marmote/marmote/hardware/BeaverBoard_RevA/Misc/Pictures/IMAG0495.jpg

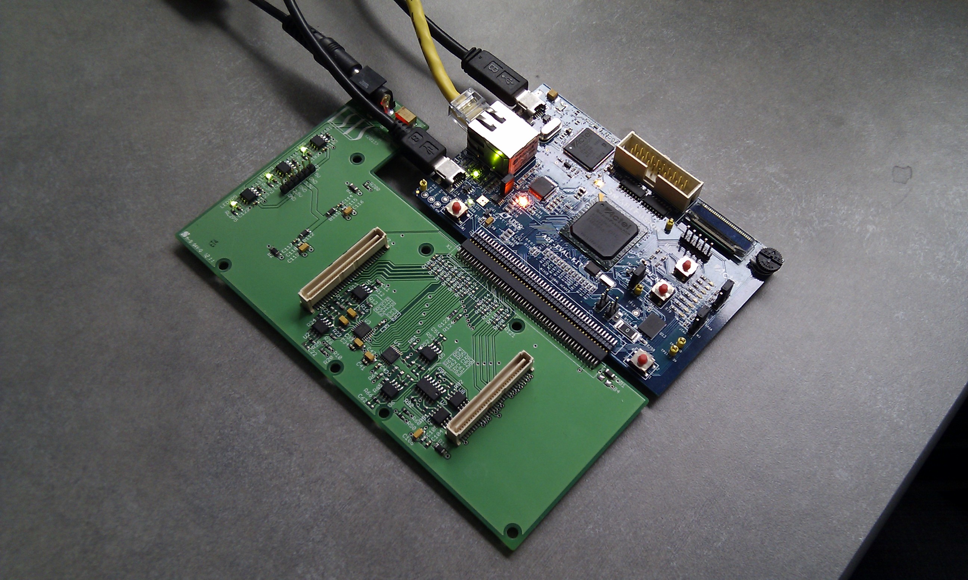
hardware/BeaverBoard_RevA/Misc/Pictures/IMAG0495.jpg
