marmote/marmote/hardware/BeaverBoard_RevA/Misc/Pictures/enhanced/IMAG0497.2.jpg

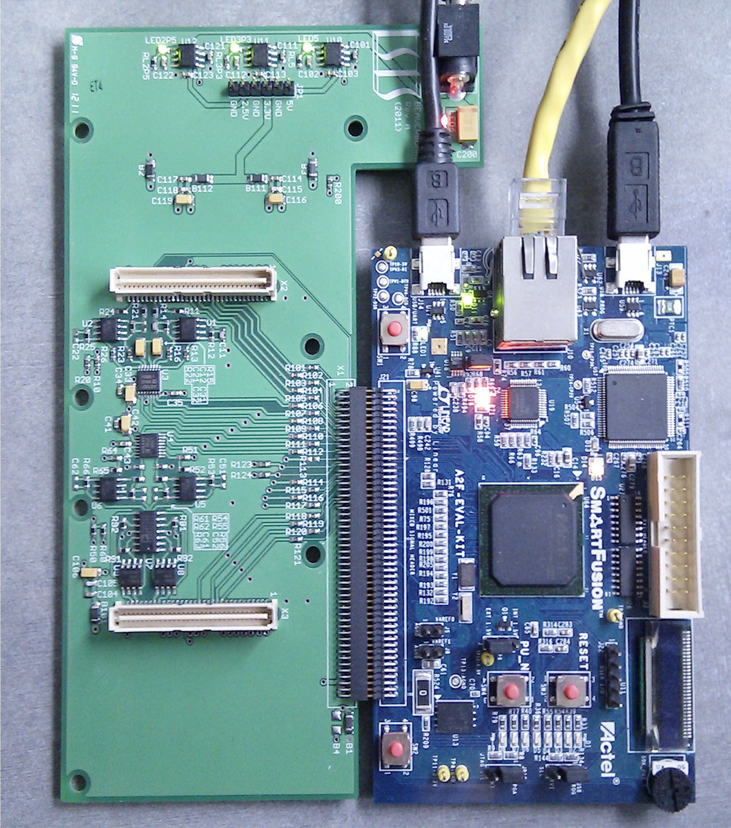
hardware/BeaverBoard_RevA/Misc/Pictures/enhanced/IMAG0497.2.jpg
