marmote/marmote/hardware/BreakoutBoard_RevB/CAM/README.txt

BreakoutBoard (Smoky) Revision B

PCB DECRIPTION: 90mm x 56mm 
                4 LAYER PCB (.062 inches thickness) FR4
                Smallest line width and spacing 4/4 mil
                Smallest standard drill hole 8 mil
                Components/Silkscreen on both sides
                Double side BLACK soldermask
                
PCB STACKUP:

	Stack Layer		Gerber Polarity	Comment	
	-----------		---------------	-------
	1 (Top)			Positive		Component side (signal)
	2 (GND)			Positive		Power (GND)
	3 (Inner)		Positive		Inner signal layer (signal)
	16 (Bottom)		Positive		Solder side (GND)

FILES:

BreakoutBoard_RevB.GTO - Top Silk Screen (component side)
BreakoutBoard_RevB.GTP - Top Solder paste (cream stencil, component side)
BreakoutBoard_RevB.GTS - Top Solder stop mask (component side)
BreakoutBoard_RevB.GTL - Top Copper (component side), Positive Polarity
BreakoutBoard_RevB.GP1 - Inner Ground plane, Positive Polarity
BreakoutBoard_RevB.GP2 - Inner Signal Layer, Positive Polarity
BreakoutBoard_RevB.GBL - Bottom Copper (solder side), Positive Polarity
BreakoutBoard_RevB.GBS - Bottom Solder stop mask (solder side)
BreakoutBoard_RevB.GBP - Bottom Solder paste (cream stencil, solder side)
BreakoutBoard_RevB.GBO - Bottom Silk Screen (solder side)
BreakoutBoard_RevB.GML - Board outline
BreakoutBoard_RevB.gpi - Gerber Report 

BreakoutBoard_RevB.DRD - NC Drill : 1.4, Abs, inches, leading zero supress, quad
BreakoutBoard_RevB.dri - NC Drill Report

BreakoutBoard_RevB.gwk - GraphiCode GC-Prevue Project File (Gerbers and drill)

BreakoutBoard_RevB.xy  - Centroid data for SMD components

BreakoutBoard_RevB_BOM.xls	- Bill of materials

BreakoutBoard_RevB_Asy.pdf	- Board assembly drawing

QUESTIONS?

  Please contact Peter Volgyesi <peter.volgyesi@vanderbilt.edu>
  at 615.294.6520 with any problems or questions
