marmote/marmote/hardware/M6-RF315/CAM/readme.txt

M6-RF315 Revision A

PCB DECRIPTION: 90 mm x 56 mm (see Board outline)
                2 LAYER PCB (.062 inches thickness) FR4
                1 oz copper wight
                DOUBLE SIDE SOLDER MASK

With any question please contact Sandor Szilvasi <sandor.szilvasi@vanderbilt.edu>
at +1 (615) 609 3342.

M6-RF315.cmp - Top Copper (component side) Positive Polarity
M6-RF315.sol - Bottom Copper (solder side) Positive Polarity
M6-RF315.stc - Top Solder stop mask (component side)
M6-RF315.sts - Bottom Solder stop mask (solder side)
M6-RF315.plc - Top Silkscreen (component side)
M6-RF315.pls - Bottom Silkscreen (solder side)
M6-RF315.oln - Board outline
M6-RF315.drd - NC Drill : 1.4, Abs, inches, leading zero supress, quad
