marmote/marmote/hardware/BeaverBoard_RevA/CAM/README.txt

BeaverBoard Rev. A

PCB DECRIPTION: 4 LAYER PCB (.062 inches thickness) FR4
                1 oz / 1 oz inner copper
                Components/Silkscreen only on top side
                Double side soldermask

PCB STACKUP:

	Stack Layer		Gerber Polarity	Comment	
	-----------		---------------	-------
	1 (Top)			Positive		Component side (signal)
	2 (Inner 1)		Positive		Power (GND)
	3 (Inner 2)		Positive		Power (VCC)
	4 (Bottom)		Positive		Solder side (signal)

FILES:

BeaverBoard_RevA.GTO - Top Silk Screen (component side)
BeaverBoard_RevA.GTP - Top Solder paste (cream stencil, component side)
BeaverBoard_RevA.GTS - Top Solder stop mask (component side)
BeaverBoard_RevA.GTL - Top Copper (component side), Positive Polarity
BeaverBoard_RevA.GP1 - Inner Layer 1, Positive Polarity
BeaverBoard_RevA.GP2 - Inner Layer 2, Positive Polarity
BeaverBoard_RevA.GBL - Bottom Copper (solder side), Positive Polarity
BeaverBoard_RevA.GBS - Bottom Solder stop mask (solder side)
BeaverBoard_RevA.GBP - Bottom Solder paste (cream stencil, solder side)
BeaverBoard_RevA.GBO - Bottom Silk Screen (solder side)
BeaverBoard_RevA.GML - Board outline
BeaverBoard_RevA.gpi - Gerber Report 

BeaverBoard_RevA.DRD - NC Drill : 1.4, Abs, inches, leading zero supress, quad
BeaverBoard_RevA.dri - NC Drill Report

BeaverBoard_RevA.gwk - GraphiCode GC-Prevue Project File (Gerbers and drill)

BeaverBoard_RevA.xy  - Centroid data for SMD components
   
BeaverBoard_RevA_BOM.xls	- Bill of materials

BeaverBoard_RevA_Asy.pdf	- Board assembly drawing

QUESTIONS?
  Please contact Peter Volgyesi <peter.volgyesi@vanderbilt.edu>
  at 615.294.6520 with any problems or questions
