marmote/marmote/firmware/MainBoard/StreamingReceiver_RF/designer/impl1/StreamingReceiver_RF_iobank_report.txt

********************************************************************
                            I/O Bank Report
********************************************************************
  
Product: Designer
Release: v10.1 SP3
Version: 10.1.3.1
Date: Tue Mar 05 08:22:31 2013
Design Name: StreamingReceiver_RF  Family: SmartFusion  Die: A2F500M3G  Package: 256 FBGA

I/O Function:

    Type                          | w/o register  | w/ register  | w/ DDR register
    ------------------------------|---------------|--------------|----------------
    Input I/O                     | 4             | 0            | 0
    Output I/O                    | 14            | 0            | 0
    Bidirectional I/O             | 8             | 0            | 20
    Differential Input I/O Pairs  | 0             | 0            | 0
    Differential Output I/O Pairs | 0             | 0            | 0

I/O Technology:

                                    |   Voltages    |             I/Os
    --------------------------------|-------|-------|-------|--------|--------------
    I/O Standard(s)                 | Vcci  | Vref  | Input | Output | Bidirectional
    --------------------------------|-------|-------|-------|--------|--------------
    LVTTL                           | 3.30v | N/A   | 4     | 14     | 0
    LVCMOS33                        | 3.30v | N/A   | 0     | 0      | 28

I/O Bank Resource Usage:

          |   Voltages    | Single I/Os  | Diff I/O Pairs |        Vref I/Os
          |-------|-------|------|-------|-------|--------|------|-------|----------
          | Vcci  | Vref  | Used | Total | Used  | Total  | Used | Total | Vref Pins
    ------|-------|-------|------|-------|-------|--------|------|-------|----------
    Bank0 | 3.30v | N/A   | 31   | 34    | 0     | 17     | N/A  | N/A   | N/A
    Bank1 | 3.30v | N/A   | 7    | 12    | 0     | 6      | N/A  | N/A   | N/A
    Bank2 | MSS   | N/A   | N/A  | N/A   | N/A   | N/A    | N/A  | N/A   | N/A
    Bank3 | ANALOG| N/A   | N/A  | N/A   | N/A   | N/A    | N/A  | N/A   | N/A
    Bank4 | MSS   | N/A   | N/A  | N/A   | N/A   | N/A    | N/A  | N/A   | N/A
    Bank5 | 3.30v | N/A   | 8    | 20    | 0     | 10     | N/A  | N/A   | N/A

I/O Voltage Usage:

       Voltages    |     I/Os
    -------|-------|------|-------
     Vcci  | Vref  | Used | Total
    -------|-------|------|-------
     3.30v | N/A   | 46   | 66
