marmote/marmote/firmware/MainBoard/StreamingReceiver_RF/designer/impl1/StreamingReceiver_RF_maxdelay_timingviolations_report.txt

Timing Violation Report Max Delay Analysis

SmartTime Version v10.1 SP3
Actel Corporation - Actel Designer Software Release v10.1 SP3 (Version 10.1.3.1)
Copyright (c) 1989-2013
Date: Tue Mar 05 08:22:35 2013

Design: StreamingReceiver_RF
Family: SmartFusion
Die: A2F500M3G
Package: 256 FBGA
Temperature: COM
Voltage: COM
Speed Grade: STD
Design State: Post-Layout
Data source: Silicon verified
Min Operating Condition: BEST
Max Operating Condition: WORST
Using Enhanced Min Delay Analysis
Scenario for Timing Analysis: Primary

No Path
