marmote/marmote/firmware/MainBoard/StreamingReceiver/designer/impl1/StreamingReceiver_iobank_report.txt

********************************************************************
                            I/O Bank Report
********************************************************************
  
Product: Designer
Release: v10.0 SP2
Version: 10.0.20.2
Date: Tue Jul 03 07:18:06 2012
Design Name: StreamingReceiver  Family: SmartFusion  Die: A2F500M3G  Package: 256 FBGA

I/O Function:

    Type                          | w/o register  | w/ register  | w/ DDR register
    ------------------------------|---------------|--------------|----------------
    Input I/O                     | 2             | 0            | 0
    Output I/O                    | 7             | 0            | 0
    Bidirectional I/O             | 8             | 0            | 10
    Differential Input I/O Pairs  | 0             | 0            | 0
    Differential Output I/O Pairs | 0             | 0            | 0

I/O Technology:

                                    |   Voltages    |             I/Os
    --------------------------------|-------|-------|-------|--------|--------------
    I/O Standard(s)                 | Vcci  | Vref  | Input | Output | Bidirectional
    --------------------------------|-------|-------|-------|--------|--------------
    LVTTL                           | 3.30v | N/A   | 2     | 7      | 0
    LVCMOS33                        | 3.30v | N/A   | 0     | 0      | 18

I/O Bank Resource Usage:

          |   Voltages    | Single I/Os  | Diff I/O Pairs |        Vref I/Os
          |-------|-------|------|-------|-------|--------|------|-------|----------
          | Vcci  | Vref  | Used | Total | Used  | Total  | Used | Total | Vref Pins
    ------|-------|-------|------|-------|-------|--------|------|-------|----------
    Bank0 | 3.30v | N/A   | 18   | 34    | 0     | 17     | N/A  | N/A   | N/A
    Bank1 | 3.30v | N/A   | 6    | 12    | 0     | 6      | N/A  | N/A   | N/A
    Bank2 | MSS   | N/A   | N/A  | N/A   | N/A   | N/A    | N/A  | N/A   | N/A
    Bank3 | ANALOG| N/A   | N/A  | N/A   | N/A   | N/A    | N/A  | N/A   | N/A
    Bank4 | MSS   | N/A   | N/A  | N/A   | N/A   | N/A    | N/A  | N/A   | N/A
    Bank5 | 3.30v | N/A   | 3    | 20    | 0     | 10     | N/A  | N/A   | N/A

I/O Voltage Usage:

       Voltages    |     I/Os
    -------|-------|------|-------
     Vcci  | Vref  | Used | Total
    -------|-------|------|-------
     3.30v | N/A   | 27   | 66
