marmote/marmote/hardware/PowerBoard_RevC/Misc/BlockDiagram.pptx

South Bridge

GPIO

SPI

I²C

Power Rails

FTSH

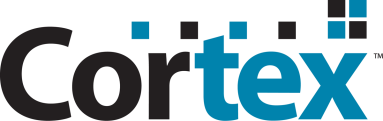
[picture p3: figure]

PMIC

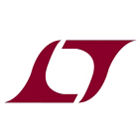
[picture p4: figure]

SWD

SPI

Analog

Current Senses

USB

GPIO

BUCK, LDOs

5V

3.6V

5V

Power Path

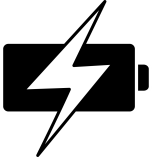
[picture p5: figure]

## Slide 2

Digital (STM)
3.3V
Digital
1.5V
Analog
3.3V
1.5V
2.8V-5.5V
3.3V
