marmote/marmote/hardware/MainBoard_RevB/Misc/BlockDiagram.pptx

North Bridge

SMA

Analog

GPIO

SPI

I²C

UART

AFE

RJ45

Clock

Analog

GPIO

Micro-B

USB

JTAG

RGMII

FTSH

GPIO

SPI

I²C

South Bridge

## Slide 2

North Bridge

AFE

ETH PHY

VSUP - 3.6V ~ 5V

D3V3 - Digital 3.3V

D1V5 - Digital 1.5V

A1V5 - Analog 1.5V

A3V3 – Analog 3.3V

South Bridge

## Slide 3

SmartFusion

MSS CCC

FPGA
fabric

CCC

EXT CLK IN

20 MHz
from SMA

GLC

EXT CLK OUT

20 MHz
to SMA

REF CLK OUT

MAIN CLK IN

20 MHz
from TCXO

PLL

GLB

20 MHz (differential)
to mezzanine

GLA0

AFE 1 CLK

AFE 2 CLK

max. 20 MHz
to AFEs (DDR)

32 kHz
OSC

100 MHz RC OSC

MSS

LP XTAL

32 kHz
from XTAL

USB CLK

60 MHz
from USB chip

RMII CLK

50 MHz
from ETH OSC

## Slide 4

SmartFusion

MSS CCC

FPGA
fabric

CCC

EXT CLK IN

20 MHz
from SMA

GLC

EXT CLK OUT

20 MHz
to SMA

REF CLK OUT

MAIN CLK IN

20 MHz
from TCXO

PLL

GLB

20 MHz (differential)
to mezzanine

GLA0

AFE 1 CLK

AFE 2 CLK

max. 20 MHz
to AFEs (DDR)

GLC

32 kHz
OSC

MSS

LP XTAL

32 kHz
from XTAL

USB CLK

60 MHz
from USB chip

RMII CLK

50 MHz
from ETH OSC

## Slide 5

SmartFusion

MSS CCC

FPGA
fabric

EXT CLK IN

20 MHz
from SMA

GLC

EXT CLK OUT

20 MHz
to SMA

REF CLK OUT

MAIN CLK IN

20 MHz
from TCXO

PLL

GLB

20 MHz (differential)
to mezzanine

GLA0

AFE 1 CLK

AFE 2 CLK

max. 20 MHz
to AFEs (DDR)

32 kHz
OSC

GLC

MSS

LP XTAL

32 kHz
from XTAL

CCC

USB CLK

60 MHz
from USB chip

RMII CLK

50 MHz
from ETH OSC

## Slide 6

XTAL

USB XTAL

12 MHz

USB
chip

ETH PHY

USB CLK

60 MHz

SMA

SMA

EXT CLK IN

EXT CLK OUT

20 MHz

20 MHz

AFE 1

TCXO

MAIN CLK IN

20 MHz

AFE 1 CLK

AFE 2 CLK

max. 20 MHz

AFE 2

XTAL

LP XTAL

32 kHz

REF CLK OUT

20 MHz
(differential)

Mezzanine

OSC

RMII CLK

50 MHz

## Slide 7

North Bridge

ADC, DAC

ETH PHY

VSUP

D3V3

D1V5

A1V5

A3V3

South Bridge

## Slide 8

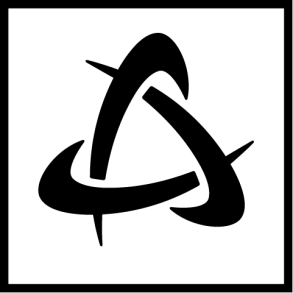
[picture p6: figure]
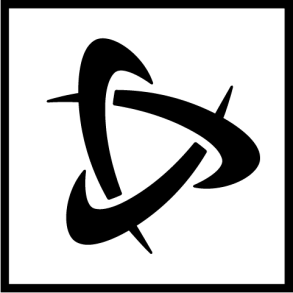
[picture p7: figure]
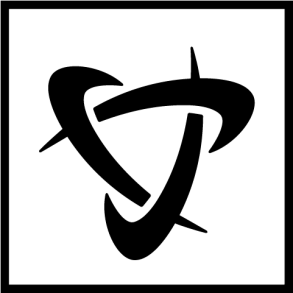
[picture p8: figure]
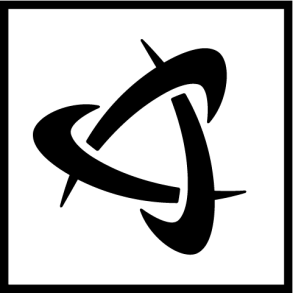
[picture p9: figure]

## Slide 9

## Slide 10

North Bridge

Jack/BNC

Analog

GPIO

SPI

I²C

LED

SRAM

Analog

GPIO

SMA

Clock I/O

JTAG

EMI

FTSH

JTAG

GPIO

SPI

I²C

South Bridge

## Slide 11

SmartFusion

EXT CLK IN

MSS CCC

GLC

FPGA
fabric

EXT CLK OUT

PLL

REF CLK OUT

MAIN CLK IN

GLB

GLA0

AFE1 CLK

AFE2 CLK

CLKC

LP XTAL

32 kHz
OSC

MSS

CCC

USB CLK

RMII CLK

ETH PHY

## Slide 12

SmartFusion

MSS CCC

EXT CLK IN

GLC

Fabric

CCC

REF CLK OUT

PLL

EXT CLK OUT

MAIN CLK IN

GLB

CCC

CCC

USB CLK

CLKC

GLA0

AFE1 CLK

AFE2 CLK

LP XTAL

32 kHz
OSC

ETH PHY

MSS

CCC

CCC

RMII CLK

## Slide 13

SmartFusion

MSS CCC

FPGA Fabric

CCC

CCC

REF CLK OUT

EXT CLK IN

GLC

DUT

PLL

EXT CLK OUT

MAIN CLK IN

GLB

CCC

USB CLK

AFE1 CLK

CLKC

GLA0

AFE2 CLK

LP XTAL

32 kHz
OSC

ETH PHY

MSS

CCC

CCC

RMII CLK

## Slide 14

LP XTAL

32 kHz
OSC

FPGA Fabric

CCC

CCC

DUT

REF CLK OUT

MSS CCC

EXT CLK OUT

MAIN CLK IN

PLL

GLB

CCC

USB CLK

EXT CLK IN

GLC

AFE1 CLK

AFE2 CLK

RMII CLK

ETH PHY

GLA0

MSS

CCC

CCC

## Slide 15

LP XTAL

32 kHz
OSC

FPGA Fabric

CCC

CCC

DUT

REF CLK OUT

MSS CCC

EXT CLK OUT

MAIN CLK IN

PLL

GLB

CCC

USB CLK

EXT CLK IN

GLC

AFE1 CLK

AFE2 CLK

RMII CLK

ETH PHY

GLA0

MSS

CCC

CCC

## Slide 16

MSS

MSS CCC

ETH PHY

CCC

CCC

REF CLK OUT

MAIN CLK IN

EXT CLK OUT

EXT CLK IN

LP XTAL

CCC

USB CLK

ETH CLK

AFE1 CLK

AFE2 CLK

CCC

CCC

## Slide 17

CCC

CCC

MAIN CLK IN

REF CLK OUT

EXT CLK IN

EXT CLK OUT

LP XTAL

CCC

USB CLK

ETH CLK

CCC

CCC
