marmote/marmote/doc/System.pdf

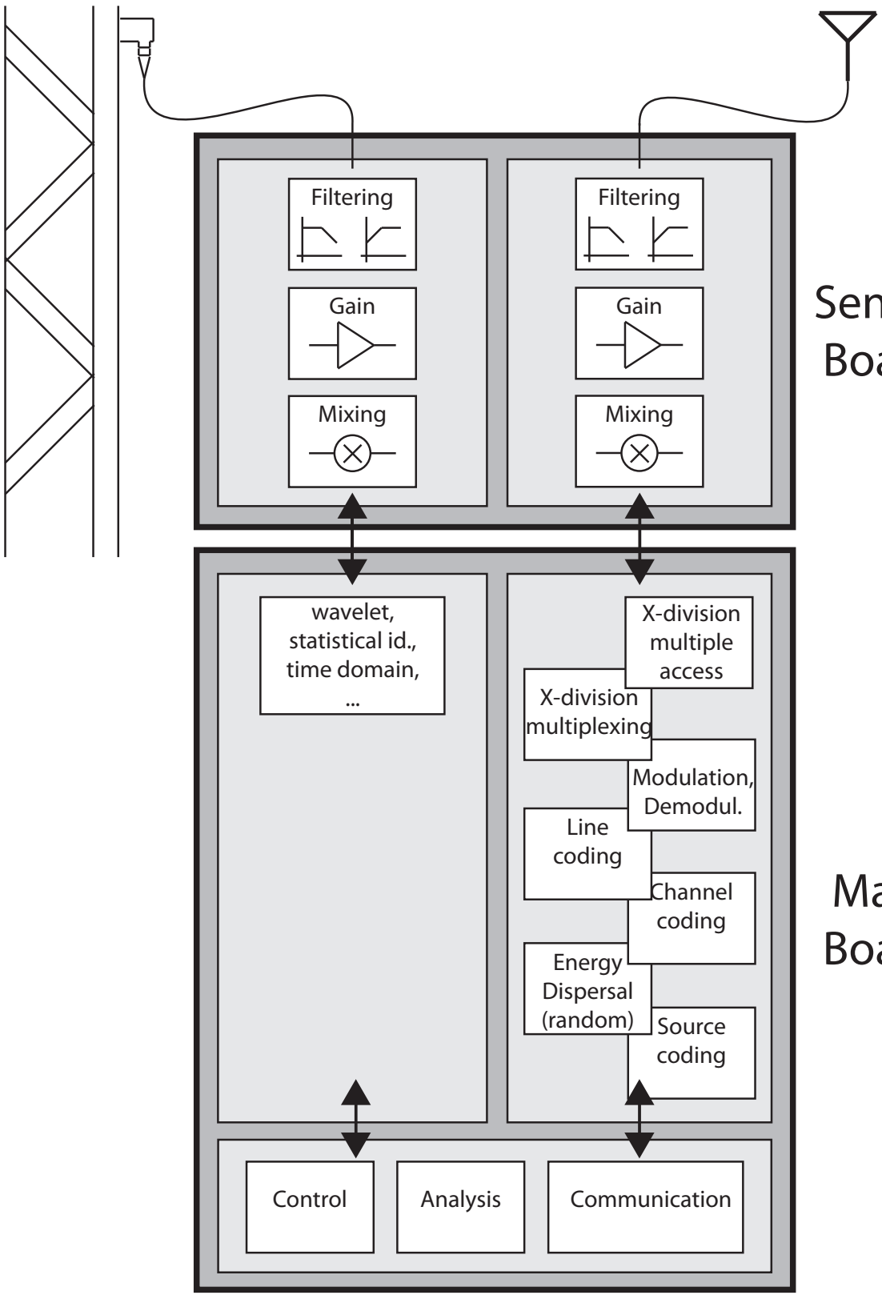
[picture p10: figure]
Filtering; Gain; Mixing; wavelet, statistical id., time domain, ...; Source coding; Energy Dispersal (random); Channel coding; Line coding; Modulation, Demodul.; X-division multiplexing; X-division multiple access; Control; Analysis; Communication

# Sensor Board

# Main Board

# Power Board

# SHM wireless sensor system
