marmote/marmote/hardware/MainBoard_RevB/Document/Connector Bus Signals.xlsx

Sheet: Sheet1
South Bridge (Supply) |  |  |  | North Bridge (Sensor)
84-pin Bus Signals |  |  |  | 84-pin Bus Signals
Name | Pin |  | Name | Name | Pin |  | Name
DGND | 1 | 2 | DGND | DGND | 1 | 2 | DGND
VSUP | 3 | 4 | VSUP | VSUP | 3 | 4 | VSUP
D3V3 | 5 | 6 | D3V3 | D3V3 | 5 | 6 | D3V3
D1V5 | 7 | 8 | D1V5 | D1V5 | 7 | 8 | D1V5 | Legend:
DGND | 9 | 10 | DGND | DGND | 9 | 10 | DGND
SGPIO0 | 11 | 12 |  | NGPIO0 | 11 | 12 | CLK- | Fonts
SGPIO1 | 13 | 14 |  | NGPIO1 | 13 | 14 | CLK+ |  | bold | bus signal (passes through all layers)
DGND | 15 | 16 | DGND | DGND | 15 | 16 | DGND |  | white | GPIO capability
SGPIO2 | 17 | 18 | SPI0 SS | NGPIO3 | 17 | 18 | SPI1 NSS |  | italic | MSS GPIO only (inaccessible from fabric)
SGPIO3 | 19 | 20 | SPI0 SCK | NGPIO4 | 19 | 20 | SPI1 SCK
SGPIO4 | 21 | 22 | SPI0 MISO | UART1 TXD | 21 | 22 | SPI1 MISO | Backgrounds | blue | digital signal
SGPIO5 | 23 | 24 | SPI0 MOSI | UART1 RXD | 23 | 24 | SPI1 MOSI |  | green | analog signal
ALERT | 25 | 26 | I2C1 SCL | ALERT | 25 | 26 | I2C1 SCL
WAKEUP | 27 | 28 | I2C1 SDA | WAKEUP | 27 | 28 | I2C1 SDA
AGND | 29 | 30 | AGND | AGND | 29 | 30 | AGND
 | 31 | 32 |  | SF DAC1 | 31 | 32 | DAC1-
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
