marmote/marmote/hardware/PowerBoard_RevC/Document/STM32F10x Pin Assignment.xlsx

Pin # | Pin name | Type | Main function | Alternate functions |  | Net name | Connected to | Description | Comments
 |  |  |  | Default | Remap
1 | VBAT | S | VBAT | - | - | D3V3_STM | XC6210 - MAX9938 | Supply for RTC and backup registers
2 | PC13-TAMPER-RTC | I/O | PC13 | TAMPER-RTC | - | PC13 | LTC4085 | Suspend (SUSP)
3 | PC14-OSC32_IN | I/O | PC14 | OSC32_IN | - | PC14 | SmartFusion Connector | OSC32 | GPIO x2 | OSC32 | OSC32 design in footprint only (not populated)
4 | PC15-OSC32_OUT | I/O | PC15 | OSC32_OUT | - | PC15
5 | PD0-OSC_IN | I/O | OSC_IN | - | - | OSC_IN | External 16 MHz crystal | Main clock source | USB clock requirements restrict SYSCLK to be 48 MHz or 72 MHz
6 | PD1-OSC_OUT | I/O | OSC_OUT | - | - | OSC_OUT
7 | NRST | I/O | NRST | - | - | NRST | Jumper | Reset signal | Selected a jumper instead of 'one via which can fit a raster pin'
8 | VSSA | S | VSSA | - | - | AGND | GND | -
9 | VDDA | S | VDDA | - | - | D3V3_STM | XC6210 - MAX9938 | -
10 | PA0-WKUP | I/O | PA0 | WKUP/USART2_CTS/ADC_IN0/TIM2_CH1_ETR(8) | - | VSUP_SENSE | MAX9938 | VSUP rail current sense
11 | PA1 | I/O | PA1 | USART2_RTS/ADC_IN1/TIM2_CH2(8) | - | D3V3_SENSE | MAX9938 | D3V3 rail current sense
12 | PA2 | I/O | PA2 | USART2_TX/ADC_IN2/TIM2_CH3(8) | - | D1V5_SENSE | MAX9938 | D1V5 rail current sense
13 | PA3 | I/O | PA3 | USART2_RX/ADC_IN3/TIM2_CH4(8) | - | A1V5_SENSE | MAX9938 | A1V5 rail current sense
14 | PA4 | I/O | PA4 | SPI1_NSS(8)/ADC_IN4/USART2_CK | - | SPI1_NSS | SmartFusion connector | SPI1 signals
15 | PA5 | I/O | PA5 | SPI1_SCK(8)/ADC_IN5 | - | SPI1_SCK
16 | PA6 | I/O | PA6 | SPI1_MISO(8)/ADC_IN6/TIM3_CH1(8) | - | SPI1_MISO
17 | PA7 | I/O | PA7 | SPI1_MOSI(8)/ADC_IN7/TIM3_CH2(8) | - | SPI1_MOSI
18 | PB0 | I/O | PB0 | ADC_IN8/TIM3_CH3(8) | - | D3V3_STM_SENSE | MAX9938 | D3V3_STM rail current sense
19 | PB1 | I/O | PB1 | ADC_IN9/TIM3_CH4(8) | - | D3V3_SENSE | MAX9938 | D3V3 rail current sense
20 | PB2 | I/O | PB2/BOOT1 | - | - | PB2 | LED2 | LED2 (ORANGE) & BOOT1 | Orange UD = 2.0V IFWD = 4mA | Weak pull-up for BOOT1 = '1' on startup
21 | PB10 | I/O | PB10 | I2C2_SCL/ USART3_TX(8) | TIM2_CH3 | I2C2_SCL | VBAT current sense | I2C2 signals
22 | PB11 | I/O | PB11 | I2C2_SDA/ USART3_RX(8) | TIM2_CH4 | I2C2_SDA
23 | VSS_1 | S | VSS_1 | - | - | DGND | GND | -
24 | VDD_1 | S | VDD_1 | - | - | D3V3_STM | XC6210 - MAX9938 | -
25 | PB12 | I/O | PB12 | SPI2_NSS/I2C2_SMBA/USART3_CK(8) | - | SPI2_NSS | SD card | SPI2 signals
26 | PB13 | I/O | PB13 | SPI2_SCK(8)/USART3_CTS | - | SPI2_SCK
27 | PB14 | I/O | PB14 | SPI2_MISO/USART3_RTS | - | SPI2_MISO
28 | PB15 | I/O | PB15 | SPI2_MOSI | - | SPI2_MOSI
29 | PA8 | I/O | PA8 | USART1_CK/MCO | - | PA8 | Master switch | Power switch for ALL rails
30 | PA9 | I/O | PA9 | USART1_TX(8) | - | PA9 | SmartFusion connector | GPIO signals | USART1 signals
31 | PA10 | I/O | PA10 | USART1_RX(8) | - | PA10
32 | PA11 | I/O | PA11 | USART1_CTS/USBDM | - | USBDM | USB connector | USB data signals
33 | PA12 | I/O | PA12 | USART1_RTS/USBDP | - | USBDP
34 | PA13 | I/O | JTMS/SWDIO | - | PA13 | SWDIO | Programmer header | SWD | JTAG
35 | VSS_2 | S | VSS_2 | - | - | DGND | DGND | -
36 | VDD_2 | S | VDD_2 | - | - | D3V3_STM | XC6210 - MAX9938 | -
37 | PA14 | I/O | JTCK/SWCLK | - | PA14 | SWCLK | Programmer header | SWD | JTAG
38 | PA15 | I/O | JTDI | - | TIM2_CH1_ETR/PA15/SPI1_NSS | PA15 | LED1 | Programmer header | LED1 (GREEN) | JTAG | Green UD = 2.1V IFWD = 10mA | Optional JTAG functionality
39 | PB3 | I/O | JTDO | - | TIM2_CH2/PB3/TRACESWO/SPI1_SCK | TRACESWO | Programmer header | SWD | JTAG
40 | PB4 | I/O | JNTRST | - | TIM3_CH1/PB4/SPI1_MISO | PB4 | LTC2942-1 | Battery Gauge #AL/CC
41 | PB5 | I/O | PB5 | I2C1_SMBA | TIM3_CH2/SPI1_MOSI | PB5 | SmartFusion connector | Programmer header | GPIO+ | JTAG | Optional JTAG functionality
42 | PB6 | I/O | PB6 | I2C1_SCL(8)/TIM4_CH1 | USART1_TX | I2C1_SCL | SmartFusion connector | I2C1 signals | USART1 signals | GPIO signals
43 | PB7 | I/O | PB7 | I2C1_SDA(8)/TIM4_CH2 | USART1_RX | I2C1_SDA
44 | BOOT0 | I | BOOT0 | - | - | BOOT0 | 3-pin JUMPER | Boot mode selector pin
45 | PB8 | I/O | PB8 | TIM4_CH3 | I2C1_SCL | PB8 | LTC4085 | High power select (HPWR)
46 | PB9 | I/O | PB9 | TIM4_CH4 | I2C1_SDA | PB9 | LTC4361 | #PWRGD
47 | VSS_3 | S | VSS_3 | - | - | DGND | DGND | -
48 | VDD_3 | S | VDD_3 | - | - | D3V3_STM | XC6210 - MAX9938 | -
 |  |  |  |  |  |  |  | HPWR
 |  |  |  |  |  |  |  | SUSP
 |  |  |  |  |  |  |  | #PWRGD
 |  |  |  |  |  |  |  | #AL/CC+
 |  |  |  |  |  |  |  | MASTER SWITCH
 |  |  |  |  |  |  |  | LED1
 |  |  |  |  |  |  |  | LED2
