marmote/marmote/hardware/PowerBoard_RevC/Document/Connector Bus Signals.xlsx

Bus 1 Signals
Name | Pin |  | Name
DGND | 1 | 2 | DGND
VSUP | 3 | 4 | VSUP
D3V3 | 5 | 6 | D3V3
D1V5 | 7 | 8 | D1V5
 | 9 | 10
DGND | 11 | 12 | DGND
 | 13 | 14 | I2C1_SCL | I2C1
 | 15 | 16 | I2C1_SDA
 | 17 | 18 | DGND
 | 19 | 20 | SPI1_NSS | SPI1
 | 21 | 22 | SPI1_SCK
 | 23 | 24 | SPI1_MISO
 | 25 | 26 | SPI1_MOSI
 | 27 | 28 | DGND
 | 29 | 30 | PC14 | GPIO
 | 31 | 32 | PC15
 | 33 | 34 | PA9
 | 35 | 36 | PA10
 | 37 | 38 | PB4
 | 39 | 40 | DGND
 | 41 | 42
 | 43 | 44
 | 45 | 46
 | 47 | 48
 | 49 | 50
 | 51 | 52
 | 53 | 54
AGND | 55 | 56 | AGND
 | 57 | 58
A1V5 | 59 | 60 | A1V5
A3V3 | 61 | 62 | A3V3
AGND | 63 | 64 | AGND
