marmote/marmote/hardware/BeaverBoard_RevA/Misc/LEDs.xls

Green
 | Forward Voltage drop [V] | 2.1
 | Current [A] | 0.01
 | Pwr supply [V] | 5 | 3.3 | 2.5
 | Resistor [Ohm] | 290 | 120 | 40
Red
 | Forward Voltage drop [V] | 2
 | Current [A] | 0.01
 | Pwr supply [V] | 6
 | Resistor [Ohm] | 400
