marmote/marmote/hardware/BeaverBoard_RevA/Misc/Connectors.xls

Sheet: LFRX
SPLY |  |  | GND | GND |  |  | SPLY |  | GND | SPLY
 |  |  |  | 5V:1 | J16 |  | pin |  | AGND:1 | SPLY
pin | J15 | J25 | io_rx_15 | 5V:1 | J16 |  | pin |  | AVDD:1 | SPLY
pin | J15 | J25 | io_rx_14 | DVDD:1 | J16 | U1 | SPLY |  | DVDD:1 | SPLY
pin | J15 | J25 | io_rx_13 | DVDD:1 | J16 | U1 | SPLY |  | VINP_B | ANALOG
pin | J15 | J25 | io_rx_12 | CLKOUT1 |  |  |  |  | VINN_B | ANALOG
pin | J15 | J25 | io_rx_11 | CLKOUT2 |  |  |  |  | VINN_A | ANALOG
pin | J15 | J25 | io_rx_10 | SCL | J16 | U1 | IC |  | VINP_A | ANALOG
pin | J15 | J25 | io_rx_09 | SDA | J16 | U1 | IC | 1 | SCL | DIGITAL
pin | J15 | J25 | io_rx_08 | I2C_A1 | J16 | U1 | IC | 2 | SDA | DIGITAL
pin | J15 | J24 | io_rx_07 | I2C_A0 | J16 | U1 | IC | 3 | I2C_A1 | DIGITAL
pin | J15 | J24 | io_rx_06 | RS232_TXD | J16 |  | pin | 4 | I2C_A0 | DIGITAL
pin | J15 | J24 | io_rx_05 | RS232_RXD | J16 |  | pin
pin | J15 | J24 | io_rx_04 | RESET | J16 |  | pin
pin | J15 | J24 | io_rx_03 | SCLK | J16 |  | pin
pin | J15 | J24 | io_rx_02 | SDO | J16 |  | pin
pin | J15 | J24 | io_rx_01 | SDI | J16 |  | pin
pin | J15 | J24 | io_rx_00 | SEN_RX | J16 |  | pin
SPLY |  |  | GND | GND |  |  | SPLY
SPLY |  |  | AGND:1 | AGND:1 |  |  | SPLY
SPLY |  |  | AVDD:1 | AVDD:1 |  |  | SPLY
SPLY |  |  | AVDD:1 | AVDD:1 |  |  | SPLY
SPLY |  |  | AGND:1 | AGND:1 |  |  | SPLY
COMP | R4 | C22 | VINP_B | AUX_DAC_D | J17 |  | pin
COMP | R5 | C23 | VINN_B | AUX_DAC_A | J17 |  | pin
SPLY |  |  | AGND:1 | AUX_DAC_B | J17 |  | pin
 |  |  | VREF | AUX_DAC_C | J17 |  | pin
SPLY |  |  | AGND:1 | AUX_ADC_REF | J17 |  | pin
COMP | R11 | C26 | VINN_A | AUX_ADC_A1 | J17 |  | pin
COMP | R10 | C25 | VINP_A | AUX_ADC_B1 | J17 |  | pin
SPLY |  |  | AGND:1 | AGND:1 |  |  | SPLY

Sheet: DBSRX
SPLY |  |  | DGND:1 | DGND:1 |  |  | SPLY |  | DGND:1 | SPLY
 |  |  |  | 6V:1 | C187 | L600 | COMP |  | AGND:1 | SPLY
pin |  | J25 | io_rx_15 | 6V:1 | C187 | L600 | COMP |  | AVDD:1 | SPLY
pin |  | J25 | io_rx_14 | DVDD:1 | J16 | U1 | SPLY |  | DVDD:1 | SPLY
pin |  | J25 | io_rx_13 | DVDD:1 | J16 | U1 | SPLY |  | 6V:1 | SPLY
pin |  | J25 | io_rx_12 | clock_p | R194 |  | (COMP) |  | VINP_B | ANALOG
pin |  | J25 | io_rx_11 |  |  |  |  |  | VINN_B | ANALOG
pin |  | J25 | io_rx_10 | SCL | U3 | U1 | IC |  | VINN_A | ANALOG
pin |  | J25 | io_rx_09 | SDA | U3 | U1 | IC |  | VINP_A | ANALOG
pin |  | J25 | io_rx_08 | I2C_A1 | Q1 | U1 | IC | 1 | io_rx_00 | DIGITAL
pin |  | J24 | io_rx_07 | I2C_A0 |  |  |  | 2 | SCL | DIGITAL
pin |  | J24 | io_rx_06 | RS232_TXD |  |  |  | 3 | SDA | DIGITAL
pin |  | J24 | io_rx_05 | RS232_RXD |  |  |  | 4 | I2C_A1 | DIGITAL
pin |  | J24 | io_rx_04 | RESET |  |  |  | 5 | AUX_DAC_A | ANALOG
(COMP) | R22 | J24 | io_rx_03 | SCLK
pin |  | J24 | io_rx_02 | SDO
pin |  | J24 | io_rx_01 | SDI
COMP |  | R193 | io_rx_00 | SEN_RX
SPLY |  |  | DGND:1 | DGND:1 |  |  | SPLY
SPLY |  |  | AGND:1 | AGND:1 |  |  | SPLY
SPLY |  |  | AVDD:1 | AVDD:1 |  |  | SPLY
SPLY |  |  | AVDD:1 | AVDD:1 |  |  | SPLY
SPLY |  |  | AGND:1 | AGND:1 |  |  | SPLY
COMP | R15 | C25 | VINP_B | AUX_DAC_D
COMP | R16 | C26 | VINN_B | AUX_DAC_A | R21 |  | COMP
SPLY |  |  | AGND:1 | AUX_DAC_B
 |  |  | VREF | AUX_DAC_C
SPLY |  |  | AGND:1 | AUX_ADC_REF
COMP | R10 | C64 | VINN_A | AUX_ADC_A1
COMP | R71 | C65 | VINP_A | AUX_ADC_B1
SPLY |  |  | AGND:1 | AGND:1 |  |  | SPLY

Sheet: RFX400_RX
SPLY |  |  | DGND_RX:1 | DGND_RX:1 |  |  | SPLY |  | DGND_RX:1 | SPLY
SPLY |  |  | DGND_RX:1 | 6V_RX:1 | L6 | C2, C35, C4 | SPLY |  | AGND:1 | SPLY
pin |  | J24 | io_rx_15 | 6V_RX:1 | L202 | C200, C203, C207 | SPLY |  | DVDD:1 | SPLY
pin |  | J24 | io_rx_14 | DVDD:1 |  |  | SPLY |  | 6V_RX:1 | SPLY
pin |  | J24 | io_rx_13 | DVDD:1 |  |  | SPLY |  | VINP_B | ANALOG
pin |  | J24 | io_rx_12 | clock_p | R36 |  | COMP |  | VINN_B | ANALOG
pin |  | J24 | io_rx_11 |  |  |  |  |  | VINN_A | ANALOG
pin |  | J24 | io_rx_10 | SCL_RX |  | U1 | IC |  | VINP_A | ANALOG
pin |  | J24 | io_rx_09 | SDA_RX |  | U1 | IC | 1 | io_rx_07 | DIGITAL
(COMP) | R97 | J24 | io_rx_08 | I2C_A1_RX |  | U1 | IC | 2 | io_rx_06 | DIGITAL
IC | R83 | U6 | io_rx_07 | I2C_A0_RX |  | U1 | IC | 3 | io_rx_05 | DIGITAL
IC | R249 | U204 | io_rx_06 |  |  |  |  | 4 | io_rx_02 | DIGITAL
IC |  | U2 | io_rx_05 |  |  |  |  | 5 | clock_p | DIGITAL
(COMP) | R45 |  | io_rx_04 |  |  |  |  | 6 | SCL_RX | DIGITAL
(COMP) | R43 |  | io_rx_03 | SCLK_RX | R40 | U3 | IC | 7 | SDA_RX | DIGITAL
COMP | J3 | U3 | io_rx_02 |  |  |  |  | 8 | I2C_A1_RX | DIGITAL
(COMP) | R44 |  | io_rx_01 | SDI_RX | R46 | U3 | IC | 9 | I2C_A0_RX | DIGITAL
(COMP) | R34 |  | io_rx_00 | SEN_RX | R42 | U3 | IC | 10 | SCLK_RX | DIGITAL
SPLY |  |  | DGND_RX:1 | DGND_RX:1 |  |  | SPLY | 11 | SDI_RX | DIGITAL
 |  |  |  |  |  |  |  | 12 | SEN_RX | DIGITAL
SPLY |  |  | AGND:1 | AGND:1 |  |  | SPLY | 13 | AUX_DAC_A_RX | ANALOG
SPLY |  |  | AGND:1 | AGND:1 |  |  | SPLY
COMP | R49 |  | VINP_B
COMP | R50 |  | VINN_B | AUX_DAC_A_RX | R95 |  | COMP
SPLY |  |  | AGND:1
SPLY |  |  | AGND:1
COMP | R48 |  | VINN_A
COMP | R47 |  | VINP_A
SPLY |  |  | AGND:1 | AGND:1 |  |  | SPLY

Sheet: RFX2400_RX
SPLY |  |  | DGND_RX:1 | DGND_RX:1 |  |  | SPLY |  | DGND_RX:1 | SPLY
SPLY |  |  | DGND_RX:1 | 6V_RX:1 | L6 | C2, C35, C4 | SPLY |  | AGND:1 | SPLY
pin |  | J24 | io_rx_15 | 6V_RX:1 | L202 | C200, C203, C207 | SPLY |  | DVDD:1 | SPLY
pin |  | J24 | io_rx_14 | DVDD:1 |  |  | SPLY |  | 6V_RX:1 | SPLY
pin |  | J24 | io_rx_13 | DVDD:1 |  |  | SPLY |  | VINP_B | ANALOG
pin |  | J24 | io_rx_12 | clock_p | R36 |  | COMP |  | VINN_B | ANALOG
pin |  | J24 | io_rx_11 |  |  |  |  |  | VINN_A | ANALOG
pin |  | J24 | io_rx_10 | SCL_RX |  | U1 | IC |  | VINP_A | ANALOG
pin |  | J24 | io_rx_09 | SDA_RX |  | U1 | IC | 1 | io_rx_07 | DIGITAL
(COMP) | R97 | J24 | io_rx_08 | I2C_A1_RX |  | U1 | IC | 2 | io_rx_06 | DIGITAL
IC | R262 | U204 | io_rx_07 | I2C_A0_RX |  | U1 | IC | 3 | io_rx_05 | DIGITAL
IC | R249 | U204 | io_rx_06 |  |  |  |  | 4 | io_rx_02 | DIGITAL
IC |  | U2 | io_rx_05 |  |  |  |  | 5 | clock_p | DIGITAL
(COMP) | R45 |  | io_rx_04 |  |  |  |  | 6 | SCL_RX | DIGITAL
(COMP) | R43 |  | io_rx_03 | SCLK_RX | R40 | U3 | IC | 7 | SDA_RX | DIGITAL
COMP |  | U3 | io_rx_02 |  |  |  |  | 8 | I2C_A1_RX | DIGITAL
(COMP) | R44 |  | io_rx_01 | SDI_RX | R46 | U3 | IC | 9 | I2C_A0_RX | DIGITAL
(COMP) | R34 |  | io_rx_00 | SEN_RX | R42 | U3 | IC | 10 | SCLK_RX | DIGITAL
SPLY |  |  | DGND_RX:1 | DGND_RX:1 |  |  | SPLY | 11 | SDI_RX | DIGITAL
 |  |  |  |  |  |  |  | 12 | SEN_RX | DIGITAL
SPLY |  |  | AGND:1 | AGND:1 |  |  | SPLY | 13 | AUX_DAC_A_RX | ANALOG
SPLY |  |  | AGND:1 | AGND:1 |  |  | SPLY
COMP | R49 |  | VINP_B
COMP | R50 |  | VINN_B | AUX_DAC_A_RX | R95 |  | COMP
SPLY |  |  | AGND:1
SPLY |  |  | AGND:1
COMP | R48 |  | VINN_A
COMP | R47 |  | VINP_A
SPLY |  |  | AGND:1 | AGND:1 |  |  | SPLY

Sheet: sum_RX
 |  |  |  |  |  | RFX2400_RX
 | LFRX |  | DBSRX |  |  | RFX400_RX
1 | SCL | DIGITAL | 1 | io_rx_00 | DIGITAL | 1 | io_rx_07 | DIGITAL
2 | SDA | DIGITAL | 2 | SCL | DIGITAL | 2 | io_rx_06 | DIGITAL
3 | I2C_A1 | DIGITAL | 3 | SDA | DIGITAL | 3 | io_rx_05 | DIGITAL
4 | I2C_A0 | DIGITAL | 4 | I2C_A1 | DIGITAL | 4 | io_rx_02 | DIGITAL
 |  |  |  |  |  | 5 | clock_p | DIGITAL
 |  |  |  |  |  | 6 | SCL_RX | DIGITAL
 |  |  |  |  |  | 7 | SDA_RX | DIGITAL
 |  |  |  |  |  | 8 | I2C_A1_RX | DIGITAL
 |  |  |  |  |  | 9 | I2C_A0_RX | DIGITAL
 |  |  |  |  |  | 10 | SCLK_RX | DIGITAL
 |  |  |  |  |  | 11 | SDI_RX | DIGITAL
 |  |  |  |  |  | 12 | SEN_RX | DIGITAL
1 |  |  |  |  |  |  | io_rx_07
2 |  |  |  |  |  |  | io_rx_06
3 |  |  |  |  |  |  | io_rx_05
4 |  |  |  |  |  |  | io_rx_02
5 |  |  |  | io_rx_00
6 |  |  |  |  |  |  | clock_p
7 | SCL |  |  | SCL |  |  | SCL_RX
8 | SDA |  |  | SDA |  |  | SDA_RX
9 | I2C_A1 |  |  | I2C_A1 |  |  | I2C_A1_RX
10 | I2C_A0 |  |  |  |  |  | I2C_A0_RX
11 |  |  |  |  |  |  | SCLK_RX
12 |  |  |  |  |  |  | SDI_RX
13 |  |  |  |  |  |  | SEN_RX

Sheet: LFTX
SPLY |  |  | GND | GND |  |  | SPLY |  | GND | SPLY
 |  |  |  | 5V:1 | J46 | FB1 | SPLY |  | AGND:1 | SPLY
pin | J45 | J51 | io_tx_15 | 5V:1 | J46 | FB1 | SPLY |  | AVDD:1 | SPLY
pin | J45 | J51 | io_tx_14 | DVDD:1 | J46 | U52 | SPLY |  | DVDD:1 | SPLY
pin | J45 | J51 | io_tx_13 | DVDD:1 | J46 | U52 | SPLY |  | 5V:1 | SPLY
pin | J45 | J51 | io_tx_12 |  |  |  |  |  | IOUTN_B | ANALOG
pin | J45 | J51 | io_tx_11 |  |  |  |  |  | IOUTP_B | ANALOG
pin | J45 | J51 | io_tx_10 | SCL | J46 | U52 | IC |  | IOUTP_A | ANALOG
pin | J45 | J51 | io_tx_09 | SDA | J46 | U52 | IC |  | IOUTN_A | ANALOG
pin | J45 | J51 | io_tx_08 | I2C_A1 | J46 | U52 | IC | 1 | SCL | DIGITAL
pin | J45 | J50 | io_tx_07 | I2C_A0 | J46 | U52 | IC | 2 | SDA | DIGITAL
pin | J45 | J50 | io_tx_06 | RS232_TXD | J46 |  | pin | 3 | I2C_A1 | DIGITAL
pin | J45 | J50 | io_tx_05 | RS232_RXD | J46 |  | pin | 4 | I2C_A0 | DIGITAL
pin | J45 | J50 | io_tx_04 | RESET | J46 |  | pin
pin | J45 | J50 | io_tx_03 | SCLK | J46 |  | pin
pin | J45 | J50 | io_tx_02 | SDO | J46 |  | pin
pin | J45 | J50 | io_tx_01 | SDI | J46 |  | pin
pin | J45 | J50 | io_tx_00 | SEN_TX | J46 |  | pin
SPLY |  |  | GND | GND |  |  | SPLY
SPLY |  |  | AGND:1 | AGND:1 |  |  | SPLY
SPLY |  |  | AVDD:1 | AVDD:1 |  |  | SPLY
SPLY |  |  | AVDD:1 | AVDD:1 |  |  | SPLY
SPLY |  |  | AGND:1 | AGND:1 |  |  | SPLY
COMP | R35, R6 | C15 | IOUTN_B | AUX_DAC_D | J47 |  | pin
COMP | R36, R8 | C15 | IOUTP_B | AUX_DAC_A | J47 |  | pin
SPLY |  |  | AGND:1 | AUX_DAC_B | J47 |  | pin
 |  |  | REFIO | AUX_DAC_C | J47 |  | pin
SPLY |  |  | AGND:1 | AUX_ADC_REF | J47 |  | pin
COMP | R39, R5 | C14 | IOUTP_A | AUX_ADC_A2 | J47 |  | pin
COMP | R33, R3 | C14 | IOUTN_A | AUX_ADC_B2 | J47 |  | pin
SPLY |  |  | AGND:1 | AGND:1 |  |  | SPLY

Sheet: RFX400_TX
SPLY |  |  | DGND_TX:1 | DGND_RX:1 |  |  | SPLY |  | DGND_RX:1 | SPLY
SPLY |  |  | DGND_TX:1 | 6V_TX:1 |  |  | SPLY |  | AGND:1 | SPLY
pin |  | J101 | io_tx_15 | 6V_TX:1 |  |  | SPLY |  | DVDD:1 | SPLY
pin |  | J101 | io_tx_14 | DVDD:1 |  |  | SPLY |  | 6V_RX:1 | SPLY
pin |  | J101 | io_tx_13 | DVDD:1 |  |  | SPLY |  | IOUTN_B | ANALOG
pin |  | J101 | io_tx_12 | clock_p | R115 |  | COMP |  | IOUTP_B | ANALOG
pin |  | J101 | io_tx_11 |  |  |  |  |  | IOUTP_A | ANALOG
pin |  | J101 | io_tx_10 | SCL_TX |  | U102 | IC |  | IOUTN_A | ANALOG
pin |  | J101 | io_tx_09 | SDA_TX |  | U102 | IC | 1 | io_tx_07 | DIGITAL
pin |  | J101 | io_tx_08 | I2C_A1_TX |  | U102 | IC | 2 | io_tx_06 | DIGITAL
IC | R152 | U111 | io_tx_07 | I2C_A0_TX |  | U102 | IC | 3 | io_tx_05 | DIGITAL
IC | R250 | U204 | io_tx_06 |  |  |  |  | 4 | io_tx_02 | DIGITAL
IC |  | U101 | io_tx_05 |  |  |  |  | 5 | clock_p | DIGITAL
(COMP) | R135 |  | io_tx_04 |  |  |  |  | 6 | SCL_TX | DIGITAL
(COMP) | R133 |  | io_tx_03 | SCLK_TX | R130 | U103 | IC | 7 | SDA_TX | DIGITAL
COMP | J100 | U103 | io_tx_02 |  |  |  |  | 8 | I2C_A1_TX | DIGITAL
(COMP) | R135 |  | io_tx_01 | SDI_TX | R136 | U103 | IC | 9 | I2C_A0_TX | DIGITAL
(COMP) | R116 |  | io_tx_00 | SEN_TX | R132 | U103 | IC | 10 | SCLK_TX | DIGITAL
SPLY |  |  | DGND_TX:1 | DGND_RX:1 |  |  | SPLY | 11 | SDI_TX | DIGITAL
 |  |  |  |  |  |  |  | 12 | SEN_TX | DIGITAL
SPLY |  |  | AGND:1 | AGND:1 |  |  | SPLY
SPLY |  |  | AGND:1 | AGND:1 |  |  | SPLY
COMP | R49 |  | IOUTN_B
COMP | R50 |  | IOUTP_B
SPLY |  |  | AGND:1
SPLY |  |  | AGND:1
COMP | R48 |  | IOUTP_A
COMP | R47 |  | IOUTN_A
SPLY |  |  | AGND:1 | AGND:1 |  |  | SPLY

Sheet: RFX2400_TX
SPLY |  |  | DGND_TX:1 | DGND_RX:1 |  |  | SPLY |  | DGND_RX:1 | SPLY
SPLY |  |  | DGND_TX:1 | 6V_TX:1 |  |  | SPLY |  | AGND:1 | SPLY
pin |  | J101 | io_tx_15 | 6V_TX:1 |  |  | SPLY |  | DVDD:1 | SPLY
pin |  | J101 | io_tx_14 | DVDD:1 |  |  | SPLY |  | 6V_RX:1 | SPLY
pin |  | J101 | io_tx_13 | DVDD:1 |  |  | SPLY |  | IOUTN_B | ANALOG
pin |  | J101 | io_tx_12 | clock_p | R115 |  | COMP |  | IOUTP_B | ANALOG
pin |  | J101 | io_tx_11 |  |  |  |  |  | IOUTP_A | ANALOG
pin |  | J101 | io_tx_10 | SCL_TX |  | U102 | IC |  | IOUTN_A | ANALOG
pin |  | J101 | io_tx_09 | SDA_TX |  | U102 | IC | 1 | io_tx_07 | DIGITAL
pin |  | J101 | io_tx_08 | I2C_A1_TX |  | U102 | IC | 2 | io_tx_06 | DIGITAL
IC | R261 | U204 | io_tx_07 | I2C_A0_TX |  | U102 | IC | 3 | io_tx_05 | DIGITAL
IC | R250 | U204 | io_tx_06 |  |  |  |  | 4 | io_tx_02 | DIGITAL
IC |  | U101 | io_tx_05 |  |  |  |  | 5 | clock_p | DIGITAL
(COMP) | R135 |  | io_tx_04 |  |  |  |  | 6 | SCL_TX | DIGITAL
(COMP) | R133 |  | io_tx_03 | SCLK_TX | R130 | U103 | IC | 7 | SDA_TX | DIGITAL
COMP | J100 | U103 | io_tx_02 |  |  |  |  | 8 | I2C_A1_TX | DIGITAL
(COMP) | R134 |  | io_tx_01 | SDI_TX | R136 | U103 | IC | 9 | I2C_A0_TX | DIGITAL
(COMP) | R116 |  | io_tx_00 | SEN_TX | R132 | U103 | IC | 10 | SCLK_TX | DIGITAL
SPLY |  |  | DGND_TX:1 | DGND_RX:1 |  |  | SPLY | 11 | SDI_TX | DIGITAL
 |  |  |  |  |  |  |  | 12 | SEN_TX | DIGITAL
SPLY |  |  | AGND:1 | AGND:1 |  |  | SPLY
SPLY |  |  | AGND:1 | AGND:1 |  |  | SPLY
COMP | R49 |  | IOUTN_B
COMP | R50 |  | IOUTP_B
SPLY |  |  | AGND:1
SPLY |  |  | AGND:1
COMP | R48 |  | IOUTP_A
COMP | R47 |  | IOUTN_A
SPLY |  |  | AGND:1 | AGND:1 |  |  | SPLY

Sheet: sum_TX
 |  |  | RFX2400_TX
 | LFTX |  | RFX400_TX
1 | SCL | DIGITAL | 1 | io_tx_07 | DIGITAL
2 | SDA | DIGITAL | 2 | io_tx_06 | DIGITAL
3 | I2C_A1 | DIGITAL | 3 | io_tx_05 | DIGITAL
4 | I2C_A0 | DIGITAL | 4 | io_tx_02 | DIGITAL
 |  |  | 5 | clock_p | DIGITAL
 |  |  | 6 | SCL_TX | DIGITAL
 |  |  | 7 | SDA_TX | DIGITAL
 |  |  | 8 | I2C_A1_TX | DIGITAL
 |  |  | 9 | I2C_A0_TX | DIGITAL
 |  |  | 10 | SCLK_TX | DIGITAL
 |  |  | 11 | SDI_TX | DIGITAL
 |  |  | 12 | SEN_TX | DIGITAL
1 |  |  |  | io_tx_07
2 |  |  |  | io_tx_06
3 |  |  |  | io_tx_05
4 |  |  |  | io_tx_02
5 |  |  |  | clock_p
6 |  |  |  | SCL_TX
7 | SCL |  |  | SDA_TX
8 | SDA |  |  | I2C_A1_TX
9 | I2C_A1 |  |  | I2C_A0_TX
10 | I2C_A0 |  |  | SCLK_TX
11 |  |  |  | SDI_TX
12 |  |  |  | SEN_TX

Sheet: Sum
 |  | 23
 | AD/DA | 7 | ADC: 4; DAC:3
1 | io_rx_07 | 1
2 | io_rx_06 | 1
3 | io_rx_05 | 1
4 | io_rx_02 | 1
5 | io_rx_00 | 1
6 | clock_p | 1
7 | SCL_RX | 1
8 | SDA_RX | 1
9 | I2C_A1_RX | 0
10 | I2C_A0_RX | 0
11 | SCLK_RX | 1
12 | SDI_RX | 1
13 | SEN_RX | 1
14 | io_tx_07 | 1
15 | io_tx_06 | 1
16 | io_tx_05 | 1
17 | io_tx_02 | 1
18 | clock_p | 0
19 | SCL_TX | 0
20 | SDA_TX | 0
21 | I2C_A1_TX | 0
22 | I2C_A0_TX | 0
23 | SCLK_TX | 0
24 | SDI_TX | 0
25 | SEN_TX | 1
