marmote/marmote/hardware/BeaverBoard_RevA/Simulation/AD/filter.ods

Sheet: Sheet1
F_1 | 1.50E+006
F_2 | 2.70E+006
pass_atten | -1.5
pass_ripple | 3
stop_atten | 40
R | 500
R1 | 117.88
L1 | 5.60E-005
C1 | 2.39E-009
 |  |  |  | Z1 | Z | 1/Z_C | Z_C | Z_L | 1/(Z+Z_L) | 1/Z_C+1/(Z+Z_L) | Z1*(1/Z_C+1/(Z+Z_L)) | 1/.. | abs | atv [dB] | Phase [deg] | ideal up | ideal low | error up | error low | error
f | 0 | omega | 0 | 500 | 117.877291636942 | 0 | Err:502 | 0 | 0.0084833981686648 | 0.0084833981686648 | 4.2416990843324 | 0.235754583273884 | 0.24 | -12.55 | 0 | 1.5 | -1.5 | 0 | 122.12 | 4541.64
 | 100000 |  | 628318.53 | 500 | 117.877291636942 | 0.00149972451530666j | -666.789126798745j | 35.2017452005919j | 0.00778879264224127-0.00232597042403116j | 0.00778879264224127-0.000826245908724499j | 3.89439632112064-0.413122954362245j | 0.253921759609097+0.0269363718678698j | 0.26 | -11.86 | 6.06 | 1.5 | -1.5 | 0 | 107.28
 | 200000 |  | 1256637.06 | 500 | 117.877291636942 | 0.00299944903061332j | -333.394563399373j | 70.4034904011837j | 0.00625287086648914-0.00373459491574157j | 0.00625287086648914-0.00073514588512825j | 3.12643543324457-0.367572942564125j | 0.315492173064374+0.0370922057676636j | 0.32 | -9.96 | 6.71 | 1.5 | -1.5 | 0 | 71.58
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
