marmote/marmote/hardware/BreakoutBoard_RevA/CAM/README.txt

BreakoutBoard Revision A

PCB DECRIPTION: 90mm x 56mm 
                4 LAYER PCB (.062 inches thickness) FR4
                Smallest line width and spacing 6/6 mil
                Smallest standard drill hole 12 mil
                Components/Silkscreen on both sides
                Double side soldermask
                
PCB STACKUP:

	Stack Layer		Gerber Polarity	Comment	
	-----------		---------------	-------
	1 (Top)			Positive		Component side (signal)
	2 (Inner 1)		Positive		Even (signal)
	3 (Inner 2)		Positive		Odd (signal)
	4 (Bottom)		Positive		Solder side (signal)

FILES:

BreakoutBoard.GTO - Top Silk Screen (component side)
BreakoutBoard.GTP - Top Solder paste (cream stencil, component side)
BreakoutBoard.GTS - Top Solder stop mask (component side)
BreakoutBoard.GTL - Top Copper (component side), Positive Polarity
BreakoutBoard.GP1 - Inner Layer 1, Positive Polarity
BreakoutBoard.GP2 - Inner Layer 2, Positive Polarity
BreakoutBoard.GBL - Bottom Copper (solder side), Positive Polarity
BreakoutBoard.GBS - Bottom Solder stop mask (solder side)
BreakoutBoard.GBP - Bottom Solder paste (cream stencil, solder side)
BreakoutBoard.GBO - Bottom Silk Screen (solder side)
BreakoutBoard.GML - Board outline
BreakoutBoard.gpi - Gerber Report 

BreakoutBoard.DRD - NC Drill : 1.4, Abs, inches, leading zero supress, quad
BreakoutBoard.dri - NC Drill Report

BreakoutBoard.gwk - GraphiCode GC-Prevue Project File (Gerbers and drill)

BreakoutBoard.xy  - Centroid data for SMD components

BreakoutBoard_BOM.xls	- Bill of materials

BreakoutBoard_Asy.pdf	- Board assembly drawing

QUESTIONS?

  Please contact Peter Volgyesi <peter.volgyesi@vanderbilt.edu>
  at 615.294.6520 with any problems or questions
