marmote/marmote/firmware/BeaverBoard/ADC_SPI_DMA_IPstack/IMAG0375.jpg

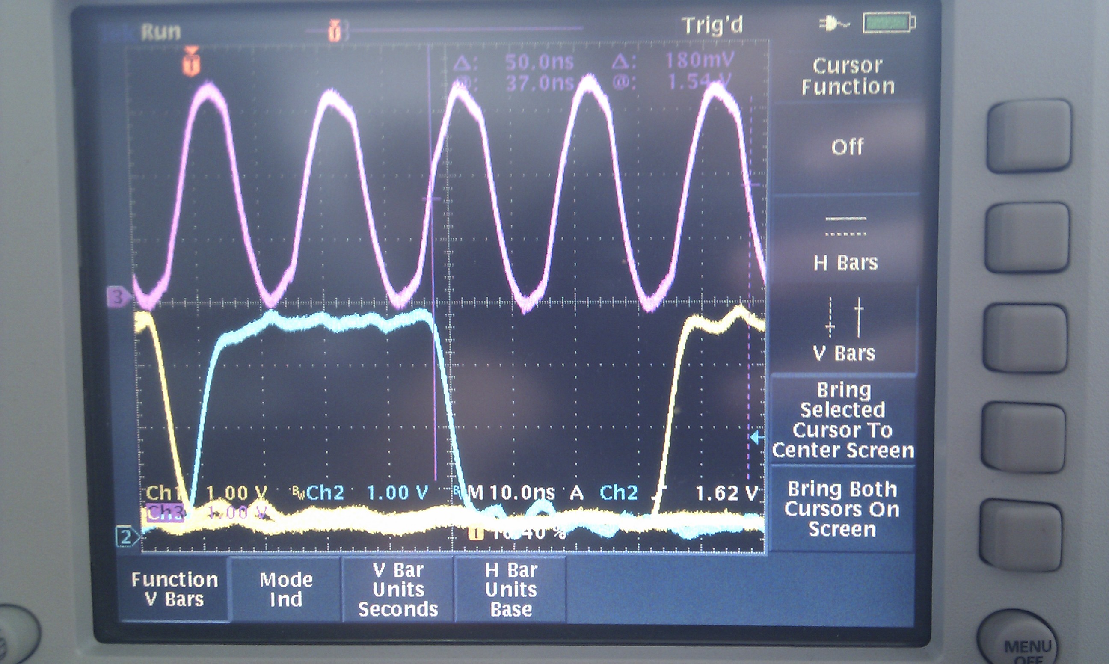
firmware/BeaverBoard/ADC_SPI_DMA_IPstack/IMAG0375.jpg
