marmote/marmote/hardware/AE sensor supply/DCnoisecoupling.png

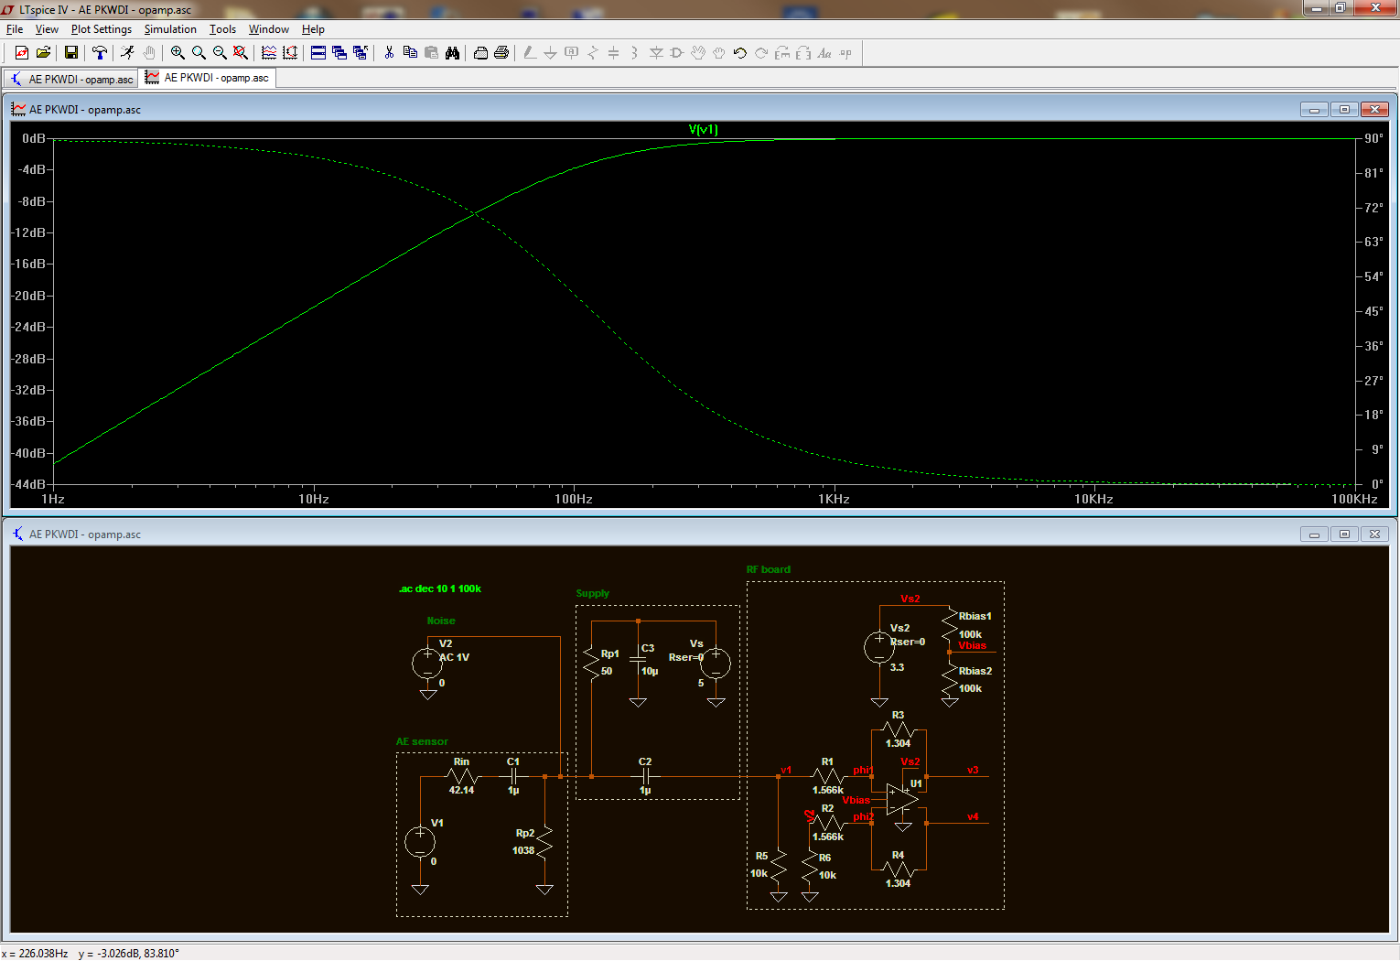
hardware/AE sensor supply/DCnoisecoupling.png
