marmote/marmote/hardware/BeaverBoard_RevA/Misc/Pictures/enhanced/IMAG0494.2.jpg

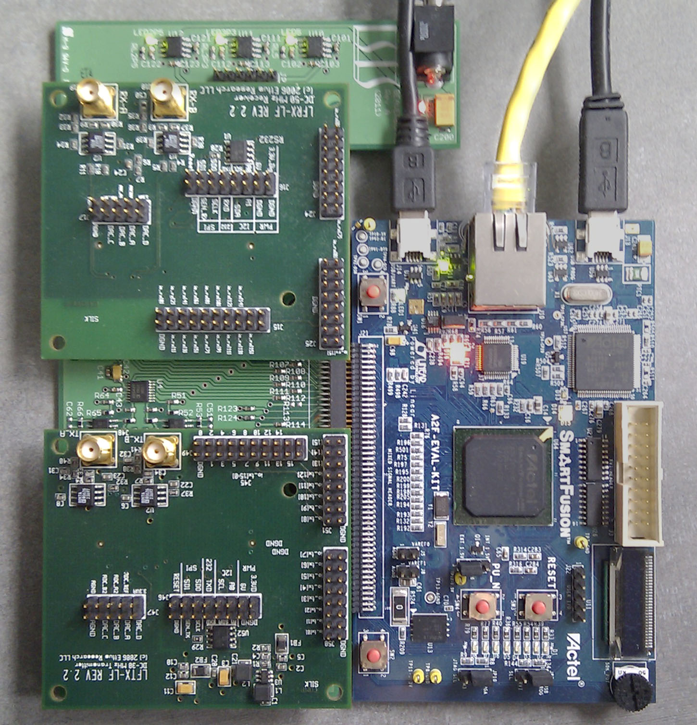
hardware/BeaverBoard_RevA/Misc/Pictures/enhanced/IMAG0494.2.jpg
