marmote/marmote/hardware/BeaverBoard_RevA/Misc/Pictures/enhanced/IMAG0495.2.jpg

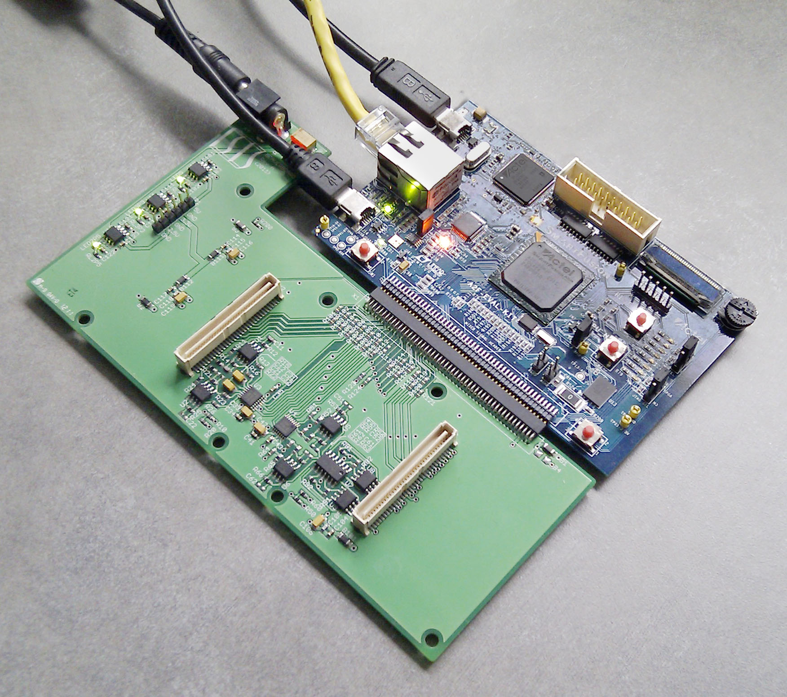
hardware/BeaverBoard_RevA/Misc/Pictures/enhanced/IMAG0495.2.jpg
