marmote/marmote/hardware/BeaverBoard_RevA/Misc/Pictures/enhanced/IMAG0498.2.jpg

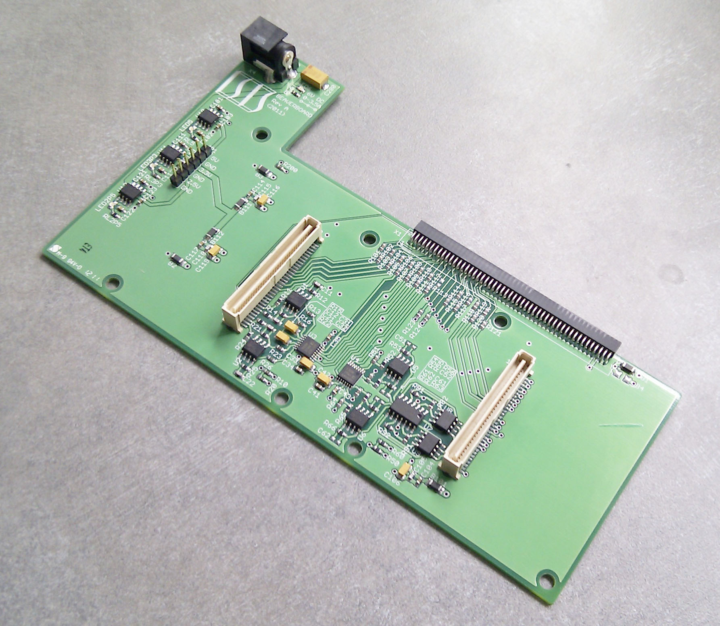
hardware/BeaverBoard_RevA/Misc/Pictures/enhanced/IMAG0498.2.jpg
