marmote/marmote/hardware/BeaverBoard_RevA/Misc/Pictures/IMAG0491.jpg

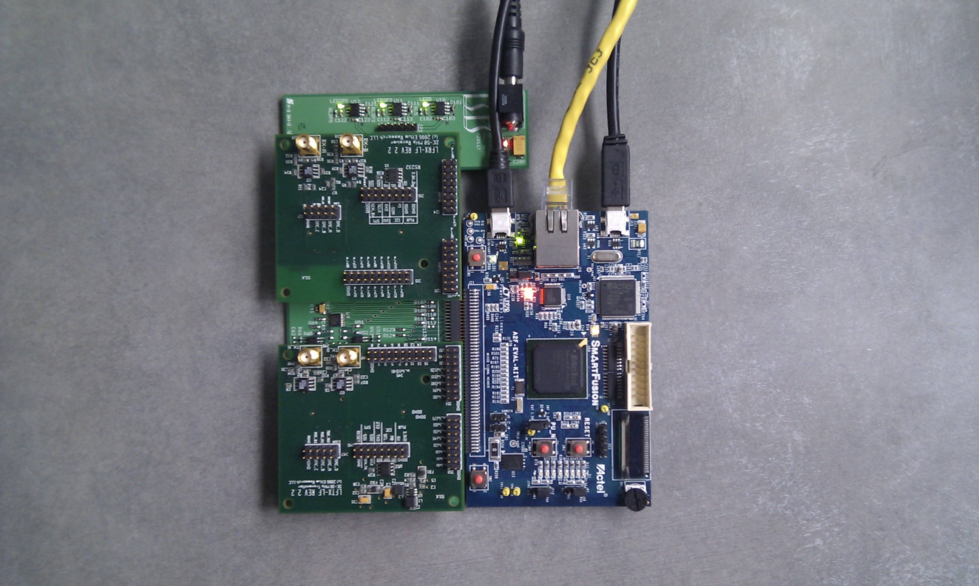
hardware/BeaverBoard_RevA/Misc/Pictures/IMAG0491.jpg
