marmote/marmote/hardware/BeaverBoard_RevA/Misc/Pictures/IMAG0493.jpg

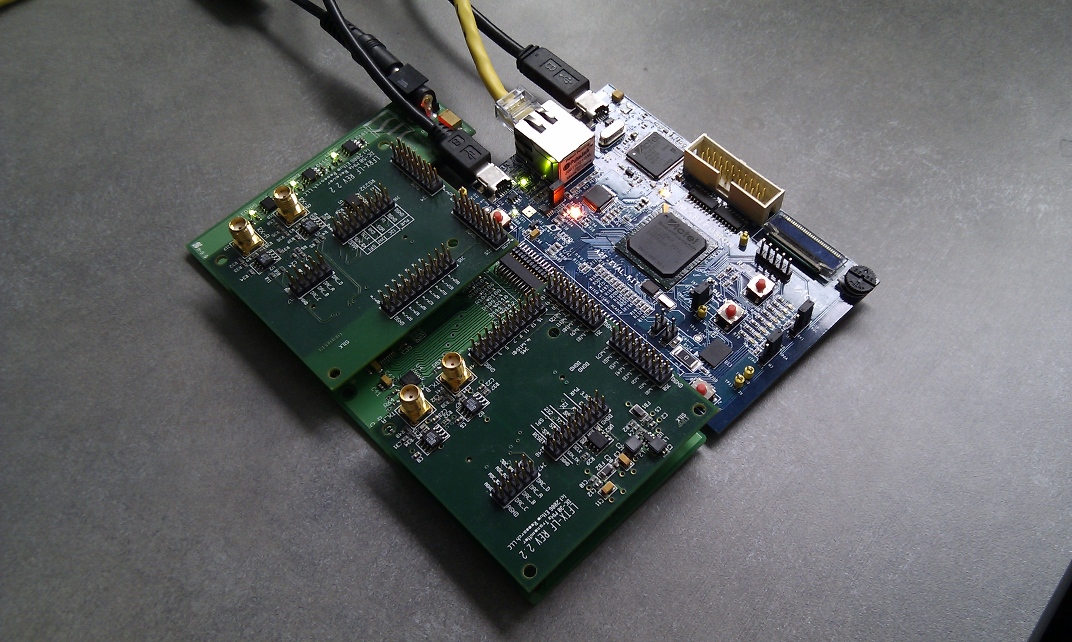
hardware/BeaverBoard_RevA/Misc/Pictures/IMAG0493.jpg
