marmote/marmote/hardware/BeaverBoard_RevA/Misc/Pictures/IMAG0494.jpg

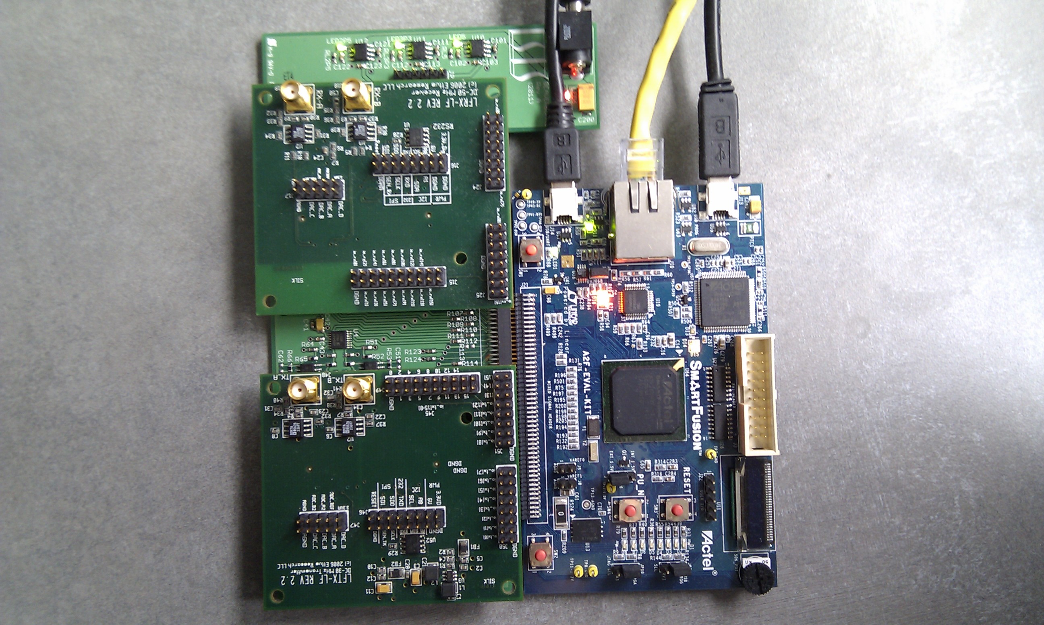
hardware/BeaverBoard_RevA/Misc/Pictures/IMAG0494.jpg
