marmote/marmote/hardware/BeaverBoard_RevA/Misc/Pictures/IMAG0497.jpg

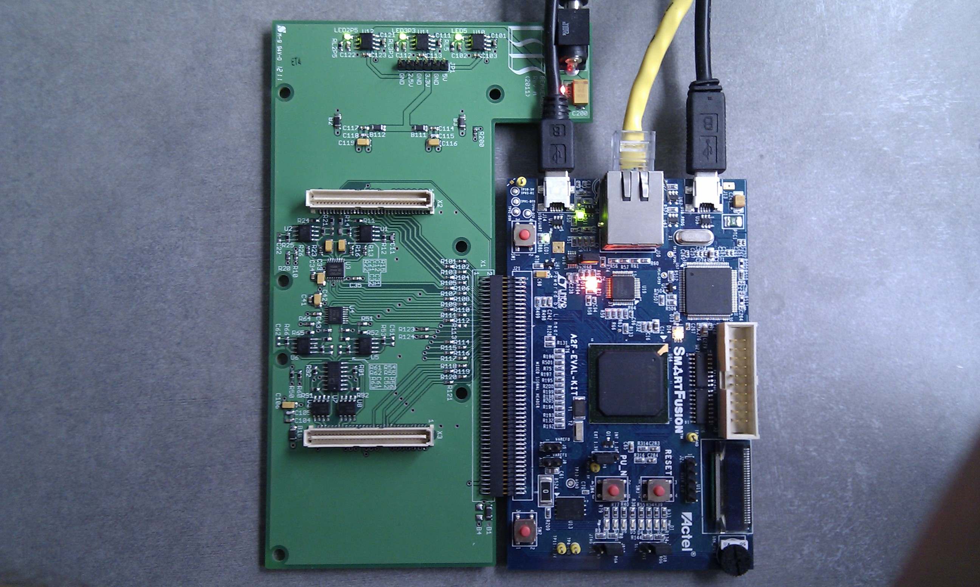
hardware/BeaverBoard_RevA/Misc/Pictures/IMAG0497.jpg
