marmote/marmote/hardware/BeaverBoard_RevA/Misc/Pictures/IMAG0498.jpg

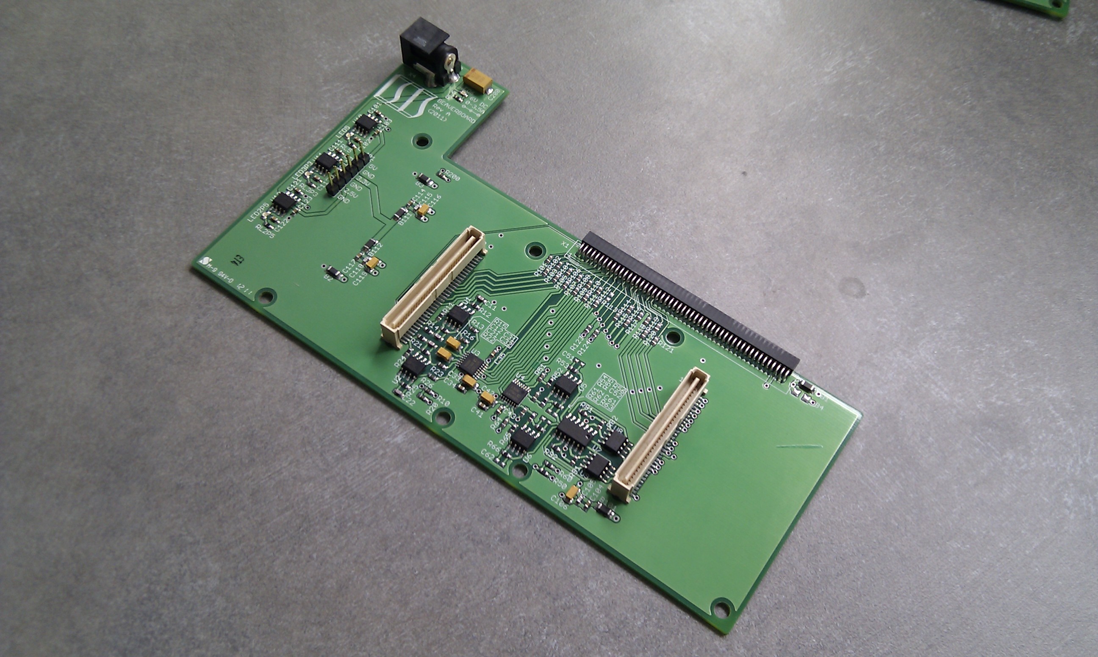
hardware/BeaverBoard_RevA/Misc/Pictures/IMAG0498.jpg
