marmote/marmote/hardware/BeaverBoard_RevA/Misc/Pictures/IMAG0500.jpg

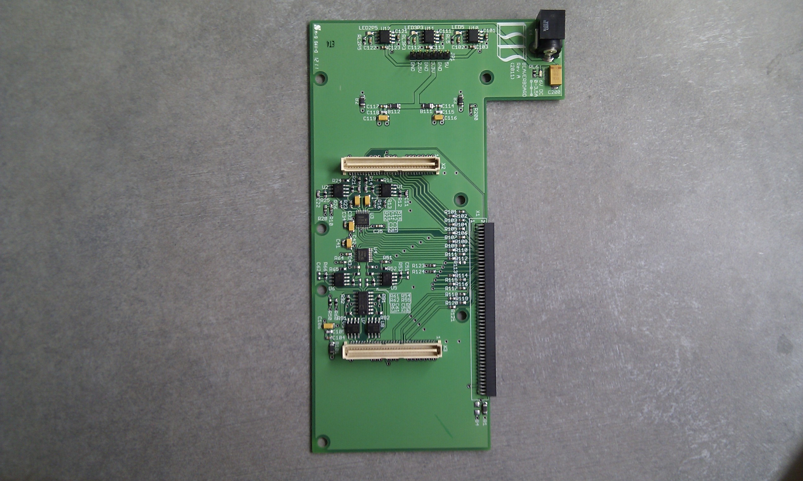
hardware/BeaverBoard_RevA/Misc/Pictures/IMAG0500.jpg
