marmote/marmote/hardware/Colpitts oscillator 40 MHz common collector/IMAG0732.jpg

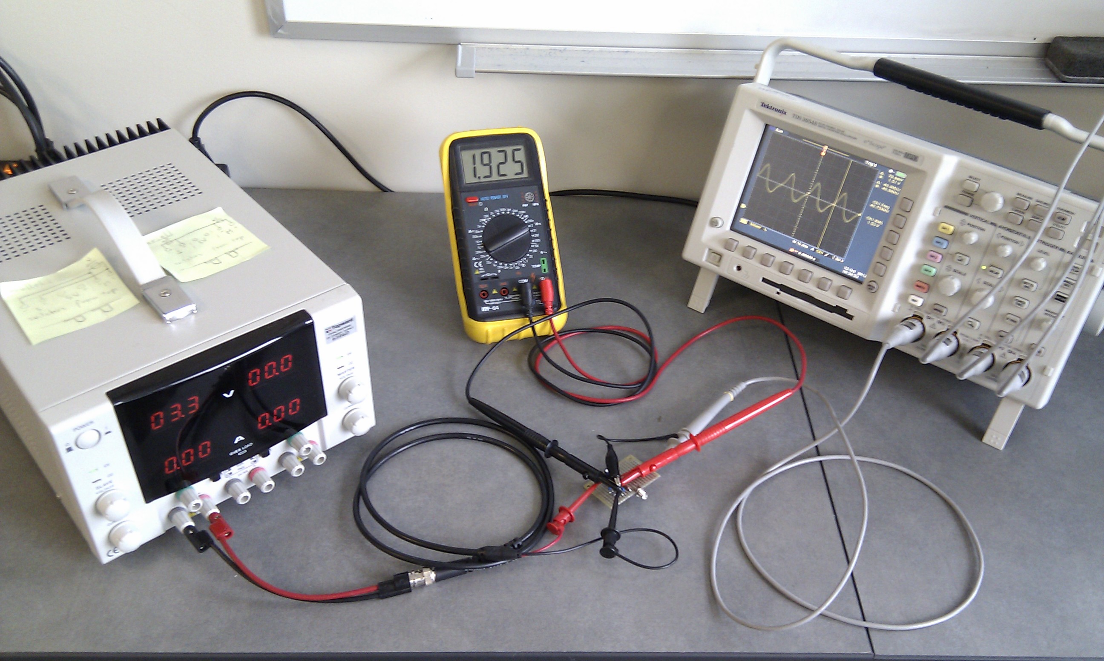
hardware/Colpitts oscillator 40 MHz common collector/IMAG0732.jpg
