marmote/marmote/hardware/Colpitts oscillator 40 MHz common collector/IMAG0739.jpg

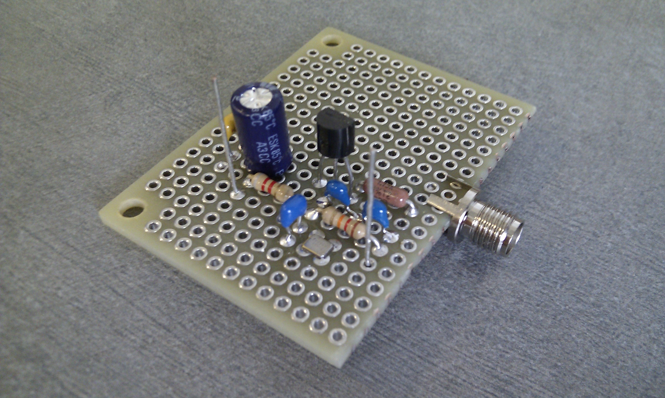
hardware/Colpitts oscillator 40 MHz common collector/IMAG0739.jpg
