marmote/marmote/hardware/Colpitts oscillator 40 MHz common collector/sch.png

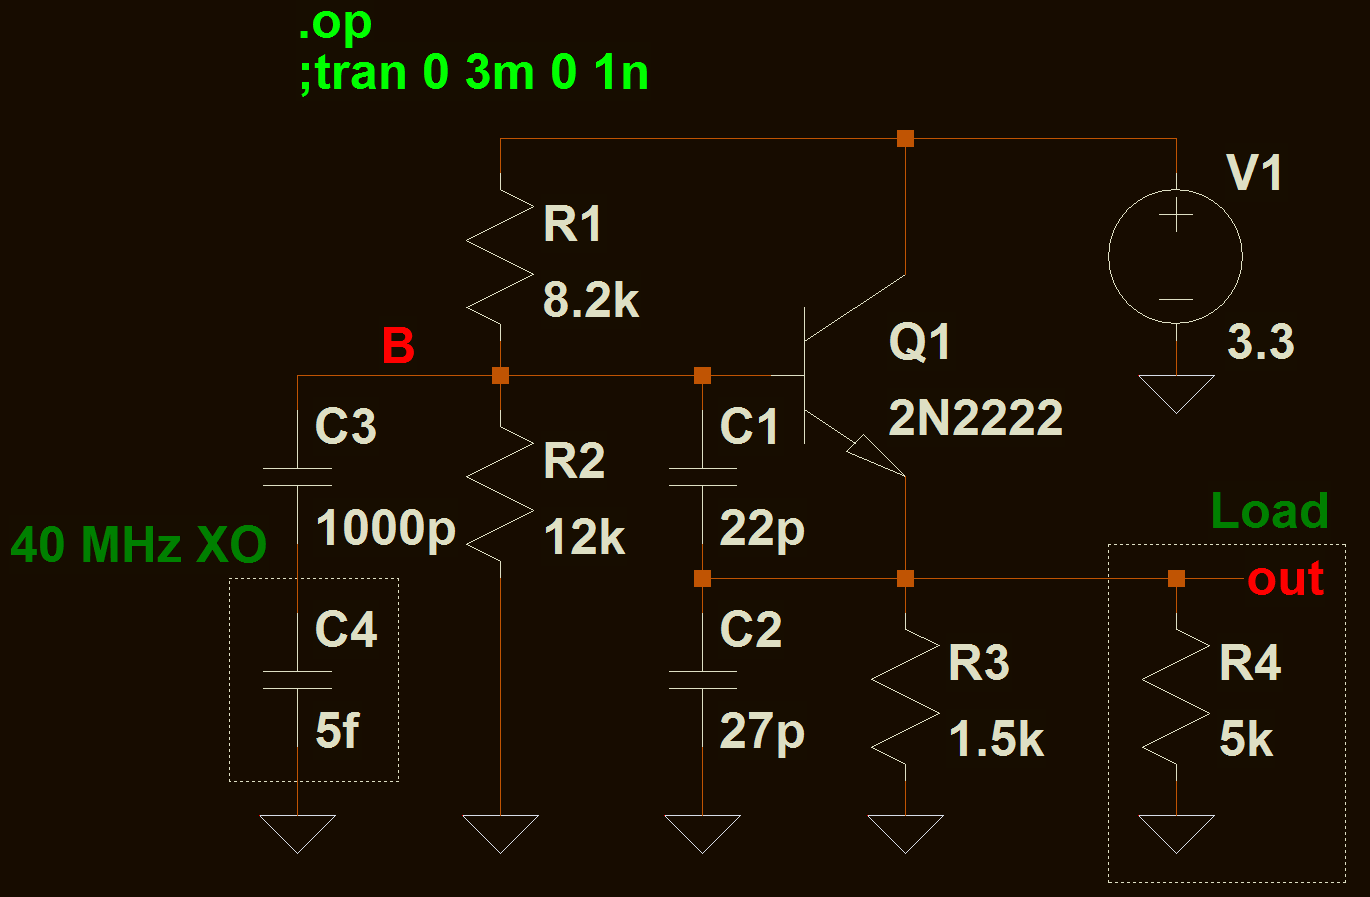
hardware/Colpitts oscillator 40 MHz common collector/sch.png
