marmote/marmote/hardware/M6-RF315/Datasheet/QFN-20 - LPC Land Pattern.PNG

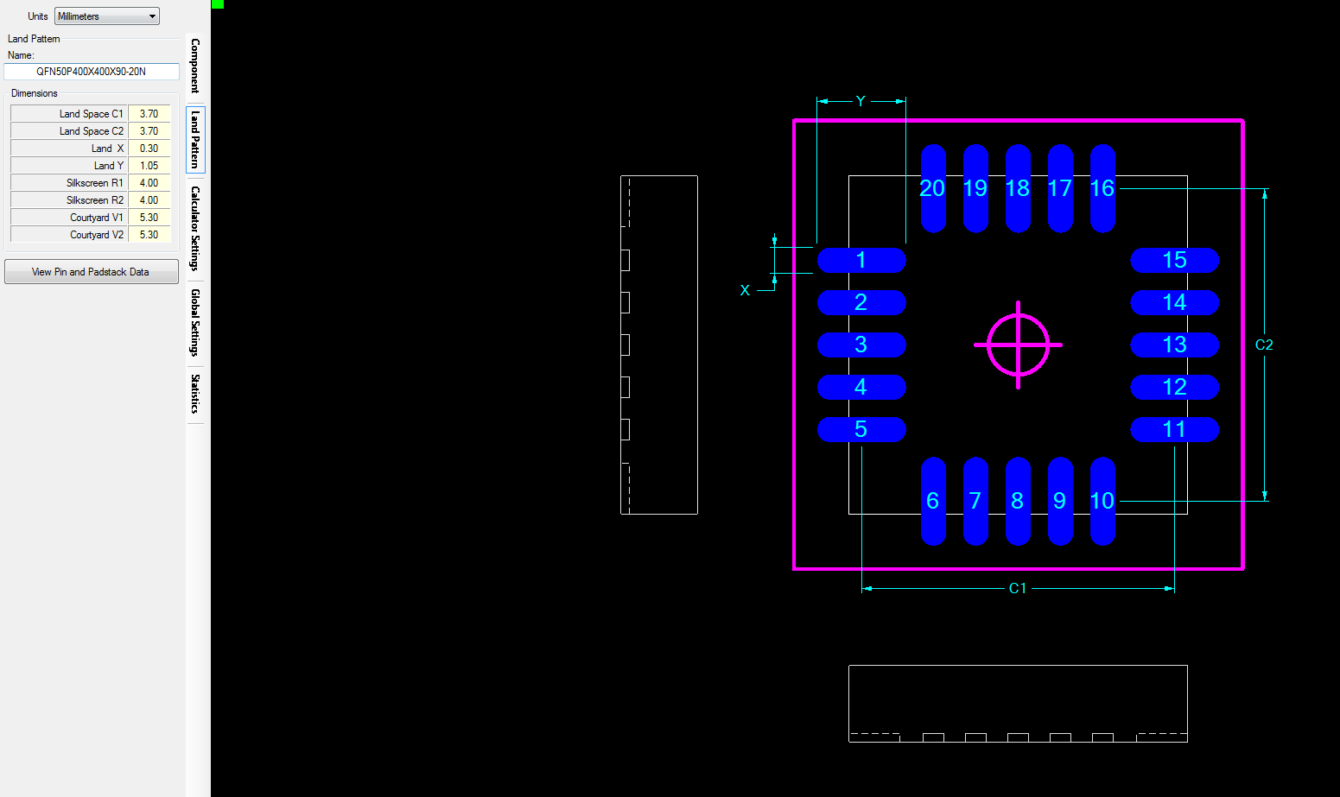
hardware/M6-RF315/Datasheet/QFN-20 - LPC Land Pattern.PNG
