marmote/marmote/hardware/MainBoard_RevB/Datasheet/Ethernet/LQFP-48-land-pattern.PNG

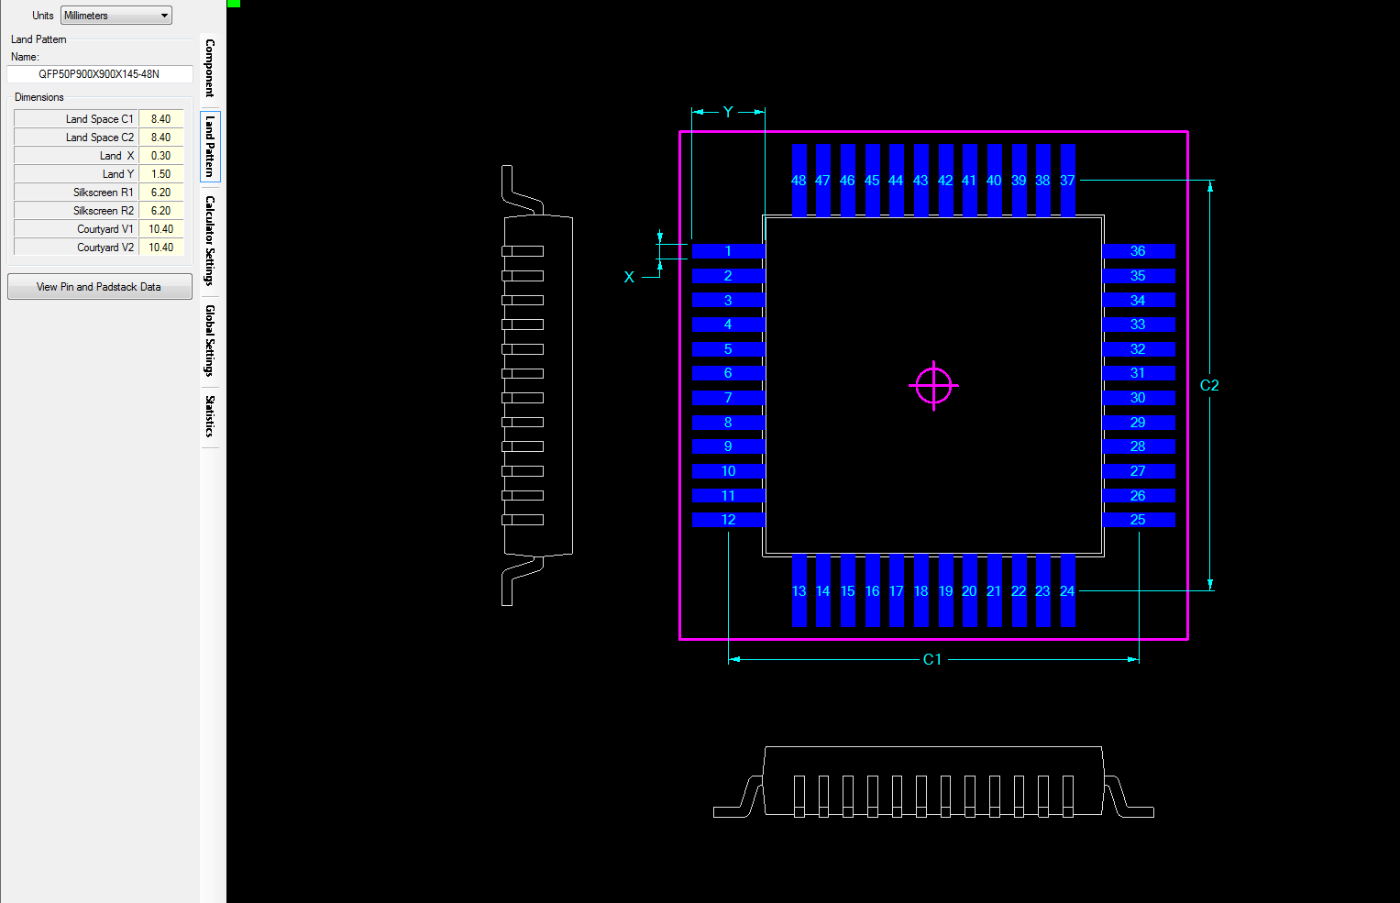
hardware/MainBoard_RevB/Datasheet/Ethernet/LQFP-48-land-pattern.PNG
