marmote/marmote/hardware/MainBoard_RevB/Misc/BlockDiagram.png

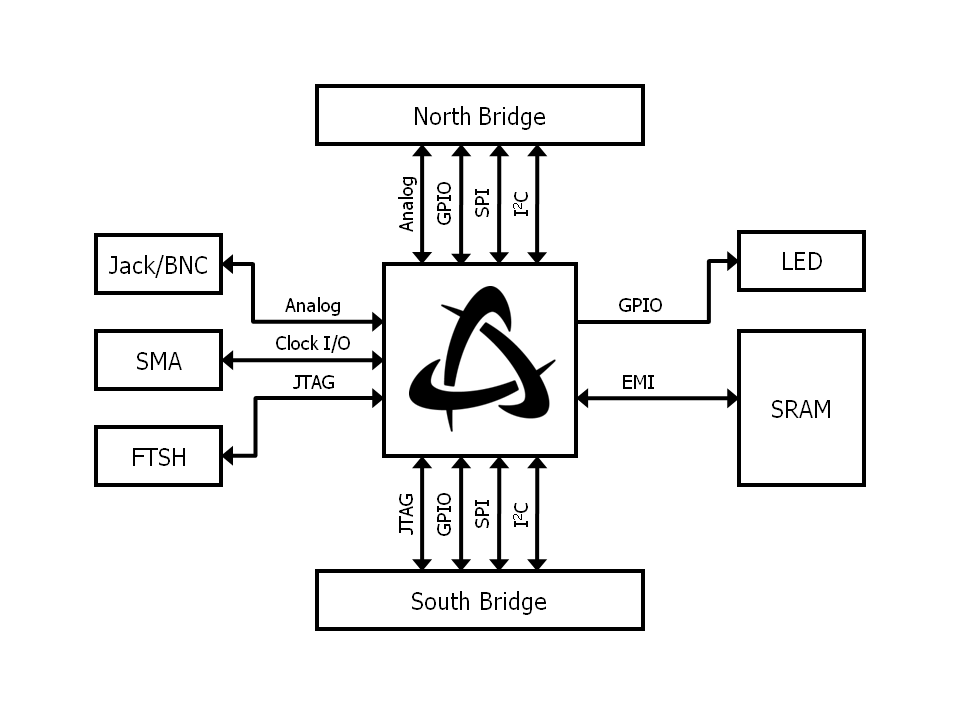
hardware/MainBoard_RevB/Misc/BlockDiagram.png
