marmote/marmote/hardware/MainBoard_RevB/Misc/MainBoardClocks.png

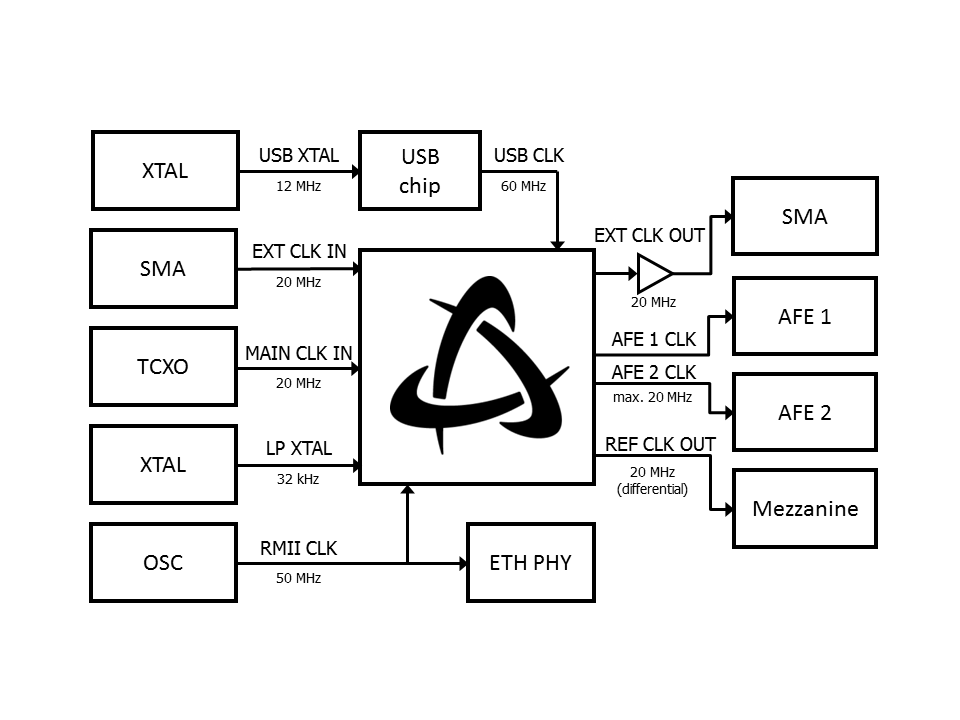
hardware/MainBoard_RevB/Misc/MainBoardClocks.png
