marmote/marmote/hardware/MainBoard_RevB/Misc/SmartFusionClocks.png

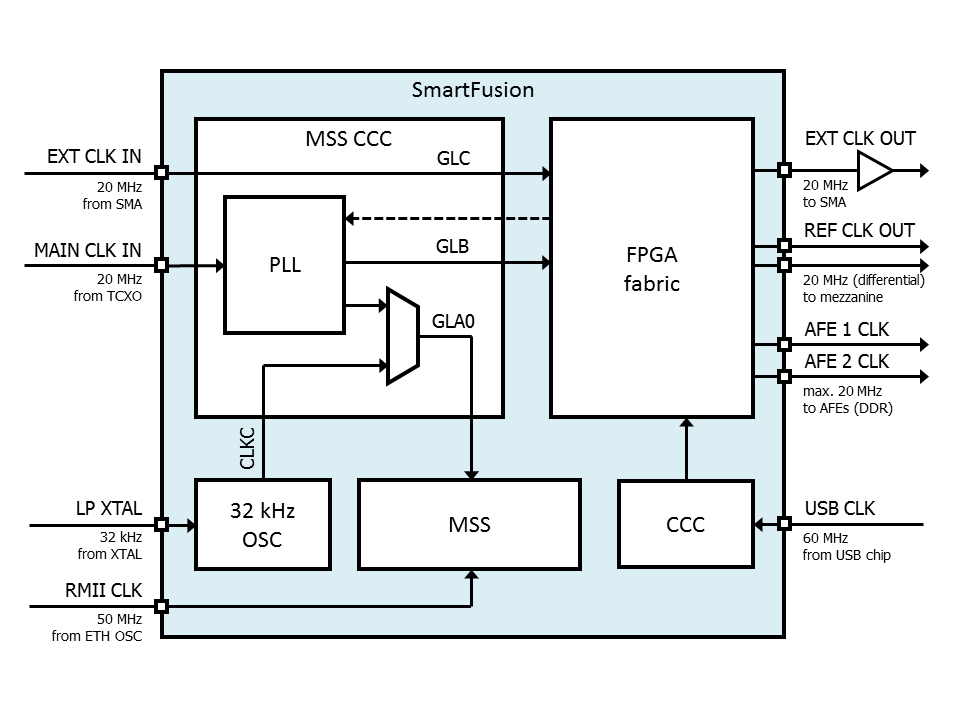
hardware/MainBoard_RevB/Misc/SmartFusionClocks.png
