marmote/marmote/hardware/PowerBoard_RevC/Datasheet/Connector/DM3AT footprint.png

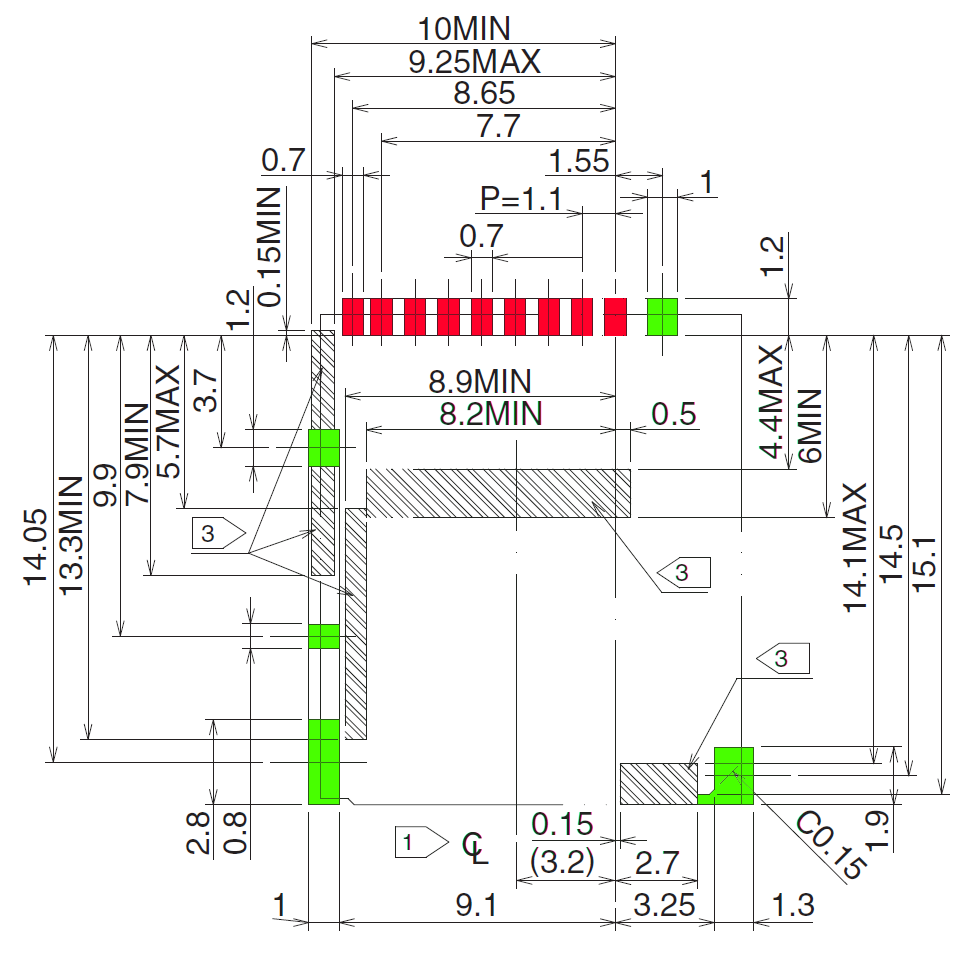
hardware/PowerBoard_RevC/Datasheet/Connector/DM3AT footprint.png
