marmote/marmote/hardware/PowerBoard_RevC/Misc/BlockDiagram.png

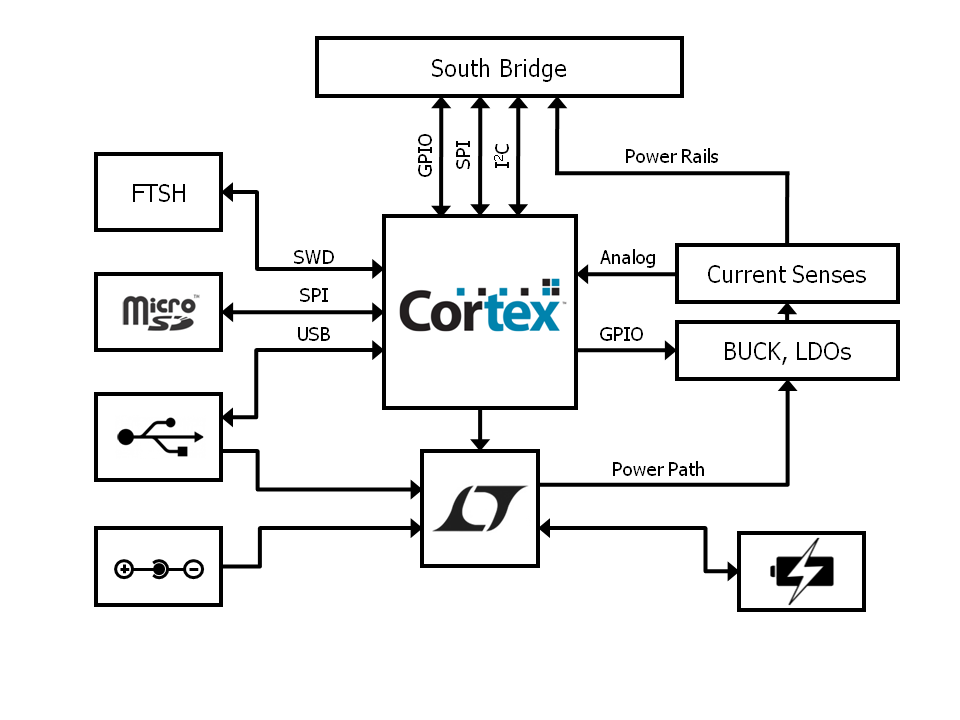
hardware/PowerBoard_RevC/Misc/BlockDiagram.png
