marmote/marmote/hardware/RFWBBoard_RevB/Misc/2012-10-19 - Marmote MAX924 20 MHz TCXO TX.png

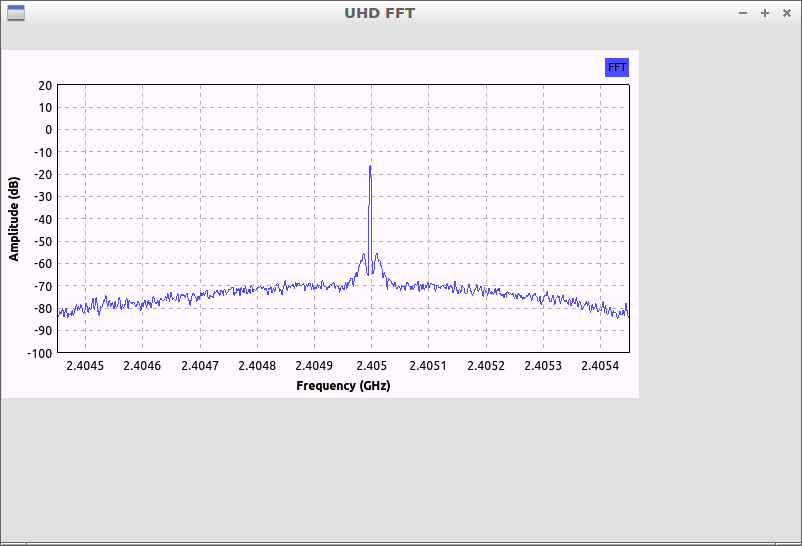
hardware/RFWBBoard_RevB/Misc/2012-10-19 - Marmote MAX924 20 MHz TCXO TX.png
