marmote/marmote/hardware/RFWBBoard_RevB/Misc/2012-10-19 - USRP TX.png

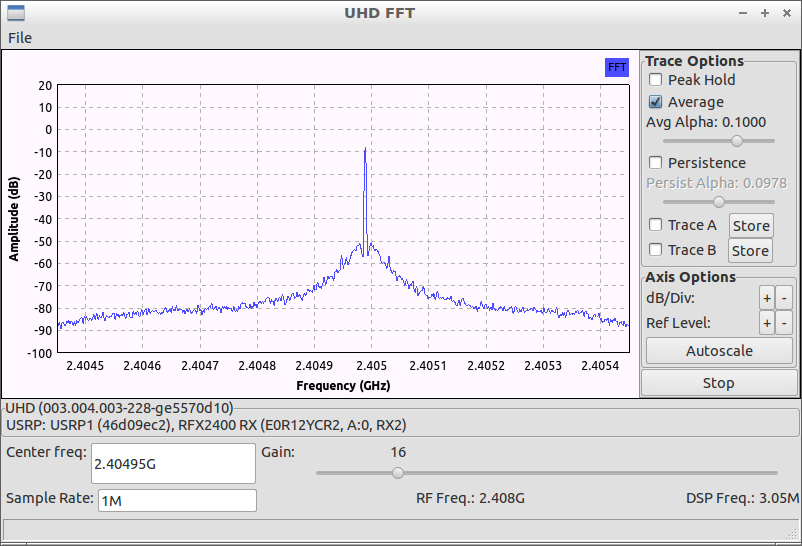
hardware/RFWBBoard_RevB/Misc/2012-10-19 - USRP TX.png
