marmote/marmote/hardware/RFWBBoard/RFWBBoard_BOM.xlsx

Bill of Materials for 'Marmote - Wide Band RF Board Rev B (Joshua)'
Item # | Reference | Value | Package | Manufacturer | Manufacturer Part # | Supplier | Supplier Part # | Details | Qty | Unit Price | Total Cost
1 | J1 |  |  | Molex Inc | 717423003 | Digikey | WM3499CT-ND | MEZZANINE 1MM BTB RECPT 84CKT | 1 |  | 0.000
2 | C41, C51, C61, C71, C101 | 10uF | 0805 (2012 Metric) | AVX Corporation | TAJR106M006RNJ | Digikey | 478-3051-1-ND | CAP TANT 10UF 6.3V 20% 0805 | 5 |  | 0.000
3 | C115, C117, C42, C45, C52, C62, C67, C72, C102, C124 | 100nF | 0402 (1005 Metric) | Murata | GRM155R61A104KA01J | Mouser Electronics | 81-GRM15R61A104KA01J | Multilayer Ceramic Capacitors (MLCC) - SMD/SMT 0402 0.1uF 10volts X5R 10% | 10 |  | 0.000
4 | R65, R66, R75, R76 | 24.9 | 0402 (1005 Metric) | Panasonic - ECG | ERJ-2RKF24R9X | Digikey | P24.9LCT-ND | RES 24.9 OHM 1/10W 1% 0402 SMD | 4 |  | 0.000
5 | R47, R48, R57, R58 | 49.9 | 0402 (1005 Metric) | Vishay/Dale | CRCW040249R9FKEDHP | Digikey | 541-49.9YCT-ND | RES 49.9 OHM .125W 1% 0402 SMD | 4 |  | 0.000
6 | R101 | 750 | 0402 (1005 Metric) | Panasonic - ECG | ERJ-2RKF7500X | Digikey | P750LCT-ND | RES 750 OHM 1/10W 1% 0402 SMD | 1 |  | 0.000
7 | R102 | 1.2k | 0402 (1005 Metric) | Panasonic - ECG | ERJ-2RKF1201X | Digikey | P1.20KLCT-ND | RES 1.20K OHM 1/10W 1% 0402 SMD | 1 |  | 0.000
8 | R1, R2 | 4.7k | 0402 (1005 Metric) | Panasonic - ECG | ERJ-2GEJ472X | Digikey | P4.7KJCT-ND | RES 4.7K OHM 1/10W 5% 0402 SMD | 2 |  | 0.000
9 | R451, R452, R671, R672 | 10k | 0402 (1005 Metric) | Panasonic - ECG | ERJ-2RKF1002X | Digikey | P10.0KLCT-ND | RES 10.0K OHM 1/10W 1% 0402 SMD | 4 |  | 0.000
10 | R61, R62, R63, R64, R71, R72, R73, R74 | 40.2k | 0402 (1005 Metric) | Panasonic - ECG | ERJ-2RKF4022X | Digikey | P40.2KLCT-ND | RES 40.2K OHM 1/10W 1% 0402 SMD | 8 |  | 0.000
11 | C118 | 68pF | 0402 (1005 Metric) | Murata | GRM1555C1H680JD01D | Mouser Electronics | 81-GRM1555C1H680JD01 | Multilayer Ceramic Capacitors (MLCC) - SMD/SMT 0402 68pF 50volt C0G +/-5% | 1 |  | 0.000
12 | C103, C106, C107, C108, C116, C120, C64, C74, C125 | 100pF | 0402 (1005 Metric) | Murata | GRM1555C1H101JA01D | Mouser Electronics | 81-GRM1555C1H101JA1D | Multilayer Ceramic Capacitors (MLCC) - SMD/SMT 0402 100pF 50volts C0G 5% | 9 |  | 0.000
13 | C119 | 2200pF | 0402 (1005 Metric) | Murata | GRM155R71H222KA01D | Mouser Electronics | 81-GRM36X222K50 | Multilayer Ceramic Capacitors (MLCC) - SMD/SMT 0402 2200pF 50volts X7R 10% | 1 |  | 0.000
14 | C109, C110, C111, C112, C113, C43, C53, C63, C73 | 0.01uF | 0402 (1005 Metric) | Murata | GRM155R71C103KA01D | Mouser Electronics | 81-GRM36X103K16 | Multilayer Ceramic Capacitors (MLCC) - SMD/SMT 0402 0.01uF 16volts X7R 10% | 9 |  | 0.000
15 | C105 | 10uF | 1206 (3015 Metric) | Murata | GRM31CR60J106KA01K | Mouser Electronics | 81-GRM31R60J106KA01K | Multilayer Ceramic Capacitors (MLCC) - SMD/SMT 1206 10uF 6.3volts X5R 10% | 1 |  | 0.000
16 | C114, C123 | 10uF | 0805 (2012 metric) | Murata | GRM21BR60J106KE19K | Mouser Electronics | 81-GRM21BR60J106KE9K | Multilayer Ceramic Capacitors (MLCC) - SMD/SMT 10uF 6.3Volts 10% | 2 |  | 0.000
17 | U1 |  | 48-WFQFN Exposed Pad | Maxim Integrated Products | MAX2830ETM+ | Digikey | MAX2830ETM+-ND | IC TXRX RF W/PA AND SW 48-TQFN | 1 |  | 0.000
18 | U2, U3 |  |  | Murata | LDB212G4010C-001 | Mouser Electronics | 81-LDB212G4010C-001 | Signal Conditioning 1206 2.40GHz 100ohm Baluns | 2 |  | 0.000
19 | U4, U5, U6, U7 |  | 8-MSOP (0.118", 3.00mm Width) | Analog Devices Inc | AD8132ARMZ | Digikey | AD8132ARMZ-ND | IC AMP DIFF LDIST LP 70MA 8MSOP | 4 |  | 0.000
20 | J2, J3, J4, J5, J6, J7, J8 |  |  | Linx Technologies Inc | CONSMA001-SMD | Digikey | CONSMA001-SMD-ND | CONNECTOR FEMALE SMD | 6 |  | 0.000
21 | X2 |  | 4-SMD, No Lead (DFN, LCC) | Fox Electronics | FOX924B-20.000 | Digikey | 631-1073-1-ND | OSCILLATOR TCXO 20.0MHZ 3.3V SMD | 1 |  | 0.000
22 | IC1 |  | TSSOP-8 | Microchip Technology | 24LC025-I/ST | Mouser Electronics | 579-24LC025-I/ST | EEPROM 256x8 | 1 |  | 0.000
23 | RWP0, RA20, RA10, RA00, R6 | 0 | 0402 (1005 Metric) | Panasonic - ECG | ERJ-2GE0R00X | Digikey | P0.0JDKR-ND | RES 0.0 OHM 1/10W 0402 SMD | 5 |  | 0.000
24 | R43, R44, R53, R54 | 1.58k | 0402 (1005 Metric) | Panasonic - ECG | ERJ-2RKF1581X | Digikey | P1.58KLDKR-ND | RES 1.58K OHM 1/10W 1% 0402 SMD | 4 |  | 0.000
25 | R45, R46, R55, R56 | 1.3k | 0402 (1005 Metric) | Panasonic - ECG | ERJ-2RKF1301X | Digikey | P1.30KLDKR-ND | RES 1.30K OHM 1/10W 1% 0402 SMD | 4 |  | 0.000
26 | R41, R42, R51, R52 | 10k | 0402 (1005 Metric) | Vishay/Dale | CRCW040210K0FKEDHP | Digikey | 541-10.0KYCT-ND | RES 10.0K OHM .125W 1% 0402 SMD | 4 |  | 0.000
27 | R7, R8, R9 | 0 | 1206 (3216 Metric) | Panasonic - ECG | ERJ-8GEY0R00V | Digikey | P0.0ECT-ND | RES 0.0 OHM 1/4W 1206 SMD | 3 |  | 0.000
28 | R10 | 30k | 0402 (1005 Metric) | Panasonic - ECG | ERJ-2GEJ303X | Digikey | P30KJCT-ND | RES 30K OHM 1/10W 5% 0402 SMD | 1 |  | 0.000
29 | C128 | 1000pF | 0402 (1005 Metric) | Murata | GRM155R71H102KA01J | Mouser Electronics | 81-GRM15R71H102KA01J | Multilayer Ceramic Capacitors (MLCC) - SMD/SMT 0402 1000pF 50volts X7R 10% | 1 |  | 0.000
30 | C126 | 18pF | 0402 (1005 Metric) | Murata | GRM1555C1H180JA01D | Mouser Electronics | 81-GRM1555C1H180JA1D | Multilayer Ceramic Capacitors MLCC - SMD/SMT 0402 18pF 50volts C0G 5% | 1 |  | 0.000
31 | C127 | 33pF | 0402 (1005 Metric) | Murata | GRM1555C1H330JA01D | Mouser Electronics | 81-GRM1555C1H330JA1D | Multilayer Ceramic Capacitors MLCC - SMD/SMT 0402 33pF 50volts C0G 5% | 1 |  | 0.000
32 | X1 |  |  | Kyocera | CX101F-040.000-H0445 | Digikey | 478-4817-1-ND | CRYSTAL 40.000MHZ 12PF SMD | 1 |  | 0.000
33 | SW1, SW2, SW3, SW4 | SWITCH-CJS-1200-1200 | J-Lead | CJS | CJS-1200TA | Digi-Key | 563-1021-1-ND | CJS-1200 SPDT Switch | 4 |  | 0.000
34 | C121 | DNP (1000pF) | 0402 (1005 Metric) | Murata | GRM155R71H102KA01J | Mouser Electronics | 81-GRM15R71H102KA01J | Multilayer Ceramic Capacitors (MLCC) - SMD/SMT 0402 1000pF 50volts X7R 10% | 1
35 | C104, RWP1, RA21, RA11, RA01, R5, R4 | DNP |  |  |  |  |  |  | 7
 |  |  |  |  |  |  |  | Total | 115 |  | 0.000
