marmote/marmote/hardware/BreakoutBoard/BreakoutBoard_BOM.xlsx

Bill of Materials for 'Marmote - Breakout Board Rev B (Smoky)'
Item # | Reference | Value | Package | Manufacturer | Manufacturer Part # | Supplier | Supplier Part # | Details | Qty | Unit Price | Total Cost
1 | J1 | CON-71741-2184-TOP | CON-71741-2184-TOP | Molex | 71741-0002 | Digi-Key | WM3498CT-ND | MEZZANINE 1MM BTB PLUG 84CKT | 1 | 6.24 | 6.24
2 | J2 | CON-71741-2184-BOT | CON-71741-2184-BOT | Molex | 71742-3003 | Digi-Key | WM3499CT-ND | MEZZANINE 1MM BTB RECPT 84CKT | 1 | 5.81 | 5.81
3 | J3, J4, J5, J6, J7, J8, J9, J10, J11, J12, J13* | CON-2X8 | CON-2X8 | Samtec | TSW-150-08-T-D-RA | Digi-Key | SAM1049-50-ND | CONN HEADR 100PS .100 DL R/A TIN | 1 | 4.62 | 4.62
4 | R31, R32, R33, R34 | 0 | R0805 | Rohm | MCR10EZHJ000 | Digi-Key | RHM0.0ACT-ND | RES 0.0 OHM 1/8W 0805 SMD | 4 | 0.041 | 0.164
5 | TP1, TP3, TP5 | TESTPOINT | TESTPOINT-BLUE | Keystone | 5122 | Digi-Key | 5122K-ND | TEST POINT PC COMPACT T/H BLUE | 3 | 0.38 | 1.14
6 | TP7, TP9 | TESTPOINT | TESTPOINT-GREEN | Keystone | 5121 | Digi-Key | 5121K-ND | TEST POINT PC COMPACT T/H GREEN | 2 | 0.38 | 0.76
7 | TP11, TP12, TP13, TP14 | TESTPOINT | TESTPOINT-YELLOW | Keystone | 5009 | Digi-Key | 5009K-ND | TEST POINT PC COMPACT .063"D YLW | 4 | 0.36 | 1.44
8 | Standoff | DNP | MOUNT-HOLE3.3 | Keystone | 7200 | Digi-Key | 7200K-ND | STANDOFF HEX M/F .375"L 4-40 BR | 4 | 0.68 | 2.72
 |  |  |  |  |  |  |  | Total | 19 |  | 16.654
*Note: The parts for J3, J4, ... J13 come from a single 2x50 header that needs to be cut by hand prior to assembling.
