marmote/marmote/hardware/MainBoard_RevB/MainBoard_RevB_BOM.xlsx

Bill of Materials for 'Marmote - Main Board Rev B (Teton)'
Item # | Reference | Value | Package | Manufacturer | Manufacturer Part # | Supplier | Supplier Part # | Details | Qty | Unit Price | Total Cost
1 | B1 | 70R/4A | BEAD-BLM18SG700TN1D0603 | Murata | BLM18SG700TN1D | Digi-Key | 490-5224-1-ND | FERRITE CHIP 70 OHM 4000MA 0603 | 1 | 0.38 | 0.38
2 | B2, B3, B4 | 600R/0.5A | BEAD-BLM18EG601SN1D0603 | Murata | BLM18EG601SN1D | Digi-Key | 490-3994-2-ND | FILTER CHIP 600 OHM 500MA 0603 | 3 | 0.38 | 1.14
3 | C1, C40, C70, C72, C74, C76, C78, C80, C82, C84, C100, C102, C104, C106, C108, C110, C112, C114 | 2.2uF | C0402 | Taiyo Yuden | LMK105BJ225MV-F | Digi-Key | 587-3153-1-ND | CAP CER 2.2UF 10V 20% X5R 0402 | 18 | 0.3 | 5.4
4 | C2, C3, C4, C5, C6, C7, C8, C9, C10, C11, C12, C13, C14, C15, C16, C17, C18, C19, C20, C21, C22, C23, C24, C25, C26, C28, C30, C31, C32, C33, C34, C35, C37, C43, C44, C69, C71, C73, C75, C77, C79, C81, C83, C85, C99, C101, C103, C105, C107, C109, C111, C113, C115, C118, C119, C120, C121, C122, C124, C125, C126, C128, C130, C134, C137, C139, C141, C143, C144, C145, C146, C147, C148 | 0.1uF | C0402 | TDK | C1005X7R1C104K | Digi-Key | 445-4952-1-ND | CAP CER 0.1UF 16V 10% X7R 0402 | 73 | 0.09 | 6.57
5 | C29, C42, C46, C133, C135 | 0.01uF | C0402 | TDK | C1005X7R1C103M | Digi-Key | 445-4943-1-ND | CAP CER 10000PF 16V 20% X7R 0402 | 5 | 0.08 | 0.4
6 | C36, C38, C131, C132 | 10pF | C0402 | TDK | C1005C0G1H100D | Digi-Key | 445-1235-1-ND | CAP CER 10PF 50V NP0 0402 | 4 | 0.08 | 0.32
7 | C39, C41 | 4pF | C0402 | TDK | CGA2B2C0G1H040C | Digi-Key | 445-5576-1-ND | CAP CER 4PF 50V NP0 0402 | 2 | 0.2 | 0.4
8 | C45, C66, C67, C68, C96, C97, C98 | 0.33uF | C0402 | TDK | C1005X5R1C334K | Digi-Key | 445-4974-1-ND | CAP CER 0.33UF 16V 10% X5R 0402 | 7 | 0.28 | 1.96
9 | C47, C48, C52, C53, C54, C55, C57, C58, C60, C62, C63, C65, C87, C88, C90, C92, C93, C95 | DNP | C0402 |  |  |  |  | CAPACITOR | 18 |  | 0
10 | C56, C59, C61, C64, C86, C89, C91, C94 | 22pF | C0402 | TDK | C1005C0G1H220J | Digi-Key | 445-1239-1-ND | CAP CER 22PF 50V 5% NP0 0402 | 8 | 0.08 | 0.64
11 | C116 | 1000pF | C0805 | TDK | C2012X7R2E102K | Digi-Key | 445-2277-1-ND | CAP CER 1000PF 250V 10% X7R 0805 | 1 | 0.17 | 0.17
12 | C27, C49, C50, C51, C123, C127, C129, C136, C138, C140, C142 | 4.7uF | C0402 | TDK | C1005X5R1A475M | Digi-Key | 445-8023-1-ND | CAP CER 4.7UF 10V 20% X5R 0402 | 11 | 0.53 | 5.83
13 | J1 | CON-ZX62R-B-5P | CON-ZX62R-B-5P | Hirose | ZX62R-B-5P | Digi-Key | H11574CT-ND | ZX62R-B-5P | 1 | 1.6 | 1.6
14 | J2 | CON-RJ45-J0011D21BNL | CON-RJ45-J0011D21BNL | Pulse Electronics Corporation | J0011D21BNL | Digi-Key | 553-1485-ND | CONN PULSEJACK 1PORT 10/100B-TX | 1 | 7.1 | 7.1
15 | J3 | CON-FTSH-105-01-L-DV-K | CON-FTSH-105-01-L-DV-K | Samtec | FTSH-105-01-L-DV-K | Digi-Key | FTSH-105-01-L-DV-K-ND | CONN HEADER 10 POS DUAL .05" SMD | 1 | 3.45 | 3.45
16 | J4 | CON-71741-2184-BOT | CON-71741-2184-BOT | Molex | 71742-3003 | Digi-Key | WM3499CT-ND | MEZZANINE 1MM BTB RECPT 84CKT | 1 | 5.81 | 5.81
17 | J5 | CON-71741-2184-TOP | CON-71741-2184-TOP | Molex | 71741-0002 | Digi-Key | WM3498CT-ND | MEZZANINE 1MM BTB PLUG 84CKT | 1 | 6.24 | 6.24
18 | L1, L2 | 33nH | L0603 | JW Miller | PM0603-33NJ-RC | Digi-Key | M8487CT-ND | INDUCTOR CHIP 33NH 5% SMD | 2 |  | 0
19 | LED1 | LED-MGC-3010 | LED-MGC-3010 | Kingbright | APECVA3010MGC | Digi-Key | 754-1364-1-ND | LED 3.0X1.0MM 568NM GRN RA SMD | 1 | 0.6 | 0.6
20 | LED2 | LED-ECK-3010 | LED-ECK-3010 | Kingbright | APECVA3010SECK | Digi-Key | 754-1367-1-ND | LED 3X1MM 601NM ORN RA CHIP SMD | 1 | 0.33 | 0.33
21 | Q1 | MMBT3904 | MMBT3904 | Fairchild Semiconductor | MMBT3904 | Digi-Key | MMBT3904FSCT-ND | TRANSISTOR GP NPN AMP SOT-23 | 1 | 0.37 | 0.37
22 | R1, R2, R57, R58, R59, R60 | 10k | R0402 | Rohm | MCR01MRTF1002 | Digi-Key | RHM10.0KCDCT-ND | RES 10.0K OHM 1/16W 1% 0402 SMD | 6 | 0.023 | 0.138
23 | R19, R20, R21, R22, R25, R26, R27, R28 | 24.9 | R0402 | Vishay Dale | CRCW040224R9FKED | Digi-Key | 541-24.9LCT-ND | RES 24.9 OHM 1/16W 1% 0402 SMD | 8 | 0.083 | 0.664
24 | R23, R24, R29, R30, R68, R69 | 100k | R0402 | Rohm | TRR01MZPF1003 | Digi-Key | RHM100KBHCT-ND | RES 100K OHM 1/16W 1% 0402 SMD | 6 | 0.123 | 0.738
25 | R3, R7, R8, R62, R63, R64, R65 | 39 | R0402 | Rohm | MCR01MZPF39R0 | Digi-Key | RHM39.0LCT-ND | RES 39.0 OHM 1/16W 1% 0402 SMD | 7 | 0.026 | 0.182
26 | R31 | 1.5k | R0402 | Rohm | TRR01MZPF1501 | Digi-Key | RHM1.50KBHCT-ND | RES 1.50K OHM 1/16W 1% 0402 SMD | 1 | 0.123 | 0.123
27 | R32, R42 | 100 | R0402 | Rohm | TRR01MZPF1000 | Digi-Key | RHM100BHCT-ND | RES 100 OHM 1/16W 1% 0402 SMD | 2 | 0.201 | 0.402
28 | R33, R34, R35, R36 | 49.9 | R0402 | Rohm | MCR01MRTF49R9 | Digi-Key | RHM49.9CDCT-ND | RES 49.9 OHM 1/16W 1% 0402 SMD | 4 | 0.023 | 0.092
29 | R37, R38, R39, R40, R43, R44, R45 | 22 | R0402 | Rohm | MCR01MRTF22R0 | Digi-Key | RHM22.0CDCT-ND | RES 22.0 OHM 1/16W 1% 0402 SMD | 7 | 0.023 | 0.161
30 | R4, R11, R12, R13, R15, R16, R17, R18, R74, R75 | 0 | R0402 | Rohm | TRR01MZPJ000 | Digi-Key | RHM0.0BICT-ND | RES 0.0 OHM 1/16W 0402 SMD | 11 | 0.181 | 1.991
30 | R14 | DNP | R0402 | Rohm | TRR01MZPJ000 | Digi-Key | RHM0.0BICT-ND | RES 0.0 OHM 1/16W 0402 SMD | 1 | 0.181 | 0.181
31 | R41, R46, R47, R48, R50, R51, R52 | 2.2k | R0402 | Rohm | MCR01MRTF2201 | Digi-Key | RHM2.20KCDCT-ND | RES 2.20K OHM 1/16W 1% 0402 SMD | 7 | 0.023 | 0.161
32 | R5, R6, R9, R10 | 1k | R0402 | Rohm | TRR01MZPF1001 | Digi-Key | RHM1.00KBHCT-ND | RES 1.00K OHM 1/16W 1% 0402 SMD | 4 | 0.123 | 0.492
33 | R53 | 4.87k | R0402 | Vishay Dale | CRCW04024K87FKED | Digi-Key | 541-4.87KLCT-ND | RES 4.87K OHM 1/16W 1% 0402 SMD | 1 | 0.083 | 0.083
34 | R54 | 12k | R0402 | Vishay Dale | CRCW040212K0FKED | Digi-Key | 541-12.0KLCT-ND | RES 12.0K OHM 1/16W 1% 0402 SMD | 1 | 0.083 | 0.083
35 | R55 | 27 | R0402 | Vishay Dale | CRCW040227R0FKED | Digi-Key | 541-27.0LCT-ND | RES 27.0 OHM 1/16W 1% 0402 SMD | 1 | 0.083 | 0.083
36 | R56 | 39k | R0402 | Vishay Dale | CRCW040239K0FKED | Digi-Key | 541-39.0KLCT-ND | RES 39.0K OHM 1/16W 1% 0402 SMD | 1 | 0.083 | 0.083
37 | R61 | 2k | R0402 | Vishay Dale | CRCW04022K00FKED | Digi-Key | 541-2.00KLCT-ND | RES 2.00K OHM 1/16W 1% 0402 SMD | 1 | 0.083 | 0.083
38 | R66, R72, R73 | 100 | R0402 | Vishay Dale | CRCW0402100RFKED | Digi-Key | 541-100LCT-ND | RES 100 OHM 1/16W 1% 0402 SMD | 3 | 0.083 | 0.249
39 | R67 | 330 | R0402 | Vishay Dale | CRCW0402330RFKED | Digi-Key | 541-330LCT-ND | RES 330 OHM 1/16W 1% 0402 SMD | 1 | 0.083 | 0.083
40 | R70, R71 | 4.7k | R0402 | Vishay Dale | CRCW04024K70FKED | Digi-Key | 541-4.70KLCT-ND | RES 4.70K OHM 1/16W 1% 0402 SMD | 2 | 0.083 | 0.166
41 | R76 | DNP | R0603 |  |  |  |  | RESISTOR | 1 |  | 0
42 | SW1, SW2 | SWITCH-ESWITCH-TL3340G | SWITCH-ESWITCH-TL3340G | E-Switch | TL3340AF160QG | Digi-Key | EG4627CT-ND | SWITCH TACTILE SPST-NO 0.05A 12V | 2 | 0.291 | 0.582
43 | SW3 | SWITCH-CJS-1200-1200 | J-Lead | CJS | CJS-1200TA | Digi-Key | 563-1021-1-ND | CJS-1200 SPDT Switch | 1 | 0.97 | 0.97
44 | TP1, TP2 | TESTPOINT-YELLOW | TESTPOINT-YELLOW | Keystone | 5009 | Digi-Key | 5009K-ND | TEST POINT PC COMPACT .063"D YLW | 2 | 0.35 | 0.7
45 | TP3, TP4 | TESTPOINT-GREEN | TESTPOINT-GREEN | Keystone | 5121 | Digi-Key | 5121K-ND | TEST POINT PC COMPACT T/H GREEN | 2 | 0.35 | 0.7
46 | U1 | A2F500M3G-1FGG256 | A2F500M3G-1FGG256 | Microsemi | A2F500M3G-1FGG256 | Digi-Key | 1100-1007-ND | IC FPGA 512K FLASH 256FPBGA | 1 | 53.91 | 53.91
47 | U2, U3 | MAX19706-T4877-4 | MAX19706-T4877-4 | Maxim | MAX19706ETM+ | Digi-Key | MAX19706ETM+-ND | IC ANLG FRNT END 48-TQFN | 2 | 20.09 | 40.18
48 | U4 | USBLC6-2SC6 | USBLC6-2SC6 | STMicroelectronics | USBLC6-2SC6 | Digi-Key | 497-5235-1-ND | USBLC6-2SC6 | 1 | 0.95 | 0.95
49 | U5 | FT232HL | FT232HL | FTDI | 768-1101-1-ND | Digi-Key | 768-1101-1-ND | IC HS USB TO UART/FIFO 48LQFP | 1 | 4.25 | 4.25
50 | U6 | DP83848C-VBH48A | DP83848C-VBH48A | National Semiconductor | DP83848C | Digi-Key | DP83848CVV-ND | IC TXRX ETHERNET PHYTER 48-LQFP | 1 | 6.66 | 6.66
51 | U7 | 93LC56BT-OT | 93LC56BT-OT | Microchip Technology | 93LC56BT-I/OT | Digi-Key | 93LC56BT-I/OTCT-ND | IC EEPROM 2KBIT 3MHZ SOT23-6 | 1 | 0.34 | 0.34
52 | U8 | DS1818-10-SOT-23 | DS1818-10-SOT-23 | Maxim | DS1818R-10+T&R | Digi-Key | DS1818R-10+CT-ND | IC ECONRST 3.3V W/PB 10% SOT23-3 | 1 | 0.81 | 0.81
53 | X1 | ECX-2236-200 | ECX-2236-200 | ECS | ECS-200-8-36CKM | Digi-Key | XC1556CT-ND | CRYSTAL 20.000 MHZ 8PF SMD | 1 | 4.31 | 4.31
54 | X2 | ECX-31B | ECX-31B | ECS | ECS-.327-7-34B-TR | Digi-Key | XC1656CT-ND | CRYSTAL 32.768 KHZ 7PF SMD | 1 | 1.58 | 1.58
55 | X3 | ASEM1-C | ASEM1-C | Abracon | ASEM1-50.000MHZ-LC-T | Digi-Key | 535-9774-1-ND | OSC MEMS 50.000 MHZ 3.3V SMD | 1 | 2.59 | 2.59
56 | X4 | ECX-42-120 | ECX-42-120 | ECS | ECS-120-9-42-CKM-TR | Digi-Key | XC1608CT-ND | CRYSTAL 12.000 MHZ 9PF SMD | 1 | 2.06 | 2.06
57 | Standoff | DNP | MOUNT-HOLE3.3 | Keystone | 7200 | Digi-Key | 7200K-ND | STANDOFF HEX M/F .375"L 4-40 BR | 4 | 0.68 | 2.72
