marmote/marmote/hardware/PowerBoard_RevC/PowerBoard_RevC_BOM.xlsx

Bill of Materials for 'Marmote - Power Supply Board Rev C (Yellowstone)'
Item # | Reference | Value | Package | Manufacturer | Manufacturer Part # | Supplier | Supplier Part # | Details | Qty | Unit Price | Total Cost
1 | B1, B2 | 20mOhm@DC, 70Ohm@100MHz | BEAD0603 | Murata | BLM18SG700TN1D | Digi-Key | 490-5224-1-ND | FERRITE CHIP 70OHM 4A 0603 | 2 | 0.353 | 0.706
2 | C4, C5 | DNP | C0603 | TDK | C1608C0G1H040B | Digi-Key | 445-5028-1-ND | CAP CER 4.0PF 50V C0G 0603 | 2 | 0.16 | 0.32
3 | C2, C3 | 10pF | C0603 | TDK | C1608C0G1H100J | Digi-Key | 445-6852-1-ND | CAP CER 10PF 50V C0G 5% 0603 | 2 | 0.12 | 0.24
4 | C22 | 10nF | C0603 | TDK | C1608X7R1E103K | Digi-Key | 445-5100-1-ND | CAP CER 10000PF 25V X7R 10% 0603 | 1 | 0.08 | 0.08
5 | C15, C16, C17, C18, C19 | 0.1uF | C0603 | TDK | C1608X7R1C104K | Digi-Key | 445-1317-1-ND | CAP CER .10UF 16V 10% X7R 0603 | 5 | 0.08 | 0.4
6 | C1 | 0.15uF | C0603 | TDK | C1608X7R1C154K | Digi-Key | 445-5123-1-ND | CAP CER .15UF 16V 10% X7R 0603 | 1 | 0.2 | 0.2
7 | C21 | 1uF | C0603 | TDK | C1608X7R1C105K | Digi-Key | 445-1604-1-ND | CAP CER 1.0UF 16V X7R 10% 0603 | 1 | 0.23 | 0.23
8 | C7, C8, C10, C11, C14, C20 | 4.7uF | C0603 | TDK | C1608X5R0J475K | Digi-Key | 445-5178-1-ND | CAP CER 4.7UF 6.3V X5R 0603 | 6 | 0.36 | 2.16
9 | C6, C9, C12, C13 | 10uF | C0603 | TDK | C1608X5R0J106M | Digi-Key | 445-4112-1-ND | CAP CER 10UF 6.3V X5R 20% 0603 | 4 | 0.46 | 1.84
10 | J1 | CON-HRS-DM3AT | CON-HRS-DM3AT | Hirose | DM3AT-SF-PEJM5 | Digi-Key | HR1964CT-ND | CONN MICRO SD R/A PUSH-PUSH SMD | 1 | 3.01 | 3.01
11 | J2 | CON-ZX62R-B-5P | CON-ZX62R-B-5P | Hirose | ZX62R-B-5P | Digi-Key | H11574CT-ND | CONN RCPT MICRO USB B SMD R/A | 1 | 1.56 | 1.56
12 | J3 | CON-FTSH-105-01-L-DV-K | CON-FTSH-105-01-L-DV-K | Samtec | FTSH-105-01-L-DV-K | Digi-Key | FTSH-105-01-L-DV-K-ND | CONN HEADER 10 POS DUAL .05" SMD | 1 | 3.36 | 3.36
13 | J4, SW1 | CON-S2B-PH-SM4-TB | CON-S2B-PH-SM4-TB | JST | S2B-PH-SM4-TB(LF)(SN) | Digi-Key | 455-1749-1-ND | CONN HEADER PH SIDE 2POS 2MM SMD | 2 | 0.5 | 1
14 | J5 | CON-PJ-102A | CON-PJ-102A | CUI | PJ-102A | Digi-Key | CP-102A-ND | CONN JACK POWER 2.1MM PCB | 1 | 0.8 | 0.8
15 | J6 | CON-71741-0002 | CON-71741-0002 | Molex | 71741-0002 | Digi-Key | WM3498CT-ND | MEZZANINE 1MM BTB PLUG 84CKT | 1 | 6.24 | 6.24
16 | J7 | SWITCH-CJS-1200-1200 | J-Lead | CJS | CJS-1200TA | Digi-Key | 563-1021-1-ND | CJS-1200 SPDT Switch | 1 | 0.97 | 0.97
17 | L1 | 1.6uH | L-VLCF4018T | TDK | VLCF4018T-1R6N1R7-2 | Digi-Key | 445-3171-1-ND | INDUCTOR POWER 1.6UH 1.7A SMD | 1 | 0.72 | 0.72
18 | LED2 | ORANGE | LED1208-RA | Kingbright | APECVA3010SECK | Digi-Key | 754-1367-1-ND | LED 3X1MM 601NM ORN RA CHIP SMD | 1 | 0.28 | 0.28
19 | LED1 | GREEN | LED1208-RA | Kingbright | APECVA3010MGC | Digi-Key | 754-1364-1-ND | LED 3.0X1.0MM 568NM GRN RA SMD | 1 | 0.63 | 0.63
20 | Q1 | SI2323CDS | SI2323CDS | Vishay | SI2323CDS-T1-GE3 | Digi-Key | SI2323CDS-T1-GE3CT-ND | MOSFET P-CH 20V SOT-23 | 1 | 0.76 | 0.76
21 | Q2 | SI2312CDS | SI2312CDS | Vishay | SI2312CDS-T1-GE3 | Digi-Key | SI2312CDS-T1-GE3CT-ND | MOSFET N-CH 20V SOT-23 | 1 | 0.45 | 0.45
22 | Q3, Q4 | SI2333CDS | SI2333CDS | Vishay | SI2333CDS-T1-GE3 | Digi-Key | SI2333CDS-T1-GE3CT-ND | MOSFET P-CH D-S 12V SOT-23 | 2 | 0.84 | 1.68
23 | R13, R42, R43, R44, R212 | DNP | R0603 |  |  |  |  |  | 5 |  | 0
24 | R1, R12, R14, R211, R24, R25, R45, R451, R452, R453 | 0 | R0603 | Rohm | MCR03ERTJ000 | Digi-Key | RHM0.0GCT-ND | RES 0.0 OHM 1/10W 0603 SMD | 10 | 0.018 | 0.18
25 | R16, R17, R18, R19, R20 | 50m | R0603 | Vishay | WSL0603R0500FEA18 | Digi-Key | WSLL-.05CT-ND | RES .05 OHM 0.2W 1% 0603 SMD | 5 | 1.32 | 6.6
26 | R26, R27 | 1 | R0603 | Rohm | MCR03EZPJ1R0 | Digi-Key | RHM1.0GCT-ND | RES 1.0 OHM 1/10W 5% 0603 SMD | 2 | 0.018 | 0.036
27 | R49, R50 | 22 | R0603 | Rohm | MCR03EZPFX22R0 | Digi-Key | RHM22.0HCT-ND | RES 22.0 OHM 1/10W 1% 0603 SMD | 2 | 0.023 | 0.046
28 | R22, R34, R35, R38, R39 | 100 | R0603 | Rohm | MCR03ERTJ101 | Digi-Key | RHM100GCT-ND | RES 100 OHM 1/10W 5% 0603 SMD | 5 | 0.018 | 0.09
29 | R23 | 330 | R0603 | Rohm | MCR03EZPFX3300 | Digi-Key | RHM330HCT-ND | RES 330 OHM 1/10W 1% 0603 SMD | 1 | 0.023 | 0.023
30 | R51 | 1.5k | R0603 | Rohm | MCR03ERTF1501 | Digi-Key | RHM1.50KCFCT-ND | RES 1.50K OHM 1/10W 1% 0603 SMD | 1 | 0.21 | 0.21
31 | R7 | 2.1k | R0603 | Rohm | MCR03EZPFX2101 | Digi-Key | RHM2.10KHCT-ND | RES 2.10K OHM 1/10W 1% 0603 SMD | 1 | 0.023 | 0.023
32 | R11, R29, R32, R33, R36, R37 | 4.7k | R0603 | Rohm | MCR03ERTJ472 | Digi-Key | RHM4.7KGCT-ND | RES 4.7K OHM 1/10W 5% 0603 SMD | 6 | 0.018 | 0.108
33 | R9 | 10k | NTCG06 | Vishay/Dale | NTHS0603N02N1002JE | Digi-Key | 541-1107-1-ND | THERMISTOR NTC 10K OHM 5% 0603 | 1 | 1 | 1
34 | R4, R8, R48 | 10k | R0603 | Rohm | MCR03ERTF1002 | Digi-Key | RHM10.0KHCT-ND | RES 10.0K OHM 1/10W 1% 0603 SMD | 3 | 0.023 | 0.069
35 | R6, R10, R28, R30, R31, R40, R41, R46, R47, R151, R152 | 100k | R0603 | Rohm | MCR03ERTF1003 | Digi-Key | RHM100KHCT-ND | RES 100K OHM 1/10W 1% 0603 SMD | 11 | 0.023 | 0.253
36 | SW2 | SWITCH-MS12ASG30 | SWITCH-MS12ASG30 | NKK | MS12ASG30 | Digi-Key | 360-2390-ND | SW SLIDE SPDT 0.4VA GOLD R/A PC | 1 | 5.45 | 5.45
37 | SW3 | SWITCH-ESWITCH-TL3340G | SWITCH-ESWITCH-TL3340G | E-Switch | TL3340AF160QG | Digi-Key | EG4627CT-ND | SWITCH TACTILE SPST-NO 0.05A 12V | 1 | 0.291 | 0.291
38 | TP3, TP4, TP5, TP6, TP9, TP10, TP12, TP14 | TESTPOINT | TESTPOINT-BLUE | Keystone | 5122 | Digi-Key | 5122K-ND | TEST POINT PC COMPACT T/H BLUE | 7 | 0.38 | 2.66
39 | TP7, TP8 | TESTPOINT | TESTPOINT-GREEN | Keystone | 5121 | Digi-Key | 5121K-ND | TEST POINT PC COMPACT T/H GREEN | 2 | 0.38 | 0.76
40 | TP13 | TESTPOINT | TESTPOINT-RED | Keystone | 5005 | Digi-Key | 5005K-ND | TEST POINT PC COMPACT .063"D RED | 1 | 0.36 | 0.36
41 | TP1, TP2, TP11 | TESTPOINT | TESTPOINT-YELLOW | Keystone | 5009 | Digi-Key | 5009K-ND | TEST POINT PC COMPACT .063"D YLW | 3 | 0.36 | 1.08
42 | U1 | LTC4361-2DC | LTC4361-2DC | Linear Technology | LTC4361IDC-2#TRMPBF | Digi-Key | LTC4361IDC-2#TRMPBFCT-ND | IC OVERVOLTAGE PROT CONT 8-DFN | 1 | 3.78 | 3.78
43 | U13 | STM32F10XCXT6 | STM32F10XCXT6 | STMicroelectronics | STM32F102CBT6 | Digi-Key | 497-8308-ND | MCU ARM 32BIT 128KB FLASH 48LQFP | 1 | 8.95 | 8.95
44 | U14 | LTC2942-1 | LTC2942-1 | Linear Technology | LTC2942CDCB-1#TRMPBF | Digi-Key | LTC2942CDCB-1#TRMPBFCT-ND | IC FUEL/GAS GAUGE LI-ION 1A 6DFN | 1 | 4.51 | 4.51
45 | U15 | USBLC6-2 | USBLC6-2 | STMicroelectronics | USBLC6-2SC6 | Digi-Key | 497-5235-1-ND | IC ESD PROTECTION LO CAP SOT23-6 | 1 | 1 | 1
46 | U2 | LTC4085 | LTC4085 | Linear Technology | LTC4085EDE#PBF | Digi-Key | LTC4085EDE#PBF-ND | IC USB POWER MANAGER 14-DFN | 1 | 3.3 | 3.3
47 | U3, U4 | XC6220B331MR-G | XC6220B331MR-G | Torex | XC6220B331MR-G | Digi-Key | 893-1133-1-ND | IC REG LDO 3.3V 1A SOT-25 | 2 | 0.88 | 1.76
48 | U5 | XC9236A15DMR-G | XC9236A15DMR-G | Torex | XC9236A15DMR-G | Digi-Key | 893-1120-1-ND | IC BUCK SYNC 1.5V .6A SOT-25 3MHZ | 1 | 1.5 | 1.5
49 | U6 | MIC94043 | MIC94043 | Micrel | MIC94043YFL TR | Digi-Key | 576-3228-1-ND | IC LOAD SW HISIDE 3A 4-MLF | 1 | 1.3 | 1.3
50 | U8, U9, U10, U11, U12 | MAX9938FEUK | MAX9938FEUK | Maxim | MAX9938FEUK+T | Digi-Key | MAX9938FEUK+TCT-ND | IC AMP CURRENT SENSE SOT23-5 | 5 | 1.68 | 8.4
51 | X1 |  | 4-SMD, No Lead (DFN, LCC) | TXC CORPORATION | 8Z-16.000MEEQ-T | Digi-Key | 887-1336-1-ND | CRYSTAL 16.000 MHZ 10PF SMD | 1 |  | 0
52 | X2 | DNP | ECX-31B | ECS | ECS-.327-7-34B-TR | Digi-Key | XC1656CT-ND | CRYSTAL 32.768 KHZ 7PF SMD | 1 | 1.26 | 1.26
53 | Standoff | DNP | MOUNT-HOLE3.3 | Keystone | 7200 | Digi-Key | 7200K-ND | STANDOFF HEX M/F .375"L 4-40 BR | 4 | 0.515 | 2.06
 |  |  |  |  |  |  |  | Total | 127 |  | 84.695
