marmote/marmote/hardware/M6-RF315/M6-RF315_BOM.xlsx

Bill of Materials for 'Marote - M6-RF315 (Rev A)'
Item # | Reference | Value | Package | Manufacturer | Manufacturer Part # | Supplier | Supplier Part # | Details | Qty per Board | Unit Price | Total Qty | Total Cost
1 | C1, C2, C3, C4, C5, C6 | 0.1uF | C0603 | TDK | C1608X7R1C104K | Digi-Key | 445-1317-1-ND | CAP CER .10UF 16V 10% X7R 0603 | 6 | 0.08 | 12 | 0.96
2 | C7, C12 | 12pF | C0603 | TDK | C1608C0G1H120J | Digi-Key | 445-1270-1-ND | CAP CER 12PF 50V 5% NP0 0603 | 2 | 0.1 | 4 | 0.4
3 | C8 | 15pF | C0603 | TDK | C1608C0G1H150J | Digi-Key | 445-1271-1-ND | CAP CER 15PF 50V 5% NP0 0603 | 1 | 0.1 | 2 | 0.2
4 | C9, C11, C13 | 6.8pF | C0603 | TDK | C1608C0G1H6R8C | Digi-Key | 445-5038-1-ND | CAP CER 6.8PF 50V NP0 0603 | 3 | 0.13 | 6 | 0.78
5 | C10, C14 | 220pF | C0603 | TDK | C1608C0G1H221J | Digi-Key | 445-1285-1-ND | CAP CER 220PF 50V 5% NP0 0603 | 2 | 0.18 | 4 | 0.72
6 | L1, L2, L4 | 33nH | L0402 | Murata | LQG15HS33NJ02D | Digi-Key | 490-2629-1-ND | INDUCTOR 33NH 200MA 0402 | 3 | 0.176 | 6 | 1.056
7 | L3 | 18nH | L0402 | Murata | LQG15HS18NJ02D | Digi-Key | 490-2626-1-ND | INDUCTOR 18NH 300MA 0402 | 1 | 0.176 | 2 | 0.352
8 | LED1 | ORANGE | LED0603 | Kingbright | APT1608SECK | Digi-Key | 754-1120-1-ND | LED 1.6X0.8MM 601NM ORN CLR SMD | 1 | 0.16 | 2 | 0.32
9 | LED2 | GREEN | LED0603 | Kingbright | APT1608MGC | Digi-Key | 754-1118-1-ND | LED 1.6X0.8MM 570NM GRN CLR SMD | 1 | 0.56 | 2 | 1.12
10 | X1 | NX3225GA | NX3225GA | NDK | NX3225GA-26MHZ-TI | Digi-Key | 644-1160-1-ND | CRYSTAL 26.000 MHZ 10PF SMD | 1 | 0.94 | 2 | 1.88
11 | TP1 | TESTPOINT | TESTPOINT-ORANGE | Keystone | 5008 | Digi-Key | 5008K-ND | TEST POINT PC COMPACT .063"D ORN | 1 | 0.36 | 2 | 0.72
12 | TP2 | TESTPOINT | TESTPOINT-GREEN | Keystone | 5121 | Digi-Key | 5121K-ND | TEST POINT PC COMPACT T/H GREEN | 1 | 0.38 | 2 | 0.76
13 | R1 | 56k | R0603 | Panasonic-ECG | ERJ-3EKF5602V | Digi-Key | P56.0KHCT-ND | RES 56.0K OHM 1/10W 1% 0603 SMD | 1 | 0.04 | 2 | 0.08
14 | R2 | 100k | R0603 | Rohm | MCR03EZPFX1003 | Digi-Key | RHM100KHCT-ND | RES 100K OHM 1/10W 1% 0603 SMD | 1 | 0.023 | 2 | 0.046
15 | R3 | 500 | R0603 | Rohm | ESR03EZPJ511 | Digi-Key | RHM510DCT-ND | RES 510 OHM 1/5W 5% 0603 SMD | 1 | 0.083 | 2 | 0.166
16 | R4 | 130 | R0603 | Rohm | ESR03EZPJ131 | Digi-Key | RHM130DCT-ND | RES 130 OHM 1/5W 5% 0603 SMD | 1 | 0.083 | 2 | 0.166
17 | U1 | CC1101RTKR | QFN-20 | Texas Instruments | CC1101RTKR | Digi-Key | 296-21981-1-ND | IC RF TXRX LP SUB-IGHZ 20-QFN | 1 | 4.95 | 2 | 9.9
18 | J1 | CON-71439-2164 | CON-71439-2164 | Molex | 71439-2164 | Digi-Key | WM17222-ND | CONN RECPT 64POS VERT 1MM SMD | 1 | 5.74 | 2 | 11.48
19 | J2 | CON-SMA-VERT | SMA | TE Connectivity | 5-1814832-1 | Digi-Key | A97594-ND | CONN SOCKET SMA STR DIE CAST PCB | 1 | 2.85 | 2 | 5.7
20 | A1 | ANT | SMA | Antenna Factor | ANT-315-CW-RH-SMA | Digi-Key | ANT-315-CW-RH-SMA-ND | ANTENNA 315MHZ 1/4WAVE SMA | 1 | 6.52 | 2 | 13.04
 | Number of boards: | 2 |  |  |  |  |  | Total | 31 |  | 62 | 49.846
