marmote/marmote/hardware/BeaverBoard_RevA/BeaverBoard_RevA_BOM.xls

Bill of Materials for BeaverBoard rev A
Mounted on the PCB
Item # | Reference | Value | Package | Manufacturer | Manufacturer Part No | Supplier | Supplier Part No | Unit Price | Details | Quantity | Total Cost
1 | JP1 |  | JP6 | Samtec | TSW-106-07-S-S | Digikey | SAM1033-06-ND |  | CONN HEADER 6POS .100" SGL GOLD | 1 | 0.000
2 | C102, C112, C122 | 0.01uF | C0603 | Murata | GRM188R71H103KA01D | Digikey | 490-1512-6-ND |  | CAP CER 10000PF 50V 10% X7R 0603 | 3 | 0.000
3 | C34, C35, C42, C43, C101, C103, C104, C111, C113, C114, C117, C121, C123 | 0.1uF | C0603 | Murata | GRM188R71C104KA01D | Digikey | 490-1532-6-ND |  | CAP CER .1UF 16V 10% X7R 0603 | 13 | 0.000
4 | R10, R20 | 1k | R0603 | Rohm | MCR03EZPFX1001 | Digikey | RHM1.00KHDKR-ND |  | RES 1.00K OHM 1/10W 1% 0603 SMD | 2 | 0.000
5 | R123, R124 | 2.2k | R0603 | Rohm | MCR03EZPJ222 | Digikey | RHM2.2KGDKR-ND |  | RES 2.2K OHM 1/10W 5% 0603 SMD | 2 | 0.000
6 | R200 | 10k | R0603 | Rohm | MCR03EZPJ103 | Digikey | RHM10KGDKR-ND |  | RES 10K OHM 1/10W 5% 0603 SMD | 1 | 0.000
7 | C31, C32, C33, C41 | 10uF | EIA3216 | Kemet | T520A106M010ATE080 | Digikey | 399-4788-6-ND |  | CAP TANT 10UF 10V 20% SMD | 4 | 0.000
8 | C106, C116, C119 | 22uF | EIA3216 | Kemet | T520A226M006ATE090 | Digikey | 399-4718-6-ND |  | CAP TANT 22UF 6.3V 20% SMD | 3 | 0.000
9 | R13, R16, R23, R26 | 33 | R0603 | Rohm | MCR03EZPFX33R0 | Digikey | RHM33.0HDKR-ND |  | RES 33.0 OHM 1/10W 1% 0603 SMD | 4 | 0.000
10 | RL2P5 | 40.2 | R0603 | Rohm | MCR03EZPFX40R2 | Digikey | RHM40.2HDKR-ND |  | RES 40.2 OHM 1/10W 1% 0603 SMD | 1 | 0.000
11 | R53, R56, R63, R66 | 45.3k | R0603 | Rohm | MCR03EZPFX4532 | Digikey | RHM45.3KHDKR-ND |  | RES 45.3K OHM 1/10W 1% 0603 SMD | 4 | 0.000
12 | R51, R54, R61, R64, R101, R102, R103, R104, R105, R106, R107, R108, R109, R110, R111, R112, R114, R115, R116, R117, R118, R119, R120, R121 | 100 | R0603 | Rohm | MCR03EZPJ101 | Digikey | RHM100GDKR-ND |  | RES 100 OHM 1/10W 5% 0603 SMD | 24 | 0.000
13 | C200 | 100uF | EIA7343 | Kemet | T495D107M016ATE100 | Digikey | 399-5262-6-ND |  | CAP TANT 100UF 16V 20% SMD | 1 | 0.000
14 | R81, R82, R91, R92 | 113 | R0603 | Rohm | MCR03EZPFX1130 | Digikey | RHM113HDKR-ND |  | RES 113 OHM 1/10W 1% 0603 SMD | 4 | 0.000
15 | RL3P3 | 120 | R0603 | Rohm | MCR03EZPFX1200 | Digikey | RHM120HDKR-ND |  | RES 120 OHM 1/10W 1% 0603 SMD | 1 | 0.000
16 | C11, C12, C21, C22 | 200pF | C0603 | AVX | 06035A201FAT2A | Digikey | 478-6030-6-ND |  | CAP CER 200PF 50V NP0 0603 | 4 | 0.000
17 | C105, C115, C118 | 220pF | C0603 | Murata | GRM1885C1H221JA01D | Digikey | 490-1435-6-ND |  | CAP CER 220PF 50V 5% C0G 0603 | 3 | 0.000
18 | RL5 | 287 | R0603 | Rohm | MCR03EZPFX2870 | Digikey | RHM287HDKR-ND |  | RES 287 OHM 1/10W 1% 0603 SMD | 1 | 0.000
19 | RL6 | 402 | R0603 | Rohm | MCR03EZPFX4020 | Digikey | RHM402HDKR-ND |  | RES 402 OHM 1/10W 1% 0603 SMD | 1 | 0.000
20 | R11, R12, R14, R15, R21, R22, R24, R25 | 499 | R0603 | Rohm | MCR03EZPFX4990 | Digikey | RHM499HDKR-ND |  | RES 499 OHM 1/10W 1% 0603 SMD | 8 | 0.000
21 | R52, R55, R62, R65 | 536 | R0603 | Rohm | MCR03EZPFX5360 | Digikey | RHM536HDKR-ND |  | RES 536 OHM 1/10W 1% 0603 SMD | 4 | 0.000
22 | X1 |  | 853-XX-100-20-001000 | Mill-Max | 853-93-100-20-001000 | Digikey | ED89100-ND |  | CONN SOCKET RT ANG 2X50 .050 | 1 | 0.000
23 | R60 | 866 | R0603 | Rohm | MCR03EZPFX8660 | Digikey | RHM866HDKR-ND |  | RES 866 OHM 1/10W 1% 0603 SMD | 1 | 0.000
24 | R50 | 1130 | R0603 | Rohm | MCR03EZPFX1131 | Digikey | RHM1.13KHDKR-ND |  | RES 1.13K OHM 1/10W 1% 0603 SMD | 1 | 0.000
25 | X2, X3 |  | 71436-XX64 | Molex | 71436-2164 | Digikey | WM17200-ND |  | CONN PLUG 64POS VERT 1MM SMD | 2 | 0.000
26 | U4 | AD5449 | 16TSSOP | Analog Devices | AD5449YRUZ | Digikey | AD5449YRUZ-ND |  | IC DAC DUAL 12BIT MULT 16-TSSOP | 1 | 0.000
27 | U3 | AD7357 | 16TSSOP | Analog Devices | AD7357YRUZ | Digikey | AD7357YRUZ-ND |  | IC ADC DUAL14BIT 4.2MSPS 16TSSOP | 1 | 0.000
28 | U1, U2, U5, U6 | AD8137 | 8SOIC | Analog Devices | AD8137YRZ | Digikey | AD8137YRZ-ND |  | IC AMP DIFF R-R LP 20MA 8SOIC | 4 | 0.000
29 | U7 | AD8630 | 14SOIC | Analog Devices | AD8630ARZ | Digikey | AD8630ARZ-ND |  | IC OPAMP CHOPPER R-R QUAD 14SOIC | 1 | 0.000
30 | U8, U9 | IRF8910PBF | 8SOIC | International Rectifier | IRF8910TRPBF | Digikey | IRF8910PBFDKR-ND |  | HEX/MOS N-CH DUAL 20V 10A 8SOIC | 2 | 0.000
31 | LED6 | LTST-C190EKT | 0603 | Lite-On | LTST-C190EKT | Digikey | 160-1182-6-ND |  | LED RED ORANGE CLEAR 0603 SMD | 1 | 0.000
32 | LED2P5, LED3P3, LED5 | LTST-C190GKT | 0603 | Lite-On | LTST-C190GKT | Digikey | 160-1183-6-ND |  | LED GREEN CLEAR 0603 SMD | 3 | 0.000
33 | B1, B2, B3, B101, B111, B112 | MI1206K601R-10 | BEAD1206 | Laird-Signal Integrity Products | MI1206K601R-10 | Digikey | 240-2405-6-ND |  | FERRITE CHIP POWER 600 OHM SMD | 6 | 0.000
34 | X4 | PJ-057AH | PJ-057AH | CUI Inc | PJ-057AH | Digikey | CP-057AH-ND |  | CON PWR JCK 2.0 X 6.3MM HIGH CUR | 1 | 0.000
35 | U10 | REG103UA-5-ND | 8SOIC | Texas Instruments | REG103UA-5 | Digikey | REG103UA-5-ND |  | IC 5.0V DMOS LDO REG 8-SOIC | 1 | 0.000
36 | U11 | REG103UA-3.3-ND | 8SOIC | Texas Instruments | REG103UA-3.3 | Digikey | REG103UA-3.3-ND |  | IC 3.3V DMOS LDO REG 8-SOIC | 1 | 0.000
37 | U12 | REG103UA-2.5-ND | 8SOIC | Texas Instruments | REG103UA-2.5 | Digikey | REG103UA-2.5-ND |  | IC 2.5V LDO REG DMOS 8-SOIC | 1 | 0.000
38 | C51, C52, C61, C62 | DNA |  |  |  |  |  |  |  | 4 | 0.000
39 | R113 | DNA |  |  |  |  |  |  |  | 1 | 0.000
40 | B4 | DNA |  |  |  |  |  |  |  | 1 | 0.000
 | Sum |  |  |  |  |  |  |  |  |  | 0.000
