marmote/marmote/hardware/MainBoard_RevB/Document/A2F500 FT256 Pinout.xlsx

Sheet: Pins A1-D16 (1-64)
Pin | A2F500 function (256-pin FPGA) | Type | Main function | Alternate function | Net name | Connected to | Description | Comment
A1 | GND | S |  |  |  |  | Digital ground to the FPGA fabric, microcontroller subsystem and GPIOs
A2 | VCCFPGAIOB0 | S |  |  | D3V3 | - | Digital supply to the FPGA fabric I/O bank 0 (north FPGA I/O bank) for the output buffers and I/O logic
A3 | EMC_AB[0]/IO06NDB0V0
A4 | EMC_AB[1]/IO06PDB0V0
A5 | GND | S |  |  |  |  | Digital ground to the FPGA fabric, microcontroller subsystem and GPIOs
A6 | EMC_AB[3]/IO09PDB0V0
A7 | EMC_AB[5]/IO10PDB0V0
A8 | VCCFPGAIOB0 | S |  |  |  |  | Digital supply to the FPGA fabric I/O bank 0 (north FPGA I/O bank) for the output buffers and I/O logic
A9 | GND | S |  |  |  |  | Digital ground to the FPGA fabric, microcontroller subsystem and GPIOs
A10 | EMC_AB[14]/IO15NDB0V0
A11 | EMC_AB[15]/IO15PDB0V0
A12 | GND | S |  |  |  |  | Digital ground to the FPGA fabric, microcontroller subsystem and GPIOs
A13 | EMC_AB[20]/IO21NDB0V0
A14 | EMC_AB[24]/IO20NDB0V0
A15 | VCCFPGAIOB0 | S |  |  |  |  | Digital supply to the FPGA fabric I/O bank 0 (north FPGA I/O bank) for the output buffers and I/O logic
A16 | GND | S |  |  |  |  | Digital ground to the FPGA fabric, microcontroller subsystem and GPIOs
B1 | EMC_DB[15]/GAA2/IO88PDB5V0
B2 | GND | S |  |  |  |  | Digital ground to the FPGA fabric, microcontroller subsystem and GPIOs
B3 | EMC_BYTEN[1]/GAC1/IO07PDB0V0
B4 | EMC_OEN0_N/IO08NDB0V0
B5 | EMC_OEN1_N/IO08PDB0V0
B6 | EMC_AB[2]/IO09NDB0V0
B7 | EMC_AB[4]/IO10NDB0V0
B8 | EMC_AB[9]/IO13PDB0V0
B9 | EMC_AB[12]/IO14NDB0V0
B10 | EMC_AB[13]/IO14PDB0V0
B11 | EMC_AB[16]/IO17NDB0V0
B12 | EMC_AB[18]/IO18NDB0V0
B13 | EMC_AB[21]/IO21PDB0V0
B14 | EMC_AB[25]/IO20PDB0V0
B15 | GND | S |  |  |  |  | Digital ground to the FPGA fabric, microcontroller subsystem and GPIOs
B16 | GNDQ | S |  |  |  |  | Quiet digital ground supply voltage to input buffers of I/O banks (see datasheet for details)
C1 | EMC_DB[14]/GAB2/IO88NDB5V0
C2 | VCCPLL0 | S |  |  |  |  | Analog 1.5 V supply to the PLL
C3 | EMC_BYTEN[0]/GAC0/IO07NDB0V0
C4 | VCCFPGAIOB0 | S |  |  |  |  | Digital supply to the FPGA fabric I/O bank 0 (north FPGA I/O bank) for the output buffers and I/O logic
C5 | EMC_CS0_N/GAB0/IO05NDB0V0
C6 | EMC_CS1_N/GAB1/IO05PDB0V0
C7 | GND | S |  |  |  |  | Digital ground to the FPGA fabric, microcontroller subsystem and GPIOs
C8 | EMC_AB[8]/IO13NDB0V0
C9 | EMC_AB[11]/IO11PDB0V0
C10 | VCCFPGAIOB0 | S |  |  |  |  | Digital supply to the FPGA fabric I/O bank 0 (north FPGA I/O bank) for the output buffers and I/O logic
C11 | EMC_AB[17]/IO17PDB0V0
C12 | EMC_AB[19]/IO18PDB0V0
C13 | GND | S |  |  |  |  | Digital ground to the FPGA fabric, microcontroller subsystem and GPIOs
C14 | GBA2/IO27PPB1V0
C15 | GCA2/IO28PDB1V0 | C | Single ended clock for USB from the FTDI chip |  | USB_CLK | FTDI FT232H USB | GC CCC (Middle CCC) CLKA single-ended hardwired I/O | Can be moved to any GCxx dedicated clock input pin
C16 | IO28NDB1V0 | C | Single ended clock to the analog front-ends |  | AFE_CLK | MAX19706 | FPGA user I/O | Can be moved to any FPGA I/O output pin
D1 | VCCFPGAIOB5 | S |  |  |  |  | Digital supply to the FPGA fabric I/O bank 5 (west FPGA I/O bank) for the output buffers and I/O logic
D2 | VCOMPLA0 | S |  |  |  |  | Analog ground for the PLL
D3 | GND | S |  |  |  |  | Digital ground to the FPGA fabric, microcontroller subsystem and GPIOs
D4 | GNDQ | S |  |  |  |  | Quiet digital ground supply voltage to input buffers of I/O banks (see datasheet for details)
D5 | EMC_CLK/GAA0/IO02NDB0V0
D6 | EMC_RW_N/GAA1/IO02PDB0V0
D7 | EMC_AB[6]/IO12NDB0V0
D8 | EMC_AB[7]/IO12PDB0V0
D9 | EMC_AB[10]/IO11NDB0V0
D10 | EMC_AB[22]/IO19NDB0V0
D11 | EMC_AB[23]/IO19PDB0V0
D12 | GNDQ | S |  |  |  |  | Quiet digital ground supply voltage to input buffers of I/O banks (see datasheet for details)
D13 | GBB2/IO27NPB1V0
D14 | GCB2/IO33PDB1V0
D15 | IO33NDB1V0
D16 | VCCFPGAIOB1 | S |  |  |  |  | Digital supply to the FPGA fabric I/O bank 1 (east FPGA I/O bank) for the output buffers and I/O logic

Sheet: Pins E1-H16 (65-128)
Pin | A2F500 function (256-pin FPGA) | Type | Main function | Alternate function | Net name | Connected to | Description | Comment
E1 | EMC_DB[13]/GAC2/IO87PDB5V0 | I/O |  |  |  |  | FPGA user I/O
E2 | EMC_DB[12]/IO87NDB5V0 | I/O |  |  |  |  | FPGA user I/O
E3 | GFA2/IO85PDB5V0 | C |  |  | MAIN_CLK_IN | FOX924 20 MHz TCXO | GF CCC (MSS_CCC) CLKA hardwired I/O
E4 | EMC_DB[10]/IO86NPB5V0 | I/O |  |  |  |  | FPGA user I/O
E5 | GNDQ | S |  |  |  |  | Quiet digital ground supply voltage to input buffers of I/O banks (see datasheet for details)
E6 | GND | S |  |  |  |  | Digital ground to the FPGA fabric, microcontroller subsystem and GPIOs
E7 | VCCFPGAIOB0 | S |  |  |  |  | Digital supply to the FPGA fabric I/O bank 0 (north FPGA I/O bank) for the output buffers and I/O logic
E8 | GND | S |  |  |  |  | Digital ground to the FPGA fabric, microcontroller subsystem and GPIOs
E9 | VCCFPGAIOB0 | S |  |  |  |  | Digital supply to the FPGA fabric I/O bank 0 (north FPGA I/O bank) for the output buffers and I/O logic
E10 | GND | S |  |  |  |  | Digital ground to the FPGA fabric, microcontroller subsystem and GPIOs
E11 | VCCFPGAIOB0 | S |  |  |  |  | Digital supply to the FPGA fabric I/O bank 0 (north FPGA I/O bank) for the output buffers and I/O logic
E12 | GCA1/IO36PDB1V0 | I/O |  |  |  |  | FPGA user I/O
E13 | VCCFPGAIOB1 | S |  |  |  |  | Digital supply to the FPGA fabric I/O bank 1 (east FPGA I/O bank) for the output buffers and I/O logic
E14 | GCB1/IO34PDB1V0 | I/O |  |  |  |  | FPGA user I/O
E15 | GDC1/IO38PDB1V0 | I/O |  |  |  |  | FPGA user I/O
E16 | GDC0/IO38NDB1V0 | I/O |  |  |  |  | FPGA user I/O
F1 | EMC_DB[9]/GEC1/IO80PDB5V0 | I/O |  |  |  |  | FPGA user I/O
F2 | GND | S |  |  |  |  | Digital ground to the FPGA fabric, microcontroller subsystem and GPIOs
F3 | GFB2/IO85NDB5V0 | C |  |  | EXT_CLK_IN | SMA connector | GF CCC (MSS_CCC) CLKB hardwired I/O
F4 | VCCFPGAIOB5 | S |  |  |  |  | Digital supply to the FPGA fabric I/O bank 5 (west FPGA I/O bank) for the output buffers and I/O logic
F5 | EMC_DB[11]/IO86PPB5V0 | I/O |  |  |  |  | FPGA user I/O
F6 | VCCFPGAIOB5 | S |  |  |  |  | Digital supply to the FPGA fabric I/O bank 5 (west FPGA I/O bank) for the output buffers and I/O logic
F7 | GND | S |  |  |  |  | Digital ground to the FPGA fabric, microcontroller subsystem and GPIOs
F8 | VCC | S |  |  |  |  | Digital supply to the FPGA fabric and MSS, nominally 1.5 V
F9 | GND | S |  |  |  |  | Digital ground to the FPGA fabric, microcontroller subsystem and GPIOs
F10 | VCC | S |  |  |  |  | Digital supply to the FPGA fabric and MSS, nominally 1.5 V
F11 | GND | S |  |  |  |  | Digital ground to the FPGA fabric, microcontroller subsystem and GPIOs
F12 | GCA0/IO36NDB1V0 | I/O |  |  |  |  | FPGA user I/O
F13 | GNDQ | S |  |  |  |  | Quiet digital ground supply voltage to input buffers of I/O banks (see datasheet for details)
F14 | GCB0/IO34NDB1V0 | I/O |  |  |  |  | FPGA user I/O
F15 | GND | S |  |  |  |  | Digital ground to the FPGA fabric, microcontroller subsystem and GPIOs
F16 | VCCENVM | S |  |  |  |  | Digital 1.5 V power supply to the embedded nonvolatile memory blocks
G1 | EMC_DB[8]/GEC0/IO80NDB5V0 | I/O |  |  |  |  | FPGA user I/O
G2 | EMC_DB[7]/GEB1/IO79PDB5V0 | I/O |  |  |  |  | FPGA user I/O
G3 | EMC_DB[6]/GEB0/IO79NDB5V0 | I/O |  |  |  |  | FPGA user I/O
G4 | GFC2/IO84PDB5V0 | I/O | 20 MHz reference clock out |  | REF_CLK_OUT | Mezzanine connector | FPGA user I/O
G5 | IO84NDB5V0 | I/O | 20 MHz reference clock out |  | EXT_CLK_OUT | SMA connector | FPGA user I/O | Can be relocated to any other I/O and merged with EXT_CLK_OUT
G6 | GND | S |  |  |  |  | Digital ground to the FPGA fabric, microcontroller subsystem and GPIOs | Can be relocated to any other I/O and merged with REF_CLK_OUT
G7 | VCC | S |  |  |  |  | Digital supply to the FPGA fabric and MSS, nominally 1.5 V
G8 | GND | S |  |  |  |  | Digital ground to the FPGA fabric, microcontroller subsystem and GPIOs
G9 | VCC | S |  |  |  |  | Digital supply to the FPGA fabric and MSS, nominally 1.5 V
G10 | GND | S |  |  |  |  | Digital ground to the FPGA fabric, microcontroller subsystem and GPIOs
G11 | VCCFPGAIOB1 | S |  |  |  |  | Digital supply to the FPGA fabric I/O bank 1 (east FPGA I/O bank) for the output buffers and I/O logic
G12 | VPP | S |  |  |  |  | Digital programming circuitry supply*
G13 | TRSTB
G14 | TMS
G15 | TCK
G16 | GNDENVM | S |  |  |  |  | Digital ground to the embedded nonvolatile memory (eNVM)
H1 | GND | S |  |  |  |  | Digital ground to the FPGA fabric, microcontroller subsystem and GPIOs
H2 | EMC_DB[5]/GEA1/IO78PPB5V0 | I/O |  |  |  |  | FPGA user I/O
H3 | VCCFPGAIOB5 | S |  |  |  |  | Digital supply to the FPGA fabric I/O bank 5 (west FPGA I/O bank) for the output buffers and I/O logic
H4 | EMC_DB[1]/GEB2/IO76PDB5V0 | I/O |  |  |  |  | FPGA user I/O
H5 | EMC_DB[0]/GEA2/IO76NDB5V0 | I/O |  |  |  |  | FPGA user I/O
H6 | VCCFPGAIOB5 | S |  |  |  |  | Digital supply to the FPGA fabric I/O bank 5 (west FPGA I/O bank) for the output buffers and I/O logic
H7 | GND | S |  |  |  |  | Digital ground to the FPGA fabric, microcontroller subsystem and GPIOs
H8 | VCC | S |  |  |  |  | Digital supply to the FPGA fabric and MSS, nominally 1.5 V
H9 | GND | S |  |  |  |  | Digital ground to the FPGA fabric, microcontroller subsystem and GPIOs
H10 | VCC | S |  |  |  |  | Digital supply to the FPGA fabric and MSS, nominally 1.5 V
H11 | GND | S |  |  |  |  | Digital ground to the FPGA fabric, microcontroller subsystem and GPIOs
H12 | VJTAG | S |  |  |  |  | Digital supply to the JTAG controller
H13 | TDO
H14 | TDI
H15 | JTAGSEL
H16 | GND | S |  |  |  |  | Digital ground to the FPGA fabric, microcontroller subsystem and GPIOs

Sheet: Pins J1-M16 (129-92)
Pin | A2F500 function (256-pin FPGA) | Type | Main function | Alternate function | Net name | Connected to | Description | Comment
J1 | EMC_DB[4]/GEA0/IO78NPB5V0
J2 | EMC_DB[3]/GEC2/IO77PDB5V0
J3 | EMC_DB[2]/IO77NDB5V0
J4 | GNDRCOSC | S |  |  |  |  | Analog ground to the integrated RC oscillator circuit
J5 | GNDQ | S |  |  |  |  | Quiet digital ground supply voltage to input buffers of I/O banks (see datasheet for details)
J6 | GND | S |  |  |  |  | Digital ground to the FPGA fabric, microcontroller subsystem and GPIOs
J7 | VCC | S |  |  |  |  | Digital supply to the FPGA fabric and MSS, nominally 1.5 V
J8 | GND | S |  |  |  |  | Digital ground to the FPGA fabric, microcontroller subsystem and GPIOs
J9 | VCC | S |  |  |  |  | Digital supply to the FPGA fabric and MSS, nominally 1.5 V
J10 | GND | S |  |  |  |  | Digital ground to the FPGA fabric, microcontroller subsystem and GPIOs
J11 | VCCMSSIOB2 | S |  |  |  |  | Digital supply to the FPGA fabric I/O bank 2 (east MSS I/O bank) for the output buffers and I/O logic
J12 | I2C_0_SCL/GPIO_23
J13 | I2C_0_SDA/GPIO_22
J14 | I2C_1_SCL/GPIO_31
J15 | VCCMSSIOB2 | S |  |  |  |  | Digital supply to the FPGA fabric I/O bank 2 (east MSS I/O bank) for the output buffers and I/O logic
J16 | I2C_1_SDA/GPIO_30
K1 | MAC_MDIO/IO58RSB4V0
K2 | MAC_MDC/IO57RSB4V0
K3 | VCCMSSIOB4 | S |  |  |  |  | Digital supply to the FPGA fabric I/O bank 4 (west MSS I/O bank) for the output buffers and I/O logic
K4 | MSS_RESET_N
K5 | VCCRCOSC | S |  |  |  |  | Analog supply to the integrated RC oscillator circuit
K6 | VCCMSSIOB4 | S |  |  |  |  | Digital supply to the FPGA fabric I/O bank 4 (west MSS I/O bank) for the output buffers and I/O logic
K7 | GND | S |  |  |  |  | Digital ground to the FPGA fabric, microcontroller subsystem and GPIOs
K8 | VCC | S |  |  |  |  | Digital supply to the FPGA fabric and MSS, nominally 1.5 V
K9 | GND | S |  |  |  |  | Digital ground to the FPGA fabric, microcontroller subsystem and GPIOs
K10 | VCC | S |  |  |  |  | Digital supply to the FPGA fabric and MSS, nominally 1.5 V
K11 | GND | S |  |  |  |  | Digital ground to the FPGA fabric, microcontroller subsystem and GPIOs
K12 | UART_0_RXD/GPIO_21
K13 | GND | S |  |  |  |  | Digital ground to the FPGA fabric, microcontroller subsystem and GPIOs
K14 | UART_1_TXD/GPIO_28
K15 | UART_1_RXD/GPIO_29
K16 | UART_0_TXD/GPIO_20
L1 | GND | S |  |  |  |  | Digital ground to the FPGA fabric, microcontroller subsystem and GPIOs
L2 | MAC_TXEN/IO61RSB4V0
L3 | MAC_CRSDV/IO60RSB4V0
L4 | MAC_RXER/IO59RSB4V0
L5 | MAC_CLK
L6 | GND | S |  |  |  |  | Digital ground to the FPGA fabric, microcontroller subsystem and GPIOs
L7 | VCC | S |  |  |  |  | Digital supply to the FPGA fabric and MSS, nominally 1.5 V
L8 | GND | S |  |  |  |  | Digital ground to the FPGA fabric, microcontroller subsystem and GPIOs
L9 | VCC | S |  |  |  |  | Digital supply to the FPGA fabric and MSS, nominally 1.5 V
L10 | GND | S |  |  |  |  | Digital ground to the FPGA fabric, microcontroller subsystem and GPIOs
L11 | VCCMSSIOB2 | S |  |  |  |  | Digital supply to the FPGA fabric I/O bank 2 (east MSS I/O bank) for the output buffers and I/O logic
L12 | SPI_1_DO/GPIO_24
L13 | SPI_1_SS/GPIO_27
L14 | SPI_1_CLK/GPIO_26
L15 | SPI_1_DI/GPIO_25
L16 | GND | S |  |  |  |  | Digital ground to the FPGA fabric, microcontroller subsystem and GPIOs
M1 | MAC_TXD[0]/IO65RSB4V0
M2 | MAC_TXD[1]/IO64RSB4V0
M3 | MAC_RXD[0]/IO63RSB4V0
M4 | GND | S |  |  |  |  | Digital ground to the FPGA fabric, microcontroller subsystem and GPIOs
M5 | ADC3
M6 | GND15ADC0 | S |  |  |  |  | Quiet analog ground to the 1.5 V circuitry of the first analog-to-digital converter (ADC)
M7 | GND33ADC1 | S |  |  |  |  | Quiet analog ground to the 3.3 V circuitry of the second ADC
M8 | GND33ADC1 | S |  |  |  |  | Quiet analog ground to the 3.3 V circuitry of the second ADC
M9 | ADC4
M10 | GNDTM1 | S |  |  |  |  | Analog temperature monitor common ground for signal conditioning block SCB 2 and SCB 3 (see datasheet for details)
M11 | TM2
M12 | CM2
M13 | SPI_0_SS/GPIO_19
M14 | VCCMSSIOB2 | S |  |  |  |  | Digital supply to the FPGA fabric I/O bank 2 (east MSS I/O bank) for the output buffers and I/O logic
M15 | SPI_0_CLK/GPIO_18
M16 | SPI_0_DI/GPIO_17

Sheet: Pins N1-T16 (193-256)
Pin | A2F500 function (256-pin FPGA) | Type | Main function | Alternate function | Net name | Connected to | Description | Comment
N1 | MAC_RXD[1]/IO62RSB4V0
N2 | VCCMSSIOB4 | S |  |  |  |  | Digital supply to the FPGA fabric I/O bank 4 (west MSS I/O bank) for the output buffers and I/O logic
N3 | VCC15A | S |  |  |  |  | Clean analog 1.5 V supply to the analog circuitry
N4 | VCC33AP | S |  |  |  |  | Analog clean 3.3 V supply to the charge pump
N5 | ABPS3
N6 | TM1
N7 | GND33ADC0 | S |  |  |  |  | Quiet analog ground to the 3.3 V circuitry of the first ADC
N8 | VCC33ADC1 | S |  |  |  |  | Analog 3.3 V supply to the second ADC
N9 | ADC5
N10 | CM3
N11 | GNDAQ | S |  |  |  |  | Quiet analog ground to the analog I/O of SmartFusion devices
N12 | VAREFOUT |  |  |  |  |  | Internal 2.56 V voltage reference output
N13 | GNDSDD1 | S |  |  |  |  | Common analog ground to the second and third sigma-delta DACs
N14 | VCC33SDD1 | S |  |  |  |  | Common analog 3.3 V supply to the second and third sigma-delta DACs
N15 | GND | S |  |  |  |  | Digital ground to the FPGA fabric, microcontroller subsystem and GPIOs
N16 | SPI_0_DO/GPIO_16
P1 | GNDSDD0 | S |  |  |  |  | Analog ground to the first sigma-delta DAC
P2 | VCC33SDD0 | S |  |  |  |  | Analog 3.3 V supply to the first sigma-delta DAC
P3 | VCC33N | S |  |  |  |  | –3.3 V output from the voltage converter (a 2.2 μF capacitor must be connected from this pin to GND)
P4 | GNDA | S |  |  |  |  | Quiet analog ground to the analog front-end
P5 | GNDAQ | S |  |  |  |  | Quiet analog ground to the analog I/O of SmartFusion devices
P6 | CM1
P7 | ADC2
P8 | VCC15ADC0 | S |  |  |  |  | Analog 1.5 V supply to the first ADC
P9 | ADC6
P10 | TM3
P11 | GNDA | S |  |  |  |  | Quiet analog ground to the analog front-end
P12 | VCCMAINXTAL | S |  |  |  |  | Analog supply to the main crystal oscillator circuit
P13 | GNDLPXTAL | S |  |  |  |  | Analog ground to the low power 32 KHz crystal oscillator circuitry
P14 | VDDBAT | S |  |  |  |  | External battery connection to the low power 32 KHz crystal oscillator (along with VCCLPXTAL), RTC, and battery switchover circuit
P15 | PTEM
P16 | PTBASE
R1 | PCAP
R2 | SDD0
R3 | ABPS0
R4 | TM0
R5 | ABPS2
R6 | ADC1
R7 | VCC33ADC0 | S |  |  |  |  | Analog 3.3 V supply to the first ADC
R8 | VCC15ADC1 | S |  |  |  |  | Analog 1.5 V supply to the second ADC
R9 | ADC7
R10 | ABPS7
R11 | ABPS4
R12 | MAINXIN |  |  |  |  |  | Main oscillator IN
R13 | MAINXOUT |  |  |  |  |  | Main oscillator OUT
R14 | LPXIN |  |  |  |  |  | Low-power oscillator IN
R15 | LPXOUT |  |  |  |  |  | Low-power oscillator OUT
R16 | VCC33A |  |  |  |  |  | Clean 3.3 V analog supply to the analog circuitry (see documentation for more details)
T1 | NCAP
T2 | ABPS1
T3 | CM0
T4 | GNDTM0 | S |  |  |  |  | Analog temperature monitor common ground for signal conditioning blocks SCB 0 and SB 1 (see datasheet for details)
T5 | ADC0
T6 | VAREF0 |  |  |  |  |  | Analog reference voltage for first ADC*
T7 | GND33ADC0 | S |  |  |  |  | Quiet analog ground to the 3.3 V circuitry of the first ADC
T8 | GND15ADC1 | S |  |  |  |  | Quiet analog ground to the 1.5 V circuitry of the second ADC
T9 | VAREF1 |  |  |  |  |  | Analog reference voltage for second ADC*
T10 | ABPS6
T11 | ABPS5
T12 | SDD1
T13 | GNDVAREF | S |  |  |  |  | Analog ground reference used by the ADC (this pad should be connected to a quiet analog ground)
T14 | GNDMAINXTAL | S |  |  |  |  | Analog ground to the main crystal oscillator circuitry
T15 | VCCLPXTAL | S |  |  |  |  | Analog supply to the low power 32 KHz crystal oscillator
T16 | PU_N

Sheet: Calculations
Unassigned pins
Category | # of pins | Initial pin assignment | Candidate pins | Description | Comment
Clock | 1 | G4 | Any with OBUF | REF_CLK_OUT | Can be relocated to any output pin and merged with EXT_CLK_OUT
 | 1 | G5 | Any with OBUF | EXT_CLK_OUT | Can be relocated to any output pin and merged with REF_CLK_OUT
 | 0 | C15 (GCA2) | GCxx | USB_CLK | Can be moved to any GCxx pin

Sheet: Legend
Pin color
Pins checked against datasheet | A1
Tested in Libero Design | A1
Connected on the schematic | A1
Initial assignment (may be relocated) | A1
Routed on the board | A1
