marmote/marmote/hardware/MainBoard_RevB/Datasheet/Ethernet/LQFP-48-component.PNG

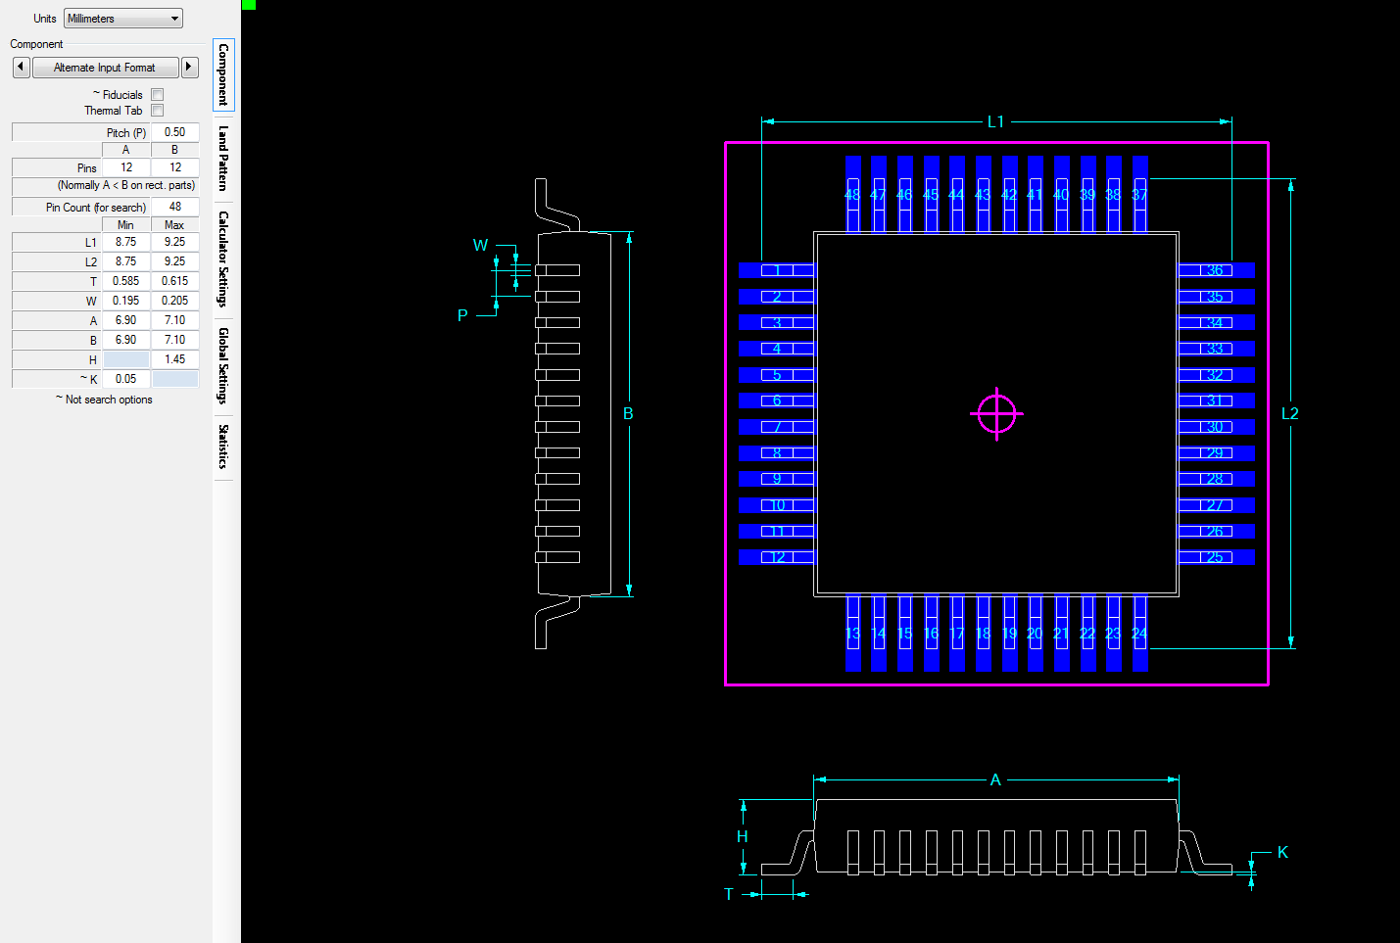
hardware/MainBoard_RevB/Datasheet/Ethernet/LQFP-48-component.PNG
