marmote/marmote/(list of files, cad)

Other CAD files:
firmware/A2F-EVAL-KIT/CORDIC/component/Actel/SmartFusionMSS/MSS/2.5.106/mti/user_verilog/MSS_BFM_LIB/@addr@dec@m0/verilog.psm
firmware/A2F-EVAL-KIT/CORDIC/component/Actel/SmartFusionMSS/MSS/2.5.106/mti/user_verilog/MSS_BFM_LIB/@addr@dec@m1/verilog.psm
firmware/A2F-EVAL-KIT/CORDIC/component/Actel/SmartFusionMSS/MSS/2.5.106/mti/user_verilog/MSS_BFM_LIB/@addr@dec@m2/verilog.psm
firmware/A2F-EVAL-KIT/CORDIC/component/Actel/SmartFusionMSS/MSS/2.5.106/mti/user_verilog/MSS_BFM_LIB/@addr@dec@m3/verilog.psm
firmware/A2F-EVAL-KIT/CORDIC/component/Actel/SmartFusionMSS/MSS/2.5.106/mti/user_verilog/MSS_BFM_LIB/@addr@dec@m4/verilog.psm
firmware/A2F-EVAL-KIT/CORDIC/component/Actel/SmartFusionMSS/MSS/2.5.106/mti/user_verilog/MSS_BFM_LIB/@ahb@client_@h@m/verilog.psm
firmware/A2F-EVAL-KIT/CORDIC/component/Actel/SmartFusionMSS/MSS/2.5.106/mti/user_verilog/MSS_BFM_LIB/@ahb@wrapper_@f@m/verilog.psm
firmware/A2F-EVAL-KIT/CORDIC/component/Actel/SmartFusionMSS/MSS/2.5.106/mti/user_verilog/MSS_BFM_LIB/@ahb@wrapper_@h@m/verilog.psm
firmware/A2F-EVAL-KIT/CORDIC/component/Actel/SmartFusionMSS/MSS/2.5.106/mti/user_verilog/MSS_BFM_LIB/@apb@client_@h@m/verilog.psm
firmware/A2F-EVAL-KIT/CORDIC/component/Actel/SmartFusionMSS/MSS/2.5.106/mti/user_verilog/MSS_BFM_LIB/@apb@wrapper_@f@m/verilog.psm
firmware/A2F-EVAL-KIT/CORDIC/component/Actel/SmartFusionMSS/MSS/2.5.106/mti/user_verilog/MSS_BFM_LIB/@b@f@m_@m@a@i@n/verilog.psm
firmware/A2F-EVAL-KIT/CORDIC/component/Actel/SmartFusionMSS/MSS/2.5.106/mti/user_verilog/MSS_BFM_LIB/@c@m@master0@stage/verilog.psm
firmware/A2F-EVAL-KIT/CORDIC/component/Actel/SmartFusionMSS/MSS/2.5.106/mti/user_verilog/MSS_BFM_LIB/@c@m@master1@stage/verilog.psm
firmware/A2F-EVAL-KIT/CORDIC/component/Actel/SmartFusionMSS/MSS/2.5.106/mti/user_verilog/MSS_BFM_LIB/@c@m@master2@stage/verilog.psm
firmware/A2F-EVAL-KIT/CORDIC/component/Actel/SmartFusionMSS/MSS/2.5.106/mti/user_verilog/MSS_BFM_LIB/@c@m@master3@stage/verilog.psm
firmware/A2F-EVAL-KIT/CORDIC/component/Actel/SmartFusionMSS/MSS/2.5.106/mti/user_verilog/MSS_BFM_LIB/@c@m@master4@stage/verilog.psm
firmware/A2F-EVAL-KIT/CORDIC/component/Actel/SmartFusionMSS/MSS/2.5.106/mti/user_verilog/MSS_BFM_LIB/@c@m@slave@stage/verilog.psm
firmware/A2F-EVAL-KIT/CORDIC/component/Actel/SmartFusionMSS/MSS/2.5.106/mti/user_verilog/MSS_BFM_LIB/@client@addr@data_@f@m/verilog.psm
firmware/A2F-EVAL-KIT/CORDIC/component/Actel/SmartFusionMSS/MSS/2.5.106/mti/user_verilog/MSS_BFM_LIB/@client@addr@data_@h@m/verilog.psm
firmware/A2F-EVAL-KIT/CORDIC/component/Actel/SmartFusionMSS/MSS/2.5.106/mti/user_verilog/MSS_BFM_LIB/@client_@f@m/verilog.psm
firmware/A2F-EVAL-KIT/CORDIC/component/Actel/SmartFusionMSS/MSS/2.5.106/mti/user_verilog/MSS_BFM_LIB/@d@s@s@a@b/verilog.psm
firmware/A2F-EVAL-KIT/CORDIC/component/Actel/SmartFusionMSS/MSS/2.5.106/mti/user_verilog/MSS_BFM_LIB/@d@s@s@a@b_@f060/verilog.psm
firmware/A2F-EVAL-KIT/CORDIC/component/Actel/SmartFusionMSS/MSS/2.5.106/mti/user_verilog/MSS_BFM_LIB/@default@slave@s@m/verilog.psm
firmware/A2F-EVAL-KIT/CORDIC/component/Actel/SmartFusionMSS/MSS/2.5.106/mti/user_verilog/MSS_BFM_LIB/@f2@a@b/verilog.psm
firmware/A2F-EVAL-KIT/CORDIC/component/Actel/SmartFusionMSS/MSS/2.5.106/mti/user_verilog/MSS_BFM_LIB/@f2@a@b_@f060/verilog.psm
firmware/A2F-EVAL-KIT/CORDIC/component/Actel/SmartFusionMSS/MSS/2.5.106/mti/user_verilog/MSS_BFM_LIB/@f2@d@s@s_@a@c@e/verilog.psm
firmware/A2F-EVAL-KIT/CORDIC/component/Actel/SmartFusionMSS/MSS/2.5.106/mti/user_verilog/MSS_BFM_LIB/@f2@d@s@s_@a@c@e_@m@i@s@c/verilog.psm
firmware/A2F-EVAL-KIT/CORDIC/component/Actel/SmartFusionMSS/MSS/2.5.106/mti/user_verilog/MSS_BFM_LIB/@f2@d@s@s_@a@c@e_@m@i@s@c_@a@p@b3/verilog.psm
firmware/A2F-EVAL-KIT/CORDIC/component/Actel/SmartFusionMSS/MSS/2.5.106/mti/user_verilog/MSS_BFM_LIB/@f2@d@s@s_@a@c@e_@m@i@s@c_@f@d@e@t/verilog.psm
firmware/A2F-EVAL-KIT/CORDIC/component/Actel/SmartFusionMSS/MSS/2.5.106/mti/user_verilog/MSS_BFM_LIB/@f2@d@s@s_@a@c@e_@m@i@s@c_@f@d@e@t12/verilog.psm
firmware/A2F-EVAL-KIT/CORDIC/component/Actel/SmartFusionMSS/MSS/2.5.106/mti/user_verilog/MSS_BFM_LIB/@f2@d@s@s_@a@c@e_@m@i@s@c_@i@n@t_@l@o@g@i@c/verilog.psm
firmware/A2F-EVAL-KIT/CORDIC/component/Actel/SmartFusionMSS/MSS/2.5.106/mti/user_verilog/MSS_BFM_LIB/@f2@d@s@s_@a@c@e_@m@i@s@c_@p@d@m@a/verilog.psm
firmware/A2F-EVAL-KIT/CORDIC/component/Actel/SmartFusionMSS/MSS/2.5.106/mti/user_verilog/MSS_BFM_LIB/@f2@d@s@s_@a@c@e_@m@i@s@c_@r@d@e@t/verilog.psm
firmware/A2F-EVAL-KIT/CORDIC/component/Actel/SmartFusionMSS/MSS/2.5.106/mti/user_verilog/MSS_BFM_LIB/@f2@d@s@s_@a@c@e_@m@i@s@c_@r@d@e@t12/verilog.psm
firmware/A2F-EVAL-KIT/CORDIC/component/Actel/SmartFusionMSS/MSS/2.5.106/mti/user_verilog/MSS_BFM_LIB/@f2@d@s@s_@a@c@e_@m@i@s@c_@r@d@e@t32/verilog.psm
firmware/A2F-EVAL-KIT/CORDIC/component/Actel/SmartFusionMSS/MSS/2.5.106/mti/user_verilog/MSS_BFM_LIB/@f2@d@s@s_@a@c@e_@m@i@s@c_@r@d@m@u@x/verilog.psm
firmware/A2F-EVAL-KIT/CORDIC/component/Actel/SmartFusionMSS/MSS/2.5.106/mti/user_verilog/MSS_BFM_LIB/@f2@d@s@s_@a@c@e_@m@i@s@c_@s@t@i@c@k@y@f@l@a@g/verilog.psm
firmware/A2F-EVAL-KIT/CORDIC/component/Actel/SmartFusionMSS/MSS/2.5.106/mti/user_verilog/MSS_BFM_LIB/@f2@d@s@s_@a@c@e_@m@i@s@c_@s@t@i@c@k@y@f@l@a@g21/verilog.psm
firmware/A2F-EVAL-KIT/CORDIC/component/Actel/SmartFusionMSS/MSS/2.5.106/mti/user_verilog/MSS_BFM_LIB/@f2@d@s@s_@a@c@e_@m@i@s@c_@s@t@i@c@k@y@f@l@a@g24/verilog.psm
firmware/A2F-EVAL-KIT/CORDIC/component/Actel/SmartFusionMSS/MSS/2.5.106/mti/user_verilog/MSS_BFM_LIB/@f2@d@s@s_@a@c@e_@m@i@s@c_@s@t@i@c@k@y@f@l@a@g32/verilog.psm
firmware/A2F-EVAL-KIT/CORDIC/component/Actel/SmartFusionMSS/MSS/2.5.106/mti/user_verilog/MSS_BFM_LIB/@f2@d@s@s_@a@c@e_@m@i@s@c_@s@t@i@c@k@y@f@l@a@g9/verilog.psm
firmware/A2F-EVAL-KIT/CORDIC/component/Actel/SmartFusionMSS/MSS/2.5.106/mti/user_verilog/MSS_BFM_LIB/@f2@d@s@s_@a@c@e_@m@i@s@c_@s@y@n@c/verilog.psm
firmware/A2F-EVAL-KIT/CORDIC/component/Actel/SmartFusionMSS/MSS/2.5.106/mti/user_verilog/MSS_BFM_LIB/@f2@d@s@s_@a@c@e_@m@i@s@c_@s@y@n@c12/verilog.psm
firmware/A2F-EVAL-KIT/CORDIC/component/Actel/SmartFusionMSS/MSS/2.5.106/mti/user_verilog/MSS_BFM_LIB/@f2@d@s@s_@a@c@e_@p@p@e/verilog.psm
firmware/A2F-EVAL-KIT/CORDIC/component/Actel/SmartFusionMSS/MSS/2.5.106/mti/user_verilog/MSS_BFM_LIB/@f2@d@s@s_@a@c@e_@p@p@e_@a@d@d@e@r/verilog.psm
firmware/A2F-EVAL-KIT/CORDIC/component/Actel/SmartFusionMSS/MSS/2.5.106/mti/user_verilog/MSS_BFM_LIB/@f2@d@s@s_@a@c@e_@p@p@e_@a@l@u/verilog.psm
firmware/A2F-EVAL-KIT/CORDIC/component/Actel/SmartFusionMSS/MSS/2.5.106/mti/user_verilog/MSS_BFM_LIB/@f2@d@s@s_@a@c@e_@p@p@e_@d@p@r@a@m/verilog.psm
firmware/A2F-EVAL-KIT/CORDIC/component/Actel/SmartFusionMSS/MSS/2.5.106/mti/user_verilog/MSS_BFM_LIB/@f2@d@s@s_@a@c@e_@p@p@e_@d@p@r@a@m_@c@t@r@l/verilog.psm
firmware/A2F-EVAL-KIT/CORDIC/component/Actel/SmartFusionMSS/MSS/2.5.106/mti/user_verilog/MSS_BFM_LIB/@f2@d@s@s_@a@c@e_@p@p@e_@f@i@f@o/verilog.psm
firmware/A2F-EVAL-KIT/CORDIC/component/Actel/SmartFusionMSS/MSS/2.5.106/mti/user_verilog/MSS_BFM_LIB/@f2@d@s@s_@a@c@e_@p@p@e_@f@i@f@o_@c@t@r@l/verilog.psm
firmware/A2F-EVAL-KIT/CORDIC/component/Actel/SmartFusionMSS/MSS/2.5.106/mti/user_verilog/MSS_BFM_LIB/@f2@d@s@s_@a@c@e_@p@p@e_@f@s@m/verilog.psm
firmware/A2F-EVAL-KIT/CORDIC/component/Actel/SmartFusionMSS/MSS/2.5.106/mti/user_verilog/MSS_BFM_LIB/@f2@d@s@s_@a@c@e_@p@p@e_@f@s@m_@s@t@f@i@l@t/verilog.psm
firmware/A2F-EVAL-KIT/CORDIC/component/Actel/SmartFusionMSS/MSS/2.5.106/mti/user_verilog/MSS_BFM_LIB/@f2@d@s@s_@a@c@e_@p@p@e_@m@u@l@t/verilog.psm
firmware/A2F-EVAL-KIT/CORDIC/component/Actel/SmartFusionMSS/MSS/2.5.106/mti/user_verilog/MSS_BFM_LIB/@f2@d@s@s_@a@c@e_@p@p@e_@r@d@m@u@x/verilog.psm
firmware/A2F-EVAL-KIT/CORDIC/component/Actel/SmartFusionMSS/MSS/2.5.106/mti/user_verilog/MSS_BFM_LIB/@f2@d@s@s_@a@c@e_@p@p@e_@s@s@e_@c@t@r@l/verilog.psm
firmware/A2F-EVAL-KIT/CORDIC/component/Actel/SmartFusionMSS/MSS/2.5.106/mti/user_verilog/MSS_BFM_LIB/@f2@d@s@s_@a@c@e_@p@p@e_@t@h@r@f@l@a@g@s/verilog.psm
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
