marmote/marmote/firmware/PowerBoard/application/UsbAudioDeviceTest/USB Memory Map.xlsx

DEC | HEX | Abolute HEX | Content | Comment | Tested | Actual function at address
0 | 0 | 40006000 | EP0 descriptors | ADDR0_TX, COUNT0_TX, ADDR0_RX, COUNT0_RX | Yes | 0: EP0 TX ADDR
8 | 8 | 40006008 |  |  |  | 8: EP0 RX ADDR | C: EP0 RX COUNT
16 | 10 | 40006010 | EP1 descriptors | ADDR1_TX, COUNT1_TX, ADDR1_RX, COUNT1_RX | Yes | 10: EP1 TX BUF 0
24 | 18 | 40006018 |  |  |  | 18: EP1 TX BUF 1
32 | 20 | 40006020 | EP0 TX buffer |  | Yes
40 | 28 | 40006028
48 | 30 | 40006030
56 | 38 | 40006038
64 | 40 | 40006040
72 | 48 | 40006048
80 | 50 | 40006050
88 | 58 | 40006058
96 | 60 | 40006060 | EP0 RX buffer |  | Yes
104 | 68 | 40006068
112 | 70 | 40006070
120 | 78 | 40006078
128 | 80 | 40006080
136 | 88 | 40006088
144 | 90 | 40006090
152 | 98 | 40006098
160 | A0 | 400060A0 | EP1 TX buffer #0 |  | Yes
168 | A8 | 400060A8
176 | B0 | 400060B0
184 | B8 | 400060B8
192 | C0 | 400060C0
200 | C8 | 400060C8
208 | D0 | 400060D0
216 | D8 | 400060D8
224 | E0 | 400060E0
232 | E8 | 400060E8
240 | F0 | 400060F0
248 | F8 | 400060F8
256 | 100 | 40006100 | EP1 TX buffer #1 |  | Yes
264 | 108 | 40006108
272 | 110 | 40006110
280 | 118 | 40006118
288 | 120 | 40006120
296 | 128 | 40006128
304 | 130 | 40006130
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
