marmote/marmote/hardware/BeaverBoard_RevA/Misc/Measurement/AD/GND.jpg

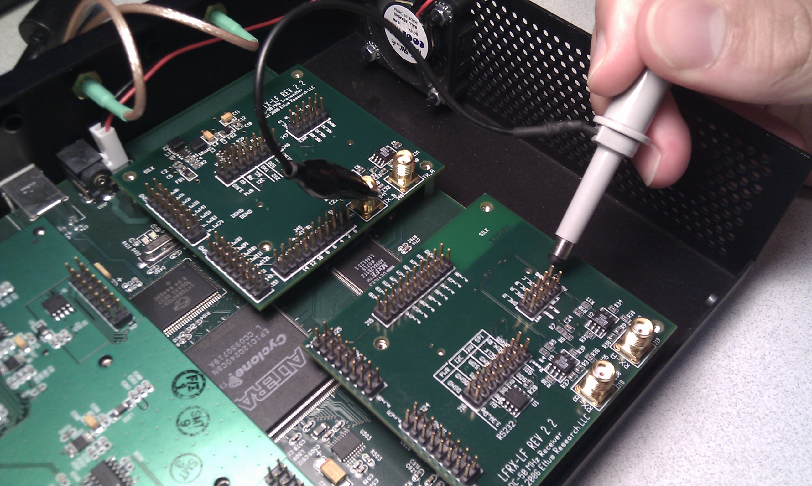
hardware/BeaverBoard_RevA/Misc/Measurement/AD/GND.jpg
