marmote/marmote/hardware/BeaverBoard_RevA/Misc/Measurement/AD/GND_scope.jpg

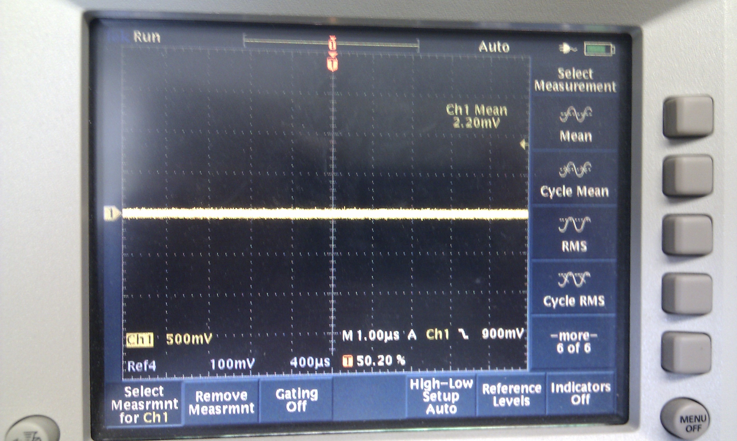
hardware/BeaverBoard_RevA/Misc/Measurement/AD/GND_scope.jpg
