marmote/marmote/hardware/BeaverBoard_RevA/Misc/Measurement/AD/LFRX__scope.jpg

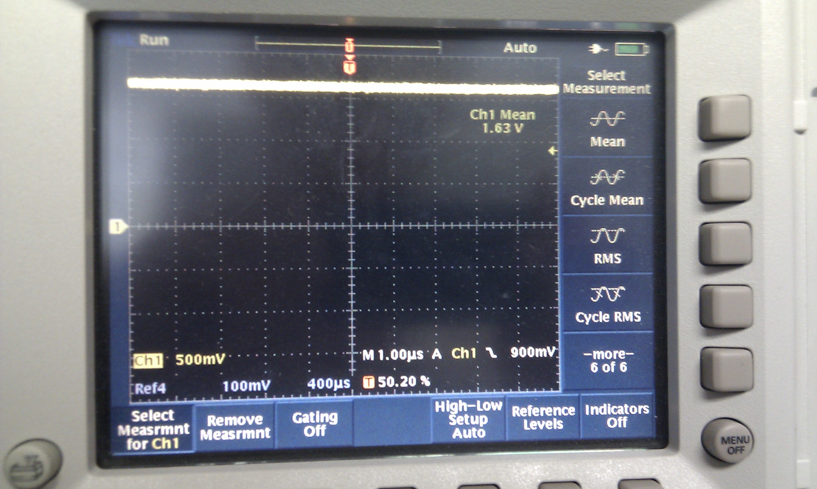
hardware/BeaverBoard_RevA/Misc/Measurement/AD/LFRX__scope.jpg
