marmote/marmote/hardware/BeaverBoard_RevA/Misc/Measurement/AD/LFRX_OUT.jpg

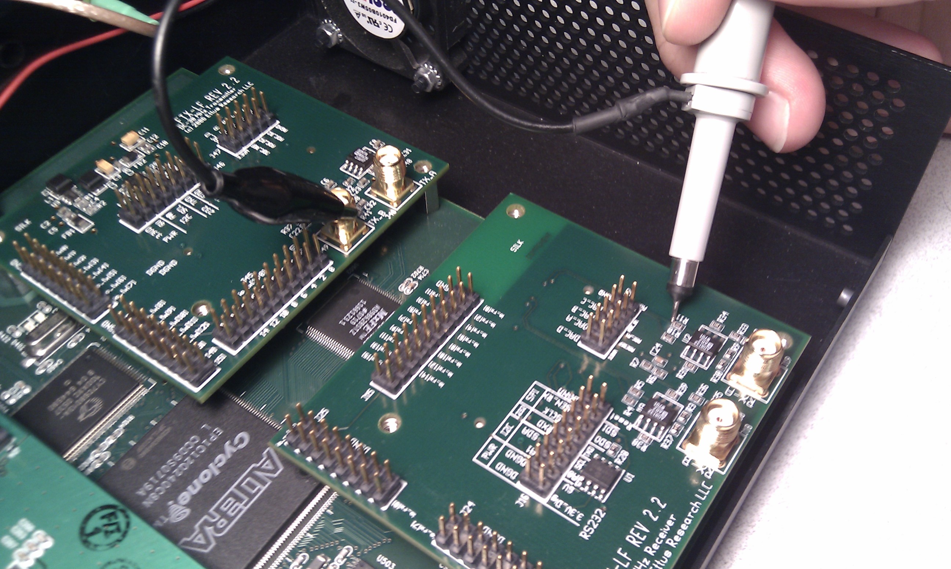
hardware/BeaverBoard_RevA/Misc/Measurement/AD/LFRX_OUT.jpg
