marmote/marmote/hardware/BeaverBoard_RevA/Misc/Measurement/AD/RFX400_OUT2.jpg

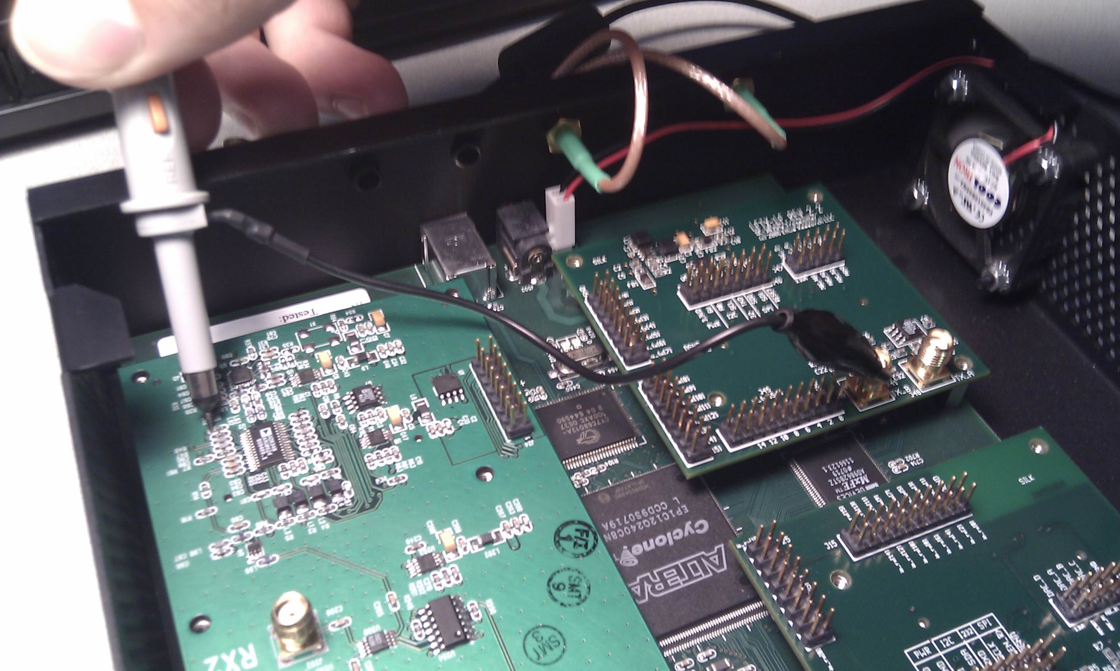
hardware/BeaverBoard_RevA/Misc/Measurement/AD/RFX400_OUT2.jpg
