marmote/marmote/hardware/BeaverBoard_RevA/Misc/Measurement/AD/RFX400_OUT_scope_turned_off.jpg

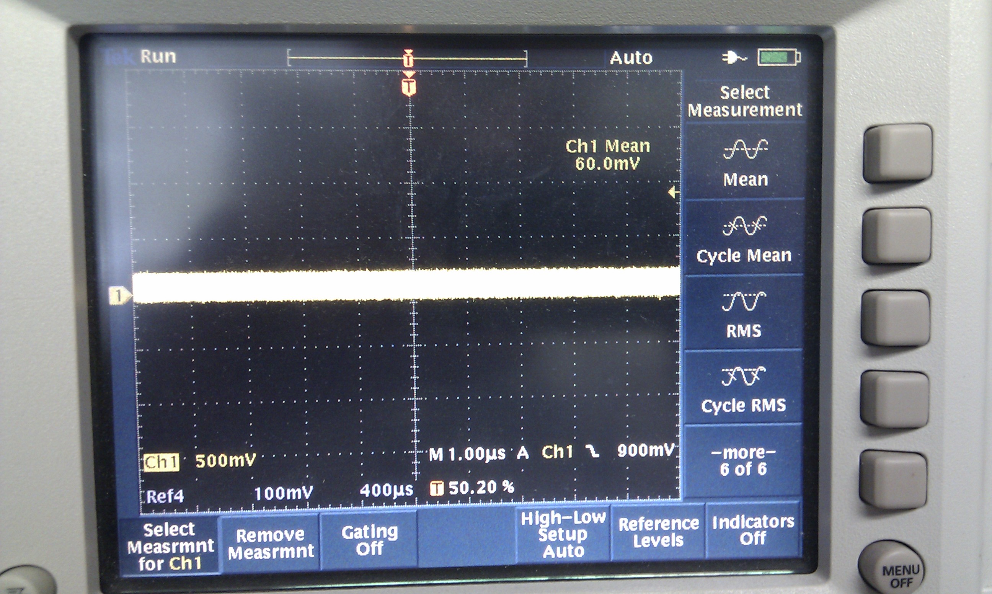
hardware/BeaverBoard_RevA/Misc/Measurement/AD/RFX400_OUT_scope_turned_off.jpg
