marmote/marmote/hardware/BeaverBoard_RevA/Misc/Measurement/USRP power/IMG_9801.JPG

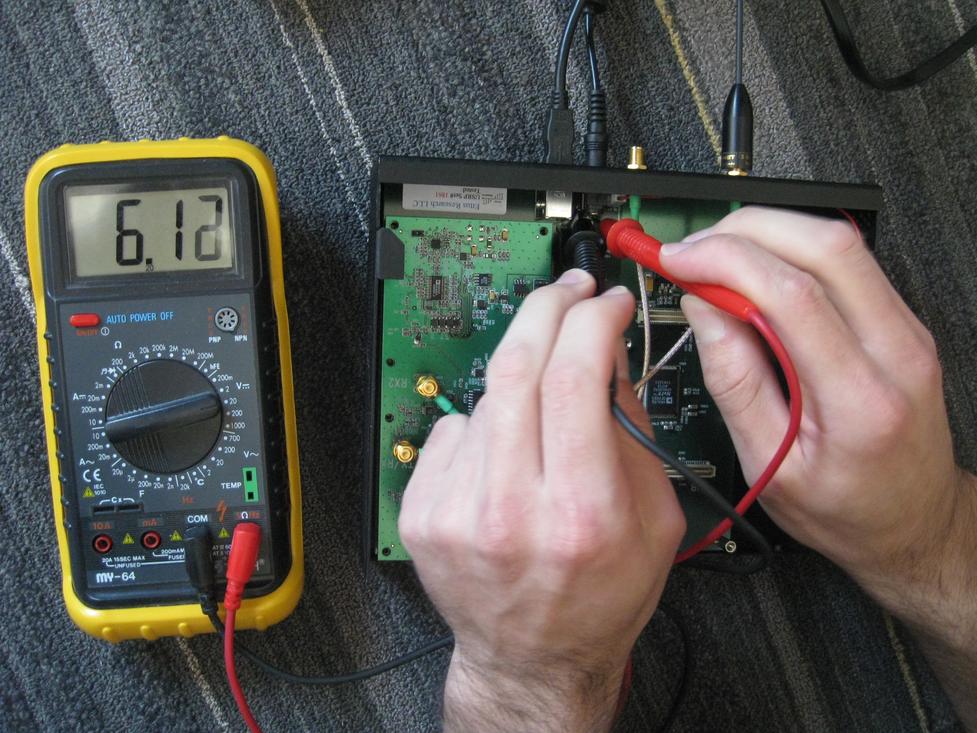
hardware/BeaverBoard_RevA/Misc/Measurement/USRP power/IMG_9801.JPG
