marmote/marmote/hardware/BeaverBoard_RevA/Misc/Measurement/USRP power/IMG_9802.JPG

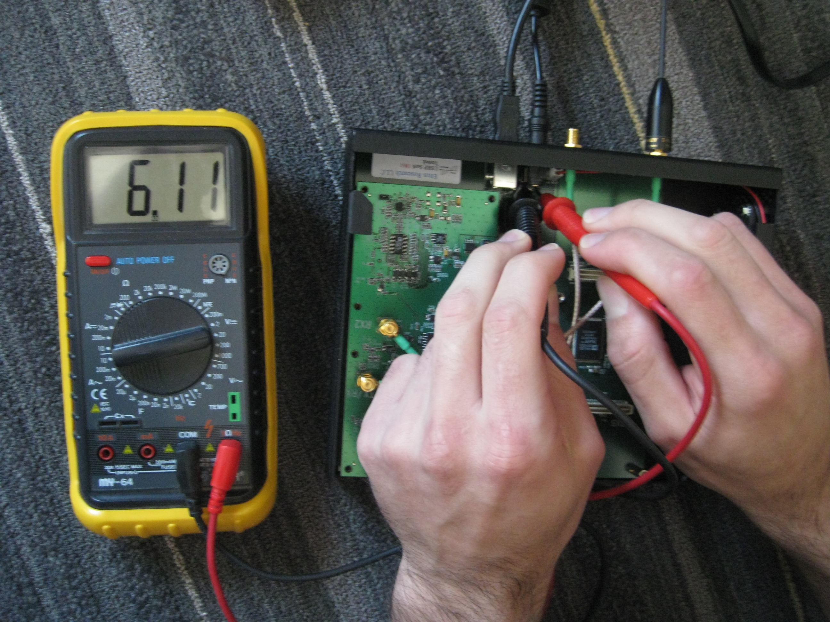
hardware/BeaverBoard_RevA/Misc/Measurement/USRP power/IMG_9802.JPG
