marmote/marmote/hardware/BeaverBoard_RevA/Misc/Measurement/USRP power/IMG_9803.JPG

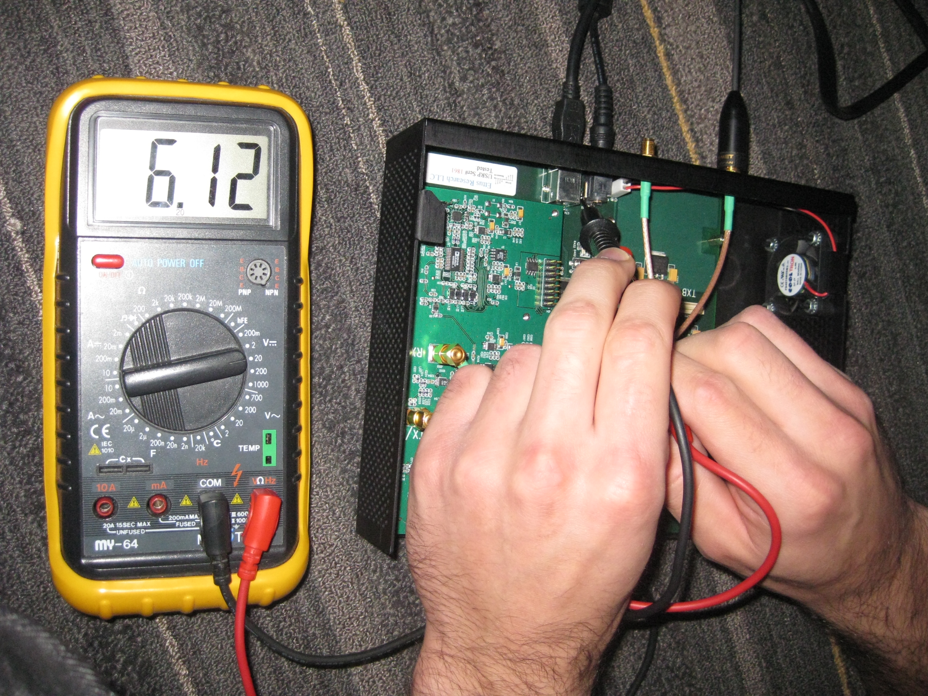
hardware/BeaverBoard_RevA/Misc/Measurement/USRP power/IMG_9803.JPG
