marmote/marmote/hardware/BeaverBoard_RevA/Misc/Measurement/Voltage Current Converter (Volgyesi bridge)/IMAG0501.2.jpg

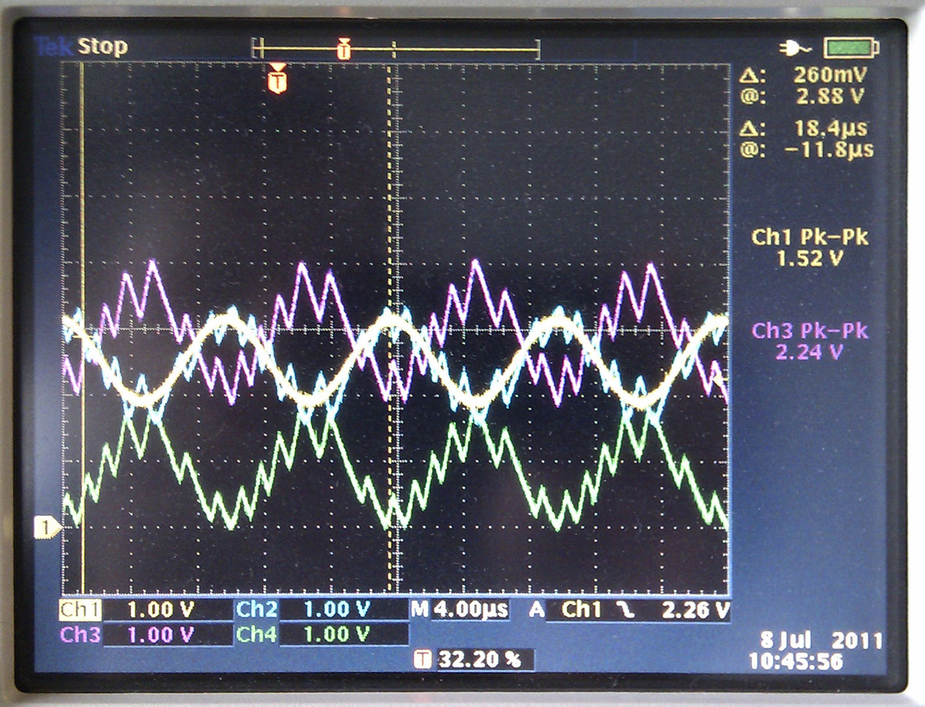
hardware/BeaverBoard_RevA/Misc/Measurement/Voltage Current Converter (Volgyesi bridge)/IMAG0501.2.jpg
