marmote/marmote/hardware/BeaverBoard_RevA/Misc/Measurement/Voltage Current Converter (Volgyesi bridge)/IMAG0502.2.jpg

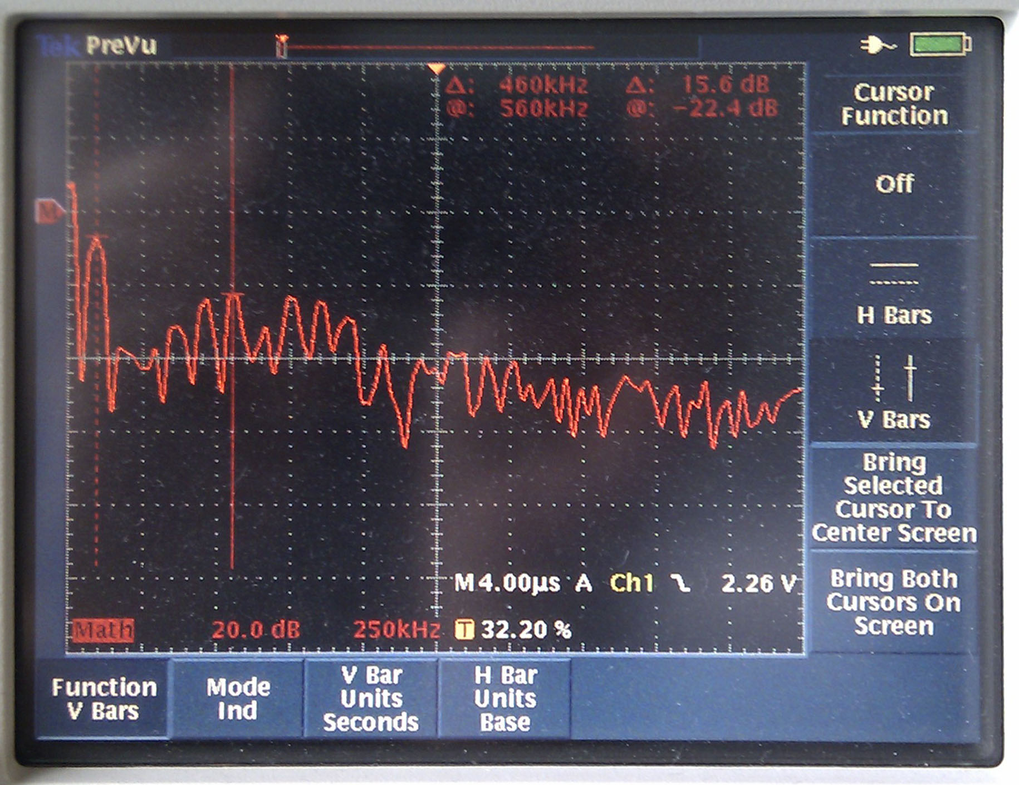
hardware/BeaverBoard_RevA/Misc/Measurement/Voltage Current Converter (Volgyesi bridge)/IMAG0502.2.jpg
