marmote/marmote/hardware/BeaverBoard_RevA/Misc/Measurement/Voltage Current Converter (Volgyesi bridge)/IMAG0502.jpg

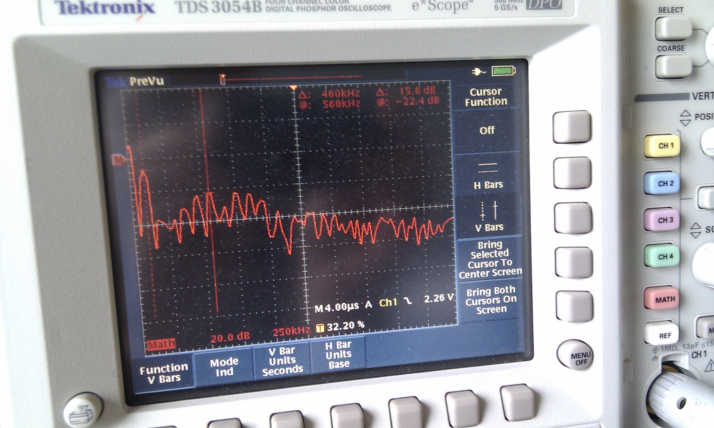
hardware/BeaverBoard_RevA/Misc/Measurement/Voltage Current Converter (Volgyesi bridge)/IMAG0502.jpg
