marmote/marmote/hardware/MainBoard_RevB/MainBoard_RevB_Sch.pdf

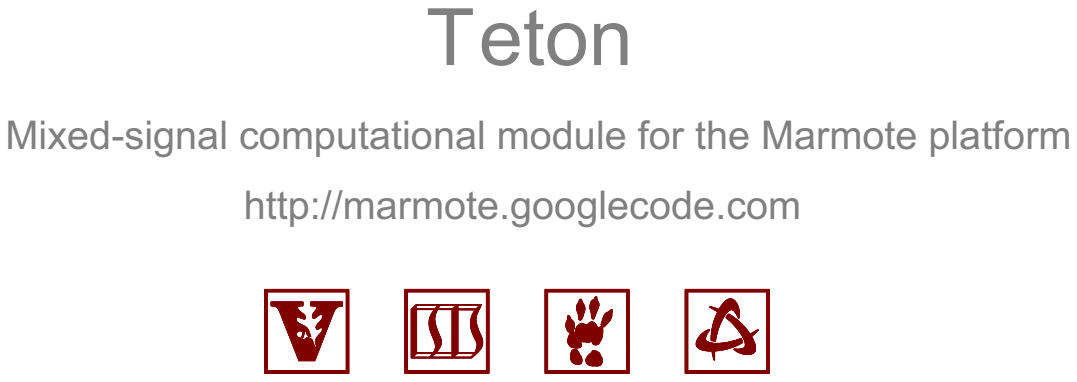
[picture p56: page 1]

Mixed-signal computational module for the Marmote platform

http://marmote.googlecode.com

Pages: 1 -2 - 3 - 4 - 5 - Cover page 6 - 7 - 8 - 9 - 10 - External AFE #2 SF supply pins Ethernet Clock, reset, JTAG USB and AFE dig. SF AFE I/O signals External AFE #1 Connectors | Designed by: Sandor Szilvasi sandor.szilvasi@vanderbilt.edu | Cover page

Verified by: Peter Volgyesi peter.volgyesi@vanderbilt.edu | Title: Teton | Rev: A

Date: 12/12/2012 8:42:37 | Sheet: 1/10

Copyright © 2012 Vanderbilt University, ISIS

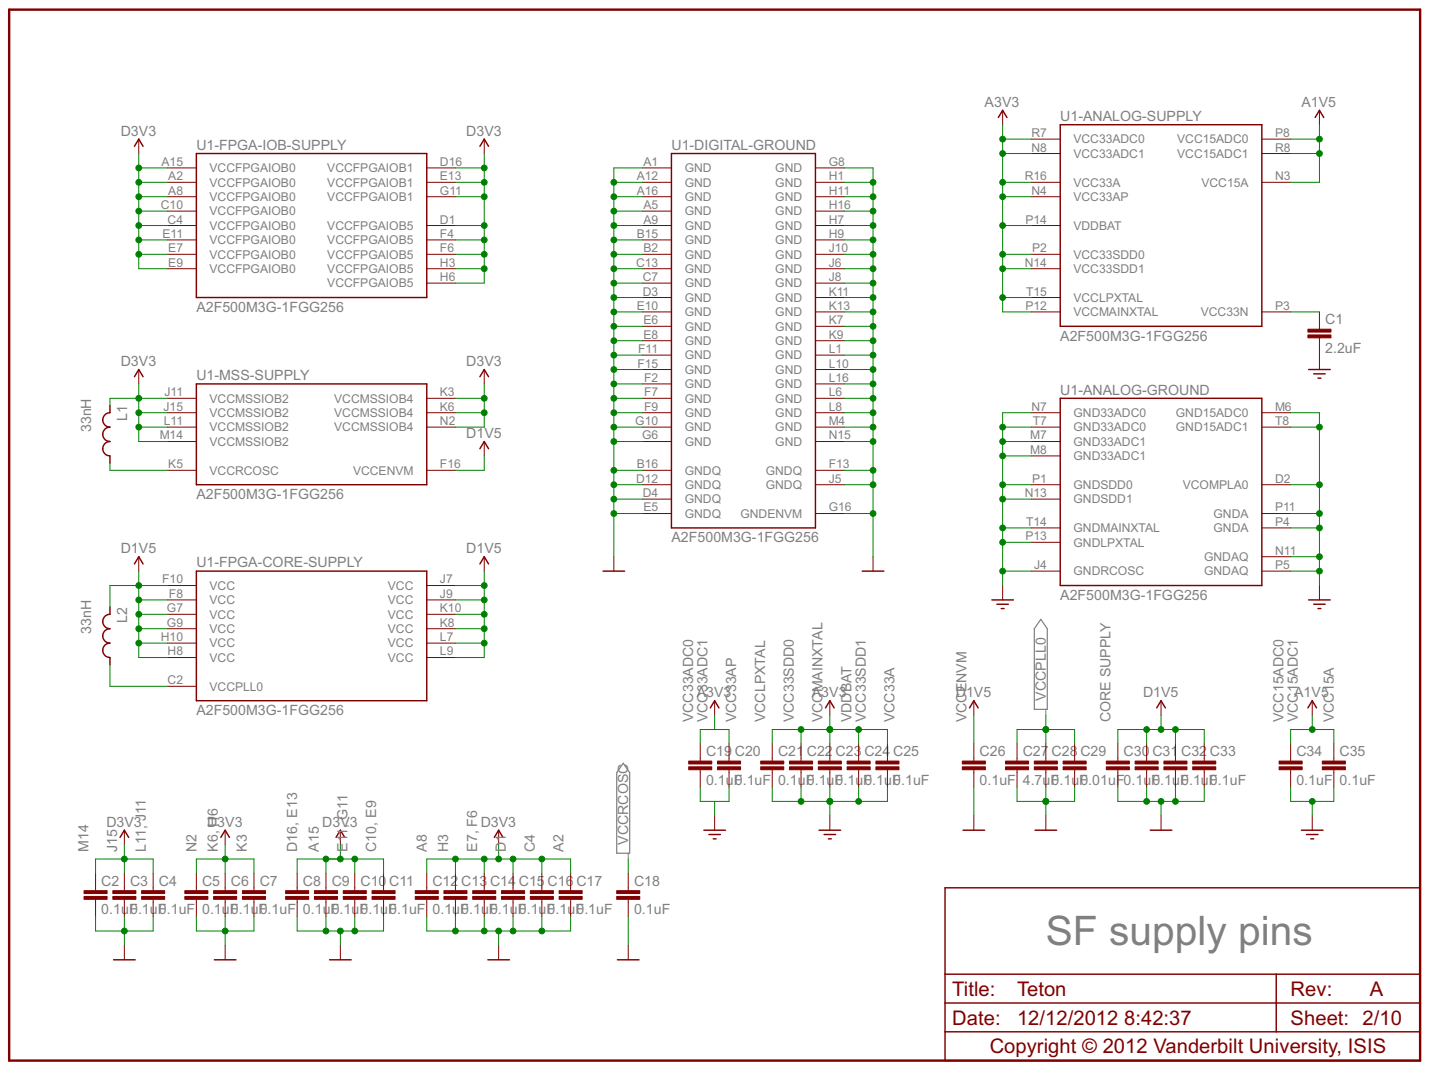
[picture p57: page 2]

Title: Teton | Rev: A
Date: 12/12/2012 8:42:37 | Sheet: 2/10

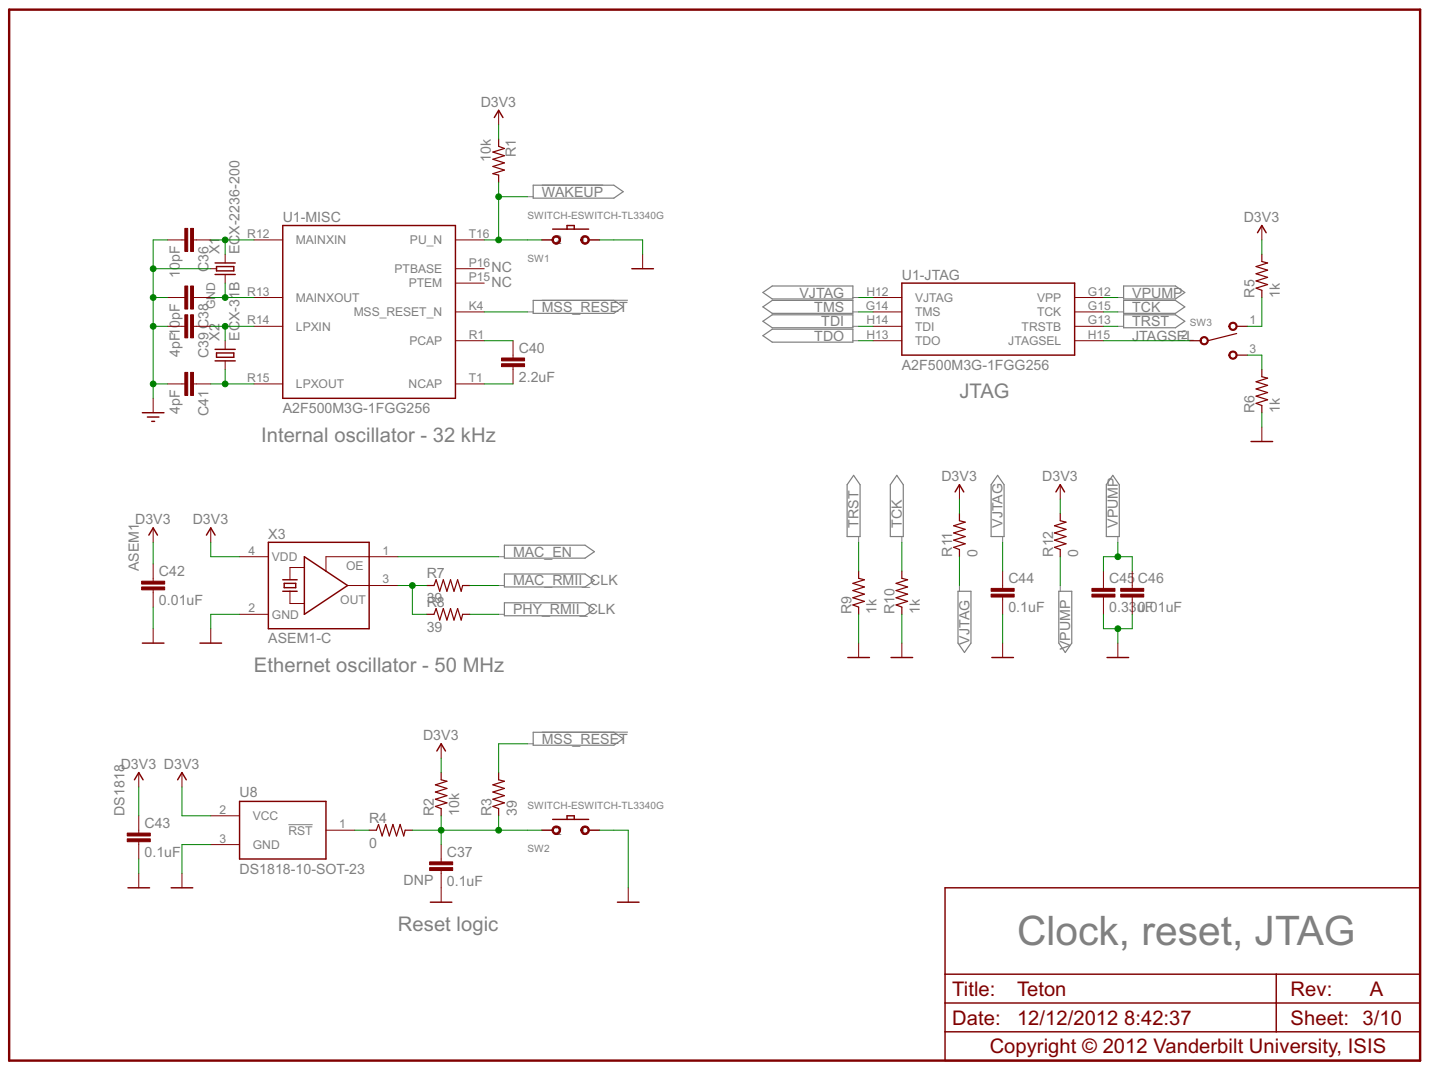
[picture p58: page 3]

Title: Teton | Rev: A
Date: 12/12/2012 8:42:37 | Sheet: 3/10

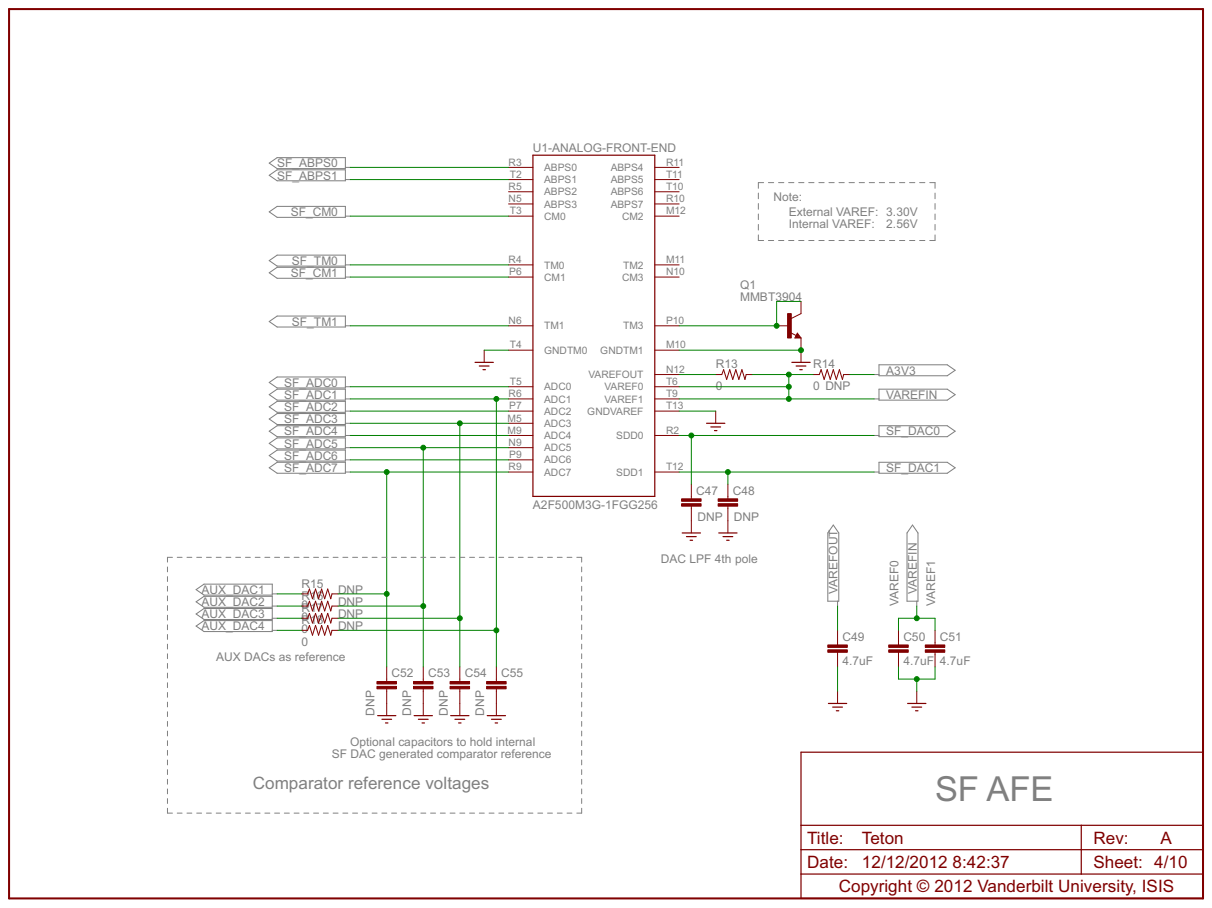
[picture p59: page 4]

AUX DACs as reference

DNP DNP

Optional capacitors to hold internal
SF DAC generated comparator reference

Title: Teton | Rev: A
Date: 12/12/2012 8:42:37 | Sheet: 4/10

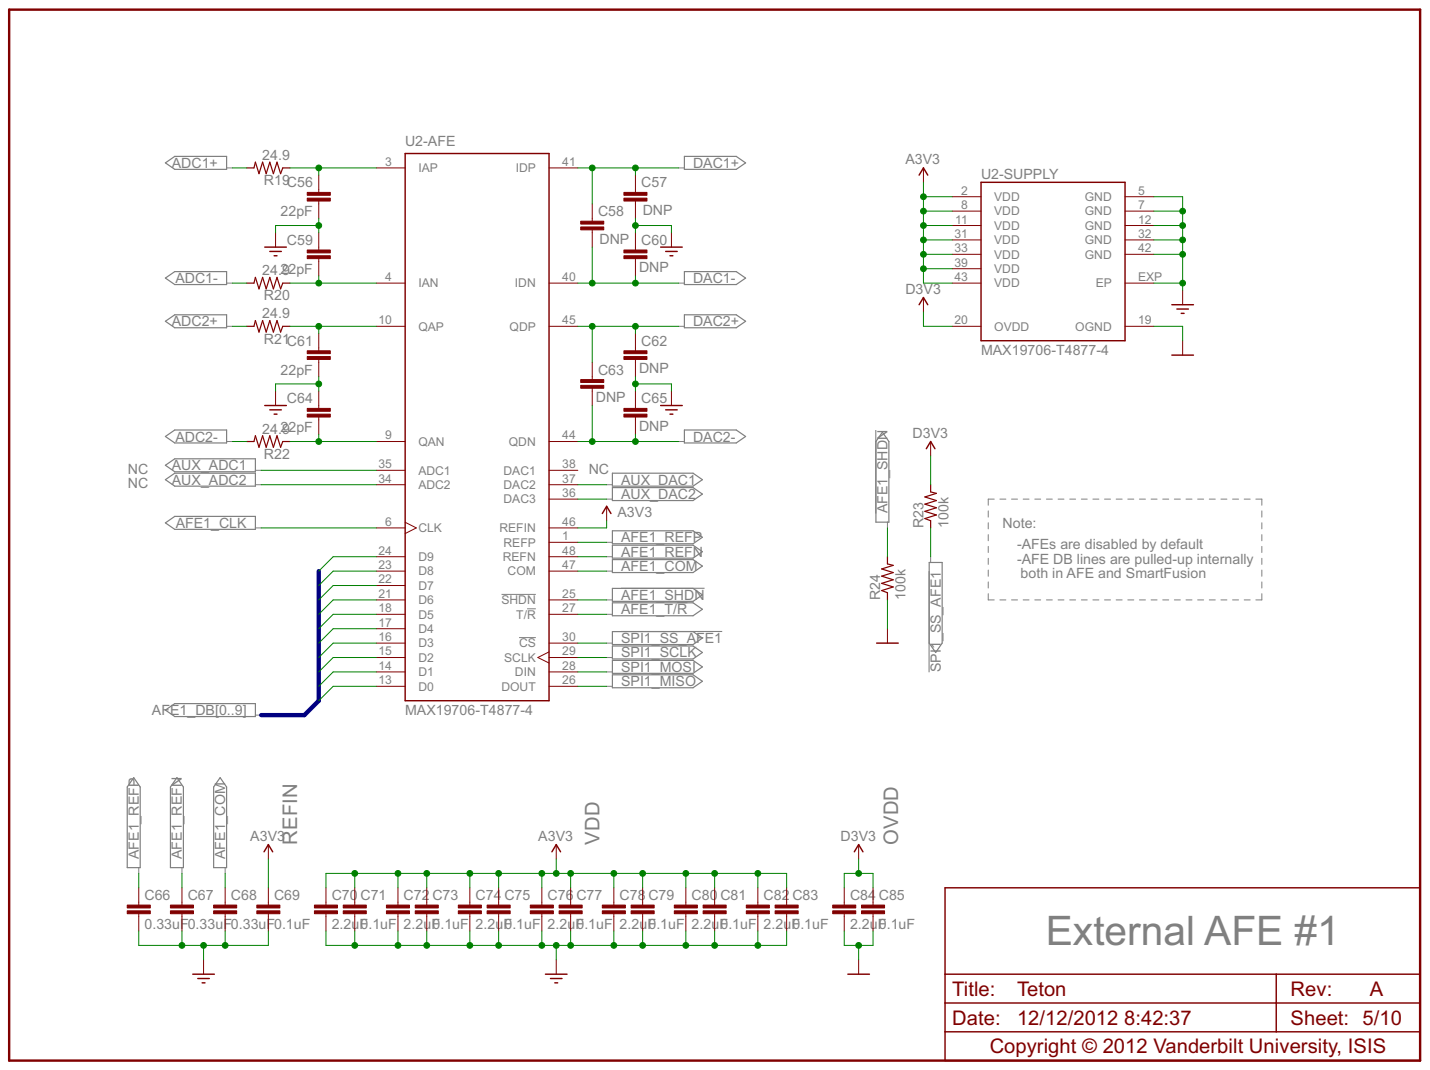
[picture p60: page 5]

Note:
-AFEs are disabled by default
-AFE DB lines are pulled-up internally
both in AFE and SmartFusion

Title: Teton | Rev: A
Date: 12/12/2012 8:42:37 | Sheet: 5/10

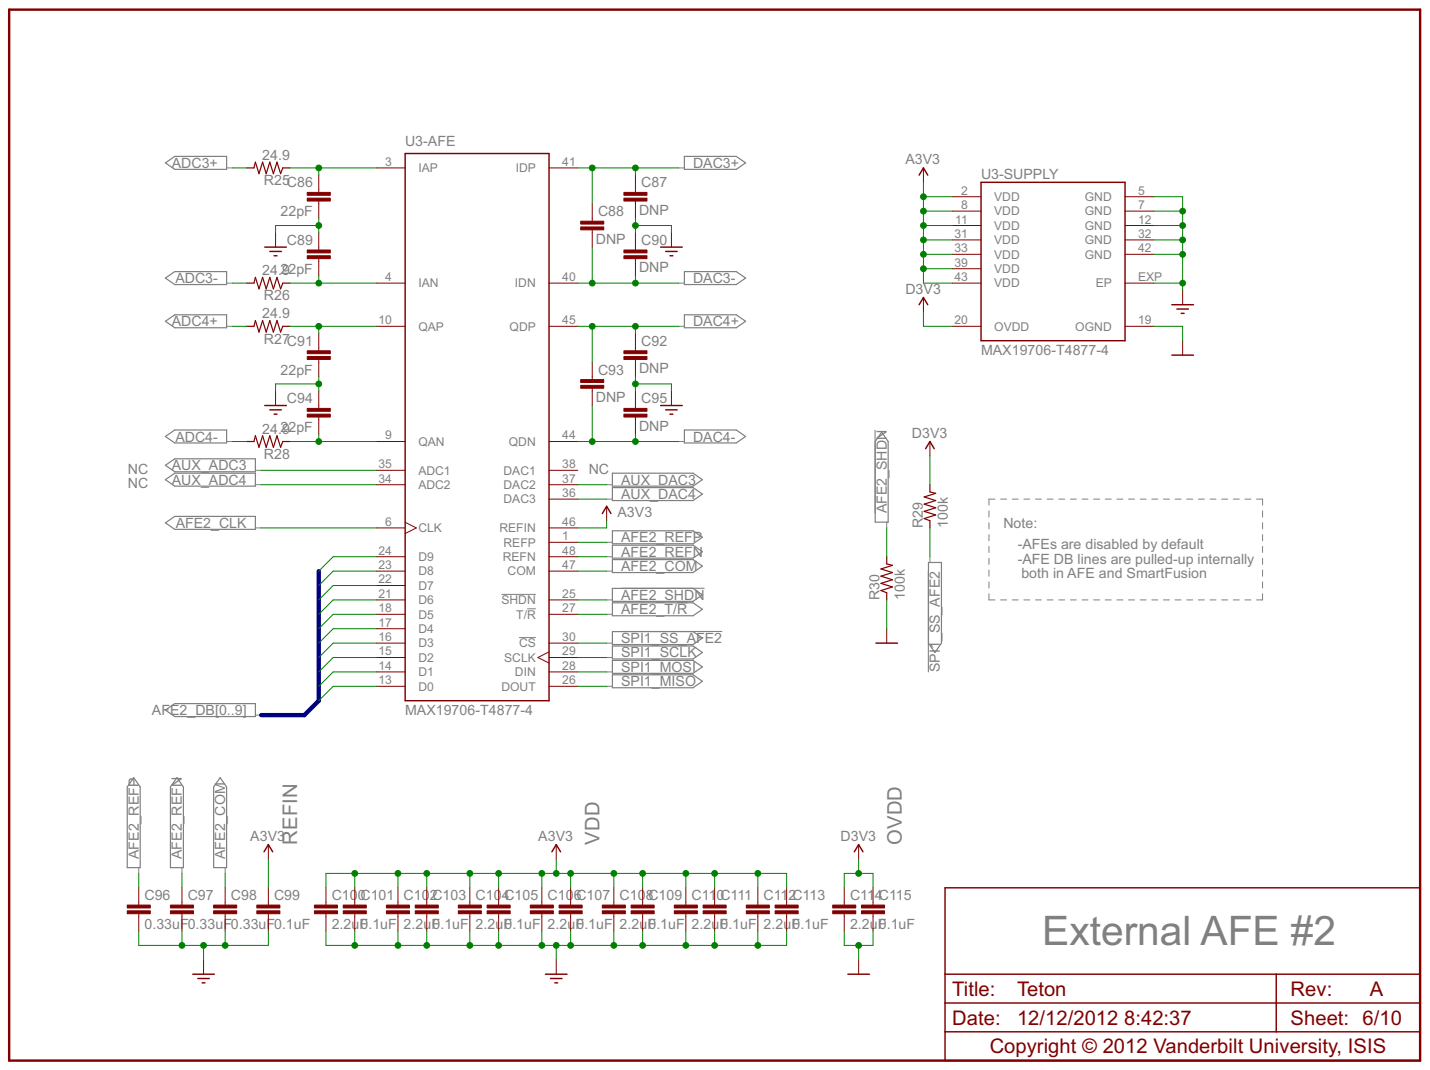
[picture p61: page 6]
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

Title: Teton | Rev: A
Date: 12/12/2012 8:42:37 | Sheet: 6/10

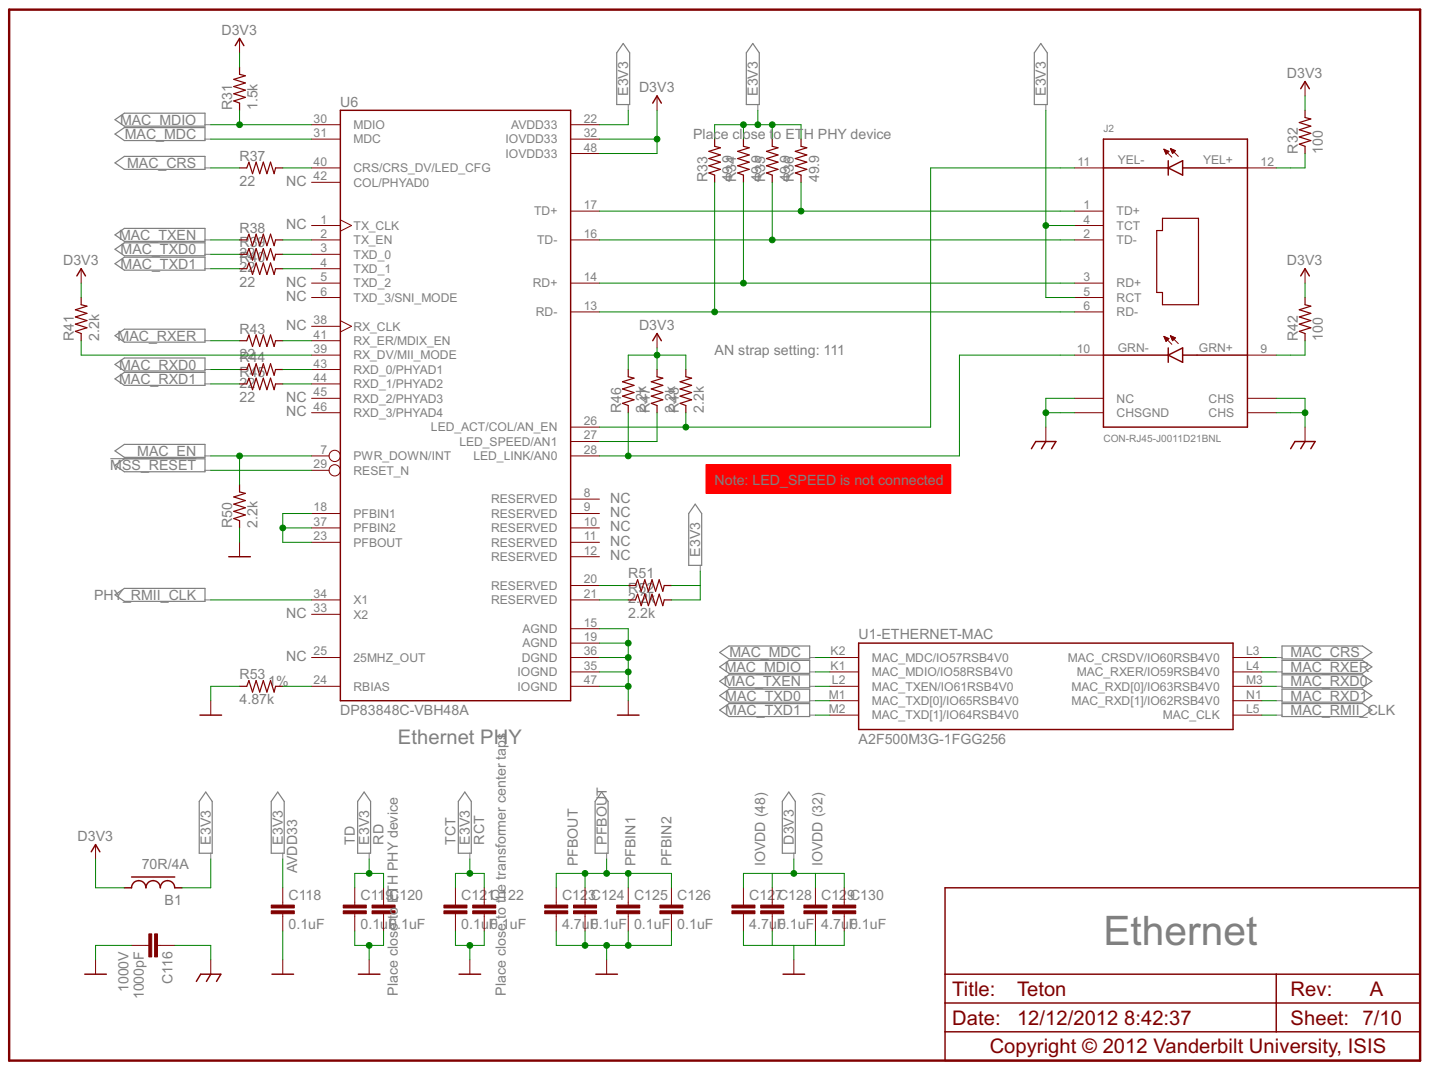
[picture p62: page 7]

J2 TD+ YEL-NC GRN-CHSGND | YEL+ GRN+ CHS

Place close to ETH PHY device

AN strap setting: 111 | 5 | RD- 6

Note: LED_SPEED is not connected

8 RESERVED NC

37 | 9 RESERVED
23 | 10 RESERVED 11 RESERVED

Place close to the transformer center taps

Title: Teton | Rev: A
Date: 12/12/2012 8:42:37 | Sheet: 7/10

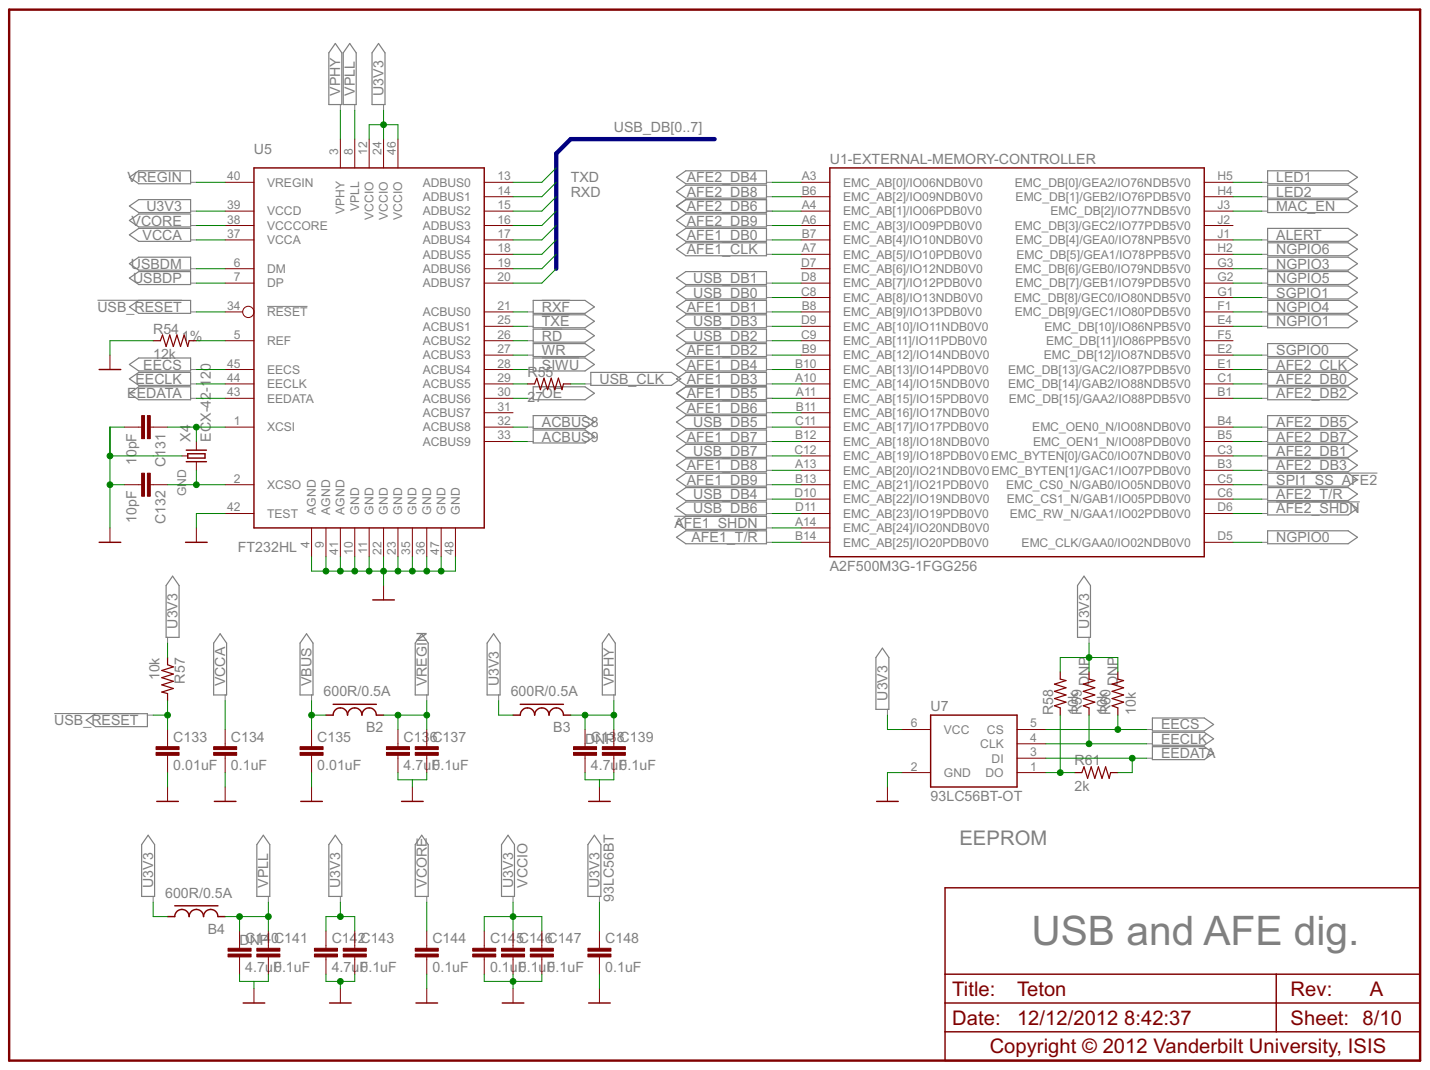
[picture p63: page 8]

USB and AFE dig.

Title: Teton | Rev: A
Date: 12/12/2012 8:42:37 | Sheet: 8/10

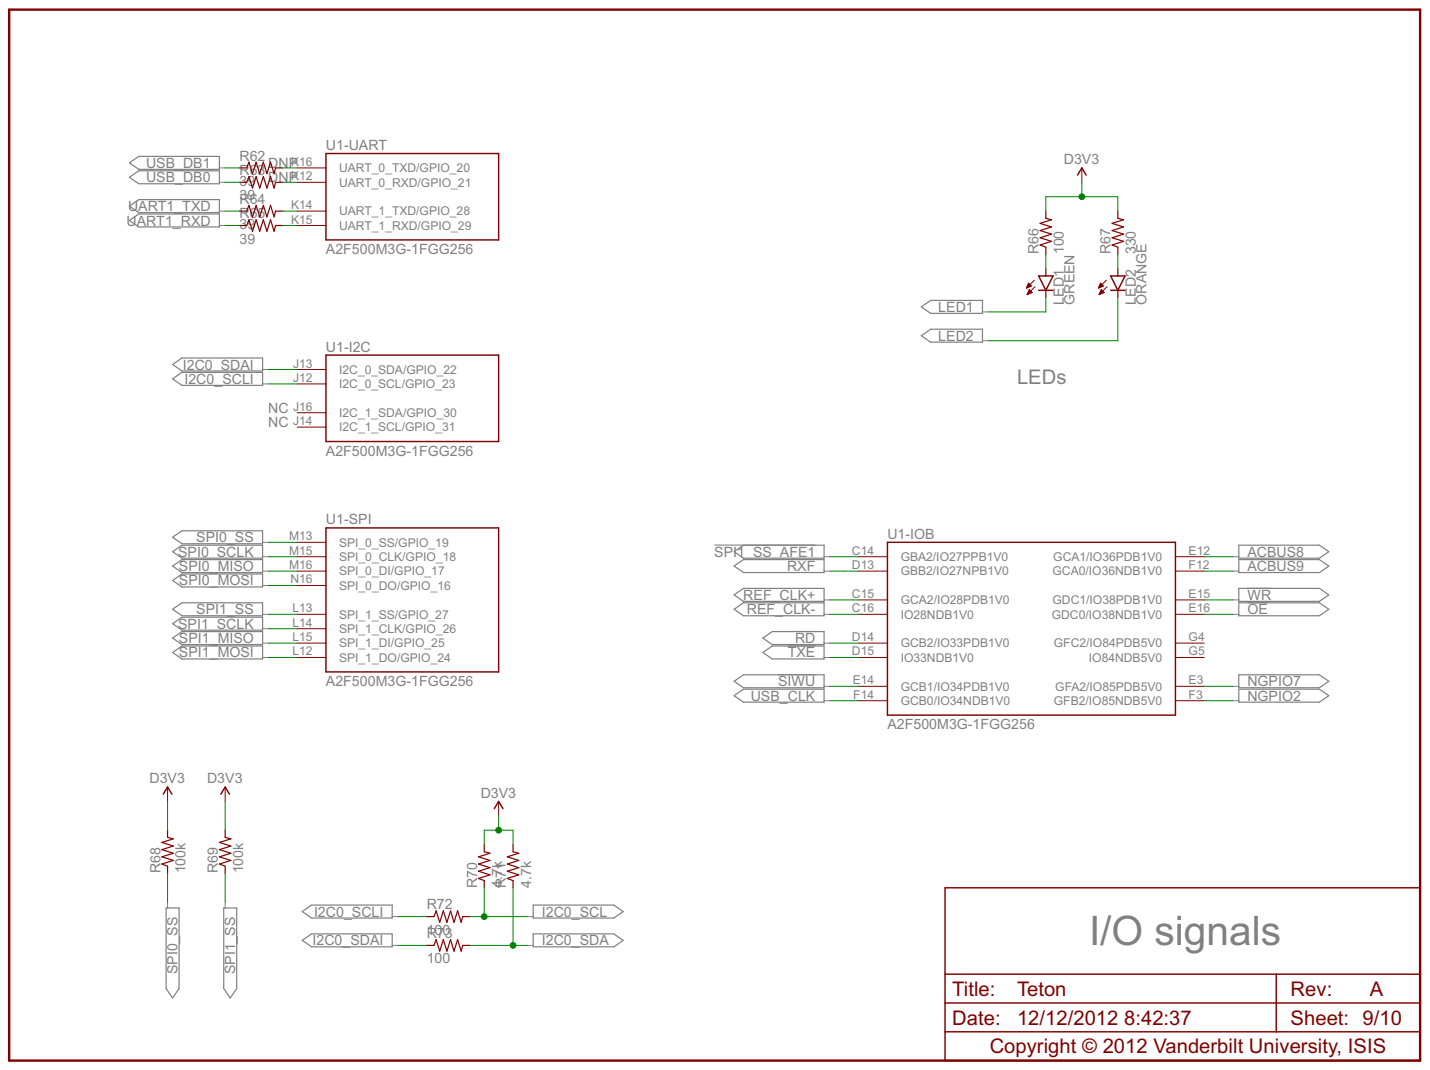
[picture p64: page 9]

Title: Teton | Rev: A
Date: 12/12/2012 8:42:37 | Sheet: 9/10

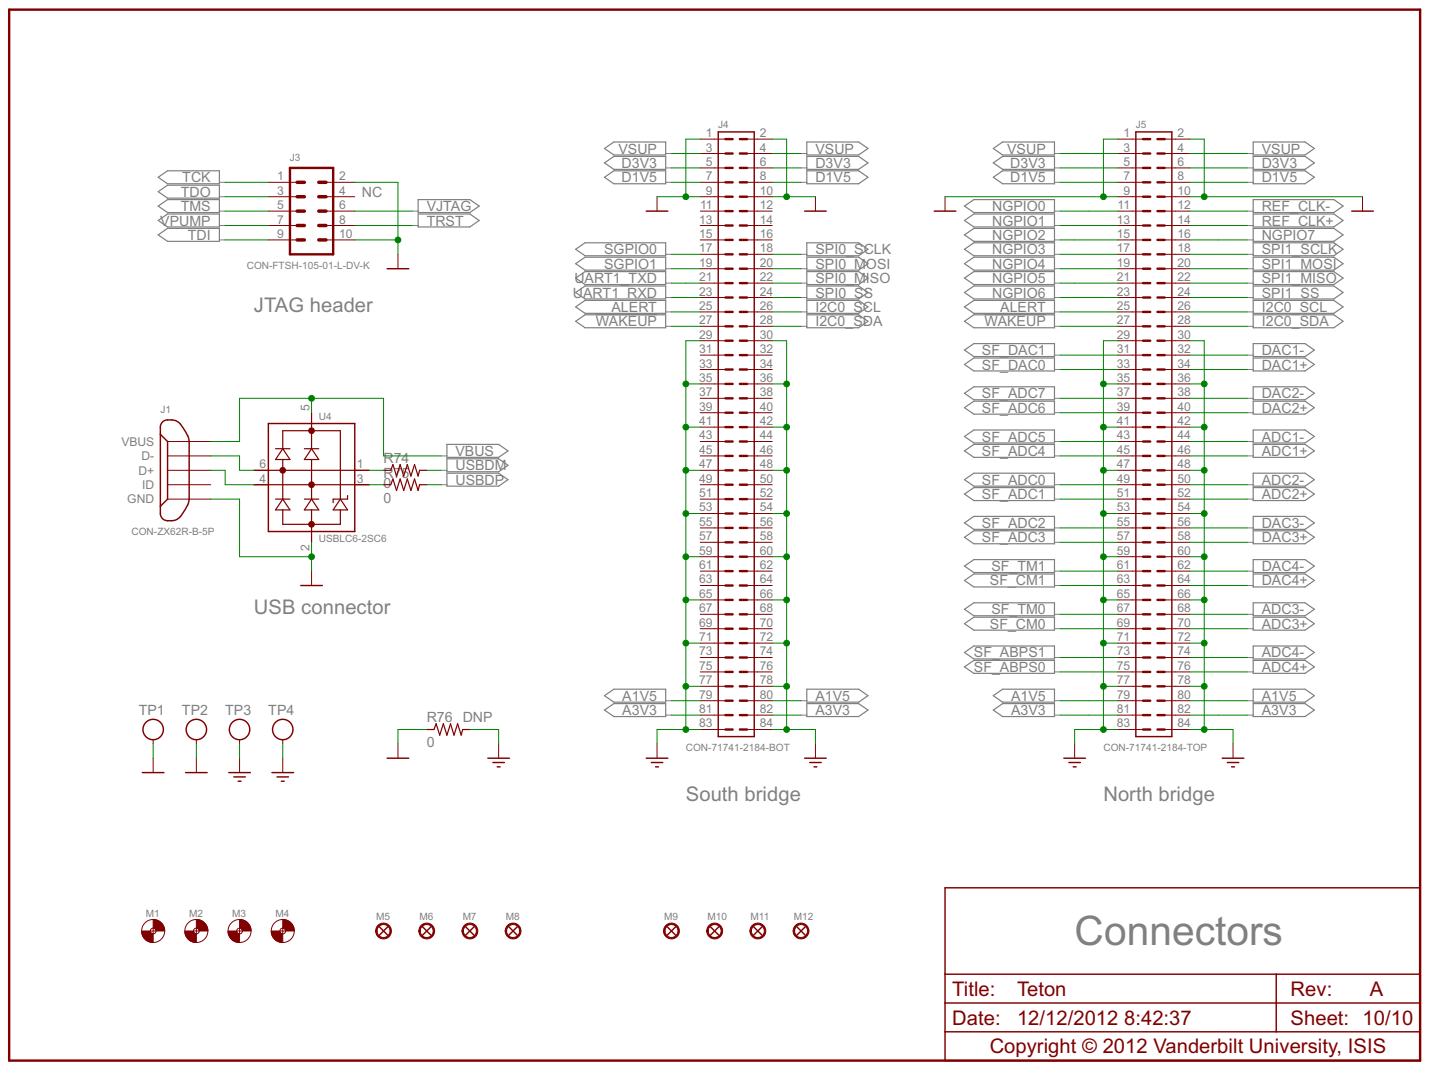
[picture p65: page 10]

Title: Teton | Rev: A
Date: 12/12/2012 8:42:37 | Sheet: 10/10
