marmote/marmote/hardware/PowerBoard_RevC/PowerBoard_RevC_Sch.pdf

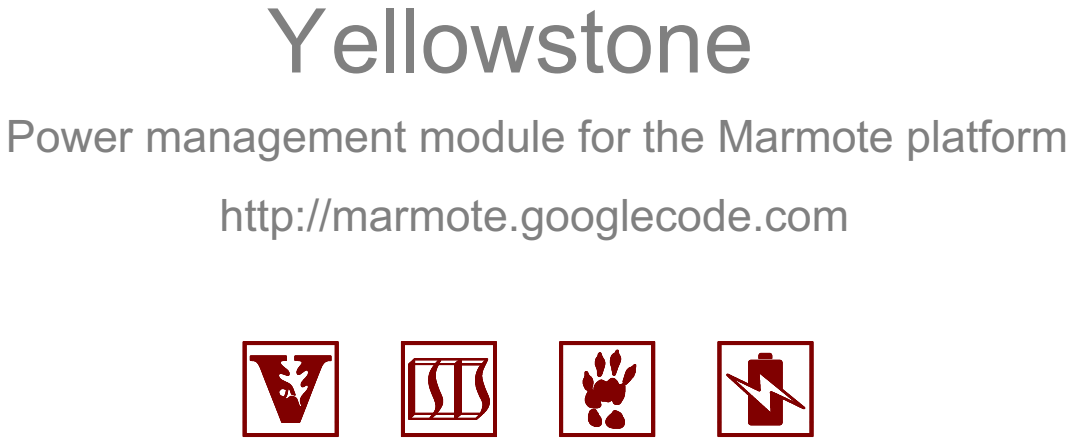
[picture p66: page 1]

Power management module for the Marmote platform

http://marmote.googlecode.com

Pages: #1 - #2 - #3 - #4 - #5 - Cover Page Power Supply Current Monitor Misc Connector | Designed by: Sandor Szilvasi sandor.szilvasi@vanderbilt.edu | Cover Page

Reviewed by: Benjamin Babjak benjamin.babjak@vanderbilt.edu | Title: Yellowstone | Rev: B
Date: 3/21/2012 11:34:13 | Sheet: 1/5

Copyright © 2012 Vanderbilt University, ISIS

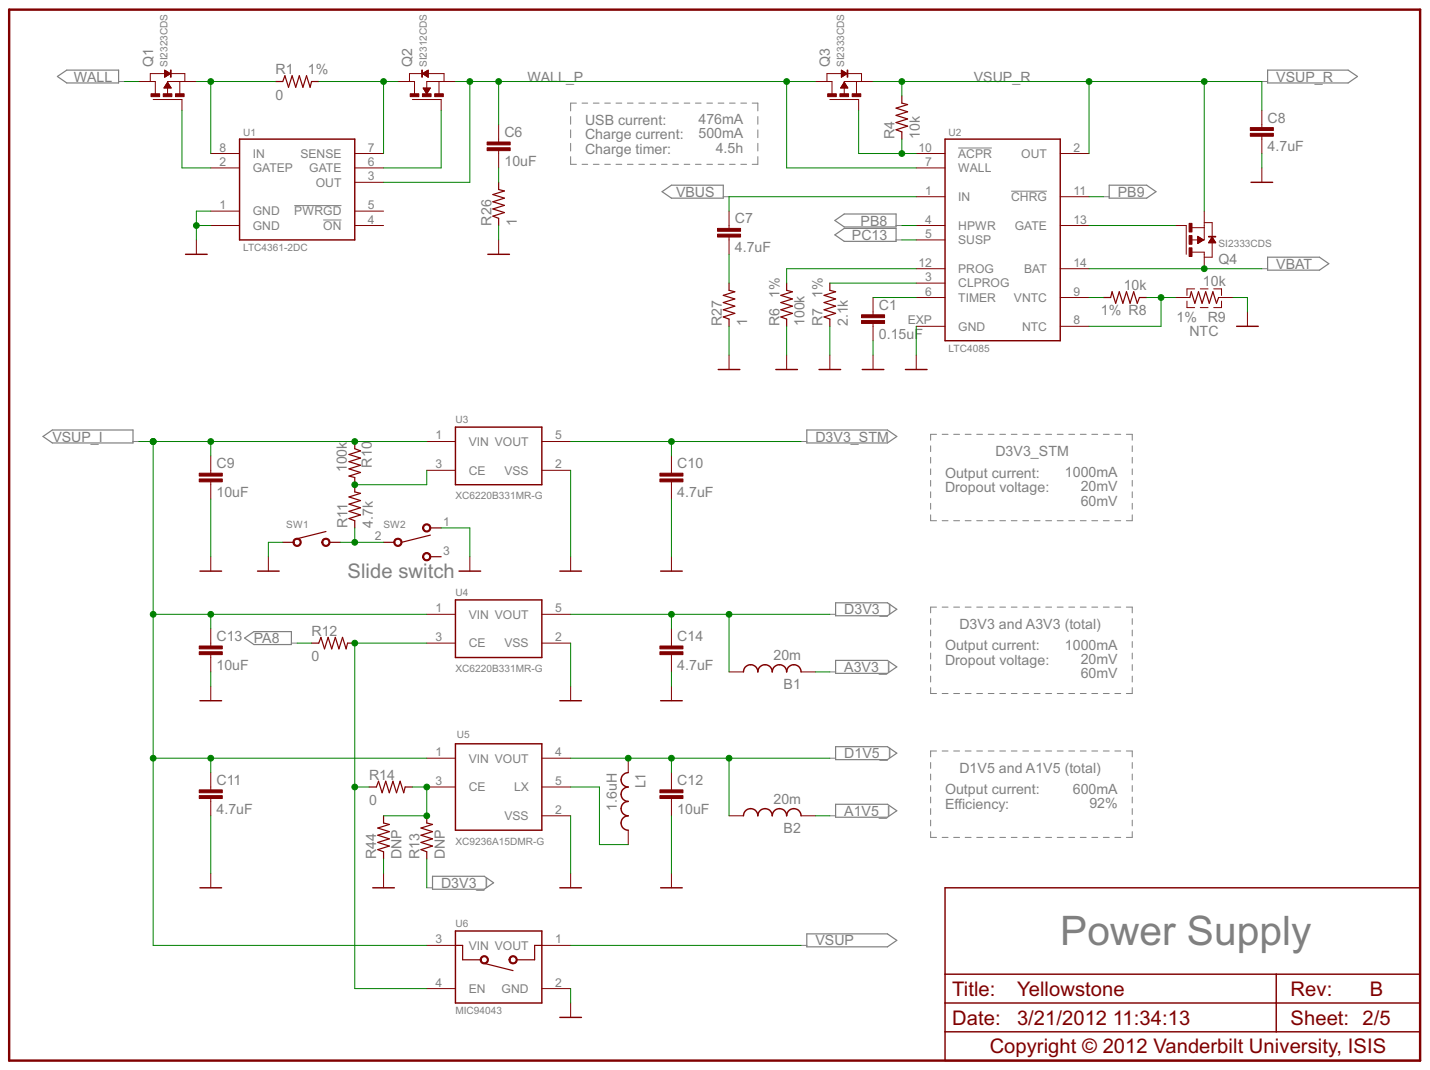
[picture p67: page 2]

USB current: Charge current: 476mA

Output current: Dropout voltage: 1000mA

D3V3 and A3V3 (total)

Title: Yellowstone | Rev: B
Date: 3/21/2012 11:34:13 | Sheet: 2/5

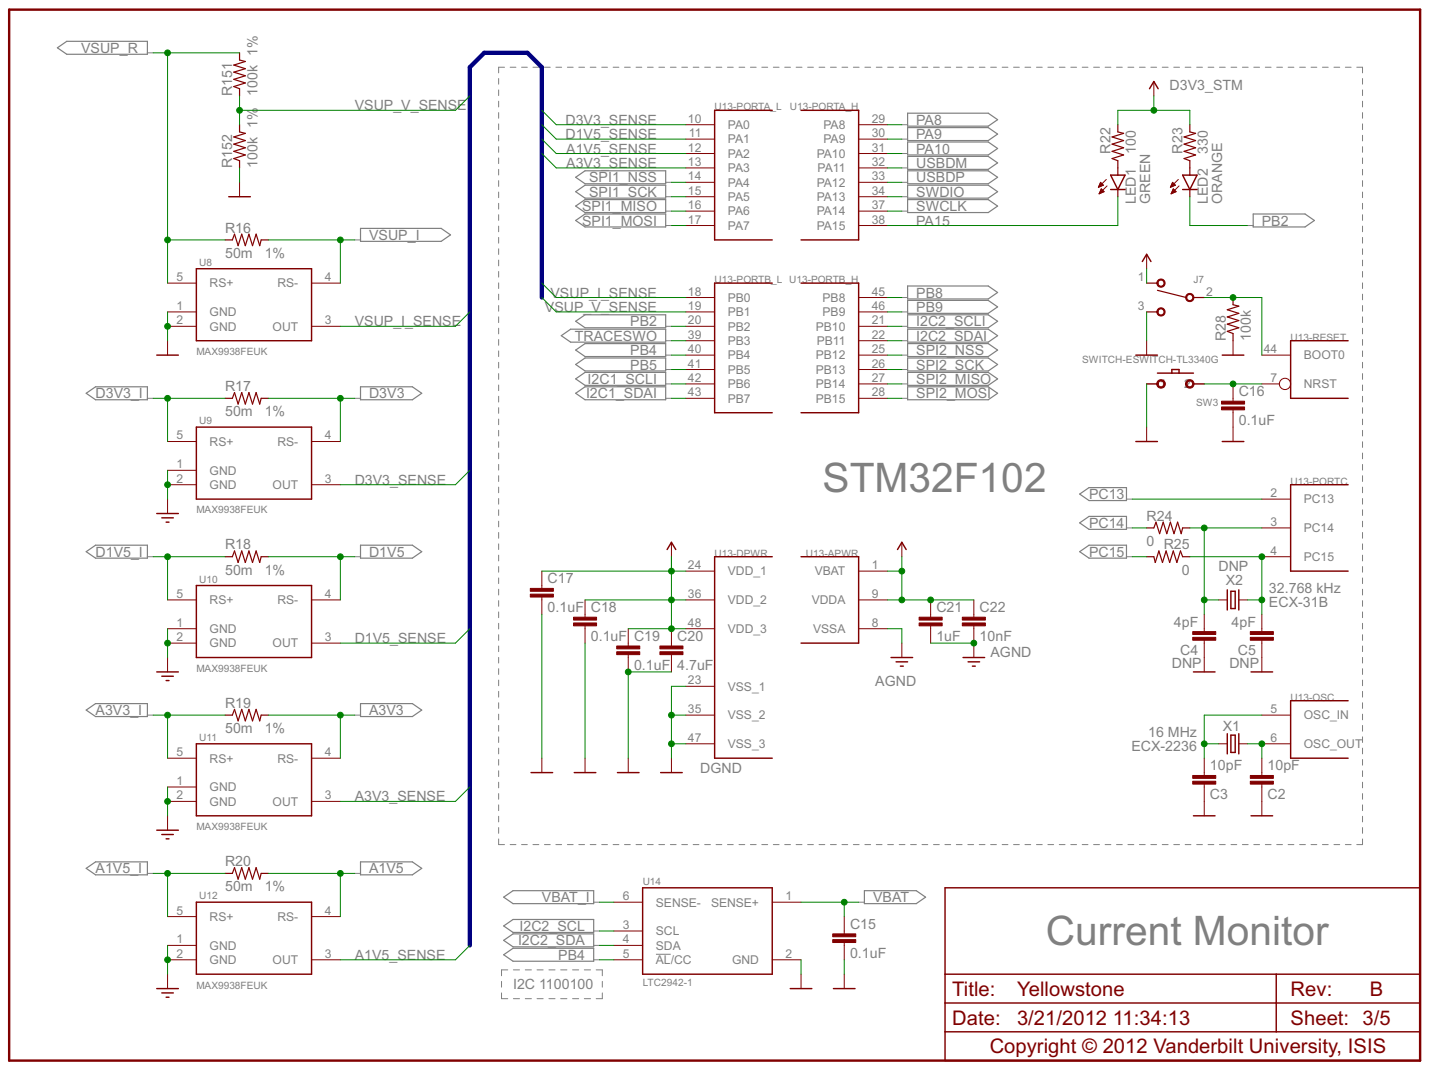
[picture p68: page 3]

Title: Yellowstone | Rev: B
Date: 3/21/2012 11:34:13 | Sheet: 3/5

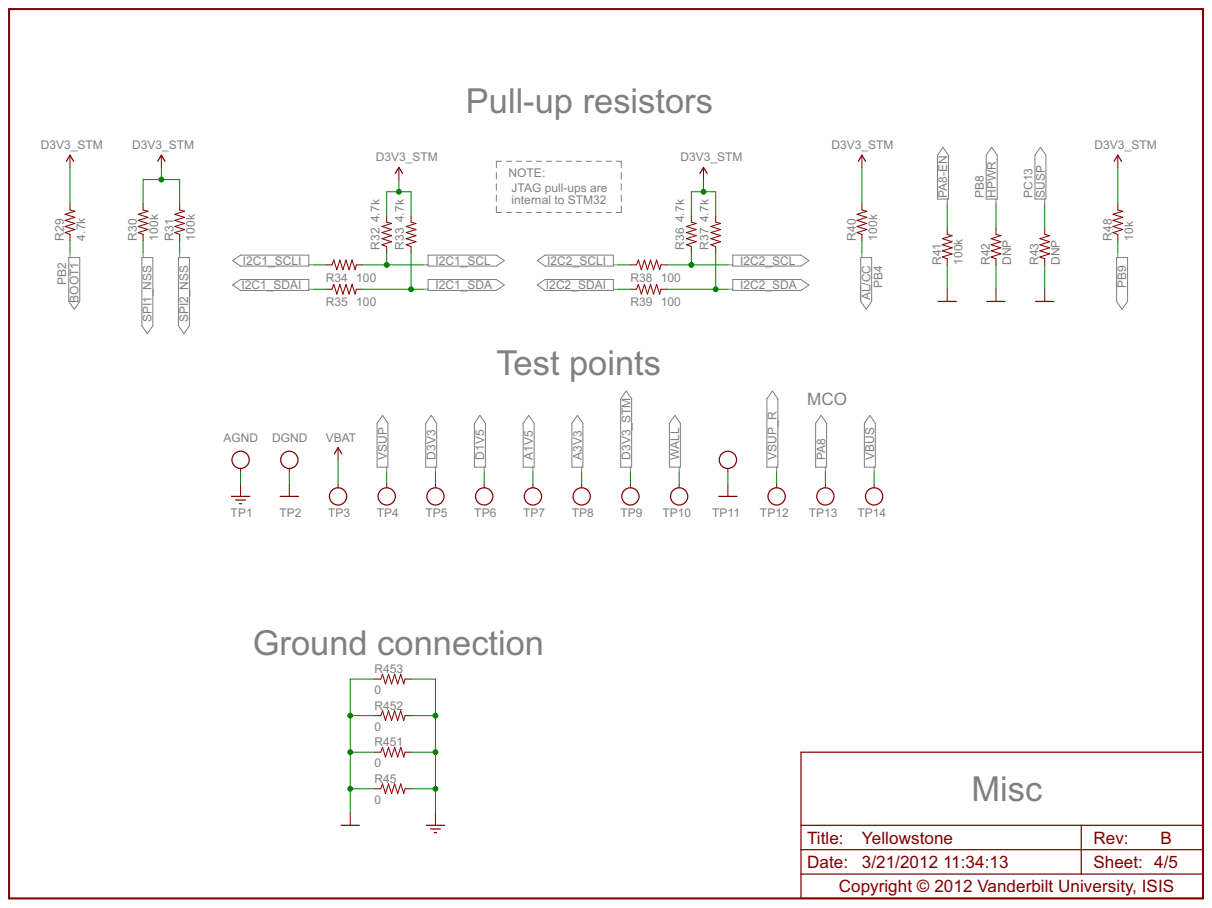
[picture p69: page 4]

NOTE:
JTAG pull-ups are
internal to STM32

Title: Yellowstone | Rev: B
Date: 3/21/2012 11:34:13 | Sheet: 4/5

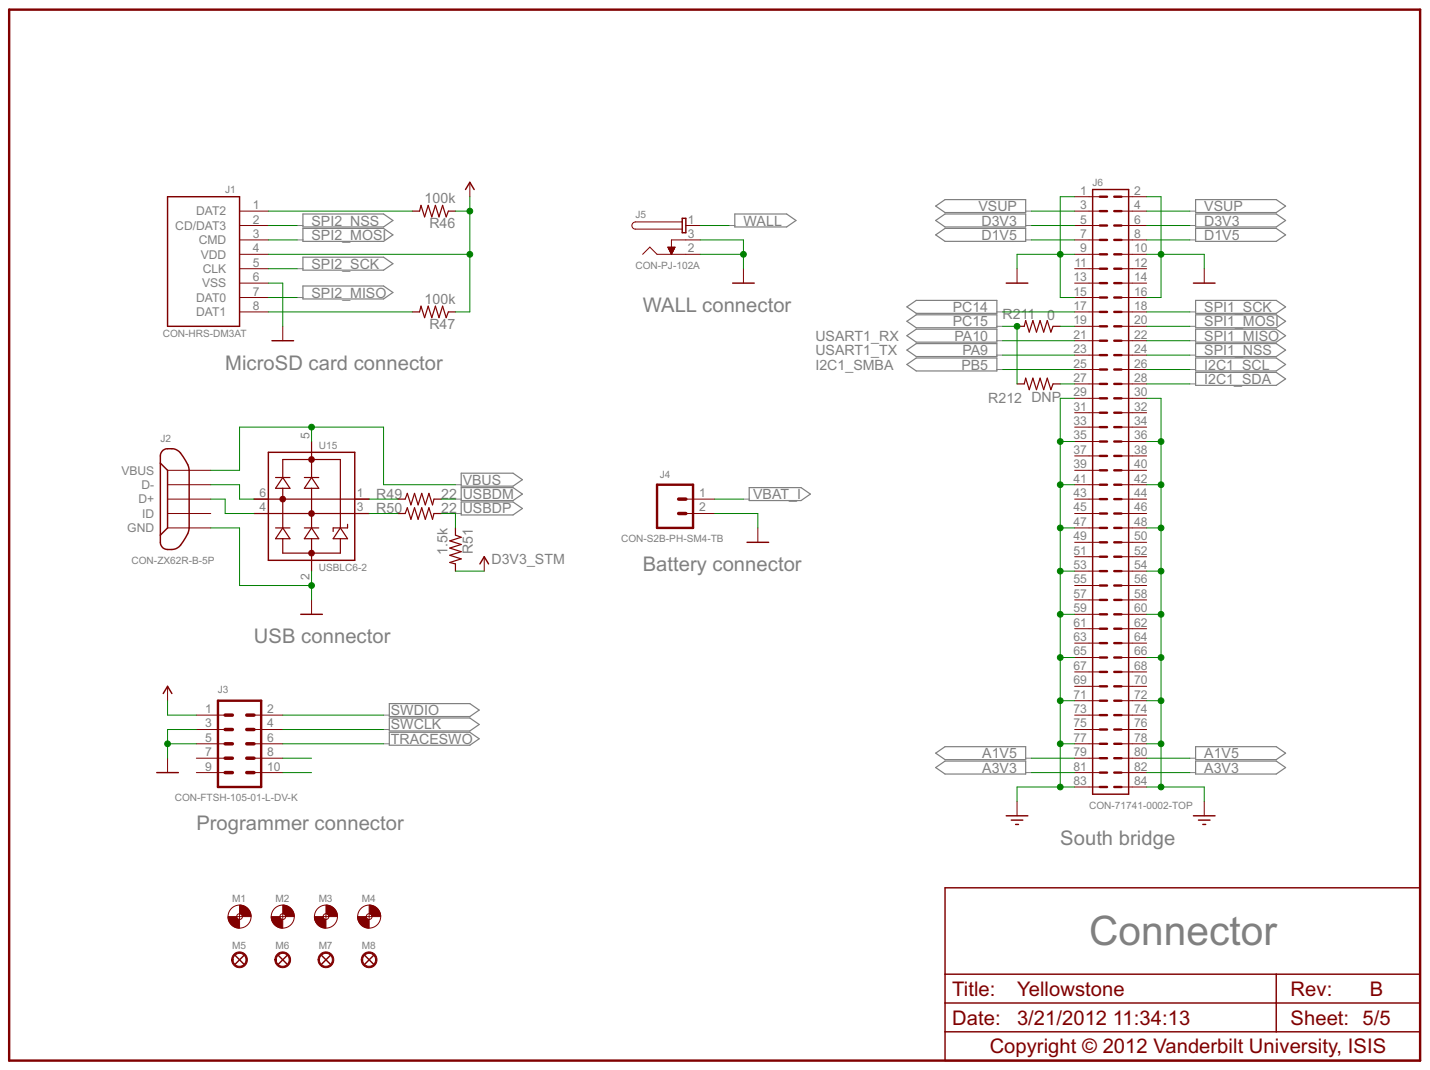
[picture p70: page 5]

Title: Yellowstone | Rev: B
Date: 3/21/2012 11:34:13 | Sheet: 5/5
