marmote/marmote/hardware/BeaverBoard_RevA/BeaverBoard_RevA_Sch.pdf

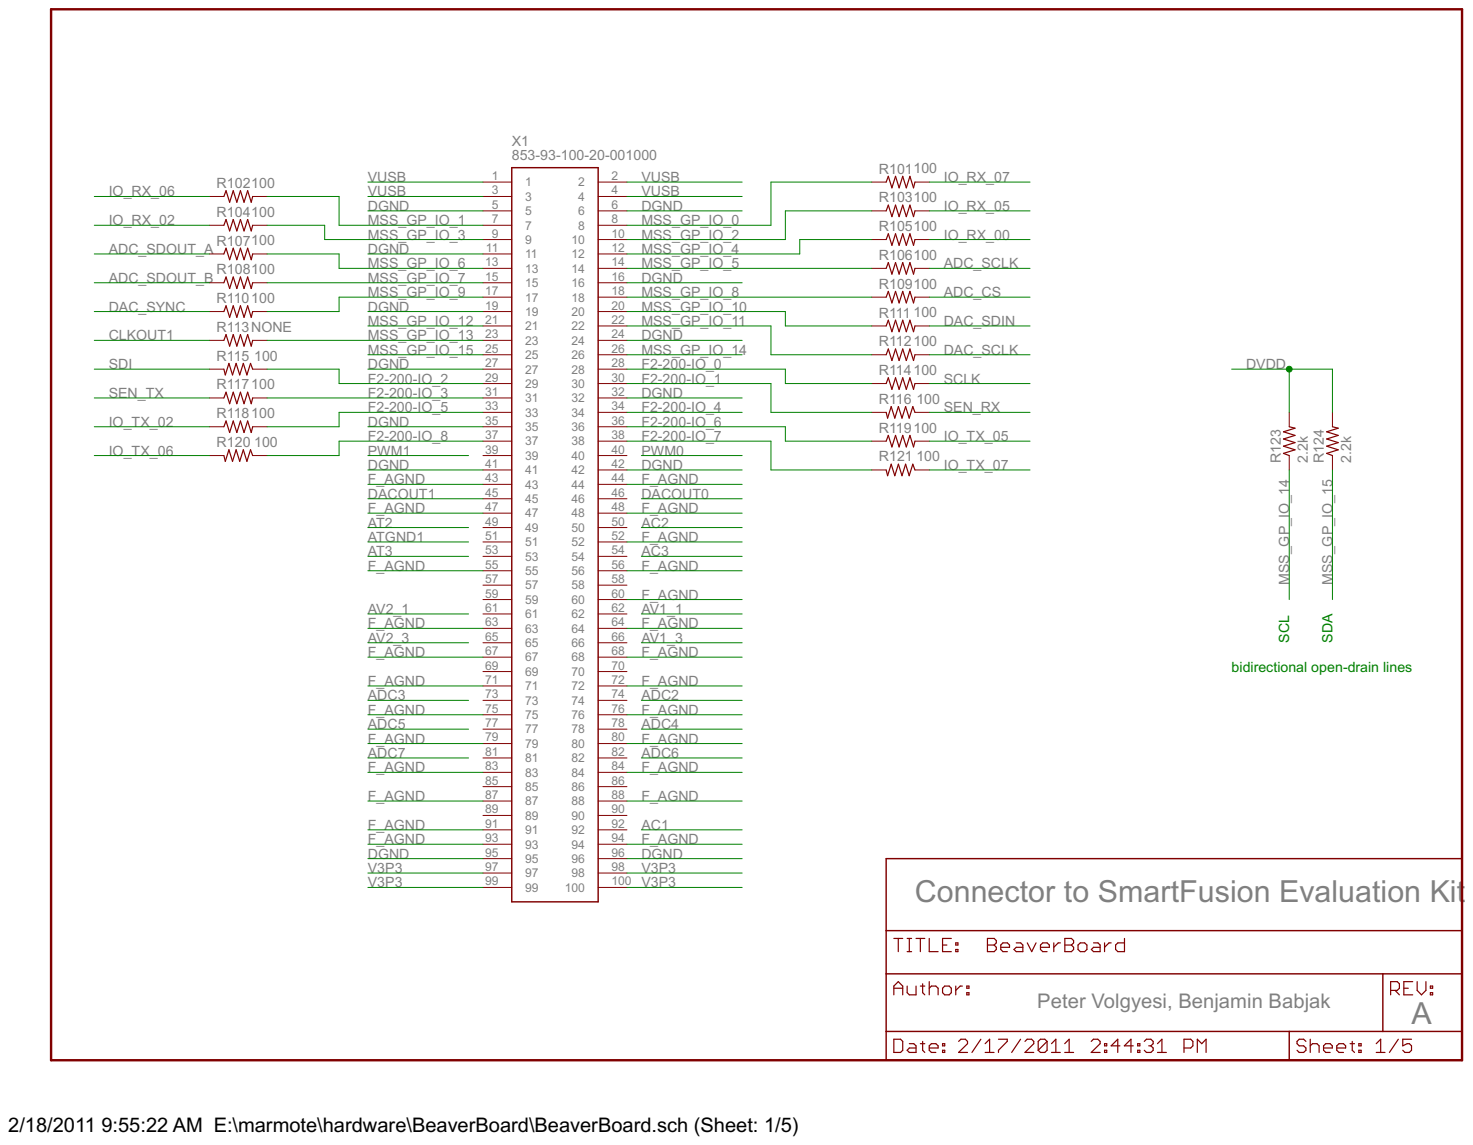
[picture p71: page 1]

bidirectional open-drain lines

Connector to SmartFusion Evaluation Kit

Peter Volgyesi, Benjamin Babjak

2/18/2011 9:55:22 AM E:\marmote\hardware\BeaverBoard\BeaverBoard.sch (Sheet: 1/5)

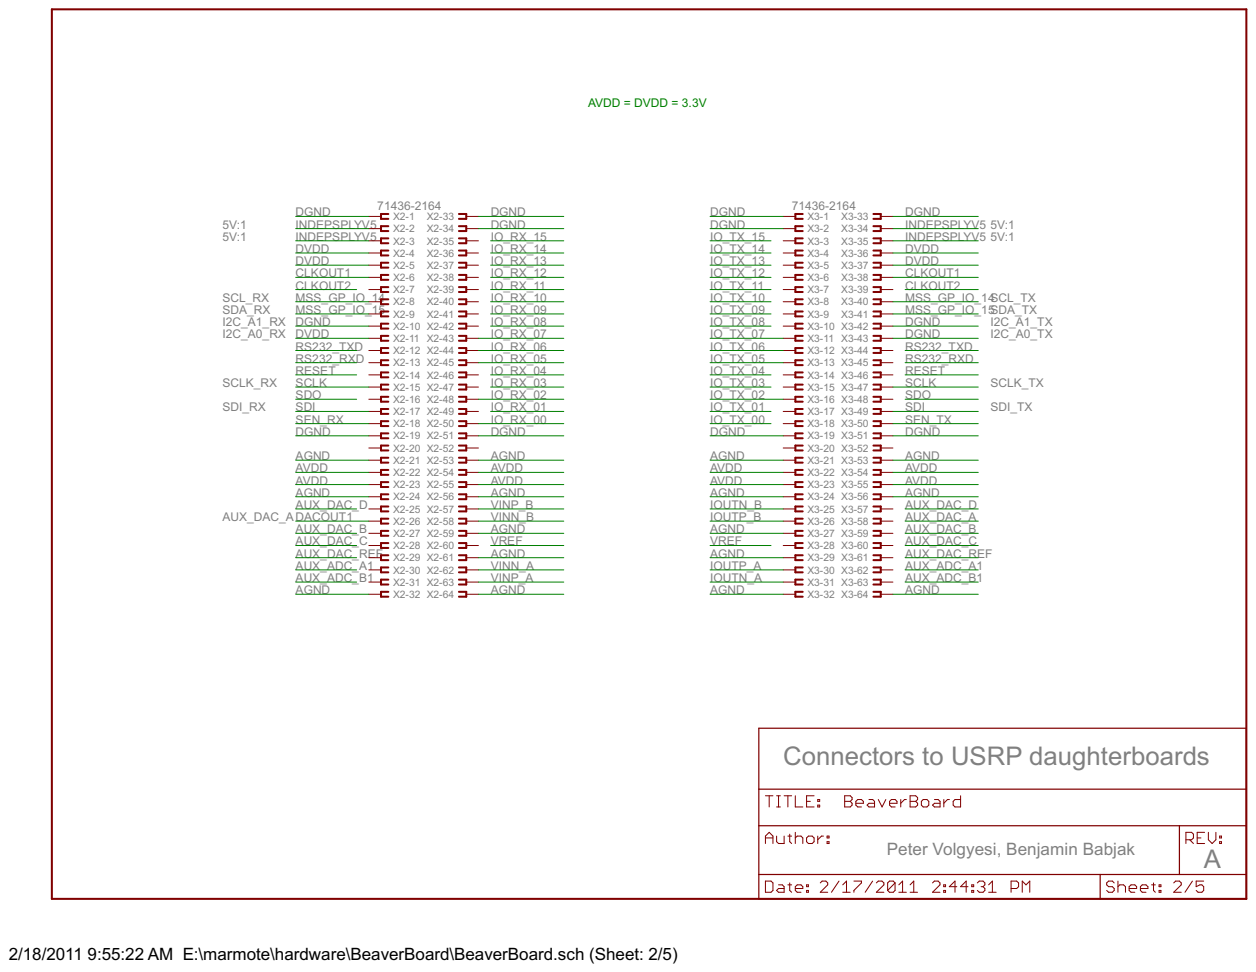
[picture p72: page 2]

Connectors to USRP daughterboards

Peter Volgyesi, Benjamin Babjak

2/18/2011 9:55:22 AM E:\marmote\hardware\BeaverBoard\BeaverBoard.sch (Sheet: 2/5)

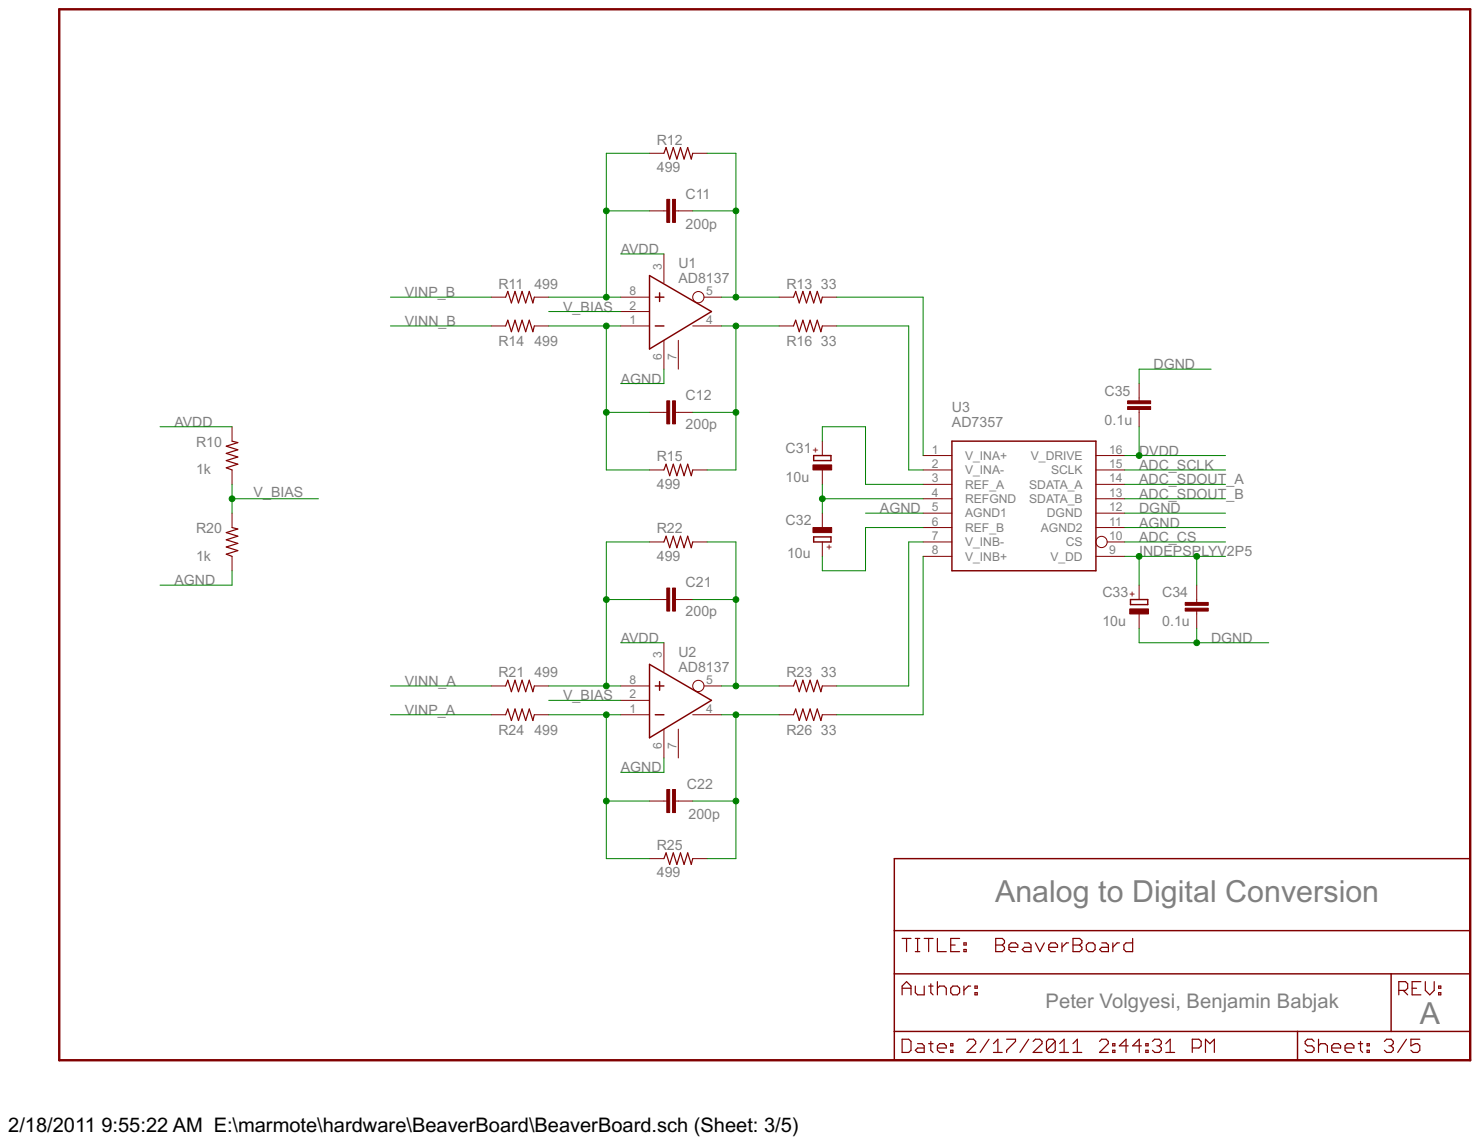
[picture p73: page 3]

Analog to Digital Conversion

Peter Volgyesi, Benjamin Babjak

2/18/2011 9:55:22 AM E:\marmote\hardware\BeaverBoard\BeaverBoard.sch (Sheet: 3/5)

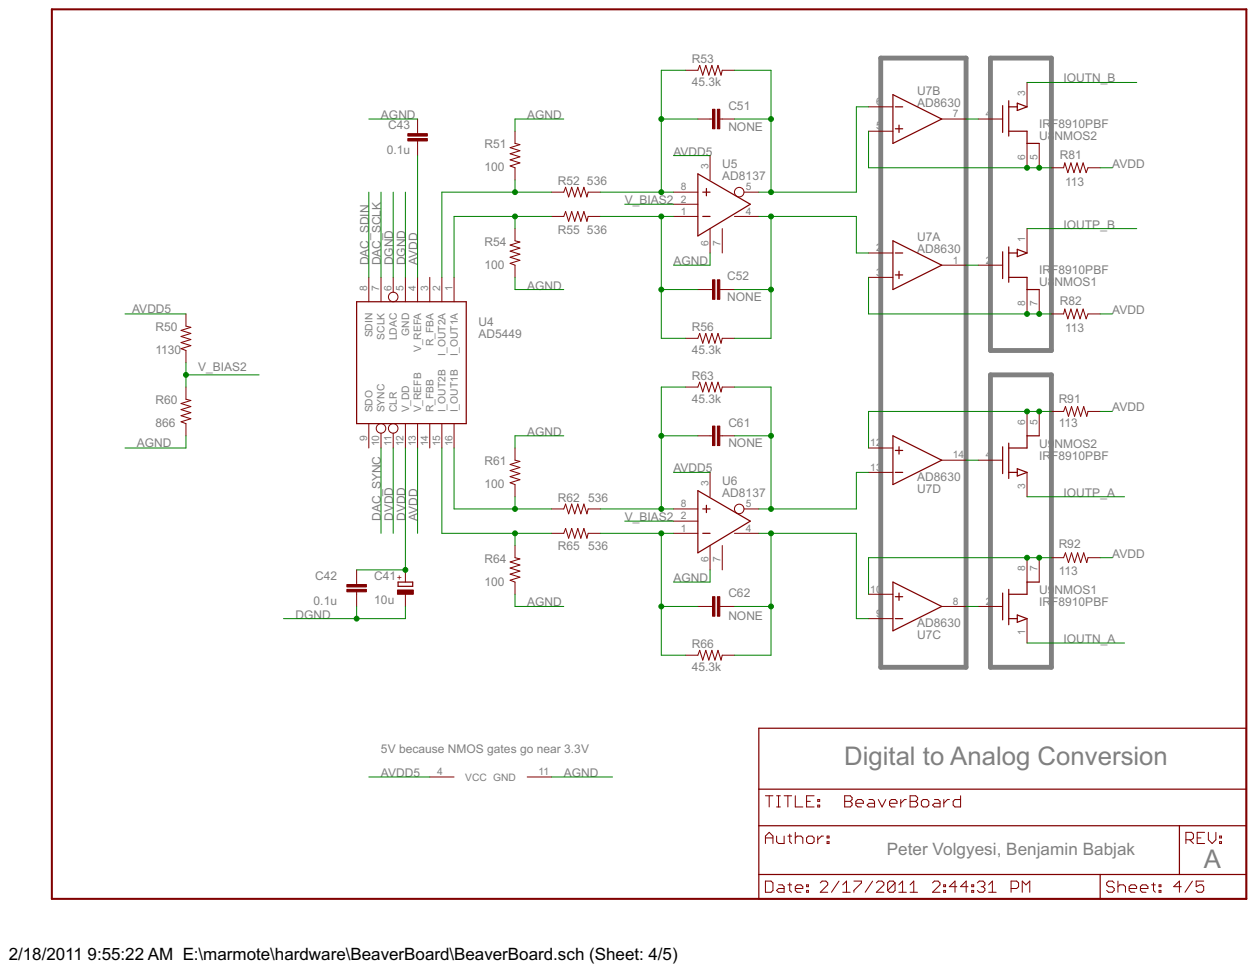
[picture p74: page 4]

5V because NMOS gates go near 3.3V

Digital to Analog Conversion

Peter Volgyesi, Benjamin Babjak

2/18/2011 9:55:22 AM E:\marmote\hardware\BeaverBoard\BeaverBoard.sch (Sheet: 4/5)

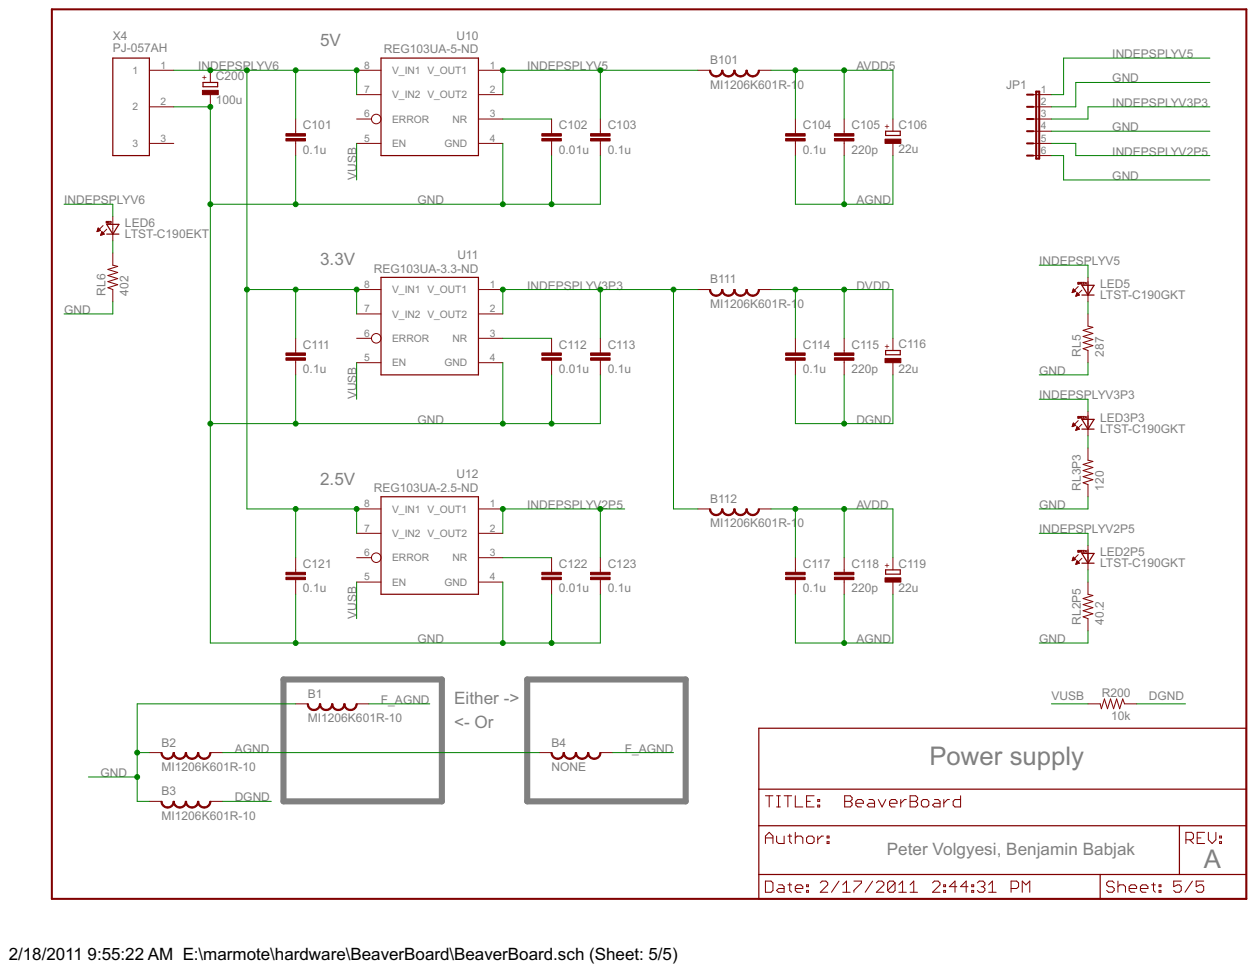
[picture p75: page 5]

Peter Volgyesi, Benjamin Babjak

2/18/2011 9:55:22 AM E:\marmote\hardware\BeaverBoard\BeaverBoard.sch (Sheet: 5/5)
