marmote/marmote/firmware/BeaverBoard/DDC_test/BlockDiagram2.one_complexchannel.pdf

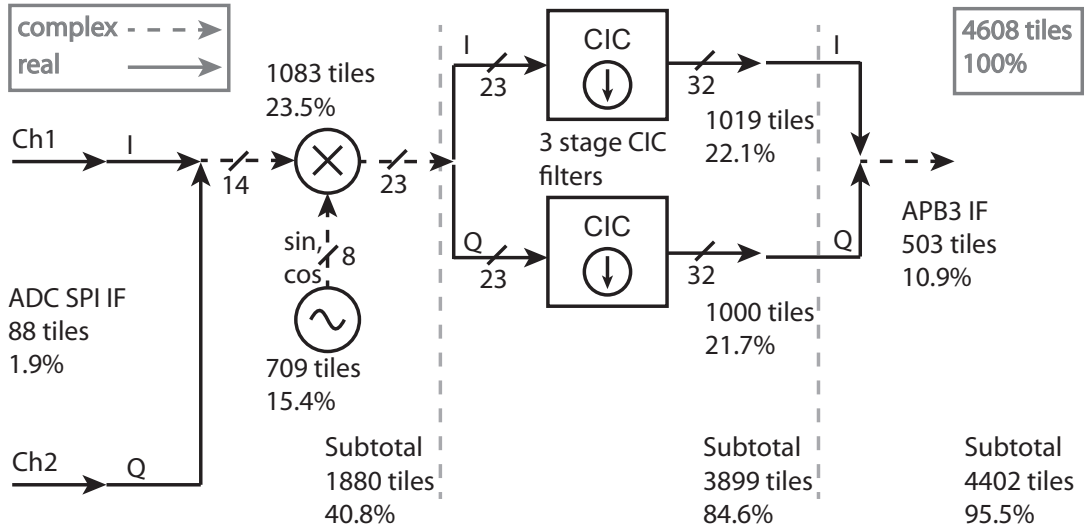
[picture p76: page 1]
CIC; sin, cos; complex real; 709 tiles; 1083 tiles 23.5%; Subtotal 4402 tiles 95.5%; Subtotal 1880 tiles 40.8%; 3 stage CIC lters; 1019 tiles 22.1%; 1000 tiles 21.7%; Subtotal 3899 tiles 84.6%; APB3 IF 503 tiles 10.9%; 4608 tiles 100%

ADC SPI IF
88 tiles
