marmote/marmote/firmware/A2F-EVAL-KIT/DecimationFilters/CIC/CIC_COMB_BlockRAM.a/CIC_COMB.pdf

## Timing diagram for Comb memory access for a CIC of 6 stages

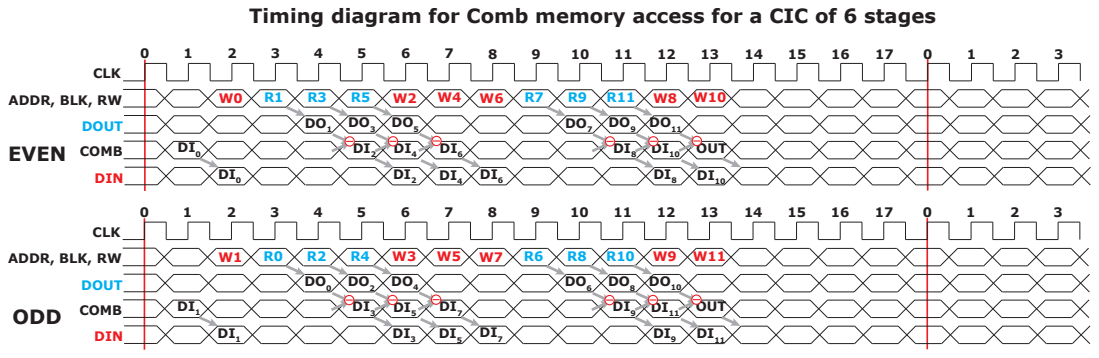
[picture p77: page 1]
