marmote/marmote/hardware/RFWBBoard/RFWBBoard_Sch.pdf

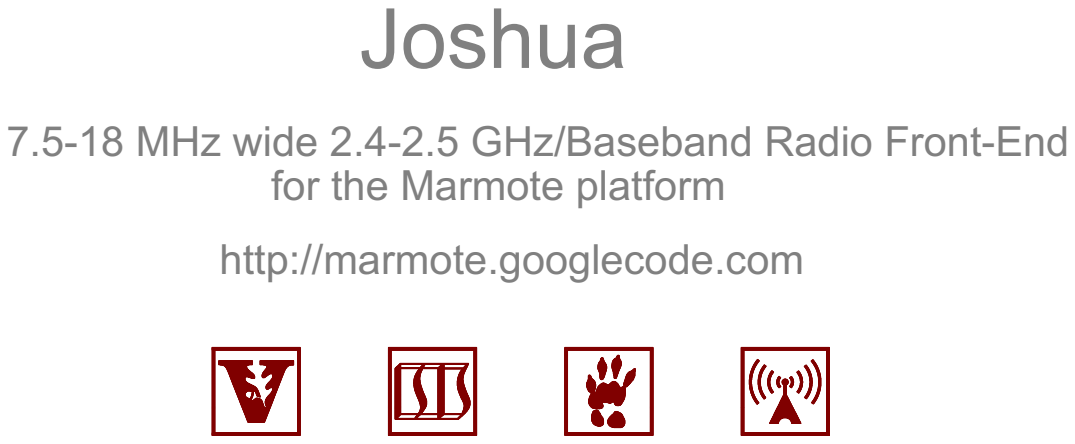
[picture p78: page 1]

7.5-18 MHz wide 2.4-2.5 GHz/Baseband Radio Front-End

for the Marmote platform
http://marmote.googlecode.com

Pages: #4 - #5 - RF signals #1 - #2 - Cover page Control/Digital signals Connector #6 - #7 - Clock #3 - Baseband signals Supply | Designed by: Benjamin Babjak benjamin.babjak@vanderbilt.edu | Cover page

Reviewed by: Peter Volgyesi peter.volgyesi@vanderbilt.edu Sandor Szilvasi sandor.szilvasi@vanderbilt.edu | Title: Joshua | Rev: B

Date: 1/11/2013 10:43:54 | Sheet: 1/7

Copyright © 2013 Vanderbilt University, ISIS

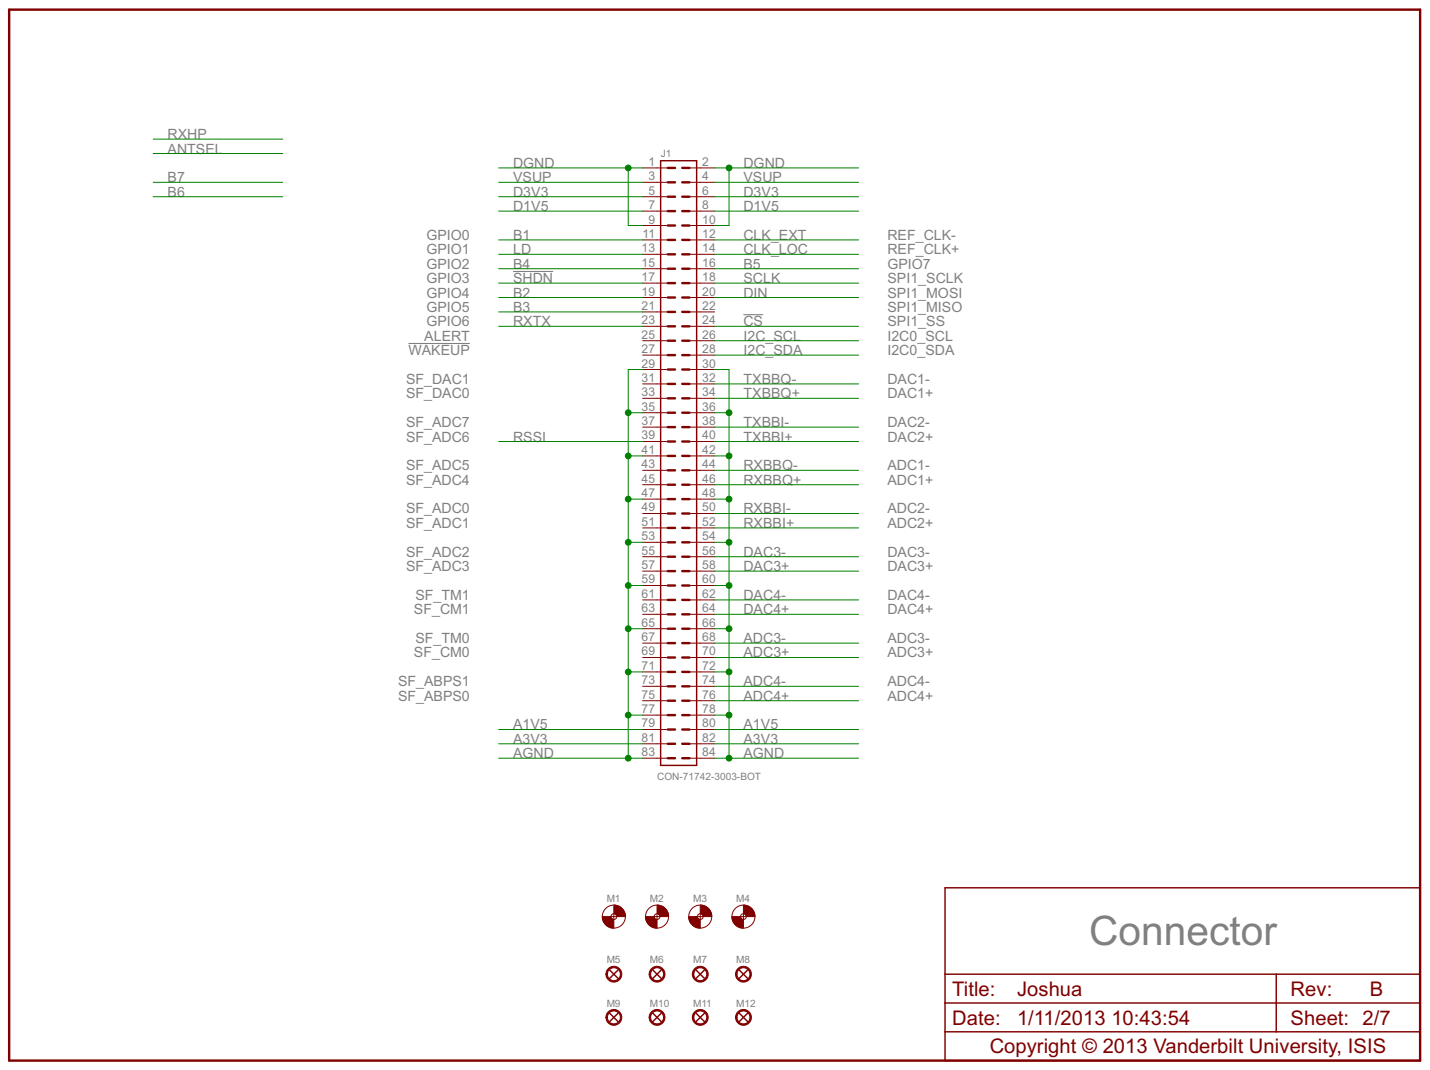
[picture p79: page 2]

TXBBQ- TXBBQ+ TXBBI- TXBBI+

RXBBQ- RXBBQ+ RXBBI- RXBBI+

Title: Joshua | Rev: B
Date: 1/11/2013 10:43:54 | Sheet: 2/7

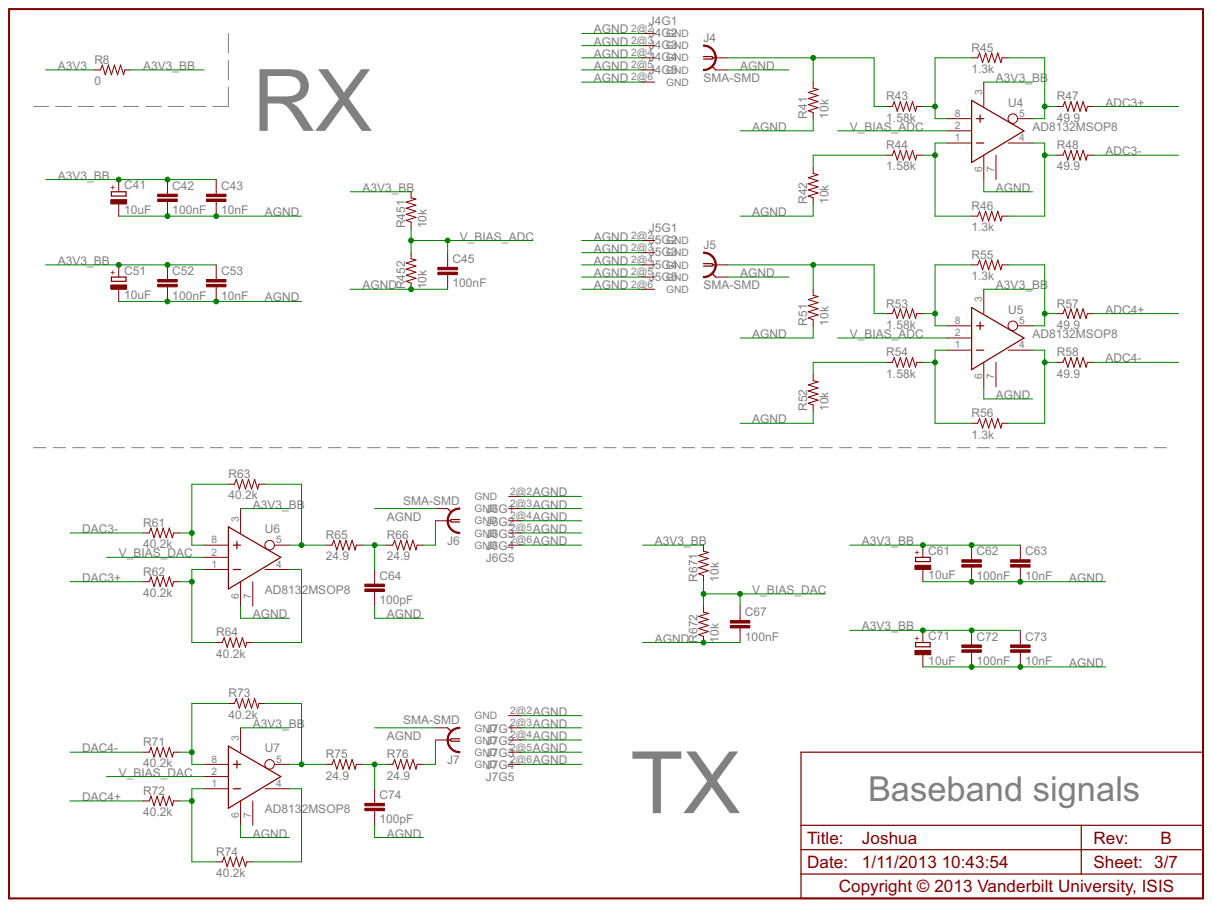
[picture p80: page 3]

Title: Joshua | Rev: B
Date: 1/11/2013 10:43:54 | Sheet: 3/7

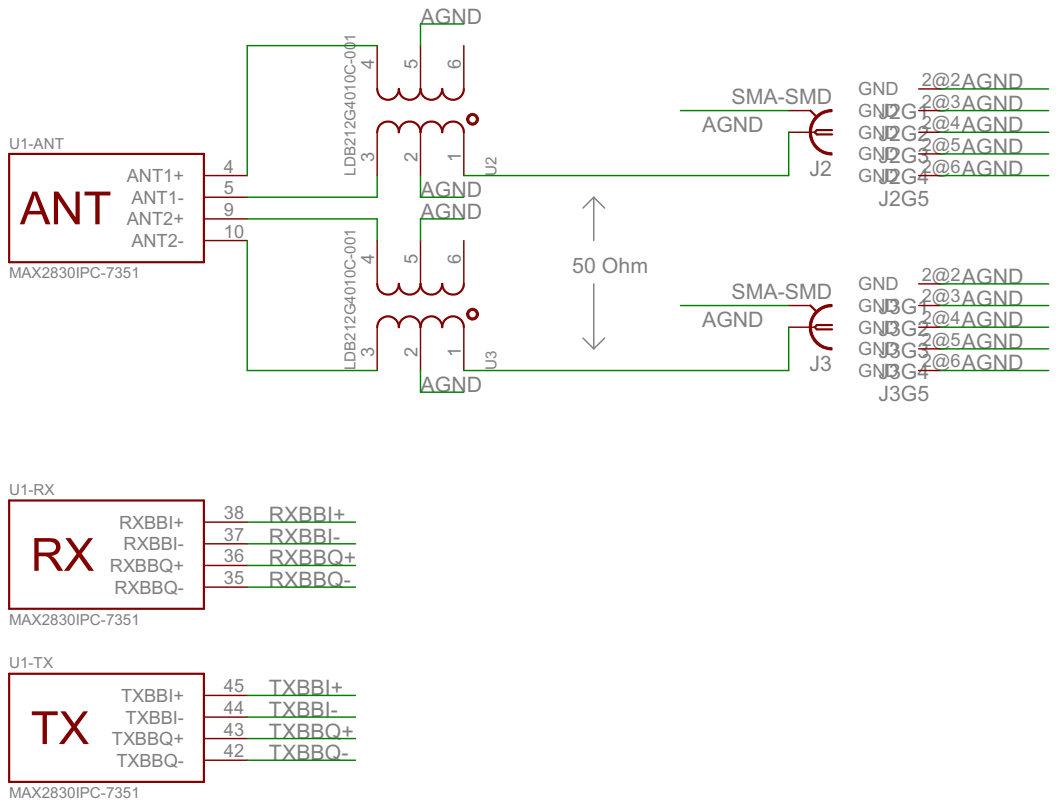
[picture p81: page 4]

RXBBI+ RXBBI- RXBBQ+ RXBBQ- TXBBI+ TXBBQ+ TXBBQ- TXBBI-

Title: Joshua | Rev: B
Date: 1/11/2013 10:43:54 | Sheet: 4/7

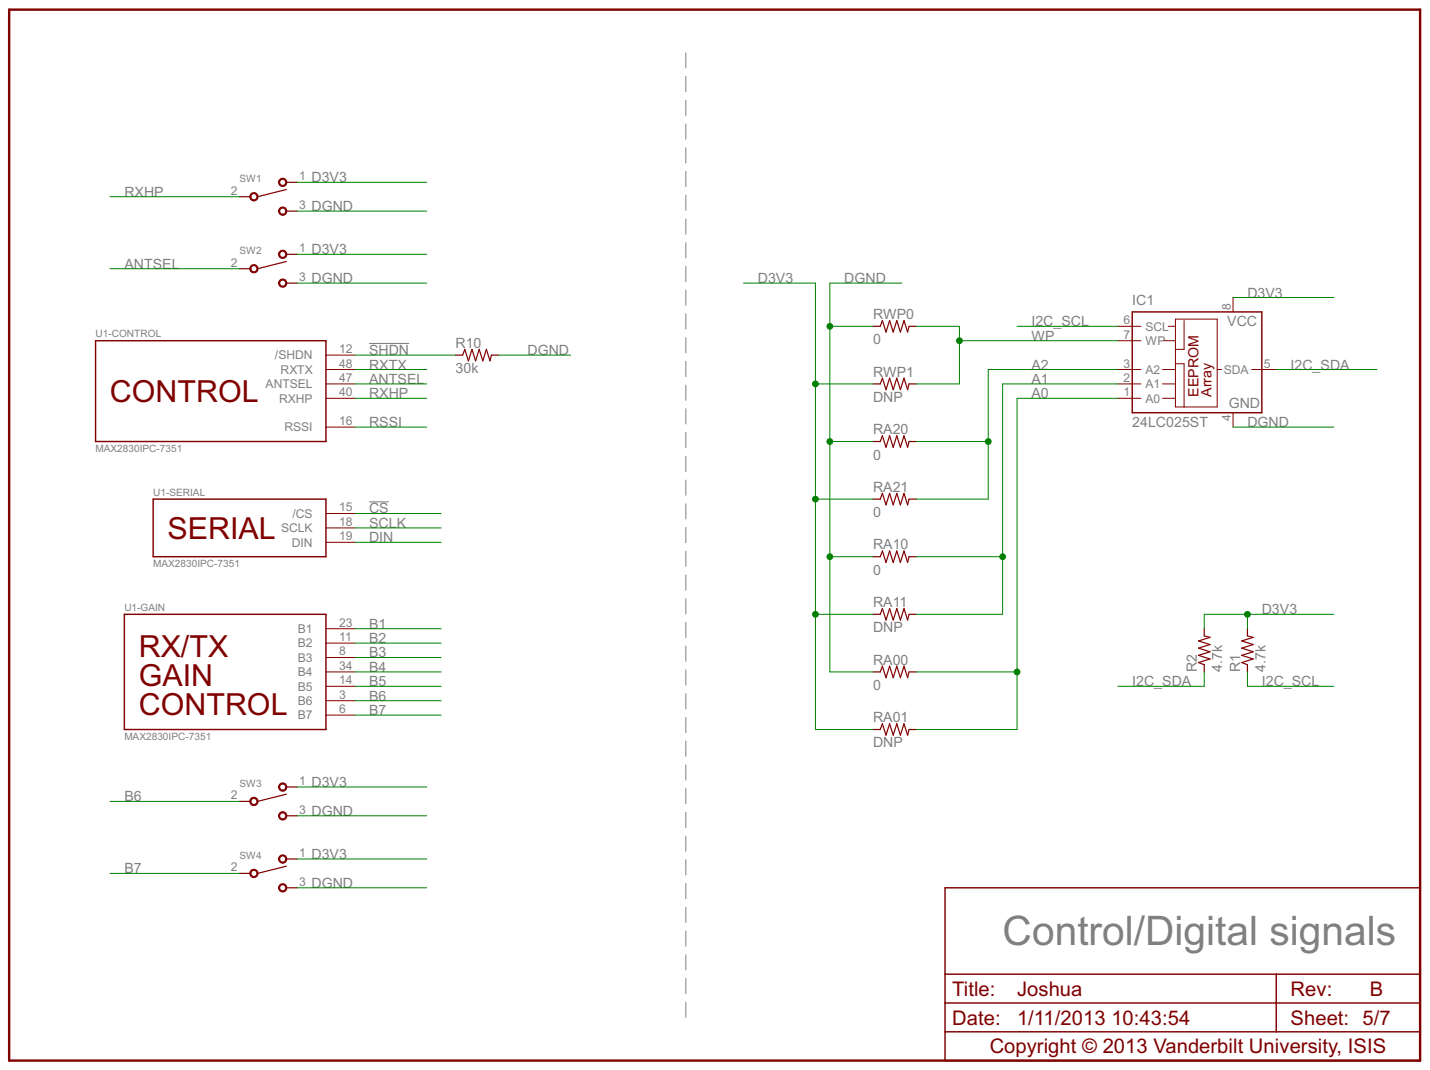
[picture p82: page 5]

Title: Joshua | Rev: B
Date: 1/11/2013 10:43:54 | Sheet: 5/7

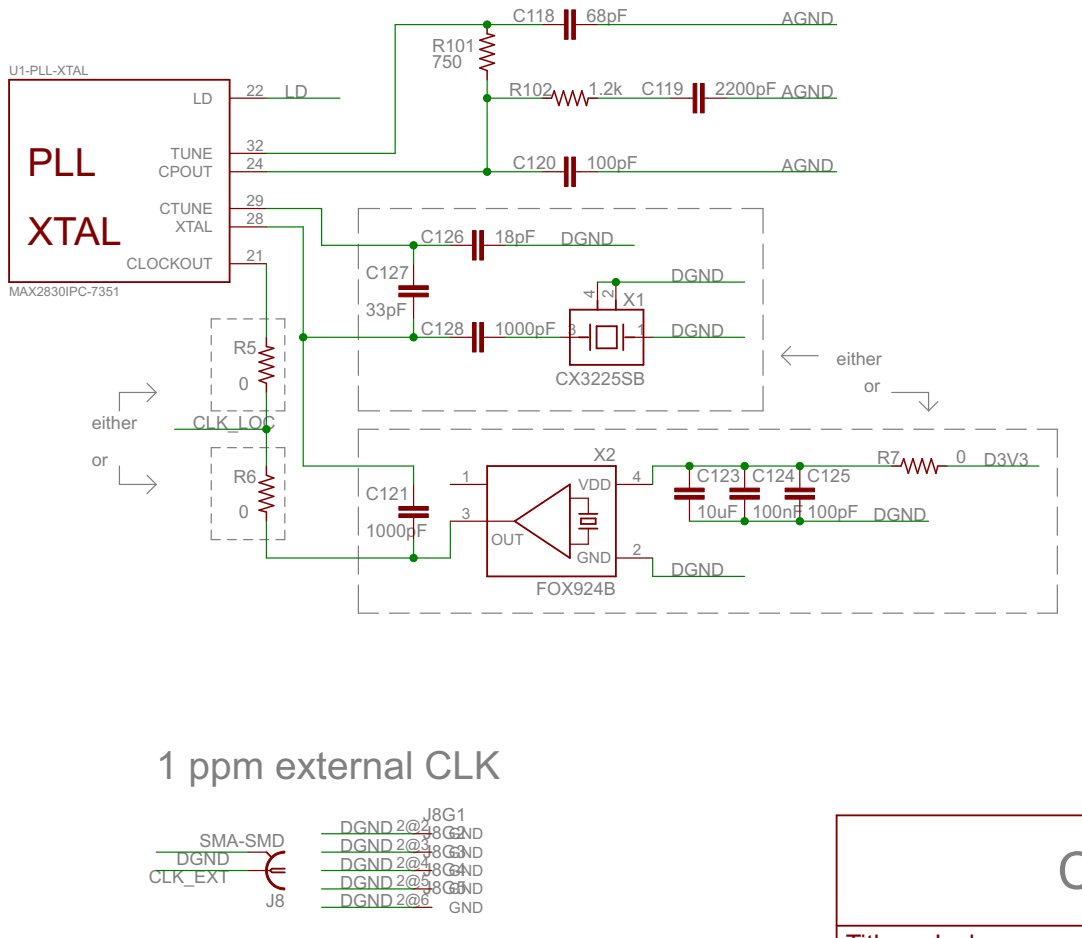
[picture p83: page 6]

Title: Joshua | Rev: B
Date: 1/11/2013 10:43:54 | Sheet: 6/7

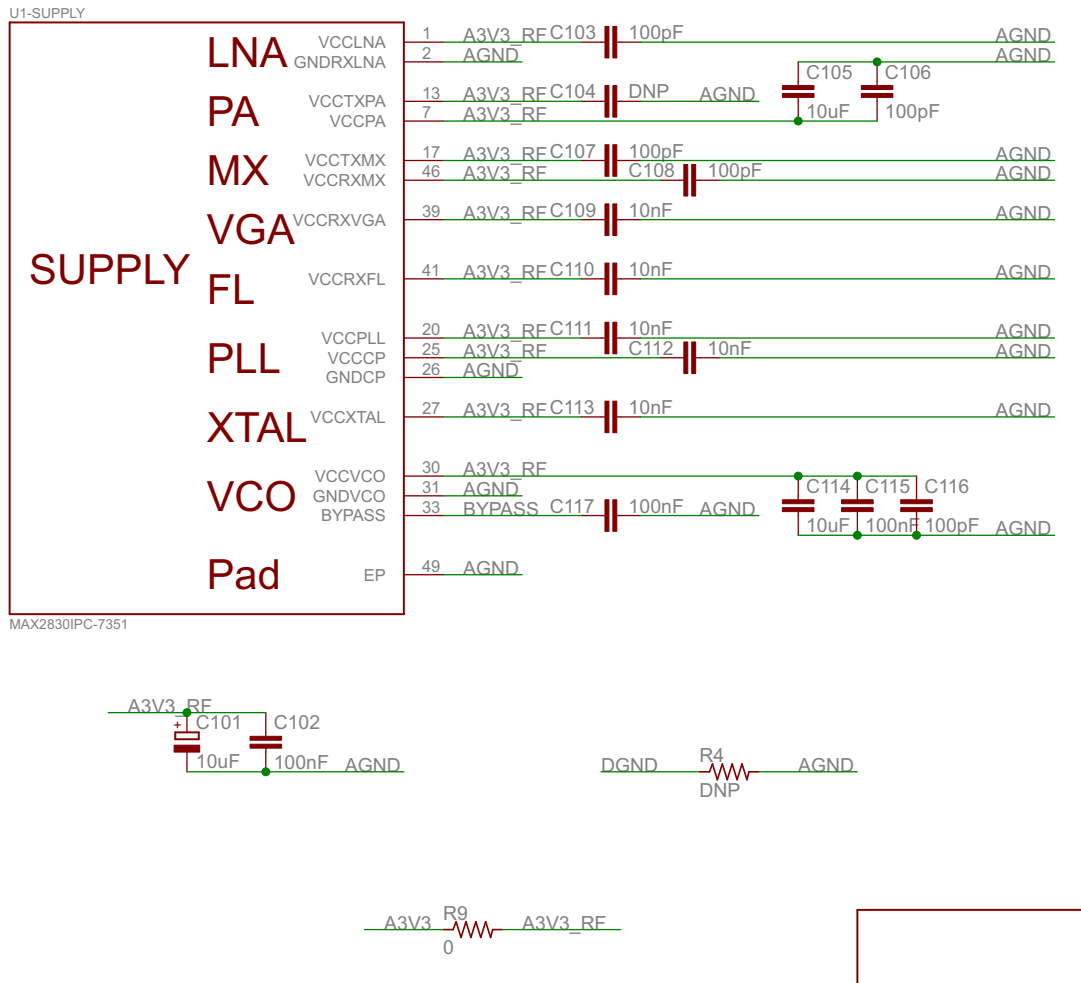
[picture p84: page 7]

Title: Joshua | Rev: B
Date: 1/11/2013 10:43:54 | Sheet: 7/7
