marmote/marmote/hardware/RFWBBoard_RevB/RFWBBoard_RevB_Asy.pdf

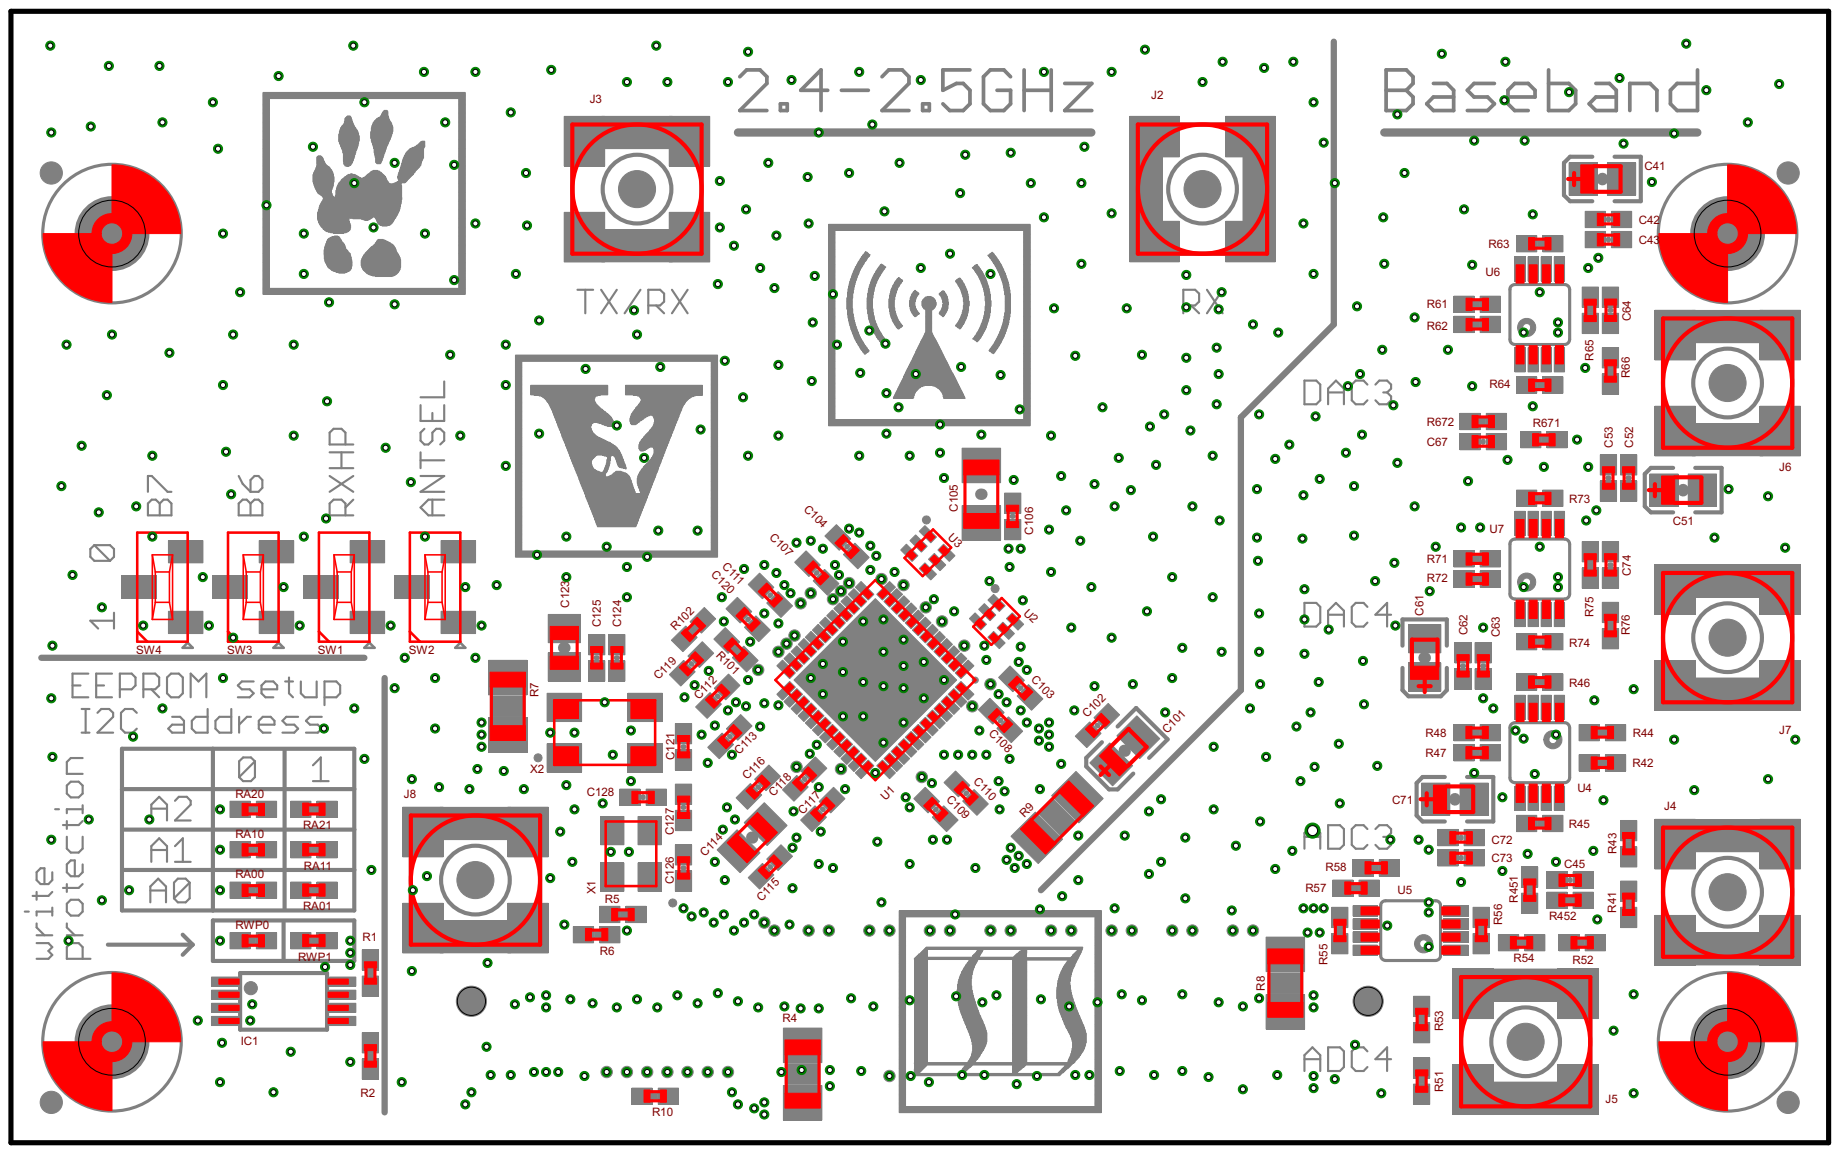
[picture p85: page 1]

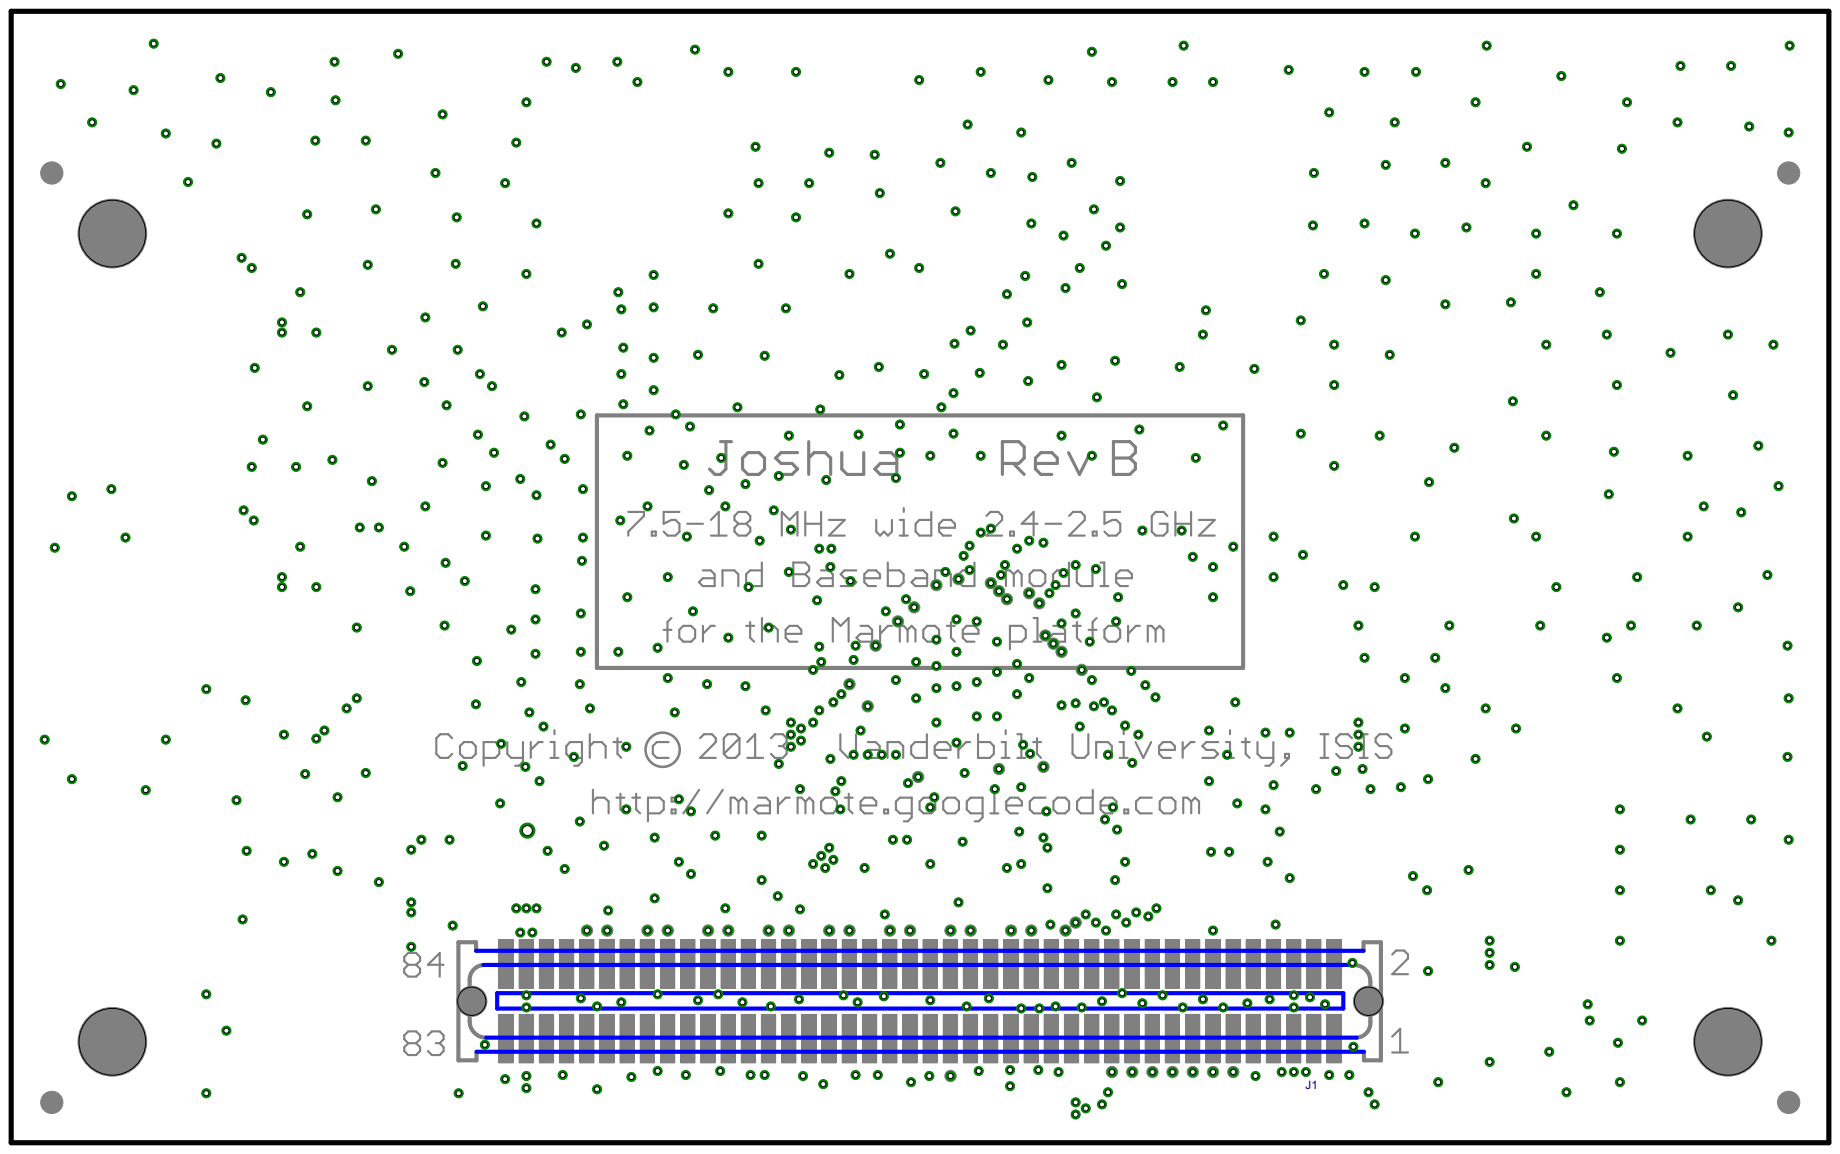
[picture p86: page 2]
