marmote/marmote/hardware/MainBoard_RevB/MainBoard_RevB_Asy.pdf

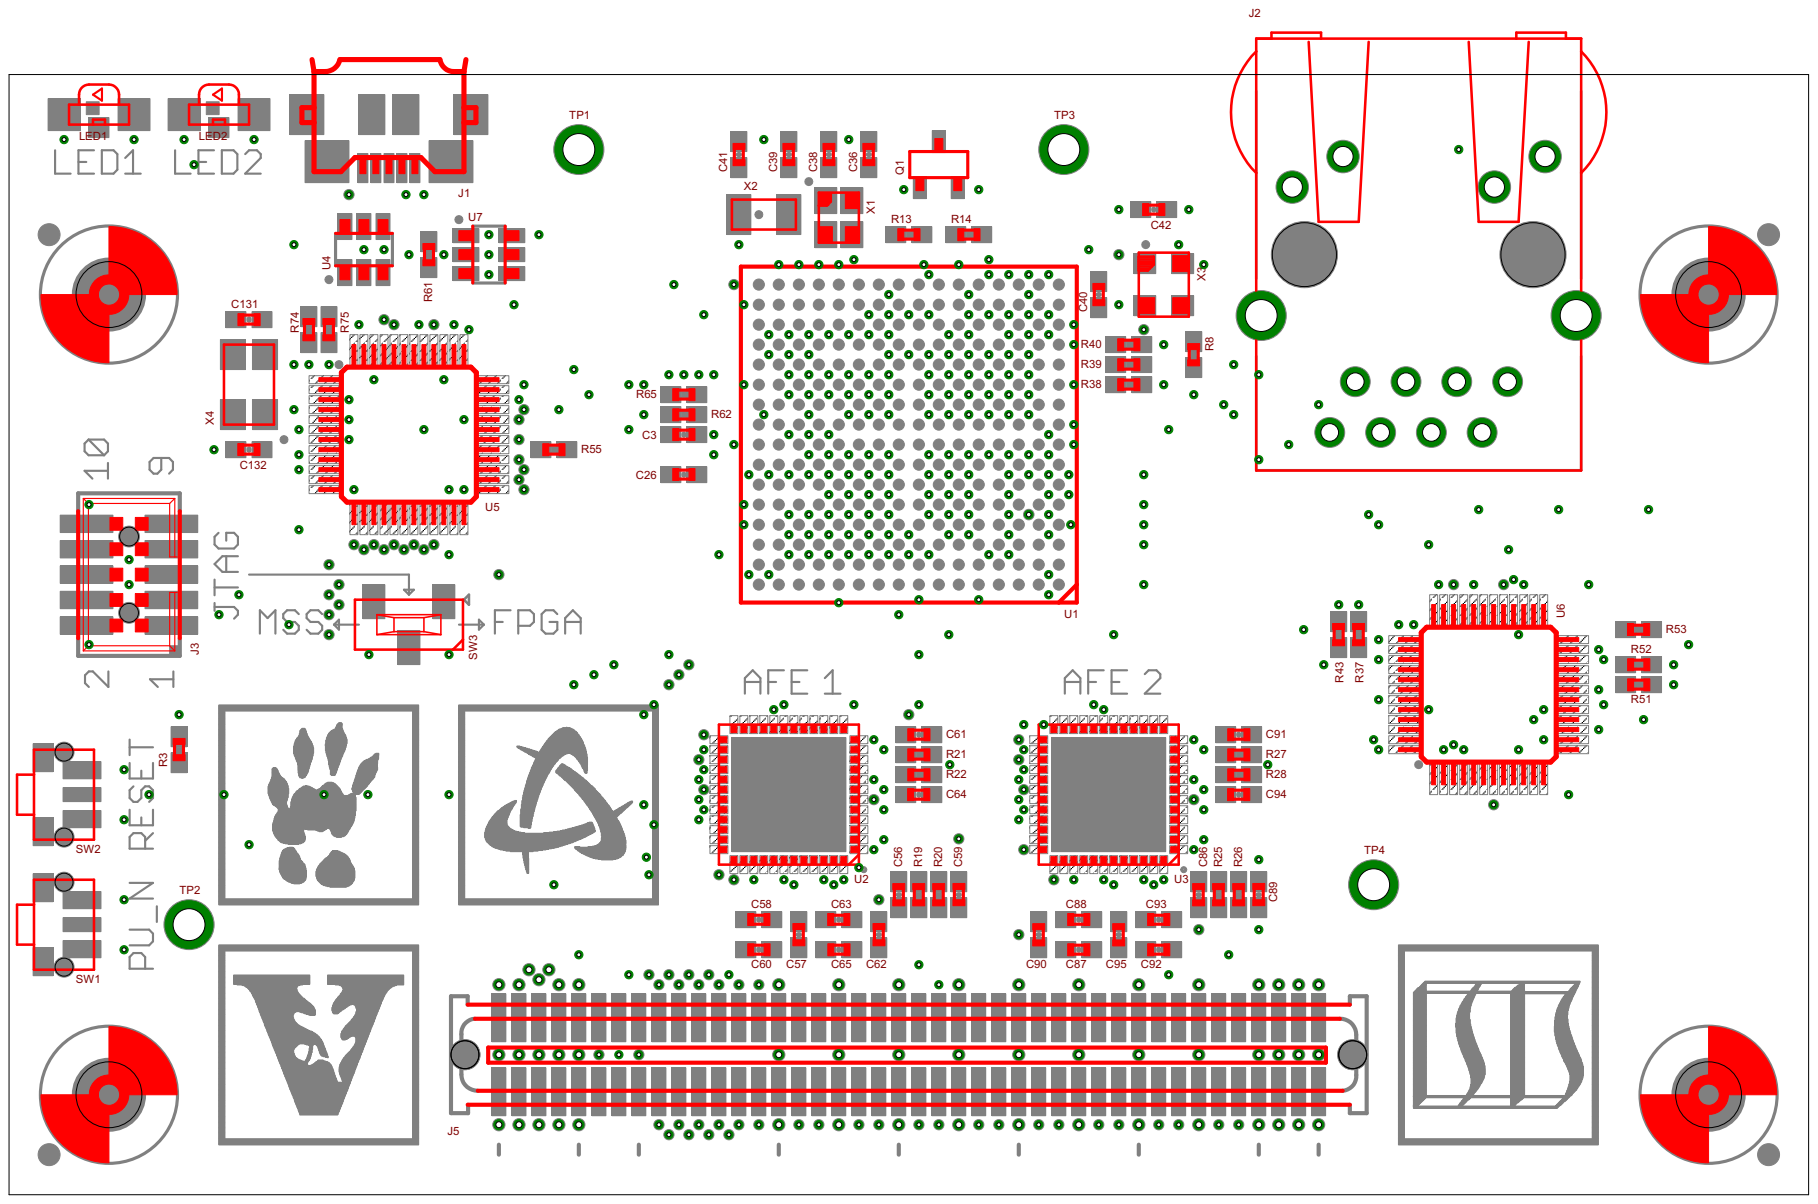
[picture p87: page 1]

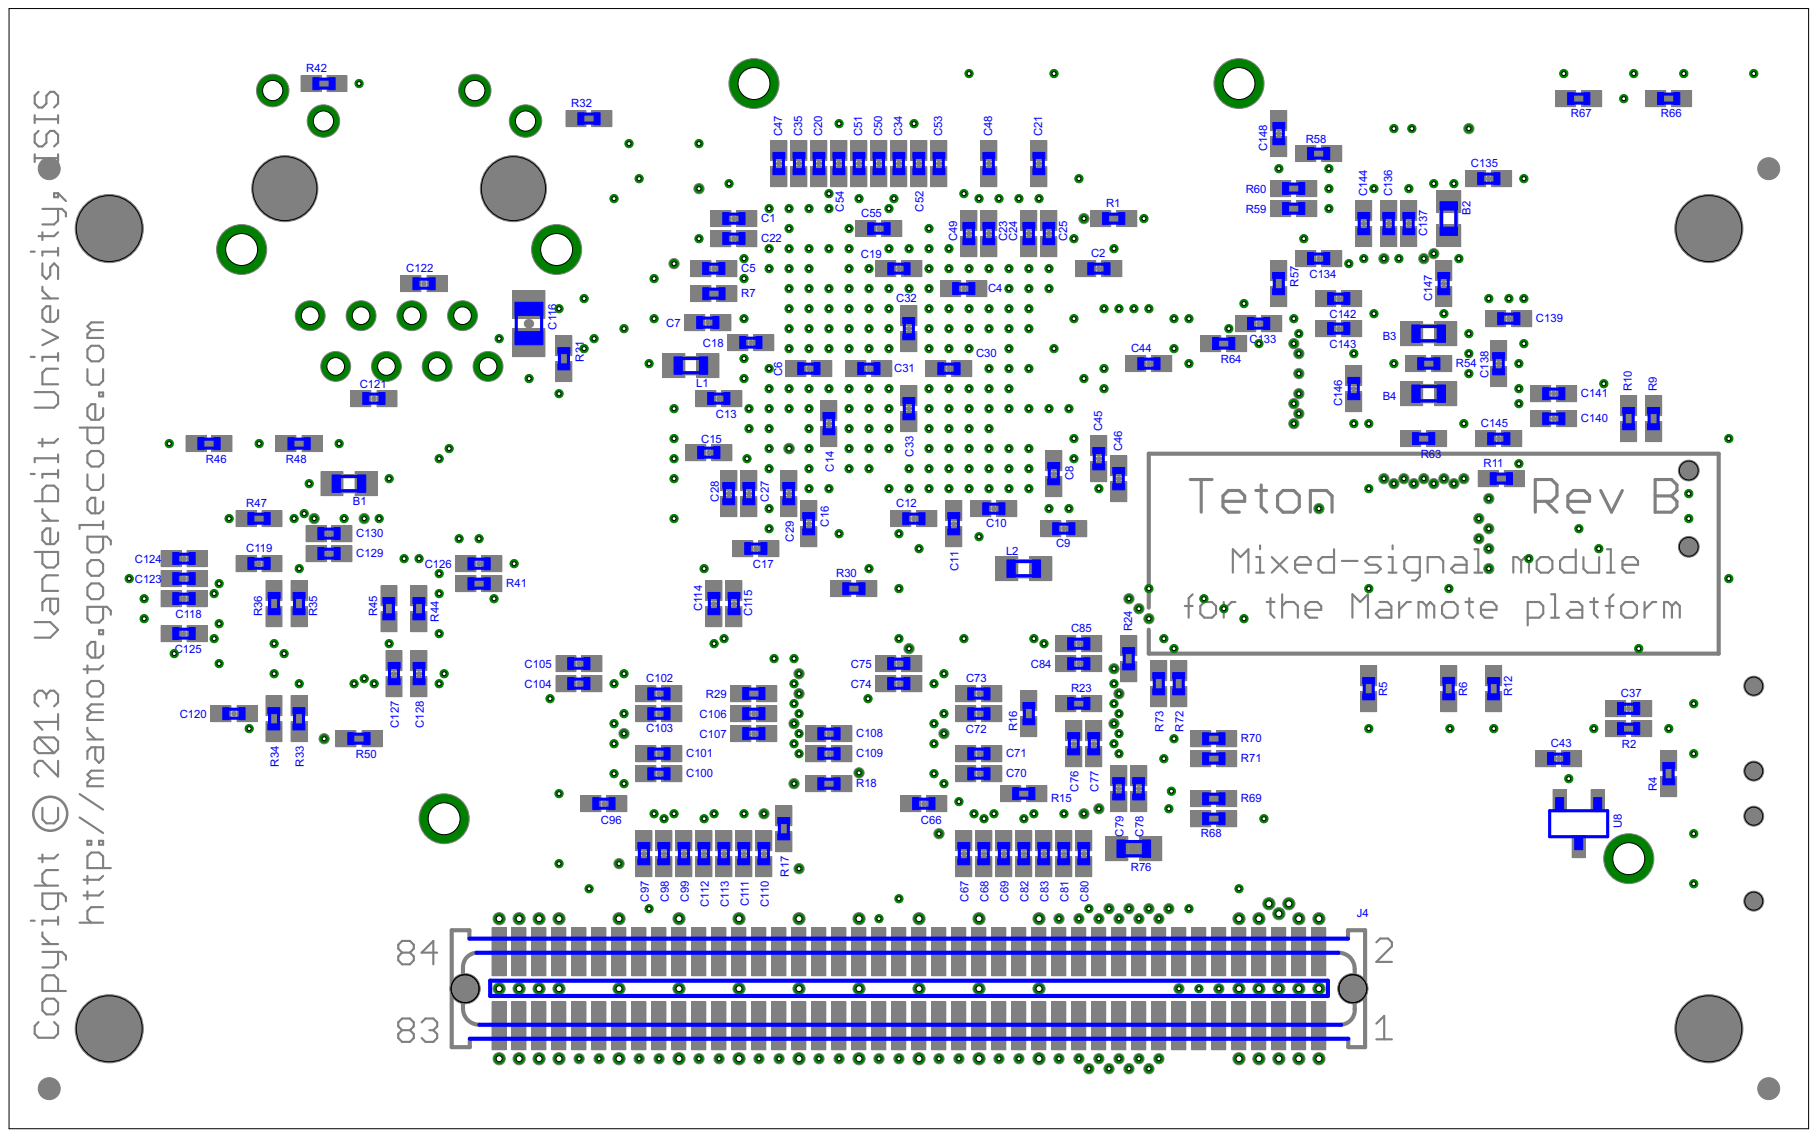
[picture p88: page 2]
