marmote/marmote/hardware/PowerBoard_RevC/PowerBoard_RevC_Asy.pdf

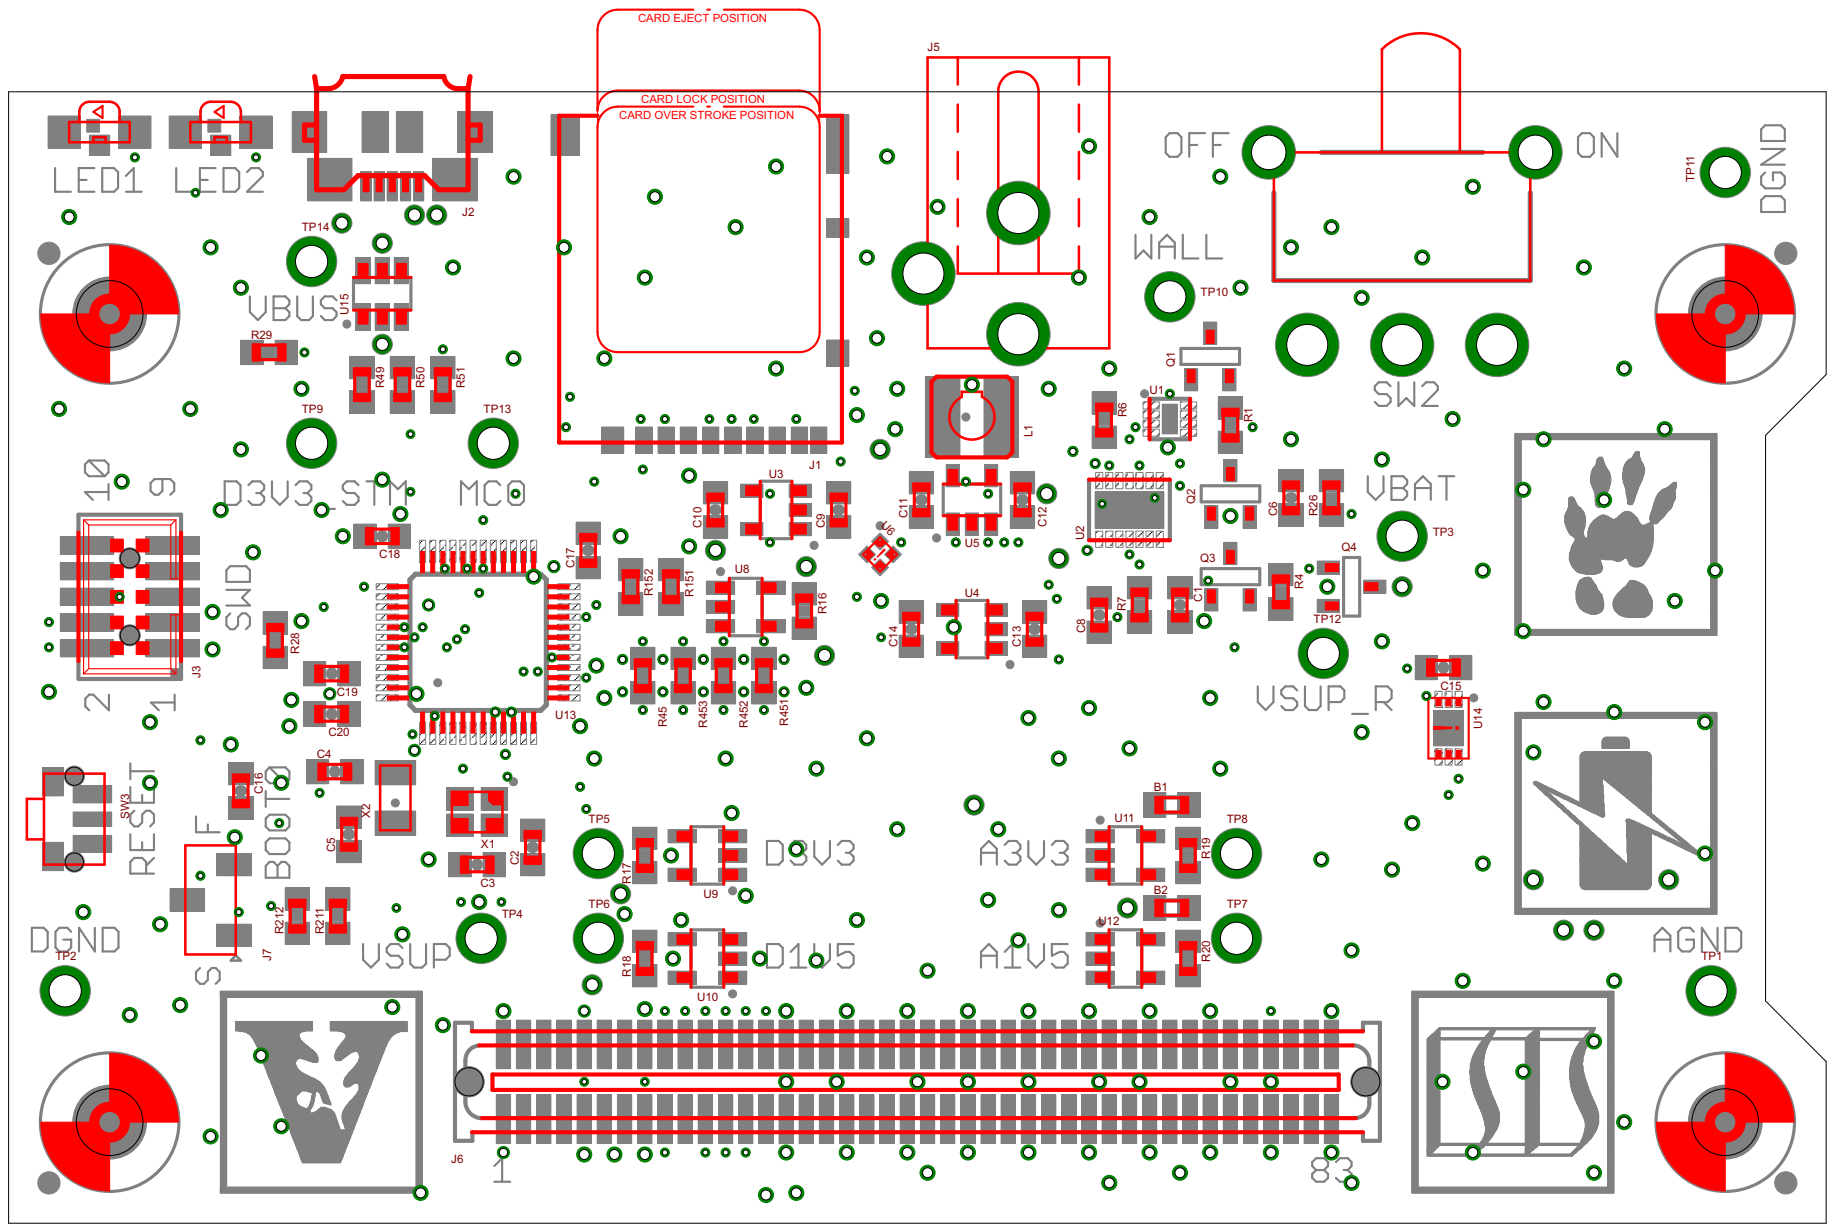
[picture p89: page 1]

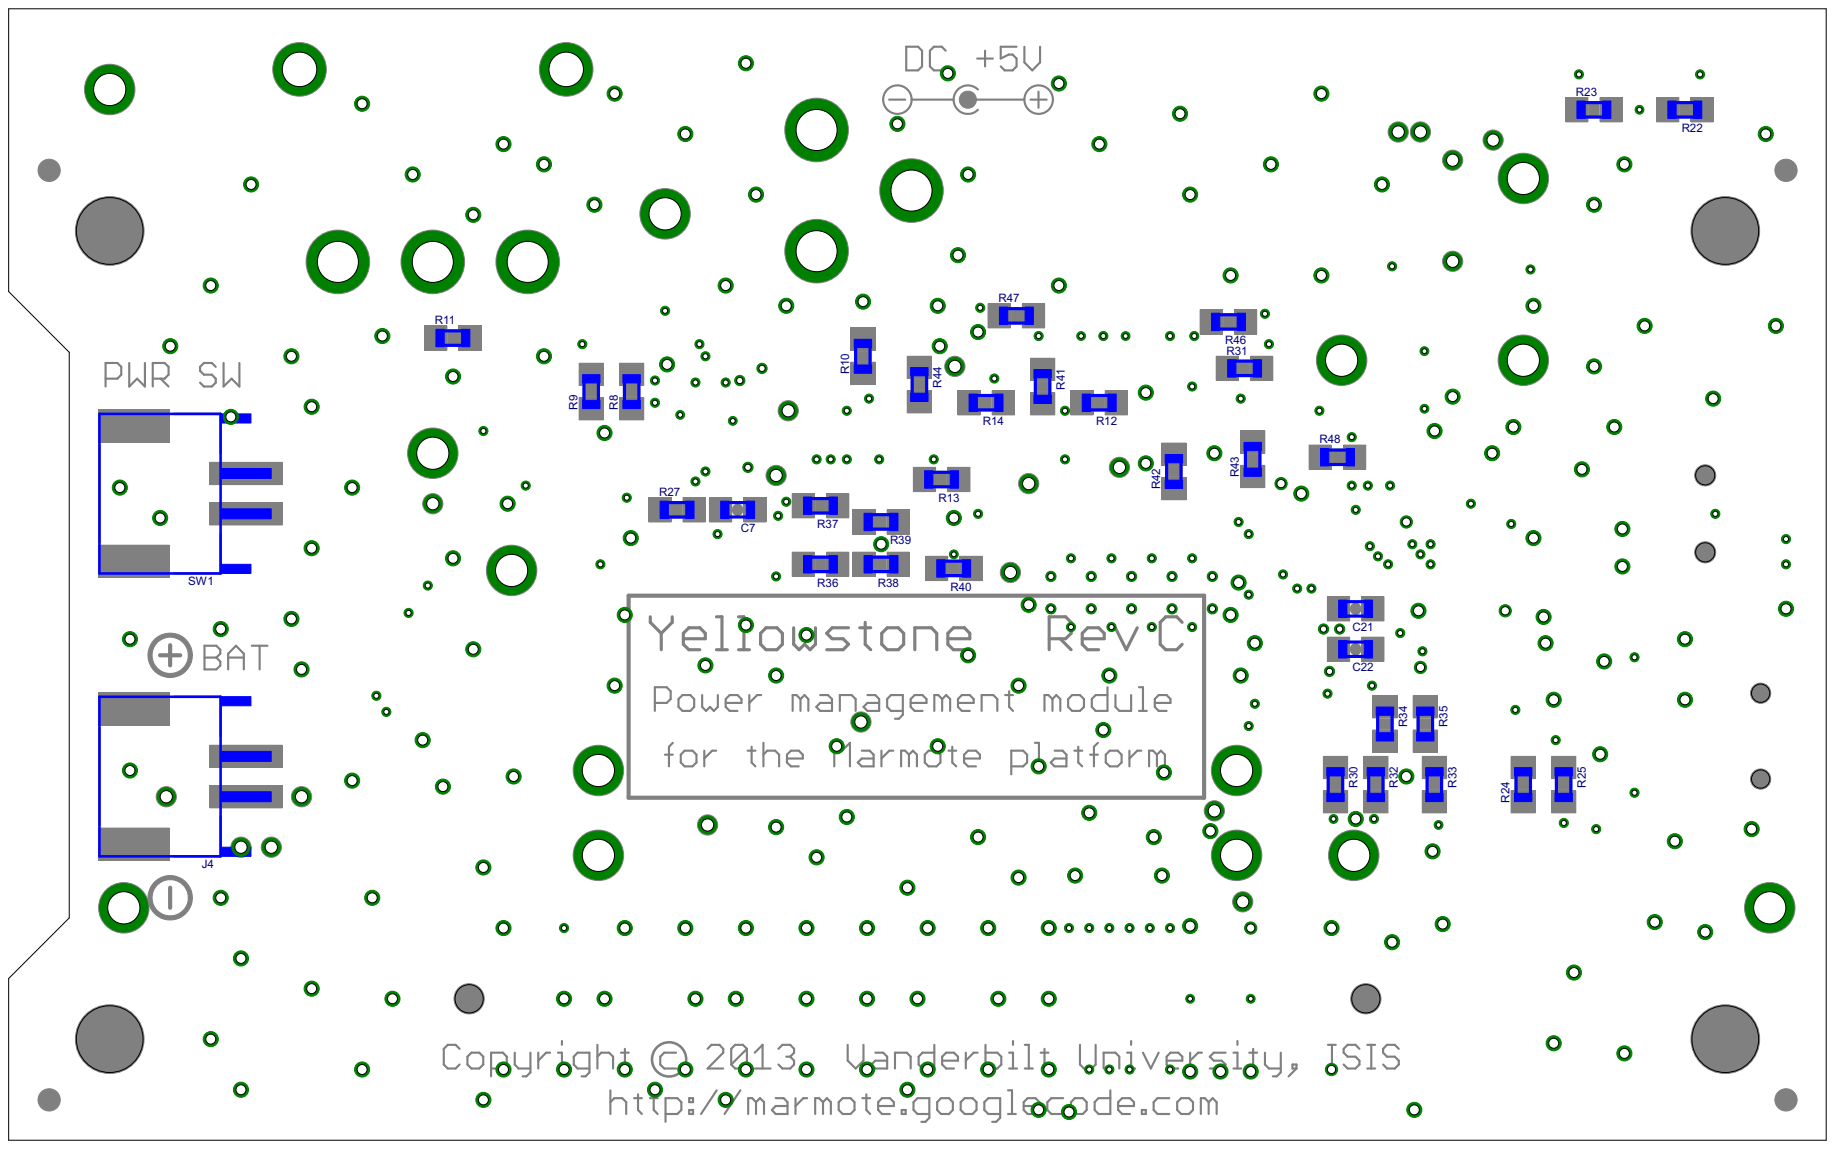
[picture p90: page 2]
