marmote/marmote/hardware/BreakoutBoard/BreakoutBoard_AsyB.pdf

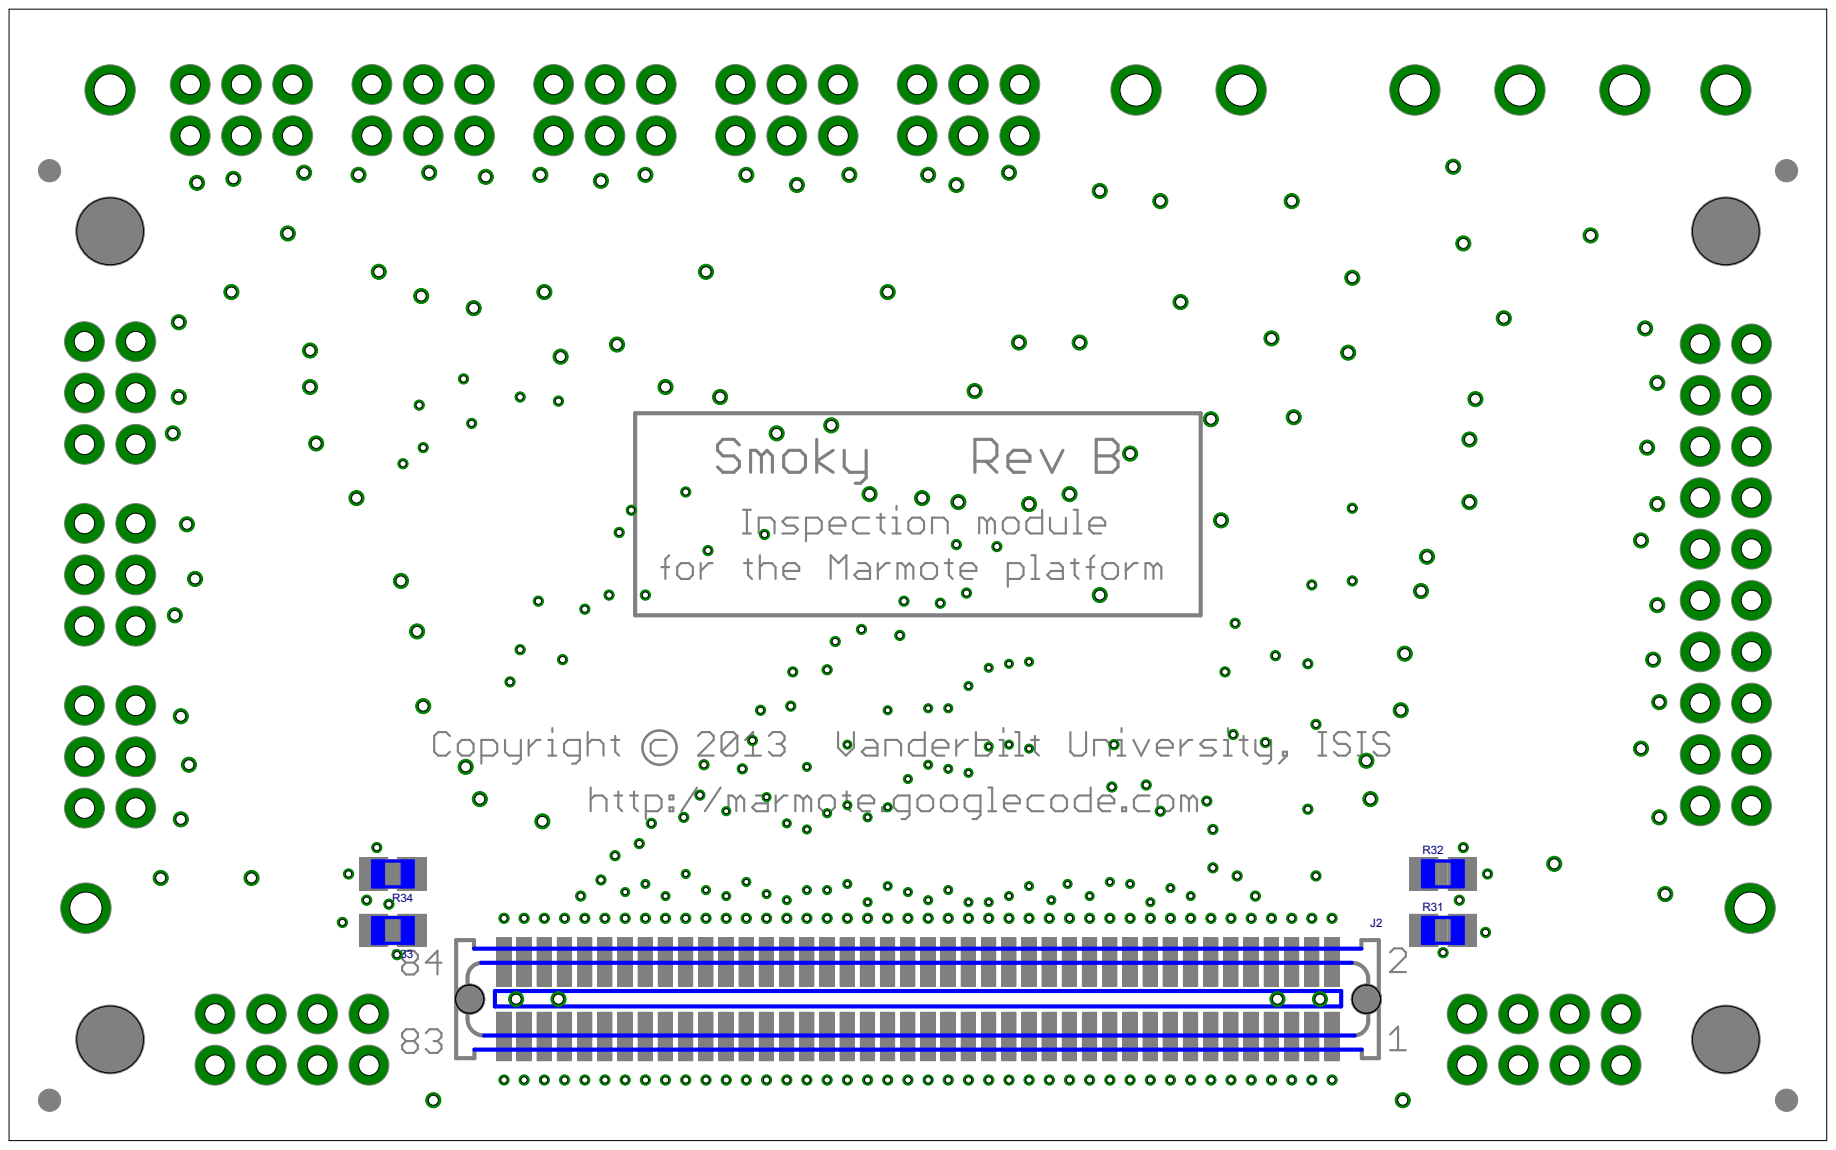
[picture p91: page 1]
