marmote/marmote/hardware/BreakoutBoard/BreakoutBoard_AsyT.pdf

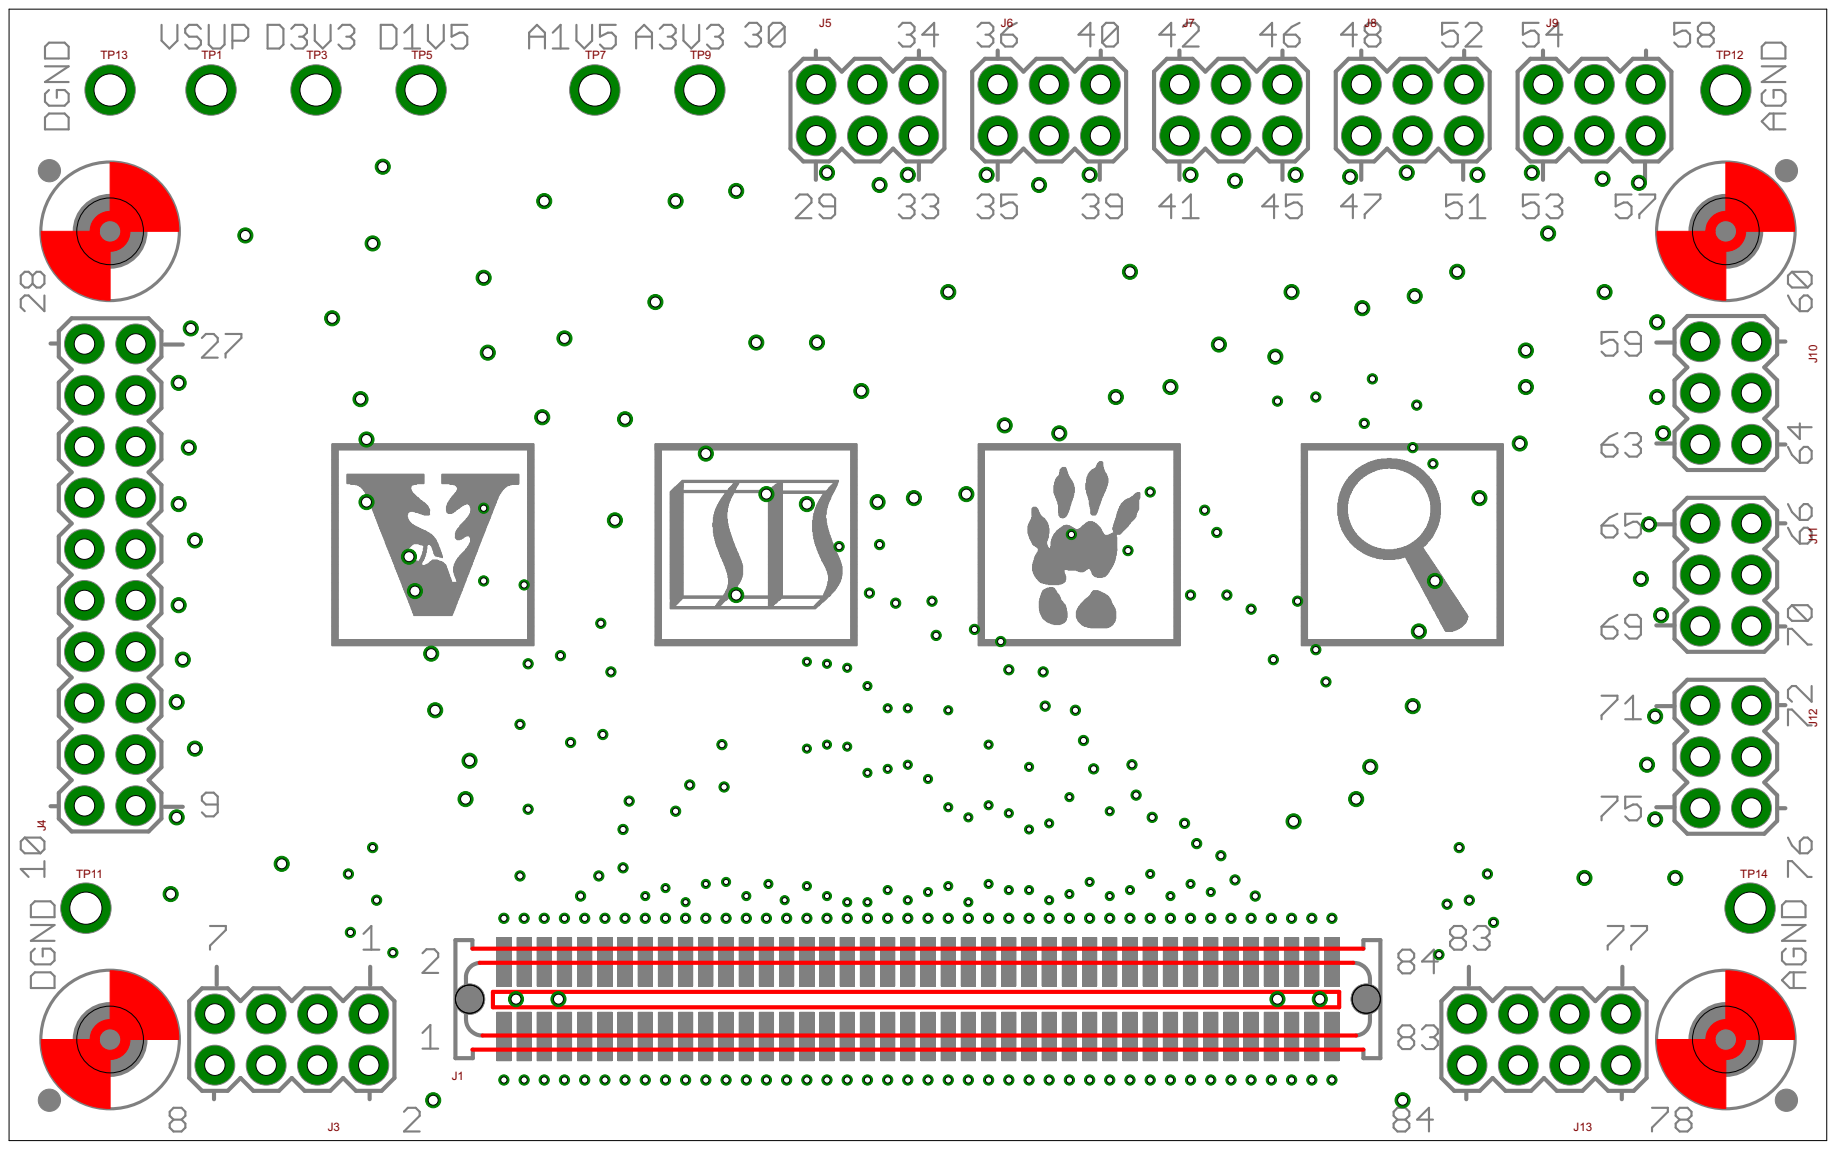
[picture p92: page 1]
