marmote/marmote/hardware/BreakoutBoard_RevB/BreakoutBoard_RevB_Sch.pdf

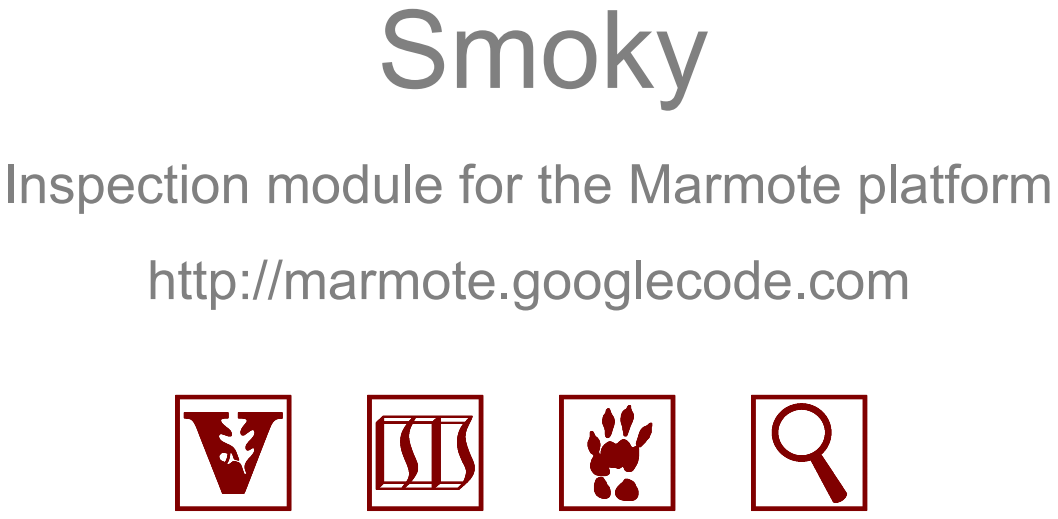
[picture p93: page 1]

Inspection module for the Marmote platform
http://marmote.googlecode.com

Pages: #1 -#2 - Cover Page General Breakout | Designed by: Sandor Szilvasi sandor.szilvasi@vanderbilt.edu | Cover Page

Reviewed by: Benjamin Babjak benjamin.babjak@vanderbilt.edu | Title: Smoky | Rev: B

Date: 3/21/2012 11:32:32 | Sheet: 1/2

Copyright © 2012 Vanderbilt University, ISIS

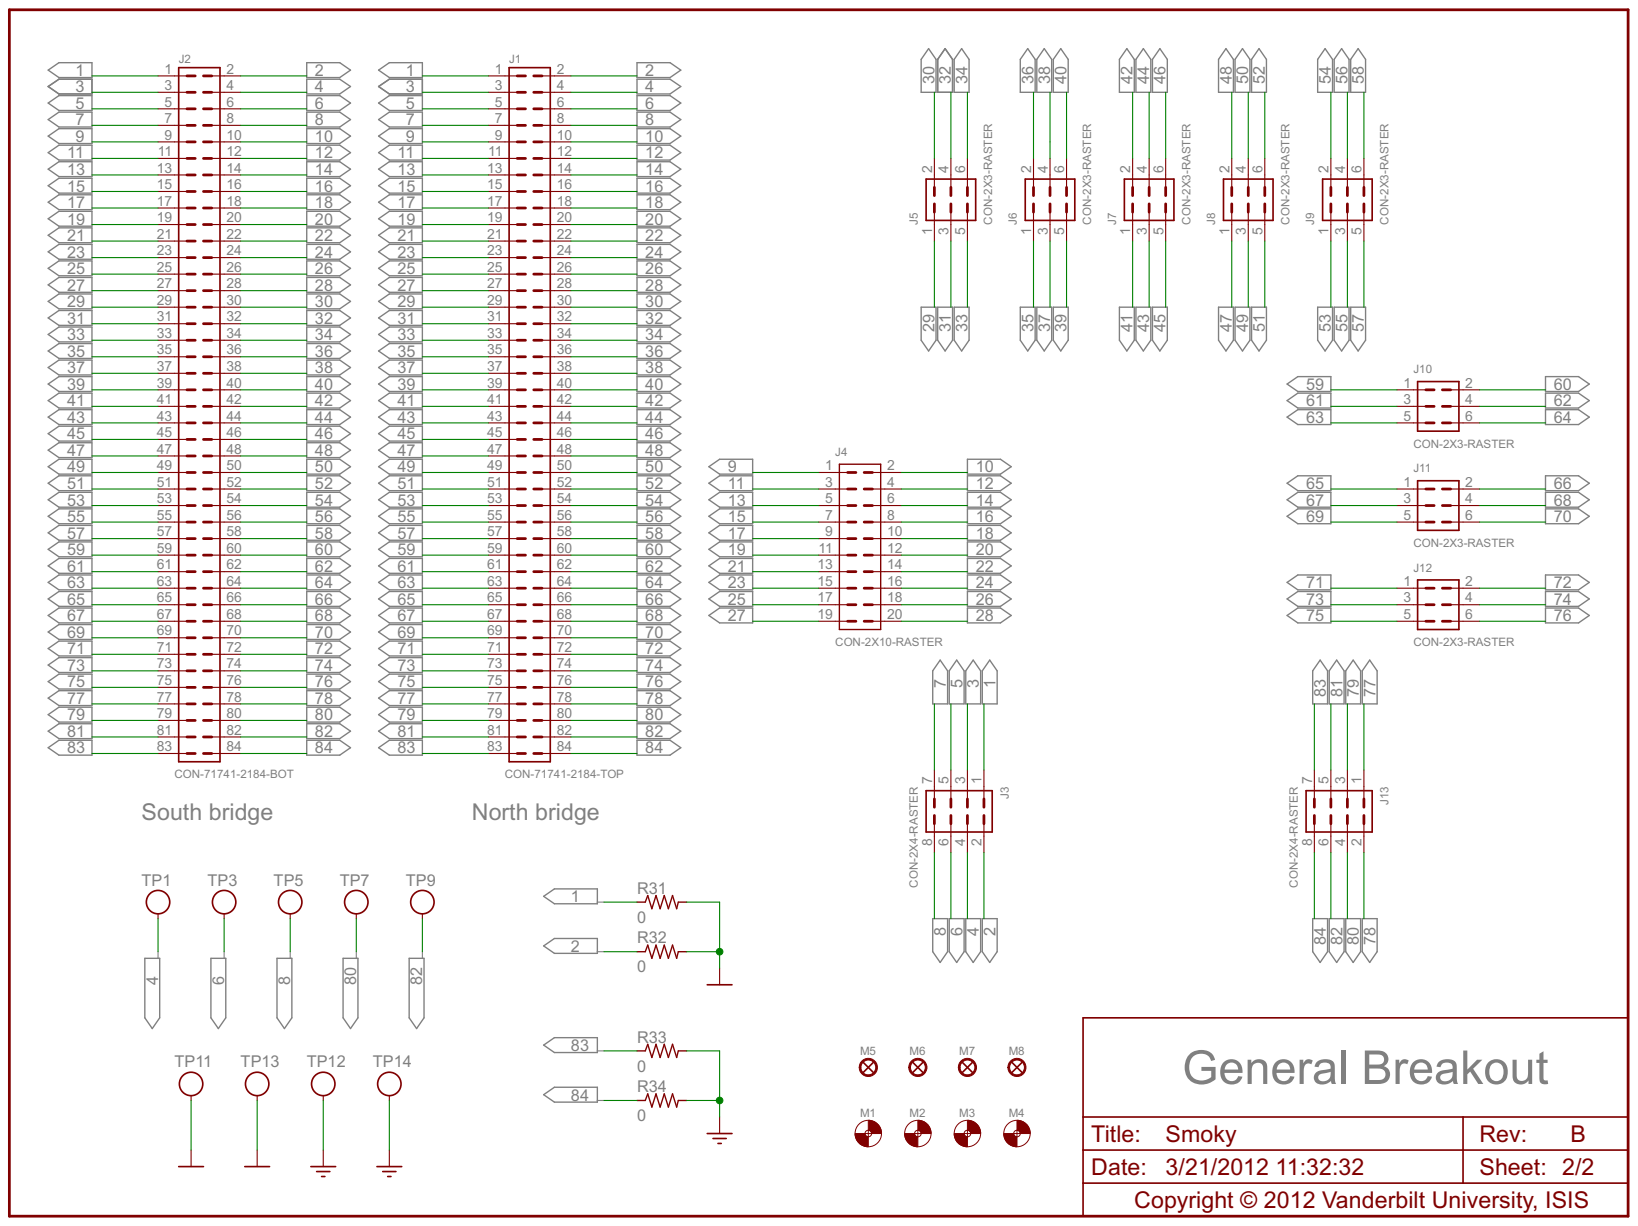
[picture p94: page 2]

11 | 12
13 | 14
15 | 16

33 | 34
35 | 36

71 | 72
73 | 74
75 | 76

81 | 82
83 | 84

Title: Smoky | Rev: B
Date: 3/21/2012 11:32:32 | Sheet: 2/2

Copyright © 2012 Vanderbilt University, ISIS
