marmote/marmote/hardware/M6-RF315/M6-RF315_Sch.pdf

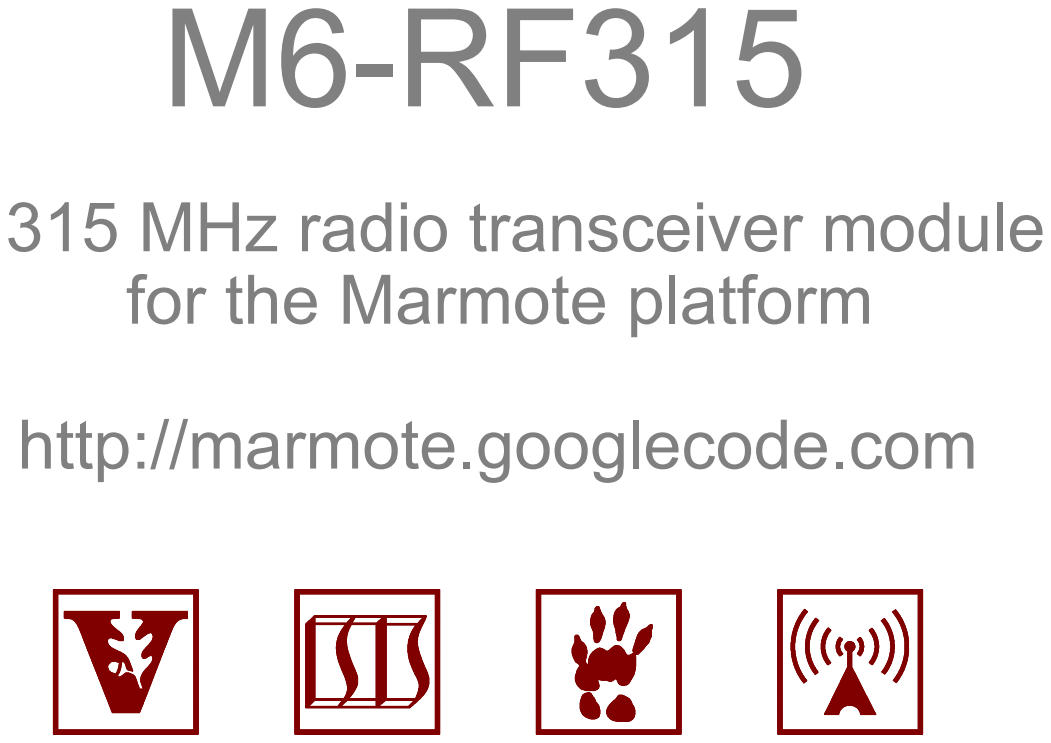
[picture p95: page 1]

315 MHz radio transceiver module
for the Marmote platform

http://marmote.googlecode.com

Pages: #1 - #2 - Cover Page Radio and Antenna | Designed by: Sandor Szilvasi sandor.szilvasi@gmail.com | Cover Page

Verified by: | Title: M6-RF315 | Rev: A

Date: 2/1/2012 9:45:54 AM | Sheet: 1/2

Copyright © 2012 Vanderbilt University, ISIS

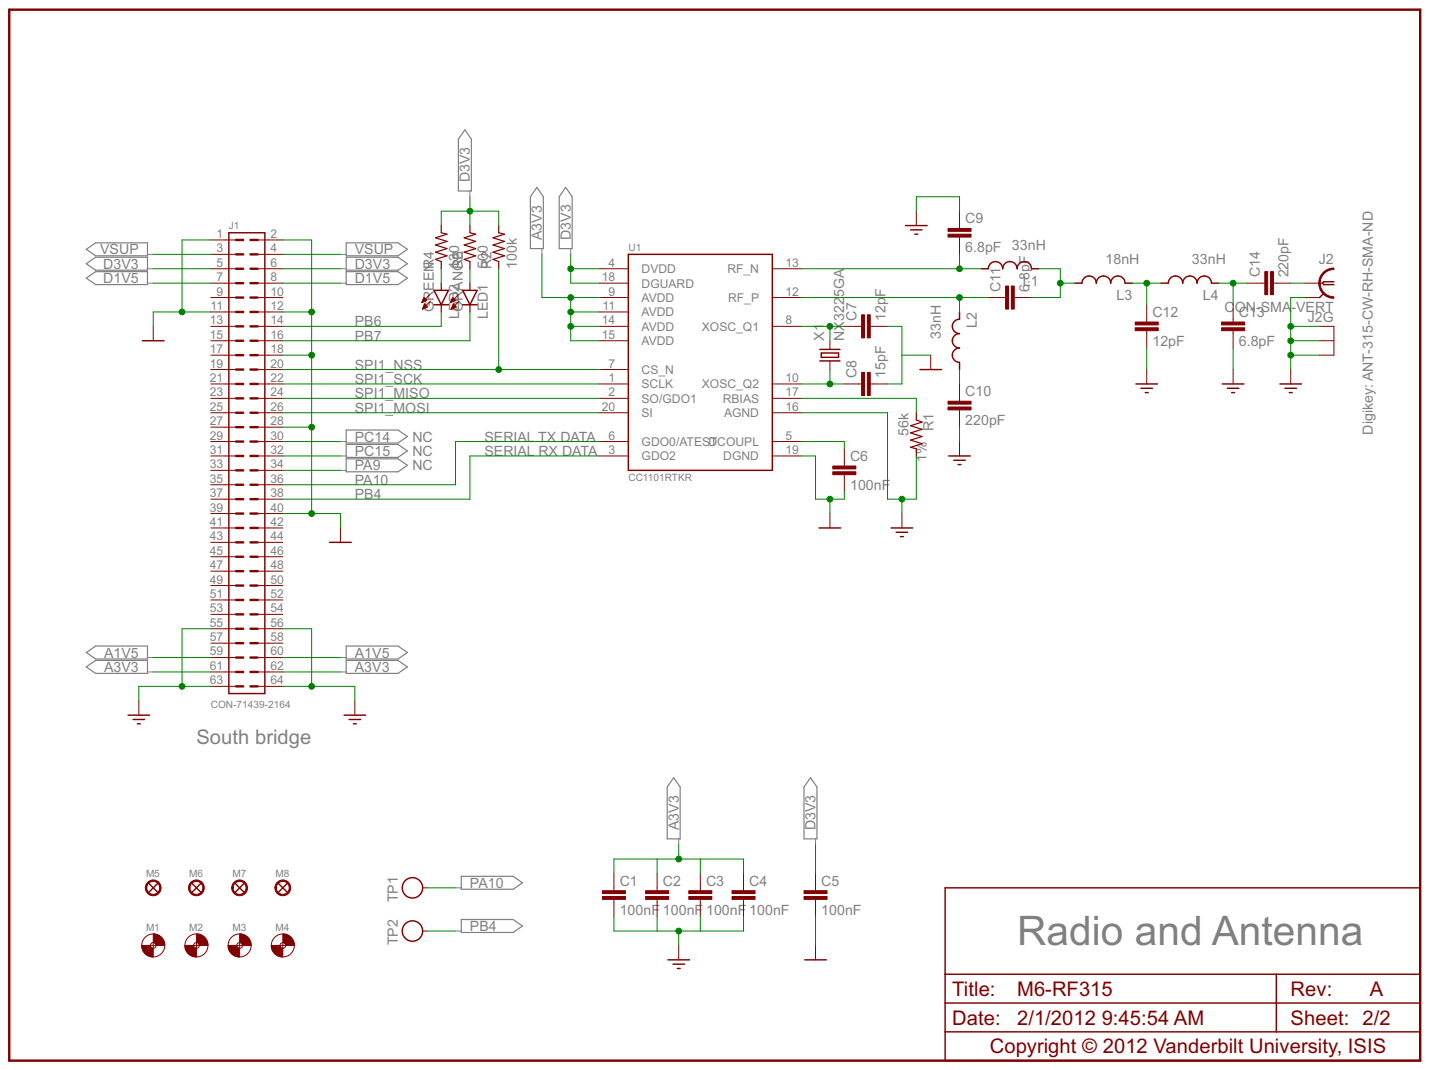
[picture p96: page 2]

Digikey: ANT-315-CW-RH-SM

Title: M6-RF315 | Rev: A
Date: 2/1/2012 9:45:54 AM | Sheet: 2/2

Copyright © 2012 Vanderbilt University, ISIS
