marmote/marmote/hardware/BeaverBoard_RevA/BeaverBoard_RevA_Asy.pdf

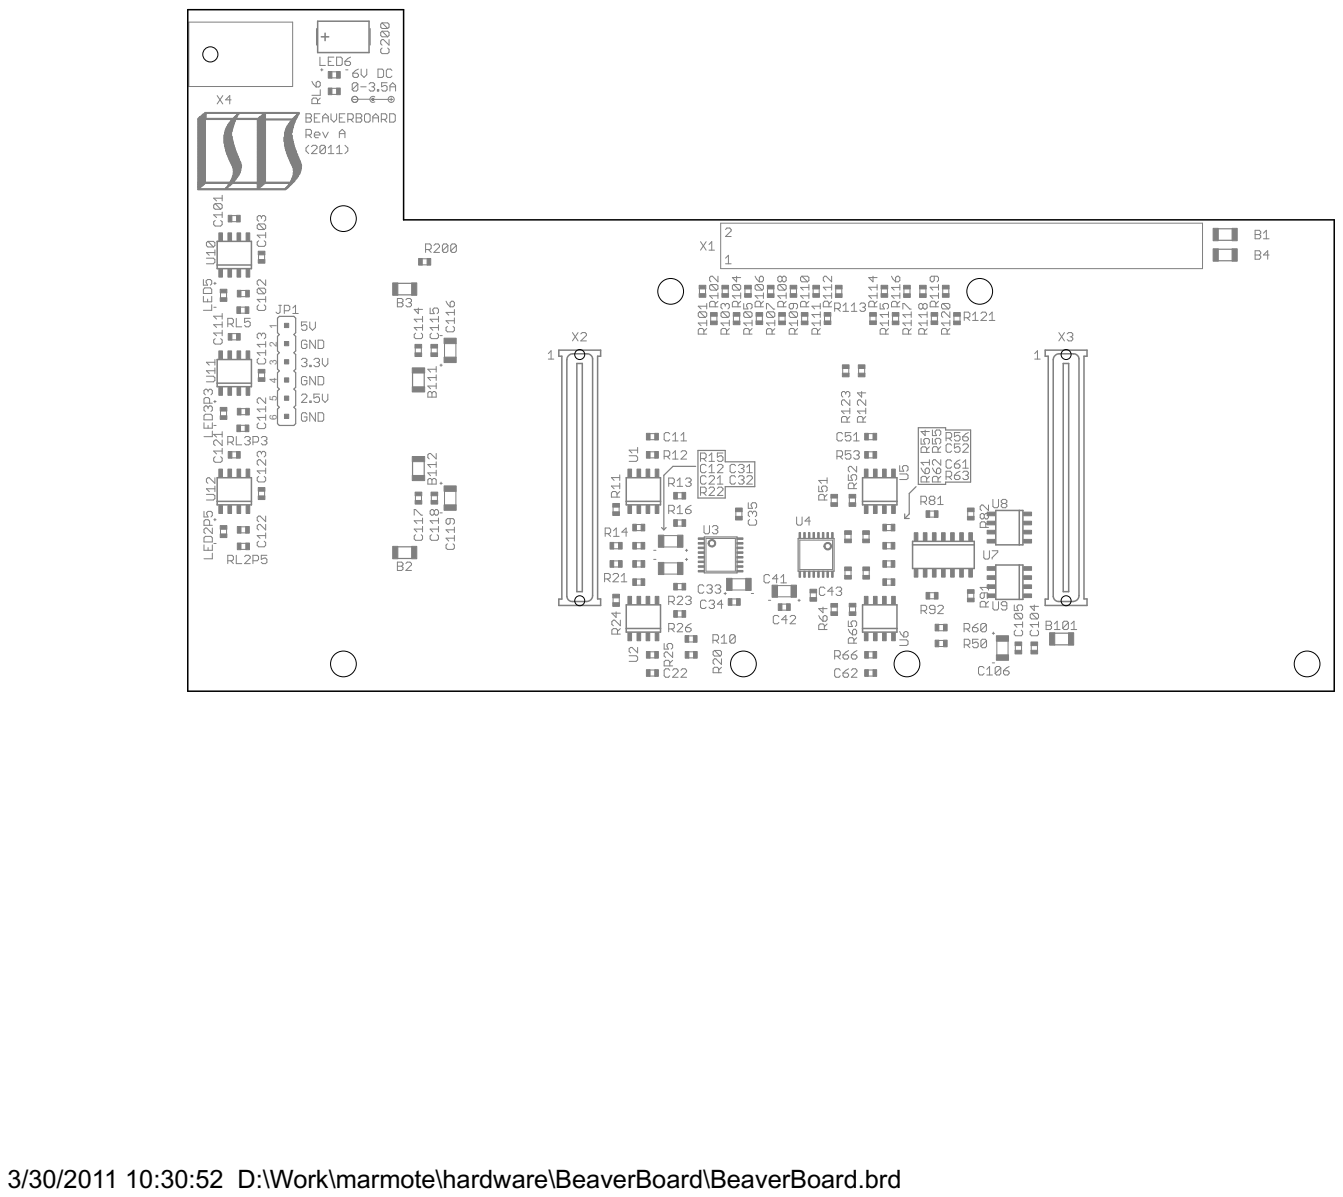
[picture p97: page 1]

3/30/2011 10:30:52 D:\Work\marmote\hardware\BeaverBoard\BeaverBoard.brd
