marmote/marmote/firmware/BeaverBoard/DDC_test/BlockDiagram1.original_concept.pdf

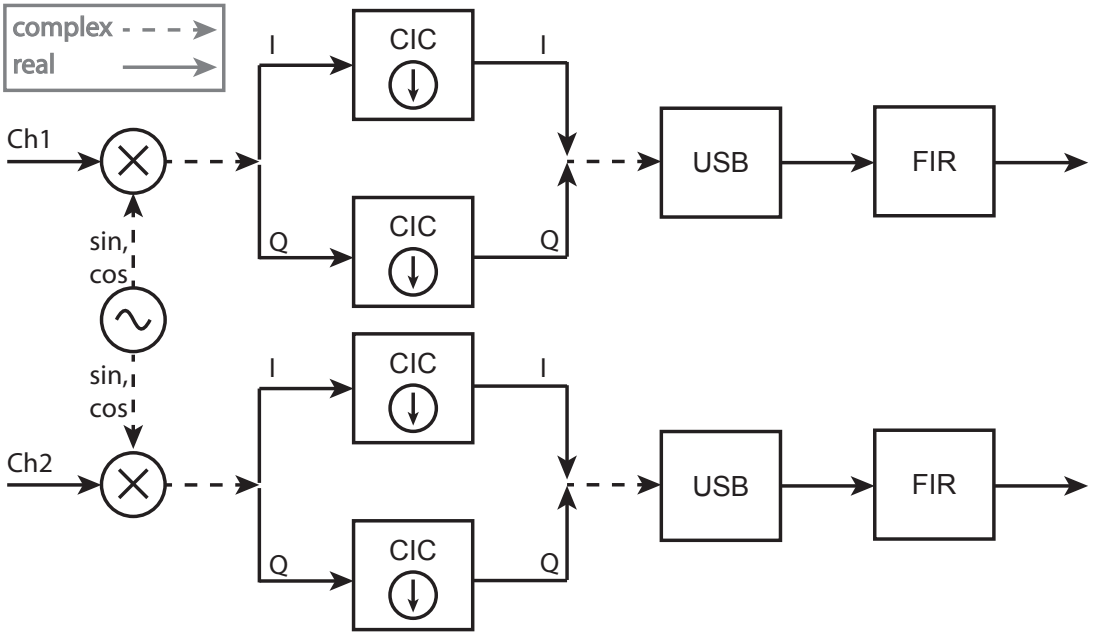
[picture p98: page 1]
USB; CIC; FIR; sin, cos; complex real
