marmote/marmote/firmware/A2F-EVAL-KIT/DecimationFilters/CIC/CIC.pdf

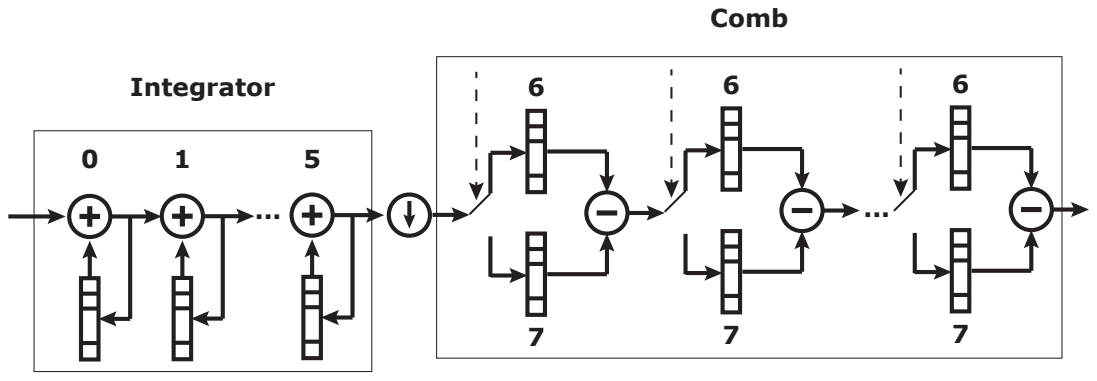
[picture p99: page 1]
Integrator; Comb
