marmote/marmote/hardware/BreakoutBoard_RevA/BreakoutBoard_RevA_Sch.pdf

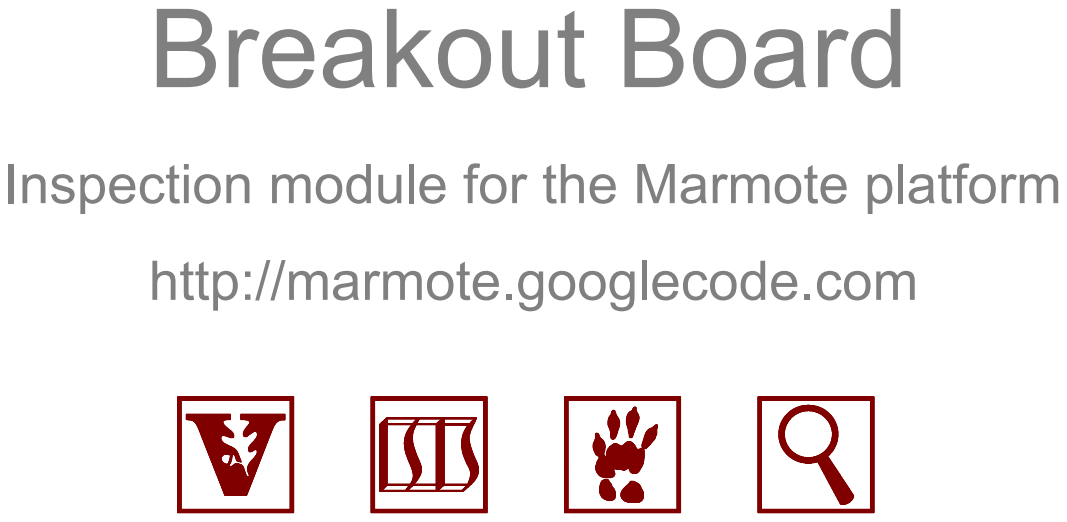
[picture p100: page 1]

Inspection module for the Marmote platform
http://marmote.googlecode.com

Pages: #1 -#2 - Cover Page General Breakout #3 - Power Board Specific | Designed by: Sandor Szilvasi sandor.szilvasi@vanderbilt.edu | Cover Page

Verified by: Peter Volgyesi peter.volgyesi@vanderbilt.edu | Title: Breakout Board | Rev: A
Date: 1/12/2012 8:29:24 AM | Sheet: 1/3

Copyright © 2011 Vanderbilt University, ISIS

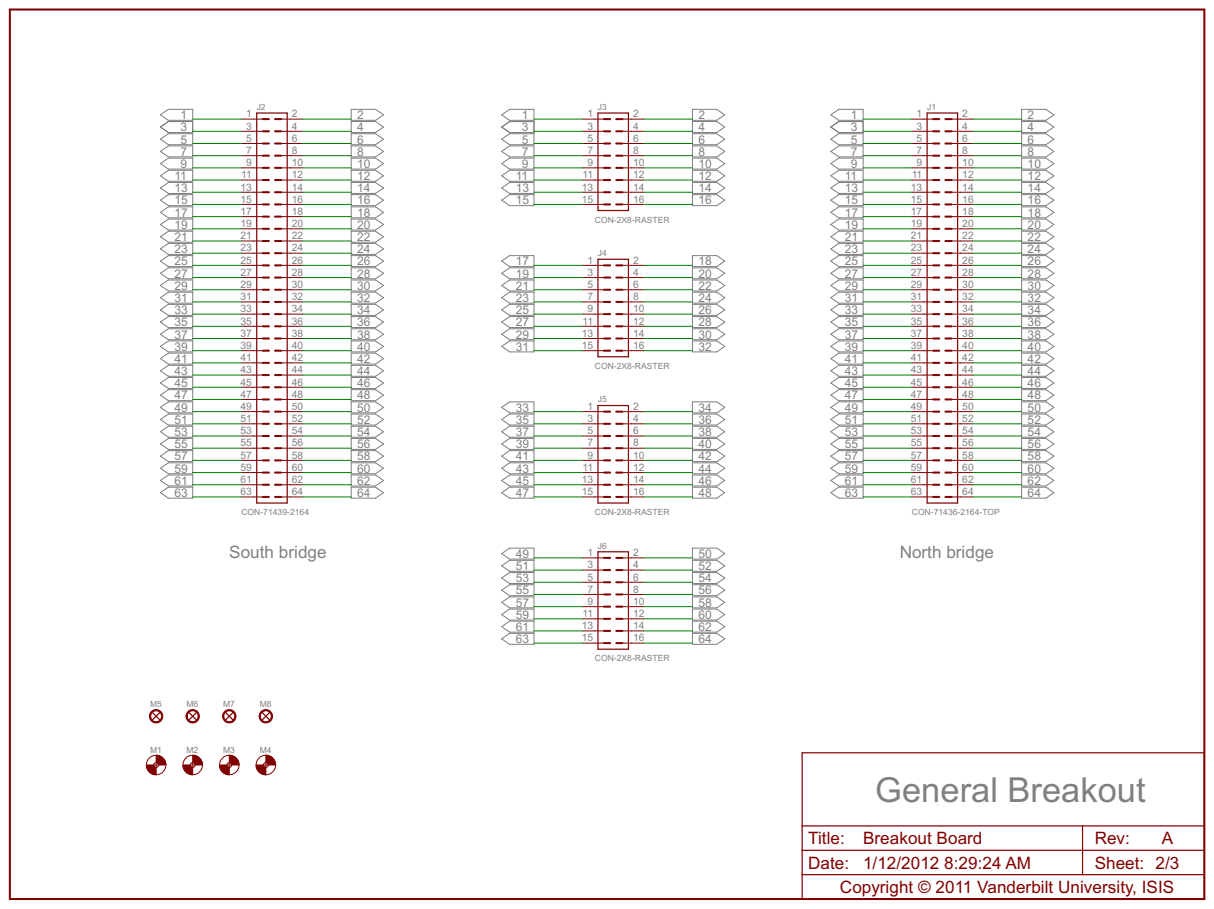
[picture p101: page 2]

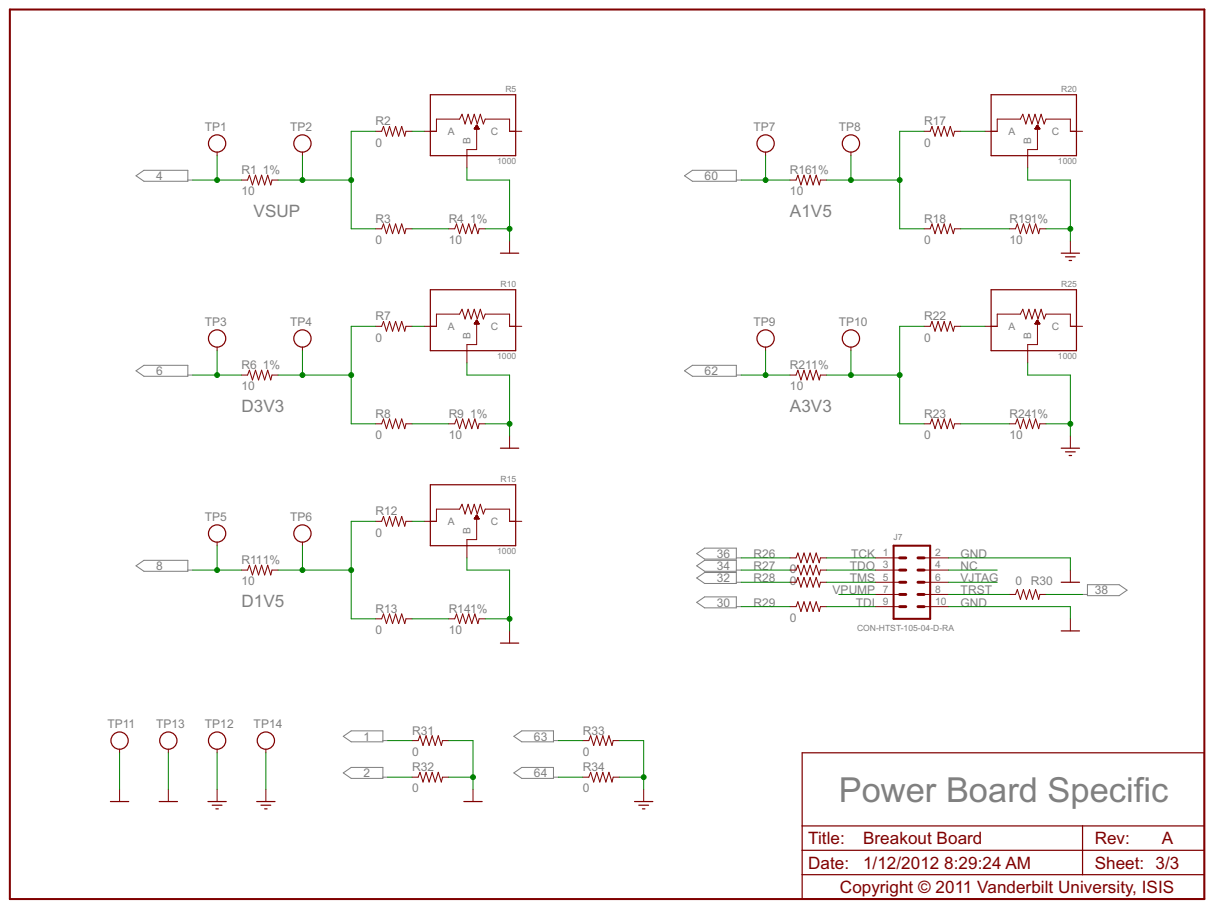
[picture p102: page 3]

Title: Breakout Board | Rev: A
Date: 1/12/2012 8:29:24 AM | Sheet: 3/3

Copyright © 2011 Vanderbilt University, ISIS
