marmote/marmote/hardware/PowerBoard_RevA/PowerBoard_RevA_Sch.pdf

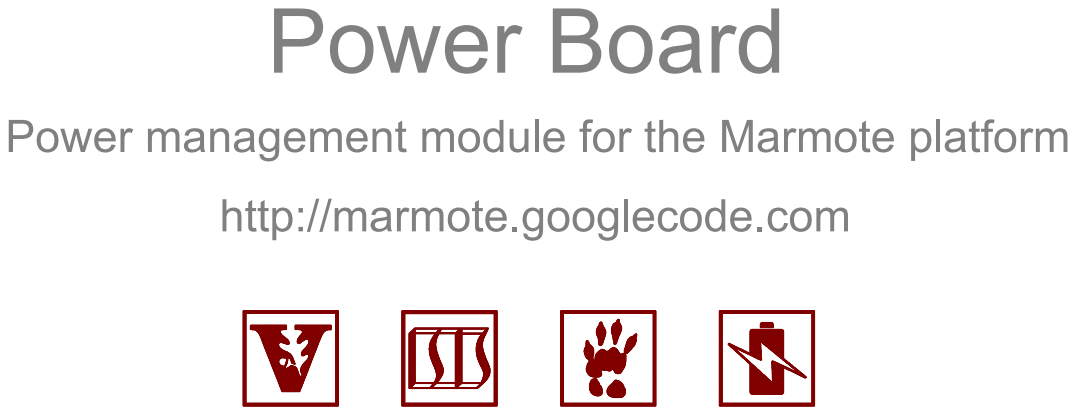
[picture p103: page 1]

Power management module for the Marmote platform

http://marmote.googlecode.com

Pages: #1 - #2 - #3 - #4 - #5 - Cover Page Power Supply Current Monitor Caps, Pulls and Misc Connector | Designed by: Sandor Szilvasi sandor.szilvasi@vanderbilt.edu | Cover Page

Verified by: Peter Volgyesi peter.volgyesi@vanderbilt.edu | Title: Power Board | Rev: A
Date: 5/19/2011 5:21:35 PM | Sheet: 1/5

Copyright © 2011 Vanderbilt University, ISIS

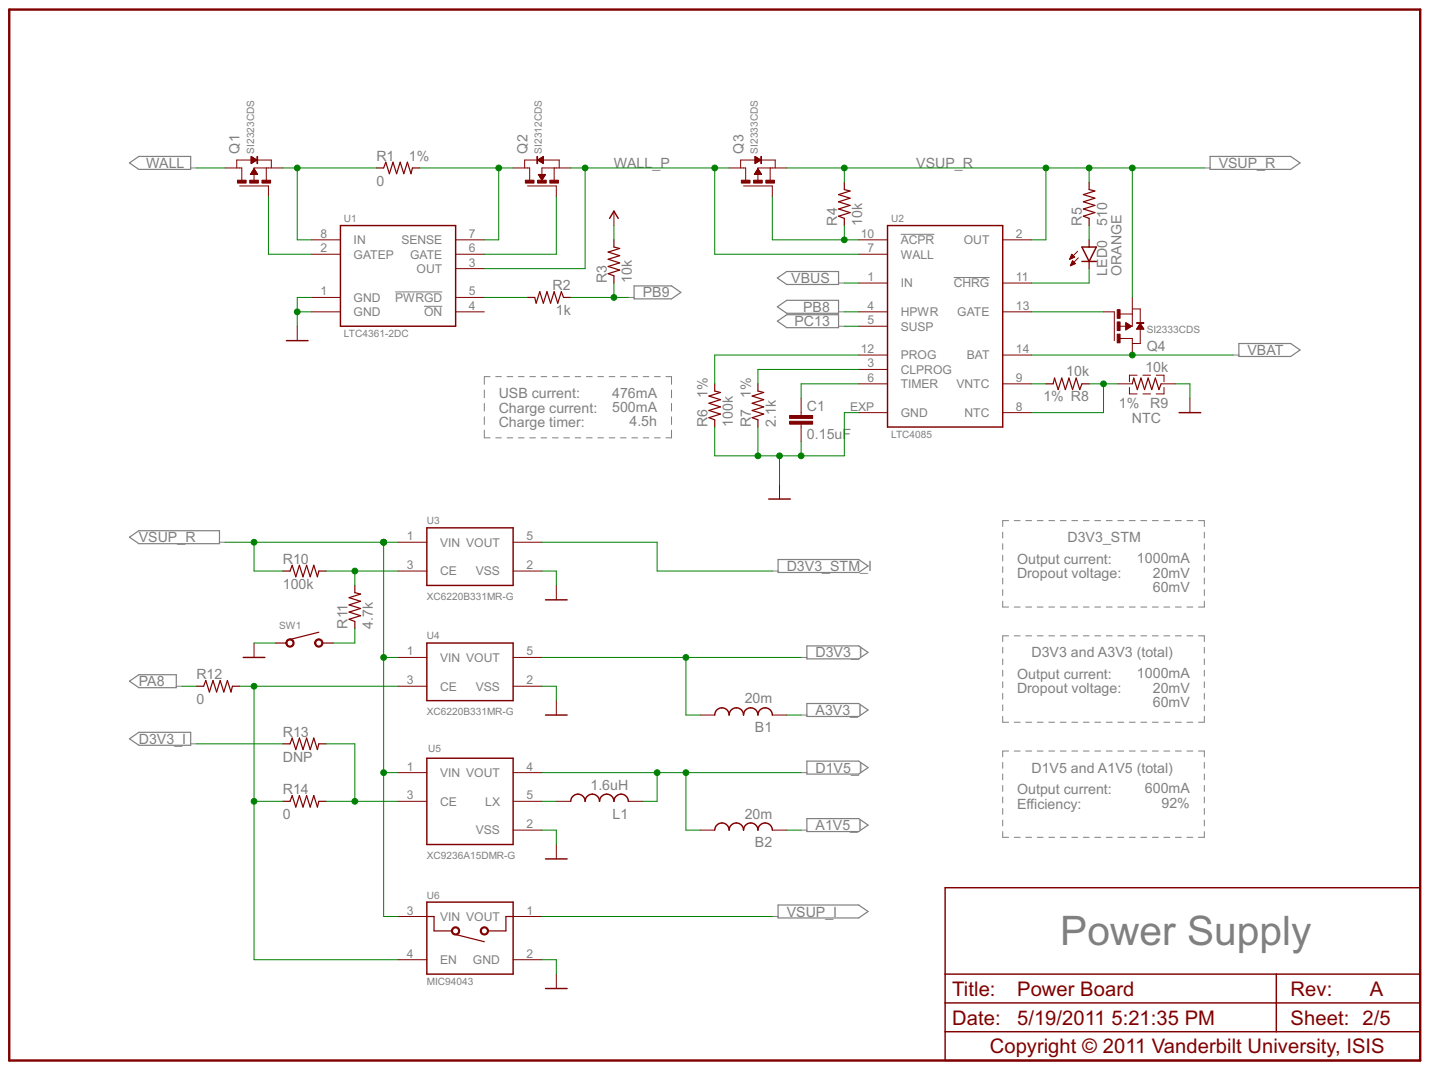
[picture p104: page 2]

EXP | 9 NTC 8

USB current: Charge current: 476mA

Output current: Dropout voltage: 1000mA

D3V3 and A3V3 (total)

Title: Power Board | Rev: A
Date: 5/19/2011 5:21:35 PM | Sheet: 2/5

Copyright © 2011 Vanderbilt University, ISIS

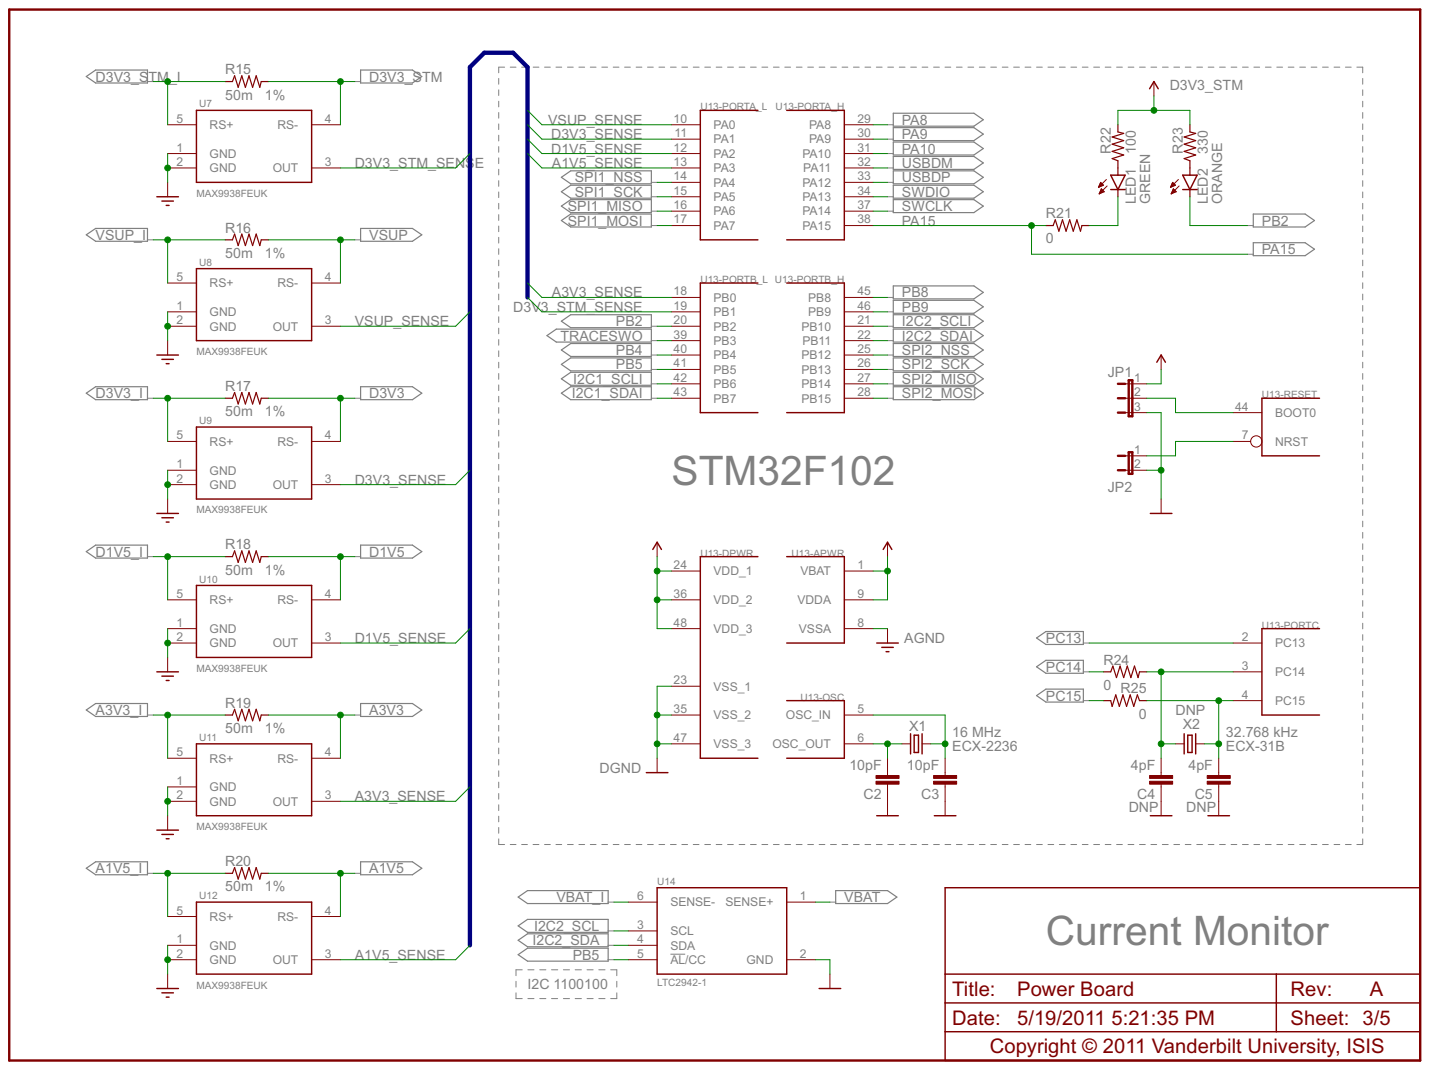
[picture p105: page 3]

Title: Power Board | Rev: A
Date: 5/19/2011 5:21:35 PM | Sheet: 3/5

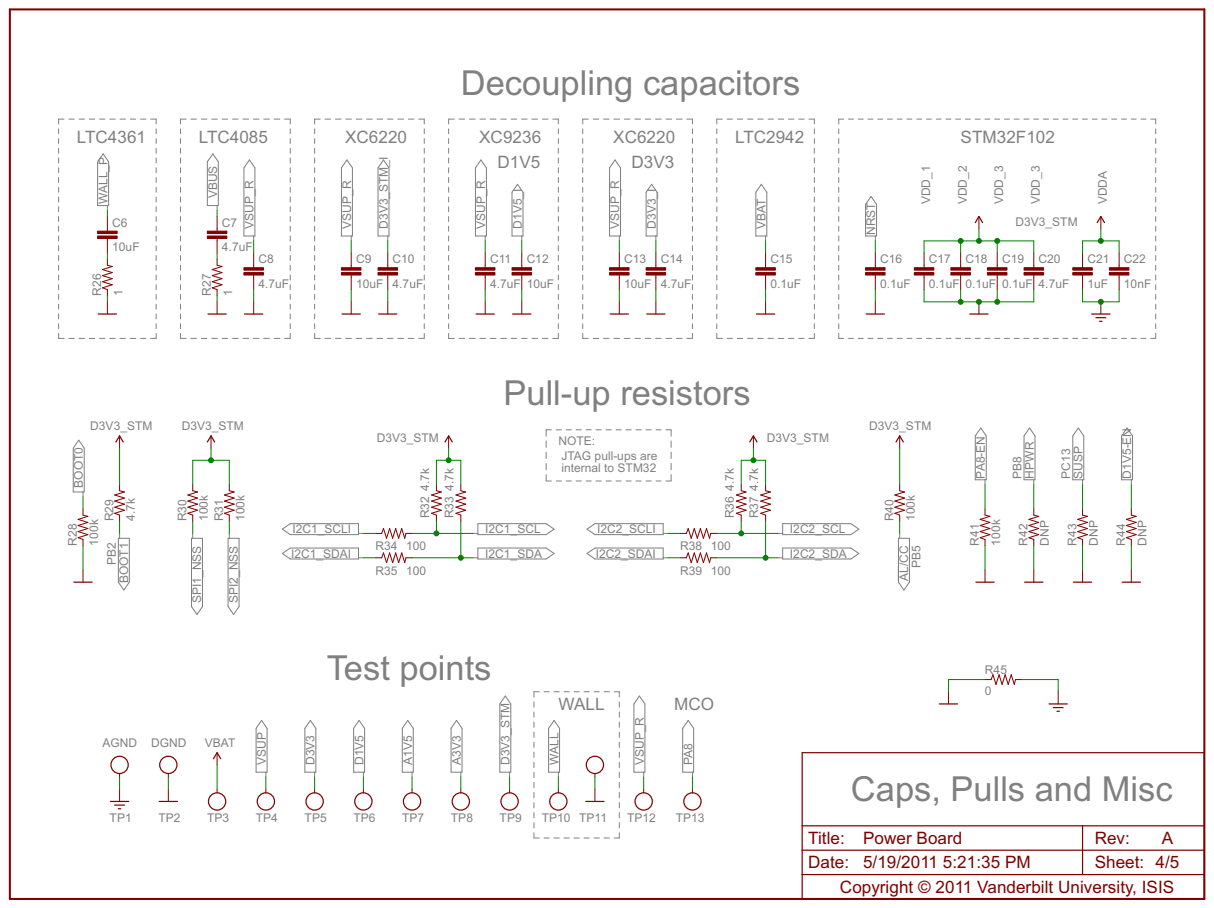
[picture p106: page 4]

NOTE:
JTAG pull-ups are
internal to STM32

Caps, Pulls and Misc

Title: Power Board | Rev: A
Date: 5/19/2011 5:21:35 PM | Sheet: 4/5

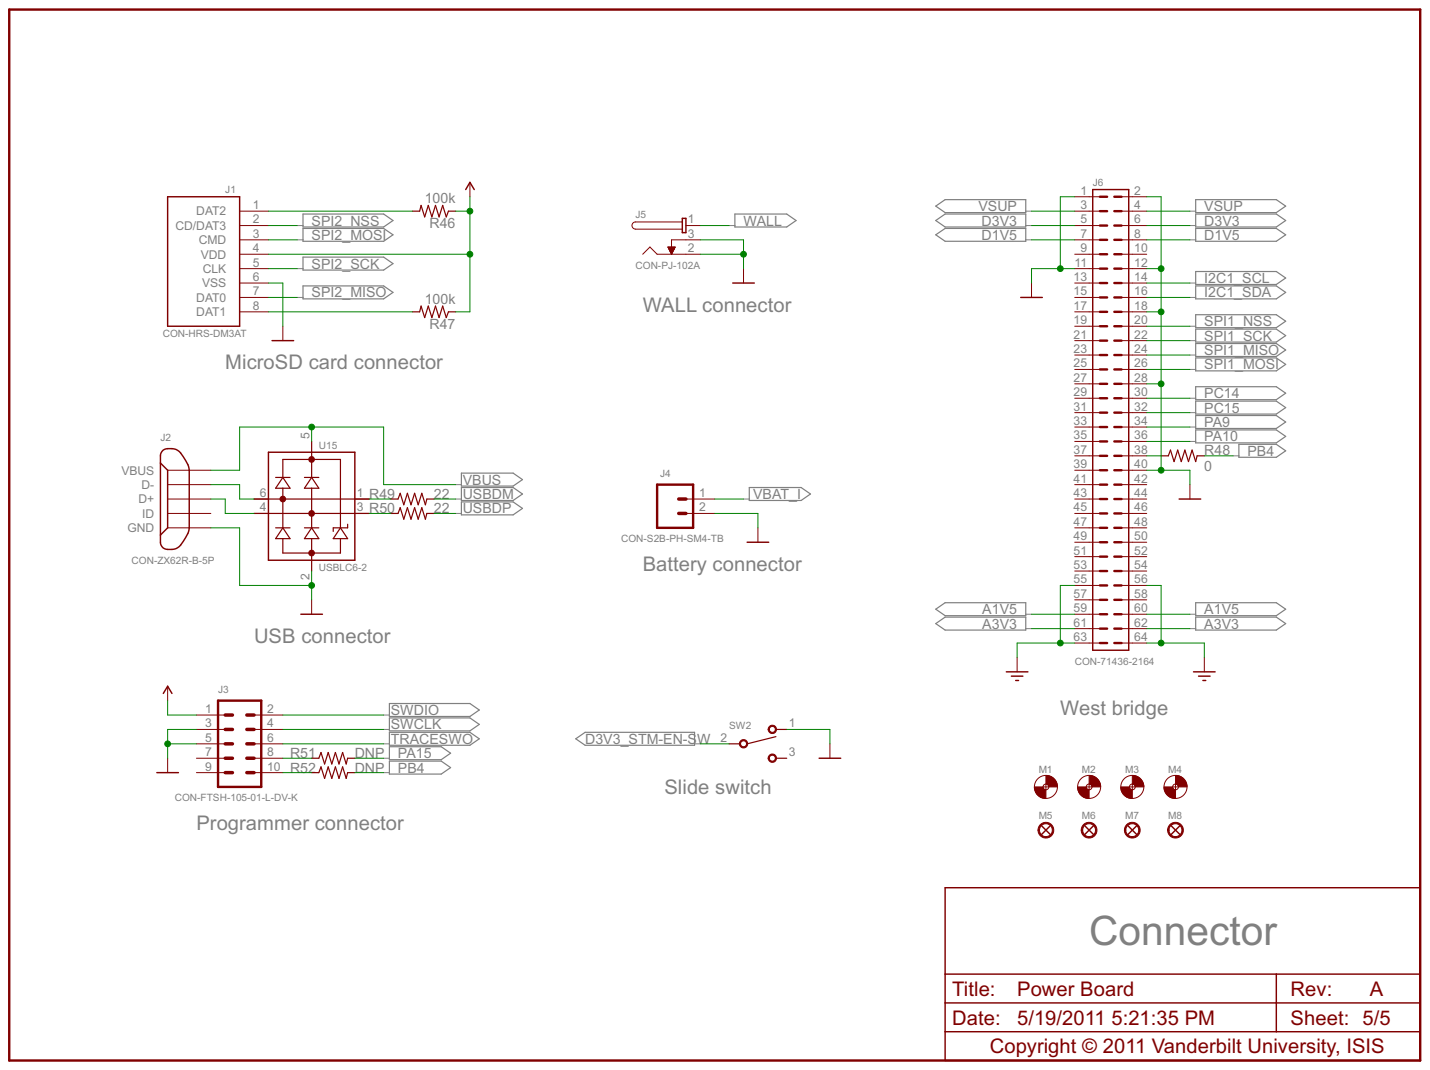
[picture p107: page 5]

Title: Power Board | Rev: A
Date: 5/19/2011 5:21:35 PM | Sheet: 5/5
