marmote/marmote/hardware/MainBoard_RevA/MainBoard_RevA_Asy.pdf

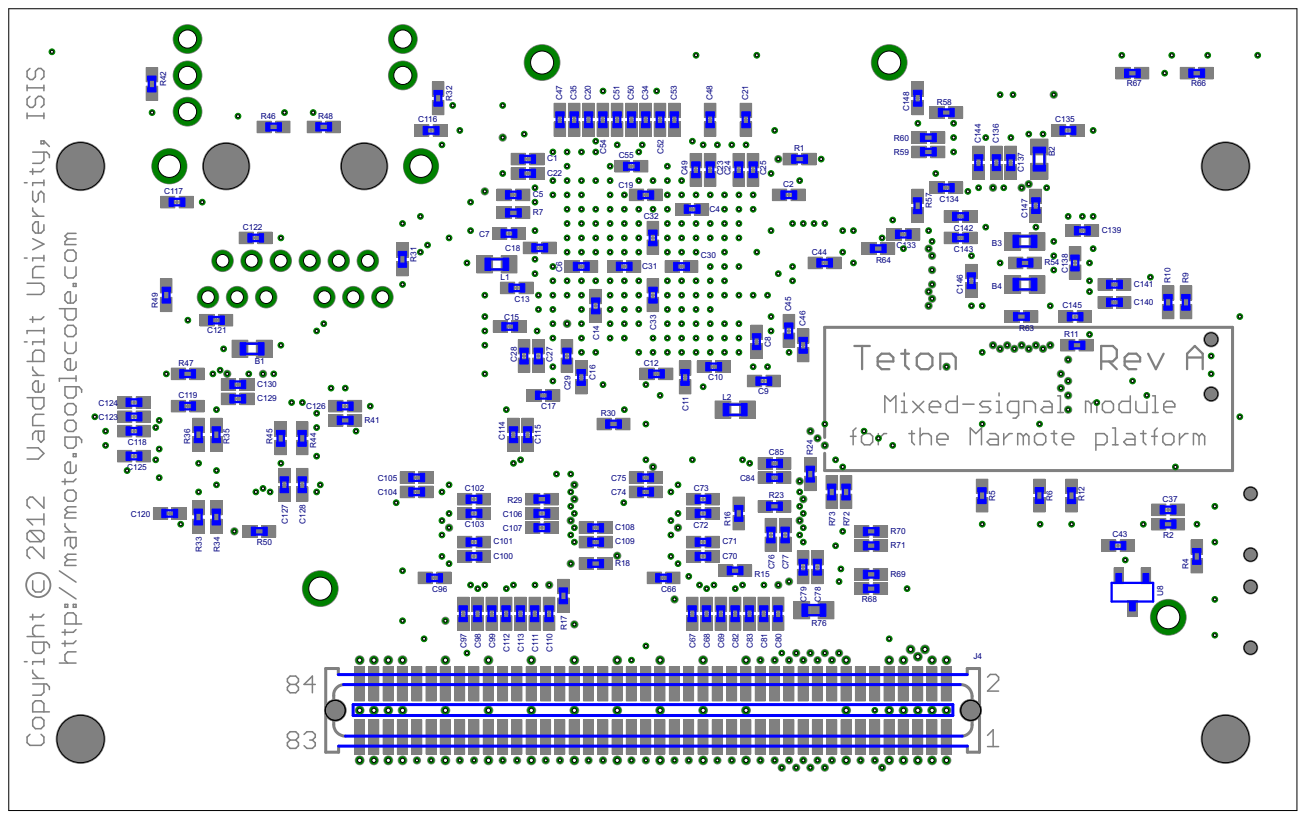
[picture p108: page 1]

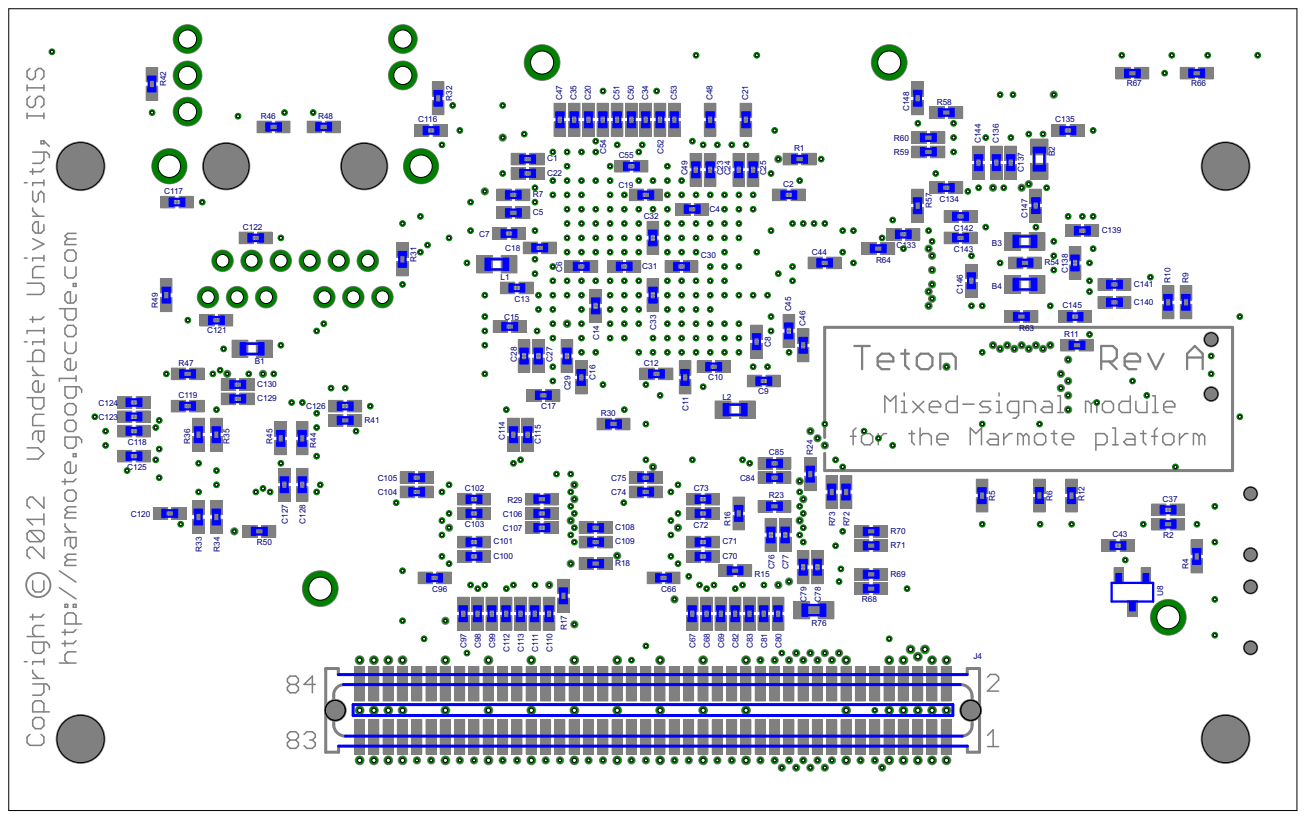
[picture p109: page 2]

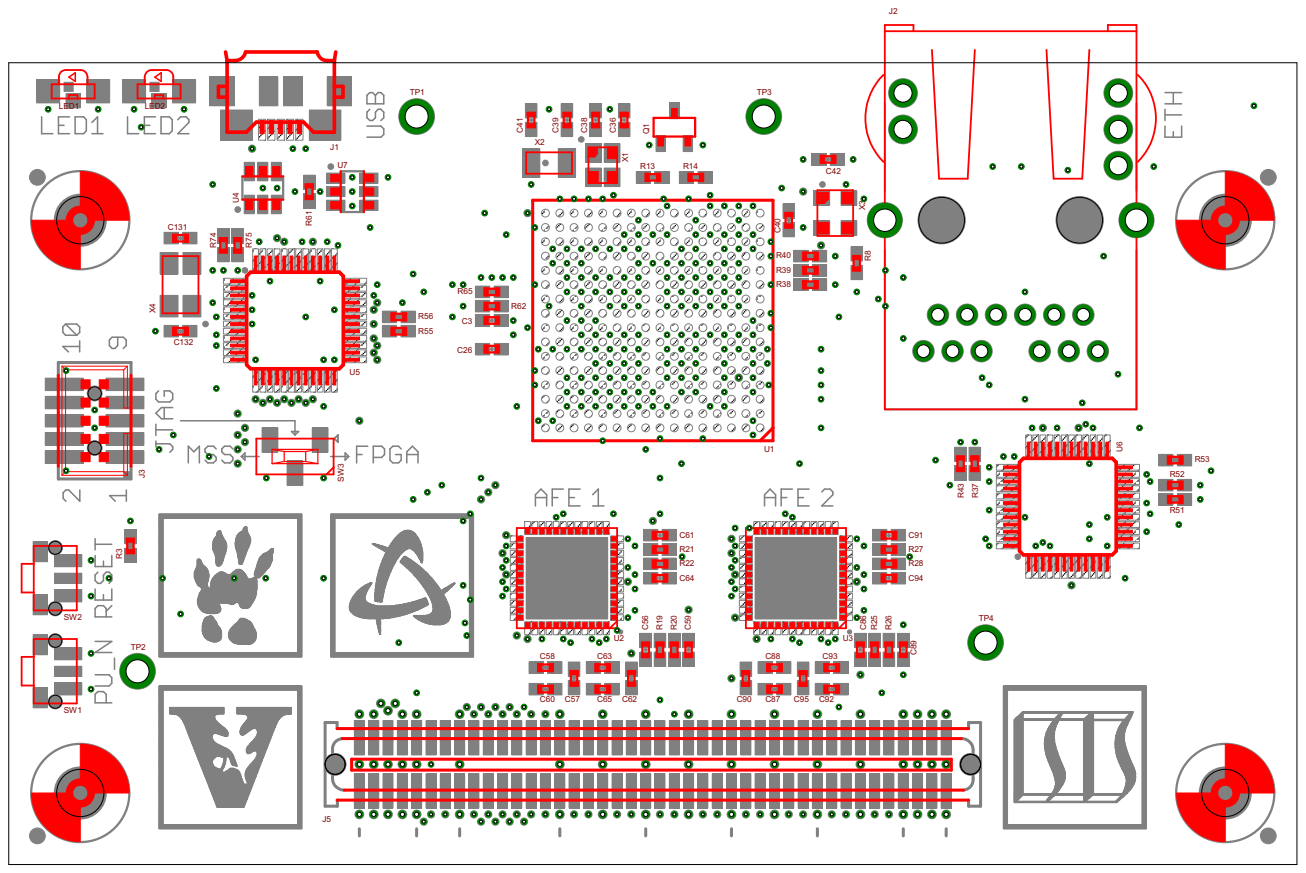
[picture p110: page 3]
