marmote/marmote/hardware/RFWBBoard_RevA/RFWBBoard_RevA_Asy.pdf

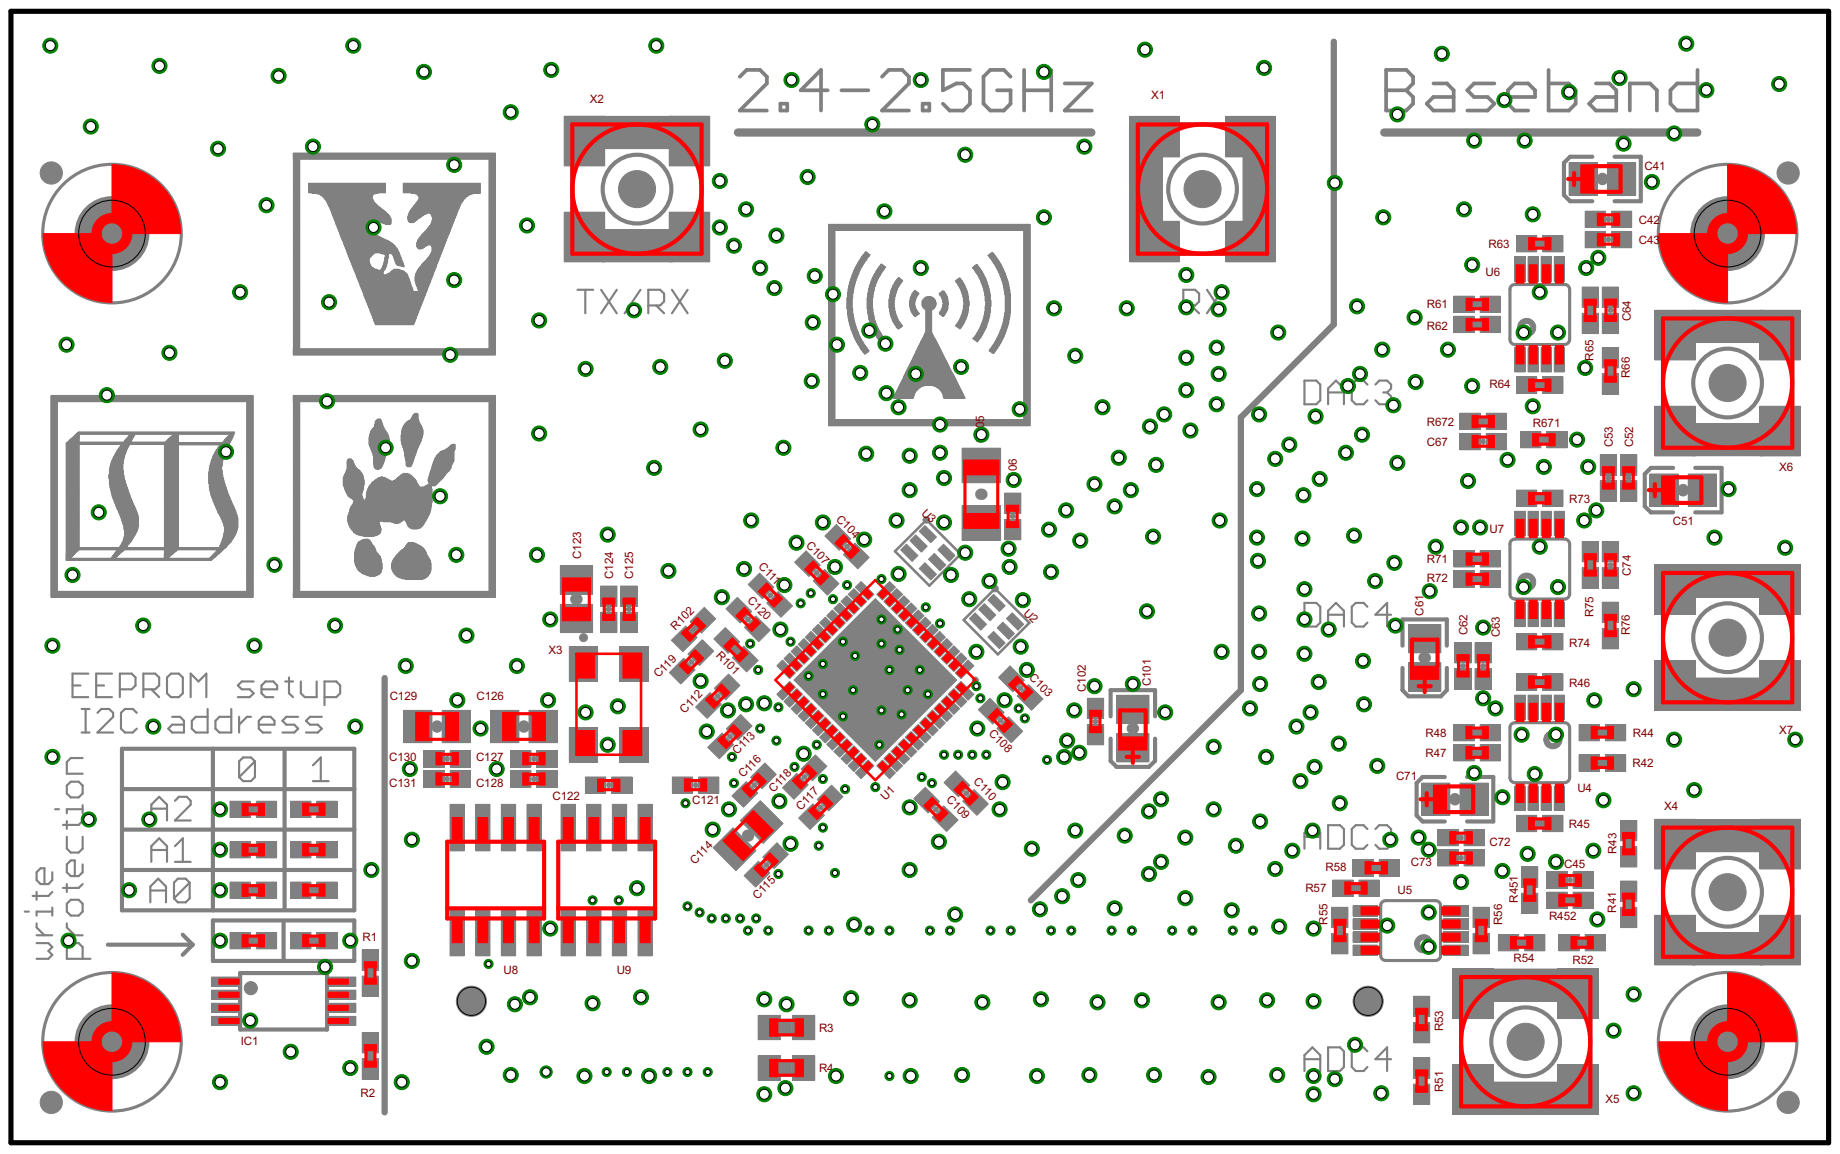
[picture p111: page 1]

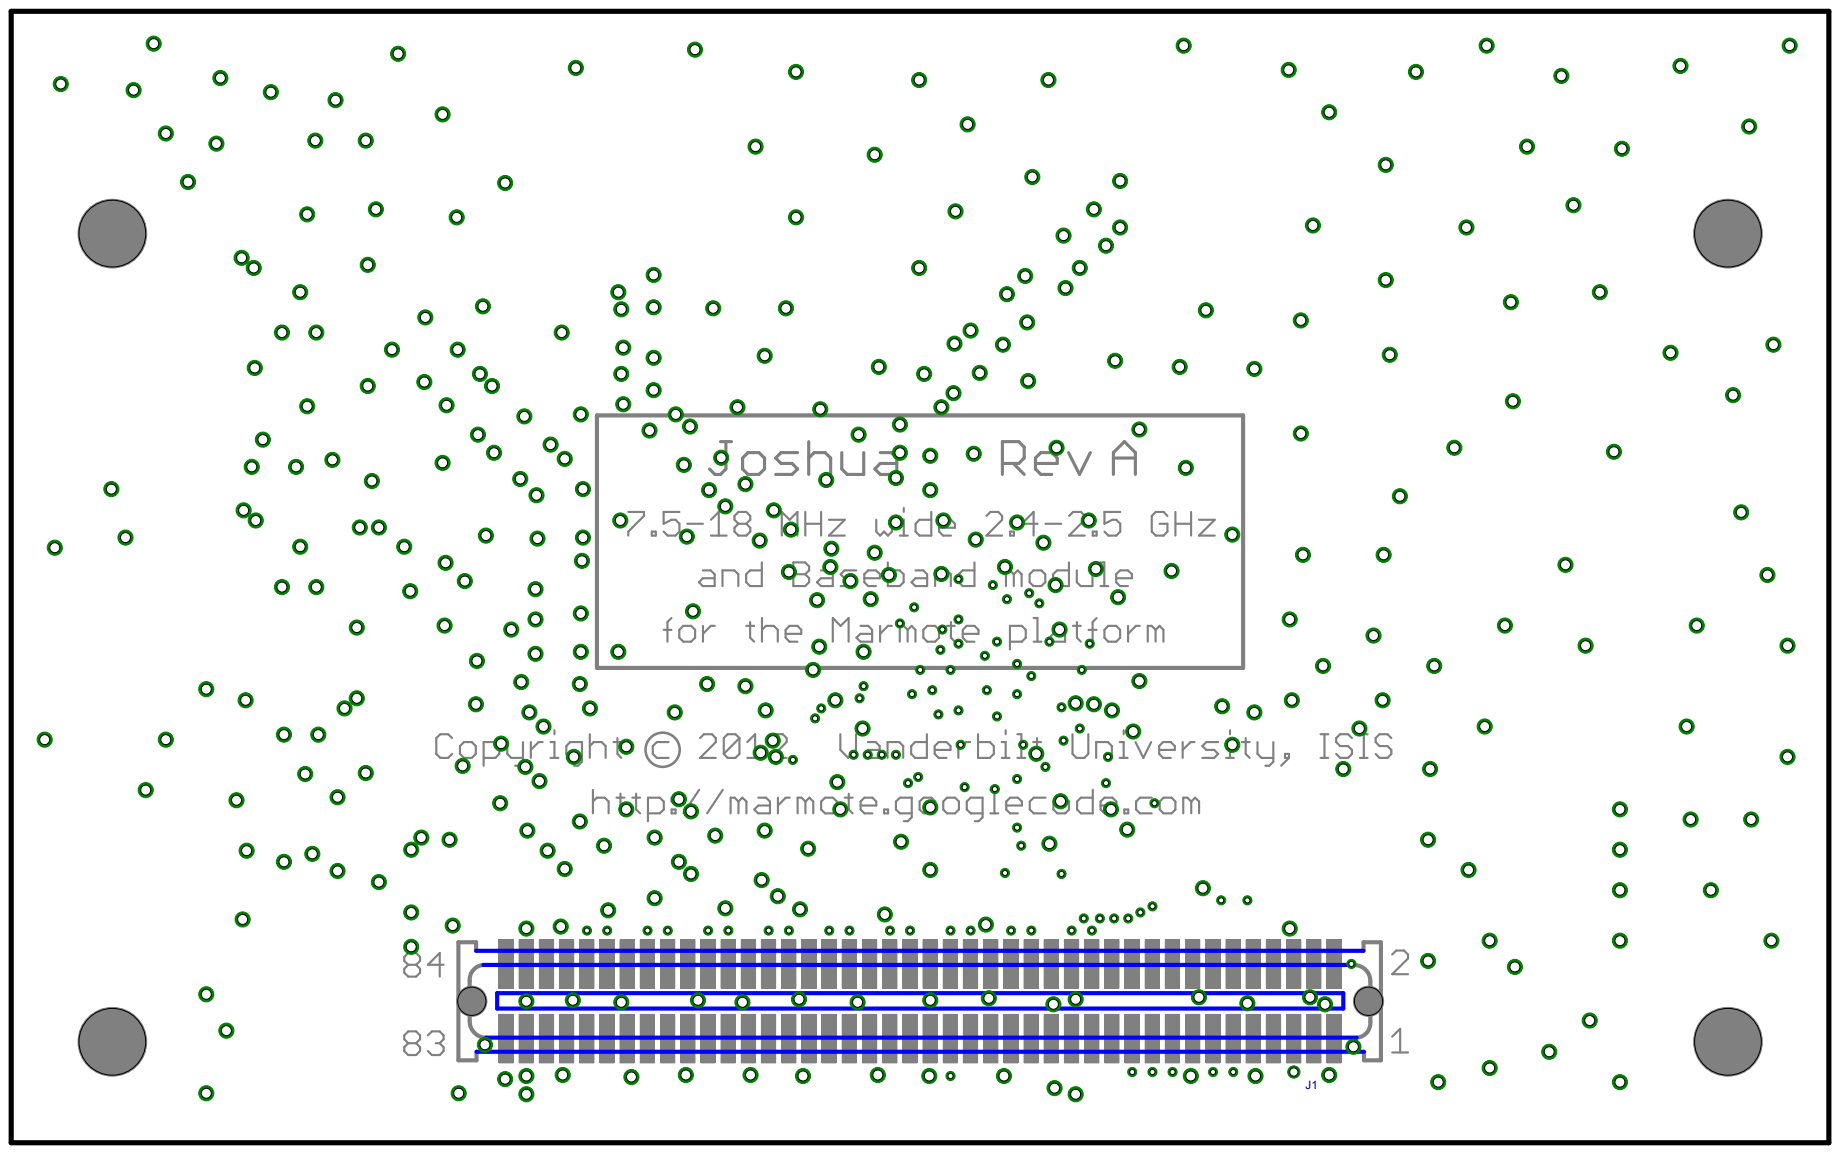
[picture p112: page 2]
