marmote/marmote/hardware/PowerBoard_RevB/PowerBoard_RevB_Asy.pdf

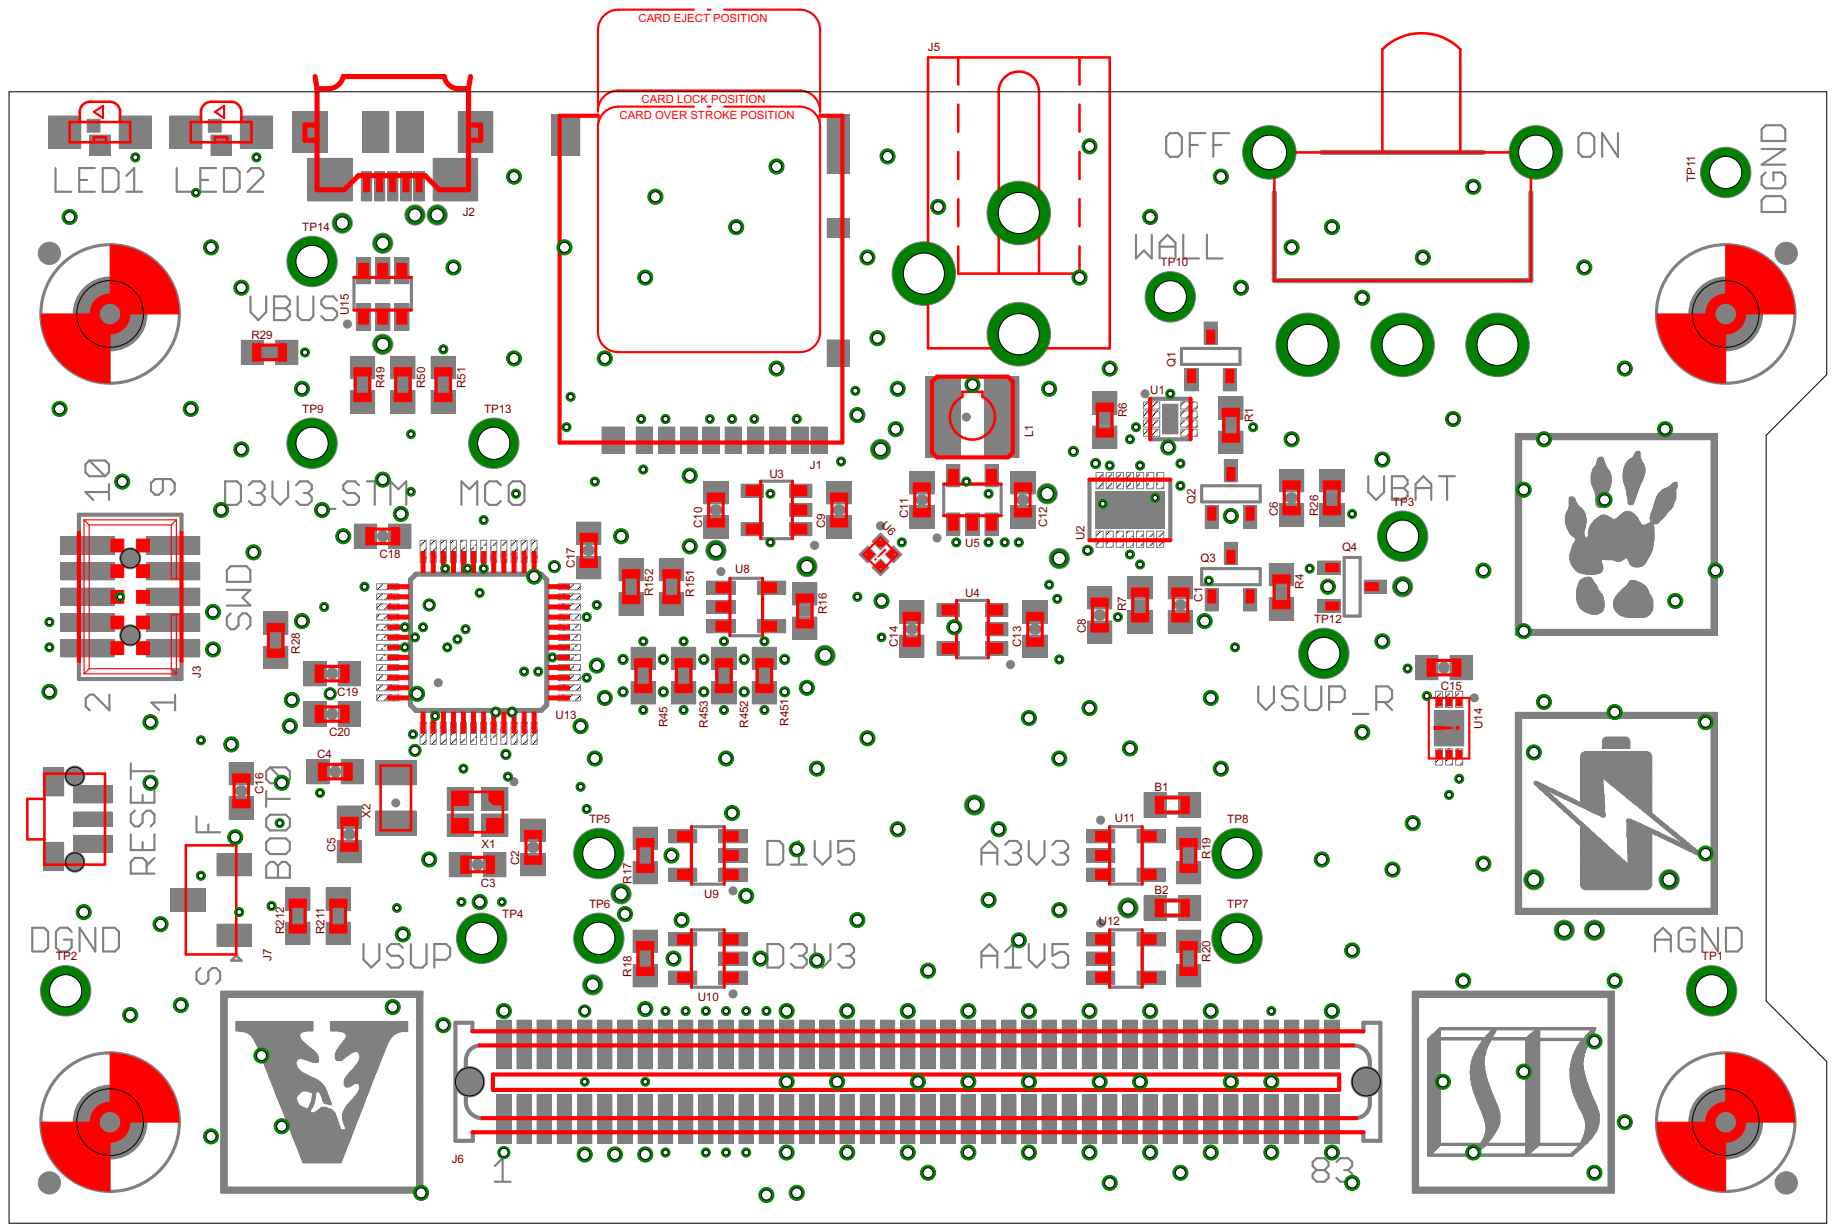
[picture p113: page 1]

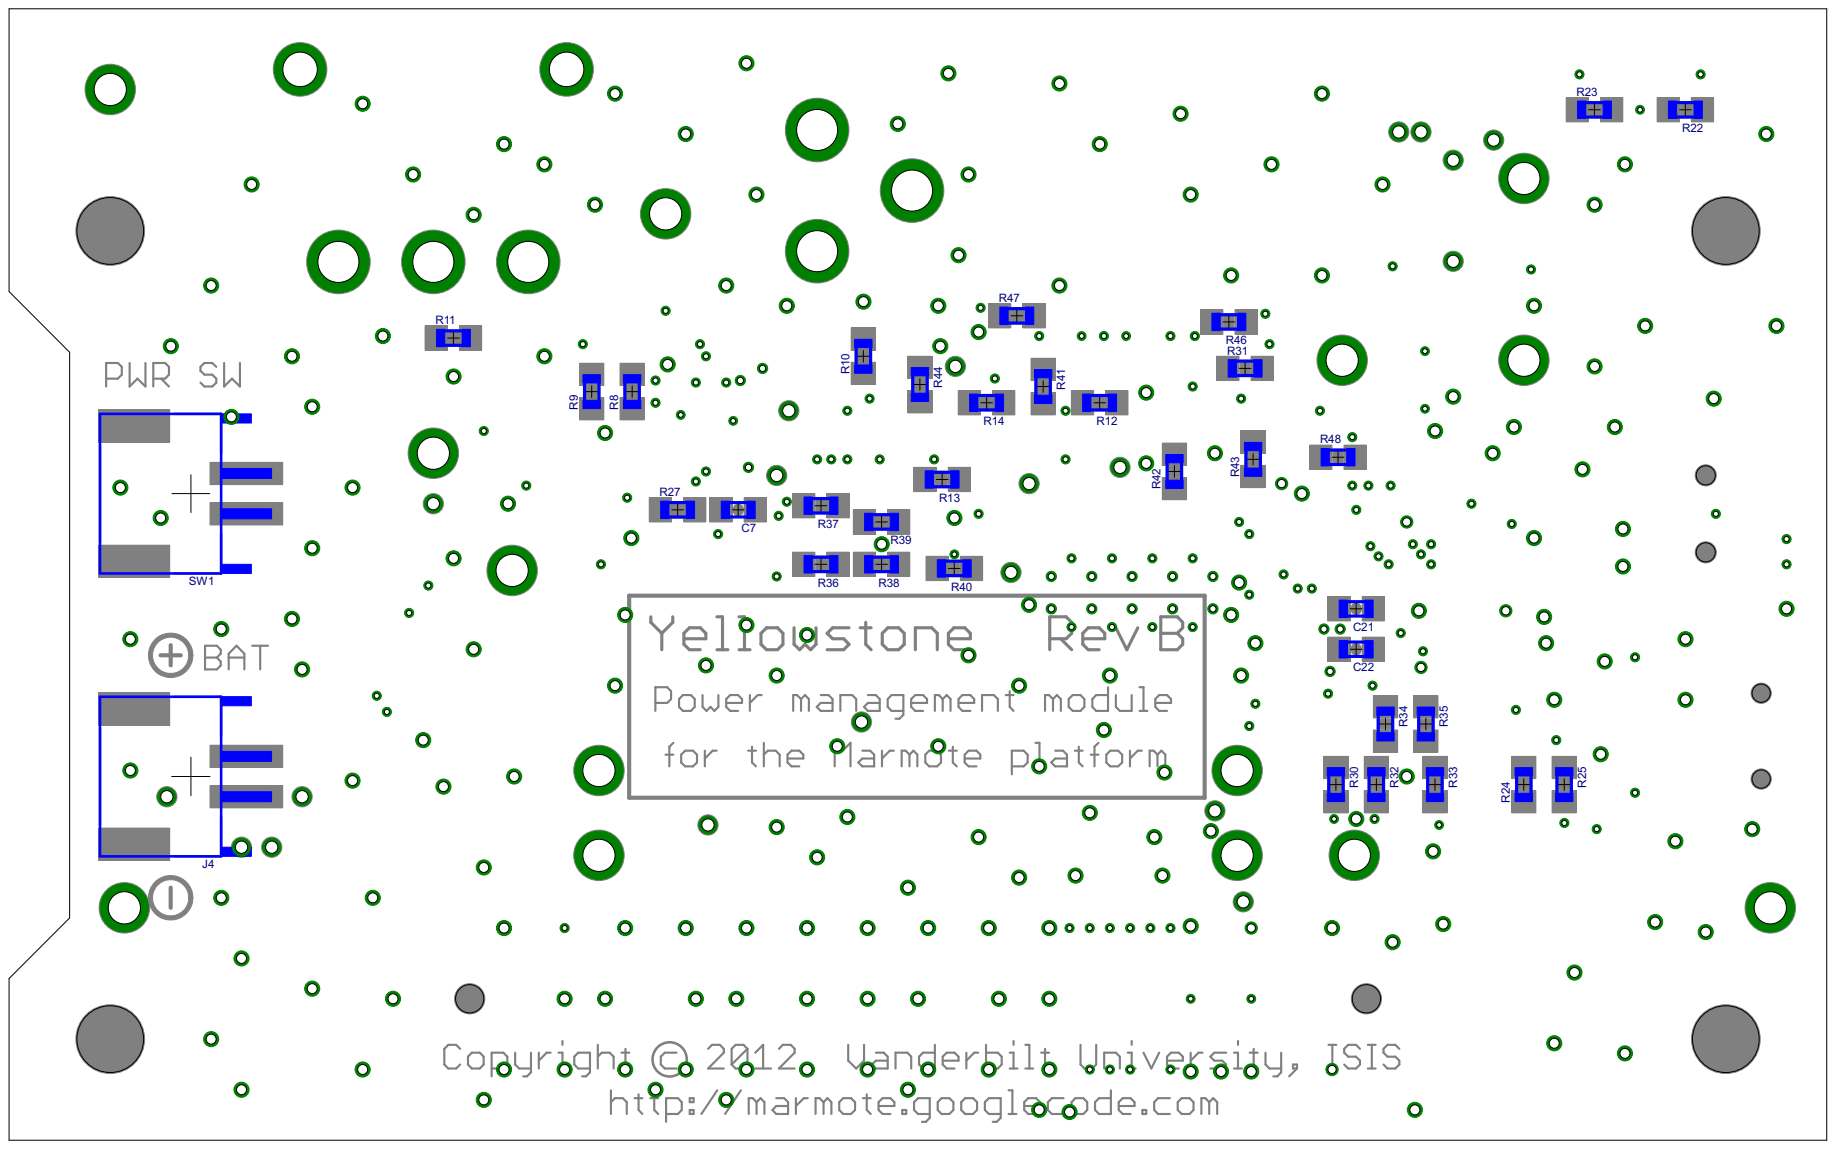
[picture p114: page 2]
