marmote/marmote/hardware/MainBoard_RevA/MainBoard_RevA_Sch.pdf

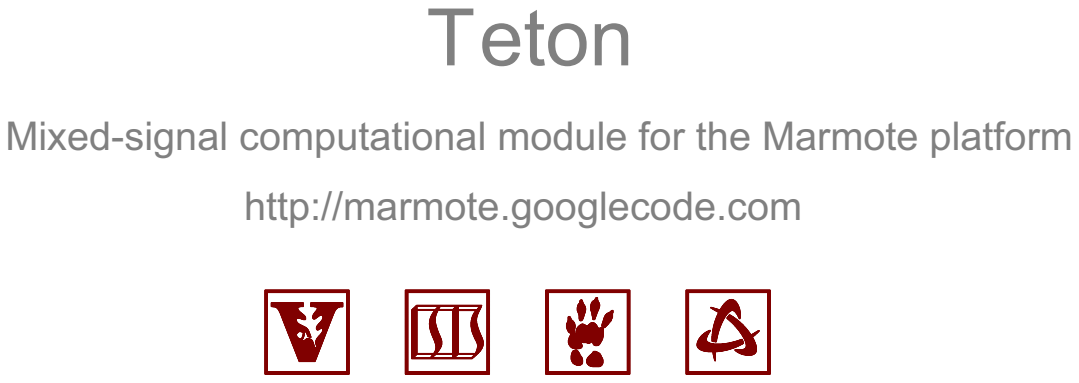
[picture p115: page 1]

Mixed-signal computational module for the Marmote platform

http://marmote.googlecode.com

Pages: 1 -2 - 3 - 4 - 5 - Cover page 6 - 7 - 8 - 9 - 10 - External AFE #2 SF supply pins Ethernet Clock, reset, JTAG USB and AFE dig. SF AFE I/O signals External AFE #1 Connectors | Designed by: Sandor Szilvasi sandor.szilvasi@vanderbilt.edu | Cover page

Verified by: Peter Volgyesi peter.volgyesi@vanderbilt.edu | Title: Teton | Rev: A

Date: 3/19/2012 10:31:08 AM | Sheet: 1/10

Copyright © 2012 Vanderbilt University, ISIS

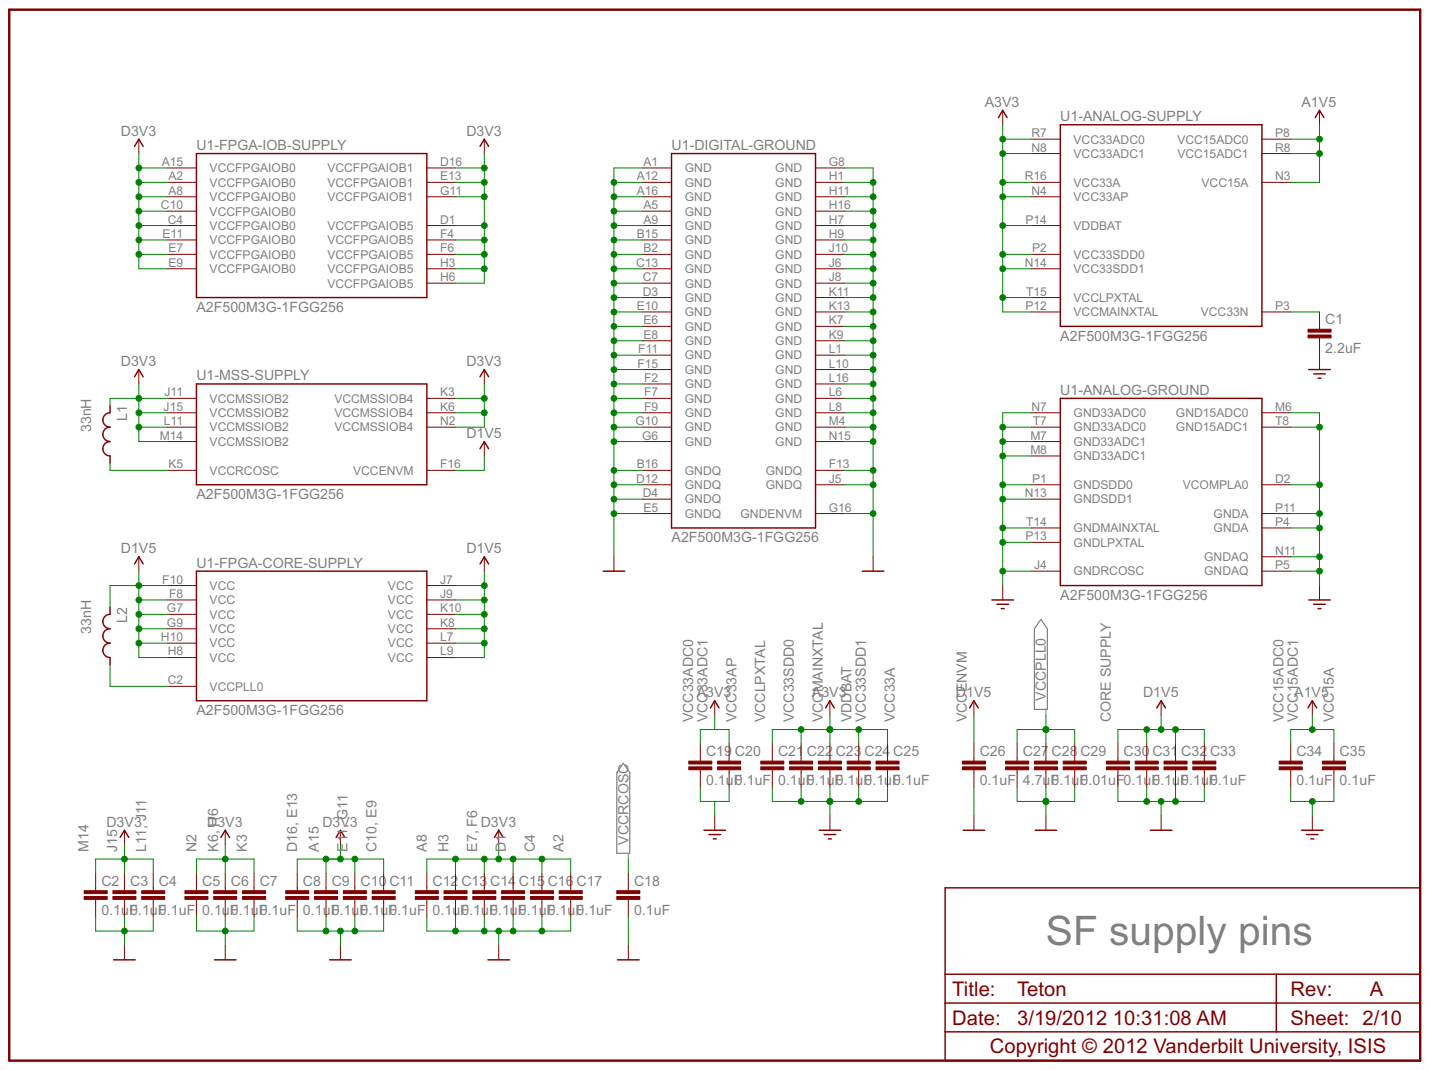
[picture p116: page 2]

Title: Teton | Rev: A
Date: 3/19/2012 10:31:08 AM | Sheet: 2/10

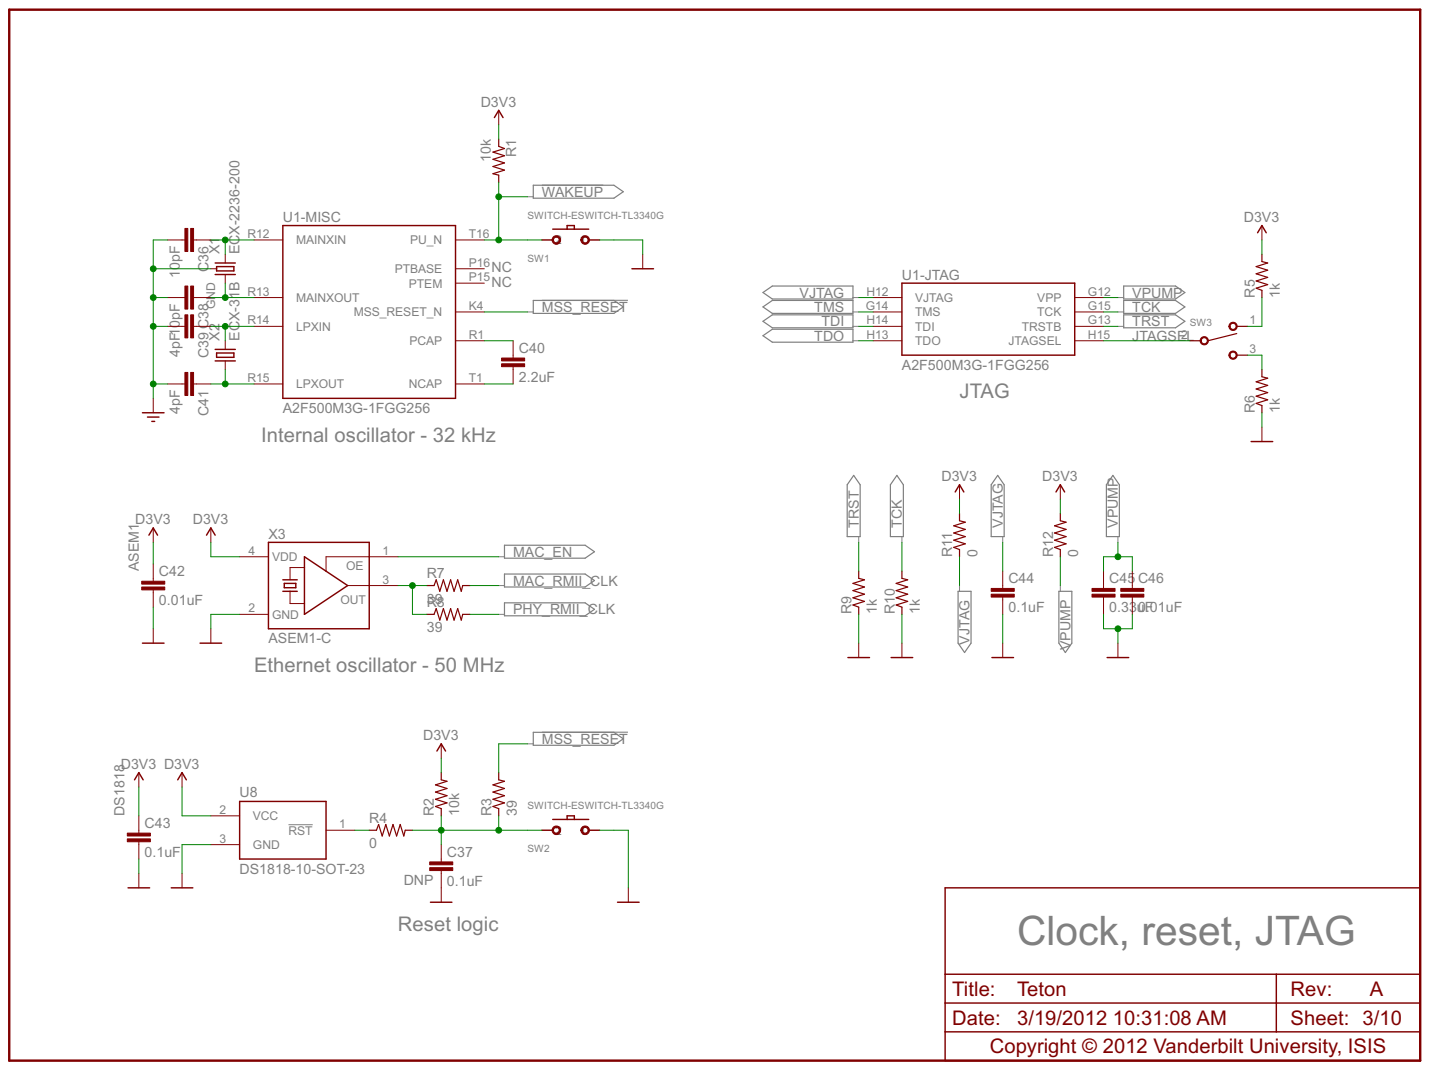
[picture p117: page 3]

Title: Teton | Rev: A
Date: 3/19/2012 10:31:08 AM | Sheet: 3/10

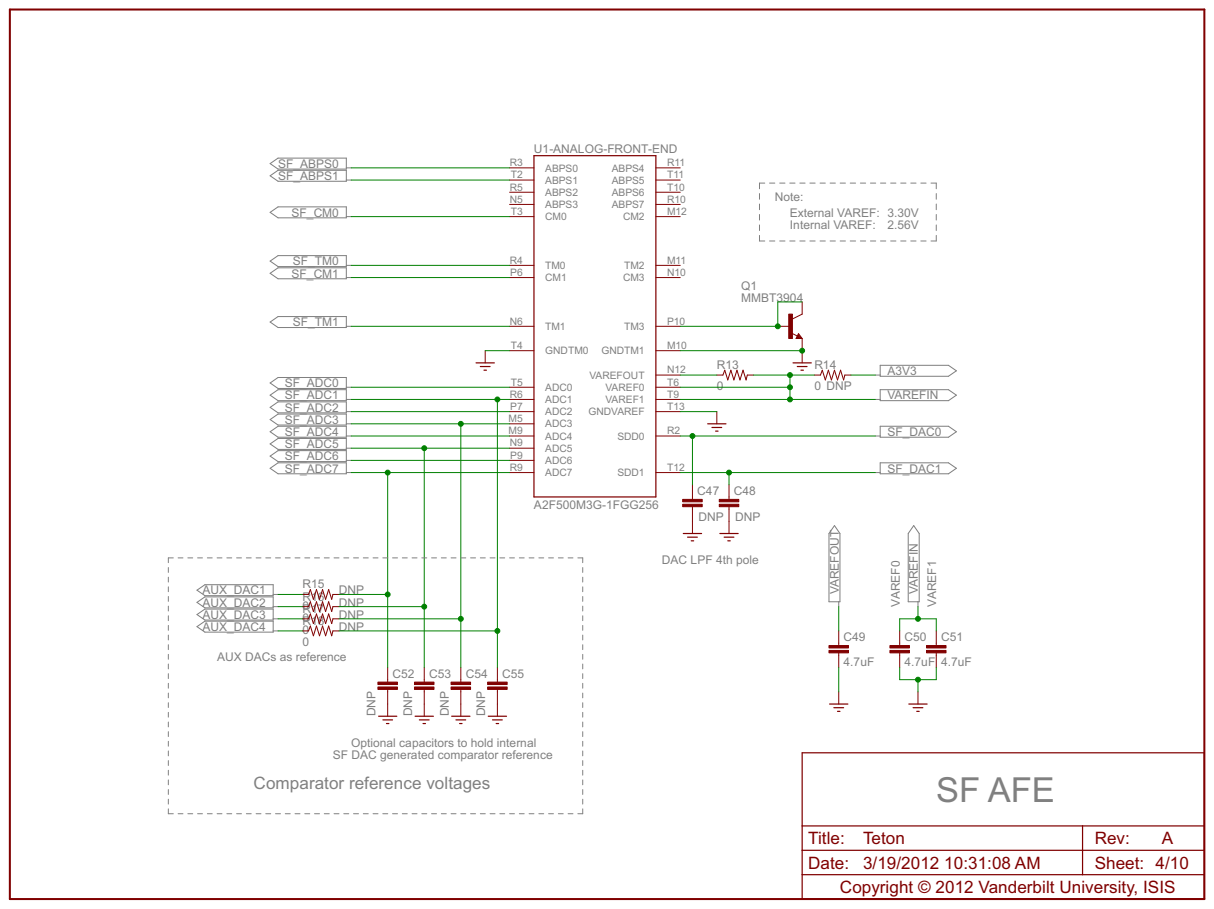
[picture p118: page 4]

AUX DACs as reference

DNP DNP

Optional capacitors to hold internal
SF DAC generated comparator reference

Title: Teton | Rev: A
Date: 3/19/2012 10:31:08 AM | Sheet: 4/10

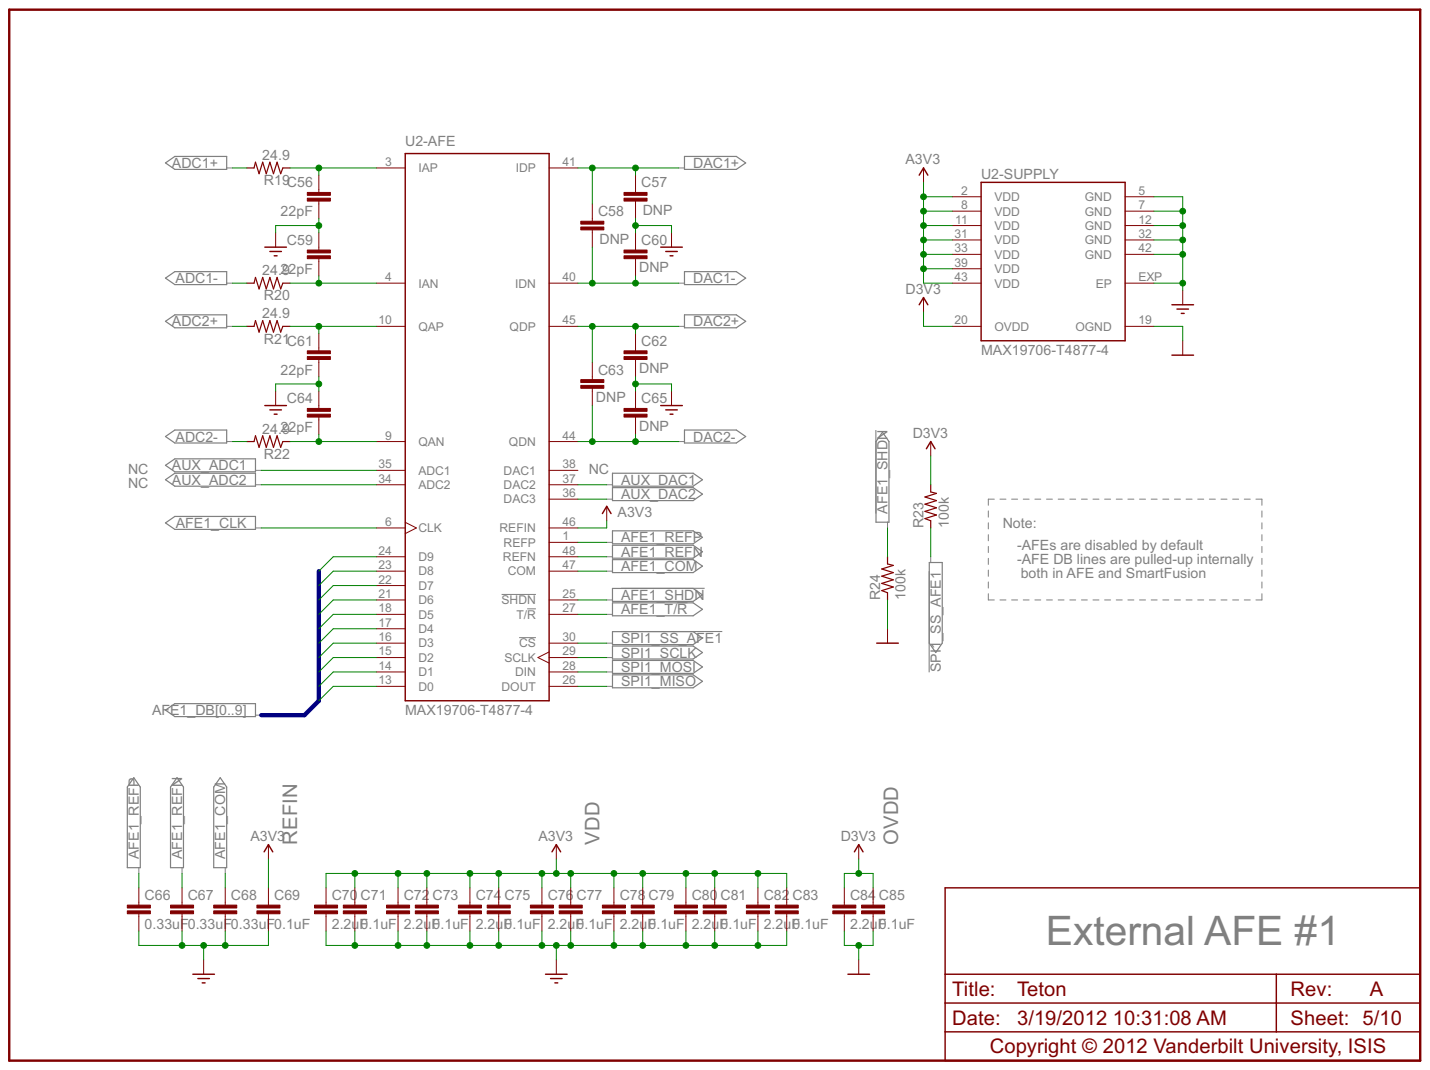
[picture p119: page 5]

Note:
-AFEs are disabled by default
-AFE DB lines are pulled-up internally
both in AFE and SmartFusion

Title: Teton | Rev: A
Date: 3/19/2012 10:31:08 AM | Sheet: 5/10

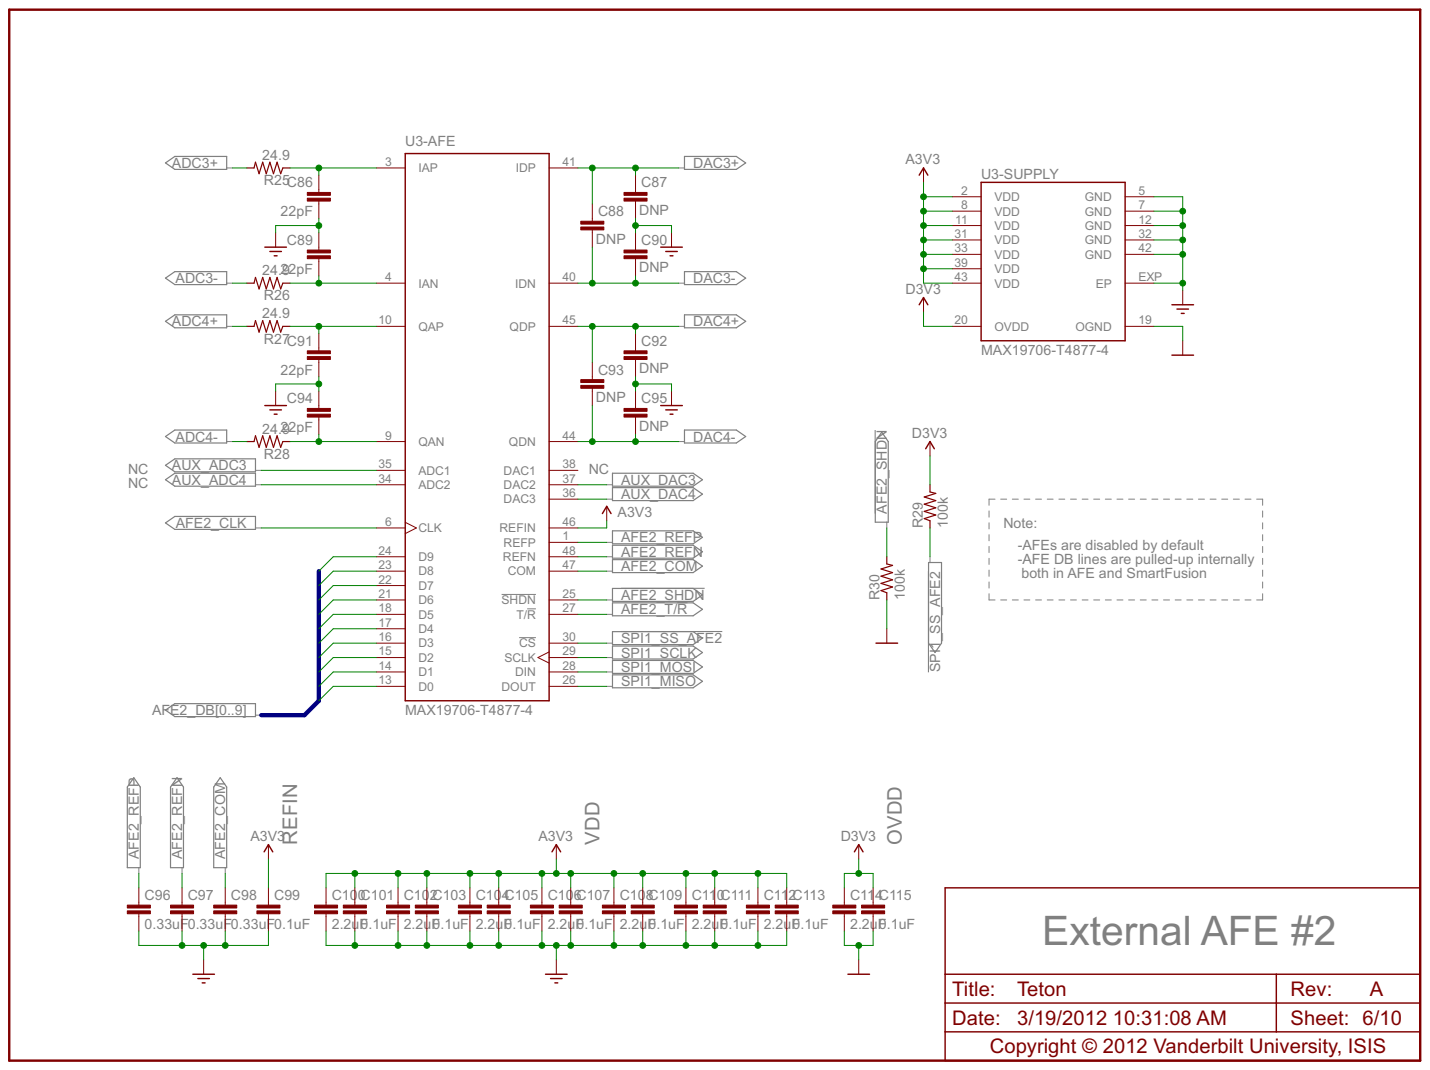
[picture p120: page 6]
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

Title: Teton | Rev: A
Date: 3/19/2012 10:31:08 AM | Sheet: 6/10

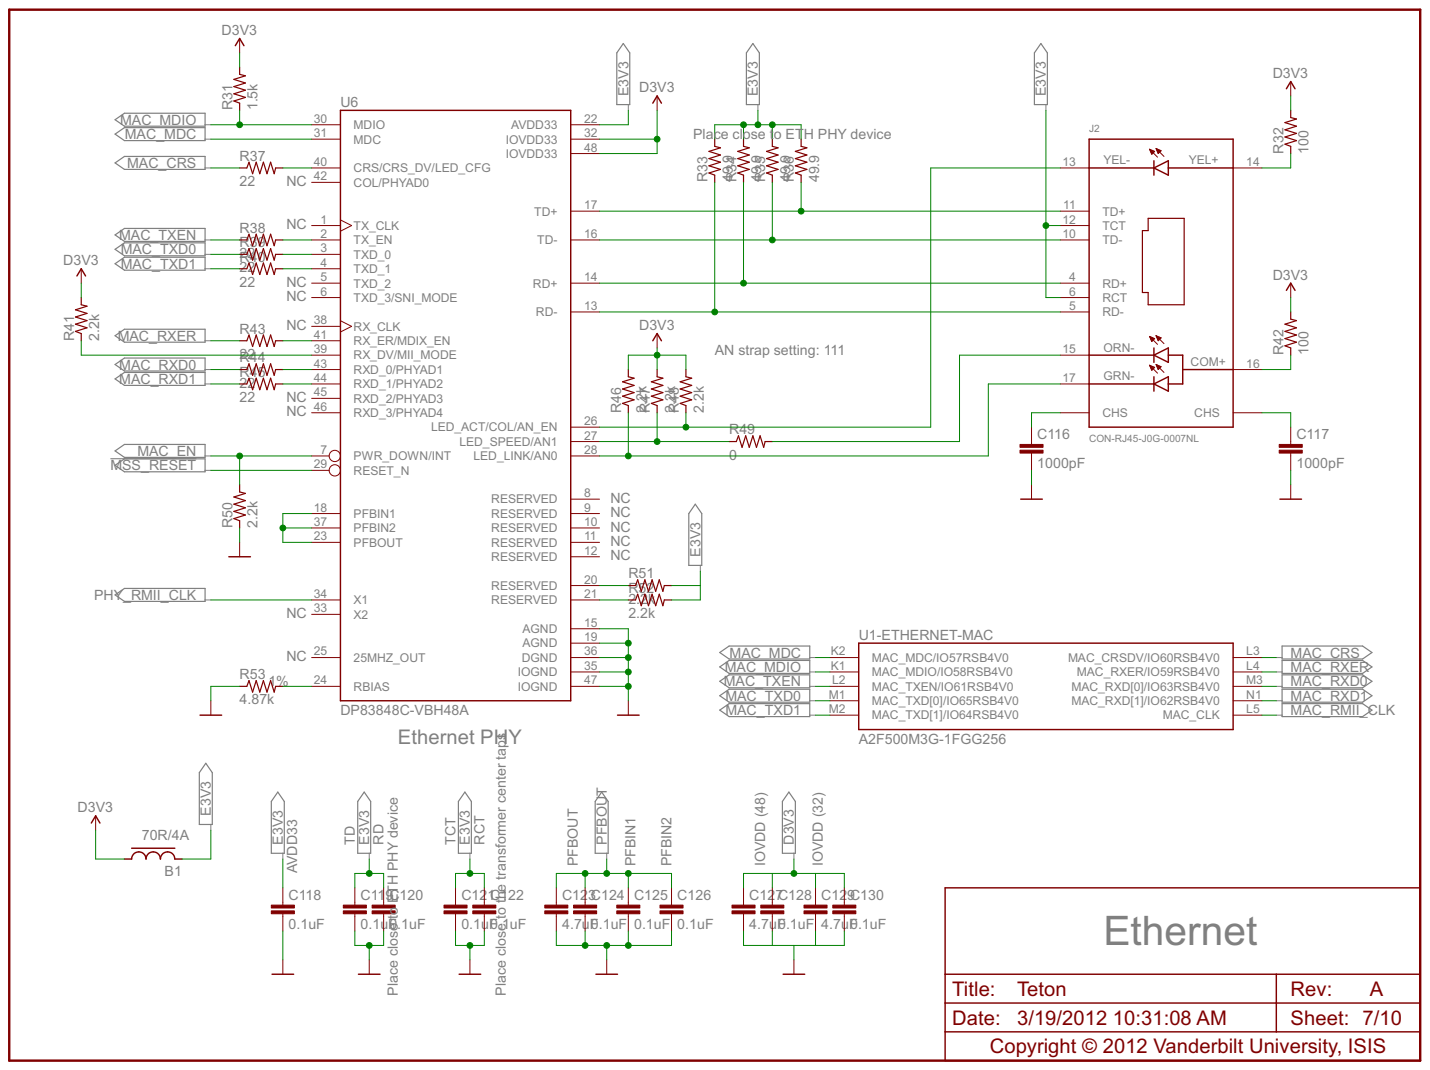
[picture p121: page 7]

Place close to ETH PHY device

AN strap setting: 111 | 15

Place close to the transformer center taps

Title: Teton | Rev: A
Date: 3/19/2012 10:31:08 AM | Sheet: 7/10

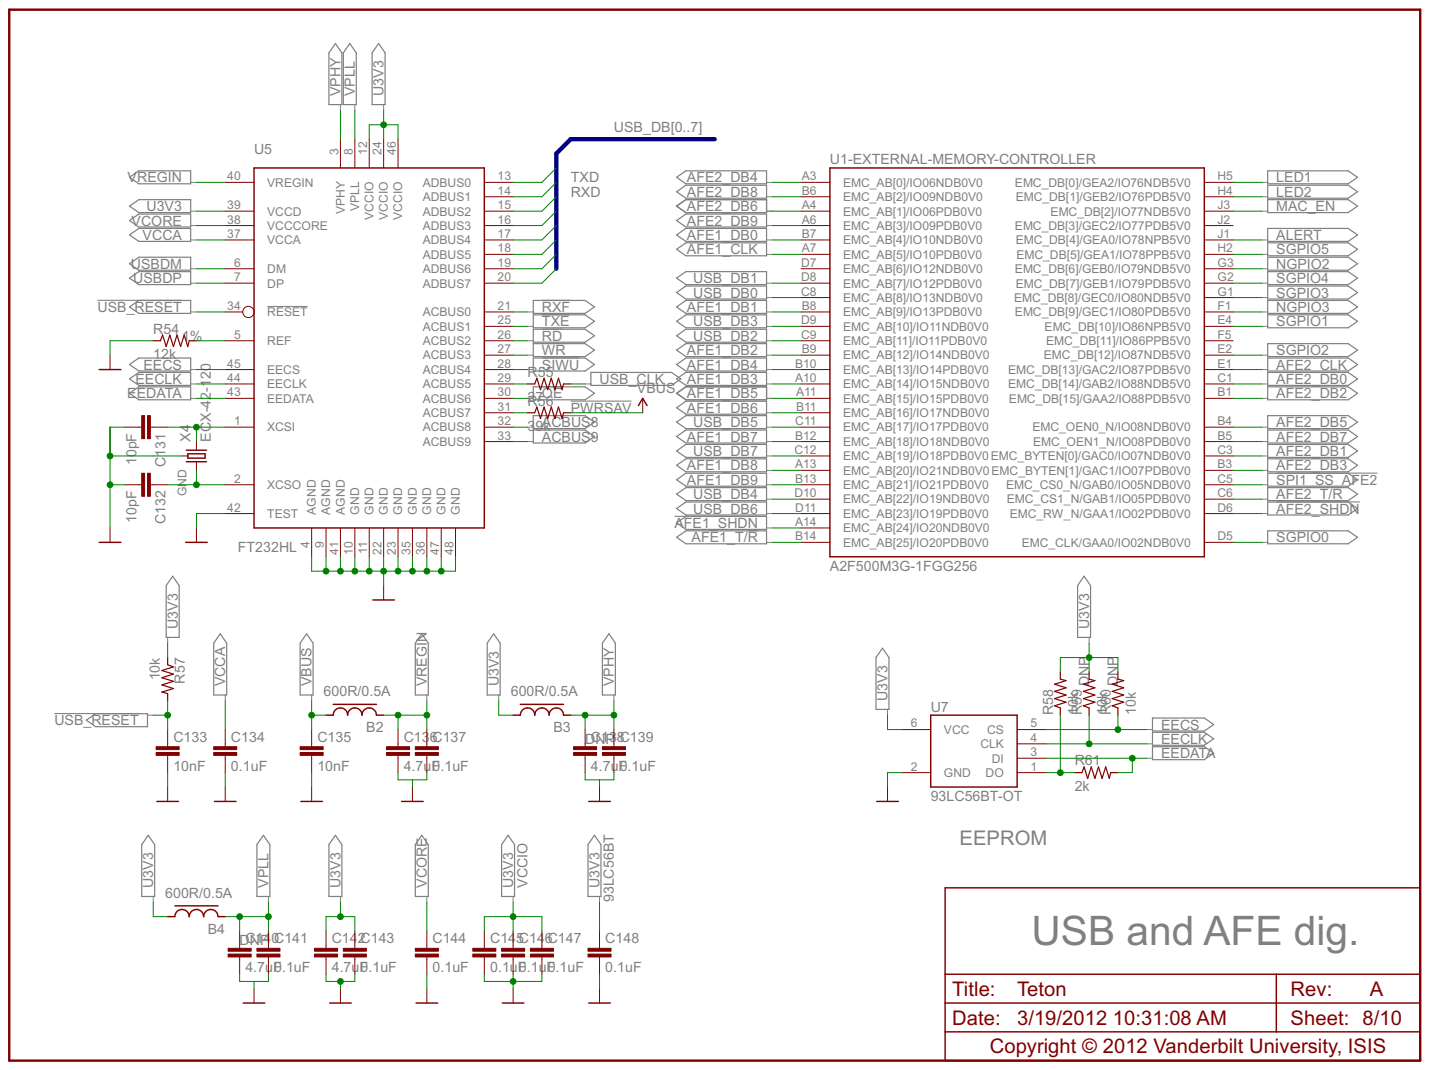
[picture p122: page 8]

USB and AFE dig.

Title: Teton | Rev: A
Date: 3/19/2012 10:31:08 AM | Sheet: 8/10

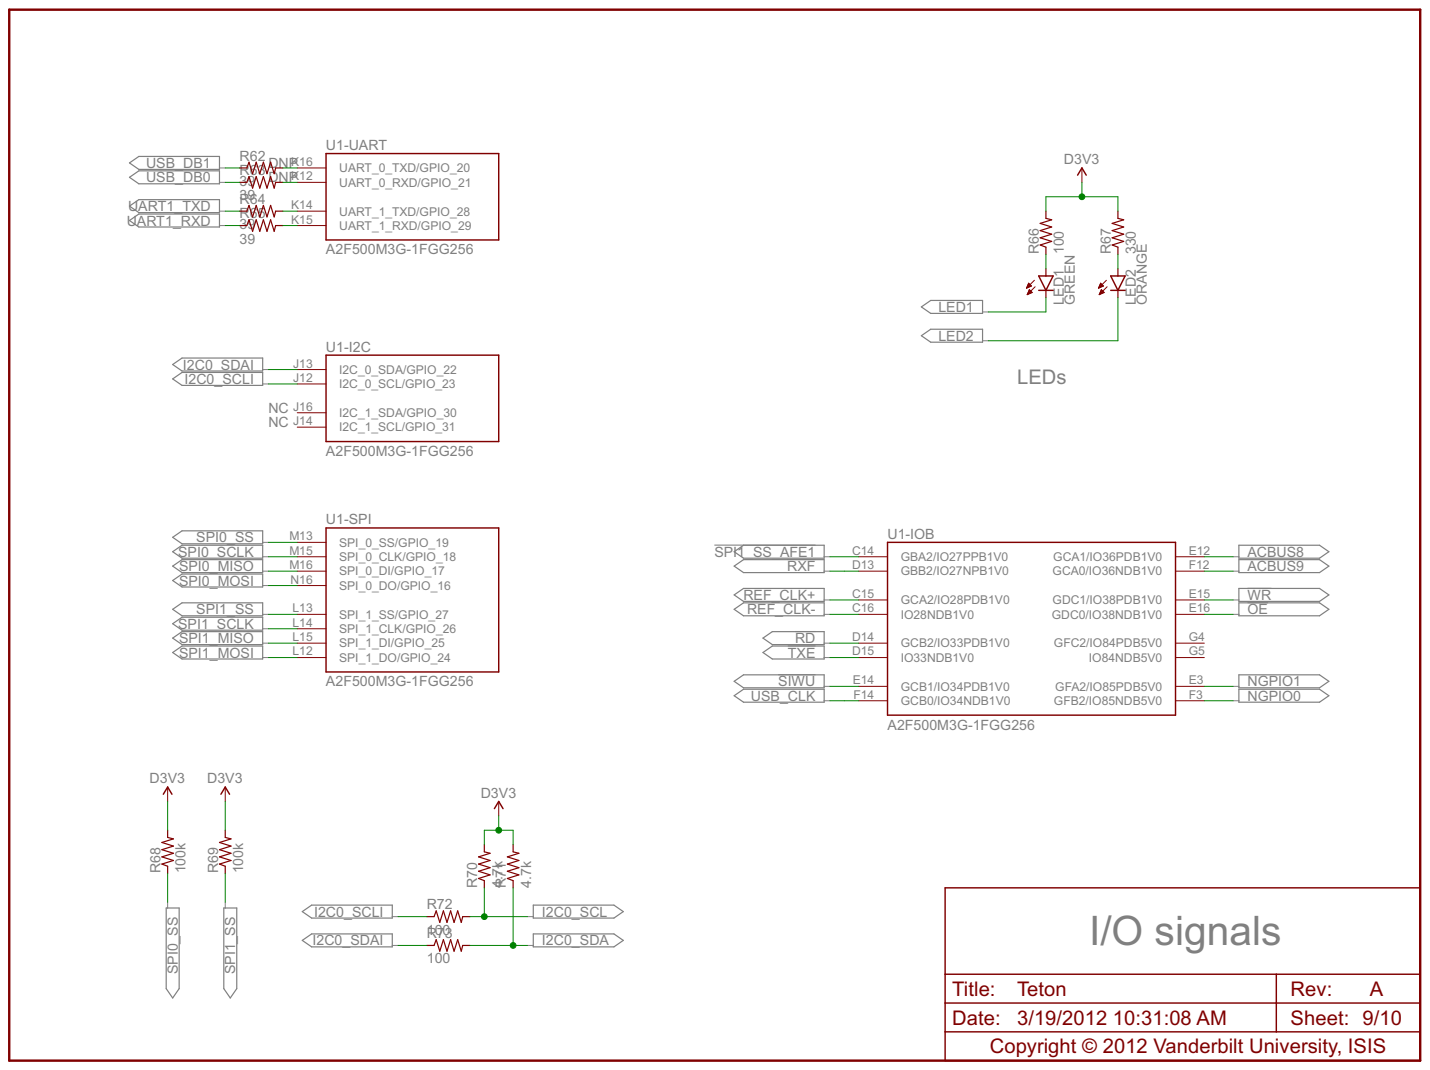
[picture p123: page 9]

Title: Teton | Rev: A
Date: 3/19/2012 10:31:08 AM | Sheet: 9/10

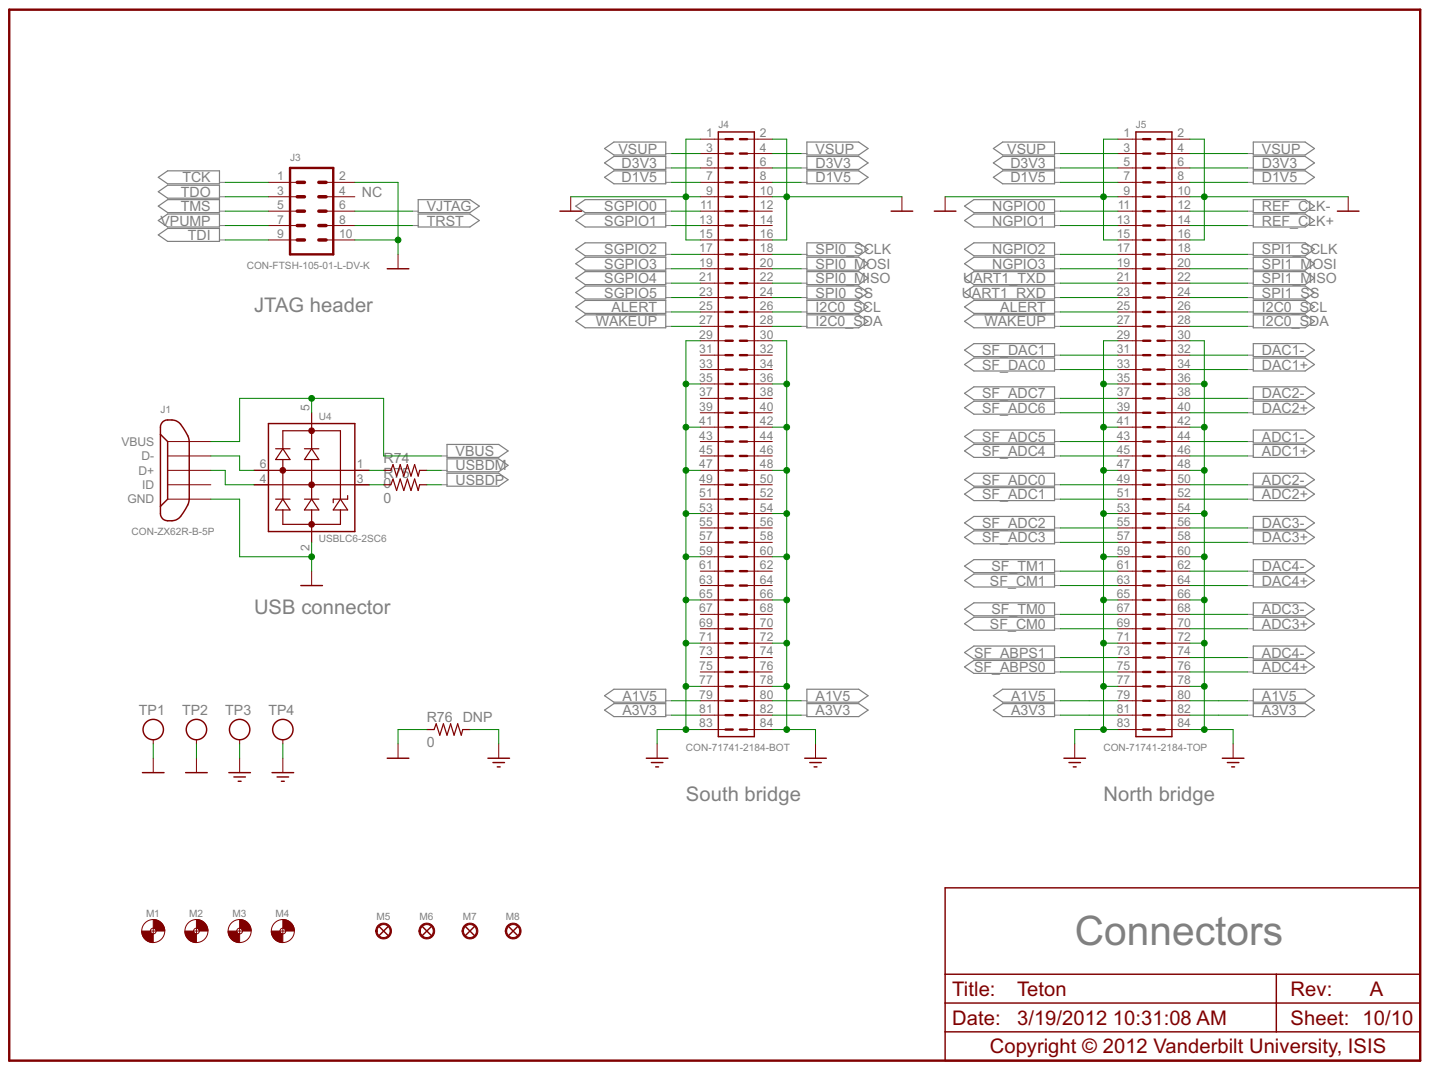
[picture p124: page 10]

Title: Teton | Rev: A
Date: 3/19/2012 10:31:08 AM | Sheet: 10/10
