marmote/marmote/hardware/BreakoutBoard_RevA/BreakoutBoard_RevA_Asy.pdf

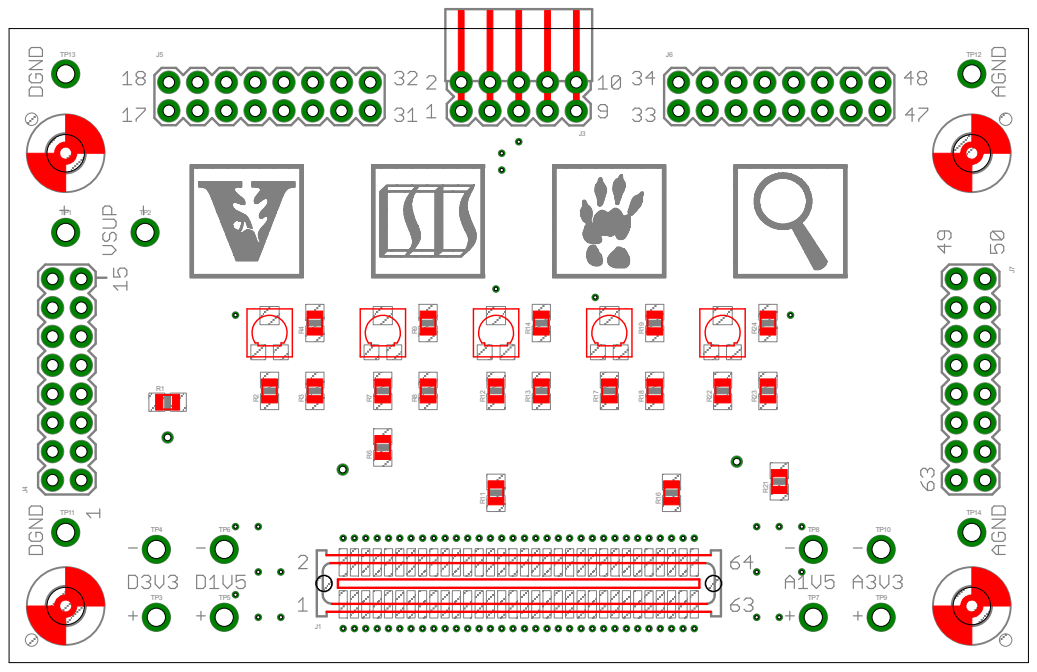
[picture p125: page 1]

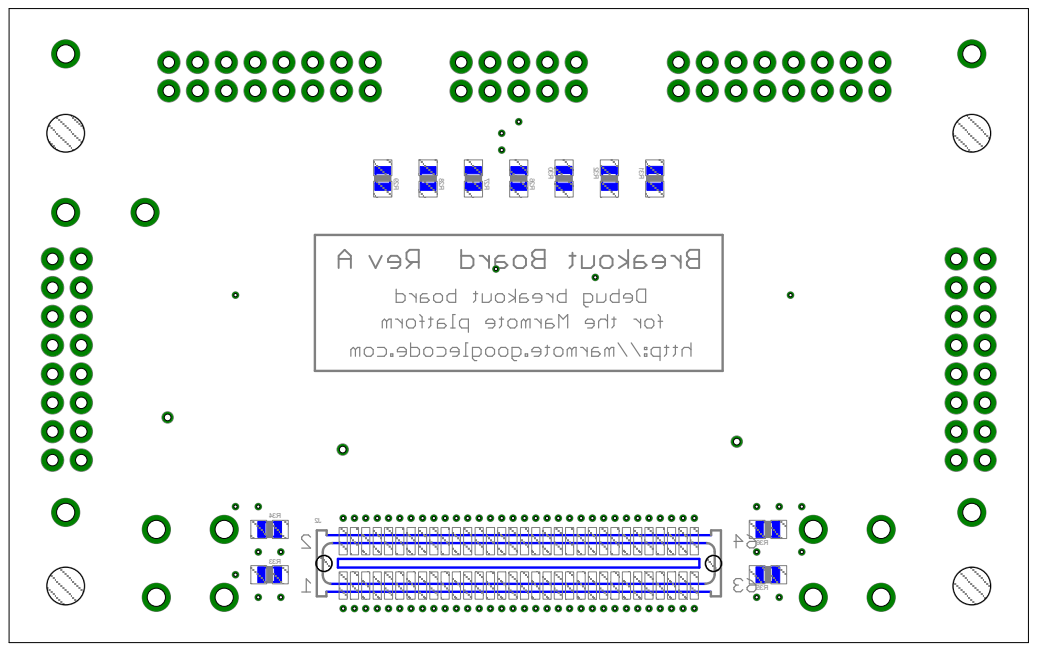
[picture p126: page 2]
