marmote/marmote/hardware/PowerBoard_RevA/PowerBoard_RevA_Asy.pdf

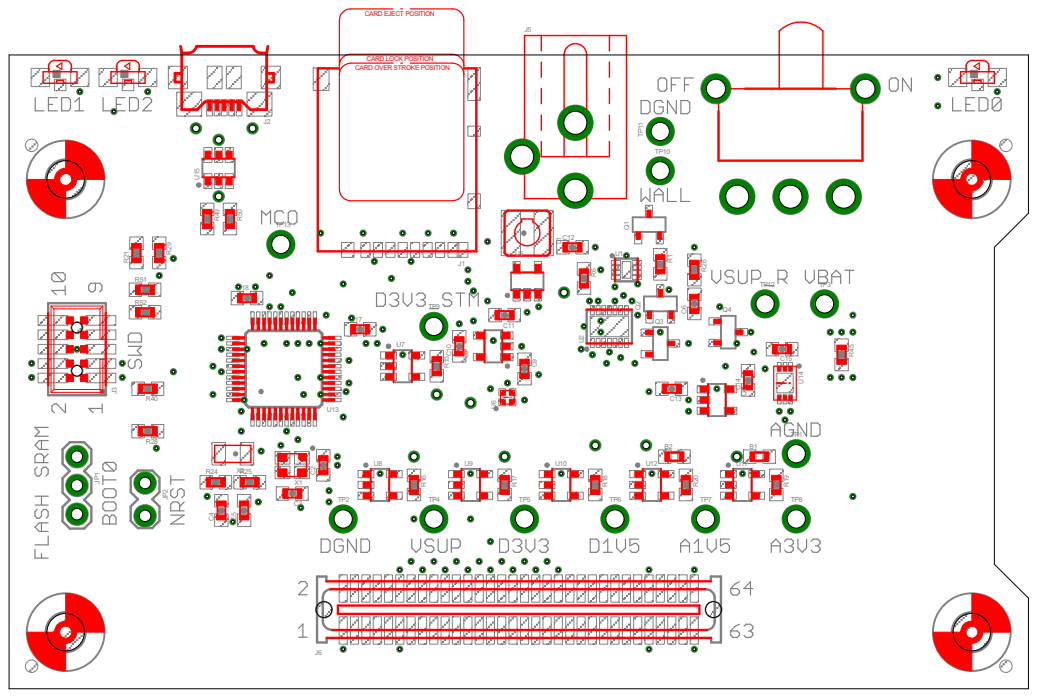
[picture p127: page 1]

CARD LOCK POSITION
CARD OVER STROKE POSITION

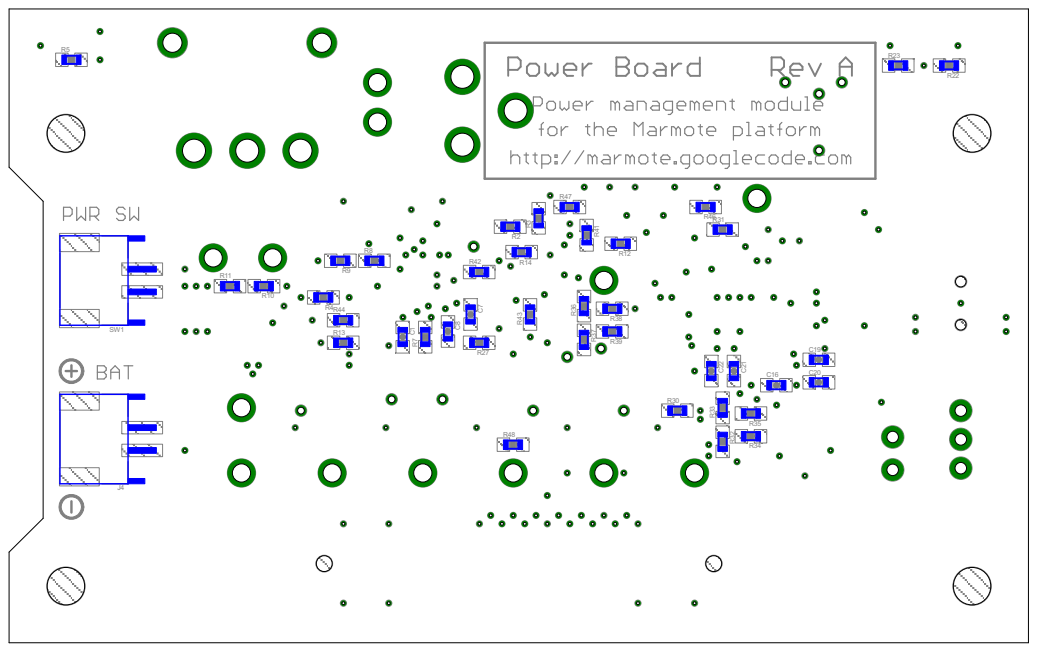
[picture p128: page 2]
