marmote/marmote/firmware/A2F-EVAL-KIT/DecimationFilters/CIC/old_CIC_solutions/CIC_FABRIC_SRAM/CIC_COMB.pdf

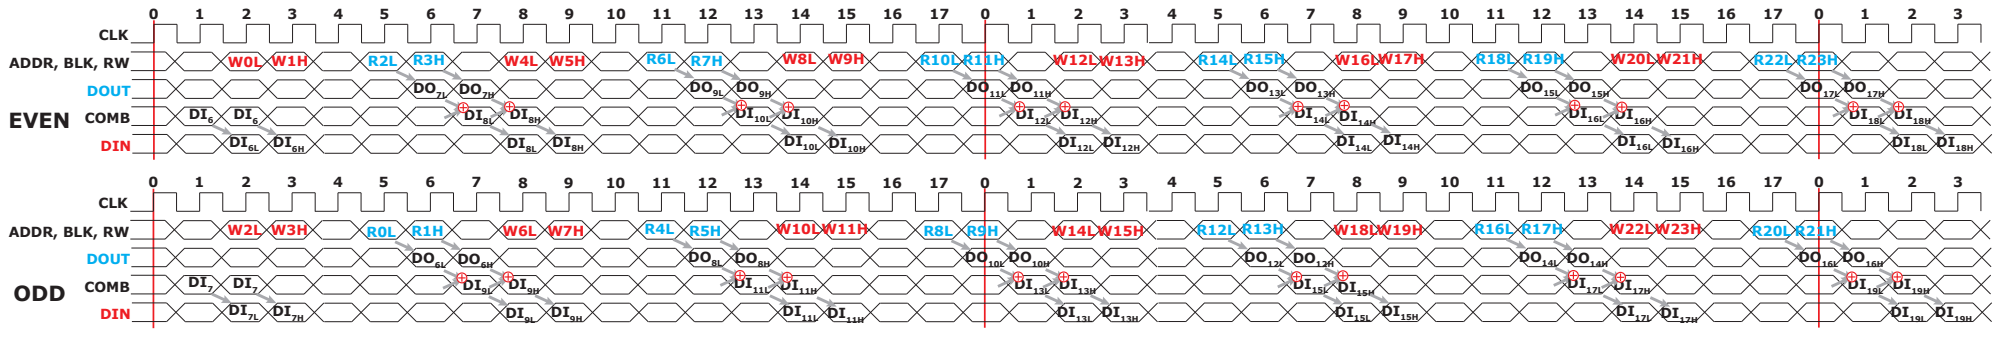
[picture p129: page 1]
