marmote/marmote/firmware/A2F-EVAL-KIT/DecimationFilters/CIC/old_CIC_solutions/CIC_FABRIC/CIC.pdf

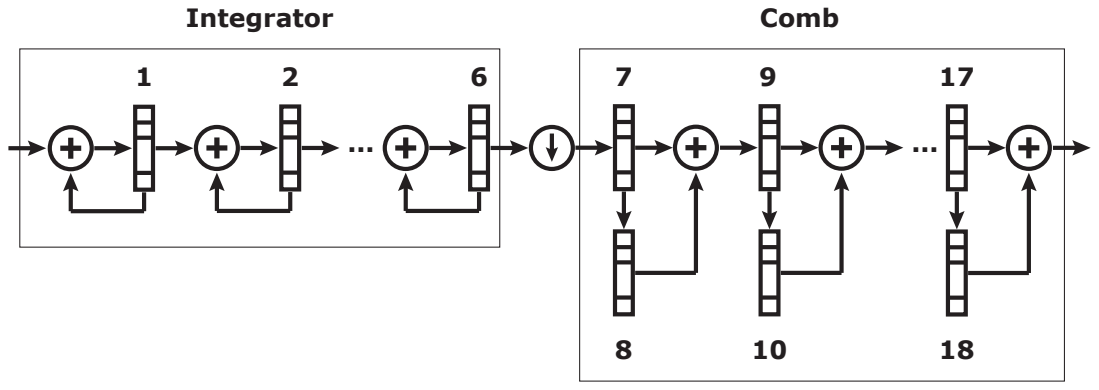
[picture p130: page 1]
Integrator; Comb
