marmote/marmote/firmware/A2F-EVAL-KIT/DecimationFilters/CIC/old_CIC_solutions/CIC_SRAM/CIC.pdf

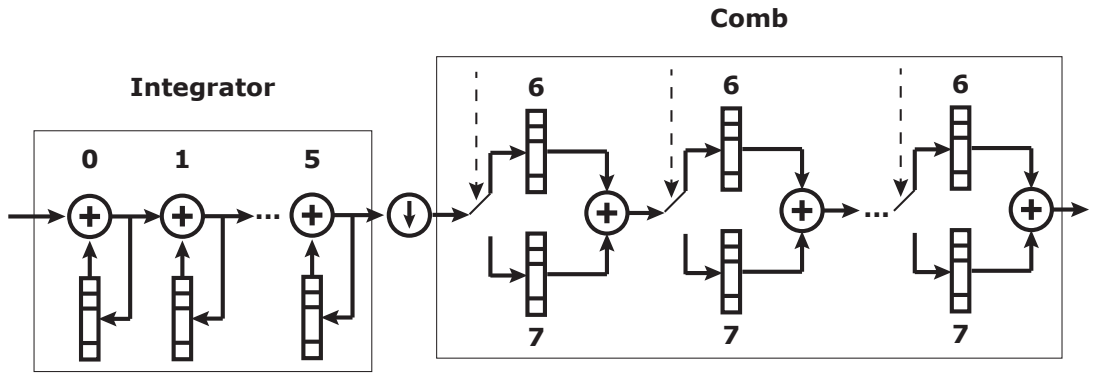
[picture p131: page 1]
Integrator; Comb
