marmote/marmote/firmware/A2F-EVAL-KIT/DecimationFilters/CIC/old_CIC_solutions/CIC_SRAM/CIC_COMB.pdf

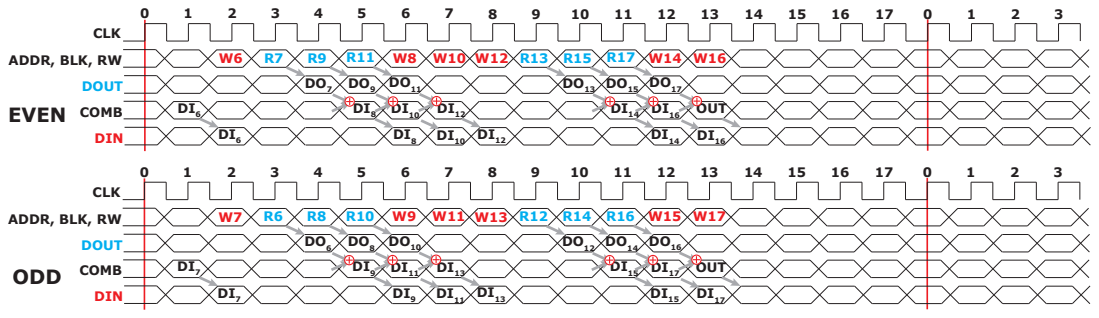
[picture p132: page 1]
