marmote/marmote/hardware/AE sensor supply/AE PKWDI - opamp.asc

C1: cap; 1µ; ""
C2: cap; 1µ; ""
C3: cap; 10µ; ""
R1: res; 1.566k
R2: res; 1.566k
R3: res; 1.304
R4: res; 1.304
R5: res; 10k
R6: res; 10k
Rbias1: res; 100k; ""
Rbias2: res; 100k; ""
Rin: res; 42.14
Rp1: res; 50; ""
Rp2: res; 1038; ""
U1: ad8132
V1: voltage; 0; ""
V2: voltage; 0; AC 1V; ""
Vs2: voltage; 3.3; ""; Rser=0
Vs: voltage; 5; ""; Rser=0
Named nets: 0, v1, v2, Vs2, v3, v4, Vbias, phi1, phi2
RF board
Supply
AE sensor
Noise
.ac dec 10 1 100k
