marmote/marmote/hardware/AE sensor supply/AE VS375-RIC - opamp.asc

C1_it: cap; 1µ; ""
C2: cap; 1µ; ""
C2_it: cap; 0.1µ; ""
C3: cap; 10µ; ""
R1: res; 348; ""
R1_it: res; 10k
R2: res; 348; ""
R2_it: res; 1k
R3: res; 348; ""
R3_it: res; 50
R4: res; 348; ""
R4_it: res; 100k
R5: res; 49.9; ""
R5_it: res; 100k
R6: res; 24.9; ""
R7: res; 10k; ""
Rbias1: res; 100k; ""
Rbias1_it: res; 100k; ""
Rbias2: res; 100k; ""
Rbias2_it: res; 100k; ""
Rp1: res; 50; ""
U1: ad8132
U2: ad8132
Vs2: voltage; 3.3; ""; Rser=0
Vs: voltage; 28; ""; Rser=0
Vs_it: voltage; 3.3; ""; Rser=0
Named nets: 0, v1, v2, Vs2, v3, v4, Vbias, phi1, phi2, AE_sensor, Vbias_it, Vs_it
RF board
Impedance transformer
Supply
