marmote/marmote/hardware/Colpitts oscillator 40 MHz common collector/Colpitts_40MHz_com_coll.asc

C1: cap; 22p
C2: cap; 27p
C3: cap; 1000p
C4: cap; 5f; Rser=40 Lser=3.16m Rpar=100meg Cpar=2.5p
Q1: npn; 2N2222
R1: res; 8.2k
R2: res; 12k
R3: res; 1.5k
R4: res; 5k
V1: voltage; 3.3; ""
Named nets: 0, out, B
;tran 0 3m 0 1n
.op
Load
40 MHz XO
