marmote/marmote/hardware/PowerBoard_RevC/Simulation/ReverseVoltageProtection.asc

D1: zener; BZX84C6V2L
M1: pmos
R1: res; 200k
R2: res; 1.8m
R3: res; 1k
V1: voltage; ""; Rser=10
Named nets: V-, G, V+/D, S, 0
.dc V1 -10 10 .1
