marmote/marmote/hardware/PowerBoard_RevC/Simulation/GpioLedWithPullup.asc

D1: LED; NSSWS108T
R1: res; 330
R2: res; {Rt}
R3: res; {Rp}
V1: voltage; 3.3
Named nets: 0
.tran 1us
.param Rp 4.7e3
.param Rt 1e6
