marmote/marmote/hardware/PowerBoard_RevC/Simulation/Oscillator.asc

C1: cap; {Cm}
C2: cap; {C0}
C3: cap; {CL}
C4: cap; {CL}
L1: ind; {Lm}
M1: pmos
M2: nmos
R1: res; {Rm}
R2: res; {Rf}; tol=10
R3: res; 10e6
V2: voltage; 4
Named nets: 0
.param Rf = 100k
.param CL = 10pF
.param Lm = 14.7mH
.param Rm = 8ohm
.param Cm = 0.027pF
.param C0 = 5.57pF
.tran 0 1e-3 0 1e-9
