marmote/marmote/hardware/PowerBoard_RevC/Simulation/BatteryChargerCapacitor.asc

C1: cap; 4µ
L1: ind; 23n
R1: res; {R}
V1: voltage; PULSE(0 3.9 1u); Rser=200m
Named nets: 0
.tran 10us
.param R=0.1ohm
.step dec param R 1uohm 1ohm 1
