marmote/marmote/hardware/BeaverBoard_RevA/Simulation/AD/AD-AD8132.asc

AD8132: ad8132
C2: cap; {C}
C5: cap; {C}
C24: cap; 0.1µ
CN: cap; 32p
CP: cap; 32p
R1: res; 33
R2: res; 33
R6: res; 1K; tol=1 pwr=0.1
R7: res; 1K; tol=1 pwr=0.1
R9: res; 100Meg; tol=1 pwr=0.1
R30: res; 499; tol=1 pwr=0.1
R31: res; 499; tol=1 pwr=0.1
R32: res; 100Meg; tol=1 pwr=0.1
R33: res; 499; tol=1 pwr=0.1
R34: res; 499; tol=1 pwr=0.1
RN: res; 30; tol=1 pwr=0.1
RP: res; 30
V1: voltage; SINE(2.3 0.1 1Meg); AC 1 0
V2: voltage; SINE(2.3 -0.1 1Meg); AC -1 0
V3_3: voltage; 3.3
Named nets: 0, VINN_A, VINP_A, AVDD1, V_BIAS
.ac oct 1 1 4.2Meg
AD7357
.param C=212.2p
