marmote/marmote/hardware/BeaverBoard_RevA/Simulation/DA/DA-AD8629-MOS.asc

C2: cap; {C}
C5: cap; {C}
C24: cap; 0.1µ
C174: cap; 66p
C175: cap; 66p
L186: ind; 620n
L187: ind; 620n
M1: NMOSbook; irf8910
M2: NMOSbook; irf8910
R1: res; {R0}
R2: res; {if(bit3, 1u, 100Meg)}
R3: res; {R1}; tol=1 pwr=0.1
R4: res; {2*R}
R5: res; {2*R}
R6: res; 1K; tol=1 pwr=0.1
R7: res; 1K; tol=1 pwr=0.1
R8: res; {2*R}
R9: res; {R0}; tol=1 pwr=0.1
R10: res; {2*R}
R11: res; {R}
R12: res; {R}
R13: res; {R}
R14: res; {2*R}
R15: res; {R}
R16: res; {if(bit3, 100Meg, 1u)}
R17: res; {if(bit2, 1u, 100Meg)}
R18: res; {if(bit2, 100Meg, 1u)}
R19: res; {if(bit1, 1u, 100Meg)}
R20: res; {if(bit1, 100Meg, 1u)}
R21: res; {if(bit0, 1u, 100Meg)}
R22: res; {if(bit0, 100Meg, 1u)}
R23: res; 1µ
R24: res; 1µ
R25: res; {R3}
R26: res; {R3}
R27: res; 1µ
R28: res; 1µ
R29: res; 1130
R30: res; {R1}; tol=1 pwr=0.1
R31: res; {R2}; tol=1 pwr=0.1
R32: res; 866
R34: res; {R2}; tol=1 pwr=0.1
R101: res; 49.9
R102: res; 49.9
R103: res; 10
R104: res; 100
U1: ad8629
U2: ad8137
U3: ad8629
V1: voltage; 3.3; AC 1.65 0
V2: voltage; {VB}
V3: voltage; 3.3
V3_3: voltage; 3.3
V4: voltage; 5
Named nets: 0, IOUTN_A, IOUTP_A, AVDD1, AVDD2, V_BIAS, AVDD1N
.op
RFX400
.param C=212.2p
.param C=0
2^0=1
2^1=2
2^2=4
2^3=8
DAC
diff amp
.param R=10k
.param val3=val
.param bit3=floor(val3/8)
.param val2=val3-bit3*8
.param bit2=floor(val2/4)
.param val1=val2-bit2*4
.param bit1=floor(val1/2)
.param val0=val1-bit1*2
.param bit0=floor(val0/1)
.step param val 0 15 1
.param R2=45.3k
.step param R2 30k 70k 5k
.step param R1 100 1k 100
.param R1=536
.param R0=100
.step param R0 30 300 100
.param R3=113
.include irf8910.spi
.param val=8
.step param VB 1.7 2.5 0.1
.param VB=2.17
