marmote/marmote/hardware/BeaverBoard_RevA/Simulation/DA/AD8137-bandwidth.asc

C2: cap; {C}
C5: cap; {C}
C24: cap; 0.1µ
R1: res; {R0}
R3: res; {R1}; tol=1 pwr=0.1
R6: res; 1K; tol=1 pwr=0.1
R7: res; 1K; tol=1 pwr=0.1
R9: res; {R0}; tol=1 pwr=0.1
R30: res; {R1}; tol=1 pwr=0.1
R31: res; {R2}; tol=1 pwr=0.1
R34: res; {R2}; tol=1 pwr=0.1
U2: ad8137
V1: voltage; 0; AC 0.2 0
V2: voltage; 0; AC -0.2 0
V3_3: voltage; 3.3
V4: voltage; {V_B}
V5: voltage; 5
Named nets: 0, VINN_A, VINP_A, AVDD1, AVDD2, V_BIAS, E, F
.ac dec 10 1 3Meg
.param C=0
.param C=0
diff amp
.param R0=100
.param V_B=2
.step param V_B 0.5 2.5 0.2
.param R2=50k
.param R1=536
.step param R2 10k 40k 5k
