marmote/marmote/hardware/BeaverBoard_RevA/Simulation/DA/MOStest-irf8910.asc

M1: NMOSbook; irf8910
V1: voltage; {VG}
V2: voltage; {VD}
V3: voltage; 0
Named nets: 0
.step param VD 0 3 0.2
.step param VG 0 2 0.2
.op
.step param VD 0 2.2 0.01
.step param VG 2.49 2.48 0.001
.param VD=3.3
.include irf8910.spi
.param VG=2.35
