marmote/marmote/hardware/BeaverBoard_RevA/Simulation/DA/NMOStest.asc

M1: NMOSbook; irf7103q
V1: voltage; {VG}
V2: voltage; {VD}
V3: voltage; 0
Named nets: 0
.step param VD 0 3 0.2
.step param VG 0 2 0.2
.op
.step param VD 0 0.02 0.01
.step param VG 2.49 2.48 0.001
.param VD=3.3
.include irf7103q.spi
.param VG=2.25
