marmote/marmote/hardware/BeaverBoard_RevA/Simulation/DA/DA-AD8132-AD8137-AD8138.asc

C1: cap; {C}
C2: cap; {C}
C3: cap; {C}
C4: cap; {C}
C5: cap; {C}
C6: cap; {C}
C24: cap; 0.1µ
R1: res; {R}; tol=1 pwr=0.1
R3: res; {R}; tol=1 pwr=0.1
R4: res; .5
R5: res; {R}; tol=1 pwr=0.1
R6: res; 1K; tol=1 pwr=0.1
R7: res; 1K; tol=1 pwr=0.1
R10: res; {R2}; tol=1 pwr=0.1
R11: res; {R2}; tol=1 pwr=0.1
R12: res; {R2}; tol=1 pwr=0.1
R13: res; {R2}; tol=1 pwr=0.1
R14: res; {R}; tol=1 pwr=0.1
R15: res; .5
R16: res; {R}; tol=1 pwr=0.1
R17: res; .5
R18: res; 100
R30: res; {R}; tol=1 pwr=0.1
R31: res; {R2}; tol=1 pwr=0.1
R34: res; {R2}; tol=1 pwr=0.1
R104: res; 100
R104_2: res; 100
U1: ad8132
U2: ad8137
U3: ad8138
V1: voltage; {V_i}; AC 1.6 0
V2: voltage; {V_B2}
V3: voltage; 3.3
V3_3: voltage; 3.3
V4: voltage; {V_B1}
V5: voltage; {V_B3}
Named nets: VINN_A, VINP_A, 0, AVDD1, V_BIAS1, AVDD2, VINN_A_2, VINP_A_2, A, B, C, D, G, H, I, J, V_BIAS2, E, F, K, L, V_BIAS3
.op
.param C=212.2p
.param C=0
.param R=1000
.param V_B1=1
.step param V_B2 0.1 0.9 0.5
.step param V_i 0 3.3 3.3
.param R2=182
.param V_i=2.5
.param V_B2=1
.step param R 1600 1800 40
.step param R2 800 1100 40
.step param V_B1 0.1 2 0.4
.step param V_B3 0.1 0.9 0.5
.param V_B3=1
