marmote/marmote/hardware/BeaverBoard_RevA/Simulation/DA/DA-AD8132-rfx.3.asc

C1: cap; {C}
C2: cap; {C}
C3: cap; {C}
C5: cap; {C}
C24: cap; 0.1µ
C174: cap; 66p
C174_2: cap; 47p
C175: cap; 66p
C175_2: cap; 47p
L186: ind; 620n
L186_2: ind; 330n
L187: ind; 620n
L187_2: ind; 330n
R1: res; {R3}
R3: res; {R}; tol=1 pwr=0.1
R4: res; .5
R5: res; {R}; tol=1 pwr=0.1
R6: res; 1K; tol=1 pwr=0.1
R7: res; 1K; tol=1 pwr=0.1
R8: res; 100Meg; tol=1 pwr=0.1
R9: res; 100Meg; tol=1 pwr=0.1
R10: res; {R2}; tol=1 pwr=0.1
R11: res; {R2}; tol=1 pwr=0.1
R14: res; {R}; tol=1 pwr=0.1
R15: res; .5
R30: res; {R}; tol=1 pwr=0.1
R31: res; {R2}; tol=1 pwr=0.1
R34: res; {R2}; tol=1 pwr=0.1
R101: res; 49.9
R101_2: res; 40.2
R102: res; 49.9; tol=1 pwr=0.1
R102_2: res; 40.2; tol=1 pwr=0.1
R103: res; 10
R103_2: res; 10
R104: res; 100
R104_2: res; 240
U1: ad8137
U2: ad8137
V1: voltage; {V_i}; AC 1.6 0
V2: voltage; {V_B2}
V3: voltage; 3.3
V3_3: voltage; 3.3
V4: voltage; {V_B1}
Named nets: 0, VINN_A, VINP_A, AVDD1, V_BIAS1, AVDD2, V_BIAS2, VINN_A_2, VINP_A_2, A, B, C, D, E, F, G, H, I, J, K, L
.op
RFX400
.param C=212.2p
.param C=0
diff amp
diff amp
RFX2400
.param R=300
.param V_B1=0.75
.step param V_B2 0.1 0.9 0.5
.step param V_i 0 3.3 3.3
.param R2=300
.param V_i=2.5
.param V_B2=0.4
.step param R 1600 1800 40
.step param R2 800 1100 40
.step param V_B1 0.1 0.4 0.05
.param R3=40000
.step param R3 28000 35000 100
