marmote/marmote/hardware/BeaverBoard_RevA/Simulation/DA/DA-AD8137-MOS.asc

C2: cap; {C}
C5: cap; {C}
C24: cap; 0.1µ
C174: cap; 66p
C175: cap; 66p
L186: ind; 620n
L187: ind; 620n
M1: PMOSbook; ZXM62P02E6
M2: PMOSbook; ZXM62P02E6
R1: res; 25
R2: res; {if(bit3, 1u, 100Meg)}
R3: res; 499; tol=1 pwr=0.1
R4: res; {2*R}
R5: res; {2*R}
R6: res; 1K; tol=1 pwr=0.1
R7: res; 1K; tol=1 pwr=0.1
R8: res; {2*R}
R9: res; 25; tol=1 pwr=0.1
R10: res; {2*R}
R11: res; {R}
R12: res; {R}
R13: res; {R}
R14: res; {2*R}
R15: res; {R}
R16: res; {if(bit3, 100Meg, 1u)}
R17: res; {if(bit2, 1u, 100Meg)}
R18: res; {if(bit2, 100Meg, 1u)}
R19: res; {if(bit1, 1u, 100Meg)}
R20: res; {if(bit1, 100Meg, 1u)}
R21: res; {if(bit0, 1u, 100Meg)}
R22: res; {if(bit0, 100Meg, 1u)}
R23: res; 1p
R24: res; 1p
R30: res; 499; tol=1 pwr=0.1
R31: res; 2k; tol=1 pwr=0.1
R34: res; 2k; tol=1 pwr=0.1
R101: res; 49.9
R102: res; 49.9
R103: res; 10
R104: res; 100
U2: ad8137
V1: voltage; 5; AC 1.65 0
V2: voltage; 1.1
V3: voltage; 3.3
V3_3: voltage; 3.3
Named nets: 0, VINN_A, VINP_A, AVDD1, V_BIAS, AVDD2
.op
RFX400
.param C=212.2p
.param C=0
2^0=1
2^1=2
2^2=4
2^3=8
DAC
diff amp
.param R=10k
.param val3=val
.param bit3=floor(val3/8)
.param val2=val3-bit3*8
.param bit2=floor(val2/4)
.param val1=val2-bit2*4
.param bit1=floor(val1/2)
.param val0=val1-bit1*2
.param bit0=floor(val0/1)
.step param val 0 15 1
