marmote/marmote/hardware/BeaverBoard_RevA/Simulation/DA/DA-AD8137-rfx.asc

C1: cap; {C}
C2: cap; {C}
C3: cap; {C}
C5: cap; {C}
C24: cap; 0.1µ
C174: cap; 66p
C174_2: cap; 47p
C175: cap; 66p
C175_2: cap; 47p
L186: ind; 620n
L186_2: ind; 330n
L187: ind; 620n
L187_2: ind; 330n
R1: res; {R3}
R2: res; {R3v}
R3: res; {R}; tol=1 pwr=0.1
R4: res; .5
R5: res; {R}; tol=1 pwr=0.1
R6: res; 1K; tol=1 pwr=0.1
R7: res; 1K; tol=1 pwr=0.1
R8: res; 100Meg; tol=1 pwr=0.1
R9: res; 100Meg; tol=1 pwr=0.1
R10: res; {R2}; tol=1 pwr=0.1
R11: res; {R2}; tol=1 pwr=0.1
R12: res; {R3}
R13: res; {R3v}
R14: res; {R}; tol=1 pwr=0.1
R15: res; .5
R16: res; {R4}
R17: res; {R4}
R18: res; {R4}
R19: res; {R4}
R20: res; {R5}
R21: res; {R5}
R30: res; {R}; tol=1 pwr=0.1
R31: res; {R2}; tol=1 pwr=0.1
R34: res; {R2}; tol=1 pwr=0.1
R101: res; 49.9
R101_2: res; 40.2
R102: res; 49.9; tol=1 pwr=0.1
R102_2: res; 40.2; tol=1 pwr=0.1
R103: res; 10
R103_2: res; 10
R104: res; 100
R104_2: res; 240
U1: ad8137
U2: ad8137
V1: voltage; {V_i}; AC 1.6 0
V3: voltage; 3.3
V3_3: voltage; 3.3
V4: voltage; {V_B}
Named nets: 0, VINN_A, VINP_A, AVDD1, V_BIAS, AVDD2, VINN_A_2, VINP_A_2, A, B, C, D, E, F, G, H, I, J, K, L
.op
RFX400
.param C=212.2p
.param C=0
diff amp
diff amp
RFX2400
.param R=500
.param V_B=1.6
.step param V_B 0.5 2.5 0.2
.step param V_i 0 3.3 3.3
.param R2=90.9
.param R3=0.00001
.step param R3 1 300 60
.param V_i=2.5
.step param R3v 1 100 30
.param R3v=0.00001
.param R4=10
.step param R4 1 30 6
.step param R4v 1 100 30
.param R4v=0.00001
.param R5=0.00001
.step param R5 1 30 6
