marmote/marmote/hardware/BeaverBoard_RevA/Simulation/DA/DA-AD8629-AD8137.asc

C2: cap; {C}
C5: cap; {C}
C24: cap; 0.1µ
R1: res; 33
R2: res; 33
R3: res; 499; tol=1 pwr=0.1
R4: res; {2*R}
R5: res; {2*R}
R6: res; 1K; tol=1 pwr=0.1
R7: res; 1K; tol=1 pwr=0.1
R8: res; {2*R}
R9: res; 100Meg; tol=1 pwr=0.1
R10: res; {2*R}
R11: res; {R}
R12: res; {R}
R13: res; {R}
R14: res; {2*R}
R15: res; {R}
R30: res; 499; tol=1 pwr=0.1
R31: res; 499; tol=1 pwr=0.1
R34: res; 499; tol=1 pwr=0.1
RN: res; 50; tol=1 pwr=0.1
RP: res; 50
U1: ad8629
U2: ad8137
V1: voltage; SINE(1.5 1.5 1Meg); AC 1.5 0
V2: voltage; 3.3
V3: voltage; 3.3
V3_3: voltage; 3.3
Named nets: 0, VINN_A, VINP_A, AVDD1, V_BIAS, AVDD2
.tran 10u
Antenna
.param C=212.2p
.param C=0
2^0=1
2^1=2
2^2=4
2^3=8
DAC
opamp
diff amp
.param R=10k
