marmote/marmote/hardware/BeaverBoard_RevA/Simulation/DA/MOStest.asc

M1: NMOSbook; FDR6580
R1: res; 25
V1: voltage; {VGS}
V2: voltage; {VDS}
V3: voltage; 0.45
Named nets: 0
.step param VDS 0 3 0.2
.step param VGS 0 2 0.2
.op
.step param VDS 0 3 0.2
.step param VGS 1 2 0.02
.param VDS=3.3
