marmote/marmote/hardware/BeaverBoard_RevA/Simulation/DA/pMOStest.asc

M1: PMOSbook; ZXM62P02E6
R1: res; 25
V1: voltage; {VSG}
V2: voltage; {VSD}
V3: voltage; 0.45
Named nets: 0
.step param VSD 0 3 0.2
.step param VSG 0 3 0.2
.op
.step param VSD 0 3 0.2
.step param VSG 0 2 0.005
.param VSD=3.3
