marmote/marmote/hardware/BeaverBoard_RevA/Simulation/DA/RFX.asc

C1: cap; 66p
C2: cap; 66p
C3: cap; 47p
C4: cap; 120p
I1: current; {I1}
I2: current; {I2}
I3: current; {I2}
I4: current; {I1}
I5: current; {I2}
I6: current; {I2}
L1: ind; 620n
L2: ind; 620n
L3: ind; 330n
L4: ind; 330n
R1: res; 49.9
R2: res; 49.9
R3: res; 10
R4: res; 100
R5: res; 25
R6: res; 40.2
R7: res; 40.2
R8: res; 1p
R9: res; 240
R10: res; 30.11
V1: voltage; 0.45
V2: voltage; 0.1
Named nets: 0
RFX400
.param I1 (20m-I)
.param I2 (I)
.step param I 0m 20m 2m
RFX2400
.op
