marmote/marmote/hardware/BeaverBoard_RevA/Simulation/DA/switch.asc

I1: current; 0.1
R1: res; 50
R2: res; 50
S1: sw
V1: voltage; {V}
Named nets: 0
.step param V -1 1 0.2
.op
