marmote/marmote/hardware/BeaverBoard_RevA/Simulation/DA/test.asc

M1: nmos; IRFBG20
V1: voltage; 0
V2: voltage; 10
Named nets: 0
.dc V2 0 15 0.01 V1 4 6 1
.include IRFBG20.spi
