marmote/marmote/hardware/BeaverBoard_RevA/Simulation/DA/tr-RFX.asc

C1: cap; 66p
C2: cap; 66p
C3: cap; 47p
C4: cap; 120p
L1: ind; 620n
L2: ind; 620n
L3: ind; 330n
L4: ind; 330n
M1: PMOSbook; ZXM62P02E6
M2: PMOSbook; ZXM62P02E6
R1: res; 49.9
R2: res; 49.9
R3: res; 10
R4: res; 100
R5: res; 1µ
R6: res; 40.2
R7: res; 40.2
R8: res; 1p
R9: res; 240
R10: res; 1µ
R11: res; 1
R12: res; 1
V3: voltage; 3.3
V4: voltage; {V2}
V5: voltage; {V1}
Named nets: 0, V_DD
RFX400
.param V1 (VB+V)
.param V2 (VB-V)
.param V2 (VB-V)
.step param V -1 1 0.01
RFX2400
.op
.param VB 2.25
.step param VB 2.2 2.21 0.005
.param V2 (VB-V)
