marmote/marmote/hardware/BeaverBoard_RevA/Simulation/AD/AD-AD8132-2.asc

AD8132: ad8132
C24: cap; 0.1µ
R6: res; 1K; tol=1 pwr=0.1
R7: res; 1K; tol=1 pwr=0.1
R30: res; 500; tol=1 pwr=0.1
R31: res; 500; tol=1 pwr=0.1
R33: res; 500; tol=1 pwr=0.1
R34: res; 500; tol=1 pwr=0.1
RN: res; 11; tol=1 pwr=0.1
RP: res; 11
V1: voltage; SINE(0 0.1 1Meg); AC 1 0; Rser=50
V2: voltage; SINE(0 -0.1 1Meg); AC -1 0; Rser=50
V3_3: voltage; 3.3
Named nets: VINN_A, VINP_A, 0, AVDD1, V_BIAS
.tran 10u
AD7357
