marmote/marmote/hardware/BeaverBoard_RevA/Simulation/RFX400-filter/filter.asc

C89: cap; 82p
C90: cap; 150p
C91: cap; 8.2p
C92: cap; 4.7p
L1: ind; 0.68µ
L3: ind; 1.2µ
R3: res; 2
R5: res; 2
R7: res; 100
R61: res; 95.3
Rki: res; 1Meg
V1: voltage; ""; AC 0.2; Rser=40
Named nets: 0
.ac oct 1 1 100Meg
