marmote/marmote/hardware/BeaverBoard_RevA/Simulation/AD/AD.asc

CN: cap; 32p
CP: cap; 32p
RN: res; 30
RP: res; 30; tol=1 pwr=0.1
V1: voltage; SINE(0 0.1 1Meg); AC 1 0; Rser=50
V2: voltage; SINE(0 -0.1 1Meg); AC -1 0; Rser=50
Named nets: VINN_A, VINP_A, 0
.ac oct 1 1 1g
AD
