marmote/marmote/hardware/BeaverBoard_RevA/Simulation/DBSRX-LF/DBSRX-LF-AD8132.asc

AD8132: ad8132
C24: cap; 0.1µ
C64: cap; 100p
C65: cap; 100p
C124: cap; 1000p
CN: cap; 5p
CP: cap; 5p
R6: res; 1K; tol=1 pwr=0.1
R7: res; 1K; tol=1 pwr=0.1
R10: res; 49.9; tol=1 pwr=0.1
R65: res; 250; tol=0.1 pwr=0.1
R66: res; 250; tol=0.1 pwr=0.1
R67: res; 250; tol=0.1 pwr=0.1
R68: res; 250; tol=0.1 pwr=0.1
R71: res; 49.9; tol=1 pwr=0.1
RN: res; 200; tol=1 pwr=0.1
V1: voltage; SINE(0 0.1 1Meg); AC 1 0; Rser=50
V2: voltage; 3.3
Named nets: 0, VINP_A, VINN_A, AVDD1, local_vref
.tran 10u
MAX2118
AD9862
DBSRX-LF
USRP motherboard
