marmote/marmote/hardware/BeaverBoard_RevA/Simulation/LFRX/LFRX-AD8132.asc

AD8132: ad8132
C1: cap; 10
C24: cap; 0.1µ
C25: cap; 20p
C26: cap; 20p
CN: cap; 5p
CP: cap; 5p
R6: res; 1K; tol=1 pwr=0.1
R7: res; 1K; tol=1 pwr=0.1
R9: res; 49.9; tol=1 pwr=0.1
R10: res; 49.9; tol=1 pwr=0.1
R11: res; 49.9; tol=1 pwr=0.1
R30: res; 348; tol=1 pwr=0.1
R31: res; 348; tol=1 pwr=0.1
R32: res; 24.9; tol=1 pwr=0.1
R33: res; 348; tol=1 pwr=0.1
R34: res; 348; tol=1 pwr=0.1
RN: res; 200; tol=1 pwr=0.1
V1: voltage; SINE(0 0.1 1Meg); AC 1 0; Rser=50
V2: voltage; 3.3
Named nets: 0, Ant, VINN_A, VINP_A, AVDD1, V_BIAS
.ac oct 1 1 1g
Antenna
AD9862
LFRX
USRP motherboard
