marmote/marmote/hardware/MainBoard_RevB/MainBoard.brd

## EAGLE design hardware/MainBoard_RevB/MainBoard.brd (2013-01-09)

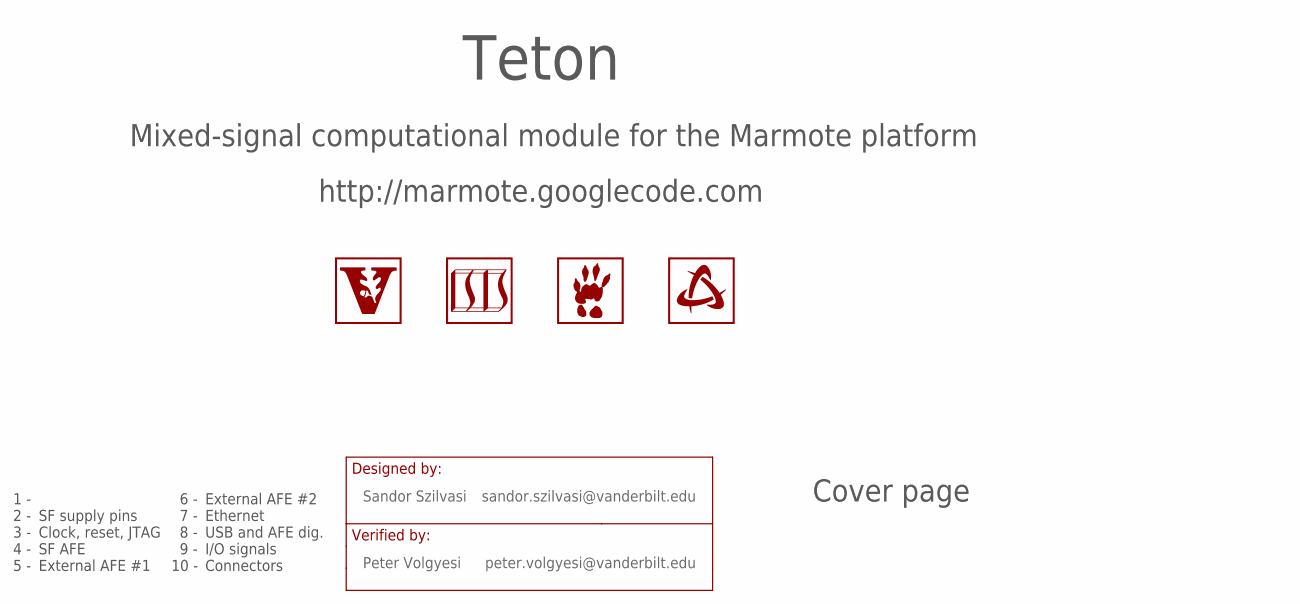
[picture p133: schematic MainBoard.sch, sheet 1]

Parts:
LOGO1: LOGO-VANDERBILT-600MIL-10MM-SS; LOGO-VANDERBILT-10MM-SILKSCREEN
LOGO2: LOGO-ISIS-600MIL-10MM-SS; LOGO-ISIS-10MM-SILKSCREEN
LOGO3: LOGO-MARMOTE-600MIL-10MM-SS; LOGO-MARMOTE-10MM-SILKSCREEN
LOGO4: LOGO-SMARTFUSION-600MIL-10MM-SS; LOGO-SMARTFUSION-10MM-SILKSCREEN

Notes on the sheet:
Mixed-signal computational module for the Marmote platform
http://marmote.googlecode.com
1 -
2 -
3 -
4 -
5 -
6 -
7 -
8 -
9 -
10 -

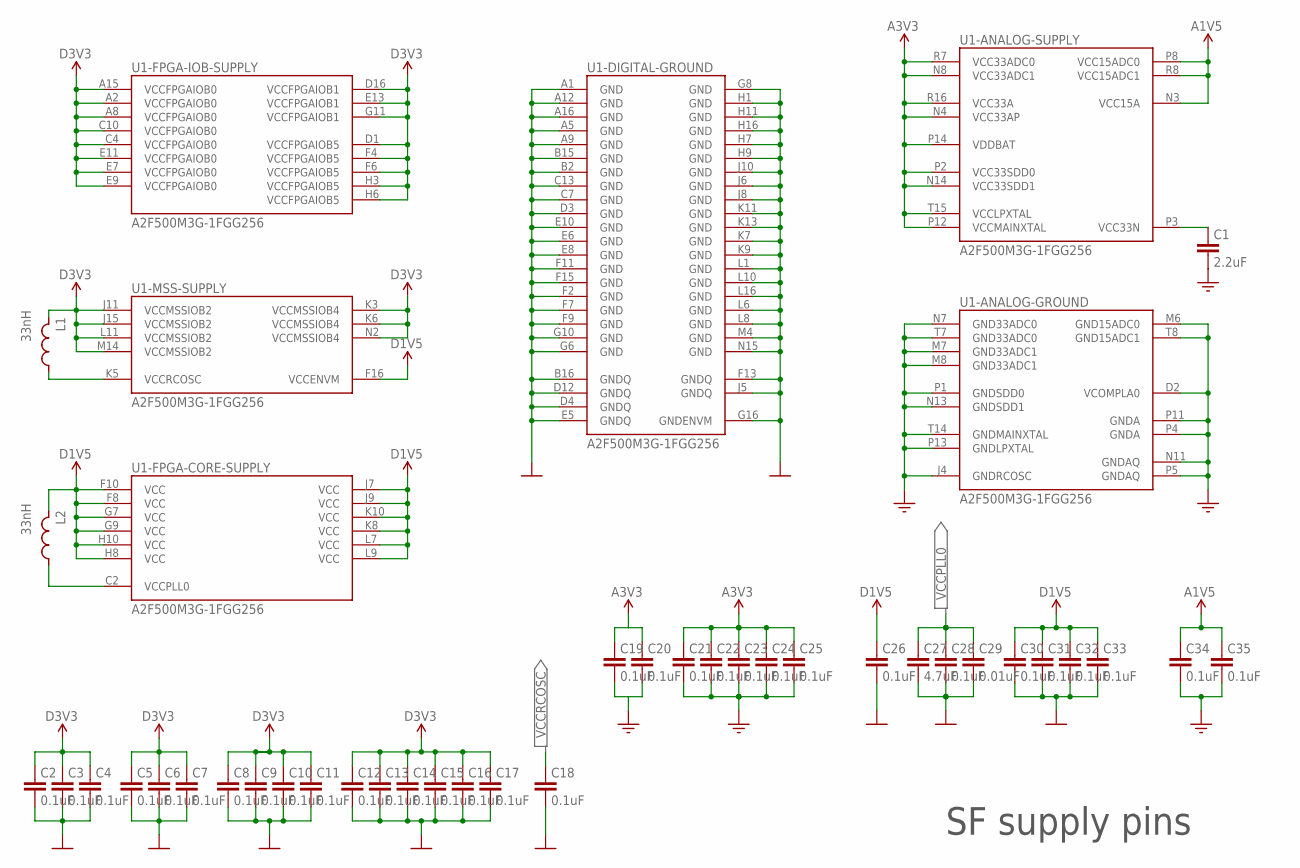
[picture p134: schematic MainBoard.sch, sheet 2]

Parts:
C1: 2.2uF; C0402
C2, C3, C4, C5, C6, C7, C8, C9, C10, C11, C12, C13, C14, C15, C16, C17, C18, C19, C20, C21, C22, C23, C24, C25, C26, C28, C30, C31, C32, C33, C34, C35: 0.1uF; C0402
C27: 4.7uF; C0402
C29: 0.01uF; C0402
L1, L2: 33nH; L0603
U1: A2F500M3G-1FGG256; FG256

Connections:
A1V5: C34.1, C35.1, U1.N3 (VCC15A), U1.P8 (VCC15ADC0), U1.R8 (VCC15ADC1); also elsewhere on the board
A3V3: C19.1, C20.1, C21.1, C22.1, C23.1, C24.1, C25.1, U1.N4 (VCC33AP), U1.N8 (VCC33ADC1), U1.N14 (VCC33SDD1), U1.P2 (VCC33SDD0), U1.P12 (VCCMAINXTAL), U1.P14 (VDDBAT), U1.R7 (VCC33ADC0), U1.R16 (VCC33A), U1.T15 (VCCLPXTAL); also elsewhere on the board
AGND: C1.2, C19.2, C20.2, C21.2, C22.2, C23.2, C24.2, C25.2, C34.2, C35.2, U1.D2 (VCOMPLA0), U1.J4 (GNDRCOSC), U1.M6 (GND15ADC0), U1.M7 (GND33ADC1), U1.M8 (GND33ADC1), U1.N7 (GND33ADC0), U1.N11 (GNDAQ), U1.N13 (GNDSDD1), U1.P1 (GNDSDD0), U1.P4 (GNDA), U1.P5 (GNDAQ), U1.P11 (GNDA), U1.P13 (GNDLPXTAL), U1.T7 (GND33ADC0), U1.T8 (GND15ADC1), U1.T14 (GNDMAINXTAL); also elsewhere on the board
D1V5: C26.1, C30.1, C31.1, C32.1, C33.1, L2.2, U1.F8 (VCC), U1.F10 (VCC), U1.F16 (VCCENVM), U1.G7 (VCC), U1.G9 (VCC), U1.H8 (VCC), U1.H10 (VCC), U1.J7 (VCC), U1.J9 (VCC), U1.K8 (VCC), U1.K10 (VCC), U1.L7 (VCC), U1.L9 (VCC); also elsewhere on the board
D3V3: C2.1, C3.1, C4.1, C5.1, C6.1, C7.1, C8.1, C9.1, C10.1, C11.1, C12.1, C13.1, C14.1, C15.1, C16.1, C17.1, L1.2, U1.A2 (VCCFPGAIOB0), U1.A8 (VCCFPGAIOB0), U1.A15 (VCCFPGAIOB0), U1.C4 (VCCFPGAIOB0), U1.C10 (VCCFPGAIOB0), U1.D1 (VCCFPGAIOB5), U1.D16 (VCCFPGAIOB1), U1.E7 (VCCFPGAIOB0), U1.E9 (VCCFPGAIOB0), U1.E11 (VCCFPGAIOB0), U1.E13 (VCCFPGAIOB1), U1.F4 (VCCFPGAIOB5), U1.F6 (VCCFPGAIOB5), U1.G11 (VCCFPGAIOB1), U1.H3 (VCCFPGAIOB5), U1.H6 (VCCFPGAIOB5), U1.J11 (VCCMSSIOB2), U1.J15 (VCCMSSIOB2), U1.K3 (VCCMSSIOB4), U1.K6 (VCCMSSIOB4), U1.L11 (VCCMSSIOB2), U1.M14 (VCCMSSIOB2), U1.N2 (VCCMSSIOB4); also elsewhere on the board
DGND: C2.2, C3.2, C4.2, C5.2, C6.2, C7.2, C8.2, C9.2, C10.2, C11.2, C12.2, C13.2, C14.2, C15.2, C16.2, C17.2, C18.2, C26.2, C27.2, C28.2, C29.2, C30.2, C31.2, C32.2, C33.2, U1.A1 (GND), U1.A5 (GND), U1.A9 (GND), U1.A12 (GND), U1.A16 (GND), U1.B2 (GND), U1.B15 (GND), U1.B16 (GNDQ), U1.C7 (GND), U1.C13 (GND), U1.D3 (GND), U1.D4 (GNDQ), U1.D12 (GNDQ), U1.E5 (GNDQ), U1.E6 (GND), U1.E8 (GND), U1.E10 (GND), U1.F2 (GND), U1.F7 (GND), U1.F9 (GND), U1.F11 (GND), U1.F13 (GNDQ), U1.F15 (GND), U1.G6 (GND), U1.G8 (GND), U1.G10 (GND), U1.G16 (GNDENVM), U1.H1 (GND), U1.H7 (GND), U1.H9 (GND), U1.H11 (GND), U1.H16 (GND), U1.J5 (GNDQ), U1.J6 (GND), U1.J8 (GND), U1.J10 (GND), U1.K7 (GND), U1.K9 (GND), U1.K11 (GND), U1.K13 (GND), U1.L1 (GND), U1.L6 (GND), U1.L8 (GND), U1.L10 (GND), U1.L16 (GND), U1.M4 (GND), U1.N15 (GND); also elsewhere on the board
VCC3N: C1.1, U1.P3 (VCC33N)
VCCPLL0: C27.1, C28.1, C29.1, L2.1, U1.C2 (VCCPLL0)
VCCRCOSC: C18.1, L1.1, U1.K5 (VCCRCOSC)

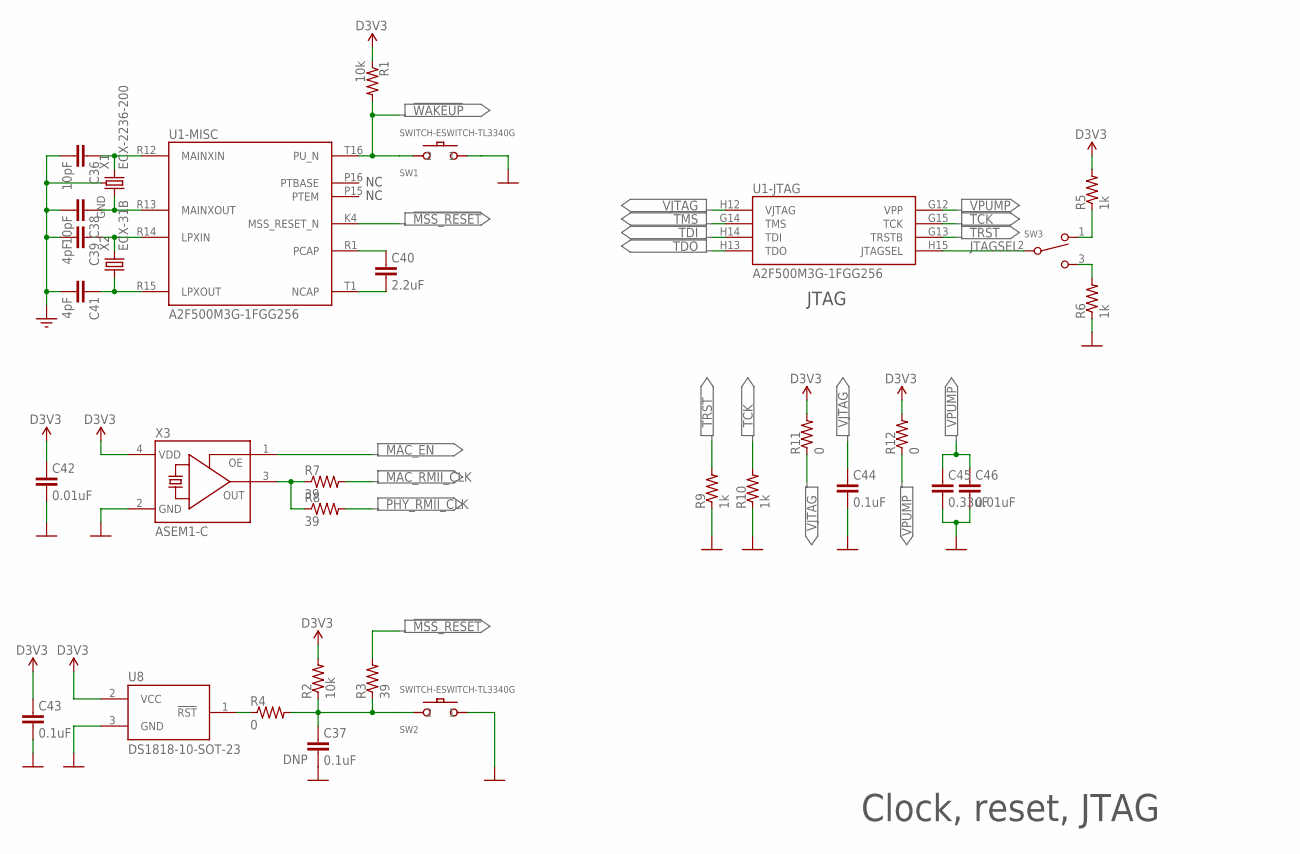
[picture p135: schematic MainBoard.sch, sheet 3]

Parts:
C36, C38: 10pF; C0402
C37, C43, C44: 0.1uF; C0402
C39, C41: 4pF; C0402
C40: 2.2uF; C0402
C42: 0.01uF; C0402
C45: 0.33uF; C0402
C46: 0.01uF; C0402; VOLTAGE-RATING 16V
R1, R2: 10k; R0402
R3, R7, R8: 39; R0402
R4, R11, R12: 0; R0402
R5, R6, R9, R10: 1k; R0402
SW1, SW2: SWITCH-ESWITCH-TL3340G; TL3340
SW3: SWITCH-CJS-1200TA; SWITCH-DIP-CJS
U1: A2F500M3G-1FGG256; FG256
U8: DS1818-10-SOT-23; SOT23-3L
X1: ECX-2236-200; ECX-2236; DIGI-KEY# XC1556CT-ND
X2: ECX-31B
X3: ASEM1-C; ASEM1; MPN ASEM1-50.000MHZ-LC-T

Connections:
!MSS_RESET: R3.2, U1.K4 (MSS_RESET_N); also elsewhere on the board
!MSS_RESET_PB: C37.1, R2.1, R3.1, R4.2, SW2.2
!WAKEUP: R1.2, SW1.2, U1.T16 (PU_N); also elsewhere on the board
AGND: C36.2, C38.2, C39.2, C41.2, X1.2 (GND), X1.4 (GND); also elsewhere on the board
D3V3: C42.1, C43.1, R1.1, R2.2, R5.2, R11.2, R12.2, U8.2 (VCC), X3.4 (VDD); also elsewhere on the board
DGND: C37.2, C42.2, C43.2, C44.2, C45.2, C46.2, R6.1, R9.1, R10.1, SW1.1, SW1.3 (1), SW2.1, SW2.3 (1), U8.3 (GND), X3.2 (GND); also elsewhere on the board
EXTIC-RST: R4.1, U8.1 (!RST)
FPGATAP: R5.1, SW3.1
JTAGSEL: SW3.2, U1.H15 (JTAGSEL)
LPXIN: C39.1, U1.R14 (LPXIN), X2.2
LPXOUT: C41.1, U1.R15 (LPXOUT), X2.1
MAC_EN: X3.1 (OE); also elsewhere on the board
MAC_RMII_CLK: R7.2; also elsewhere on the board
MAINXIN: C36.1, U1.R12 (MAINXIN), X1.3 (2)
MAINXOUT: C38.1, U1.R13 (MAINXOUT), X1.1
MSSTAP: R6.2, SW3.3
NCAP: C40.2, U1.T1 (NCAP)
PCAP: C40.1, U1.R1 (PCAP)
PHY_RMII_CLK: R8.2; also elsewhere on the board
RMII_CLK: R7.1, R8.1, X3.3 (FO)
TCK: R10.2, U1.G15 (TCK); also elsewhere on the board
TDI: U1.H14 (TDI); also elsewhere on the board
TDO: U1.H13 (TDO); also elsewhere on the board
TMS: U1.G14 (TMS); also elsewhere on the board
TRST: R9.2, U1.G13 (TRSTB); also elsewhere on the board
VJTAG: C44.1, R11.1, U1.H12 (VJTAG); also elsewhere on the board
VPUMP: C45.1, C46.1, R12.1, U1.G12 (VPP); also elsewhere on the board

Notes on the sheet:
JTAG

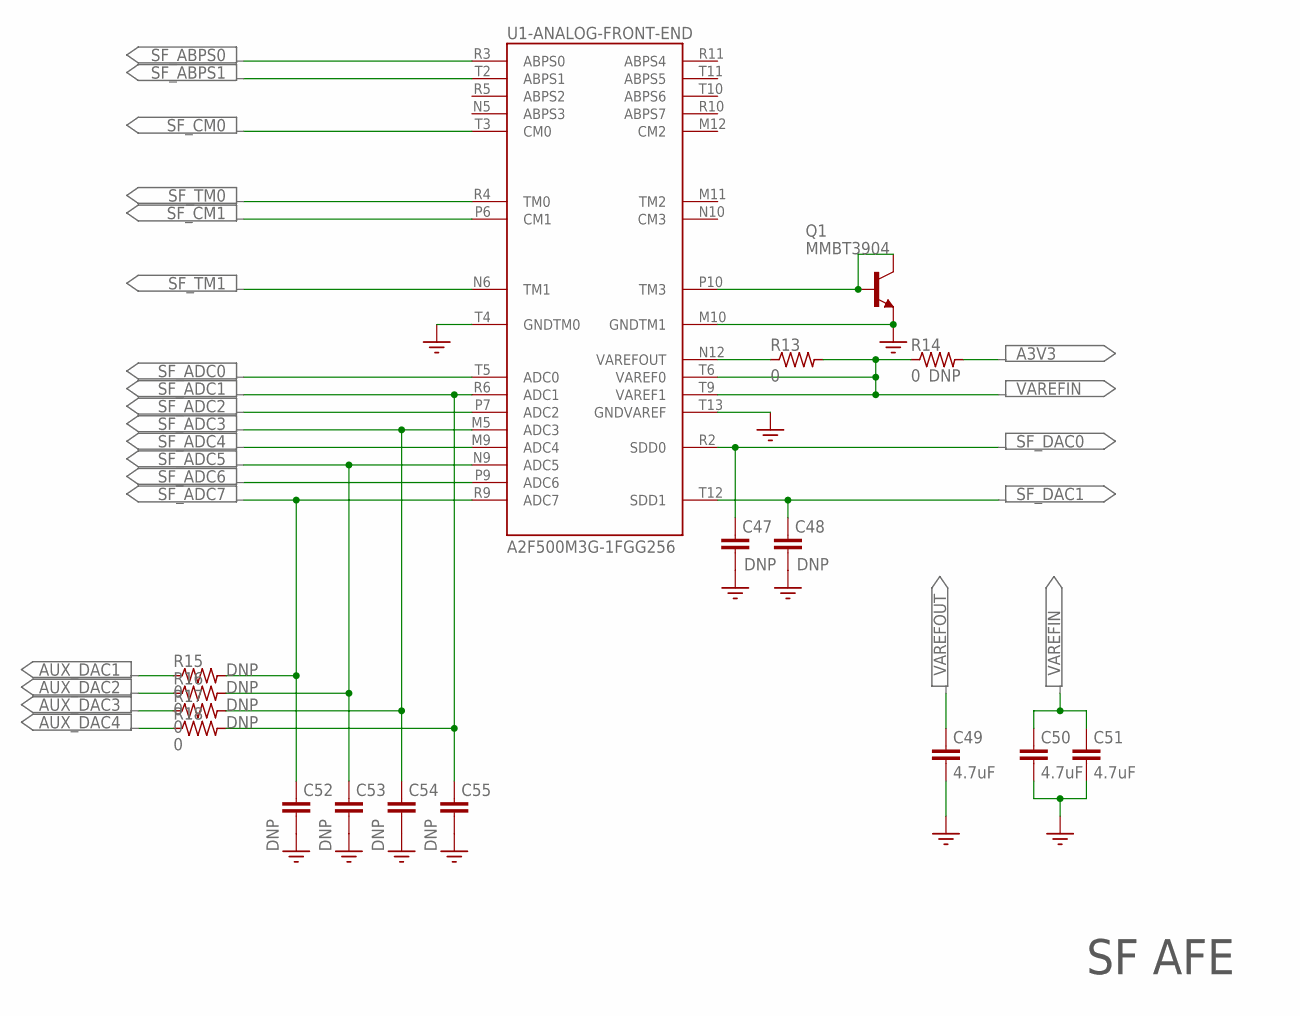
[picture p136: schematic MainBoard.sch, sheet 4]

Parts:
C47, C48, C52, C53, C54, C55: C0402
C49, C50, C51: 4.7uF; C0402
Q1: MMBT3904; SOT23-3L
R13, R14, R15, R16, R17, R18: 0; R0402
U1: A2F500M3G-1FGG256; FG256

Connections:
A3V3: R14.2; also elsewhere on the board
AGND: C47.2, C48.2, C49.2, C50.2, C51.2, C52.2, C53.2, C54.2, C55.2, Q1.2 (E), U1.M10 (GNDTM1), U1.T4 (GNDTM0), U1.T13 (GNDVAREF); also elsewhere on the board
AUX_DAC1: R15.1; also elsewhere on the board
AUX_DAC2: R16.1; also elsewhere on the board
AUX_DAC3: R17.1; also elsewhere on the board
AUX_DAC4: R18.1; also elsewhere on the board
SF_ABPS0: U1.R3 (ABPS0); also elsewhere on the board
SF_ABPS1: U1.T2 (ABPS1); also elsewhere on the board
SF_ADC0: U1.T5 (ADC0); also elsewhere on the board
SF_ADC1: C55.1, R18.2, U1.R6 (ADC1); also elsewhere on the board
SF_ADC2: U1.P7 (ADC2); also elsewhere on the board
SF_ADC3: C54.1, R17.2, U1.M5 (ADC3); also elsewhere on the board
SF_ADC4: U1.M9 (ADC4); also elsewhere on the board
SF_ADC5: C53.1, R16.2, U1.N9 (ADC5); also elsewhere on the board
SF_ADC6: U1.P9 (ADC6); also elsewhere on the board
SF_ADC7: C52.1, R15.2, U1.R9 (ADC7); also elsewhere on the board
SF_CM0: U1.T3 (CM0); also elsewhere on the board
SF_CM1: U1.P6 (CM1); also elsewhere on the board
SF_DAC0: C47.1, U1.R2 (SDD0); also elsewhere on the board
SF_DAC1: C48.1, U1.T12 (SDD1); also elsewhere on the board
SF_TM0: U1.R4 (TM0); also elsewhere on the board
SF_TM1: U1.N6 (TM1); also elsewhere on the board
SF_TM3: Q1.1 (B), Q1.3 (C), U1.P10 (TM3)
VAREFIN: C50.1, C51.1, R13.2, R14.1, U1.T6 (VAREF0), U1.T9 (VAREF1)
VAREFOUT: C49.1, R13.1, U1.N12 (VAREFOUT)

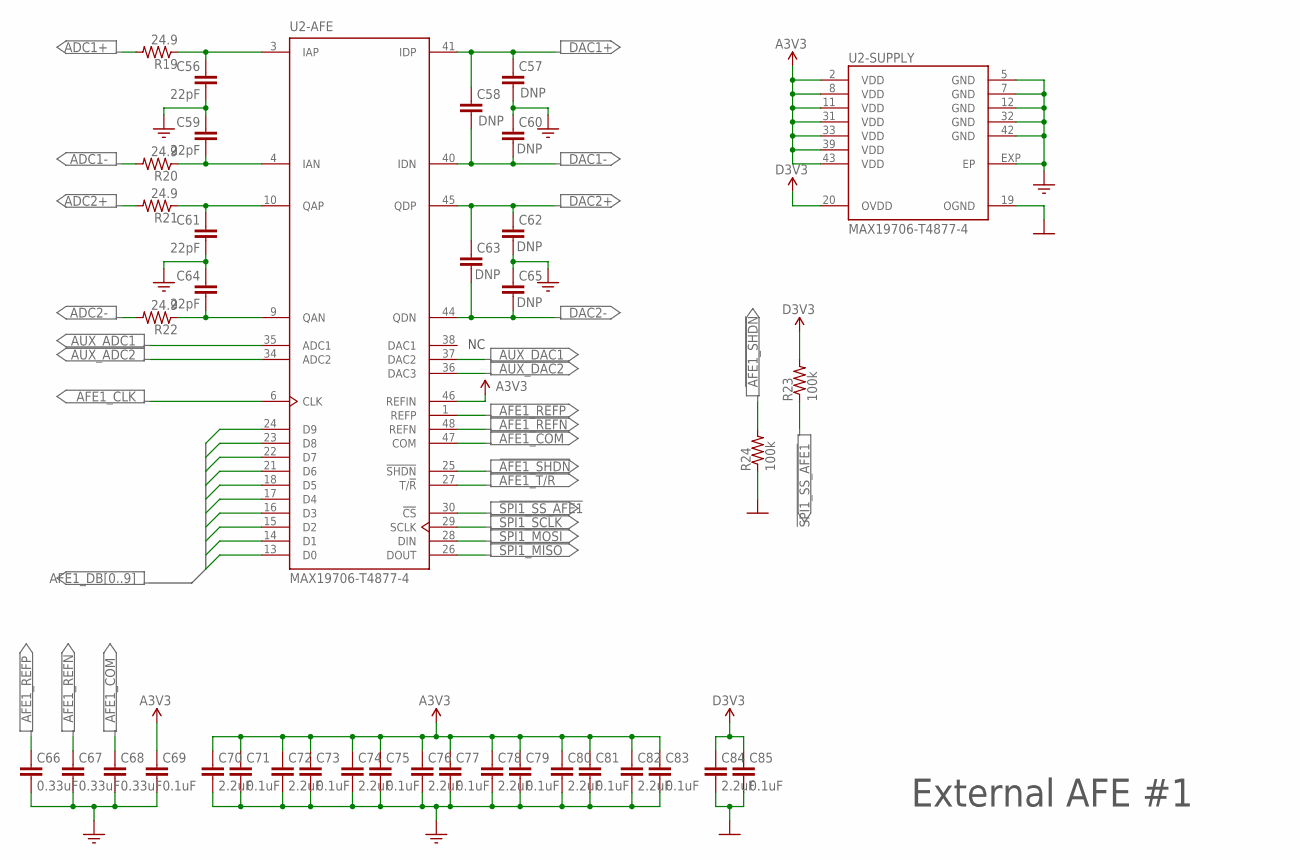
[picture p137: schematic MainBoard.sch, sheet 5]

Parts:
C56, C59, C61, C64: 22pF; C0402
C57, C58, C60, C62, C63, C65: C0402
C66, C67, C68: 0.33uF; C0402
C69, C71, C73, C75, C77, C79, C81, C83, C85: 0.1uF; C0402
C70, C72, C74, C76, C78, C80, C82, C84: 2.2uF; C0402
R19, R20, R21, R22: 24.9; R0402
R23, R24: 100k; R0402
U2: MAX19706-T4877-4; TQFN-48

Connections:
!AFE1_SHDN: R24.2, U2.25 (!SHDN); also elsewhere on the board
!SPI1_SS_AFE1: R23.1, U2.30 (!CS); also elsewhere on the board
A3V3: C69.1, C70.1, C71.1, C72.1, C73.1, C74.1, C75.1, C76.1, C77.1, C78.1, C79.1, C80.1, C81.1, C82.1, C83.1, U2.2 (VDD), U2.8 (VDD), U2.11 (VDD), U2.31 (VDD), U2.33 (VDD), U2.39 (VDD), U2.43 (VDD), U2.46 (REFIN); also elsewhere on the board
ADC1+: R19.2; also elsewhere on the board
ADC1-: R20.2; also elsewhere on the board
ADC1-IAN: C59.2, R20.1, U2.4 (IAN)
ADC1-IAP: C56.1, R19.1, U2.3 (IAP)
ADC2+: R21.2; also elsewhere on the board
ADC2-: R22.2; also elsewhere on the board
ADC2-QAN: C64.2, R22.1, U2.9 (QAN)
ADC2-QAP: C61.1, R21.1, U2.10 (QAP)
AFE1_CLK: U2.6 (CLK); also elsewhere on the board
AFE1_COM: C68.1, U2.47 (COM)
AFE1_DB0: U2.13 (D0); also elsewhere on the board
AFE1_DB1: U2.14 (D1); also elsewhere on the board
AFE1_DB2: U2.15 (D2); also elsewhere on the board
AFE1_DB3: U2.16 (D3); also elsewhere on the board
AFE1_DB4: U2.17 (D4); also elsewhere on the board
AFE1_DB5: U2.18 (D5); also elsewhere on the board
AFE1_DB6: U2.21 (D6); also elsewhere on the board
AFE1_DB7: U2.22 (D7); also elsewhere on the board
AFE1_DB8: U2.23 (D8); also elsewhere on the board
AFE1_DB9: U2.24 (D9); also elsewhere on the board
AFE1_REFN: C67.1, U2.48 (REFN)
AFE1_REFP: C66.1, U2.1 (REFP)
AFE1_T/!R: U2.27 (T/!R); also elsewhere on the board
AGND: C56.2, C57.2, C59.1, C60.1, C61.2, C62.2, C64.1, C65.1, C66.2, C67.2, C68.2, C69.2, C70.2, C71.2, C72.2, C73.2, C74.2, C75.2, C76.2, C77.2, C78.2, C79.2, C80.2, C81.2, C82.2, C83.2, U2.5 (GND), U2.7 (GND), U2.12 (GND), U2.32 (GND), U2.42 (GND), U2.EXP (EP); also elsewhere on the board
AUX_ADC1: U2.35 (ADC1)
AUX_ADC2: U2.34 (ADC2)
AUX_DAC1: U2.37 (DAC2); also elsewhere on the board
AUX_DAC2: U2.36 (DAC3); also elsewhere on the board
D3V3: C84.1, C85.1, R23.2, U2.20 (OVDD); also elsewhere on the board
DAC1+: C57.1, C58.1, U2.41 (IDP); also elsewhere on the board
DAC1-: C58.2, C60.2, U2.40 (IDN); also elsewhere on the board
DAC2+: C62.1, C63.1, U2.45 (QDP); also elsewhere on the board
DAC2-: C63.2, C65.2, U2.44 (QDN); also elsewhere on the board
DGND: C84.2, C85.2, R24.1, U2.19 (OGND); also elsewhere on the board
SPI1_MISO: U2.26 (DOUT); also elsewhere on the board
SPI1_MOSI: U2.28 (DIN); also elsewhere on the board
SPI1_SCLK: U2.29 (SCLK); also elsewhere on the board

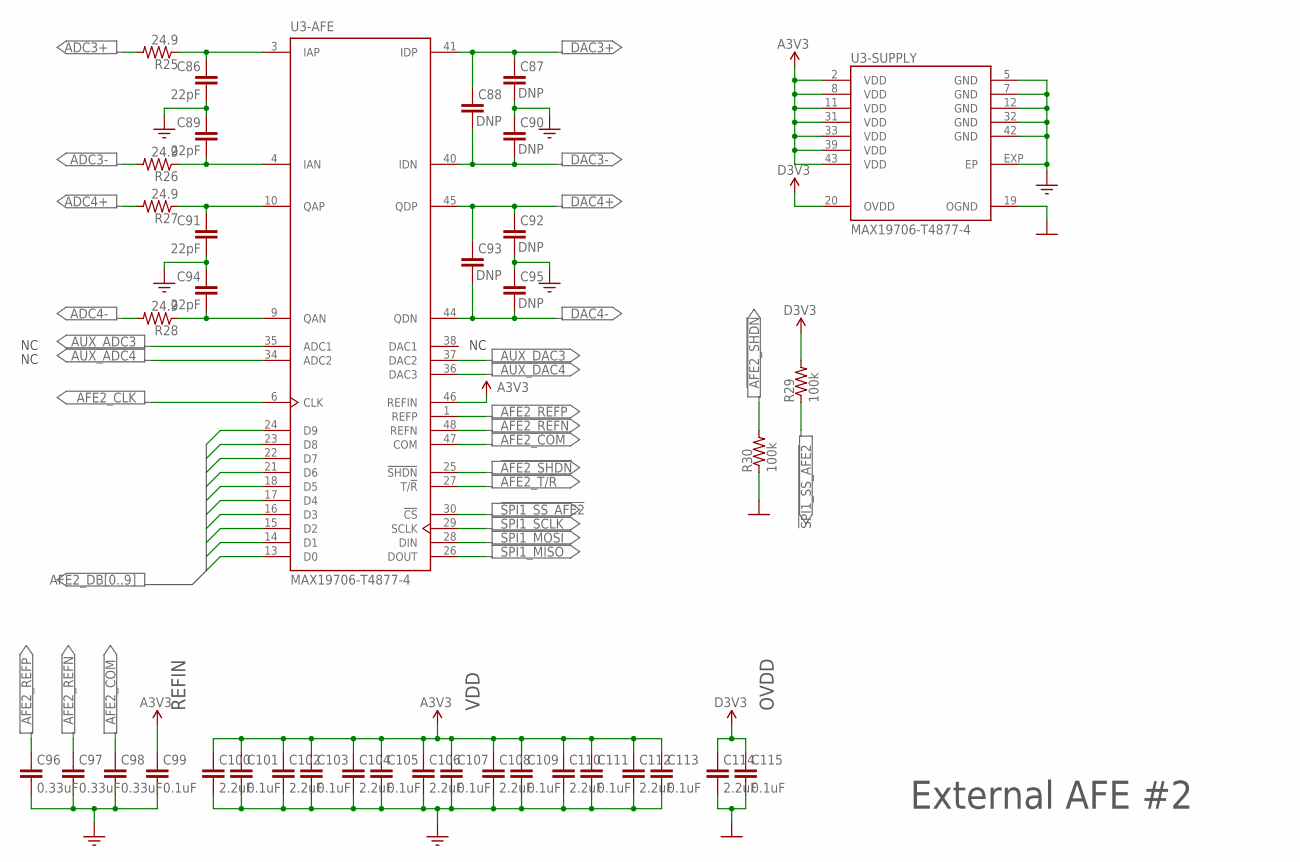
[picture p138: schematic MainBoard.sch, sheet 6]

Parts:
C86, C89, C91, C94: 22pF; C0402
C87, C88, C90, C92, C93, C95: C0402
C96, C97, C98: 0.33uF; C0402
C99, C101, C103, C105, C107, C109, C111, C113, C115: 0.1uF; C0402
C100, C102, C104, C106, C108, C110, C112, C114: 2.2uF; C0402
R25, R26, R27, R28: 24.9; R0402
R29, R30: 100k; R0402
U3: MAX19706-T4877-4; TQFN-48

Connections:
!AFE2_SHDN: R30.2, U3.25 (!SHDN); also elsewhere on the board
!SPI1_SS_AFE2: R29.1, U3.30 (!CS); also elsewhere on the board
A3V3: C99.1, C100.1, C101.1, C102.1, C103.1, C104.1, C105.1, C106.1, C107.1, C108.1, C109.1, C110.1, C111.1, C112.1, C113.1, U3.2 (VDD), U3.8 (VDD), U3.11 (VDD), U3.31 (VDD), U3.33 (VDD), U3.39 (VDD), U3.43 (VDD), U3.46 (REFIN); also elsewhere on the board
ADC3+: R25.2; also elsewhere on the board
ADC3-: R26.2; also elsewhere on the board
ADC3-IAN: C89.2, R26.1, U3.4 (IAN)
ADC3-IAP: C86.1, R25.1, U3.3 (IAP)
ADC4+: R27.2; also elsewhere on the board
ADC4-: R28.2; also elsewhere on the board
ADC4-QAN: C94.2, R28.1, U3.9 (QAN)
ADC4-QAP: C91.1, R27.1, U3.10 (QAP)
AFE2_CLK: U3.6 (CLK); also elsewhere on the board
AFE2_COM: C98.1, U3.47 (COM)
AFE2_DB0: U3.13 (D0); also elsewhere on the board
AFE2_DB1: U3.14 (D1); also elsewhere on the board
AFE2_DB2: U3.15 (D2); also elsewhere on the board
AFE2_DB3: U3.16 (D3); also elsewhere on the board
AFE2_DB4: U3.17 (D4); also elsewhere on the board
AFE2_DB5: U3.18 (D5); also elsewhere on the board
AFE2_DB6: U3.21 (D6); also elsewhere on the board
AFE2_DB7: U3.22 (D7); also elsewhere on the board
AFE2_DB8: U3.23 (D8); also elsewhere on the board
AFE2_DB9: U3.24 (D9); also elsewhere on the board
AFE2_REFN: C97.1, U3.48 (REFN)
AFE2_REFP: C96.1, U3.1 (REFP)
AFE2_T/!R: U3.27 (T/!R); also elsewhere on the board
AGND: C86.2, C87.2, C89.1, C90.1, C91.2, C92.2, C94.1, C95.1, C96.2, C97.2, C98.2, C99.2, C100.2, C101.2, C102.2, C103.2, C104.2, C105.2, C106.2, C107.2, C108.2, C109.2, C110.2, C111.2, C112.2, C113.2, U3.5 (GND), U3.7 (GND), U3.12 (GND), U3.32 (GND), U3.42 (GND), U3.EXP (EP); also elsewhere on the board
AUX_ADC3: U3.35 (ADC1)
AUX_ADC4: U3.34 (ADC2)
AUX_DAC3: U3.37 (DAC2); also elsewhere on the board
AUX_DAC4: U3.36 (DAC3); also elsewhere on the board
D3V3: C114.1, C115.1, R29.2, U3.20 (OVDD); also elsewhere on the board
DAC3+: C87.1, C88.1, U3.41 (IDP); also elsewhere on the board
DAC3-: C88.2, C90.2, U3.40 (IDN); also elsewhere on the board
DAC4+: C92.1, C93.1, U3.45 (QDP); also elsewhere on the board
DAC4-: C93.2, C95.2, U3.44 (QDN); also elsewhere on the board
DGND: C114.2, C115.2, R30.1, U3.19 (OGND); also elsewhere on the board
SPI1_MISO: U3.26 (DOUT); also elsewhere on the board
SPI1_MOSI: U3.28 (DIN); also elsewhere on the board
SPI1_SCLK: U3.29 (SCLK); also elsewhere on the board

Notes on the sheet:
VDD
OVDD
REFIN

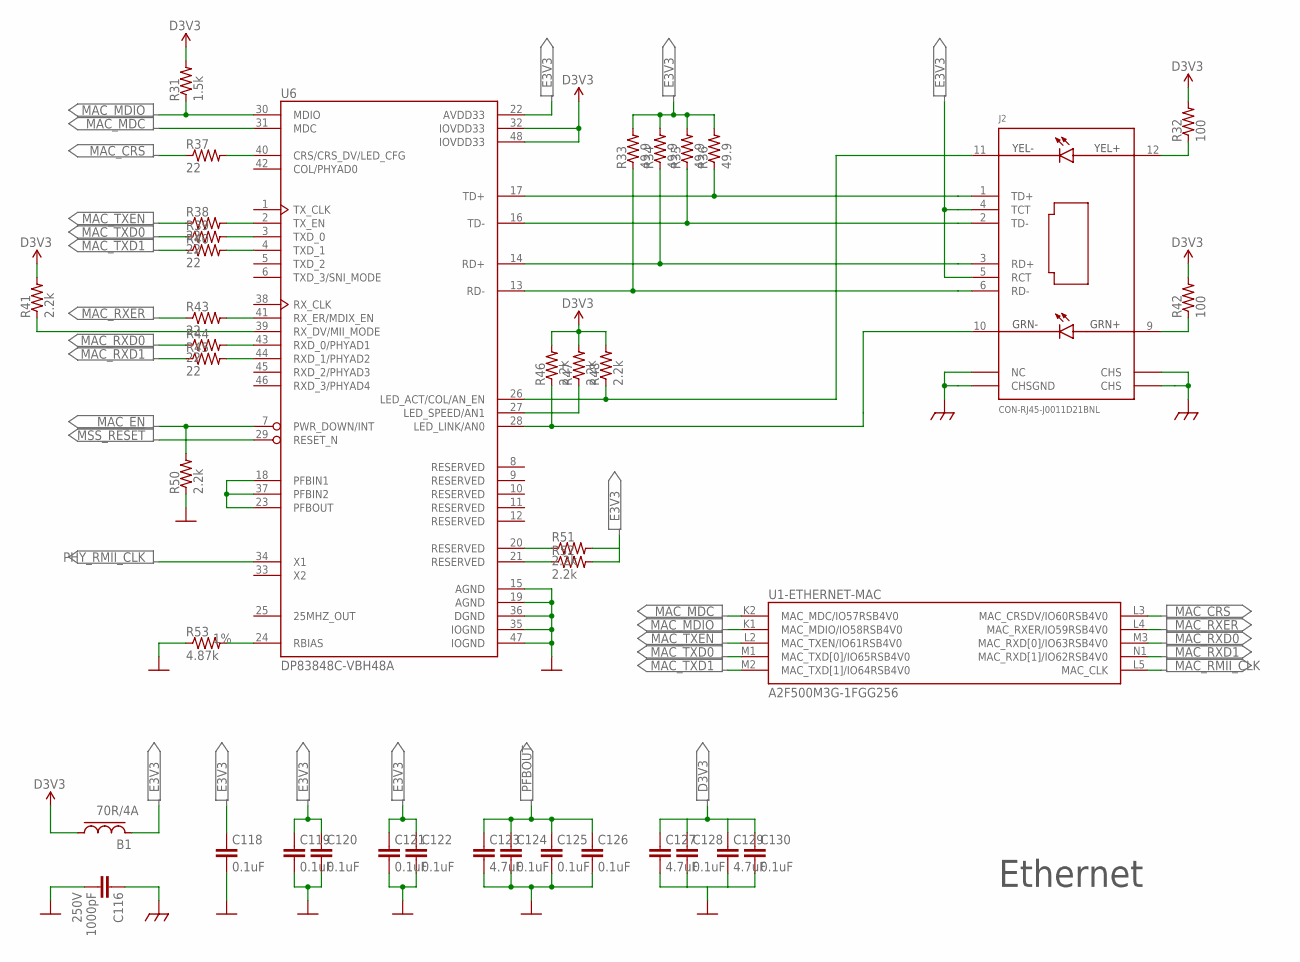
[picture p139: schematic MainBoard.sch, sheet 7]

Parts:
B1: 70R/4A; L0603
C116: 1000pF; C0805; RATING 250V
C118, C119, C120, C121, C122, C124, C125, C126, C128, C130: 0.1uF; C0402
C123, C127, C129: 4.7uF; C0402
J2: CON-RJ45-J0011D21BNL; J0011D21B
R31: 1.5k; R0402
R32, R42: 100; R0402
R33, R34, R35, R36: 49.9; R0402
R37, R38, R39, R40, R43, R44, R45: 22; R0402
R41, R46, R47, R48, R50, R51, R52: 2.2k; R0402
R53: 4.87k; R0402; TOLERANCE 1%
U1: A2F500M3G-1FGG256; FG256
U6: DP83848C-VBH48A; LQFP-48

Connections:
!MSS_RESET: U6.29 (RESET_N); also elsewhere on the board
COM+: J2.9 (GRN+), R42.1
CRS: R37.2, U6.40 (CRS/CRS_DV/LED_CFG)
D3V3: B1.1, C127.1, C128.1, C129.1, C130.1, R31.2, R32.2, R41.2, R42.2, R46.2, R47.2, R48.2, U6.32 (IOVDD33), U6.48 (IOVDD33); also elsewhere on the board
DGND: C116.2, C118.2, C119.2, C120.2, C121.2, C122.2, C123.2, C124.2, C125.2, C126.2, C127.2, C128.2, C129.2, C130.2, R50.1, R53.1, U6.15 (AGND), U6.19 (AGND), U6.35 (IOGND), U6.36 (DGND), U6.47 (IOGND); also elsewhere on the board
E3V3: B1.2, C118.1, C119.1, C120.1, C121.1, C122.1, J2.4 (TCT), J2.5 (RCT), R33.2, R34.2, R35.2, R36.2, R51.2, R52.2, U6.22 (AVDD33)
EGND: C116.1, J2.7 (NC), J2.8 (CHSGND), J2.H$1 (CHS), J2.H$2 (CHS)
ETH-RBIAS: R53.2, U6.24 (RBIAS)
LED_ETH_ACT: J2.11 (YEL-), R48.1, U6.26 (LED_ACT/COL/AN_EN)
LED_ETH_LINK: J2.10 (GRN-), R46.1, U6.28 (LED_LINK/AN0)
LED_PHY_SPEED: R47.1, U6.27 (LED_SPEED/AN1)
MAC_CRS: R37.1, U1.L3 (MAC_CRSDV/IO60RSB4V0)
MAC_EN: R50.2, U6.7 (PWR_DOWN/INT); also elsewhere on the board
MAC_MDC: U1.K2 (MAC_MDC/IO57RSB4V0), U6.31 (MDC)
MAC_MDIO: R31.1, U1.K1 (MAC_MDIO/IO58RSB4V0), U6.30 (MDIO)
MAC_RMII_CLK: U1.L5 (MAC_CLK); also elsewhere on the board
MAC_RXD0: R44.1, U1.M3 (MAC_RXD[0]/IO63RSB4V0)
MAC_RXD1: R45.1, U1.N1 (MAC_RXD[1]/IO62RSB4V0)
MAC_RXER: R43.1, U1.L4 (MAC_RXER/IO59RSB4V0)
MAC_TXD0: R39.1, U1.M1 (MAC_TXD[0]/IO65RSB4V0)
MAC_TXD1: R40.1, U1.M2 (MAC_TXD[1]/IO64RSB4V0)
MAC_TXEN: R38.1, U1.L2 (MAC_TXEN/IO61RSB4V0)
PFBOUT: C123.1, C124.1, C125.1, C126.1, U6.18 (PFBIN1), U6.23 (PFBOUT), U6.37 (PFBIN2)
PHY_RMII_CLK: U6.34 (X1); also elsewhere on the board
RD+: J2.3 (RD+), R34.1, U6.14 (RD+)
RD-: J2.6 (RD-), R33.1, U6.13 (RD-)
RSVD-P20: R51.1, U6.20 (RESERVED)
RSVD-P21: R52.1, U6.21 (RESERVED)
RXD_0/PHYAD1: R44.2, U6.43 (RXD_0/PHYAD1)
RXD_1/PHYAD2: R45.2, U6.44 (RXD_1/PHYAD2)
RX_DV: R41.1, U6.39 (RX_DV/MII_MODE)
RX_ER: R43.2, U6.41 (RX_ER/MDIX_EN)
TD+: J2.1 (TD+), R36.1, U6.17 (TD+)
TD-: J2.2 (TD-), R35.1, U6.16 (TD-)
TXD_0: R39.2, U6.3 (TXD_0)
TXD_1: R40.2, U6.4 (TXD_1)
TX_EN: R38.2, U6.2 (TX_EN)
YEL+: J2.12 (YEL+), R32.1

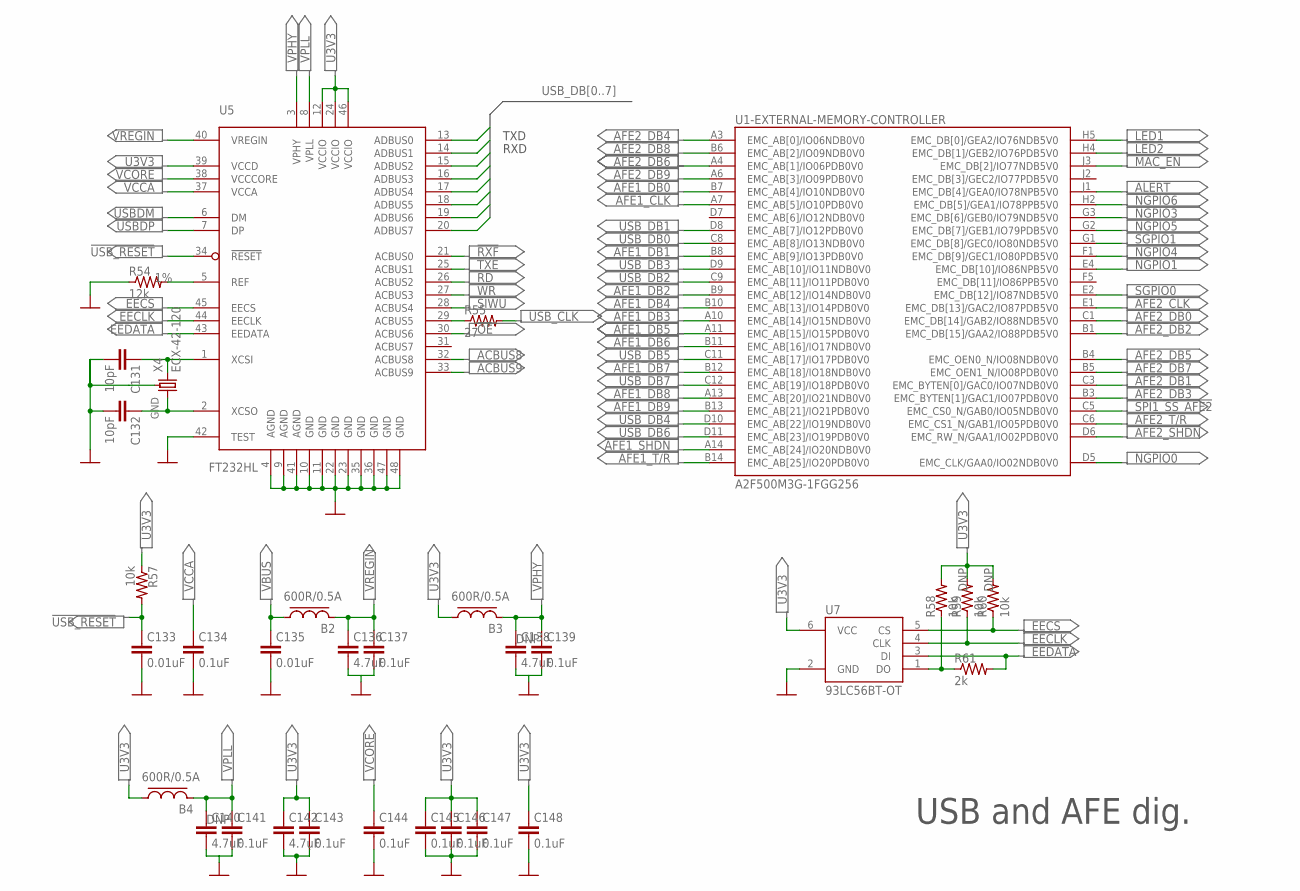
[picture p140: schematic MainBoard.sch, sheet 8]

Parts:
B2, B3, B4: 600R/0.5A; L0603; MPN BLM18EG601SN1D; DIGI-KEY# 490-3994-2-ND
C131, C132: 10pF; C0402
C133, C135: 0.01uF; C0402
C134, C137, C139, C141, C143, C144, C145, C146, C147, C148: 0.1uF; C0402
C136, C138, C140, C142: 4.7uF; C0402
R54: 12k; R0402; TOLERANCE 1%
R55: 27; R0402
R57, R58, R59, R60: 10k; R0402
R61: 2k; R0402
U1: A2F500M3G-1FGG256; FG256
U5: FT232HL; LQFP-48; MPN 768-1101-1-ND
U7: 93LC56BT-OT; SOT23-6L
X4: ECX-42-120; ECX-42

Connections:
!AFE1_SHDN: U1.A14 (EMC_AB[24]/IO20NDB0V0); also elsewhere on the board
!AFE2_SHDN: U1.D6 (EMC_RW_N/GAA1/IO02PDB0V0); also elsewhere on the board
!OE: U5.30 (ACBUS6); also elsewhere on the board
!RD: U5.26 (ACBUS2); also elsewhere on the board
!RXF: U5.21 (ACBUS0); also elsewhere on the board
!SIWU: U5.28 (ACBUS4); also elsewhere on the board
!SPI1_SS_AFE2: U1.C5 (EMC_CS0_N/GAB0/IO05NDB0V0); also elsewhere on the board
!TXE: U5.25 (ACBUS1); also elsewhere on the board
!USB_RESET: C133.1, R57.2, U5.34 (!RESET)
!WR: U5.27 (ACBUS3); also elsewhere on the board
ACBUS8: U5.32 (ACBUS8); also elsewhere on the board
ACBUS9: U5.33 (ACBUS9); also elsewhere on the board
AFE1_CLK: U1.A7 (EMC_AB[5]/IO10PDB0V0); also elsewhere on the board
AFE1_DB0: U1.B7 (EMC_AB[4]/IO10NDB0V0); also elsewhere on the board
AFE1_DB1: U1.B8 (EMC_AB[9]/IO13PDB0V0); also elsewhere on the board
AFE1_DB2: U1.B9 (EMC_AB[12]/IO14NDB0V0); also elsewhere on the board
AFE1_DB3: U1.A10 (EMC_AB[14]/IO15NDB0V0); also elsewhere on the board
AFE1_DB4: U1.B10 (EMC_AB[13]/IO14PDB0V0); also elsewhere on the board
AFE1_DB5: U1.A11 (EMC_AB[15]/IO15PDB0V0); also elsewhere on the board
AFE1_DB6: U1.B11 (EMC_AB[16]/IO17NDB0V0); also elsewhere on the board
AFE1_DB7: U1.B12 (EMC_AB[18]/IO18NDB0V0); also elsewhere on the board
AFE1_DB8: U1.A13 (EMC_AB[20]/IO21NDB0V0); also elsewhere on the board
AFE1_DB9: U1.B13 (EMC_AB[21]/IO21PDB0V0); also elsewhere on the board
AFE1_T/!R: U1.B14 (EMC_AB[25]/IO20PDB0V0); also elsewhere on the board
AFE2_CLK: U1.E1 (EMC_DB[13]/GAC2/IO87PDB5V0); also elsewhere on the board
AFE2_DB0: U1.C1 (EMC_DB[14]/GAB2/IO88NDB5V0); also elsewhere on the board
AFE2_DB1: U1.C3 (EMC_BYTEN[0]/GAC0/IO07NDB0V0); also elsewhere on the board
AFE2_DB2: U1.B1 (EMC_DB[15]/GAA2/IO88PDB5V0); also elsewhere on the board
AFE2_DB3: U1.B3 (EMC_BYTEN[1]/GAC1/IO07PDB0V0); also elsewhere on the board
AFE2_DB4: U1.A3 (EMC_AB[0]/IO06NDB0V0); also elsewhere on the board
AFE2_DB5: U1.B4 (EMC_OEN0_N/IO08NDB0V0); also elsewhere on the board
AFE2_DB6: U1.A4 (EMC_AB[1]/IO06PDB0V0); also elsewhere on the board
AFE2_DB7: U1.B5 (EMC_OEN1_N/IO08PDB0V0); also elsewhere on the board
AFE2_DB8: U1.B6 (EMC_AB[2]/IO09NDB0V0); also elsewhere on the board
AFE2_DB9: U1.A6 (EMC_AB[3]/IO09PDB0V0); also elsewhere on the board
AFE2_T/!R: U1.C6 (EMC_CS1_N/GAB1/IO05PDB0V0); also elsewhere on the board
ALERT: U1.J1 (EMC_DB[4]/GEA0/IO78NPB5V0); also elsewhere on the board
DGND: C131.2, C132.2, C133.2, C134.2, C135.2, C136.2, C137.2, C138.2, C139.2, C140.2, C141.2, C142.2, C143.2, C144.2, C145.2, C146.2, C147.2, C148.2, R54.1, U5.4 (AGND), U5.9 (AGND), U5.10 (GND), U5.11 (GND), U5.22 (GND), U5.23 (GND), U5.35 (GND), U5.36 (GND), U5.41 (AGND), U5.42 (TEST), U5.47 (GND), U5.48 (GND), U7.2 (GND), X4.2 (GND), X4.4 (GND); also elsewhere on the board
EECLK: R59.1, U5.44 (EECLK), U7.4 (CLK)
EECS: R60.1, U5.45 (EECS), U7.5 (CS)
EEDATA: R61.2, U5.43 (EEDATA), U7.3 (DI)
EEDO: R58.1, R61.1, U7.1 (DO)
LED1: U1.H5 (EMC_DB[0]/GEA2/IO76NDB5V0); also elsewhere on the board
LED2: U1.H4 (EMC_DB[1]/GEB2/IO76PDB5V0); also elsewhere on the board
MAC_EN: U1.J3 (EMC_DB[2]/IO77NDB5V0); also elsewhere on the board
NGPIO0: U1.D5 (EMC_CLK/GAA0/IO02NDB0V0); also elsewhere on the board
NGPIO1: U1.E4 (EMC_DB[10]/IO86NPB5V0); also elsewhere on the board
NGPIO3: U1.G3 (EMC_DB[6]/GEB0/IO79NDB5V0); also elsewhere on the board
NGPIO4: U1.F1 (EMC_DB[9]/GEC1/IO80PDB5V0); also elsewhere on the board
NGPIO5: U1.G2 (EMC_DB[7]/GEB1/IO79PDB5V0); also elsewhere on the board
NGPIO6: U1.H2 (EMC_DB[5]/GEA1/IO78PPB5V0); also elsewhere on the board
SGPIO0: U1.E2 (EMC_DB[12]/IO87NDB5V0); also elsewhere on the board
SGPIO1: U1.G1 (EMC_DB[8]/GEC0/IO80NDB5V0); also elsewhere on the board
U3V3: B3.1, B4.1, C142.1, C143.1, C145.1, C146.1, C147.1, C148.1, R57.1, R58.2, R59.2, R60.2, U5.12 (VCCIO), U5.24 (VCCIO), U5.39 (VCCD), U5.46 (VCCIO), U7.6 (VCC)
UREF: R54.2, U5.5 (REF)
USBDM: U5.6 (DM); also elsewhere on the board
USBDP: U5.7 (DP); also elsewhere on the board
USB_CLK: R55.2; also elsewhere on the board
USB_CLKF: R55.1, U5.29 (ACBUS5)
USB_DB0: U1.C8 (EMC_AB[8]/IO13NDB0V0), U5.13 (ADBUS0); also elsewhere on the board
USB_DB1: U1.D8 (EMC_AB[7]/IO12PDB0V0), U5.14 (ADBUS1); also elsewhere on the board
USB_DB2: U1.C9 (EMC_AB[11]/IO11PDB0V0), U5.15 (ADBUS2)
USB_DB3: U1.D9 (EMC_AB[10]/IO11NDB0V0), U5.16 (ADBUS3)
USB_DB4: U1.D10 (EMC_AB[22]/IO19NDB0V0), U5.17 (ADBUS4)
USB_DB5: U1.C11 (EMC_AB[17]/IO17PDB0V0), U5.18 (ADBUS5)
USB_DB6: U1.D11 (EMC_AB[23]/IO19PDB0V0), U5.19 (ADBUS6)
USB_DB7: U1.C12 (EMC_AB[19]/IO18PDB0V0), U5.20 (ADBUS7)
UXCSI: C131.1, U5.1 (XCSI), X4.3 (2)
UXCSO: C132.1, U5.2 (XCSO), X4.1
VBUS: B2.1, C135.1; also elsewhere on the board
VCCA: C134.1, U5.37 (VCCA)
VCORE: C144.1, U5.38 (VCCCORE)
VPHY: B3.2, C138.1, C139.1, U5.3 (VPHY)
VPLL: B4.2, C140.1, C141.1, U5.8 (VPLL)
VREGIN: B2.2, C136.1, C137.1, U5.40 (VREGIN)

Notes on the sheet:
TXD
RXD
