marmote/marmote/hardware/MainBoard_RevB/MainBoard.brd

## EAGLE design hardware/MainBoard_RevB/MainBoard.brd (continued)

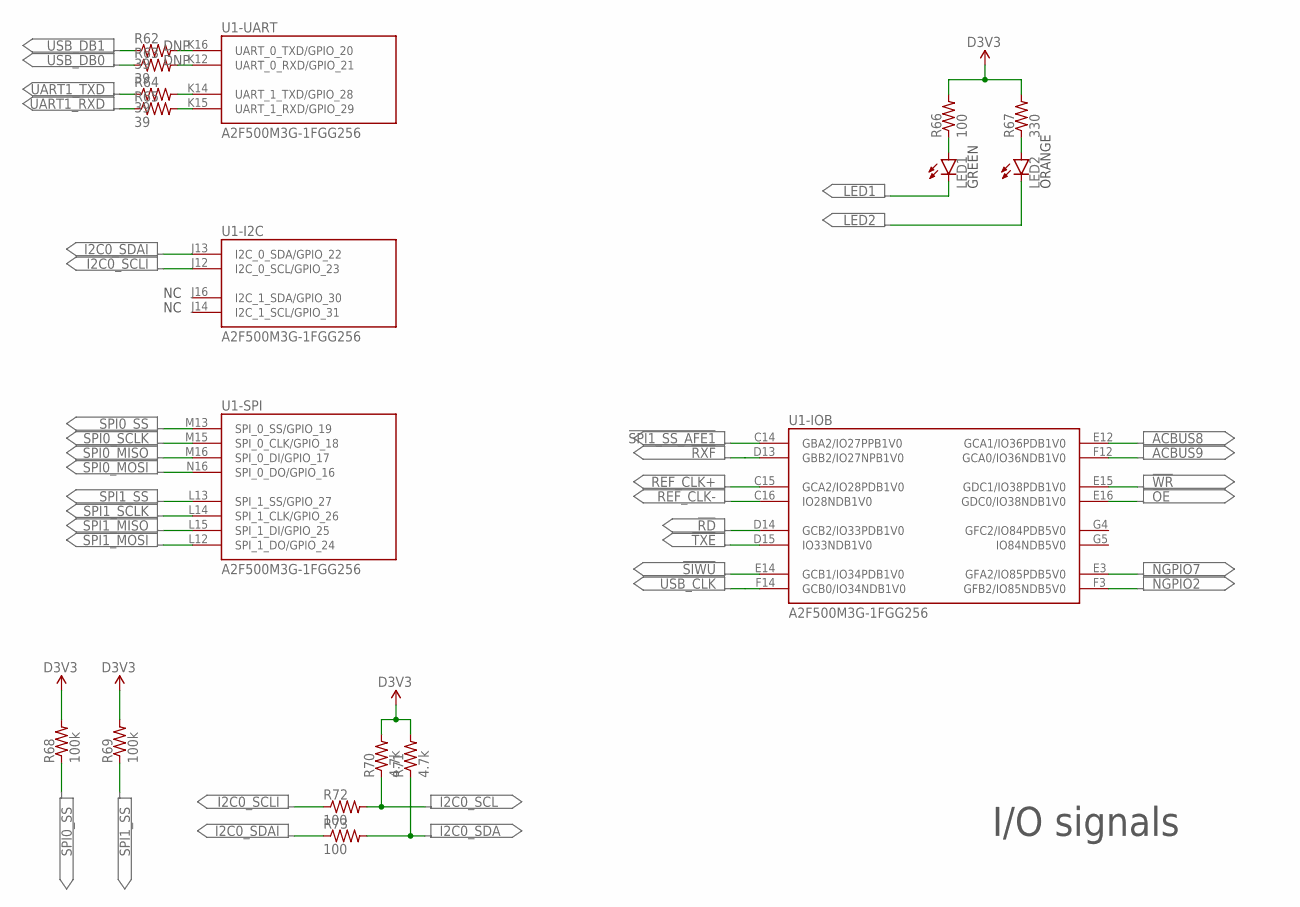
[picture p141: schematic MainBoard.sch, sheet 9]

Parts:
LED1: LED-MGC-3010; LED1208-RA
LED2: LED-ECK-3010; LED1208-RA
R62, R63, R64, R65: 39; R0402
R66, R72, R73: 100; R0402
R67: 330; R0402
R68, R69: 100k; R0402
R70, R71: 4.7k; R0402
U1: A2F500M3G-1FGG256; FG256

Connections:
!OE: U1.E16 (GDC0/IO38NDB1V0); also elsewhere on the board
!RD: U1.D14 (GCB2/IO33PDB1V0); also elsewhere on the board
!RXF: U1.D13 (GBB2/IO27NPB1V0); also elsewhere on the board
!SIWU: U1.E14 (GCB1/IO34PDB1V0); also elsewhere on the board
!SPI1_SS_AFE1: U1.C14 (GBA2/IO27PPB1V0); also elsewhere on the board
!TXE: U1.D15 (IO33NDB1V0); also elsewhere on the board
!WR: U1.E15 (GDC1/IO38PDB1V0); also elsewhere on the board
ACBUS8: U1.E12 (GCA1/IO36PDB1V0); also elsewhere on the board
ACBUS9: U1.F12 (GCA0/IO36NDB1V0); also elsewhere on the board
D3V3: R66.2, R67.2, R68.2, R69.2, R70.2, R71.2; also elsewhere on the board
I2C0_SCL: R70.1, R72.2; also elsewhere on the board
I2C0_SCLI: R72.1, U1.J12 (I2C_0_SCL/GPIO_23)
I2C0_SDA: R71.1, R73.2; also elsewhere on the board
I2C0_SDAI: R73.1, U1.J13 (I2C_0_SDA/GPIO_22)
LED1: LED1.1 (C); also elsewhere on the board
LED1H: LED1.2 (A), R66.1
LED2: LED2.1 (C); also elsewhere on the board
LED2H: LED2.2 (A), R67.1
NGPIO2: U1.F3 (GFB2/IO85NDB5V0); also elsewhere on the board
NGPIO7: U1.E3 (GFA2/IO85PDB5V0); also elsewhere on the board
REF_CLK+: U1.C15 (GCA2/IO28PDB1V0); also elsewhere on the board
REF_CLK-: U1.C16 (IO28NDB1V0); also elsewhere on the board
SPI0_MISO: U1.M16 (SPI_0_DI/GPIO_17); also elsewhere on the board
SPI0_MOSI: U1.N16 (SPI_0_DO/GPIO_16); also elsewhere on the board
SPI0_SCLK: U1.M15 (SPI_0_CLK/GPIO_18); also elsewhere on the board
SPI0_SS: R68.1, U1.M13 (SPI_0_SS/GPIO_19); also elsewhere on the board
SPI1_MISO: U1.L15 (SPI_1_DI/GPIO_25); also elsewhere on the board
SPI1_MOSI: U1.L12 (SPI_1_DO/GPIO_24); also elsewhere on the board
SPI1_SCLK: U1.L14 (SPI_1_CLK/GPIO_26); also elsewhere on the board
SPI1_SS: R69.1, U1.L13 (SPI_1_SS/GPIO_27); also elsewhere on the board
UART0_RXD: R63.2, U1.K12 (UART_0_RXD/GPIO_21)
UART0_TXD: R62.2, U1.K16 (UART_0_TXD/GPIO_20)
UART1_RXD: R65.1; also elsewhere on the board
UART1_RXDI: R65.2, U1.K15 (UART_1_RXD/GPIO_29)
UART1_TXD: R64.1; also elsewhere on the board
UART1_TXDI: R64.2, U1.K14 (UART_1_TXD/GPIO_28)
USB_CLK: U1.F14 (GCB0/IO34NDB1V0); also elsewhere on the board
USB_DB0: R63.1; also elsewhere on the board
USB_DB1: R62.1; also elsewhere on the board

Notes on the sheet:
ORANGE
GREEN

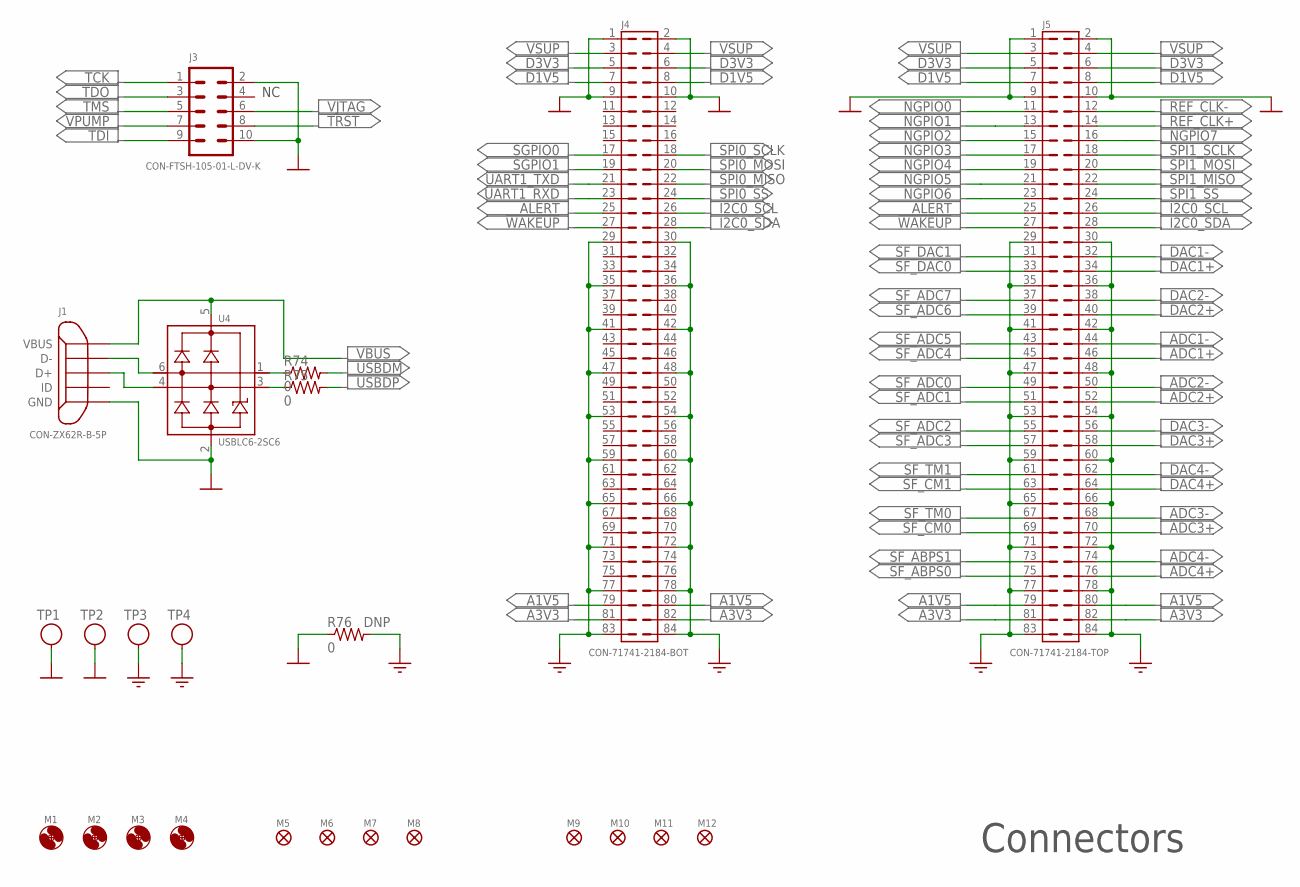
[picture p142: schematic MainBoard.sch, sheet 10]

Parts:
J1: CON-ZX62R-B-5P; ZX62R-B-5P
J3: CON-FTSH-105-01-L-DV-K; FTSH-105-01-L-DV-K
J4: CON-71741-2184-BOT; 71742-3003-BOT
J5: CON-71741-2184-TOP; 71741-0002; MPN 71741-0002; DIGI-KEY# WM3498CT-ND
M1, M2, M3, M4: MOUNT-HOLE3.3; 3,3
M5, M6, M7, M8, M9, M10, M11, M12: FIDUCIAL1X2; FIDUCIAL-1X2
R74, R75: 0; R0402
R76: 0; R0603
TP1, TP2: TESTPOINT-YELLOW; TESTPOINT
TP3, TP4: TESTPOINT-GREEN; TESTPOINT
U4: USBLC6-2SC6; SOT23-6L

Connections:
!WAKEUP: J4.27, J5.27; also elsewhere on the board
A1V5: J4.79, J4.80, J5.79, J5.80; also elsewhere on the board
A3V3: J4.81, J4.82, J5.81, J5.82; also elsewhere on the board
ADC1+: J5.46; also elsewhere on the board
ADC1-: J5.44; also elsewhere on the board
ADC2+: J5.52; also elsewhere on the board
ADC2-: J5.50; also elsewhere on the board
ADC3+: J5.70; also elsewhere on the board
ADC3-: J5.68; also elsewhere on the board
ADC4+: J5.76; also elsewhere on the board
ADC4-: J5.74; also elsewhere on the board
AGND: J4.29, J4.30, J4.35, J4.36, J4.41, J4.42, J4.47, J4.48, J4.53, J4.54, J4.59, J4.60, J4.65, J4.66, J4.71, J4.72, J4.77, J4.78, J4.83, J4.84, J5.29, J5.30, J5.35, J5.36, J5.41, J5.42, J5.47, J5.48, J5.53, J5.54, J5.59, J5.60, J5.65, J5.66, J5.71, J5.72, J5.77, J5.78, J5.83, J5.84, R76.2, TP3.1, TP4.1; also elsewhere on the board
ALERT: J4.25, J5.25; also elsewhere on the board
D1V5: J4.7, J4.8, J5.7, J5.8; also elsewhere on the board
D3V3: J4.5, J4.6, J5.5, J5.6; also elsewhere on the board
DAC1+: J5.34; also elsewhere on the board
DAC1-: J5.32; also elsewhere on the board
DAC2+: J5.40; also elsewhere on the board
DAC2-: J5.38; also elsewhere on the board
DAC3+: J5.58; also elsewhere on the board
DAC3-: J5.56; also elsewhere on the board
DAC4+: J5.64; also elsewhere on the board
DAC4-: J5.62; also elsewhere on the board
DGND: J1.5 (GND), J3.2, J3.10, J4.1, J4.2, J4.9, J4.10, J5.1, J5.2, J5.9, J5.10, R76.1, TP1.1, TP2.1, U4.2 (GND); also elsewhere on the board
I2C0_SCL: J4.26, J5.26; also elsewhere on the board
I2C0_SDA: J4.28, J5.28; also elsewhere on the board
NGPIO0: J5.11; also elsewhere on the board
NGPIO1: J5.13; also elsewhere on the board
NGPIO2: J5.15; also elsewhere on the board
NGPIO3: J5.17; also elsewhere on the board
NGPIO4: J5.19; also elsewhere on the board
NGPIO5: J5.21; also elsewhere on the board
NGPIO6: J5.23; also elsewhere on the board
NGPIO7: J5.16; also elsewhere on the board
REF_CLK+: J5.14; also elsewhere on the board
REF_CLK-: J5.12; also elsewhere on the board
SF_ABPS0: J5.75; also elsewhere on the board
SF_ABPS1: J5.73; also elsewhere on the board
SF_ADC0: J5.49; also elsewhere on the board
SF_ADC1: J5.51; also elsewhere on the board
SF_ADC2: J5.55; also elsewhere on the board
SF_ADC3: J5.57; also elsewhere on the board
SF_ADC4: J5.45; also elsewhere on the board
SF_ADC5: J5.43; also elsewhere on the board
SF_ADC6: J5.39; also elsewhere on the board
SF_ADC7: J5.37; also elsewhere on the board
SF_CM0: J5.69; also elsewhere on the board
SF_CM1: J5.63; also elsewhere on the board
SF_DAC0: J5.33; also elsewhere on the board
SF_DAC1: J5.31; also elsewhere on the board
SF_TM0: J5.67; also elsewhere on the board
SF_TM1: J5.61; also elsewhere on the board
SGPIO0: J4.17; also elsewhere on the board
SGPIO1: J4.19; also elsewhere on the board
SPI0_MISO: J4.22; also elsewhere on the board
SPI0_MOSI: J4.20; also elsewhere on the board
SPI0_SCLK: J4.18; also elsewhere on the board
SPI0_SS: J4.24; also elsewhere on the board
SPI1_MISO: J5.22; also elsewhere on the board
SPI1_MOSI: J5.20; also elsewhere on the board
SPI1_SCLK: J5.18; also elsewhere on the board
SPI1_SS: J5.24; also elsewhere on the board
TCK: J3.1; also elsewhere on the board
TDI: J3.9; also elsewhere on the board
TDO: J3.3; also elsewhere on the board
TMS: J3.5; also elsewhere on the board
TRST: J3.8; also elsewhere on the board
UART1_RXD: J4.23; also elsewhere on the board
UART1_TXD: J4.21; also elsewhere on the board
USBDM: R74.2; also elsewhere on the board
USBDM-IN: J1.2 (D-), U4.6 (IO1)
USBDM-OUT: R74.1, U4.1 (IO1)
USBDP: R75.2; also elsewhere on the board
USBDP-IN: J1.3 (D+), U4.4 (IO2)
USBDP-OUT: R75.1, U4.3 (IO2)
VBUS: J1.1 (VBUS), U4.5 (VBUS); also elsewhere on the board
VJTAG: J3.6; also elsewhere on the board
VPUMP: J3.7; also elsewhere on the board
VSUP: J4.3, J4.4, J5.3, J5.4

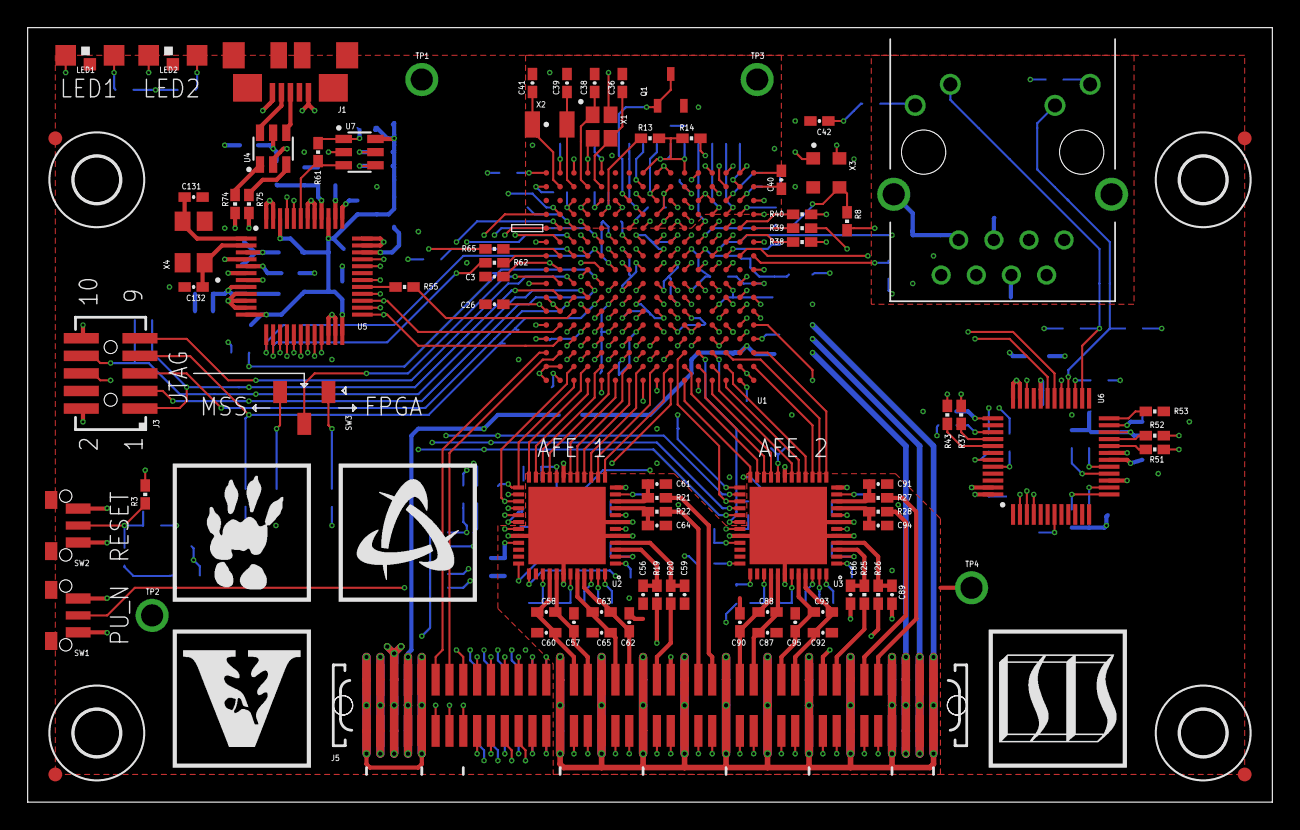
[picture p143: board MainBoard.brd from above]

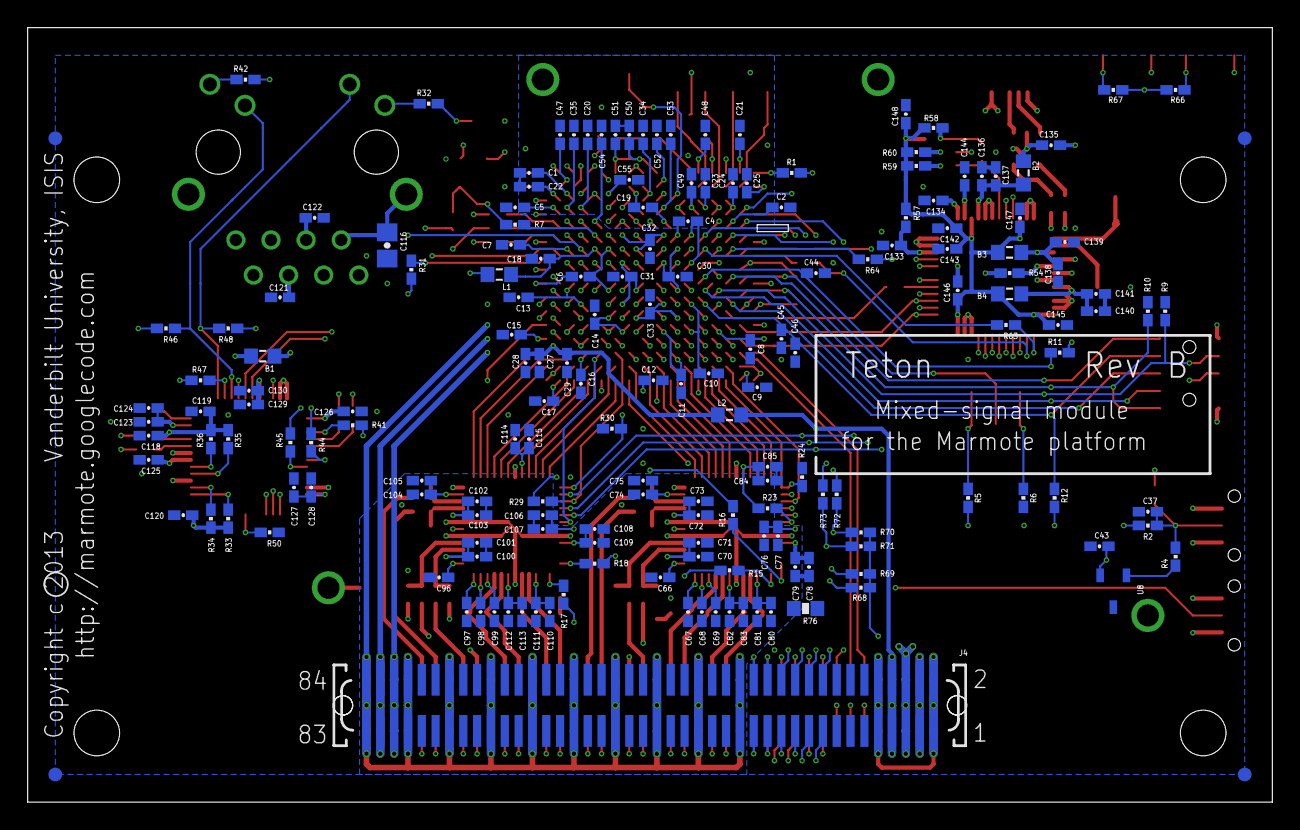
[picture p144: board MainBoard.brd from below]

Board: 6 copper layers, 90.0 x 56.0 mm, 270 parts (177 on the bottom side), 221 nets.
