marmote/marmote/hardware/RFWBBoard_RevB/RFWBBoard.brd

## EAGLE design hardware/RFWBBoard_RevB/RFWBBoard.brd (2013-01-11)

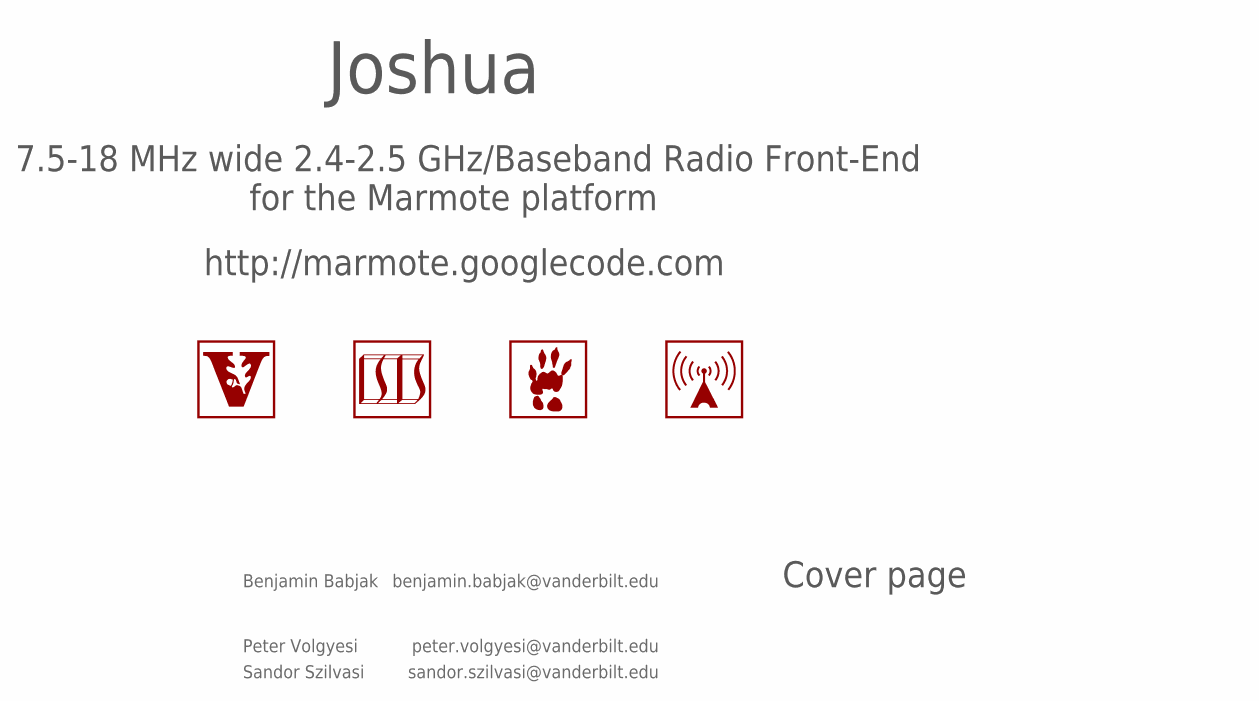
[picture p145: schematic RFWBBoard.sch, sheet 1]

Parts:
LOGO4: LOGO-ISIS-600MIL-10MM-SS; LOGO-ISIS-10MM-SILKSCREEN
LOGO5: LOGO-VANDERBILT-600MIL-10MM-SS; LOGO-VANDERBILT-10MM-SILKSCREEN
LOGO6: LOGO-MARMOTE-600MIL-10MM-SS; LOGO-MARMOTE-10MM-SILKSCREEN
LOGO7: LOGO-RADIO-3-600MIL-10MM-SS; LOGO-RADIO-FILLED-10MM-SILKSCREEN

Notes on the sheet:
7.5-18 MHz wide 2.4-2.5 GHz/Baseband Radio Front-End
http://marmote.googlecode.com
for the Marmote platform

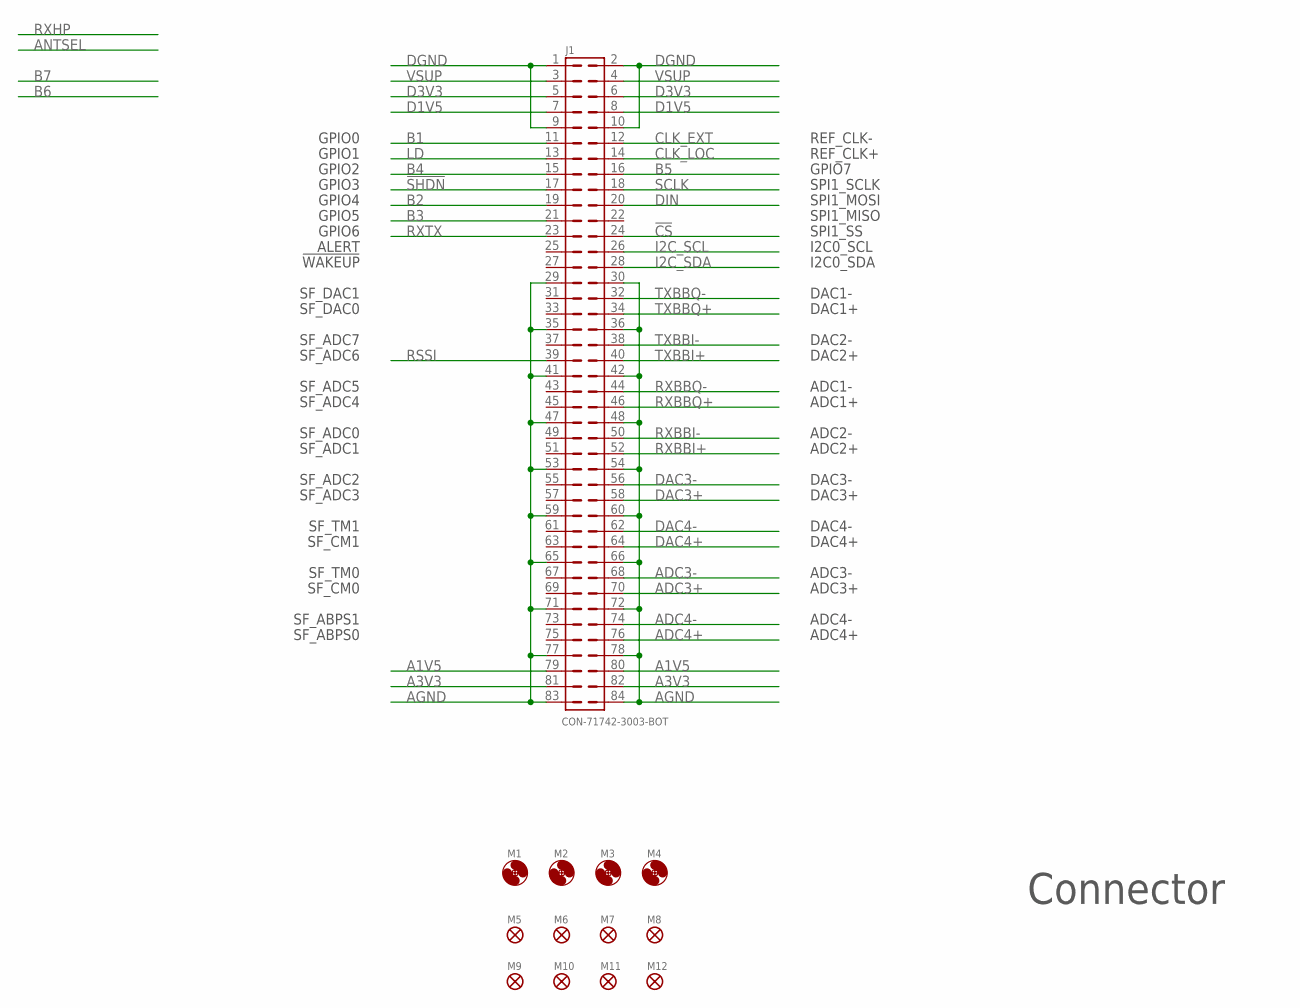
[picture p146: schematic RFWBBoard.sch, sheet 2]

Parts:
J1: CON-71742-3003-BOT; 71742-3003-BOT
M1, M2, M3, M4: MOUNT-HOLE3.3; 3,3
M5, M6, M7, M8, M9, M10, M11, M12: FIDUCIAL1X2; FIDUCIAL-1X2

Connections:
!CS: J1.24; also elsewhere on the board
!SHDN: J1.17; also elsewhere on the board
A1V5: J1.79, J1.80
A3V3: J1.81, J1.82; also elsewhere on the board
ADC3+: J1.70; also elsewhere on the board
ADC3-: J1.68; also elsewhere on the board
ADC4+: J1.76; also elsewhere on the board
ADC4-: J1.74; also elsewhere on the board
AGND: J1.29, J1.30, J1.35, J1.36, J1.41, J1.42, J1.47, J1.48, J1.53, J1.54, J1.59, J1.60, J1.65, J1.66, J1.71, J1.72, J1.77, J1.78, J1.83, J1.84; also elsewhere on the board
B1: J1.11; also elsewhere on the board
B2: J1.19; also elsewhere on the board
B3: J1.21; also elsewhere on the board
B4: J1.15; also elsewhere on the board
B5: J1.16; also elsewhere on the board
CLK_EXT: J1.12; also elsewhere on the board
CLK_LOC: J1.14; also elsewhere on the board
D1V5: J1.7, J1.8
D3V3: J1.5, J1.6; also elsewhere on the board
DAC3+: J1.58; also elsewhere on the board
DAC3-: J1.56; also elsewhere on the board
DAC4+: J1.64; also elsewhere on the board
DAC4-: J1.62; also elsewhere on the board
DGND: J1.1, J1.2, J1.9, J1.10; also elsewhere on the board
DIN: J1.20; also elsewhere on the board
I2C_SCL: J1.26; also elsewhere on the board
I2C_SDA: J1.28; also elsewhere on the board
LD: J1.13; also elsewhere on the board
RSSI: J1.39; also elsewhere on the board
RXBBI+: J1.52; also elsewhere on the board
RXBBI-: J1.50; also elsewhere on the board
RXBBQ+: J1.46; also elsewhere on the board
RXBBQ-: J1.44; also elsewhere on the board
RXTX: J1.23; also elsewhere on the board
SCLK: J1.18; also elsewhere on the board
TXBBI+: J1.40; also elsewhere on the board
TXBBI-: J1.38; also elsewhere on the board
TXBBQ+: J1.34; also elsewhere on the board
TXBBQ-: J1.32; also elsewhere on the board
VSUP: J1.3, J1.4

Notes on the sheet:
SF_ADC6
GPIO2
GPIO3
GPIO1
GPIO0
GPIO4
SPI1_SCLK
SPI1_MOSI
SPI1_MISO
SPI1_SS
I2C0_SCL
I2C0_SDA
DAC1-
DAC1+
DAC2-
DAC2+
ADC1-
ADC1+
ADC2-
ADC2+
DAC3-
DAC3+
DAC4-
DAC4+
ADC3-
ADC3+
ADC4-
ADC4+
REF_CLK-
REF_CLK+
GPIO5
ALERT
!WAKEUP
SF_ADC7
SF_DAC1
SF_DAC0
SF_ADC5
SF_ADC4
SF_ADC0
SF_ADC1
SF_ADC2
SF_ADC3
SF_TM1
SF_CM1
SF_TM0
SF_CM0
SF_ABPS1
SF_ABPS0
GPIO6
GPIO7

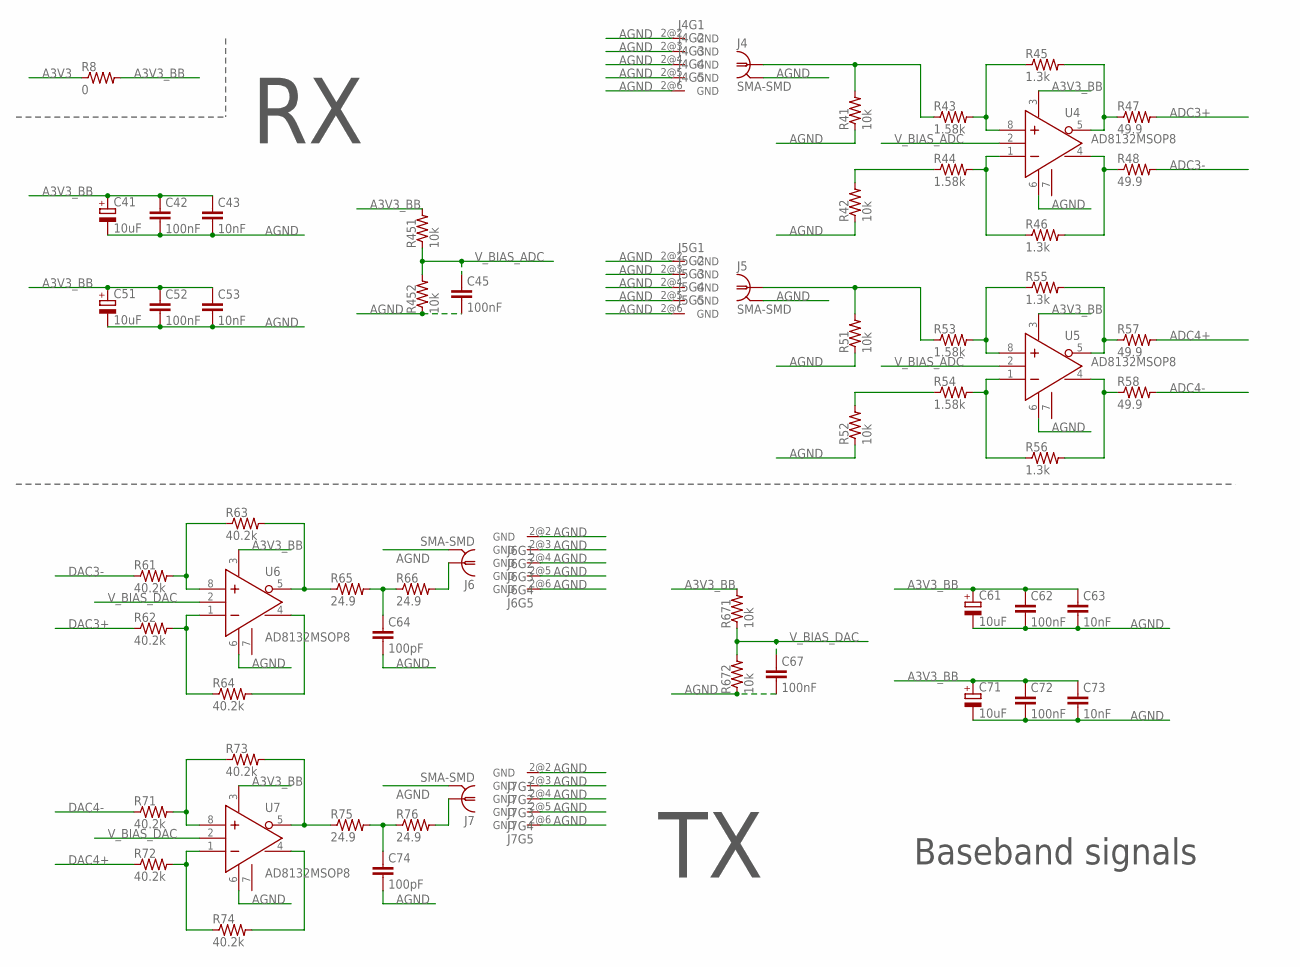
[picture p147: schematic RFWBBoard.sch, sheet 3]

Parts:
C41, C51, C61, C71: 10uF; CPOL2012
C42, C45, C52, C62, C67, C72: 100nF; C0402
C43, C53, C63, C73: 10nF; C0402
C64, C74: 100pF; C0402
J4, J5, J6, J7: SMA-SMD
R8: 0; R1206
R41, R42, R51, R52, R451, R452, R671, R672: 10k; R0402
R43, R44, R53, R54: 1.58k; R0402
R45, R46, R55, R56: 1.3k; R0402
R47, R48, R57, R58: 49.9; R0402
R61, R62, R63, R64, R71, R72, R73, R74: 40.2k; R0402
R65, R66, R75, R76: 24.9; R0402
U4, U5, U6, U7: AD8132MSOP8; MSOP8

Connections:
A3V3: R8.1; also elsewhere on the board
A3V3_BB: C41.+, C42.1, C43.1, C51.+, C52.1, C53.1, C61.+, C62.1, C63.1, C71.+, C72.1, C73.1, R8.2, R451.2, R671.2, U4.3 (V_S+), U5.3 (V_S+), U6.3 (V_S+), U7.3 (V_S+)
ADC3+: R47.2; also elsewhere on the board
ADC3-: R48.2; also elsewhere on the board
ADC4+: R57.2; also elsewhere on the board
ADC4-: R58.2; also elsewhere on the board
AGND: C41.-, C42.2, C43.2, C45.2, C51.-, C52.2, C53.2, C61.-, C62.2, C63.2, C64.2, C67.2, C71.-, C72.2, C73.2, C74.2, J4.2@1 (GND), J4.2@2 (GND), J4.2@3 (GND), J4.2@4 (GND), J4.2@5 (GND), J4.2@6 (GND), J5.2@1 (GND), J5.2@2 (GND), J5.2@3 (GND), J5.2@4 (GND), J5.2@5 (GND), J5.2@6 (GND), J6.2@1 (GND), J6.2@2 (GND), J6.2@3 (GND), J6.2@4 (GND), J6.2@5 (GND), J6.2@6 (GND), J7.2@1 (GND), J7.2@2 (GND), J7.2@3 (GND), J7.2@4 (GND), J7.2@5 (GND), J7.2@6 (GND), R41.1, R42.1, R51.1, R52.1, R452.1, R672.1, U4.6 (V_S-), U5.6 (V_S-), U6.6 (V_S-), U7.6 (V_S-); also elsewhere on the board
DAC3+: R62.1; also elsewhere on the board
DAC3-: R61.1; also elsewhere on the board
DAC4+: R72.1; also elsewhere on the board
DAC4-: R71.1; also elsewhere on the board
unnamed: J4.1, R41.2, R43.1
unnamed: R45.2, R47.1, U4.5 (-OUT)
unnamed: R46.2, R48.1, U4.4 (+OUT)
unnamed: R43.2, R45.1, U4.8 (+IN)
unnamed: R44.2, R46.1, U4.1 (-IN)
unnamed: J5.1, R51.2, R53.1
unnamed: R42.2, R44.1
unnamed: R55.2, R57.1, U5.5 (-OUT)
unnamed: R56.2, R58.1, U5.4 (+OUT)
unnamed: R53.2, R55.1, U5.8 (+IN)
unnamed: R54.2, R56.1, U5.1 (-IN)
unnamed: R52.2, R54.1
unnamed: R61.2, R63.1, U6.8 (+IN)
unnamed: R62.2, R64.1, U6.1 (-IN)
unnamed: R63.2, R65.1, U6.5 (-OUT)
unnamed: R64.2, U6.4 (+OUT)
unnamed: C64.1, R65.2, R66.1
unnamed: R71.2, R73.1, U7.8 (+IN)
unnamed: J6.1, R66.2
unnamed: R72.2, R74.1, U7.1 (-IN)
unnamed: R73.2, R75.1, U7.5 (-OUT)
unnamed: R74.2, U7.4 (+OUT)
unnamed: C74.1, R75.2, R76.1
unnamed: J7.1, R76.2
V_BIAS_ADC: C45.1, R451.1, R452.2, U4.2 (V_OCM), U5.2 (V_OCM)
V_BIAS_DAC: C67.1, R671.1, R672.2, U6.2 (V_OCM), U7.2 (V_OCM)

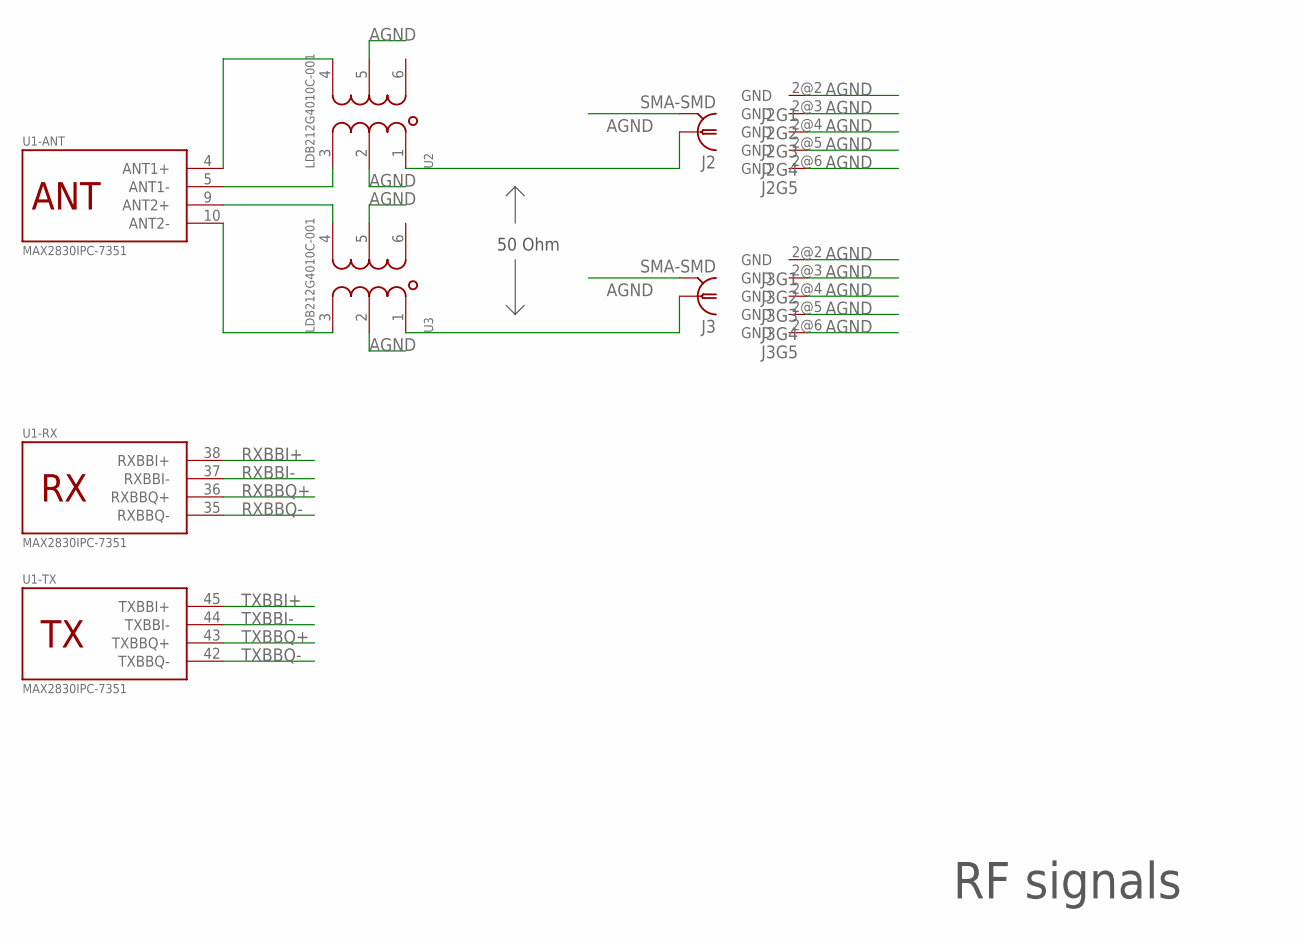
[picture p148: schematic RFWBBoard.sch, sheet 4]

Parts:
J2, J3: SMA-SMD
U1: MAX2830IPC-7351; TQFN-48
U2, U3: LDB212G4010C-001; LDB21-FOOTPRINT

Connections:
AGND: J2.2@1 (GND), J2.2@2 (GND), J2.2@3 (GND), J2.2@4 (GND), J2.2@5 (GND), J2.2@6 (GND), J3.2@1 (GND), J3.2@2 (GND), J3.2@3 (GND), J3.2@4 (GND), J3.2@5 (GND), J3.2@6 (GND), U2.2, U2.5, U3.2, U3.5; also elsewhere on the board
unnamed: U1.4 (ANT1+), U2.4
unnamed: U1.5 (ANT1-), U2.3
unnamed: U1.10 (ANT2-), U3.3
unnamed: U1.9 (ANT2+), U3.4
unnamed: J2.1, U2.1
unnamed: J3.1, U3.1
RXBBI+: U1.38 (RXBBI+); also elsewhere on the board
RXBBI-: U1.37 (RXBBI-); also elsewhere on the board
RXBBQ+: U1.36 (RXBBQ+); also elsewhere on the board
RXBBQ-: U1.35 (RXBBQ-); also elsewhere on the board
TXBBI+: U1.45 (TXBBI+); also elsewhere on the board
TXBBI-: U1.44 (TXBBI-); also elsewhere on the board
TXBBQ+: U1.43 (TXBBQ+); also elsewhere on the board
TXBBQ-: U1.42 (TXBBQ-); also elsewhere on the board

Notes on the sheet:
50 Ohm

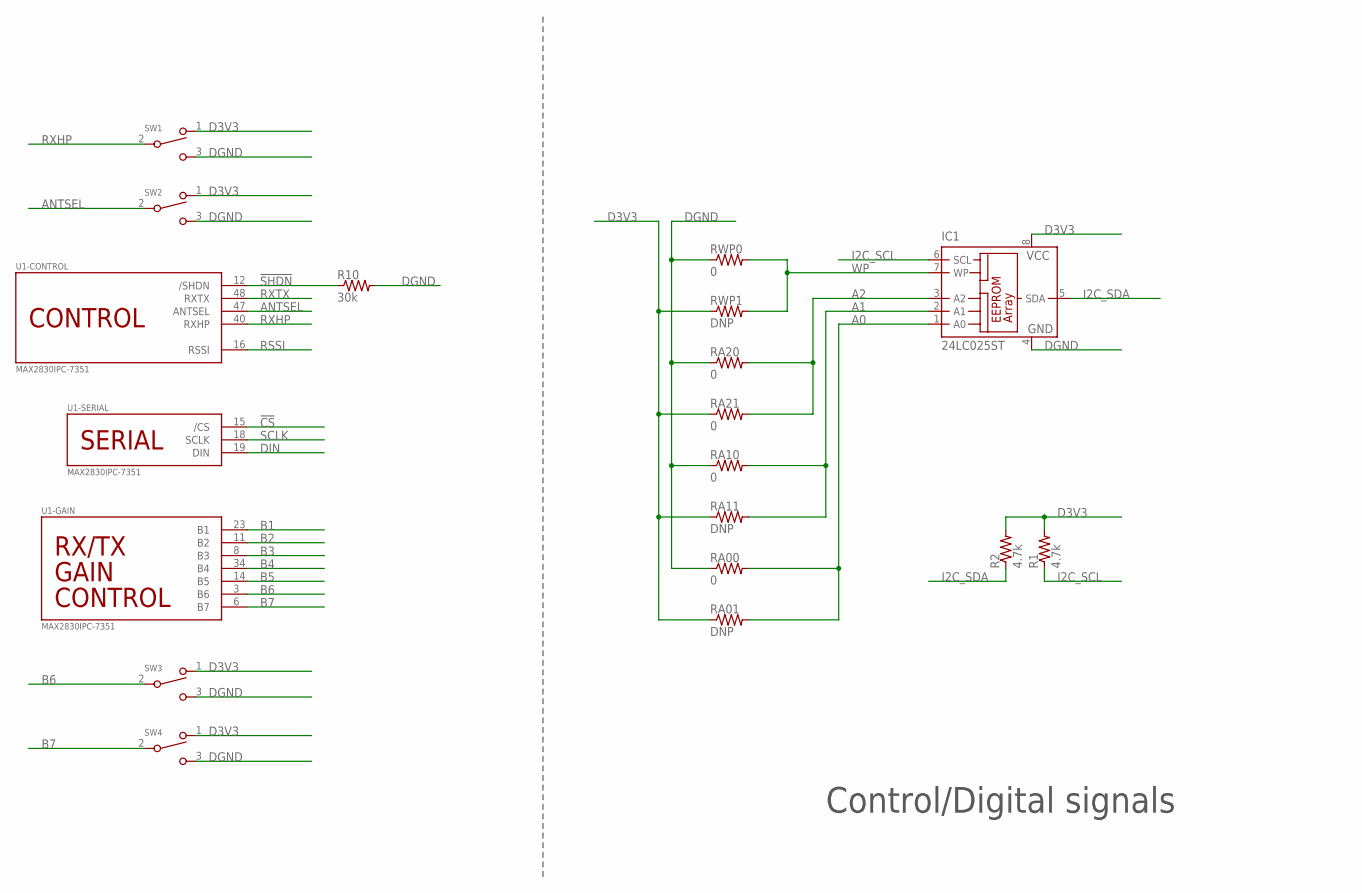
[picture p149: schematic RFWBBoard.sch, sheet 5]

Parts:
IC1: 24LC025ST; TSSOP8
R1, R2: 4.7k; R0402
R10: 30k; R0402
RA00, RA10, RA20, RA21: 0; R0402
RA01, RA11: DNP; R0402
RWP0: 0; R0402
RWP1: DNP; R0402
SW1, SW2, SW3, SW4: SWITCH-CJS-1200TA; SWITCH-DIP-CJS
U1: MAX2830IPC-7351; TQFN-48

Connections:
!CS: U1.15 (/CS); also elsewhere on the board
!SHDN: R10.1, U1.12 (/SHDN); also elsewhere on the board
A0: IC1.1 (A0), RA00.2, RA01.2
A1: IC1.2 (A1), RA10.2, RA11.2
A2: IC1.3 (A2), RA20.2, RA21.2
ANTSEL: SW2.2, U1.47 (ANTSEL)
B1: U1.23 (B1); also elsewhere on the board
B2: U1.11 (B2); also elsewhere on the board
B3: U1.8 (B3); also elsewhere on the board
B4: U1.34 (B4); also elsewhere on the board
B5: U1.14 (B5); also elsewhere on the board
B6: SW3.2, U1.3 (B6)
B7: SW4.2, U1.6 (B7)
D3V3: IC1.8 (VCC), R1.2, R2.2, RA01.1, RA11.1, RA21.1, RWP1.1, SW1.1, SW2.1, SW3.1, SW4.1; also elsewhere on the board
DGND: IC1.4 (GND), R10.2, RA00.1, RA10.1, RA20.1, RWP0.1, SW1.3, SW2.3, SW3.3, SW4.3; also elsewhere on the board
DIN: U1.19 (DIN); also elsewhere on the board
I2C_SCL: IC1.6 (SCL), R1.1; also elsewhere on the board
I2C_SDA: IC1.5 (SDA), R2.1; also elsewhere on the board
RSSI: U1.16 (RSSI); also elsewhere on the board
RXHP: SW1.2, U1.40 (RXHP)
RXTX: U1.48 (RXTX); also elsewhere on the board
SCLK: U1.18 (SCLK); also elsewhere on the board
WP: IC1.7 (WP), RWP0.2, RWP1.2

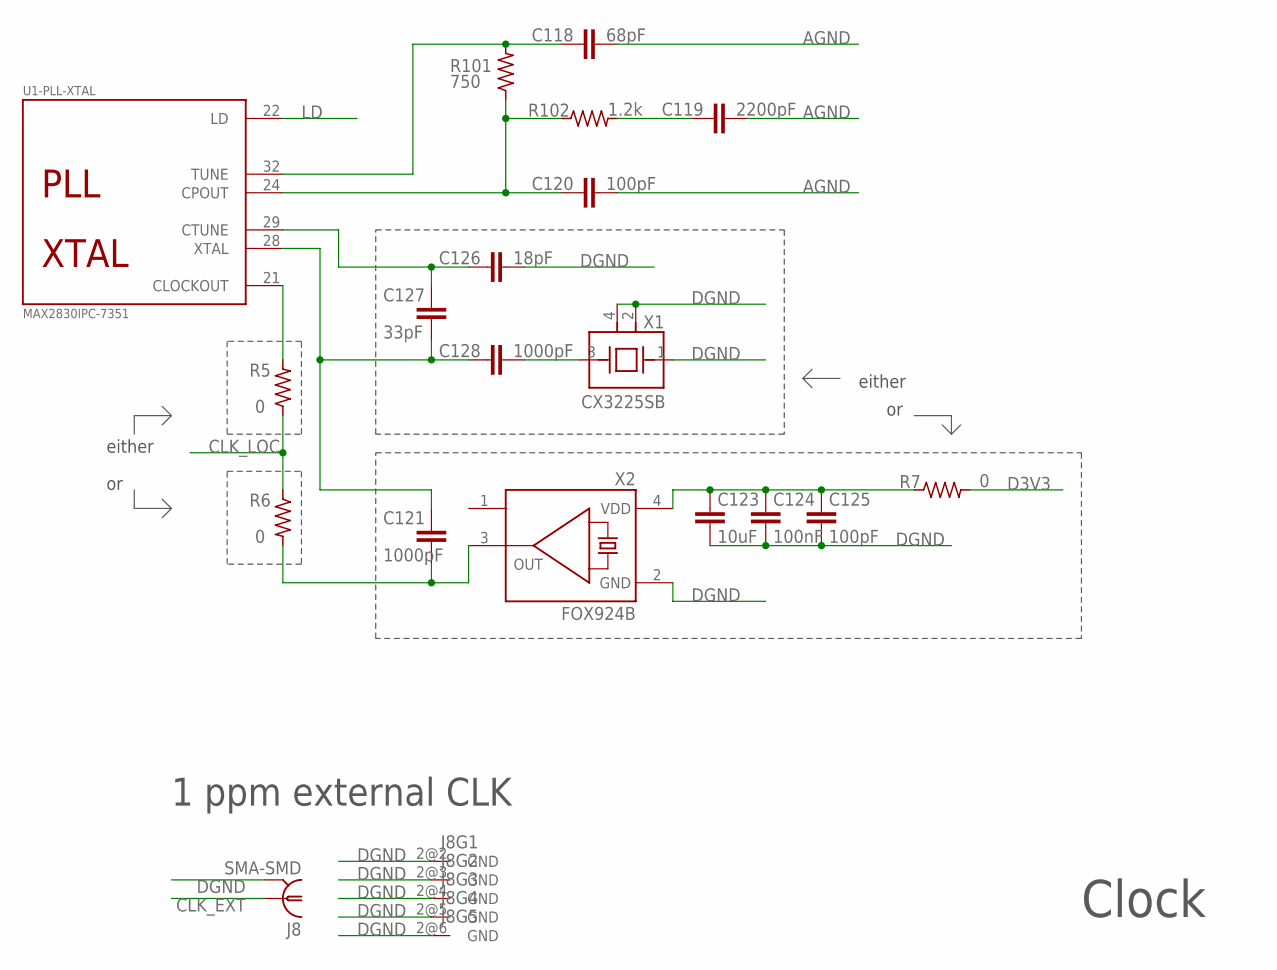
[picture p150: schematic RFWBBoard.sch, sheet 6]

Parts:
C118: 68pF; C0402
C119: 2200pF; C0402
C120, C125: 100pF; C0402
C121, C128: 1000pF; C0402
C123: 10uF; C0805
C124: 100nF; C0402
C126: 18pF; C0402
C127: 33pF; C0402
J8: SMA-SMD
R5, R6: 0; R0402
R7: 0; R1206
R101: 750; R0402
R102: 1.2k; R0402
U1: MAX2830IPC-7351; TQFN-48
X1: CX3225SB
X2: FOX924B; FOX924

Connections:
AGND: C118.2, C119.2, C120.2; also elsewhere on the board
CLK_EXT: J8.1; also elsewhere on the board
CLK_LOC: R5.1, R6.1; also elsewhere on the board
D3V3: R7.2; also elsewhere on the board
DGND: C123.2, C124.2, C125.2, C126.1, J8.2@1 (GND), J8.2@2 (GND), J8.2@3 (GND), J8.2@4 (GND), J8.2@5 (GND), J8.2@6 (GND), X1.1, X1.2, X1.4, X2.2 (GND); also elsewhere on the board
LD: U1.22 (LD); also elsewhere on the board
unnamed: C118.1, R101.2, U1.32 (TUNE)
unnamed: C121.1, C127.2, C128.2, U1.28 (XTAL)
unnamed: C119.1, R102.2
unnamed: C120.1, R101.1, R102.1, U1.24 (CPOUT)
unnamed: C121.2, R6.2, X2.3 (FO)
unnamed: C123.1, C124.1, C125.1, R7.1, X2.4 (VCC)
unnamed: R5.2, U1.21 (CLOCKOUT)
unnamed: C128.1, X1.3
unnamed: C126.2, C127.1, U1.29 (CTUNE)

Notes on the sheet:
either
1 ppm external CLK

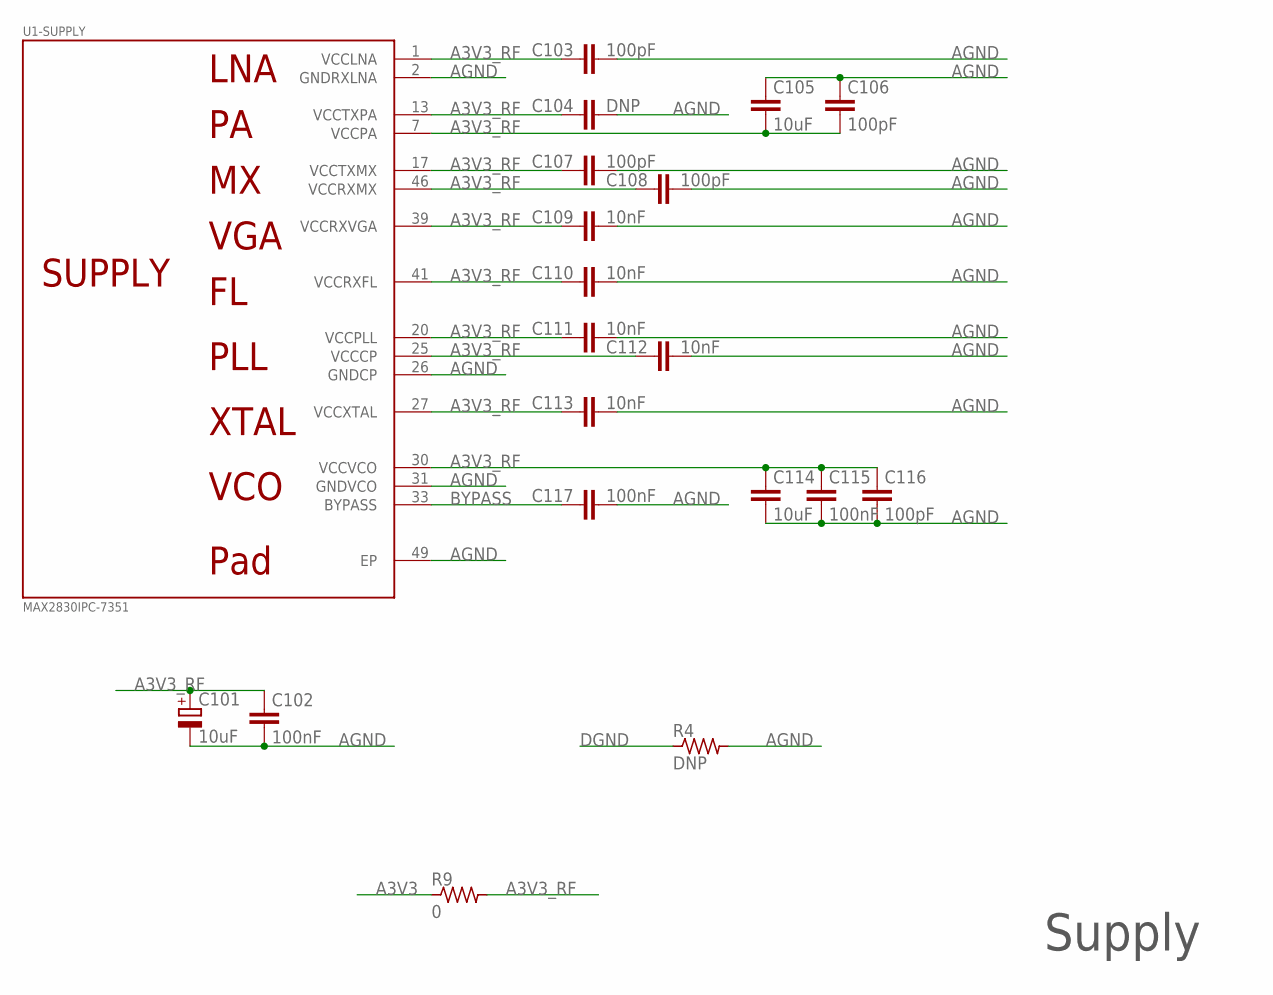
[picture p151: schematic RFWBBoard.sch, sheet 7]

Parts:
C101: 10uF; CPOL2012
C102, C115, C117: 100nF; C0402
C103, C106, C107, C108, C116: 100pF; C0402
C104: DNP; C0402
C105: 10uF; C1206
C109, C110, C111, C112, C113: 10nF; C0402
C114: 10uF; C0805
R4: DNP; R1206
R9: 0; R1206
U1: MAX2830IPC-7351; TQFN-48

Connections:
A3V3: R9.1; also elsewhere on the board
A3V3_RF: C101.+, C102.1, C103.1, C104.1, C105.2, C106.2, C107.1, C108.1, C109.1, C110.1, C111.1, C112.1, C113.1, C114.1, C115.1, C116.1, R9.2, U1.1 (VCCLNA), U1.7 (VCCPA), U1.13 (VCCTXPA), U1.17 (VCCTXMX), U1.20 (VCCPLL), U1.25 (VCCCP), U1.27 (VCCXTAL), U1.30 (VCCVCO), U1.39 (VCCRXVGA), U1.41 (VCCRXFL), U1.46 (VCCRXMX)
AGND: C101.-, C102.2, C103.2, C104.2, C105.1, C106.1, C107.2, C108.2, C109.2, C110.2, C111.2, C112.2, C113.2, C114.2, C115.2, C116.2, C117.2, R4.2, U1.2 (GNDRXLNA), U1.26 (GNDCP), U1.31 (GNDVCO), U1.49 (EP); also elsewhere on the board
BYPASS: C117.1, U1.33 (BYPASS)
DGND: R4.1; also elsewhere on the board
