marmote/marmote/hardware/RFWBBoard_RevB/RFWBBoard.brd

## EAGLE design hardware/RFWBBoard_RevB/RFWBBoard.brd (continued)

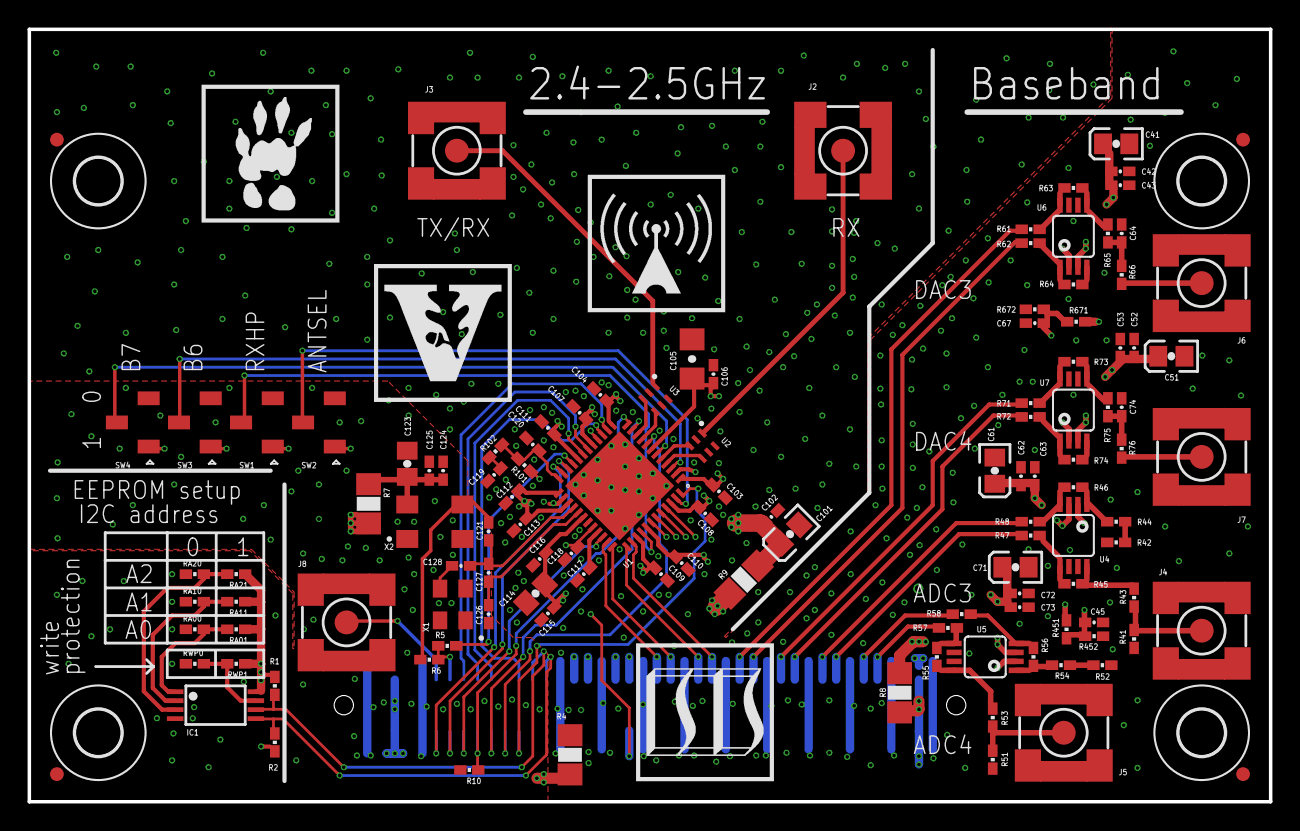
[picture p152: board RFWBBoard.brd from above]

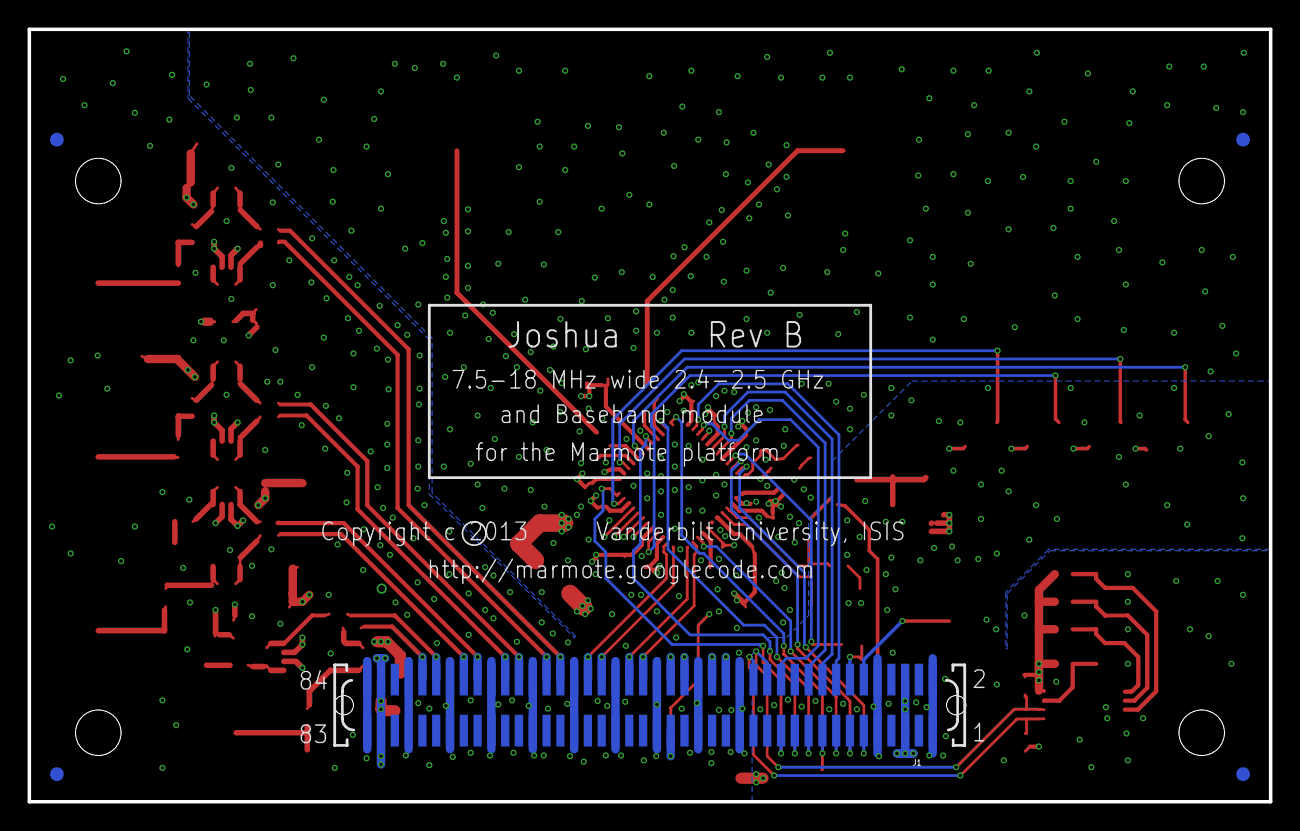
[picture p153: board RFWBBoard.brd from below]

Board: 6 copper layers, 90.0 x 56.0 mm, 132 parts (5 on the bottom side), 91 nets.
