marmote/marmote/hardware/PowerBoard_RevC/PowerBoard.brd

## EAGLE design hardware/PowerBoard_RevC/PowerBoard.brd (2013-01-18)

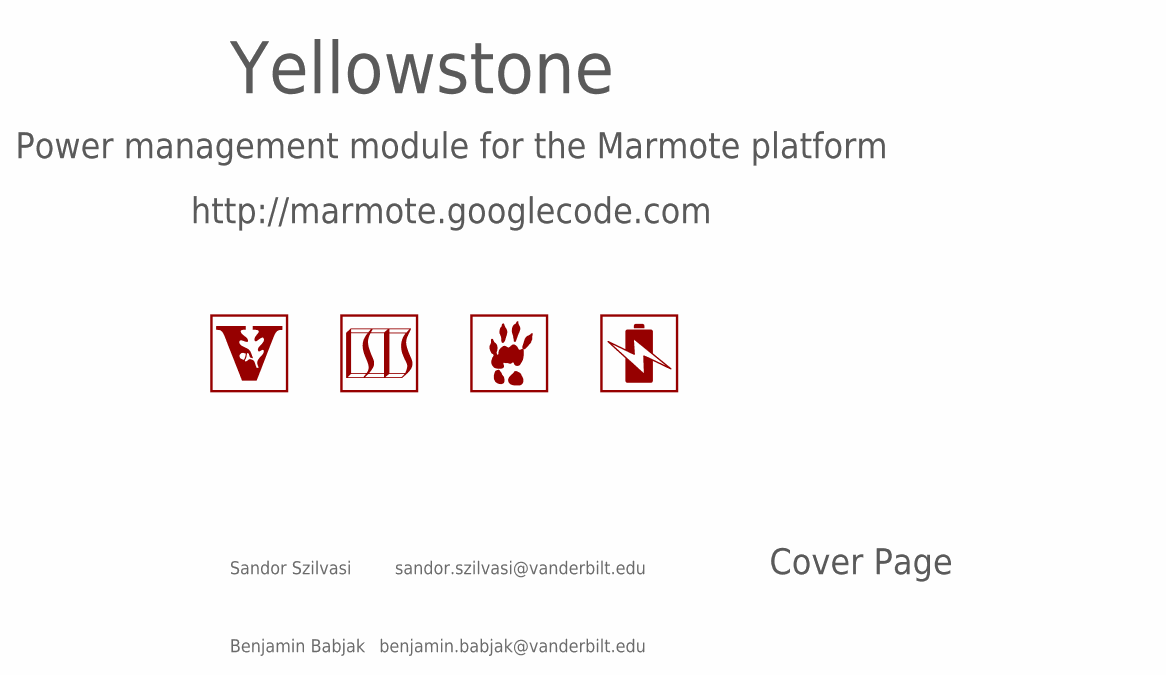
[picture p154: schematic PowerBoard.sch, sheet 1]

Parts:
LOGO1: LOGO-ISIS-600MIL-10MM-SS; LOGO-ISIS-10MM-SILKSCREEN
LOGO2: LOGO-BATTERY-600MIL-10MM-SS; LOGO-BATTERY-10MM-SILKSCREEN
LOGO5: LOGO-VANDERBILT-600MIL-10MM-SS; LOGO-VANDERBILT-10MM-SILKSCREEN
LOGO6: LOGO-MARMOTE-600MIL-10MM-SS; LOGO-MARMOTE-10MM-SILKSCREEN

Notes on the sheet:
Power management module for the Marmote platform
http://marmote.googlecode.com

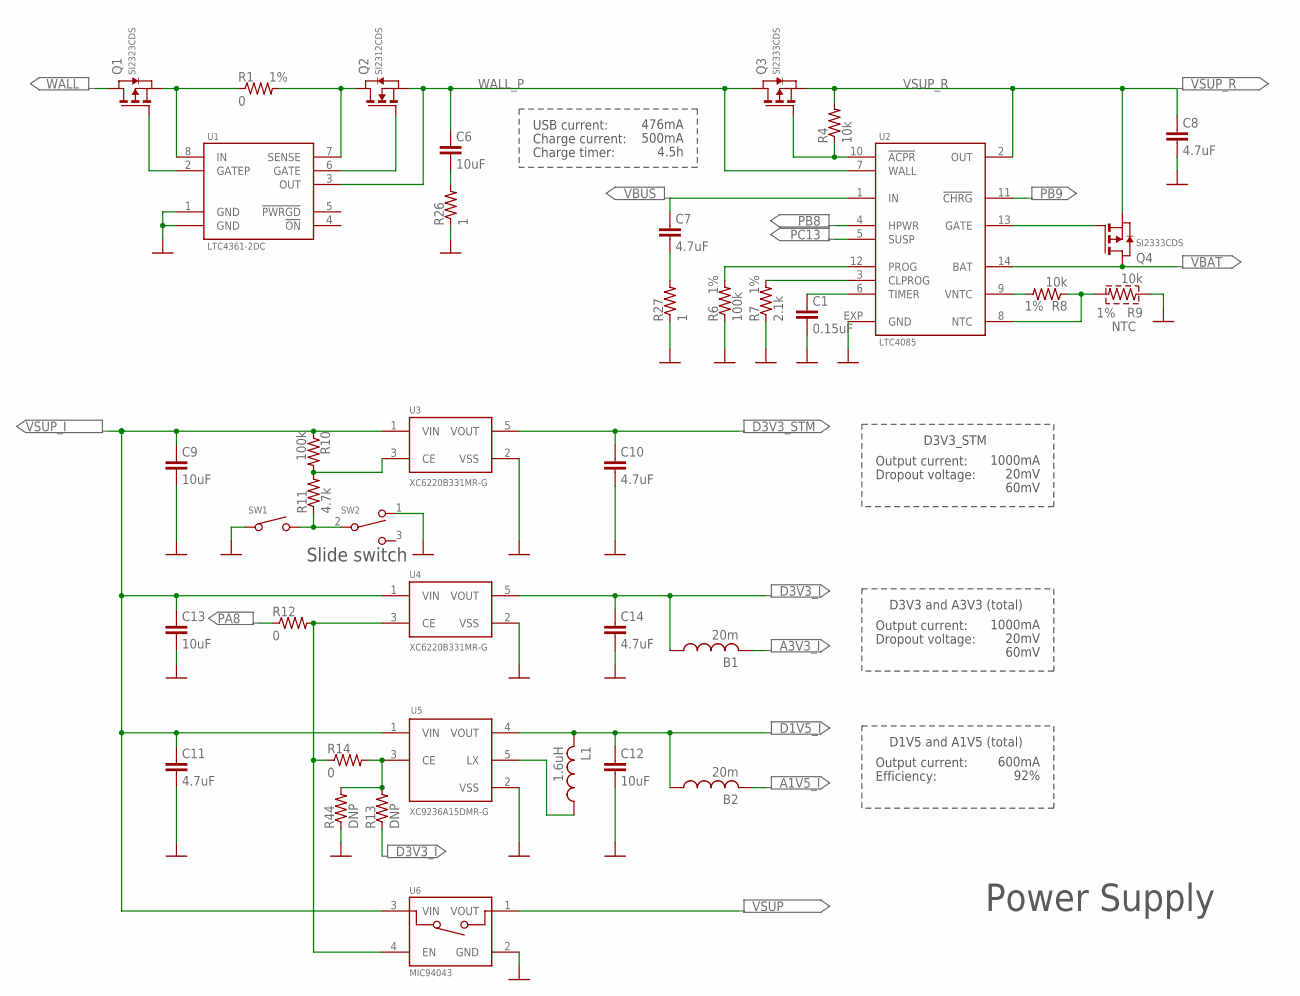
[picture p155: schematic PowerBoard.sch, sheet 2]

Parts:
B1, B2: 20m; L0603
C1: 0.15uF; C0603
C6, C9, C12, C13: 10uF; C0603
C7, C8, C10, C11, C14: 4.7uF; C0603
L1: 1.6uH; 4X4MM
Q1: SI2323CDS; SOT23-3L
Q2: SI2312CDS; SOT23-3L
Q3, Q4: SI2333CDS; SOT23-3L
R1: 0; R0603; TOLERANCE 1%
R4: 10k; R0603
R6: 100k; R0603; TOLERANCE 1%
R7: 2.1k; R0603; TOLERANCE 1%
R8, R9: 10k; R0603; TOLERANCE 1%
R10: 100k; R0603
R11: 4.7k; R0603
R12, R14: 0; R0603
R13, R44: DNP; R0603
R26, R27: 1; R0603
SW1: SWITCH-SPST; S2B-PH-SM4-TB
SW2: SWITCH-MS12ASG30; MS12ASX30
U1: LTC4361-2DC; DFN-8
U2: LTC4085; DFN-14
U3, U4: XC6220B331MR-G; SOT25
U5: XC9236A15DMR-G; SOT25
U6: MIC94043; MLF-4

Connections:
!ACPR: Q3.1 (G), R4.1, U2.10 (!ACPR)
A1V5_I: B2.2; also elsewhere on the board
A3V3_I: B1.2; also elsewhere on the board
CLPROG: R7.2, U2.3 (CLPROG)
D1V5-EN: R13.2, R14.2, R44.2, U5.3 (CE)
D1V5_I: B2.1, C12.1, L1.2, U5.4 (VOUT); also elsewhere on the board
D3V3_I: B1.1, C14.1, R13.1, U4.5 (VOUT); also elsewhere on the board
D3V3_STM: C10.1, U3.5 (VOUT); also elsewhere on the board
D3V3_STM-EN: R10.2, R11.2, U3.3 (CE)
D3V3_STM-EN-SW: R11.1, SW1.2 (1A), SW2.2
DGND: C1.2, C8.2, C9.2, C10.2, C11.2, C12.2, C13.2, C14.2, R6.1, R7.1, R9.2 (4), R26.1, R27.1, R44.1, SW1.1, SW2.1, U1.1 (GND), U1.EXP (GND), U2.EXP (GND), U3.2 (VSS), U4.2 (VSS), U5.2 (VSS), U6.2 (GND); also elsewhere on the board
GATE1: Q2.1 (G), U1.6 (GATE)
GATE2: Q4.1 (G), U2.13 (GATE)
GATEP: Q1.1 (G), U1.2 (GATEP)
IN: Q1.2 (S), R1.1, U1.8 (IN)
unnamed: C7.2, R27.2
unnamed: C6.2, R26.2
unnamed: L1.1, U5.5 (LX)
unnamed: Q2.3 (D), R1.2, U1.7 (SENSE)
NTC: R8.1, R9.1 (3), U2.8 (NTC)
PA8: R12.1; also elsewhere on the board
PA8-EN: R12.2, R14.1, U4.3 (CE), U6.4 (EN); also elsewhere on the board
PB8: U2.4 (HPWR); also elsewhere on the board
PB9: U2.11 (!CHRG); also elsewhere on the board
PC13: U2.5 (SUSP); also elsewhere on the board
PROG: R6.2, U2.12 (PROG)
TIMER: C1.1, U2.6 (TIMER)
VBAT: Q4.3 (D), U2.14 (BAT); also elsewhere on the board
VBUS: C7.1, U2.1 (IN); also elsewhere on the board
VNTC: R8.2, U2.9 (VNTC)
VSUP: U6.1 (VOUT); also elsewhere on the board
VSUP_I: C9.1, C11.1, C13.1, R10.1, U3.1 (VIN), U4.1 (VIN), U5.1 (VIN), U6.3 (VIN); also elsewhere on the board
VSUP_R: C8.1, Q3.2 (S), Q4.2 (S), R4.2, U2.2 (OUT); also elsewhere on the board
WALL: Q1.3 (D); also elsewhere on the board
WALL_P: C6.1, Q2.2 (S), Q3.3 (D), U1.3 (OUT), U2.7 (WALL)

Notes on the sheet:
USB current:
Charge current:
476mA
500mA
Charge timer:
4.5h
Output current:
Dropout voltage:
1000mA
20mV
60mV
D3V3 and A3V3 (total)
Efficiency:
600mA
92%
D1V5 and A1V5 (total)
D3V3_STM
Slide switch

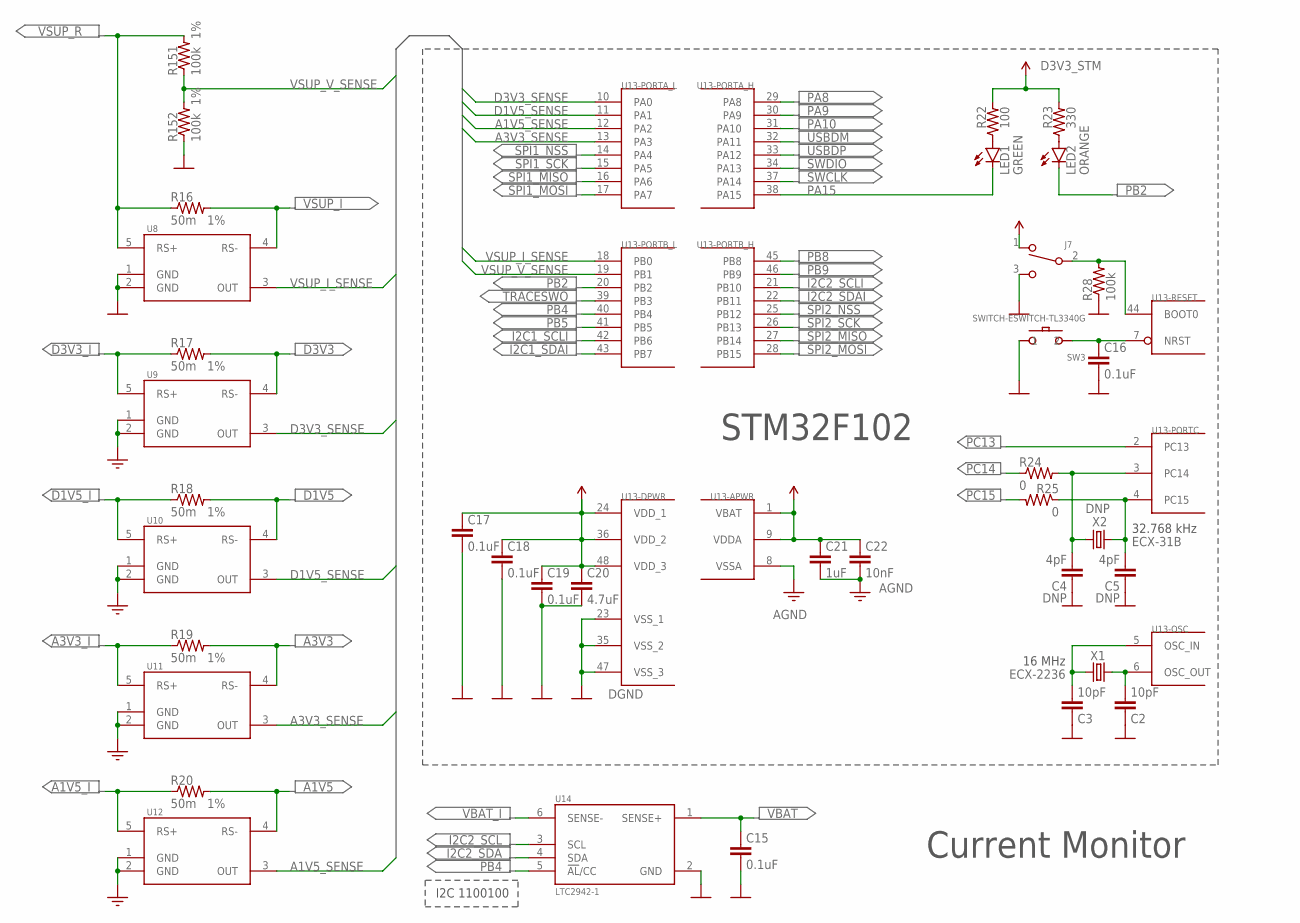
[picture p156: schematic PowerBoard.sch, sheet 3]

Parts:
C2, C3: 10pF; C0603
C4, C5: 4pF; C0603
C15, C16, C17, C18, C19: 0.1uF; C0603
C20: 4.7uF; C0603
C21: 1uF; C0603
C22: 10nF; C0603
J7: SWITCH-CJS-1200-1200; SWITCH-DIP-CJS
LED1: GREEN; LED1208-RA
LED2: ORANGE; LED1208-RA
R16, R17, R18, R19, R20: 50m; R0603; TOLERANCE 1%
R22: 100; R0603
R23: 330; R0603
R24, R25: 0; R0603
R28: 100k; R0603
R151, R152: 100k; R0603; TOLERANCE 1%
SW3: SWITCH-ESWITCH-TL3340G; TL3340
U8, U9, U10, U11, U12: MAX9938FEUK; SOT23-5L
U13: STM32F10XCXT6; TQFP-48
U14: LTC2942-1; DFN-6
X1: ECX-2236
X2: ECX-31B

Connections:
A1V5: R20.2, U12.4 (RS-); also elsewhere on the board
A1V5_I: R20.1, U12.5 (RS+); also elsewhere on the board
A1V5_SENSE: U12.3 (OUT), U13.12 (PA2)
A3V3: R19.2, U11.4 (RS-); also elsewhere on the board
A3V3_I: R19.1, U11.5 (RS+); also elsewhere on the board
A3V3_SENSE: U11.3 (OUT), U13.13 (PA3)
AGND: C21.2, C22.2, U9.1 (GND), U9.2 (GND), U10.1 (GND), U10.2 (GND), U11.1 (GND), U11.2 (GND), U12.1 (GND), U12.2 (GND), U13.8 (VSSA); also elsewhere on the board
BOOT0: J7.2, R28.2, U13.44 (BOOT0)
D1V5: R18.2, U10.4 (RS-); also elsewhere on the board
D1V5_I: R18.1, U10.5 (RS+); also elsewhere on the board
D1V5_SENSE: U10.3 (OUT), U13.11 (PA1)
D3V3: R17.2, U9.4 (RS-); also elsewhere on the board
D3V3_I: R17.1, U9.5 (RS+); also elsewhere on the board
D3V3_SENSE: U9.3 (OUT), U13.10 (PA0)
D3V3_STM: C17.1, C18.1, C19.1, C20.1, C21.1, C22.1, J7.1, R22.2, R23.2, U13.1 (VBAT), U13.9 (VDDA), U13.24 (VDD_1), U13.36 (VDD_2), U13.48 (VDD_3); also elsewhere on the board
DGND: C2.1, C3.1, C4.1, C5.1, C15.2, C16.2, C17.2, C18.2, C19.2, C20.2, J7.3, R28.1, R152.1, SW3.1, SW3.3 (1), U8.1 (GND), U8.2 (GND), U13.23 (VSS_1), U13.35 (VSS_2), U13.47 (VSS_3), U14.2 (GND), X1.2 (DGND), X1.4 (DGND); also elsewhere on the board
EXP: U14.EXP
I2C1_SCLI: U13.42 (PB6); also elsewhere on the board
I2C1_SDAI: U13.43 (PB7); also elsewhere on the board
I2C2_SCL: U14.3 (SCL); also elsewhere on the board
I2C2_SCLI: U13.21 (PB10); also elsewhere on the board
I2C2_SDA: U14.4 (SDA); also elsewhere on the board
I2C2_SDAI: U13.22 (PB11); also elsewhere on the board
unnamed: LED2.2 (A), R23.1
unnamed: LED1.2 (A), R22.1
NRST: C16.1, SW3.2, U13.7 (NRST)
OSC_IN: C3.2, U13.5 (OSC_IN), X1.3 (2)
OSC_OUT: C2.2, U13.6 (OSC_OUT), X1.1
PA8: U13.29 (PA8); also elsewhere on the board
PA9: U13.30 (PA9); also elsewhere on the board
PA10: U13.31 (PA10); also elsewhere on the board
PA15: LED1.1 (C), U13.38 (PA15)
PB2: LED2.1 (C), U13.20 (PB2); also elsewhere on the board
PB4: U13.40 (PB4), U14.5 (!AL!/CC); also elsewhere on the board
PB5: U13.41 (PB5); also elsewhere on the board
PB8: U13.45 (PB8); also elsewhere on the board
PB9: U13.46 (PB9); also elsewhere on the board
PC13: U13.2 (PC13); also elsewhere on the board
PC14: R24.1; also elsewhere on the board
PC14-S: C4.2, R24.2, U13.3 (PC14), X2.2
PC15: R25.2; also elsewhere on the board
PC15-S: C5.2, R25.1, U13.4 (PC15), X2.1
SPI1_MISO: U13.16 (PA6); also elsewhere on the board
SPI1_MOSI: U13.17 (PA7); also elsewhere on the board
SPI1_NSS: U13.14 (PA4); also elsewhere on the board
SPI1_SCK: U13.15 (PA5); also elsewhere on the board
SPI2_MISO: U13.27 (PB14); also elsewhere on the board
SPI2_MOSI: U13.28 (PB15); also elsewhere on the board
SPI2_NSS: U13.25 (PB12); also elsewhere on the board
SPI2_SCK: U13.26 (PB13); also elsewhere on the board
SWCLK: U13.37 (PA14); also elsewhere on the board
SWDIO: U13.34 (PA13); also elsewhere on the board
TRACESWO: U13.39 (PB3); also elsewhere on the board
USBDM: U13.32 (PA11); also elsewhere on the board
USBDP: U13.33 (PA12); also elsewhere on the board
VBAT: C15.1, U14.1 (SENSE+); also elsewhere on the board
VBAT_I: U14.6 (SENSE-); also elsewhere on the board
VSUP_I: R16.2, U8.4 (RS-); also elsewhere on the board
VSUP_I_SENSE: U8.3 (OUT), U13.18 (PB0)
VSUP_R: R16.1, R151.2, U8.5 (RS+); also elsewhere on the board
VSUP_V_SENSE: R151.1, R152.2, U13.19 (PB1)

Notes on the sheet:
STM32F102
16 MHz
I2C 1100100
32.768 kHz

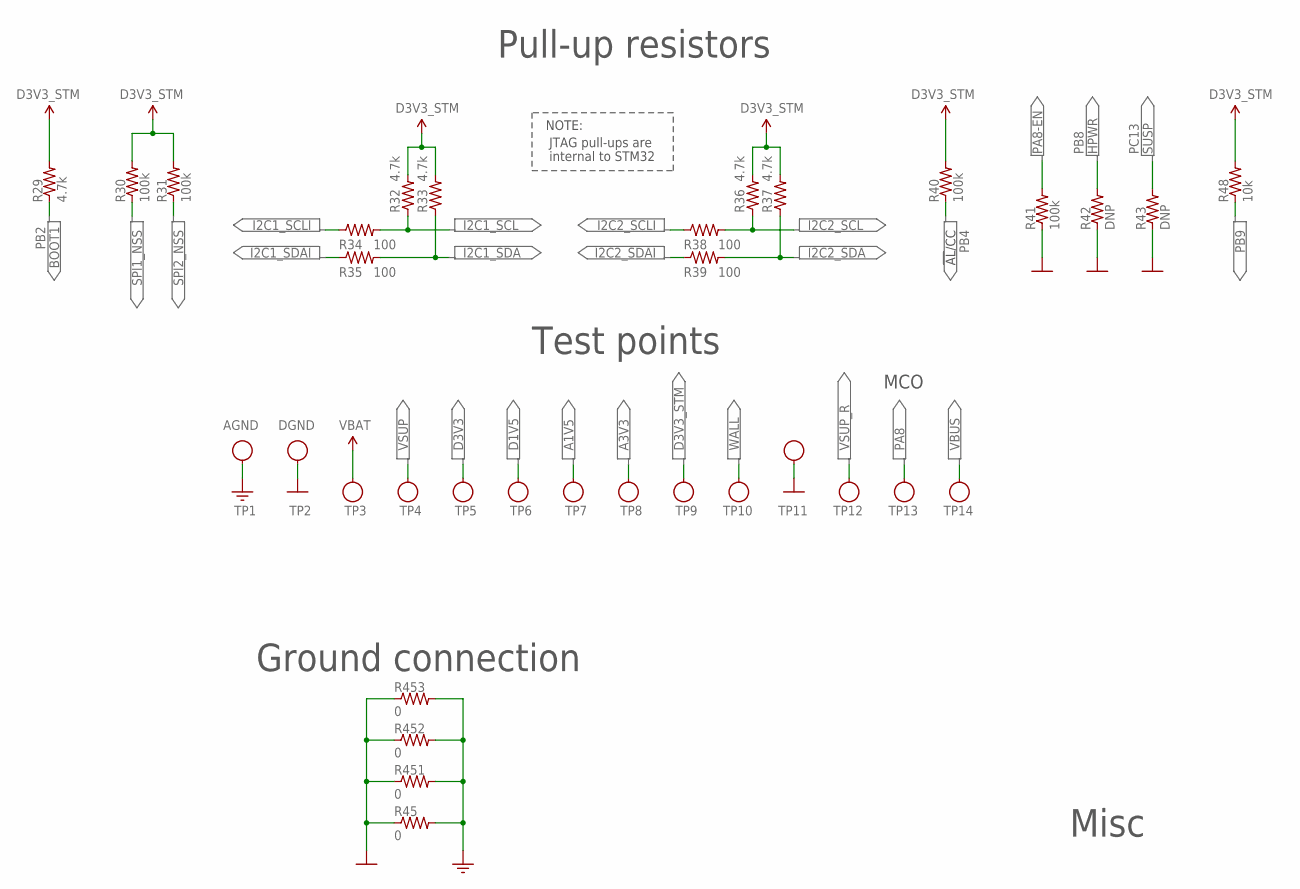
[picture p157: schematic PowerBoard.sch, sheet 4]

Parts:
R29, R32, R33, R36, R37: 4.7k; R0603
R30, R31, R40, R41: 100k; R0603
R34, R35, R38, R39: 100; R0603
R42, R43: DNP; R0603
R45, R451, R452, R453: 0; R0603
R48: 10k; R0603
TP1, TP2, TP3, TP4, TP5, TP6, TP7, TP8, TP9, TP10, TP11, TP12, TP13: TESTPOINT
TP14: TESTPOINT; MPN 5122; DIGI-KEY# 5122K-ND

Connections:
A1V5: TP7.1; also elsewhere on the board
A3V3: TP8.1; also elsewhere on the board
AGND: R45.2, R451.2, R452.2, R453.2, TP1.1; also elsewhere on the board
D1V5: TP6.1; also elsewhere on the board
D3V3: TP5.1; also elsewhere on the board
D3V3_STM: R29.2, R30.2, R31.2, R32.2, R33.2, R36.2, R37.2, R40.2, R48.2, TP9.1; also elsewhere on the board
DGND: R41.1, R42.1, R43.1, R45.1, R451.1, R452.1, R453.1, TP2.1, TP11.1; also elsewhere on the board
I2C1_SCL: R32.1, R34.2; also elsewhere on the board
I2C1_SCLI: R34.1; also elsewhere on the board
I2C1_SDA: R33.1, R35.2; also elsewhere on the board
I2C1_SDAI: R35.1; also elsewhere on the board
I2C2_SCL: R36.1, R38.2; also elsewhere on the board
I2C2_SCLI: R38.1; also elsewhere on the board
I2C2_SDA: R37.1, R39.2; also elsewhere on the board
I2C2_SDAI: R39.1; also elsewhere on the board
PA8: TP13.1; also elsewhere on the board
PA8-EN: R41.2; also elsewhere on the board
PB2: R29.1; also elsewhere on the board
PB4: R40.1; also elsewhere on the board
PB8: R42.2; also elsewhere on the board
PB9: R48.1; also elsewhere on the board
PC13: R43.2; also elsewhere on the board
SPI1_NSS: R30.1; also elsewhere on the board
SPI2_NSS: R31.1; also elsewhere on the board
VBAT: TP3.1; also elsewhere on the board
VBUS: TP14.1; also elsewhere on the board
VSUP: TP4.1; also elsewhere on the board
VSUP_R: TP12.1; also elsewhere on the board
WALL: TP10.1; also elsewhere on the board

Notes on the sheet:
Test points
Pull-up resistors
!AL!/CC
BOOT1
MCO
JTAG pull-ups are
internal to STM32
NOTE:
SUSP
HPWR
Ground connection

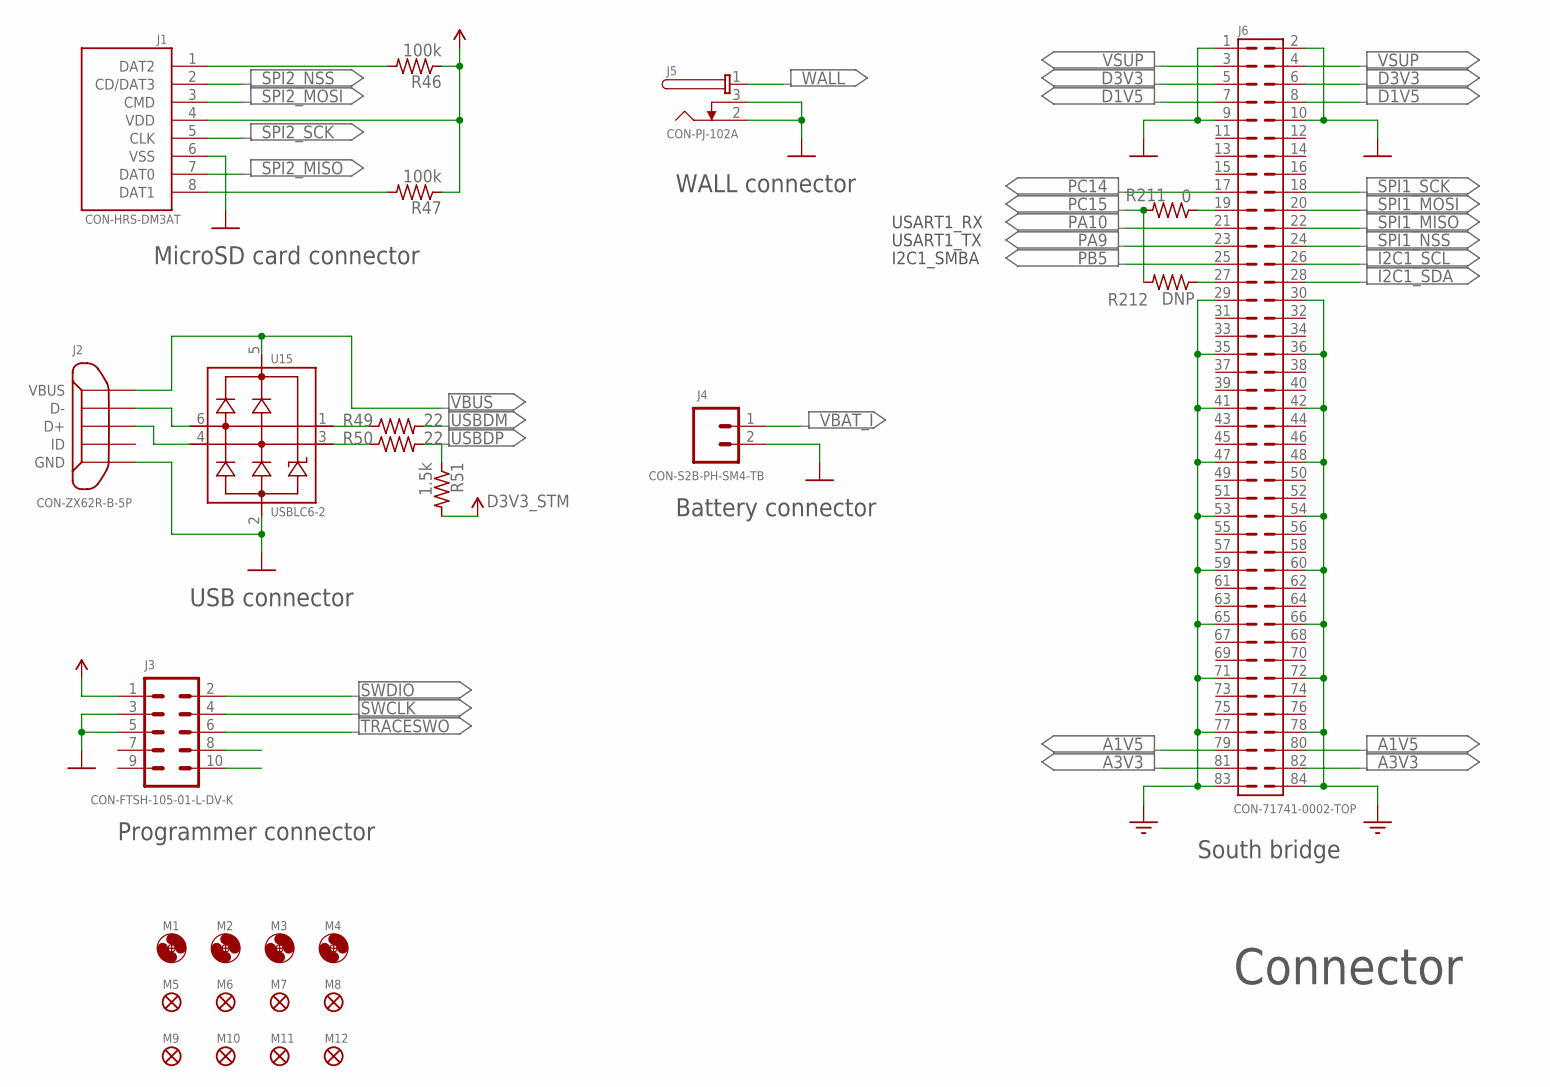
[picture p158: schematic PowerBoard.sch, sheet 5]

Parts:
J1: CON-HRS-DM3AT; HRS-DM3AT
J2: CON-ZX62R-B-5P; ZX62R-B-5P
J3: CON-FTSH-105-01-L-DV-K; FTSH-105-01-L-DV-K
J4: CON-S2B-PH-SM4-TB; S2B-PH-SM4-TB
J5: CON-PJ-102A; PJ-102A
J6: CON-71741-0002-TOP; 71741-0002
M1, M2, M3, M4: MOUNT-HOLE3.3; 3,3
M5, M6, M7, M8, M9, M10, M11, M12: FIDUCIAL1X2; FIDUCIAL-1X2
R46, R47: 100k; R0603
R49, R50: 22; R0603
R51: 1.5k; R0603
R211: 0; R0603
R212: DNP; R0603
U15: USBLC6-2; SOT23-6L

Connections:
A1V5: J6.79, J6.80; also elsewhere on the board
A3V3: J6.81, J6.82; also elsewhere on the board
AGND: J6.29, J6.30, J6.35, J6.36, J6.41, J6.42, J6.47, J6.48, J6.53, J6.54, J6.59, J6.60, J6.65, J6.66, J6.71, J6.72, J6.77, J6.78, J6.83, J6.84; also elsewhere on the board
D1V5: J6.7, J6.8; also elsewhere on the board
D3V3: J6.5, J6.6; also elsewhere on the board
D3V3_STM: J1.4 (VDD), J3.1, R46.1, R47.1, R51.2; also elsewhere on the board
DGND: J1.6 (VSS), J2.5 (GND), J3.3, J3.5, J4.2, J5.2, J5.3, J6.1, J6.2, J6.9, J6.10, U15.2 (GND); also elsewhere on the board
I2C1_SCL: J6.26; also elsewhere on the board
I2C1_SDA: J6.28; also elsewhere on the board
JNTRST: J3.10
JTDI: J3.8
unnamed: R50.1, U15.3 (IO2)
unnamed: R49.1, U15.1 (IO1)
unnamed: J6.27, R212.1
unnamed: J6.19, R211.1
unnamed: J1.1 (DAT2), R46.2
unnamed: J1.8 (DAT1), R47.2
PA9: J6.23; also elsewhere on the board
PA10: J6.21; also elsewhere on the board
PB5: J6.25; also elsewhere on the board
PC14: J6.17; also elsewhere on the board
PC15: R211.2, R212.2; also elsewhere on the board
SPI1_MISO: J6.22; also elsewhere on the board
SPI1_MOSI: J6.20; also elsewhere on the board
SPI1_NSS: J6.24; also elsewhere on the board
SPI1_SCK: J6.18; also elsewhere on the board
SPI2_MISO: J1.7 (DAT0); also elsewhere on the board
SPI2_MOSI: J1.3 (CMD); also elsewhere on the board
SPI2_NSS: J1.2 (CD/DAT3); also elsewhere on the board
SPI2_SCK: J1.5 (CLK); also elsewhere on the board
SWCLK: J3.4; also elsewhere on the board
SWDIO: J3.2; also elsewhere on the board
TRACESWO: J3.6; also elsewhere on the board
USBD+: J2.3 (D+), U15.4 (IO2)
USBD-: J2.2 (D-), U15.6 (IO1)
USBDM: R49.2; also elsewhere on the board
USBDP: R50.2, R51.1; also elsewhere on the board
VBAT_I: J4.1; also elsewhere on the board
VBUS: J2.1 (VBUS), U15.5 (VBUS); also elsewhere on the board
VSUP: J6.3, J6.4; also elsewhere on the board
WALL: J5.1; also elsewhere on the board

Notes on the sheet:
MicroSD card connector
South bridge
Programmer connector
USB connector
WALL connector
Battery connector
USART1_TX
USART1_RX
I2C1_SMBA

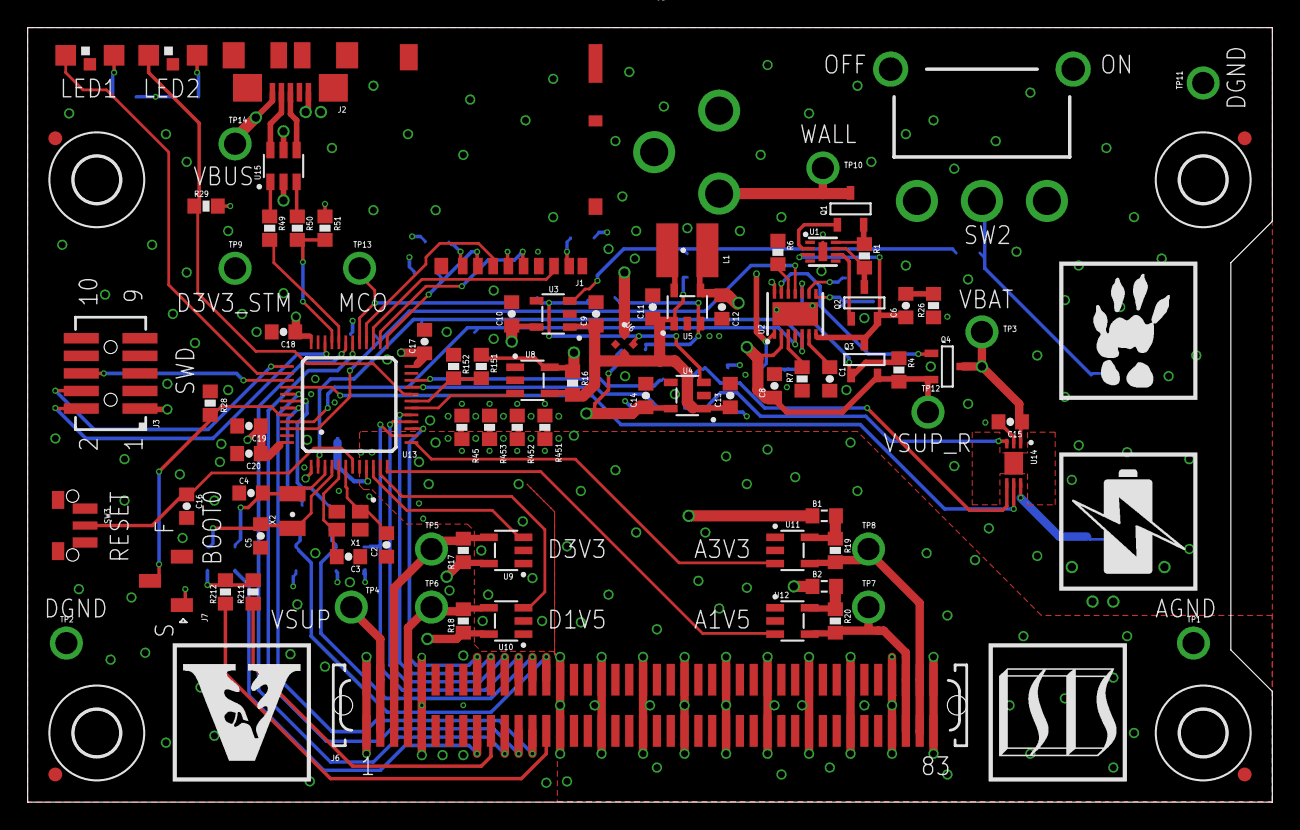
[picture p159: board PowerBoard.brd from above]

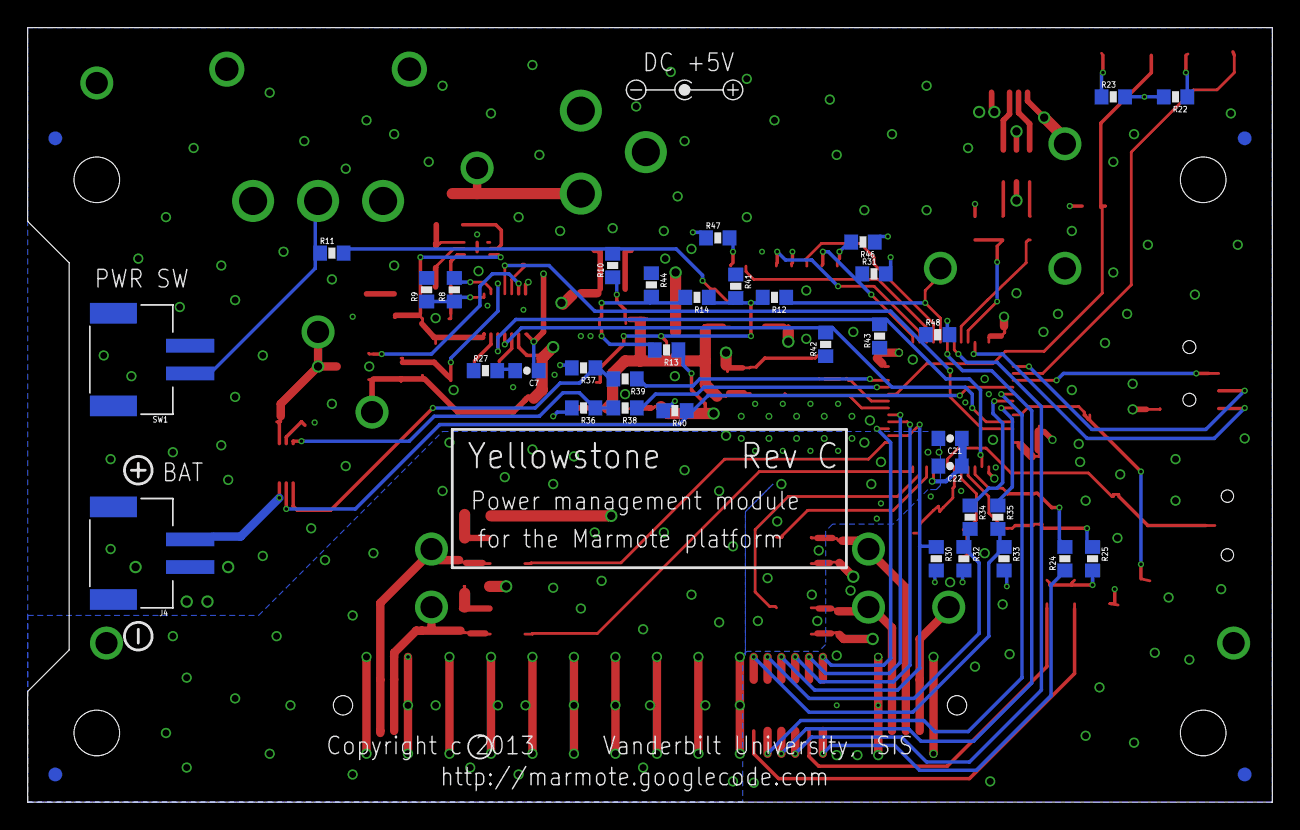
[picture p160: board PowerBoard.brd from below]

Board: 4 copper layers, 90.0 x 56.0 mm, 140 parts (39 on the bottom side), 92 nets.
