marmote/marmote/hardware/BreakoutBoard_RevB/BreakoutBoard.brd

## EAGLE design hardware/BreakoutBoard_RevB/BreakoutBoard.brd (continued)

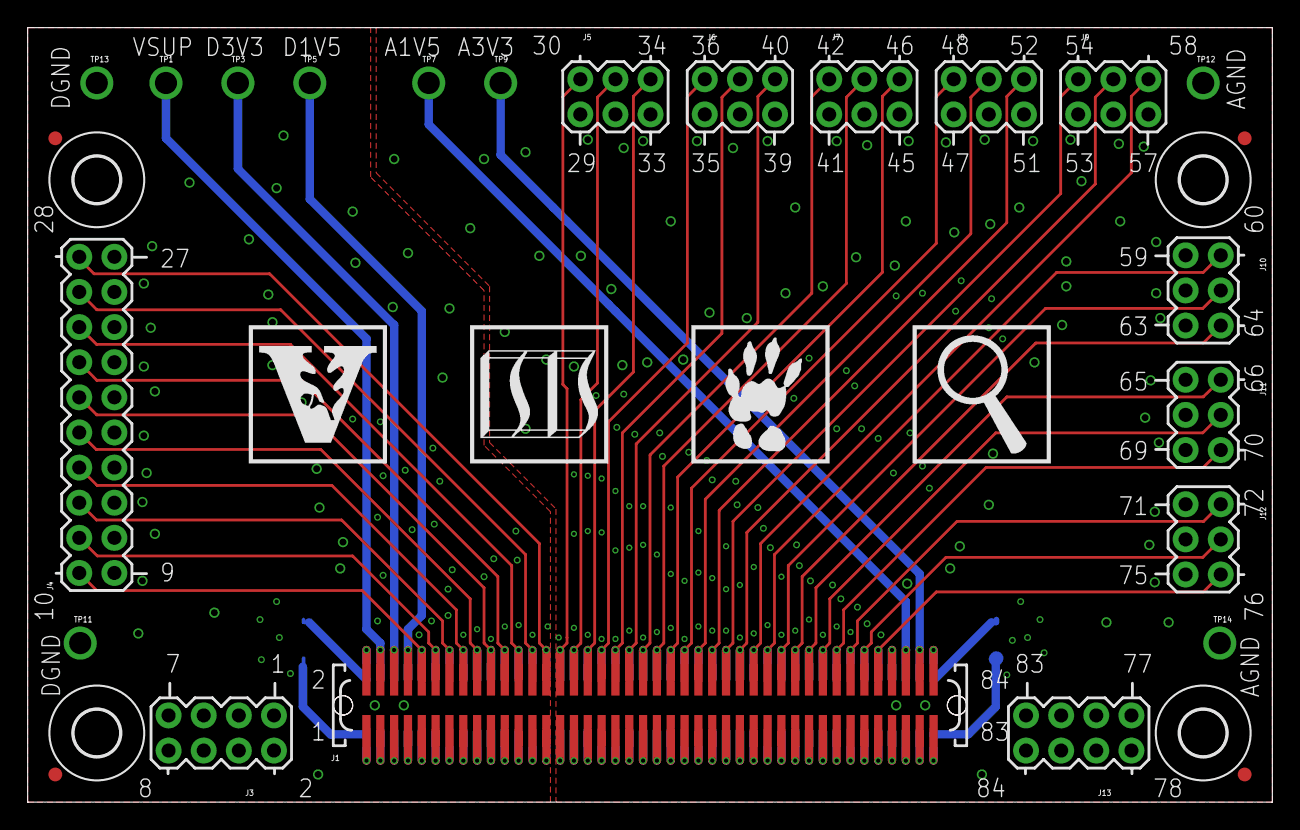
[picture p163: board BreakoutBoard.brd from above]

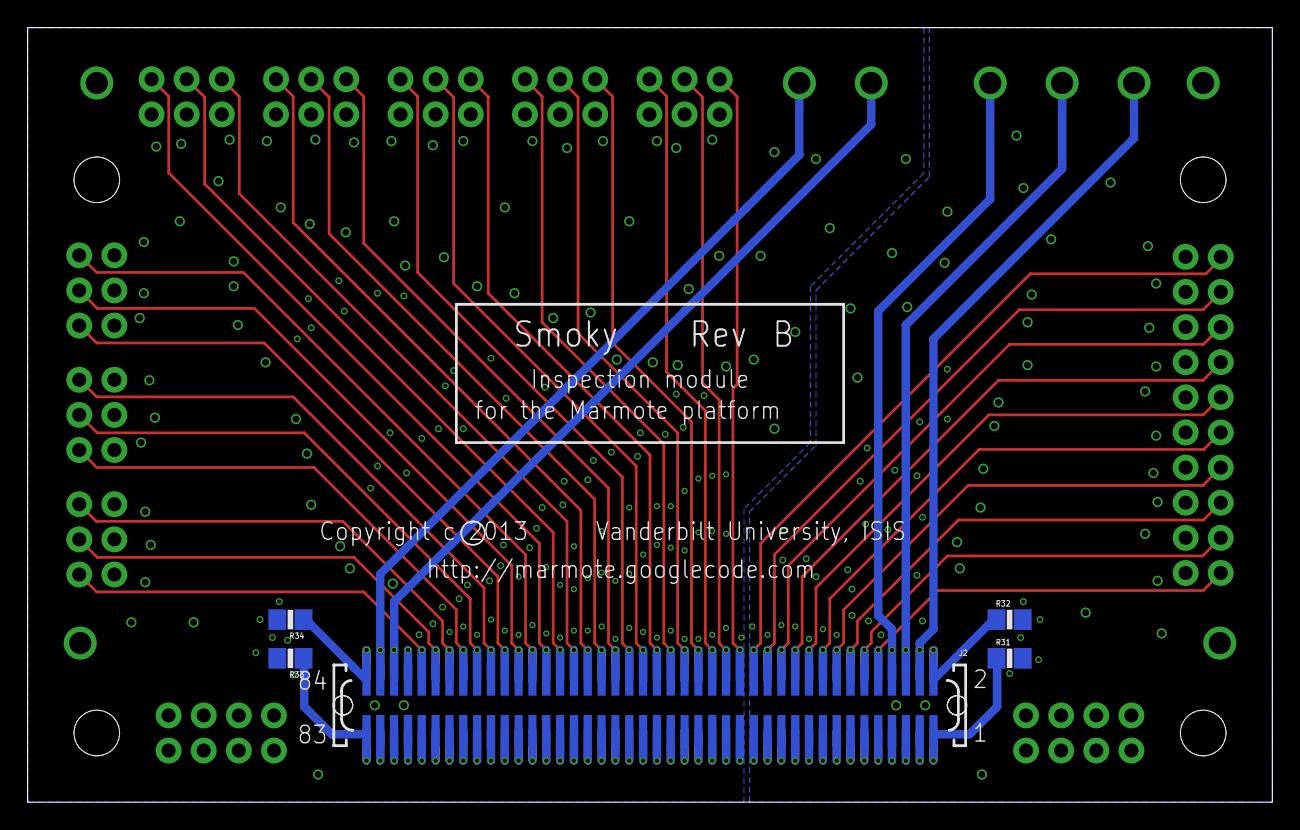
[picture p164: board BreakoutBoard.brd from below]

Board: 4 copper layers, 90.0 x 56.0 mm, 38 parts (5 on the bottom side), 86 nets.
