marmote/marmote/hardware/M6-RF315/M6-RF315.brd

## EAGLE design hardware/M6-RF315/M6-RF315.brd (2012-01-31)

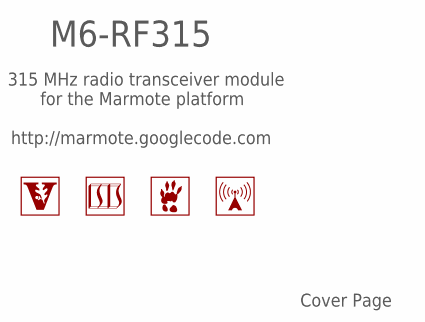
[picture p165: schematic M6-RF315.sch, sheet 1]

Parts:
LOGO1: LOGO-ISIS-600MIL-10MM-CU; LOGO-ISIS-10MM-COPPER
LOGO2: LOGO-MARMOTE-600MIL-10MM-CU; LOGO-MARMOTE-10MM-COPPER
LOGO3: LOGO-VANDERBILT-600MIL-10MM-CU; LOGO-VANDERBILT-10MM-COPPER
LOGO4: LOGO-RADIO-3-600MIL-10MM-CU; LOGO-RADIO-FILLED-10MM-COPPER

Notes on the sheet:
315 MHz radio transceiver module
http://marmote.googlecode.com
for the Marmote platform

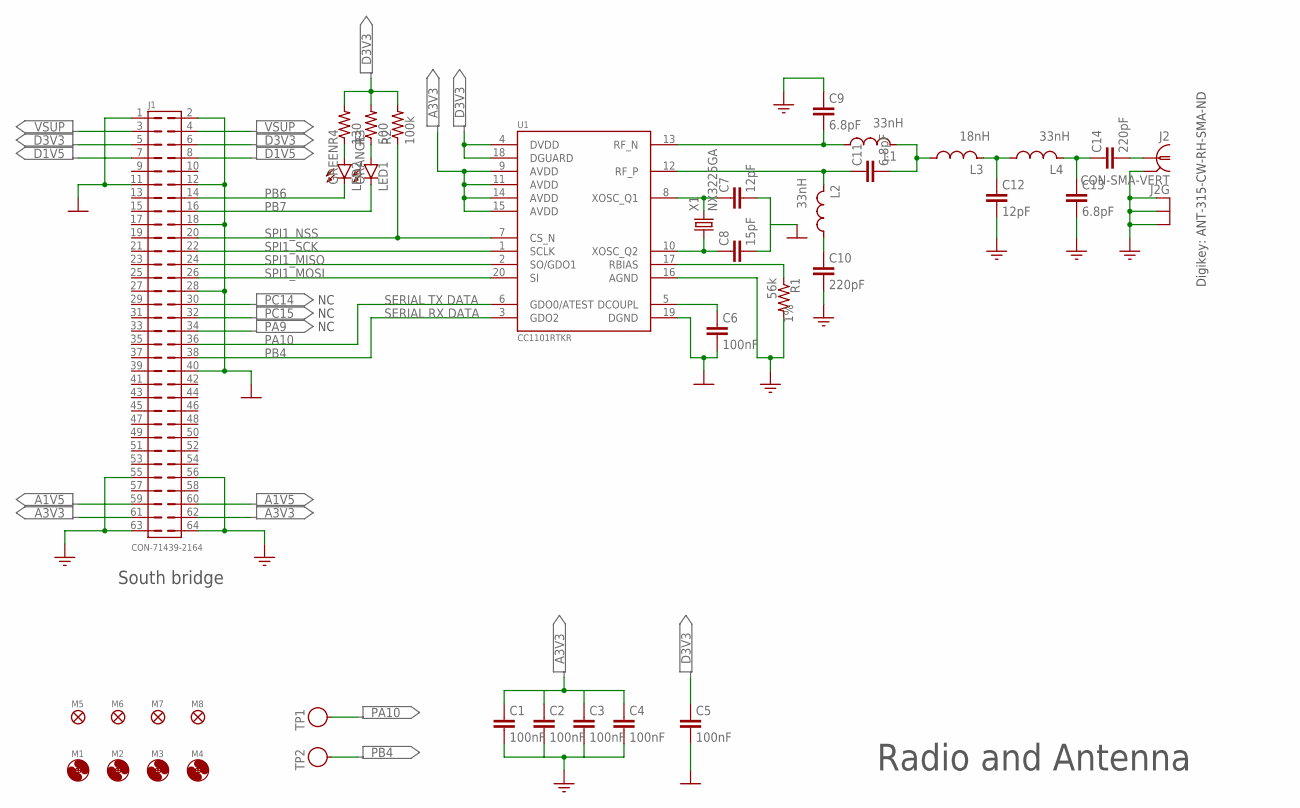
[picture p166: schematic M6-RF315.sch, sheet 2]

Parts:
C1, C2, C3, C4, C5, C6: 100nF; C0603
C7, C12: 12pF; C0603
C8: 15pF; C0603
C9, C11, C13: 6.8pF; C0603
C10, C14: 220pF; C0603
J1: CON-71439-2164; 71439-XX64-BOT
J2: CON-SMA-VERT; SMA-VERT; MPN 5-1814832-1
L1, L2, L4: 33nH; L0402
L3: 18nH; L0402
LED1: LED0603; MPN APT1608SECK; DIGI-KEY# 754-1120-1-ND
LED2: LED0603; MPN APT1608MGC; DIGI-KEY# 754-1118-1-ND
M1, M2, M3, M4: MOUNT-HOLE3.3; 3,3
M5, M6, M7, M8: FIDUCIAL1X2; FIDUCIAL-1X2
R1: 56k; R0603; TOLERANCE 1%
R2: 100k; R0603
R3: 500; R0603
R4: 130; R0603
TP1, TP2: TESTPOINT-RED; TESTPOINT
U1: CC1101RTKR; QFN-20
X1: NX3225GA

Connections:
A1V5: J1.59, J1.60
A3V3: C1.1, C2.1, C3.1, C4.1, J1.61, J1.62, U1.9 (AVDD), U1.11 (AVDD), U1.14 (AVDD), U1.15 (AVDD)
AGND: C1.2, C2.2, C3.2, C4.2, C9.1, C10.2, C12.2, C13.2, J1.55, J1.56, J1.63, J1.64, J2.2 (GND), J2.3 (GND), J2.4 (GND), J2.5 (GND), R1.2, U1.16 (AGND), U1.EXP (AGND)
D1V5: J1.7, J1.8
D3V3: C5.1, J1.5, J1.6, R2.2, R3.2, R4.2, U1.4 (DVDD), U1.18 (DGUARD)
DGND: C5.2, C6.2, C7.2, C8.2, J1.1, J1.2, J1.11, J1.12, J1.18, J1.28, J1.40, U1.19 (DGND), X1.2 (DGND), X1.4 (DGND)
unnamed: LED1.A, R3.1
unnamed: C12.1, L3.2, L4.1
unnamed: C6.1, U1.5 (DCOUPL)
unnamed: C8.1, U1.10 (XOSC_Q2), X1.1
unnamed: C7.1, U1.8 (XOSC_Q1), X1.3 (2)
unnamed: C11.1, L2.2, U1.12 (RF_P)
unnamed: C9.2, L1.1, U1.13 (RF_N)
unnamed: C11.2, L1.2, L3.1
unnamed: C13.1, C14.1, L4.2
unnamed: C14.2, J2.1
unnamed: C10.1, L2.1
unnamed: LED2.A, R4.1
PA9: J1.34
PA10: J1.36, TP1.1, U1.6 (GDO0/ATEST)
PB4: J1.38, TP2.1, U1.3 (GDO2)
PB6: J1.14, LED2.C
PB7: J1.16, LED1.C
PC14: J1.30
PC15: J1.32
RBIAS: R1.1, U1.17 (RBIAS)
SPI1_MISO: J1.24, U1.2 (SO/GDO1)
SPI1_MOSI: J1.26, U1.20 (SI)
SPI1_NSS: J1.20, R2.1, U1.7 (CS_N)
SPI1_SCK: J1.22, U1.1 (SCLK)
VSUP: J1.3, J1.4

Notes on the sheet:
South bridge
SERIAL TX DATA
SERIAL RX DATA
Digikey: ANT-315-CW-RH-SMA-ND

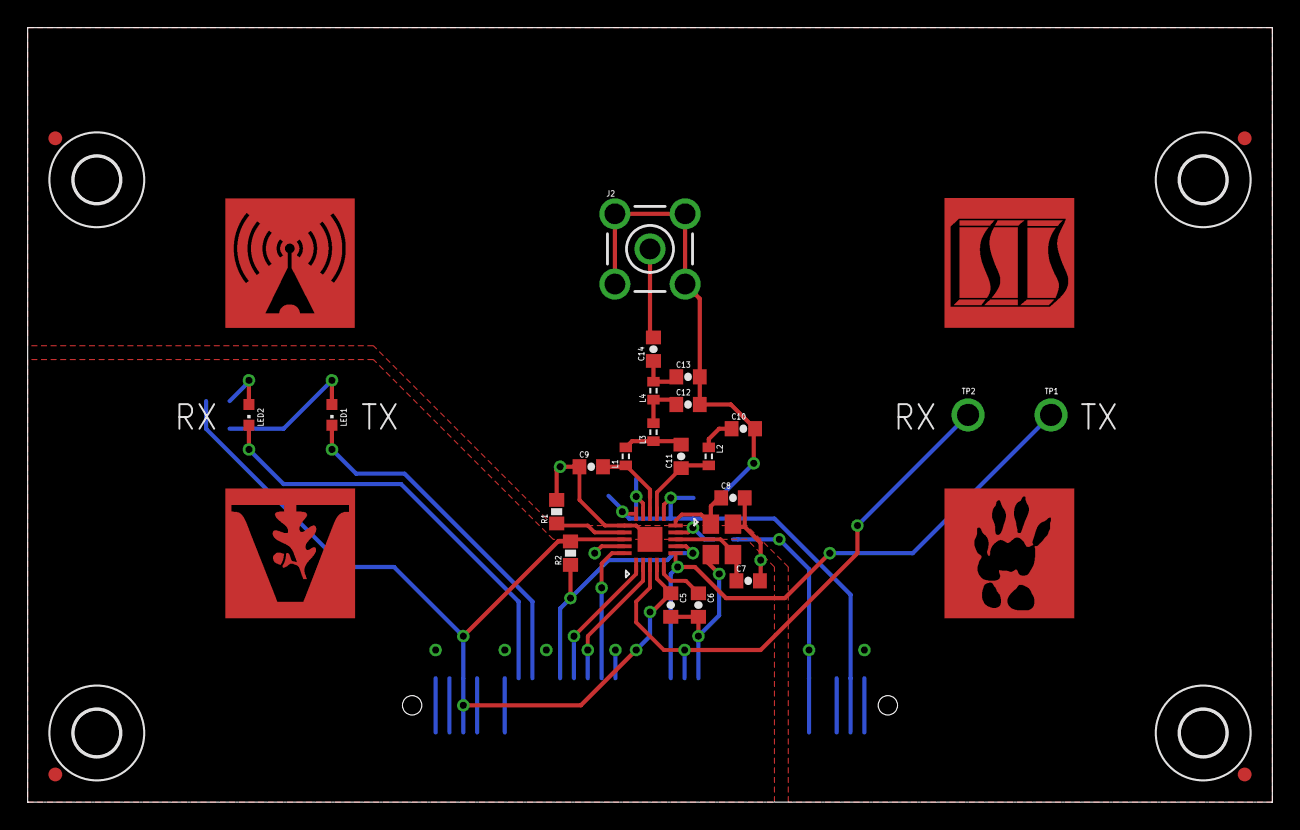
[picture p167: board M6-RF315.brd from above]

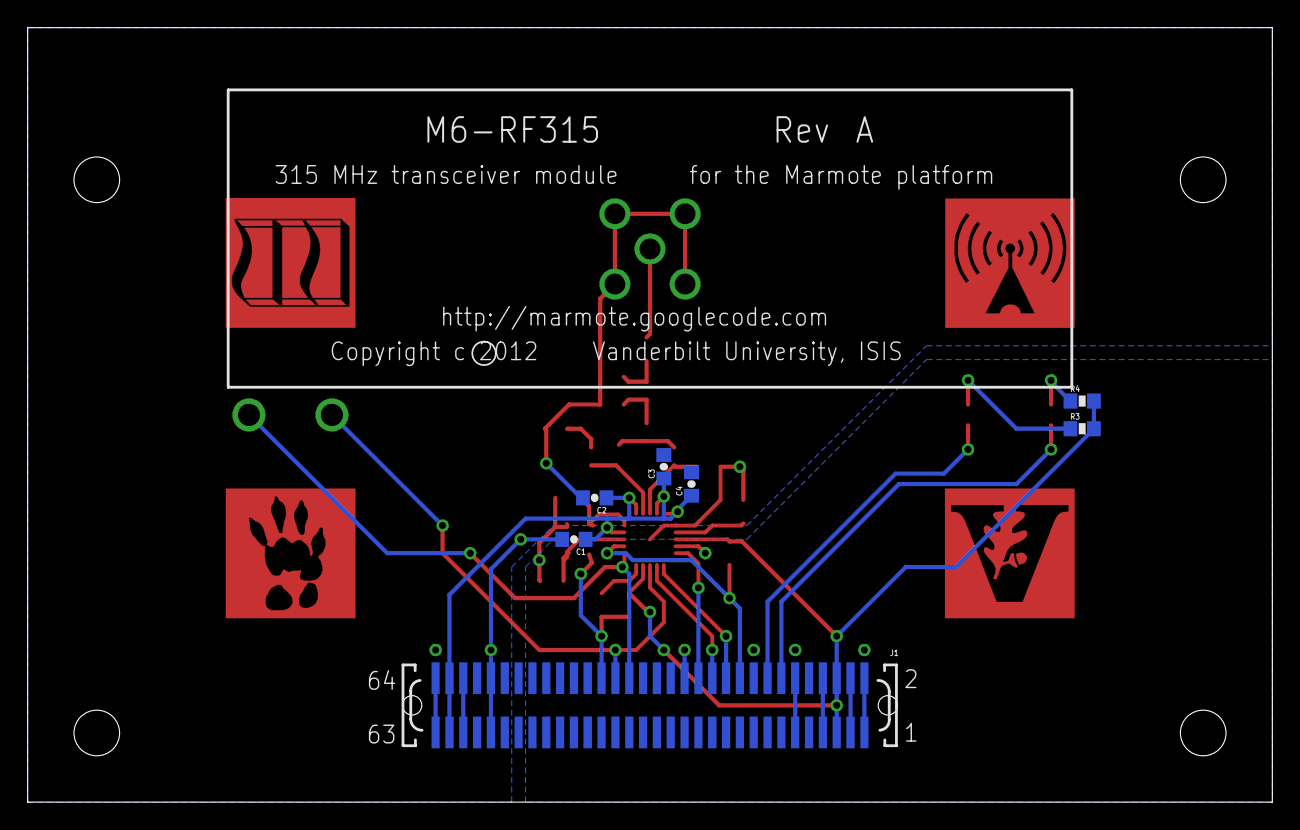
[picture p168: board M6-RF315.brd from below]

Board: 2 copper layers, 90.0 x 56.0 mm, 42 parts (7 on the bottom side), 28 nets.
