marmote/marmote/hardware/CPSBoard/CPSBoard.brd

## EAGLE design hardware/CPSBoard/CPSBoard.brd (2012-01-27)

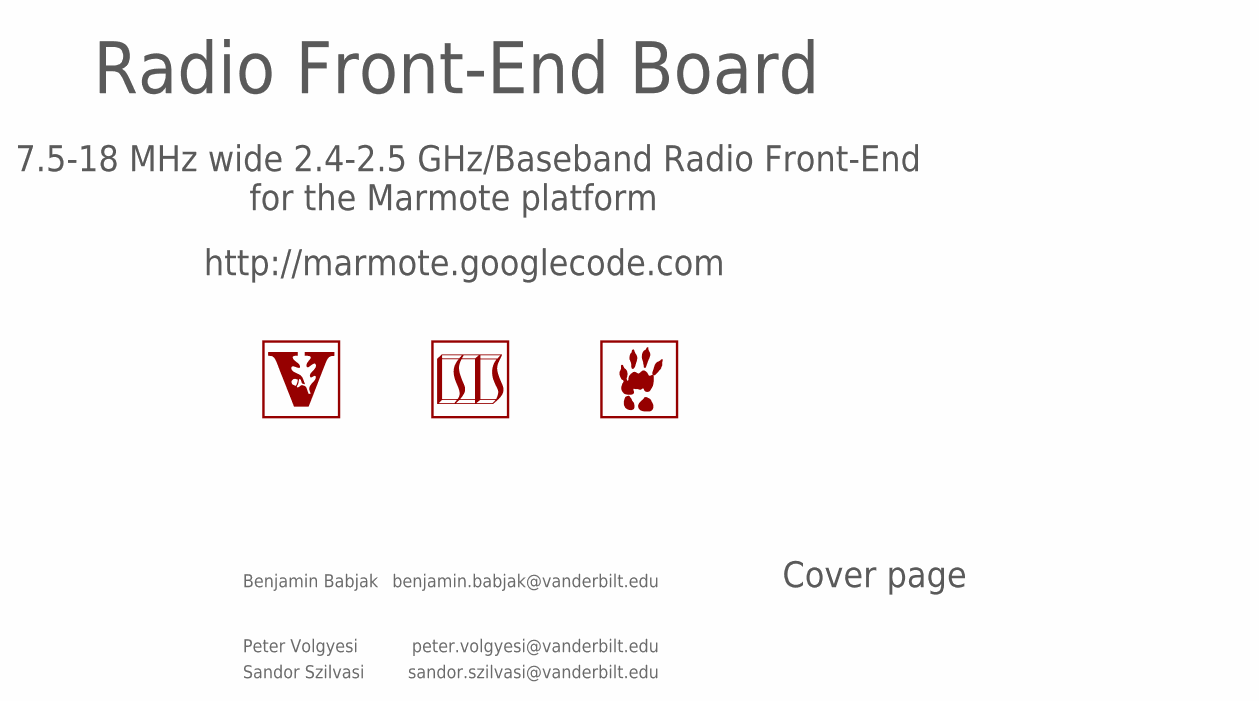
[picture p169: schematic CPSBoard.sch, sheet 1]

Parts:
LOGO1: LOGO-ISIS-600MIL-10MM-AU; LOGO-ISIS-10MM-GOLD
LOGO2: LOGO-MARMOTE-600MIL-10MM-AU; LOGO-MARMOTE-10MM-GOLD
LOGO3: LOGO-VANDERBILT-600MIL-10MM-AU; LOGO-VANDERBILT-10MM-GOLD

Notes on the sheet:
7.5-18 MHz wide 2.4-2.5 GHz/Baseband Radio Front-End
http://marmote.googlecode.com
for the Marmote platform

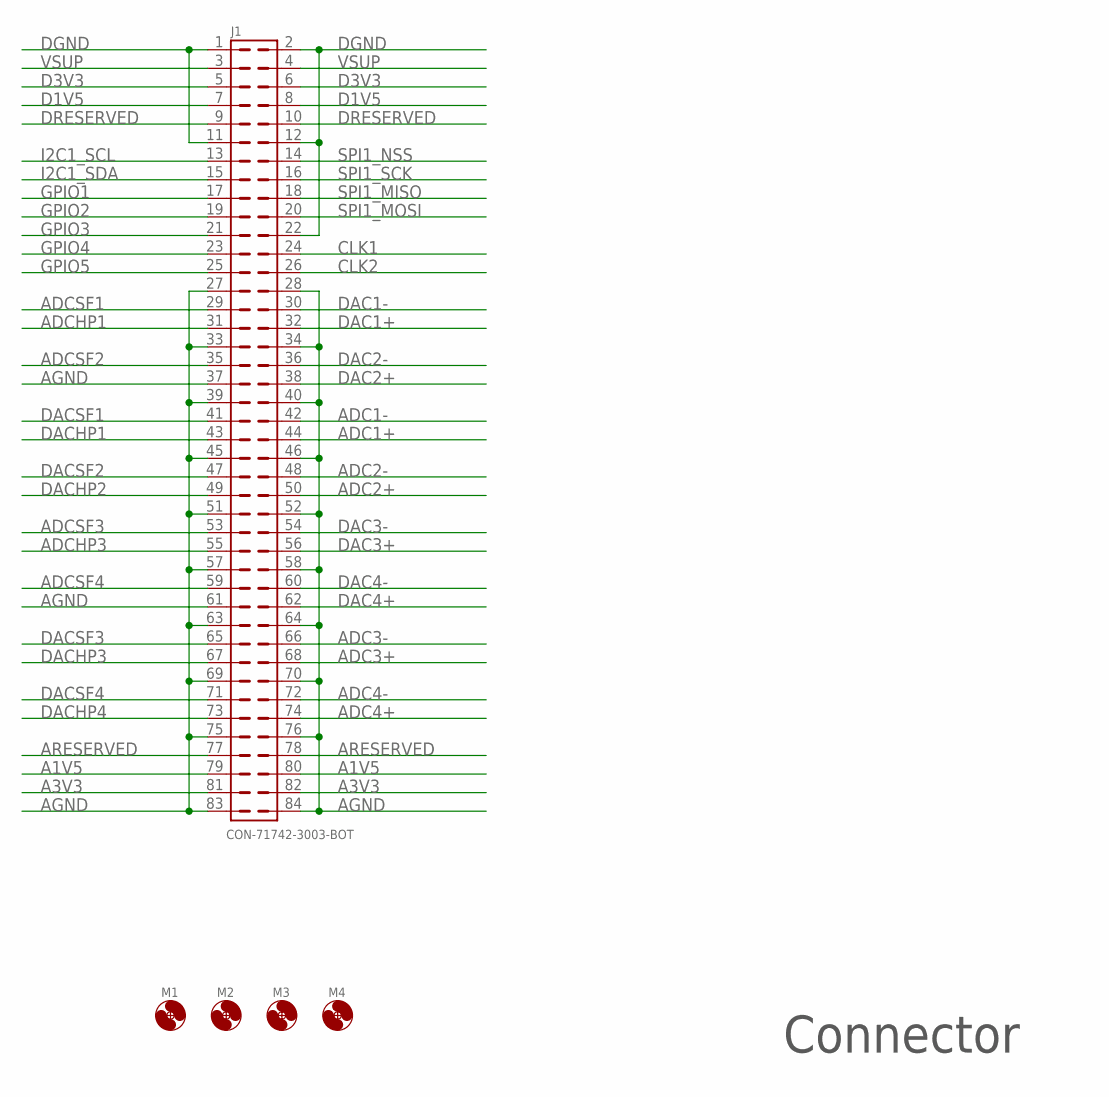
[picture p170: schematic CPSBoard.sch, sheet 2]

Parts:
J1: CON-71742-3003-BOT; 71742-3003-BOT
M1, M2, M3, M4: MOUNT-HOLE3.3; 3,3

Connections:
A1V5: J1.79, J1.80
A3V3: J1.81, J1.82; also elsewhere on the board
ADC1+: J1.44
ADC1-: J1.42
ADC2+: J1.50
ADC2-: J1.48
ADC3+: J1.68
ADC3-: J1.66
ADC4+: J1.74
ADC4-: J1.72
ADCHP1: J1.31
ADCHP3: J1.55
ADCSF1: J1.29
ADCSF2: J1.35
ADCSF3: J1.53
ADCSF4: J1.59
AGND: J1.27, J1.28, J1.33, J1.34, J1.37, J1.39, J1.40, J1.45, J1.46, J1.51, J1.52, J1.57, J1.58, J1.61, J1.63, J1.64, J1.69, J1.70, J1.75, J1.76, J1.83, J1.84; also elsewhere on the board
ARESERVED: J1.77, J1.78
CLK1: J1.24
CLK2: J1.26
D1V5: J1.7, J1.8
D3V3: J1.5, J1.6; also elsewhere on the board
DAC1+: J1.32
DAC1-: J1.30
DAC2+: J1.38
DAC2-: J1.36
DAC3+: J1.56
DAC3-: J1.54
DAC4+: J1.62
DAC4-: J1.60
DACHP1: J1.43
DACHP2: J1.49
DACHP3: J1.67
DACHP4: J1.73
DACSF1: J1.41
DACSF2: J1.47
DACSF3: J1.65
DACSF4: J1.71
DGND: J1.1, J1.2, J1.11, J1.12, J1.22; also elsewhere on the board
DRESERVED: J1.9, J1.10
GPIO1: J1.17; also elsewhere on the board
GPIO2: J1.19; also elsewhere on the board
GPIO3: J1.21; also elsewhere on the board
GPIO4: J1.23; also elsewhere on the board
GPIO5: J1.25; also elsewhere on the board
I2C1_SCL: J1.13; also elsewhere on the board
I2C1_SDA: J1.15; also elsewhere on the board
SPI1_MISO: J1.18; also elsewhere on the board
SPI1_MOSI: J1.20; also elsewhere on the board
SPI1_NSS: J1.14; also elsewhere on the board
SPI1_SCK: J1.16; also elsewhere on the board
VSUP: J1.3, J1.4

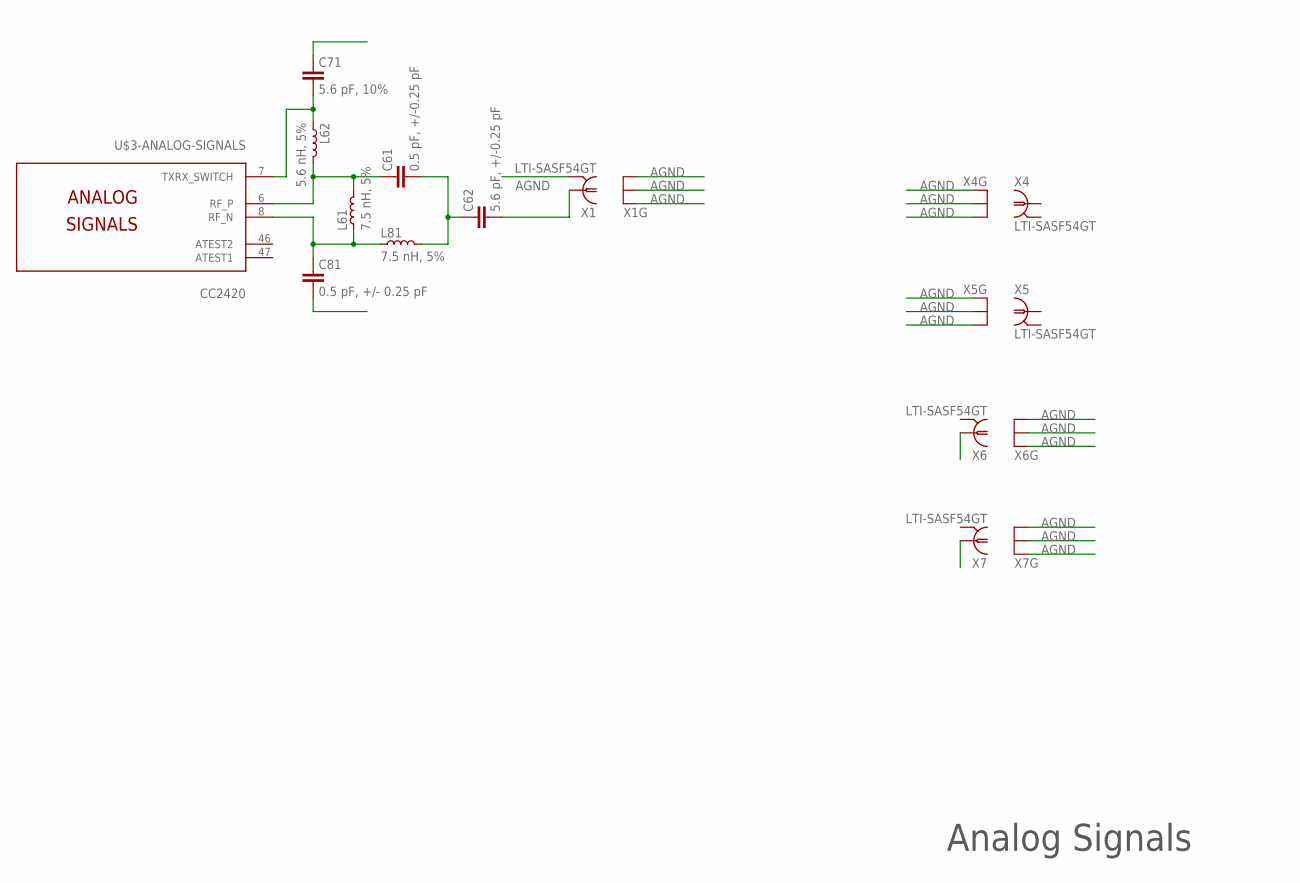
[picture p171: schematic CPSBoard.sch, sheet 3]

Parts:
C61: 0.5 pF, +/-0.25 pF; C0402
C62: 5.6 pF, +/-0.25 pF; C0402
C71: 5.6 pF, 10%; C0402
C81: 0.5 pF, +/- 0.25 pF; C0402
L61, L81: 7.5 nH, 5%; C0402
L62: 5.6 nH, 5%; C0402
U$3: CC2420; VQFN-48
X1, X4, X5, X6, X7: LTI-SASF54GT

Connections:
AGND: X1.2 (GND), X1.3 (GND), X1.4 (GND), X1.5 (GND), X4.3 (GND), X4.4 (GND), X4.5 (GND), X5.3 (GND), X5.4 (GND), X5.5 (GND), X6.3 (GND), X6.4 (GND), X6.5 (GND), X7.3 (GND), X7.4 (GND), X7.5 (GND); also elsewhere on the board
GND: X4.2 (GND), X5.2 (GND), X6.2 (GND), X7.2 (GND)
unnamed: C71.2, L62.1, U$3.7 (TXRX_SWITCH)
unnamed: C61.1, L61.2, L62.2, U$3.6 (RF_P)
unnamed: C62.2, X1.1
unnamed: C81.1, L61.1, L81.1, U$3.8 (RF_N)
unnamed: C61.2, C62.1, L81.2

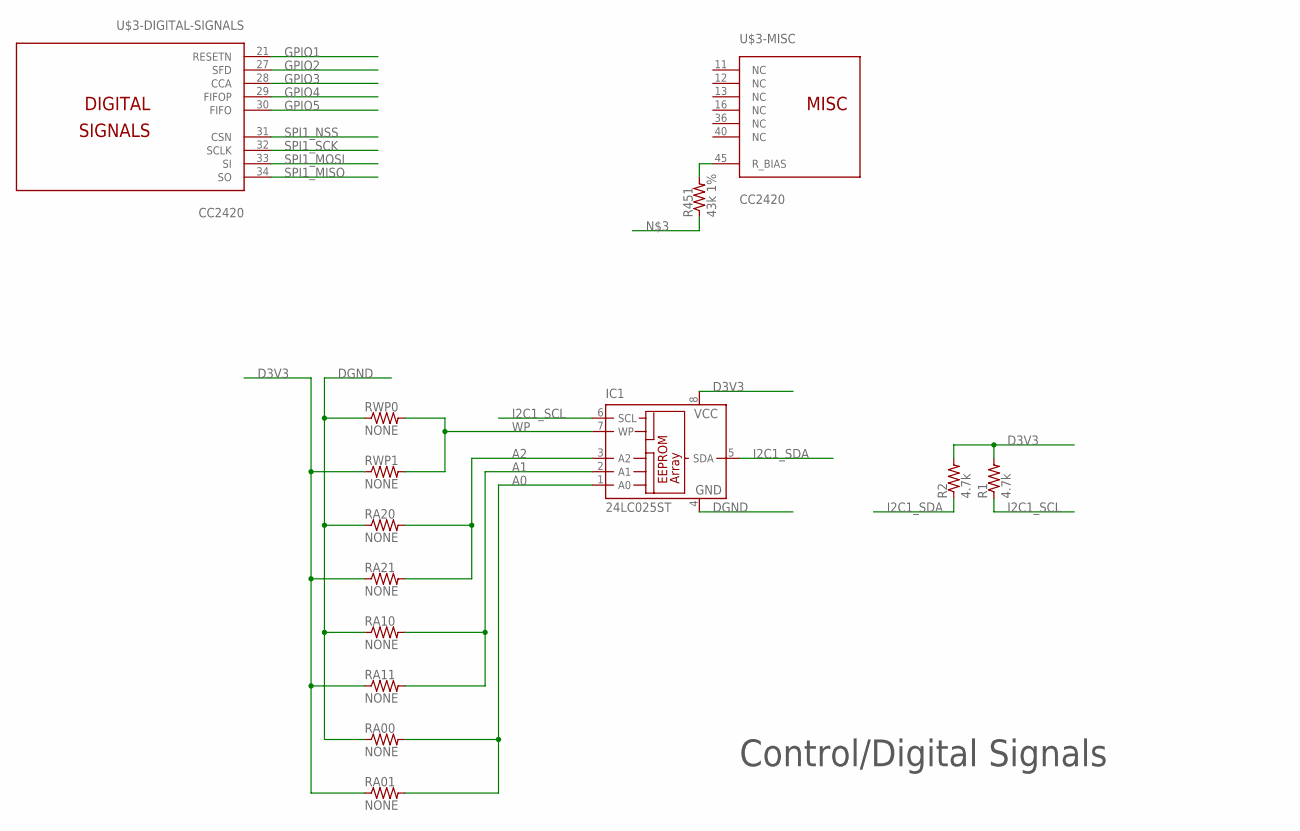
[picture p172: schematic CPSBoard.sch, sheet 4]

Parts:
IC1: 24LC025ST; TSSOP8
R1, R2: 4.7k; R0402
R451: 43k 1%; R0402
RA00, RA01, RA10, RA11, RA20, RA21: NONE; R0402
RWP0, RWP1: NONE; R0402
U$3: CC2420; VQFN-48

Connections:
A0: IC1.1 (A0), RA00.2, RA01.2
A1: IC1.2 (A1), RA10.2, RA11.2
A2: IC1.3 (A2), RA20.2, RA21.2
D3V3: IC1.8 (VCC), R1.2, R2.2, RA01.1, RA11.1, RA21.1, RWP1.1; also elsewhere on the board
DGND: IC1.4 (GND), RA00.1, RA10.1, RA20.1, RWP0.1; also elsewhere on the board
GPIO1: U$3.21 (RESETN); also elsewhere on the board
GPIO2: U$3.27 (SFD); also elsewhere on the board
GPIO3: U$3.28 (CCA); also elsewhere on the board
GPIO4: U$3.29 (FIFOP); also elsewhere on the board
GPIO5: U$3.30 (FIFO); also elsewhere on the board
I2C1_SCL: IC1.6 (SCL), R1.1; also elsewhere on the board
I2C1_SDA: IC1.5 (SDA), R2.1; also elsewhere on the board
unnamed: R451.2, U$3.45 (R_BIAS)
SPI1_MISO: U$3.34 (SO); also elsewhere on the board
SPI1_MOSI: U$3.33 (SI); also elsewhere on the board
SPI1_NSS: U$3.31 (CSN); also elsewhere on the board
SPI1_SCK: U$3.32 (SCLK); also elsewhere on the board
WP: IC1.7 (WP), RWP0.2, RWP1.2

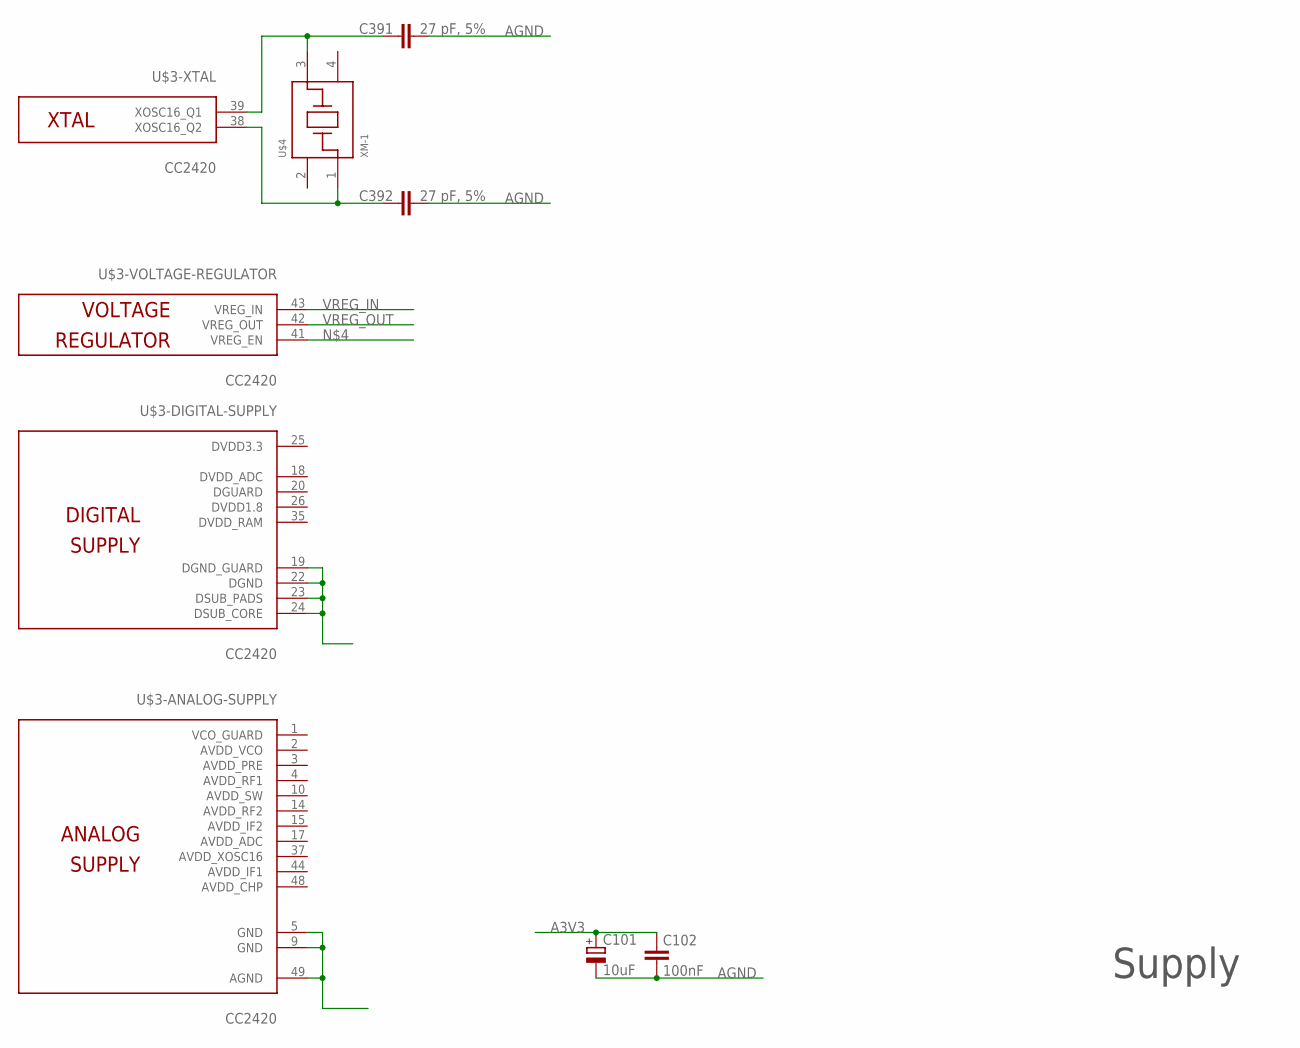
[picture p173: schematic CPSBoard.sch, sheet 5]

Parts:
C101: 10uF; CPOL2012
C102: 100nF; C0402
C391, C392: 27 pF, 5%; C0402
U$3: CC2420; VQFN-48
U$4: XM-1; XM-1-FOOTPRINT

Connections:
A3V3: C101.+, C102.1; also elsewhere on the board
AGND: C101.-, C102.2, C391.2, C392.2, U$3.5 (GND), U$3.9 (GND), U$3.49 (AGND); also elsewhere on the board
DSUB_CORE: U$3.19 (DGND_GUARD), U$3.22 (DGND), U$3.23 (DSUB_PADS), U$3.24 (DSUB_CORE)
unnamed: C391.1, U$3.39 (XOSC16_Q1), U$4.3
unnamed: C392.1, U$3.38 (XOSC16_Q2), U$4.1
VREG_IN: U$3.43 (VREG_IN)
VREG_OUT: U$3.42 (VREG_OUT)

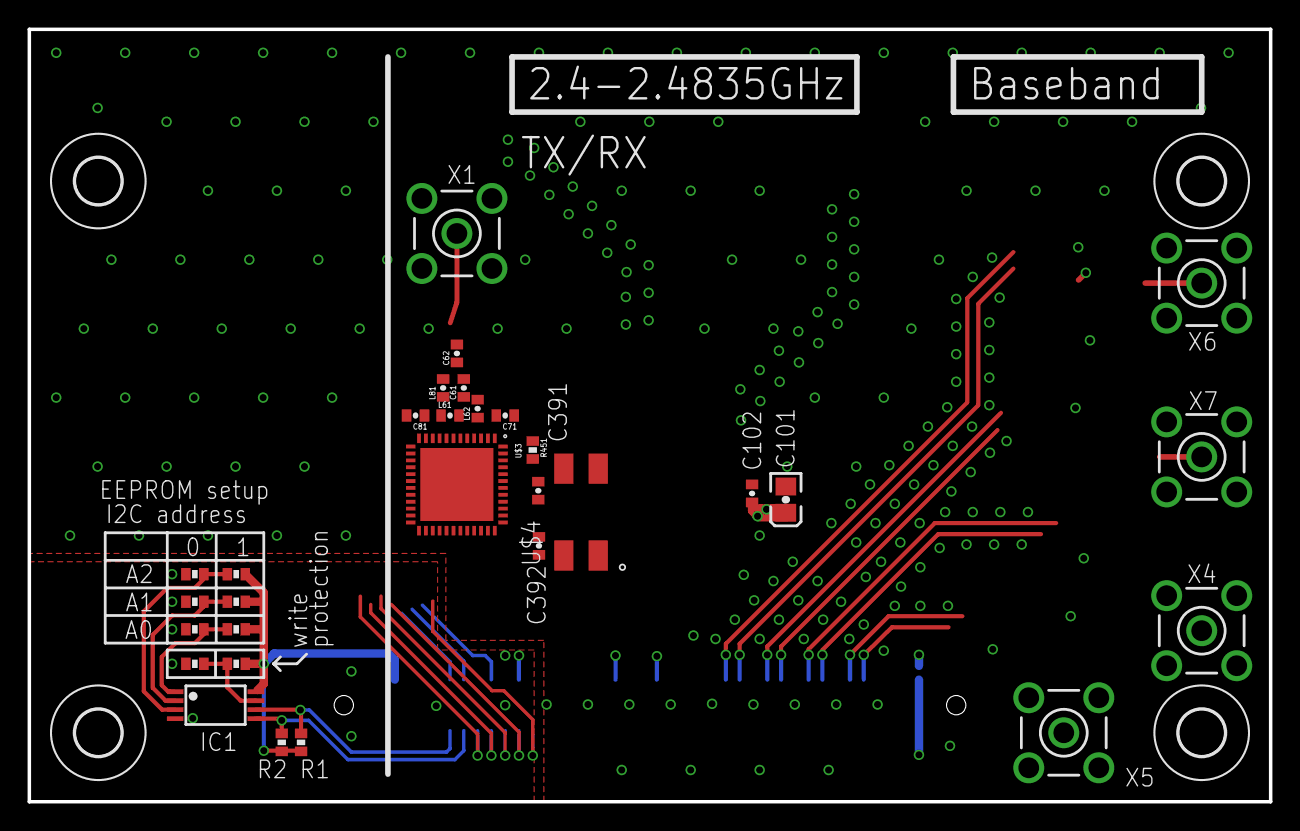
[picture p174: board CPSBoard.brd from above]

Board: 4 copper layers, 90.0 x 56.0 mm, 38 parts (1 on the bottom side), 34 nets.
