marmote/marmote/hardware/BreakoutBoard_RevA/BreakoutBoard_RevA.brd

## EAGLE design hardware/BreakoutBoard_RevA/BreakoutBoard_RevA.brd (2011-12-12, an earlier design)

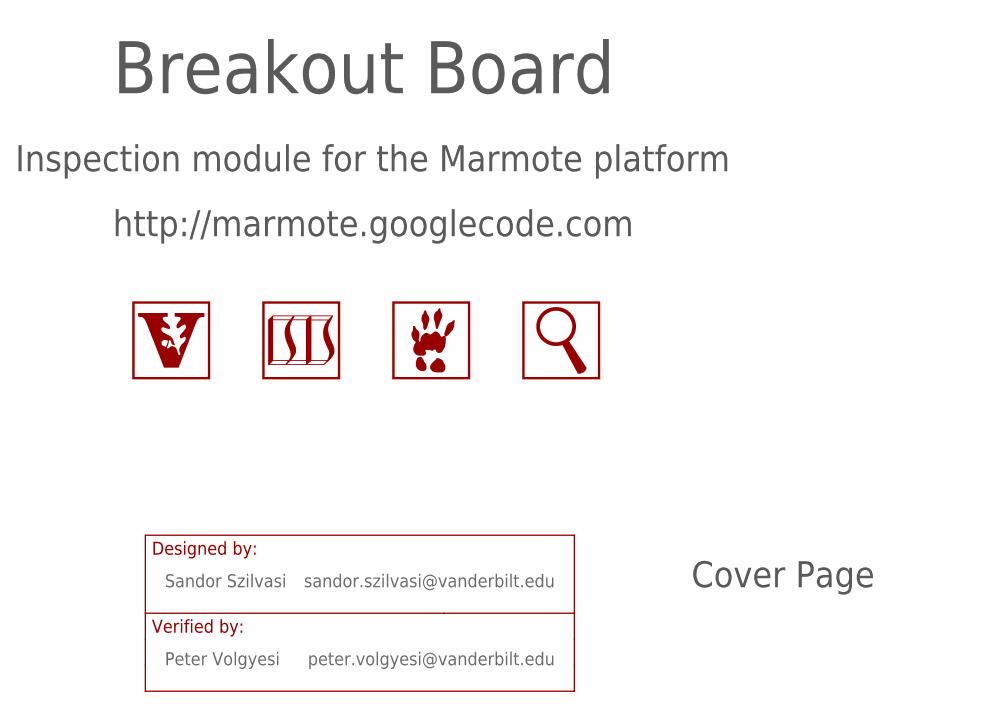
[picture p175: schematic BreakoutBoard_RevA.sch, sheet 1]

Parts:
LOGO1: LOGO-ISIS-600MIL-10MM-AU; LOGO-ISIS-10MM-GOLD
LOGO2: LOGO-VANDERBILT-600MIL-10MM-AU; LOGO-VANDERBILT-10MM-GOLD
LOGO3: LOGO-MARMOTE-600MIL-10MM-AU; LOGO-MARMOTE-10MM-GOLD
LOGO4: LOGO-MAGNIFYING-GLASS-600MIL-10MM-AU; LOGO-MAGNIFYING-GLASS-10MM-GOLD

Notes on the sheet:
Inspection module for the Marmote platform
http://marmote.googlecode.com

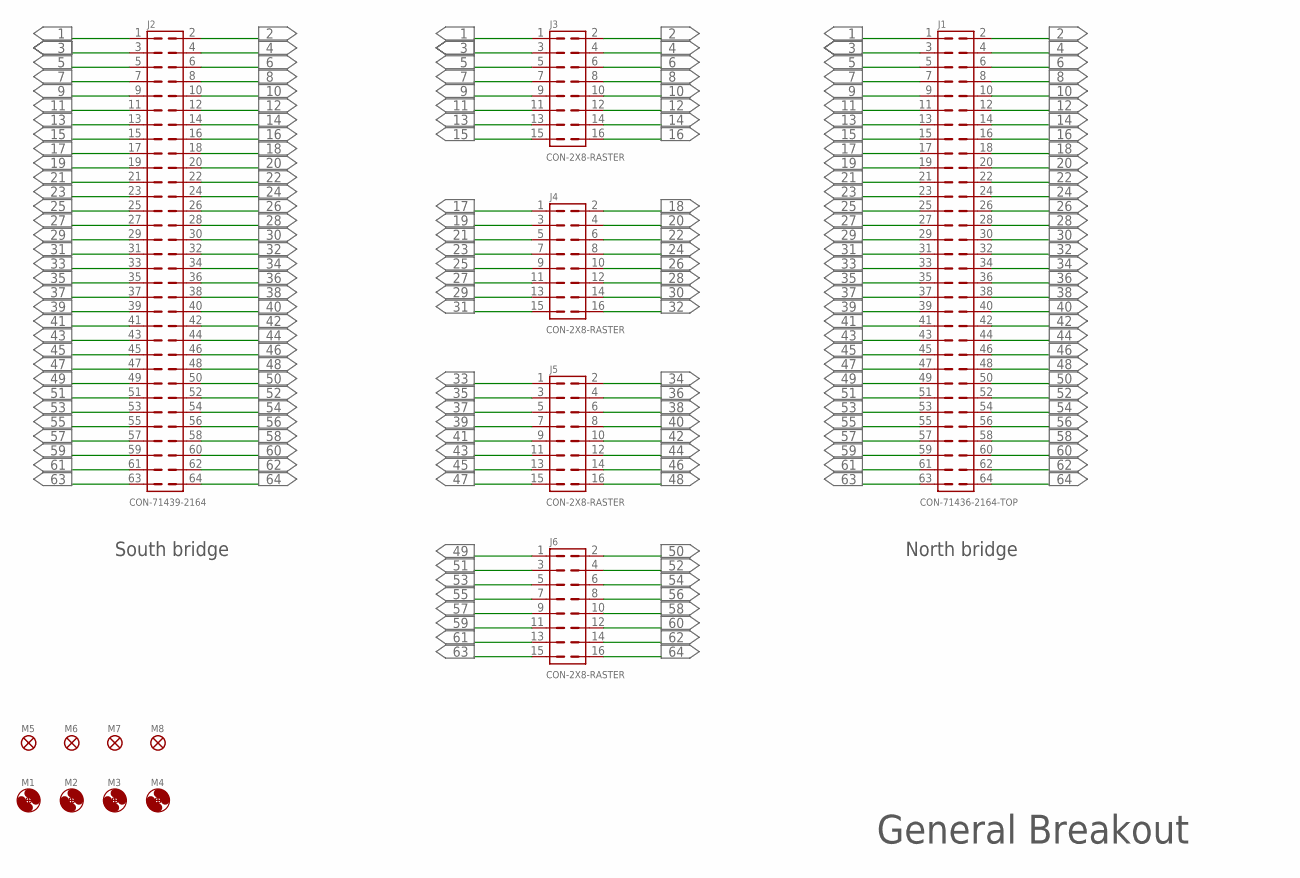
[picture p176: schematic BreakoutBoard_RevA.sch, sheet 2]

Parts:
J1: CON-71436-2164-TOP; 71436-XX64
J2: CON-71439-2164; 71439-XX64-BOT
J3, J4, J5, J6: CON-2X8-RASTER; 2X16
M1, M2, M3, M4: MOUNT-HOLE3.3; 3,3
M5, M6, M7, M8: FIDUCIAL1X2; FIDUCIAL-1X2

Connections:
1: J1.1, J2.1, J3.1; also elsewhere on the board
2: J1.2, J2.2, J3.2; also elsewhere on the board
3: J1.3, J2.3, J3.3
4: J1.4, J2.4, J3.4; also elsewhere on the board
5: J1.5, J2.5, J3.5
6: J1.6, J2.6, J3.6; also elsewhere on the board
7: J1.7, J2.7, J3.7
8: J1.8, J2.8, J3.8; also elsewhere on the board
9: J1.9, J2.9, J3.9
10: J1.10, J2.10, J3.10
11: J1.11, J2.11, J3.11
12: J1.12, J2.12, J3.12
13: J1.13, J2.13, J3.13
14: J1.14, J2.14, J3.14
15: J1.15, J2.15, J3.15
16: J1.16, J2.16, J3.16
17: J1.17, J2.17, J4.1
18: J1.18, J2.18, J4.2
19: J1.19, J2.19, J4.3
20: J1.20, J2.20, J4.4
21: J1.21, J2.21, J4.5
22: J1.22, J2.22, J4.6
23: J1.23, J2.23, J4.7
24: J1.24, J2.24, J4.8
25: J1.25, J2.25, J4.9
26: J1.26, J2.26, J4.10
27: J1.27, J2.27, J4.11
28: J1.28, J2.28, J4.12
29: J1.29, J2.29, J4.13
30: J1.30, J2.30, J4.14; also elsewhere on the board
31: J1.31, J2.31, J4.15
32: J1.32, J2.32, J4.16; also elsewhere on the board
33: J1.33, J2.33, J5.1
34: J1.34, J2.34, J5.2; also elsewhere on the board
35: J1.35, J2.35, J5.3
36: J1.36, J2.36, J5.4; also elsewhere on the board
37: J1.37, J2.37, J5.5
38: J1.38, J2.38, J5.6; also elsewhere on the board
39: J1.39, J2.39, J5.7
40: J1.40, J2.40, J5.8
41: J1.41, J2.41, J5.9
42: J1.42, J2.42, J5.10
43: J1.43, J2.43, J5.11
44: J1.44, J2.44, J5.12
45: J1.45, J2.45, J5.13
46: J1.46, J2.46, J5.14
47: J1.47, J2.47, J5.15
48: J1.48, J2.48, J5.16
49: J1.49, J2.49, J6.1
50: J1.50, J2.50, J6.2
51: J1.51, J2.51, J6.3
52: J1.52, J2.52, J6.4
53: J1.53, J2.53, J6.5
54: J1.54, J2.54, J6.6
55: J1.55, J2.55, J6.7
56: J1.56, J2.56, J6.8
57: J1.57, J2.57, J6.9
58: J1.58, J2.58, J6.10
59: J1.59, J2.59, J6.11
60: J1.60, J2.60, J6.12; also elsewhere on the board
61: J1.61, J2.61, J6.13
62: J1.62, J2.62, J6.14; also elsewhere on the board
63: J1.63, J2.63, J6.15; also elsewhere on the board
64: J1.64, J2.64, J6.16; also elsewhere on the board

Notes on the sheet:
South bridge
North bridge

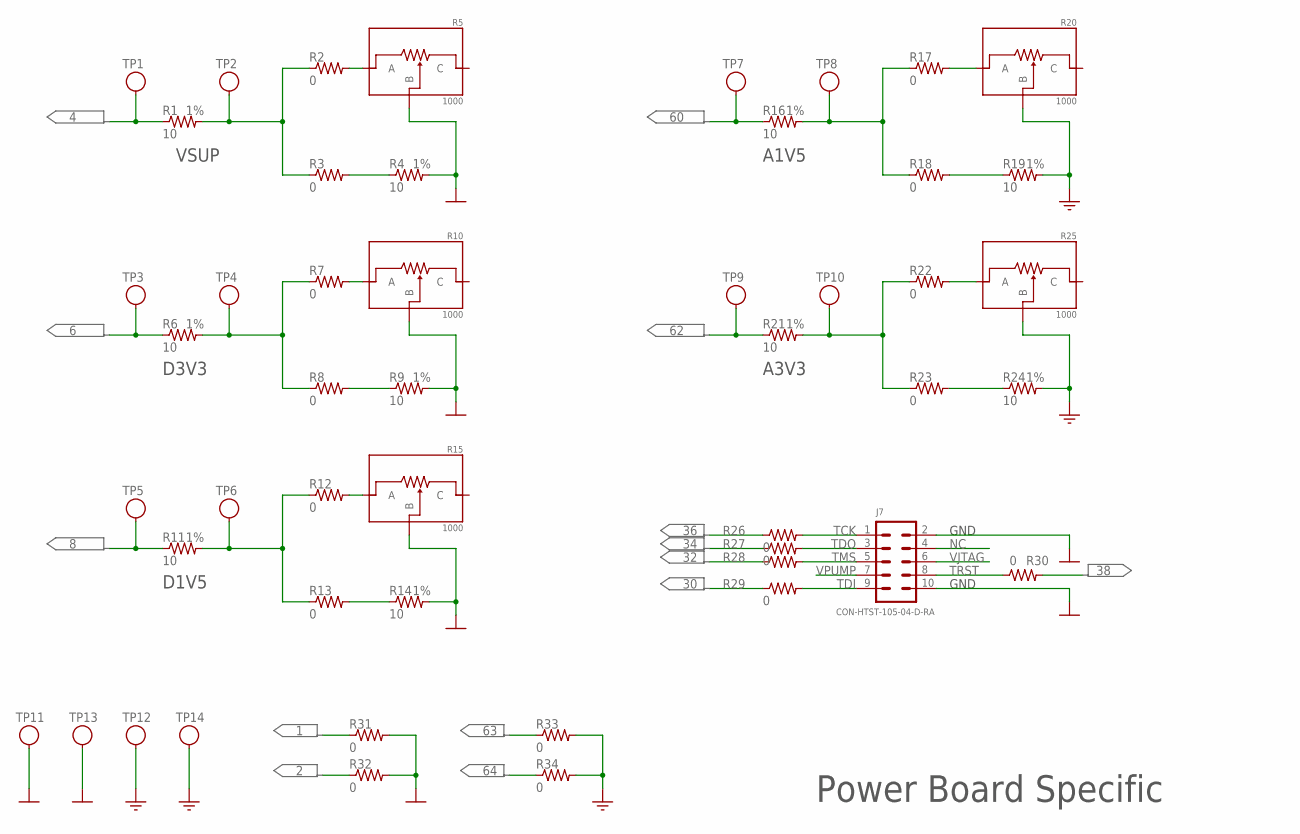
[picture p177: schematic BreakoutBoard_RevA.sch, sheet 3]

Parts:
J7: CON-HTST-105-04-D-RA; HTST-105-04-D-RA
R1, R4, R6, R9, R11, R14, R16, R19, R21, R24: 10; R0805; TOLERANCE 1%
R2, R3, R7, R8, R12, R13, R17, R18, R22, R23, R26, R27, R28, R29, R30, R31, R32, R33, R34: 0; R0805
R5, R10, R15, R20, R25: 1000; TRIMMER-3MM
TP1, TP2, TP3, TP4, TP5, TP6: TESTPOINT-BLUE; TESTPOINT
TP7, TP8, TP9, TP10: TESTPOINT-GREEN; TESTPOINT
TP11, TP12, TP13, TP14: TESTPOINT-YELLOW; TESTPOINT

Connections:
1: R31.1; also elsewhere on the board
2: R32.1; also elsewhere on the board
4: R1.1, TP1.1; also elsewhere on the board
6: R6.1, TP3.1; also elsewhere on the board
8: R11.1, TP5.1; also elsewhere on the board
30: R29.1; also elsewhere on the board
32: R28.1; also elsewhere on the board
34: R27.1; also elsewhere on the board
36: R26.1; also elsewhere on the board
38: R30.2; also elsewhere on the board
60: R16.1, TP7.1; also elsewhere on the board
62: R21.1, TP9.1; also elsewhere on the board
63: R33.1; also elsewhere on the board
64: R34.1; also elsewhere on the board
A1V5-: R16.2, R17.1, R18.1, TP8.1
A3V3-: R21.2, R22.1, R23.1, TP10.1
AGND: R19.2, R20.2 (B), R24.2, R25.2 (B), R33.2, R34.2, TP12.1, TP14.1
D1V5-: R11.2, R12.1, R13.1, TP6.1
D3V3-: R6.2, R7.1, R8.1, TP4.1
DGND: J7.2, J7.10, R4.2, R5.2 (B), R9.2, R10.2 (B), R14.2, R15.2 (B), R31.2, R32.2, TP11.1, TP13.1
unnamed: R7.2, R10.1 (A)
unnamed: R8.2, R9.1
unnamed: R12.2, R15.1 (A)
unnamed: R18.2, R19.1
unnamed: R17.2, R20.1 (A)
unnamed: R22.2, R25.1 (A)
unnamed: R2.2, R5.1 (A)
unnamed: R3.2, R4.1
unnamed: R13.2, R14.1
unnamed: R23.2, R24.1
NC: J7.4
TCK: J7.1, R26.2
TDI: J7.9, R29.2
TDO: J7.3, R27.2
TMS: J7.5, R28.2
TRST: J7.8, R30.1
VJTAG: J7.6
VPUMP: J7.7
VSUP-: R1.2, R2.1, R3.1, TP2.1

Notes on the sheet:
VSUP
D3V3
D1V5
A1V5
A3V3
GND
