marmote/marmote/hardware/BreakoutBoard_RevA/BreakoutBoard_RevA.brd

## EAGLE design hardware/BreakoutBoard_RevA/BreakoutBoard_RevA.brd (continued)

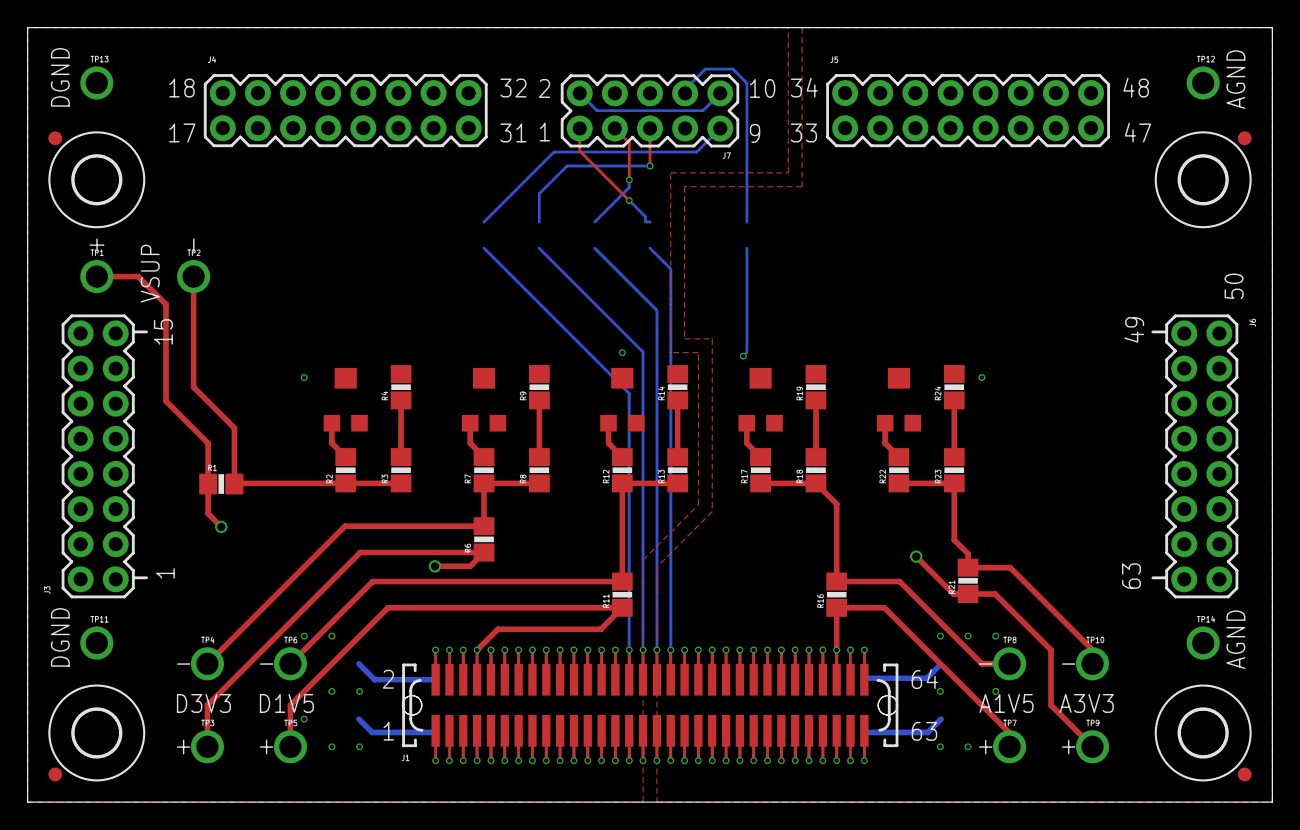
[picture p178: board BreakoutBoard_RevA.brd from above]

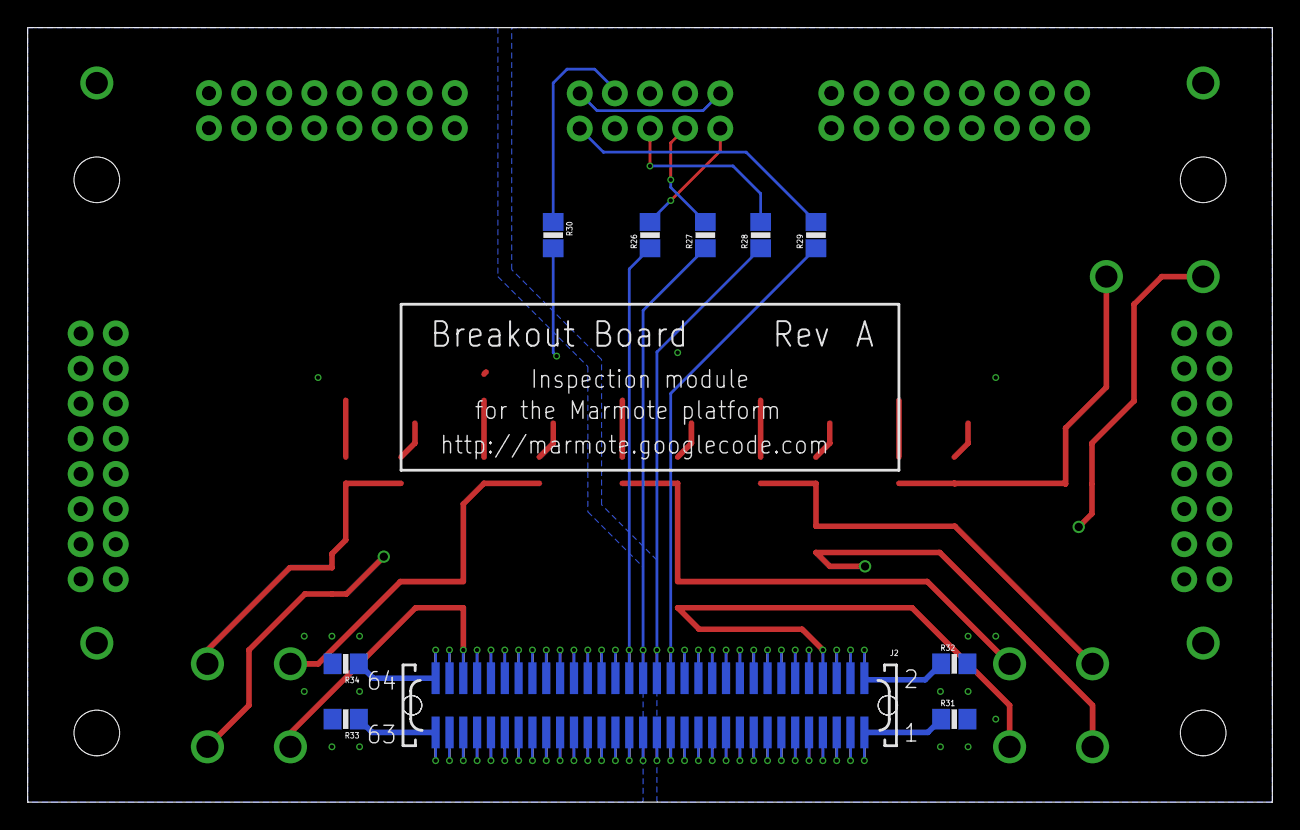
[picture p179: board BreakoutBoard_RevA.brd from below]

Board: 4 copper layers, 90.0 x 56.0 mm, 67 parts (10 on the bottom side), 86 nets.
