marmote/marmote/firmware/MainBoard/StreamingReceiver_RF/SoftConsole/StreamingReceiver_RF_MSS_MSS_CM3_0/StreamingReceiver_RF_MSS_MSS_CM3_0_app/main.c

#include "IRQ_stuff.h"
#include "RF_IC_stuff.h"
#include "MessageFormat.h"


// **************************************************************************
// **************************************************************************
// *																		*
// *							Functions									*
// *																		*
// *																		*
// **************************************************************************
void command_execution(uint8_t* buffer)
{
	uint32_t				frequency				= *((uint32_t*)				&(buffer[20]));

	float					TX_Attenuation			= *((float*)				&(buffer[16]));

	Max2830_LNA_Att_t		RX_Attenuation_LNA		= (Max2830_LNA_Att_t)		buffer[15];
	uint8_t					RX_Attenuation_VGA_ATT	= 							buffer[14];

	Max2830_RXTX_BW_t		BW                  	= (Max2830_RXTX_BW_t)		buffer[13];

	uint8_t					ENABLE                  =							buffer[12];
	uint8_t					CMOS_OUTPUT             =							buffer[11];
	uint8_t					PULL_UP                 =							buffer[10];

	uint8_t					Ref_Clk_Output_ENABLE   =							buffer[9];
	uint8_t					Ref_Clk_Output_DIVIDE   =							buffer[8];

	Max2830_RX_HPF_t		RX_HPF					= (Max2830_RX_HPF_t)		buffer[7];

	Max2830_Analog_Meas_t	RSSI_Output     		= (Max2830_Analog_Meas_t)	buffer[6];

	Max2830_IQ_Out_CM_t		RX_IQ_Output_CM 		= (Max2830_IQ_Out_CM_t)		buffer[5];

	uint16_t				PA_DELAY				= *((int16_t*) 				&(buffer[3]));

	Max2830_Mode_t			MODE					= (Max2830_Mode_t)			buffer[2];

	Max2830_TX_Cal_Gain_t	TX_CAL_GAIN				= (Max2830_TX_Cal_Gain_t)	buffer[1];

	Max2830_RX_Ant_t 		RX_Ant					= (Max2830_RX_Ant_t)		buffer[0];


//////////////////////////////////////////////////////


	Max2830_Set_Frequency		(frequency);

    Max2830_Set_TX_Attenuation	(TX_Attenuation);

    Max2830_Set_RX_Attenuation	(RX_Attenuation_LNA,
                        		RX_Attenuation_VGA_ATT);

	Max2830_Set_RXTX_LPF		(BW);

	Max2830_Set_Lock_Detector	(ENABLE,
								CMOS_OUTPUT,
                        		PULL_UP);

	Max2830_Set_Ref_Clk_Output	(Ref_Clk_Output_ENABLE,
                        		Ref_Clk_Output_DIVIDE);

	Max2830_Set_RX_HPF			(RX_HPF );

	Max2830_Set_RSSI_Output		(RSSI_Output);

	Max2830_Set_RX_IQ_Output_CM	(RX_IQ_Output_CM);

	Max2830_Set_PA_Delay		(PA_DELAY);

	Max2830_Set_Mode			(MODE );

	Max2830_Set_TX_Cal_Gain		(TX_CAL_GAIN);

	Max2830_Set_RX_Ant			(RX_Ant);
}


// **************************************************************************
		uint8_t	buffer[BUF_LENGTH];

extern	volatile uint8_t * volatile	p_WR;
		volatile uint8_t * volatile	p_RD;

#define COMMAND_WAITING_STATE        0
#define COMMAND_COLLECTING_STATE     1

void command_parsing()
{
	static uint8_t	seq[SEQ_LENGTH]	= FRAME_SEQ;
    static uint8_t	seq_cnt	= 0;

    static uint8_t	temp[CMD_LENGTH];
    static uint16_t	temp_cnt = CMD_LENGTH;

    static char		state = COMMAND_WAITING_STATE;

    while (p_RD != p_WR)
    {
		if (state == COMMAND_WAITING_STATE)
		{
			if (*p_RD == seq[seq_cnt])
				seq_cnt++;
			else
				seq_cnt = (*p_RD == seq[0]) ? 1 : 0;

			if (seq_cnt >= SEQ_LENGTH)
			{
				seq_cnt = 0;
				state = COMMAND_COLLECTING_STATE;
			}
		}
		else if (state == COMMAND_COLLECTING_STATE)
		{
			temp_cnt--;
			temp[temp_cnt] = *p_RD;

			if (temp_cnt == 0)
			{
				command_execution(temp);

				temp_cnt = CMD_LENGTH;
				state = COMMAND_WAITING_STATE;
			}
		}

		p_RD++;

		if (p_RD >= buffer + BUF_LENGTH)
			p_RD = buffer;
    }

}



// **************************************************************************
// **************************************************************************
// *																		*
// *					Functions for Interrupt Handlers					*
// *																		*
// *																		*
// **************************************************************************



// **************************************************************************
// **************************************************************************
// *																		*
// *							Init functions								*
// *																		*
// *																		*
// **************************************************************************



// **************************************************************************
// **************************************************************************
// *																		*
// *								Main									*
// *																		*
// *																		*
// **************************************************************************
int main()
{
	init_RF_IC_stuff();

	p_RD = buffer;

	init_IRQ_stuff();

//////////////////////////////////////////////////////

	while( 1 )
	{
		command_parsing();
	}
}
