marmote/marmote/firmware/MainBoard/FskTransmitter/SoftConsole/Teton_MSS_MSS_CM3_0/Teton_MSS_MSS_CM3_0_app/main.c

#include <string.h>
#include <mss_gpio.h>
#include <mss_rtc.h>

#include "yellowstone.h"
#include "teton.h"

#include "cmd_def.h"


extern uint8_t cmd_buffer[];
extern uint8_t cmd_length;

char* cmd_token;
CMD_Type* cmd_list_ptr;
char* arg_list[10];
uint32_t argc;

void process_cmd_buff(const char* cmd_buff, uint8_t length);



int main()
{
    //MSS_RTC_init();

	MSS_GPIO_init();
	Max19706_init( MAX19706_AFE1 );
	Max19706_init( MAX19706_AFE2 );

	Yellowstone_Init();
	Joshua_init();

    //MSS_RTC_configure( MSS_RTC_NO_COUNTER_RESET | MSS_RTC_ENABLE_VOLTAGE_REGULATOR_ON_MATCH );
    //MSS_RTC_start();

	MSS_GPIO_config(MSS_GPIO_LED1, MSS_GPIO_OUTPUT_MODE);
	MSS_GPIO_config(MSS_GPIO_LED2, MSS_GPIO_OUTPUT_MODE);
	MSS_GPIO_config(MSS_GPIO_AFE_ENABLE, MSS_GPIO_OUTPUT_MODE);
	MSS_GPIO_config(MSS_GPIO_FPGA_ENABLE, MSS_GPIO_OUTPUT_MODE);

	// Set up the common mode on AFEs
//   	Max19706_set_dac_cm( MAX19706_AFE1, MAX19706_DAC_CM_1_20V );
//   	Max19706_set_dac_cm( MAX19706_AFE2, MAX19706_DAC_CM_1_20V );

	// Set up as a transmitter at 2405 MHz by default
	Max2830_set_frequency(2405000000uL);
	Max2830_set_mode(MAX2830_TX_MODE);

	MSS_GPIO_set_output(MSS_GPIO_LED1, 0);
	MSS_GPIO_set_output(MSS_GPIO_LED2, 0);
	MSS_GPIO_set_output(MSS_GPIO_AFE_ENABLE, 1);
	MSS_GPIO_set_output(MSS_GPIO_FPGA_ENABLE, 1);

	SystemCoreClockUpdate();

	//FSK_TX_set_amplitude(100);
	FSK_TX_set_frequency(500000); // Hz
	FSK_TX->MUX = 0;

//	FSK_TX->MUX = 1;
//	FSK_TX->I = 0x200u;
//	FSK_TX->Q = 0x200u;

	while( 1 )
	{
		if (cmd_length > 0)
		{
			process_cmd_buff((const char*)cmd_buffer, cmd_length);
			cmd_length = 0;
		}
	}
}



void process_cmd_buff(const char* cmd_buff, uint8_t length)
{
	uint8_t parse_result = 1;

	// Tokenize RX buffer content
	cmd_token = strtok((char *)cmd_buffer, " ");
	if (cmd_token != NULL)
	{
		cmd_list_ptr = CMD_List;
		while (cmd_list_ptr->CmdString)
	    {
	        if (!strcmp(cmd_token, (const char*)cmd_list_ptr->CmdString))
	        {
				// Set the argList pointers to tokens
	            argc = 0;

	            while ( cmd_token != NULL && argc < 10 )
	            {
	                arg_list[argc++] = cmd_token;
	                cmd_token = strtok(NULL, " ");
	            }

				Yellowstone_write("\nACK", 5);

				// Invoke associated command function
		        cmd_list_ptr->CmdFunction(argc, arg_list);

				parse_result = 0;
	            break;
	        }

			cmd_list_ptr++;
	    }
	}

	// Send NAK if no valid command identified
	if (parse_result == 1)
	{
		Yellowstone_write("\nNAK>", 5);
	}

	// Send '>' prompt
	Yellowstone_write("\nT>", 3);

	// Clean up states
	cmd_length = 0;
}
