marmote/marmote/firmware/MainBoard/Ofdm/SoftConsole/Teton_MSS_MSS_CM3_0/Teton_MSS_MSS_CM3_0_app/max2830.c

//-----------------------------------------------------------------------------
// Title         : Max2830 firmware source
// Project       : Marmote Teton (Main Board)
//-----------------------------------------------------------------------------
// File          : max2830.h
// Author        : Benjamin Babjak and Sandor Szilvasi
// Company       : Vanderbilt University, ISIS
// Created       : 2012-05-29 10:13
// Last update   : 2011-05-31 09:15
// Platform      : Marmote
// Target device : Actel A2F500M3G
// Tool version  : CoreConsole v3.3
// Standard      : CMSIS
//-----------------------------------------------------------------------------
// Description   : Firmware for the Max2830 RF transceiver chip found on the
//                 Marmote Joshua module.
//-----------------------------------------------------------------------------
// Copyright (c) 2006-2012, Vanderbilt University
// All rights reserved.
//
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
// IN NO EVENT SHALL THE VANDERBILT UNIVERSITY BE LIABLE TO ANY PARTY FOR
// DIRECT, INDIRECT, SPECIAL, INCIDENTAL, OR CONSEQUENTIAL DAMAGES ARISING OUT
// OF THE USE OF THIS SOFTWARE AND ITS DOCUMENTATION, EVEN IF THE VANDERBILT
// UNIVERSITY HAS BEEN ADVISED OF THE POSSIBILITY OF SUCH DAMAGE.
//
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
#include "max2830.h"

//uint16_t dummy;

//void agc_handler(ace_flag_handle_t flag_handle)
//{
//	uint16_t dummy;
//	dummy = Max2830_get_rssi_value();
//	switch (flag_handle)
//	{
//		case J_RSSI_RSSI_HIGH:
//			if (Max2830_get_rx_lna_gain() == 33)
//			{
//				Max2830_set_rx_lna_gain(17);
//			}
//			else
//			{
//				Max2830_set_rx_lna_gain(0);
//			}
//			break;
//		case J_RSSI_RSSI_LOW:
//			if (Max2830_get_rx_lna_gain() == 0)
//			{
//				Max2830_set_rx_lna_gain(17);
//			}
//			else
//			{
//				Max2830_set_rx_lna_gain(33);
//			}
//			break;
//		default:
//			break;
//	}
//	ACE_clear_flag_irq(flag_handle);
//}

void Max2830_init ( )
{
	uint8_t i;

	// Initialize SPI1
	MSS_SPI_init( &g_mss_spi1 );
	MSS_SPI_configure_master_mode(
			&g_mss_spi1,
			MSS_SPI_SLAVE_0,
			MSS_SPI_MODE0,
			MSS_SPI_PCLK_DIV_2, // 20 MHz PCLK1 > 10 MHz SPI clock
			SPI_FRAME_SIZE_MAX2830
	);

	// Configure all MAX2830 registers
	for ( i = 0 ; i < 16 ; i++ )
	{
		Max2830_write_register(i, max2830_regs[i]);
	}

	// Initialize GPIOs

	//MSS_GPIO_init(); // Should have been called already
	MSS_GPIO_config( MSS_GPIO_LD, MSS_GPIO_INPUT_MODE );
	MSS_GPIO_config( MSS_GPIO_SHDN, MSS_GPIO_OUTPUT_MODE );
	MSS_GPIO_config( MSS_GPIO_RXTX, MSS_GPIO_OUTPUT_MODE );

	MSS_GPIO_set_outputs( MSS_GPIO_get_outputs() & ~MSS_GPIO_RXTX_MASK );	// RX

	Max2830_set_mode( MAX2830_SHUTDOWN_MODE );
	Max2830_set_rssi_config( MAX2830_ANALOG_MEAS_TXPOW );

	// RSSI pin
	ACE_init();
	rssi_handle = ACE_get_channel_handle((const uint8_t*)"J_RSSI");

	if ( rssi_handle == INVALID_CHANNEL_HANDLE )
	{
		for (;;);
	}

//	// AGC (LNA)
//	ACE_register_flag_isr(J_RSSI_RSSI_HIGH, agc_handler);
//	ACE_register_flag_isr(J_RSSI_RSSI_LOW, agc_handler);
//	ACE_enable_flag_irq(J_RSSI_RSSI_HIGH);
//	ACE_enable_flag_irq(J_RSSI_RSSI_LOW);
}


uint16_t Max2830_read_register(uint8_t addr)
{
	if ( addr > 15 )
	{
		addr = 15;
	}

	return max2830_regs[addr];
}


void Max2830_write_register(uint8_t addr, uint16_t data)
{
	uint32_t tx_frame;

	if ( addr > 15 )
	{
		return;
	}

	// Take control back in case the AFEs used the SPI
	MSS_SPI_configure_master_mode(
			&g_mss_spi1,
			MSS_SPI_SLAVE_0,
			MSS_SPI_MODE0,
			MSS_SPI_PCLK_DIV_2, // 20 MHz PCLK1 > 10 MHz SPI clock
			SPI_FRAME_SIZE_MAX2830
	);

	tx_frame = addr & 0xF; // bytes [3:0] 4 LSB
	tx_frame |= (data & 0x3FFF) << 4; // bytes [18:4] 18 - 5 MSB

	// Initiate SPI transmission
	MSS_SPI_set_slave_select(
			&g_mss_spi1,
			MSS_SPI_SLAVE_0
	);

	MSS_SPI_transfer_frame(
			&g_mss_spi1,
			tx_frame
	);

	MSS_SPI_clear_slave_select(
			&g_mss_spi1,
			MSS_SPI_SLAVE_0
	);

	// Update local copy of register
	max2830_regs[addr] = data & 0x3FFF;
}



void Max2830_set_frequency( uint32_t freq_hz )
{
	uint8_t		RefFreqDivider = 1; // Either 1 or 2

	uint32_t	f_Comp;
	uint8_t		IntegerDivider; // 64 <=  <= 255
	uint32_t	FractionalDivider;

	if ( freq_hz < 2400000000u || freq_hz > 2500000000u )
	{
		return;
	}

	f_Comp = LO_FREQUENCY / RefFreqDivider;

	IntegerDivider = (uint8_t) (freq_hz / f_Comp);
	if (IntegerDivider < 64)
		IntegerDivider = 64;

	FractionalDivider = (uint32_t) (((uint64_t) (freq_hz % f_Comp)) * 1048575 / f_Comp);
	FractionalDivider = FractionalDivider & 0xFFFFF;

	// TODO: Do we really have to set these every time?
	// Set_Fractional_N_PLL_Mode_Enable(1);			//Set 1 to enable the fractional-N PLL or set 0 to enable the integer-N PLL.
	// Set_Reference_Frequency_Divider_Ratio(0);		//Set to 0 to divide by 1. Set to 1 to divide by 2.

	// Actual frequency setup
	//	8-Bit Integer Portion of Main Divider. Programmable from 64 to 255.

	//	6 LSBs of 20-Bit Fractional Portion of Main Divider
	//	14 MSBs of 20-Bit Fractional Portion of Main Divider

	Max2830_write_register(0x3, IntegerDivider | ((FractionalDivider & 0x3F) << 8));
	Max2830_write_register(0x4, (FractionalDivider >> 6));
}

uint32_t Max2830_get_frequency( void )
{
	// TODO: cleanup variables
	// TODO: read fractional PLL mode enable bit (assume bit value 1 now)
	// TODO: read reference frequency divider ratio (assume bit value 0 now - divide by 1)

	const uint32_t FREQ_CONST = 1048575; // 2^20-1  or (1 << 19) - 1;
	uint8_t		RefFreqDivider = 1; // Either 1 or 2
	uint8_t IntegerDivider;
	uint32_t FractionalDivider;
	uint32_t freq_hz;
	uint32_t	f_Comp;

	f_Comp = LO_FREQUENCY / RefFreqDivider;

	IntegerDivider = Max2830_read_register(3) & 0xFF;				//  [7:0] -> IntegerDivider[7:0]
	FractionalDivider  = (Max2830_read_register(3) >> 8) & 0x3F;	// [13:8] -> FractionalDivider[5:0]
	FractionalDivider |= (Max2830_read_register(4) & 0x3FFF) << 6;  // [13:0] -> FractionalDivider[19:6]

	freq_hz = (uint32_t) (IntegerDivider * f_Comp + ((uint64_t) FractionalDivider) * ((uint64_t) f_Comp) / FREQ_CONST );

	return freq_hz;
}


float Max2830_get_tx_gain( void )
{
	uint16_t gain;

	gain = Max2830_read_register(12) & 0x3F;

	return (float)gain / 2;
}

void Max2830_set_tx_gain( float gain_db )
{
	// FIXME: consider using uint8 instead of float for gain_db

	uint16_t gain;
	uint16_t reg_val;

	if (gain_db > 31.5)
	{
		gain_db = 31.5;
	}

	if (gain_db < 0.0)
	{
		gain_db = 0.0;
	}

	gain = 2 * gain_db;

	reg_val = Max2830_read_register(12) & ~0x3F; // Zero R12[5:0]
	reg_val |= gain & 0x3F; // Set gain in R12[5:0]

	Max2830_write_register(12, reg_val);
}


uint32_t Max2830_get_tx_bandwidth( void )
{
	uint16_t bw;

	// Get LPF coarse -3dB corner frequency (R8[1:0])
	bw = (Max2830_read_register(8) & 0x3) * 6;

	// Get LPF fine -3dB corner frequency for TX (R7[5:3])
	bw += (Max2830_read_register(7) >> 3 & 0x07);

	return max2830_tx_lpf_bws[bw];
}


void Max2830_set_tx_bandwidth( uint32_t bandwidth )
{
	uint16_t i;
	uint16_t reg_val;

	for ( i = 0 ; i < sizeof(max2830_tx_lpf_bws)/sizeof(uint16_t)-1 ; i++ )
	{
		if ( bandwidth <= max2830_tx_lpf_bws[i] )
		{
			break;
		}
	}

	// Set LPF coarse -3dB corner frequency (R8[1:0])
	reg_val = Max2830_read_register(8) & ~0x3;
	Max2830_write_register(8, reg_val | (uint16_t)i / 6);

	// Set LPF fine -3dB corner frequency both for TX (R7[5:3])
	reg_val = Max2830_read_register(7) & ~0x38;
	reg_val |= ( (uint16_t)i % 6 << 3 ) & 0x38;
	Max2830_write_register(7, reg_val);
}

float Max2830_get_rx_lna_gain( void )
{
	uint16_t reg_val;
	uint8_t gain;

	reg_val = Max2830_read_register(11);
	gain = 0;

	if ( ((reg_val >> 5) & 0x03) == 0x03 )
	{
		return 33;
	}

	if ( ((reg_val >> 5) & 0x03) == 0x02 )
	{
		return 17;
	}

	return 0;
}

void Max2830_set_rx_lna_gain( float gain_db )
{
	uint16_t reg_val;

	reg_val = Max2830_read_register(11); // R11[6:5]

	// Set register to the nearest possible value (0, 17 or 33 dB)

	// Low (0 dB)
	reg_val &= ~(0x03 << 5);

	if ( gain_db > 8 )
	{
		reg_val |= (0x01 << 6); // Medium (17 dB)
	}

	if ( gain_db > 25 )
	{
		reg_val |= (0x03 << 5); // High (33 dB)
	}

	Max2830_write_register(11, reg_val);
}

float Max2830_get_rx_vga_gain( void )
{
	uint8_t gain;

	gain = (Max2830_read_register(11) & 0x1F) * 2; // R11[4:0]

	return (float)gain;
}

void Max2830_set_rx_vga_gain( float gain_db )
{
	uint16_t reg_val;

	if ( gain_db > 62 )
	{
		gain_db = 62;
	}

	reg_val = Max2830_read_register(11) & ~(0x1F); // R11[4:0]
	reg_val |= ( ((uint16_t)gain_db >> 1) & 0x1F);

	Max2830_write_register(11, reg_val);
}

float Max2830_get_rx_gain( void )
{
	return Max2830_get_rx_lna_gain() + Max2830_get_rx_vga_gain();
}

void Max2830_set_rx_gain( float gain_db )
{
	// FIXME: consider using uint8 instead of float for gain_db

	float lna_gain;
	float vga_gain;

	// Check if the gain value is achievable with setting VGA only
	lna_gain = Max2830_get_rx_lna_gain();
	switch ( (uint8_t)lna_gain )
	{
		case 33:
			// High gain spans 33 - 95 dB range
			if ( gain_db < 17 )
			{
				lna_gain = 0;
				break;
			}

			if ( gain_db < 33 )
			{
				lna_gain = 17;
				break;
			}
		case 17:
			// Medium gain spans 17 - 79 dB range
			if ( gain_db > 79 )
			{
				lna_gain = 33;
				break;
			}

			if ( gain_db < 17 )
			{
				lna_gain = 0;
				break;
			}
		case 0:
		default:
			// Medium gain spans 0 - 62 dB range
			if ( gain_db > 79 )
			{
				lna_gain = 33;
				break;
			}

			if ( gain_db > 62 )
			{
				lna_gain = 17;
				break;
			}
	}

	vga_gain = gain_db - lna_gain;

	Max2830_set_rx_lna_gain(lna_gain);
	Max2830_set_rx_vga_gain(vga_gain);
}


uint32_t Max2830_get_rx_bandwidth( void )
{
	uint16_t bw;

	// NOTE: The same registers are used for TX

	// Get RX LPF coarse -3dB corner frequency (R8[1:0])
	bw = (Max2830_read_register(8) & 0x03) * 5;

	// Get LPF fine -3dB corner frequency for RX (R7[2:0])
	bw += Max2830_read_register(7) & 0x07;

	return max2830_rx_lpf_bws[bw];
}


void Max2830_set_rx_bandwidth( uint32_t bandwidth )
{
	uint16_t i;
	uint16_t reg_val;

	for ( i = 0 ; i < sizeof(max2830_rx_lpf_bws)/sizeof(uint16_t)-1 ; i++ )
	{
		if ( bandwidth <= max2830_rx_lpf_bws[i] )
		{
			break;
		}
	}

	// Set LPF coarse -3dB corner frequency
	reg_val = Max2830_read_register(8) & ~0x3; // R8[1:0]
	Max2830_write_register(8, reg_val | i / 5);

	// Set LPF fine -3dB corner frequency for RX only
	reg_val = Max2830_read_register(7) & ~0x7; //  R7[2:0]
	reg_val |= ( i % 5 ) & 0x07;
	Max2830_write_register(7, reg_val);
}


Max2830_operating_mode_t Max2830_get_mode( void )
{
	uint32_t shutdown;
	uint32_t rxtx;
	uint32_t calibration;

	shutdown = MSS_GPIO_get_outputs() & MSS_GPIO_SHDN_MASK;
	rxtx = MSS_GPIO_get_outputs() & MSS_GPIO_RXTX_MASK;
	calibration = Max2830_read_register(6) & 0x3;

	if ( shutdown == 0)
	{
		if ( rxtx == 0 )
		{
			return MAX2830_SHUTDOWN_MODE;
		}
		else
		{
			return MAX2830_STANDBY_MODE;
		}
	}
	else
	{
		if ( rxtx == 0 )
		{
			// Rx
			if ( calibration & 1 )
			{
				return MAX2830_RX_CALIBRATION_MODE;
			}
			else
			{
				return MAX2830_RX_MODE;
			}
		}
		else
		{
			// Tx
			if ( calibration & 3 )
			{
				return MAX2830_TX_CALIBRATION_MODE;
			}
			else
			{
				return MAX2830_TX_MODE;
			}
		}
	}
}


void Max2830_set_mode( Max2830_operating_mode_t mode )
{
	uint8_t shutdown;
	uint8_t rxtx;
	uint8_t calibration;

	uint16_t reg_val;

	switch (mode)
	{
		case MAX2830_SHUTDOWN_MODE :
			shutdown = 0;
			rxtx = 0;
			calibration = 0;
			break;

		case MAX2830_STANDBY_MODE :
			shutdown = 0;
			rxtx = 1;
			calibration = 0;
			break;

		case MAX2830_RX_MODE :
			shutdown = 1;
			rxtx = 0;
			calibration = 0;
			break;

		case MAX2830_TX_MODE :
			shutdown = 1;
			rxtx = 1;
			calibration = 0;
			break;

		case MAX2830_RX_CALIBRATION_MODE :
			shutdown = 1;
			rxtx = 0;
			calibration = 1;
			break;

		case MAX2830_TX_CALIBRATION_MODE :
			shutdown = 1;
			rxtx = 1;
			calibration = 3;
			break;

		default :
			break;
	}

	if ( shutdown == 0 )
	{
		MSS_GPIO_set_outputs( MSS_GPIO_get_outputs() & ~MSS_GPIO_SHDN_MASK );
	}
	else
	{
		MSS_GPIO_set_outputs( MSS_GPIO_get_outputs() | MSS_GPIO_SHDN_MASK );
	}

	if ( rxtx == 0 )
	{
		MSS_GPIO_set_outputs( MSS_GPIO_get_outputs() & ~MSS_GPIO_RXTX_MASK );
	}
	else
	{
		MSS_GPIO_set_outputs( MSS_GPIO_get_outputs() | MSS_GPIO_RXTX_MASK );
	}

	reg_val = Max2830_read_register(6) & ~0x3;
	reg_val |= calibration;

	Max2830_write_register(6, reg_val);
}


Max2830_Analog_Meas_t Max2830_get_rssi_config( void )
{
	uint16_t reg_val;

	reg_val = (Max2830_read_register(8) & 0x300) >> 8;

	return (Max2830_Analog_Meas_t)reg_val;
}


void Max2830_set_rssi_config( Max2830_Analog_Meas_t	mode )
{
	uint16_t reg_val;

	reg_val = Max2830_read_register(8) & ~0x300;

	// Make RSSI output independent from RXHP state
	reg_val |= 0x400;

	switch (mode)
	{
		case MAX2830_ANALOG_MEAS_RSSI :
			break;

		case MAX2830_ANALOG_MEAS_TEMP :
			reg_val |= 0x100;
			break;

		case MAX2830_ANALOG_MEAS_TXPOW :
			// Enable power detector
			Max2830_write_register(6, (uint16_t)1 << 6);
			reg_val |= 0x200;
			break;
	}

	Max2830_write_register(8, reg_val);
}

uint16_t Max2830_get_rssi_value( void )
{
	uint16_t adc_value; // TODO: make this function a single line

	adc_value = ACE_get_ppe_sample(rssi_handle);

	return adc_value;
}

uint8_t Max2830_get_pa_delay( void )
{
	uint8_t delay_us;

	delay_us = (Max2830_read_register(10) >> 10) & 0xF;
	return (delay_us - 1) / 2;
}


void Max2830_set_pa_delay( uint8_t delay_us )
{
	uint16_t reg_val;

	if (delay_us > 7)
	{
		delay_us = 7;
	}

	reg_val = Max2830_read_register(10) & ~(0xF << 10);
	reg_val |= ((delay_us * 2 + 1) & 0xF) << 10;

	Max2830_write_register(10, reg_val);
}
