marmote/marmote/firmware/A2F-EVAL-KIT/DecimationFilters/CIC/CIC_COMB_BlockRAM.a/component/work/CIC_COMB/CIC_COMB.vhd

-- Version: 9.1 SP3 9.1.3.4

library ieee;
use ieee.std_logic_1164.all;
library smartfusion;
use smartfusion.all;

entity CIC_COMB is

    port( CLK         : in    std_logic;
          RST         : in    std_logic;
          OUTPUT      : out   std_logic_vector(30 downto 0);
          clk_counter : in    std_logic_vector(5 downto 1);
          INPUT       : in    std_logic_vector(30 downto 0);
          dec_counter : in    std_logic_vector(3 downto 1)
        );

end CIC_COMB;

architecture DEF_ARCH of CIC_COMB is 

  component VCC
    port( Y : out   std_logic
        );
  end component;

  component GND
    port( Y : out   std_logic
        );
  end component;

  component CIC_COMB_mem
    port( WEN   : in    std_logic := 'U';
          REN   : in    std_logic := 'U';
          RWCLK : in    std_logic := 'U';
          RESET : in    std_logic := 'U';
          WD    : in    std_logic_vector(35 downto 0) := (others => 'U');
          RD    : out   std_logic_vector(35 downto 0);
          WADDR : in    std_logic_vector(2 downto 0) := (others => 'U');
          RADDR : in    std_logic_vector(2 downto 0) := (others => 'U')
        );
  end component;

    signal \CIC_COMB_control_0_RADDR_[2]\, 
        \CIC_COMB_control_0_RADDR_[1]\, 
        \CIC_COMB_control_0_RADDR_[0]\, CIC_COMB_control_0_REN, 
        \CIC_COMB_control_0_WADDR_[2]\, 
        \CIC_COMB_control_0_WADDR_[1]\, 
        \CIC_COMB_control_0_WADDR_[0]\, 
        \CIC_COMB_control_0_WD_[35]\, 
        \CIC_COMB_control_0_WD_[34]\, 
        \CIC_COMB_control_0_WD_[33]\, 
        \CIC_COMB_control_0_WD_[32]\, 
        \CIC_COMB_control_0_WD_[31]\, 
        \CIC_COMB_control_0_WD_[30]\, 
        \CIC_COMB_control_0_WD_[29]\, 
        \CIC_COMB_control_0_WD_[28]\, 
        \CIC_COMB_control_0_WD_[27]\, 
        \CIC_COMB_control_0_WD_[26]\, 
        \CIC_COMB_control_0_WD_[25]\, 
        \CIC_COMB_control_0_WD_[24]\, 
        \CIC_COMB_control_0_WD_[23]\, 
        \CIC_COMB_control_0_WD_[22]\, 
        \CIC_COMB_control_0_WD_[21]\, 
        \CIC_COMB_control_0_WD_[20]\, 
        \CIC_COMB_control_0_WD_[19]\, 
        \CIC_COMB_control_0_WD_[18]\, 
        \CIC_COMB_control_0_WD_[17]\, 
        \CIC_COMB_control_0_WD_[16]\, 
        \CIC_COMB_control_0_WD_[15]\, 
        \CIC_COMB_control_0_WD_[14]\, 
        \CIC_COMB_control_0_WD_[13]\, 
        \CIC_COMB_control_0_WD_[12]\, 
        \CIC_COMB_control_0_WD_[11]\, 
        \CIC_COMB_control_0_WD_[10]\, \CIC_COMB_control_0_WD_[9]\, 
        \CIC_COMB_control_0_WD_[8]\, \CIC_COMB_control_0_WD_[7]\, 
        \CIC_COMB_control_0_WD_[6]\, \CIC_COMB_control_0_WD_[5]\, 
        \CIC_COMB_control_0_WD_[4]\, \CIC_COMB_control_0_WD_[3]\, 
        \CIC_COMB_control_0_WD_[2]\, \CIC_COMB_control_0_WD_[1]\, 
        \CIC_COMB_control_0_WD_[0]\, CIC_COMB_control_0_WEN, 
        \CIC_COMB_mem_0_RD_[35]\, \CIC_COMB_mem_0_RD_[34]\, 
        \CIC_COMB_mem_0_RD_[33]\, \CIC_COMB_mem_0_RD_[32]\, 
        \CIC_COMB_mem_0_RD_[31]\, \CIC_COMB_mem_0_RD_[30]\, 
        \CIC_COMB_mem_0_RD_[29]\, \CIC_COMB_mem_0_RD_[28]\, 
        \CIC_COMB_mem_0_RD_[27]\, \CIC_COMB_mem_0_RD_[26]\, 
        \CIC_COMB_mem_0_RD_[25]\, \CIC_COMB_mem_0_RD_[24]\, 
        \CIC_COMB_mem_0_RD_[23]\, \CIC_COMB_mem_0_RD_[22]\, 
        \CIC_COMB_mem_0_RD_[21]\, \CIC_COMB_mem_0_RD_[20]\, 
        \CIC_COMB_mem_0_RD_[19]\, \CIC_COMB_mem_0_RD_[18]\, 
        \CIC_COMB_mem_0_RD_[17]\, \CIC_COMB_mem_0_RD_[16]\, 
        \CIC_COMB_mem_0_RD_[15]\, \CIC_COMB_mem_0_RD_[14]\, 
        \CIC_COMB_mem_0_RD_[13]\, \CIC_COMB_mem_0_RD_[12]\, 
        \CIC_COMB_mem_0_RD_[11]\, \CIC_COMB_mem_0_RD_[10]\, 
        \CIC_COMB_mem_0_RD_[9]\, \CIC_COMB_mem_0_RD_[8]\, 
        \CIC_COMB_mem_0_RD_[7]\, \CIC_COMB_mem_0_RD_[6]\, 
        \CIC_COMB_mem_0_RD_[5]\, \CIC_COMB_mem_0_RD_[4]\, 
        \CIC_COMB_mem_0_RD_[3]\, \CIC_COMB_mem_0_RD_[2]\, 
        \CIC_COMB_mem_0_RD_[1]\, \CIC_COMB_mem_0_RD_[0]\, GND_net, 
        VCC_net : std_logic;

begin 


    \VCC\ : VCC
      port map(Y => VCC_net);
    
    \GND\ : GND
      port map(Y => GND_net);
    
    CIC_COMB_control_0 : entity work.CIC_COMB_control
      port map(CLK => CLK, RST => RST, clk_counter(5) => 
        clk_counter(5), clk_counter(4) => clk_counter(4), 
        clk_counter(3) => clk_counter(3), clk_counter(2) => 
        clk_counter(2), clk_counter(1) => clk_counter(1), 
        dec_counter(3) => dec_counter(3), dec_counter(2) => 
        dec_counter(2), dec_counter(1) => dec_counter(1), WD(35)
         => \CIC_COMB_control_0_WD_[35]\, WD(34) => 
        \CIC_COMB_control_0_WD_[34]\, WD(33) => 
        \CIC_COMB_control_0_WD_[33]\, WD(32) => 
        \CIC_COMB_control_0_WD_[32]\, WD(31) => 
        \CIC_COMB_control_0_WD_[31]\, WD(30) => 
        \CIC_COMB_control_0_WD_[30]\, WD(29) => 
        \CIC_COMB_control_0_WD_[29]\, WD(28) => 
        \CIC_COMB_control_0_WD_[28]\, WD(27) => 
        \CIC_COMB_control_0_WD_[27]\, WD(26) => 
        \CIC_COMB_control_0_WD_[26]\, WD(25) => 
        \CIC_COMB_control_0_WD_[25]\, WD(24) => 
        \CIC_COMB_control_0_WD_[24]\, WD(23) => 
        \CIC_COMB_control_0_WD_[23]\, WD(22) => 
        \CIC_COMB_control_0_WD_[22]\, WD(21) => 
        \CIC_COMB_control_0_WD_[21]\, WD(20) => 
        \CIC_COMB_control_0_WD_[20]\, WD(19) => 
        \CIC_COMB_control_0_WD_[19]\, WD(18) => 
        \CIC_COMB_control_0_WD_[18]\, WD(17) => 
        \CIC_COMB_control_0_WD_[17]\, WD(16) => 
        \CIC_COMB_control_0_WD_[16]\, WD(15) => 
        \CIC_COMB_control_0_WD_[15]\, WD(14) => 
        \CIC_COMB_control_0_WD_[14]\, WD(13) => 
        \CIC_COMB_control_0_WD_[13]\, WD(12) => 
        \CIC_COMB_control_0_WD_[12]\, WD(11) => 
        \CIC_COMB_control_0_WD_[11]\, WD(10) => 
        \CIC_COMB_control_0_WD_[10]\, WD(9) => 
        \CIC_COMB_control_0_WD_[9]\, WD(8) => 
        \CIC_COMB_control_0_WD_[8]\, WD(7) => 
        \CIC_COMB_control_0_WD_[7]\, WD(6) => 
        \CIC_COMB_control_0_WD_[6]\, WD(5) => 
        \CIC_COMB_control_0_WD_[5]\, WD(4) => 
        \CIC_COMB_control_0_WD_[4]\, WD(3) => 
        \CIC_COMB_control_0_WD_[3]\, WD(2) => 
        \CIC_COMB_control_0_WD_[2]\, WD(1) => 
        \CIC_COMB_control_0_WD_[1]\, WD(0) => 
        \CIC_COMB_control_0_WD_[0]\, WADDR(2) => 
        \CIC_COMB_control_0_WADDR_[2]\, WADDR(1) => 
        \CIC_COMB_control_0_WADDR_[1]\, WADDR(0) => 
        \CIC_COMB_control_0_WADDR_[0]\, RADDR(2) => 
        \CIC_COMB_control_0_RADDR_[2]\, RADDR(1) => 
        \CIC_COMB_control_0_RADDR_[1]\, RADDR(0) => 
        \CIC_COMB_control_0_RADDR_[0]\, WEN => 
        CIC_COMB_control_0_WEN, REN => CIC_COMB_control_0_REN, 
        RD(35) => \CIC_COMB_mem_0_RD_[35]\, RD(34) => 
        \CIC_COMB_mem_0_RD_[34]\, RD(33) => 
        \CIC_COMB_mem_0_RD_[33]\, RD(32) => 
        \CIC_COMB_mem_0_RD_[32]\, RD(31) => 
        \CIC_COMB_mem_0_RD_[31]\, RD(30) => 
        \CIC_COMB_mem_0_RD_[30]\, RD(29) => 
        \CIC_COMB_mem_0_RD_[29]\, RD(28) => 
        \CIC_COMB_mem_0_RD_[28]\, RD(27) => 
        \CIC_COMB_mem_0_RD_[27]\, RD(26) => 
        \CIC_COMB_mem_0_RD_[26]\, RD(25) => 
        \CIC_COMB_mem_0_RD_[25]\, RD(24) => 
        \CIC_COMB_mem_0_RD_[24]\, RD(23) => 
        \CIC_COMB_mem_0_RD_[23]\, RD(22) => 
        \CIC_COMB_mem_0_RD_[22]\, RD(21) => 
        \CIC_COMB_mem_0_RD_[21]\, RD(20) => 
        \CIC_COMB_mem_0_RD_[20]\, RD(19) => 
        \CIC_COMB_mem_0_RD_[19]\, RD(18) => 
        \CIC_COMB_mem_0_RD_[18]\, RD(17) => 
        \CIC_COMB_mem_0_RD_[17]\, RD(16) => 
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
        \CIC_COMB_control_0_WADDR_[1]\, WADDR(0) => 
        \CIC_COMB_control_0_WADDR_[0]\, RADDR(2) => 
        \CIC_COMB_control_0_RADDR_[2]\, RADDR(1) => 
        \CIC_COMB_control_0_RADDR_[1]\, RADDR(0) => 
        \CIC_COMB_control_0_RADDR_[0]\);
    

end DEF_ARCH; 
