marmote/marmote/firmware/A2F-EVAL-KIT/DecimationFilters/FIR_SRAM/component/work/FIR/FIR.vhd

-- Version: 9.1 SP2 9.1.2.16

library ieee;
use ieee.std_logic_1164.all;
library smartfusion;
use smartfusion.all;

entity FIR is

    port( CLK    : in    std_logic;
          RST    : in    std_logic;
          INPUT  : in    std_logic_vector(21 downto 0);
          OUTPUT : out   std_logic_vector(46 downto 0)
        );

end FIR;

architecture DEF_ARCH of FIR is 

  component VCC
    port( Y : out   std_logic
        );
  end component;

  component mult
    port( DataA : in    std_logic_vector(21 downto 0) := (others => 'U');
          DataB : in    std_logic_vector(15 downto 0) := (others => 'U');
          Mult  : out   std_logic_vector(37 downto 0)
        );
  end component;

  component mem_coeff
    port( WEN   : in    std_logic := 'U';
          REN   : in    std_logic := 'U';
          RWCLK : in    std_logic := 'U';
          RESET : in    std_logic := 'U';
          WD    : in    std_logic_vector(17 downto 0) := (others => 'U');
          RD    : out   std_logic_vector(17 downto 0);
          WADDR : in    std_logic_vector(8 downto 0) := (others => 'U');
          RADDR : in    std_logic_vector(8 downto 0) := (others => 'U')
        );
  end component;

  component GND
    port( Y : out   std_logic
        );
  end component;

  component mem_sample
    port( WEN   : in    std_logic := 'U';
          REN   : in    std_logic := 'U';
          RWCLK : in    std_logic := 'U';
          RESET : in    std_logic := 'U';
          WD    : in    std_logic_vector(21 downto 0) := (others => 'U');
          RD    : out   std_logic_vector(21 downto 0);
          WADDR : in    std_logic_vector(8 downto 0) := (others => 'U');
          RADDR : in    std_logic_vector(8 downto 0) := (others => 'U')
        );
  end component;

    signal FIR_core_0_GET_NEXT, \mem_coeff_0_RD_[17]\, 
        \mem_coeff_0_RD_[16]\, \mem_coeff_0_RD_[15]\, 
        \mem_coeff_0_RD_[14]\, \mem_coeff_0_RD_[13]\, 
        \mem_coeff_0_RD_[12]\, \mem_coeff_0_RD_[11]\, 
        \mem_coeff_0_RD_[10]\, \mem_coeff_0_RD_[9]\, 
        \mem_coeff_0_RD_[8]\, \mem_coeff_0_RD_[7]\, 
        \mem_coeff_0_RD_[6]\, \mem_coeff_0_RD_[5]\, 
        \mem_coeff_0_RD_[4]\, \mem_coeff_0_RD_[3]\, 
        \mem_coeff_0_RD_[2]\, \mem_coeff_0_RD_[1]\, 
        \mem_coeff_0_RD_[0]\, \mem_coef_control_0_OUTPUT_[15]\, 
        \mem_coef_control_0_OUTPUT_[14]\, 
        \mem_coef_control_0_OUTPUT_[13]\, 
        \mem_coef_control_0_OUTPUT_[12]\, 
        \mem_coef_control_0_OUTPUT_[11]\, 
        \mem_coef_control_0_OUTPUT_[10]\, 
        \mem_coef_control_0_OUTPUT_[9]\, 
        \mem_coef_control_0_OUTPUT_[8]\, 
        \mem_coef_control_0_OUTPUT_[7]\, 
        \mem_coef_control_0_OUTPUT_[6]\, 
        \mem_coef_control_0_OUTPUT_[5]\, 
        \mem_coef_control_0_OUTPUT_[4]\, 
        \mem_coef_control_0_OUTPUT_[3]\, 
        \mem_coef_control_0_OUTPUT_[2]\, 
        \mem_coef_control_0_OUTPUT_[1]\, 
        \mem_coef_control_0_OUTPUT_[0]\, 
        \mem_coef_control_0_RADDR_[8]\, 
        \mem_coef_control_0_RADDR_[7]\, 
        \mem_coef_control_0_RADDR_[6]\, 
        \mem_coef_control_0_RADDR_[5]\, 
        \mem_coef_control_0_RADDR_[4]\, 
        \mem_coef_control_0_RADDR_[3]\, 
        \mem_coef_control_0_RADDR_[2]\, 
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
        \mem_sample_0_RD_[12]\, RD(11) => \mem_sample_0_RD_[11]\, 
        RD(10) => \mem_sample_0_RD_[10]\, RD(9) => 
        \mem_sample_0_RD_[9]\, RD(8) => \mem_sample_0_RD_[8]\, 
        RD(7) => \mem_sample_0_RD_[7]\, RD(6) => 
        \mem_sample_0_RD_[6]\, RD(5) => \mem_sample_0_RD_[5]\, 
        RD(4) => \mem_sample_0_RD_[4]\, RD(3) => 
        \mem_sample_0_RD_[3]\, RD(2) => \mem_sample_0_RD_[2]\, 
        RD(1) => \mem_sample_0_RD_[1]\, RD(0) => 
        \mem_sample_0_RD_[0]\, WADDR(8) => 
        \mem_sample_control_0_WADDR_[8]\, WADDR(7) => 
        \mem_sample_control_0_WADDR_[7]\, WADDR(6) => 
        \mem_sample_control_0_WADDR_[6]\, WADDR(5) => 
        \mem_sample_control_0_WADDR_[5]\, WADDR(4) => 
        \mem_sample_control_0_WADDR_[4]\, WADDR(3) => 
        \mem_sample_control_0_WADDR_[3]\, WADDR(2) => 
        \mem_sample_control_0_WADDR_[2]\, WADDR(1) => 
        \mem_sample_control_0_WADDR_[1]\, WADDR(0) => 
        \mem_sample_control_0_WADDR_[0]\, RADDR(8) => 
        \mem_sample_control_0_RADDR_[8]\, RADDR(7) => 
        \mem_sample_control_0_RADDR_[7]\, RADDR(6) => 
        \mem_sample_control_0_RADDR_[6]\, RADDR(5) => 
        \mem_sample_control_0_RADDR_[5]\, RADDR(4) => 
        \mem_sample_control_0_RADDR_[4]\, RADDR(3) => 
        \mem_sample_control_0_RADDR_[3]\, RADDR(2) => 
        \mem_sample_control_0_RADDR_[2]\, RADDR(1) => 
        \mem_sample_control_0_RADDR_[1]\, RADDR(0) => 
        \mem_sample_control_0_RADDR_[0]\);
    

end DEF_ARCH; 
