marmote/marmote/firmware/MainBoard/StreamingReceiver_RF/smartgen/AFE_mux/AFE_mux.vhd

-- Version: 10.0 SP2 10.0.20.2

library ieee;
use ieee.std_logic_1164.all;
library smartfusion;
use smartfusion.all;

entity AFE_mux is

    port( Data0_port : in    std_logic_vector(19 downto 0);
          Data1_port : in    std_logic_vector(19 downto 0);
          Sel0       : in    std_logic;
          Result     : out   std_logic_vector(19 downto 0)
        );

end AFE_mux;

architecture DEF_ARCH of AFE_mux is 

  component MX2
    port( A : in    std_logic := 'U';
          B : in    std_logic := 'U';
          S : in    std_logic := 'U';
          Y : out   std_logic
        );
  end component;

  component BUFF
    port( A : in    std_logic := 'U';
          Y : out   std_logic
        );
  end component;

    signal \SelAux_0[0]\, \SelAux_0[5]\, \SelAux_0[10]\, 
        \SelAux_0[15]\ : std_logic;

begin 


    \MX2_Result[13]\ : MX2
      port map(A => Data0_port(13), B => Data1_port(13), S => 
        \SelAux_0[10]\, Y => Result(13));
    
    \MX2_Result[4]\ : MX2
      port map(A => Data0_port(4), B => Data1_port(4), S => 
        \SelAux_0[0]\, Y => Result(4));
    
    \MX2_Result[3]\ : MX2
      port map(A => Data0_port(3), B => Data1_port(3), S => 
        \SelAux_0[0]\, Y => Result(3));
    
    \MX2_Result[6]\ : MX2
      port map(A => Data0_port(6), B => Data1_port(6), S => 
        \SelAux_0[5]\, Y => Result(6));
    
    \MX2_Result[9]\ : MX2
      port map(A => Data0_port(9), B => Data1_port(9), S => 
        \SelAux_0[5]\, Y => Result(9));
    
    \MX2_Result[15]\ : MX2
      port map(A => Data0_port(15), B => Data1_port(15), S => 
        \SelAux_0[15]\, Y => Result(15));
    
    \MX2_Result[19]\ : MX2
      port map(A => Data0_port(19), B => Data1_port(19), S => 
        \SelAux_0[15]\, Y => Result(19));
    
    \BUFF_SelAux_0[15]\ : BUFF
      port map(A => Sel0, Y => \SelAux_0[15]\);
    
    \MX2_Result[11]\ : MX2
      port map(A => Data0_port(11), B => Data1_port(11), S => 
        \SelAux_0[10]\, Y => Result(11));
    
    \MX2_Result[18]\ : MX2
      port map(A => Data0_port(18), B => Data1_port(18), S => 
        \SelAux_0[15]\, Y => Result(18));
    
    \MX2_Result[8]\ : MX2
      port map(A => Data0_port(8), B => Data1_port(8), S => 
        \SelAux_0[5]\, Y => Result(8));
    
    \BUFF_SelAux_0[0]\ : BUFF
      port map(A => Sel0, Y => \SelAux_0[0]\);
    
    \MX2_Result[0]\ : MX2
      port map(A => Data0_port(0), B => Data1_port(0), S => 
        \SelAux_0[0]\, Y => Result(0));
    
    \MX2_Result[17]\ : MX2
      port map(A => Data0_port(17), B => Data1_port(17), S => 
        \SelAux_0[15]\, Y => Result(17));
    
    \MX2_Result[16]\ : MX2
      port map(A => Data0_port(16), B => Data1_port(16), S => 
        \SelAux_0[15]\, Y => Result(16));
    
    \MX2_Result[2]\ : MX2
      port map(A => Data0_port(2), B => Data1_port(2), S => 
        \SelAux_0[0]\, Y => Result(2));
    
    \BUFF_SelAux_0[5]\ : BUFF
      port map(A => Sel0, Y => \SelAux_0[5]\);
    
    \MX2_Result[5]\ : MX2
      port map(A => Data0_port(5), B => Data1_port(5), S => 
        \SelAux_0[5]\, Y => Result(5));
    
    \MX2_Result[10]\ : MX2
      port map(A => Data0_port(10), B => Data1_port(10), S => 
        \SelAux_0[10]\, Y => Result(10));
    
    \MX2_Result[14]\ : MX2
      port map(A => Data0_port(14), B => Data1_port(14), S => 
        \SelAux_0[10]\, Y => Result(14));
    
    \MX2_Result[1]\ : MX2
      port map(A => Data0_port(1), B => Data1_port(1), S => 
        \SelAux_0[0]\, Y => Result(1));
    
    \BUFF_SelAux_0[10]\ : BUFF
      port map(A => Sel0, Y => \SelAux_0[10]\);
    
    \MX2_Result[7]\ : MX2
      port map(A => Data0_port(7), B => Data1_port(7), S => 
        \SelAux_0[5]\, Y => Result(7));
    
    \MX2_Result[12]\ : MX2
      port map(A => Data0_port(12), B => Data1_port(12), S => 
        \SelAux_0[10]\, Y => Result(12));
    

end DEF_ARCH; 

-- _Disclaimer: Please leave the following comments in the file, they are for internal purposes only._


-- _GEN_File_Contents_

-- Version:10.0.20.2
-- ACTGENU_CALL:1
-- BATCH:T
-- FAM:PA3SOC2
-- OUTFORMAT:VHDL
-- LPMTYPE:LPM_MUX
-- LPM_HINT:None
-- INSERT_PAD:NO
-- INSERT_IOREG:NO
-- GEN_BHV_VHDL_VAL:F
-- GEN_BHV_VERILOG_VAL:F
-- MGNTIMER:F
-- MGNCMPL:T
-- DESDIR:D:/Work/marmote/firmware/MainBoard/StreamingReceiver_RF/smartgen\AFE_mux
-- GEN_BEHV_MODULE:F
-- SMARTGEN_DIE:IP6X5M2
-- SMARTGEN_PACKAGE:fg256
-- AGENIII_IS_SUBPROJECT_LIBERO:T
-- WIDTH:20
-- SIZE:2
-- SEL0_FANIN:AUTO
-- SEL0_VAL:6
-- SEL0_POLARITY:1
-- SEL1_FANIN:AUTO
-- SEL1_VAL:6
-- SEL1_POLARITY:2
-- SEL2_FANIN:AUTO
-- SEL2_VAL:6
-- SEL2_POLARITY:2
-- SEL3_FANIN:AUTO
-- SEL3_VAL:6
-- SEL3_POLARITY:2
-- SEL4_FANIN:AUTO
-- SEL4_VAL:6
-- SEL4_POLARITY:2

-- _End_Comments_
