marmote/marmote/firmware/MainBoard/StreamingReceiver_RF/designer/impl1/StreamingReceiver_RF_ba.vhd

-- Version: 10.0 SP2 10.0.20.2
-- File used only for Simulation

library ieee;
use ieee.std_logic_1164.all;
library smartfusion;
use smartfusion.all;

entity StreamingReceiver_RF is

    port( SPI_1_DO        : out   std_logic;
          SPI_1_SS        : inout std_logic := 'Z';
          SPI_1_CLK       : inout std_logic := 'Z';
          SPI_1_DI        : in    std_logic;
          MSS_RESET_N     : in    std_logic;
          RXTX            : out   std_logic;
          ANTSEL          : out   std_logic;
          RXHP            : out   std_logic;
          nSHDN           : out   std_logic;
          LD              : in    std_logic;
          MAINXIN         : in    std_logic;
          AFE2_CLK_pin    : out   std_logic;
          AFE2_SHDN_n_pin : out   std_logic;
          AFE2_T_R_n_pin  : out   std_logic;
          USB_CLK_pin     : in    std_logic;
          USB_TXE_n_pin   : in    std_logic;
          USB_WR_n_pin    : out   std_logic;
          USB_OE_n_pin    : out   std_logic;
          USB_RD_n_pin    : out   std_logic;
          USB_SIWU_N      : out   std_logic;
          USB_RXF_n_pin   : in    std_logic;
          DATA_pin        : inout std_logic_vector(9 downto 0) := (others => 'Z');
          USB_DATA_pin    : inout std_logic_vector(7 downto 0) := (others => 'Z')
        );

end StreamingReceiver_RF;

architecture DEF_ARCH of StreamingReceiver_RF is 

  component OA1C
    port( A : in    std_logic := 'U';
          B : in    std_logic := 'U';
          C : in    std_logic := 'U';
          Y : out   std_logic
        );
  end component;

  component MSS_IF
    port( PIN4    : in    std_logic := 'U';
          PIN5    : in    std_logic := 'U';
          PIN6    : in    std_logic := 'U';
          PIN1    : out   std_logic;
          PIN2    : out   std_logic;
          PIN3    : out   std_logic;
          PIN4INT : out   std_logic;
          PIN5INT : out   std_logic;
          PIN6INT : out   std_logic;
          PIN1INT : in    std_logic := 'U';
          PIN2INT : in    std_logic := 'U';
          PIN3INT : in    std_logic := 'U'
        );
  end component;

  component NOR2B
    port( A : in    std_logic := 'U';
          B : in    std_logic := 'U';
          Y : out   std_logic
        );
  end component;

  component IOPAD_BI
    port( D   : in    std_logic := 'U';
          E   : in    std_logic := 'U';
          Y   : out   std_logic;
          PAD : inout   std_logic
        );
  end component;

  component DFN1C0
    port( D   : in    std_logic := 'U';
          CLK : in    std_logic := 'U';
          CLR : in    std_logic := 'U';
          Q   : out   std_logic
        );
  end component;

  component MX2
    port( A : in    std_logic := 'U';
          B : in    std_logic := 'U';
          S : in    std_logic := 'U';
          Y : out   std_logic
        );
  end component;

  component NOR2
    port( A : in    std_logic := 'U';
          B : in    std_logic := 'U';
          Y : out   std_logic
        );
  end component;

  component DFN1E1
    port( D   : in    std_logic := 'U';
          CLK : in    std_logic := 'U';
          E   : in    std_logic := 'U';
          Q   : out   std_logic
        );
  end component;

  component NOR3C
    port( A : in    std_logic := 'U';
          B : in    std_logic := 'U';
          C : in    std_logic := 'U';
          Y : out   std_logic
        );
  end component;

  component AX1C
    port( A : in    std_logic := 'U';
          B : in    std_logic := 'U';
          C : in    std_logic := 'U';
          Y : out   std_logic
        );
  end component;

  component XOR2
    port( A : in    std_logic := 'U';
          B : in    std_logic := 'U';
          Y : out   std_logic
        );
  end component;

  component AO1D
    port( A : in    std_logic := 'U';
          B : in    std_logic := 'U';
          C : in    std_logic := 'U';
          Y : out   std_logic
        );
  end component;

  component AOI1
    port( A : in    std_logic := 'U';
          B : in    std_logic := 'U';
          C : in    std_logic := 'U';
          Y : out   std_logic
        );
  end component;

  component IOTRI_OB_EB
    port( D    : in    std_logic := 'U';
          E    : in    std_logic := 'U';
          DOUT : out   std_logic;
          EOUT : out   std_logic
        );
  end component;

  component OA1A
    port( A : in    std_logic := 'U';
          B : in    std_logic := 'U';
          C : in    std_logic := 'U';
          Y : out   std_logic
        );
  end component;

  component AND2A
    port( A : in    std_logic := 'U';
          B : in    std_logic := 'U';
          Y : out   std_logic
        );
  end component;

  component INV
    port( A : in    std_logic := 'U';
          Y : out   std_logic
        );
  end component;

  component AND2
    port( A : in    std_logic := 'U';
          B : in    std_logic := 'U';
          Y : out   std_logic
        );
  end component;

  component OR2A
    port( A : in    std_logic := 'U';
          B : in    std_logic := 'U';
          Y : out   std_logic
        );
  end component;

  component AO1B
    port( A : in    std_logic := 'U';
          B : in    std_logic := 'U';
          C : in    std_logic := 'U';
          Y : out   std_logic
        );
  end component;

  component XA1
    port( A : in    std_logic := 'U';
          B : in    std_logic := 'U';
          C : in    std_logic := 'U';
          Y : out   std_logic
        );
  end component;

  component OR2B
    port( A : in    std_logic := 'U';
          B : in    std_logic := 'U';
          Y : out   std_logic
        );
  end component;

  component NOR2A
    port( A : in    std_logic := 'U';
          B : in    std_logic := 'U';
          Y : out   std_logic
        );
  end component;

  component IOBI_IRE_OB_EB
    port( D    : in    std_logic := 'U';
          E    : in    std_logic := 'U';
          ICE  : in    std_logic := 'U';
          ICLK : in    std_logic := 'U';
          YIN  : in    std_logic := 'U';
          DOUT : out   std_logic;
          EOUT : out   std_logic;
          Y    : out   std_logic
        );
  end component;

  component NOR3A
    port( A : in    std_logic := 'U';
          B : in    std_logic := 'U';
          C : in    std_logic := 'U';
          Y : out   std_logic
        );
  end component;
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
