marmote/marmote/(commit log)

2010-09-16 Initial commit of AD/DA card codename "BeaverBoard" connecting USRP RF cards and the SmartFusion evaluation board.
    USRP:
    http://en.wikipedia.org/wiki/USRP
    http://code.ettus.com/redmine/ettus/projects/public/documents
    SmartFusion:
    http://www.actel.com/products/hardware/devkits_boards/smartfusion_eval.aspx
    [BeaverBoard.brd, BeaverBoard.sch]
2010-12-06 - Digital to Analog conversion added (datasheets, various simulations) - Schematics updated - Basic layout - 0603 resistors - Most pins connected
    [BeaverBoard.brd, BeaverBoard.sch, Connectors.xls]
2010-12-14 - Power - 4 layer - GND, supply polygon
    [BeaverBoard.brd, BeaverBoard.sch]
2011-01-25 - New LDO - Schematic almost done
    [BeaverBoard.brd, BeaverBoard.sch]
2011-01-28 - Schematic done - Lib cleaned up
    [BeaverBoard.brd, BeaverBoard.sch]
2011-02-03 - Some routing - Minimal changes in schematic
    [BeaverBoard.brd, BeaverBoard.sch]
2011-02-04 Initial check-in with several library components and an empty schematic.
    [PowerBoard.brd, PowerBoard.sch]
2011-02-04 - Routing - first draft
    [BeaverBoard.brd, BeaverBoard.sch]
2011-02-04 Schematic update:
    5V wall adapter protection circuit (added)
    Library update:
    NMOSSOT23 (added)
    PMOSSOT23 (added)
    ZENER-DIODE (added)
    [PowerBoard.brd, PowerBoard.sch]
2011-02-05 Schematic update:
    USB and BAT interfaces (ADDED)
    [PowerBoard.brd, PowerBoard.sch]
2011-02-08 Added NTC and LDO circuits BUCK almost finished
    [PowerBoard.sch]
2011-02-08 Added simulations for Battery Charger and Reverse Voltage Protection
2011-02-09 Added BUCK3 adjustable feedback.
    [PowerBoard.sch]
2011-02-09 Adding current sense circuits (NOT finished yet)
    [PowerBoard.sch]
2011-02-11 Added all current sense circuits
    [PowerBoard.sch]
2011-02-15 Layout modifications
    [BeaverBoard.brd, BeaverBoard.sch]
2011-02-16 - LEDs on power supply - ISIS logo :) - Resistors rotated at opamp - 6 mil wires at 100 pin connector - Supply voltages on silk screen - Officially named Rev A
    [BeaverBoard.brd, BeaverBoard.sch, LEDs.xls]
2011-02-16 - JP6 instead of JP3 - 0805 -> 0603
    [BeaverBoard.brd, BeaverBoard.sch]
2011-02-17 - BOM - Minimal changes in resistor/capacitor values - LDO datasheet renamed
    [BeaverBoard.brd, BeaverBoard.sch, BeaverBoard_bom.xls]
2011-02-17 - B4 Do not assemble
    [BeaverBoard.brd, BeaverBoard.sch, BeaverBoard_bom.xls]
2011-02-17 - CAM
    [BeaverBoard.GBL, BeaverBoard.GBO, BeaverBoard.GBS, BeaverBoard.GTL, BeaverBoard.GTO, BeaverBoard.GTP, BeaverBoard.GTS]
2011-02-18 Creating revision A
    [BeaverBoard_RevA.GBL, BeaverBoard_RevA.GBO, BeaverBoard_RevA.GBP, BeaverBoard_RevA.GBS, BeaverBoard_RevA.GTL, BeaverBoard_RevA.GTO, BeaverBoard_RevA.GTP, BeaverBoard_RevA.GTS]
2011-03-18 All STM32 pins assigned. Applying changes on schematic.
    [PowerBoard.sch, STM32F10x Pin Assignment.xlsx]
2011-03-24 Added 'Cover Page'.
    [PowerBoard.sch]
2011-03-24 Minor schematic touch-ups.
    [PowerBoard.brd, PowerBoard.sch]
2011-03-25 Checking schematic (not finished yet).
    [PowerBoard.sch]
2011-03-28 Schematic checked.
    [Connector Bus Signals.xlsx, PowerBoard.sch]
2011-03-28 Backup before updating supply symbols.
    [PowerBoard.sch, STM32F10x Pin Assignment.xlsx]
2011-03-29 - Polarization added for: LED6, LED2P5, LED3P3, LED5, C31, C32, C33, C41, C106, C116, C119 - C41, C42 labels switched
    [BeaverBoard.brd]
2011-03-29 - Previous changes also in RevA
    [BeaverBoard_RevA.brd]
2011-03-31 Minor library updates.
    [PowerBoard.brd, PowerBoard.sch]
2011-03-31 Schematic cleanup.
    [PowerBoard.sch]
2011-04-01 LDO1 and LOD2 feedback fixed (schematic bug fixed)
    [PowerBoard.brd, PowerBoard.sch]
2011-04-01 Crystals routed.
    [PowerBoard.brd, PowerBoard.sch]
2011-04-01 ADC pin assignment updated.
    [PowerBoard.brd, STM32F10x Pin Assignment.xlsx]
2011-04-04 I2C1, SPI1, SPI2 and SWD connector routed.
    [PowerBoard.brd, PowerBoard.sch]
2011-04-04 All STM32 pins routed.
    [PowerBoard.brd]
2011-04-05 Power lines routed.
    [PowerBoard.brd]
2011-04-05 Backup before rearranging BUCK1 external components.
    [PowerBoard.brd]
2011-04-06 PWR_ON input cleaned up on schematic.
    [PowerBoard.brd, PowerBoard.sch]
2011-04-06 LTC3677 capacitors routed.
    [PowerBoard.brd, PowerBoard.sch]
2011-04-06 Analog ground planes added.
    [PowerBoard.brd]
2011-04-14 Schematic cleanup performed
    [PowerBoard.brd, PowerBoard.sch]
2011-04-15 Final check-in before switching to LTC4085 instead of LTC3677
    [PowerBoard.brd, PowerBoard.sch]
2011-04-19 Added components LTC4361 and LTC4085.
    [PowerBoard.brd, PowerBoard.sch]
2011-04-20 Power supply schematic sketched (pull-ups, pull-downs and capacitors missing, components need to be checked).
    [PowerBoard.brd, PowerBoard.sch]
2011-04-22 Reverse voltage, over voltage, reverse current protection and ideal diode transistors checked.
    [PowerBoard.brd, PowerBoard.sch]
2011-04-22 Transistors drawn and checked.
    [PowerBoard.brd, PowerBoard.sch, STM32F10x Pin Assignment.xlsx]
2011-04-25 LTC4361 pin connections checked.
    [PowerBoard.brd, PowerBoard.sch]
2011-04-25 Power supply page checked.
    [PowerBoard.brd, PowerBoard.sch]
2011-04-25 Minor schematic touch up.
    [PowerBoard.brd, PowerBoard.sch]
2011-04-26 STM32 and connector signals checked on schematic.
    [PowerBoard.sch]
2011-04-26 USBLC6-2 touch-up.
    [PowerBoard.brd, PowerBoard.sch]
2011-04-26 USBLC6-2 updated in library.
    [PowerBoard.sch]
2011-04-26 Minor schematic frame touch ups.
    [PowerBoard.sch]
2011-04-27 Updated part names and replaced USB ESD protection.
    [PowerBoard.brd, PowerBoard.sch]
2011-04-28 Added an alternate D1V5/A1V5 chip enable signal.
    [PowerBoard.brd, PowerBoard.sch]
2011-05-02 Added component XC9236 to library. Replaced XC6221 LDO with XC9236 1.2MHz switching regulator.
    [PowerBoard.brd, PowerBoard.sch]
2011-05-03 - Initial commit for projects - lwIP library IP stack project added for SmartFusion
    [_vhdl.psm, body.psm, rtl.psm, verilog.psm]
2011-05-03 Added PJ-051A (2.1mm DC jack) and RJ45 placeholder to library.
    [PowerBoard.brd, PowerBoard.sch]
2011-05-03 Adjusting board size and placing standouts and connectors.
    [PowerBoard.brd, PowerBoard.sch]
2011-05-04 Added reserved power slots to SmartFusion connector. Rip-up, placement and route in progress.
    [Connector Bus Signals.xlsx, PowerBoard.brd, PowerBoard.sch]
2011-05-04 Components roughly placed.
    [PowerBoard.brd, PowerBoard.sch]
2011-05-05 All components placed, sense wires routed.
    [PowerBoard.brd, PowerBoard.sch]
2011-05-05 Power rails routed.
    [PowerBoard.brd]
2011-05-05 LTC 4085 routed.
    [PowerBoard.brd, PowerBoard.sch]
2011-05-05 Sheet #1 routed.
    [PowerBoard.brd]
2011-05-06 SPI2 and I2C2 routed.
    [PowerBoard.brd]
2011-05-06 FTSH connector GIPOs routed.
    [PowerBoard.brd, PowerBoard.sch]
2011-05-06 All STM signals routed.
    [PowerBoard.brd, PowerBoard.sch]
2011-05-09 Added SPST switch with raster 2-pin jumper footprint.
    [PowerBoard.brd, PowerBoard.sch]
2011-05-09 Added power switch to library and PCB.
    [PowerBoard.brd, PowerBoard.sch]
2011-05-10 Added slider switch.
    [PowerBoard.brd, PowerBoard.sch]
2011-05-10 All airwires routed. Several DRC errors still exist.
    [PowerBoard.brd]
2011-05-10 - lwIP 1.4.0 rc2 project added (DHCP not working!)
    [conf_eth.h, cpu_types.h, lwipopts.h, main.c]
2011-05-10 - Projects added for ADC SPI interface and ADC SPI interface with DMA
    [_vhdl.psm, bfma1i10i.psm, bfma1io1ol.psm, body.psm, rtl.psm, tb.psm, verilog.psm]
2011-05-10 Added DGND and AGND vias.
    [PowerBoard.brd]
2011-05-11 D3V3_STM current sense reorganized.
    [PowerBoard.brd, PowerBoard.sch]
2011-05-11 Crystals shielded.
    [PowerBoard.brd]
2011-05-11 Ground planes adjusted.
    [PowerBoard.brd]
2011-05-12 LTC2942 fixed and checked.
    [PowerBoard.brd, PowerBoard.sch]
2011-05-12 Some DRC errors fixed.
    [PowerBoard.brd, PowerBoard.sch]
2011-05-12 USBLC6 schematic fixed.
    [PowerBoard.brd, PowerBoard.sch]
2011-05-12 DRC check passed with certain approvals.
    [PowerBoard.brd, PowerBoard.sch]
2011-05-12 IC layout checked for ECX-32B, ECX-2236, LTC2942, MAX9938FEUK.
    [PowerBoard.brd, PowerBoard.sch]
2011-05-13 Updating MIC9404 switch.
    [PowerBoard.brd, PowerBoard.sch]
2011-05-13 SOT25 footprint according to Torex.
2011-05-13 Torex regulators checked.
    [PowerBoard.brd, PowerBoard.sch]
2011-05-13 MOSFETs checked. Si23XX device errors (improperly connected pads) corrected.
2011-05-13 Added right angle diodes.
    [PowerBoard.brd, PowerBoard.sch]
2011-05-14 LEDs replaced on the board.
    [PowerBoard.brd, PowerBoard.sch]
2011-05-16 All components checked along with their connections.
    [PowerBoard.brd, PowerBoard.sch]
2011-05-16 Default BOOT mode set to FLASH (BOOT0 pull-up changed to pull-down).
    [PowerBoard.brd, PowerBoard.sch]
2011-05-16 All labels placed (positions to be finalized after logo placement).
    [PowerBoard.brd, PowerBoard.sch]
2011-05-16 LED labels fixed.
    [PowerBoard.brd]
2011-05-17 - Streaming samples from ADC to network
    WARNING!!! WINDOWS 7 HAS A BUILT IN "DELAYED ACK" FEATURE THAT PREVENTS FAST STREAMING!!!
    The feature has to be turned of for effective streaming. With delayed ACK Win 7 will only send
    TCP ACK messages every 200 ms.
    http://windows7themes.net/how-to-improve-latency-in-wow-in-windows-7.html
    1. Open up the registry:
    Run regedit.exe as administrator.
    2. Uncollapse the following entry:
    [HKEY_LOCAL_MACHINE\SYSTEM\CurrentControlSet\services\Tcpip\Parameters\Interfaces]
    3. You will probably find several “subfolders”. Click through each folder until you find
    the one with the most entries in the right pane. The right interface will have many entri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
    [_vhdl.psm, behavioral.psm, bench.psm, bfma1i10i.psm, bfma1io1ol.psm, body.psm, def_arch.psm, rtl.psm]
2011-05-18 Isolation, fiducials and charge time related components updated.
    [PowerBoard.brd, PowerBoard.sch]
2011-05-18 Main logos updated.
    [PowerBoard.brd, PowerBoard.sch]
2011-05-18 - byte endianness of samples changed - Simulation added for LFRX+BeaverBoard
2011-05-18 Adjusting board to Sunstone design rules. (Dead end, reverting to original DRCs.)
    [PowerBoard.brd, PowerBoard.sch]
2011-05-18 Still processing BOM and updating library.
    [PowerBoard.brd, PowerBoard.sch, PowerBoard_BOM.xlsx]
2011-05-19 BOM finished.
    [PowerBoard_BOM.xlsx]
2011-05-19 Minor schematic, library and logo updates.
    [PowerBoard.brd, PowerBoard.sch, PowerBoard_BOM.xlsx]
2011-05-19 Added tRestrict regions to logos.
    [PowerBoard.brd, PowerBoard.sch]
2011-05-19 Gerber, drill and schematic files added. (Assembly file is not checked-in yet.)
    [PowerBoard.GBL, PowerBoard.GBO, PowerBoard.GBP, PowerBoard.GBS, PowerBoard.GTL, PowerBoard.GTO, PowerBoard.GTP, PowerBoard.GTS]
2011-05-19 All silk screen texts converted to vector font.
    [PowerBoard.brd, PowerBoard.sch]
2011-05-19 A final revision of the entire CAM directory is needed.
    All drill sizes are larger than 8 mil.
    [PowerBoard.GBL, PowerBoard.GBO, PowerBoard.GBP, PowerBoard.GBS, PowerBoard.GTL, PowerBoard.GTO, PowerBoard.GTP, PowerBoard.GTS]
2011-05-23 Main Board initial check-in.
    [A2F500 FT256 Pinout.xlsx, MainBoard.sch]
2011-05-23 SmartFusion (FG256) device roughly organized in library.
2011-05-24 -SmartFusion device roughly organized into separate blocks (symbols) -Pinout checked against BSDL file and datasheet -Pin names reflect names in BSDL file (i.e. I/O pins are named IO_<FBGA pin name>)
    [A2F500 FT256 Pinout.xlsx]
2011-05-24 -All EAGLE SmartFusion device pin names follow the datasheet nomenclature (double-checked) -Main block organization follows SmartFusion EVAL/DEV board schematic
    [A2F500 FT256 Pinout.xlsx]
2011-05-24 Added Cypress SRAM to library.
    [MainBoard.sch]
2011-05-25 Re-exported and updated Vanderbilt logo.
    [MainBoard.sch]
2011-05-25 Battery logo updated. Library cleaned up.
2011-05-26 - DAC initial commit - SoftConsole projects missing files added
    [_vhdl.psm, bfma1i10i.psm, bfma1io1ol.psm, body.psm, rtl.psm, tb.psm, verilog.psm]
2011-05-26 Preliminary block diagram for Main Board Rev A.
2011-05-26 Power Board block diagram (initial version).
2011-06-01 - DAC project updates
    [_vhdl.psm]
2011-06-02 - ADC
2011-06-13 - ADC, DAC
2011-07-15 Library and BOM entries corrected for USBLC6-2 device (from SOT-666 to SOT23-6L)
    [PowerBoard_BOM.xlsx]
2011-07-21 - CORDIC based sin/cos generator - ADC interface - inital DDC project
    [_vhdl.psm, behavioral.psm, bench.psm, body.psm, def_arch.psm, rtl.psm, translated.psm, verilog.psm]
2011-08-22 - CIC
    [_vhdl.psm, behavioral.psm, bench.psm, body.psm, def_arch.psm, rtl.psm, verilog.psm]
2011-09-02 - CIC with SRAM storage implemented
    [_vhdl.psm, behavioral.psm, bench.psm, body.psm, def_arch.psm, rtl.psm, verilog.psm]
2011-09-13 - New CIC with integrator stage in fabric and comb section in block RAM - DDC project upgraded, only unsigned signals now
    [_vhdl.psm, body.psm, rtl.psm, verilog.psm]
2011-09-16 - New CIC implementation using block RAM and High/Low memory access
    [_vhdl.psm, body.psm, rtl.psm, verilog.psm]
2011-09-29 - FIR filter using block RAM
    [_vhdl.psm, body.psm, rtl.psm, verilog.psm]
2011-10-06 - IP stack project updated with manual UDP frame creation and LEDs
2011-10-07 - reorganizing projects...
    [_vhdl.psm, behavioral.psm, bench.psm, body.psm, def_arch.psm, rtl.psm, verilog.psm]
2011-10-15 - DDC
    [_vhdl.psm, behavioral.psm, bench.psm, bfma1i10i.psm, bfma1io1ol.psm, body.psm, def_arch.psm, rtl.psm]
2011-10-15 - DDC/DecimationFilter missing files
    [common.vhd]
2011-10-20 - DDC with 32 bit wide samples implemented
    [_vhdl.psm, behavioral.psm, bench.psm, body.psm, def_arch.psm]
2011-10-21 - DDC minor changes, reset signal corrected
    [coreparameters.vhd, testbench.vhd, top.vhd]
2011-10-21 - Measurement pictures for Voltage Current Converter (Volgyesi bridge) - Pictures of Beaver Board rev A - Block diagrams for DDC
2011-10-21 - CIC characteristic for Matlab - CIC comb stage project temporarily added
    [_vhdl.psm, behavioral.psm, bench.psm, body.psm, def_arch.psm]
2011-10-21 - CIC comb project folder renamed
    [_vhdl.psm, behavioral.psm, bench.psm, body.psm, def_arch.psm]
2011-10-27 - ADC_SPI_DMA_IPstack project 100MHz clock and twice the buffer size (128 samples) - DDC_test project decimation down to 4 - DDC_test project samples represented in signed numbers - DDC_test project 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
    [_vhdl.psm, behavioral.psm, bench.psm, body.psm, def_arch.psm]
2011-10-28 - DDC_test Matlab model (32-bit output) - DDC_test 16 bit signed output
    [_vhdl.psm, behavioral.psm, bench.psm, body.psm, rtl.psm, verilog.psm]
2011-11-01 uVision4 project files for testing the clock, reset, peripherals, etc. of the Cortex M3 on the 'Power Board'.
    [main.c]
2011-11-02 Added a new component to the library (for bottom use). Moved the connector to the bottom. Renamed the connectors.
    [BreakoutBoard.brd, BreakoutBoard.sch]
2011-11-02 Broke the breakout raster pins into 4x 2x16.
    [BreakoutBoard.brd, BreakoutBoard.sch]
2011-11-02 Added test points for AGND and DGND.
    [BreakoutBoard.brd, BreakoutBoard.sch]
2011-11-03 Added .dru file and routed the design.
    [BreakoutBoard.brd]
2011-11-03 Added a BOM file.
    [BreakoutBoard_BOM.xlsx]
2011-11-03 Routed the breakout board in one layer.
    -This was supposed to be the first step to have it routed in 2-layers
    -The Mezzazine connector outer signals cannot be routed with only two layers (at least 3 layers are needed)
    -Fixed the bottom Mezzazine connections (unconnected pins in schematic)
    [BreakoutBoard.brd, BreakoutBoard.sch]
2011-11-03 -Selected components for 13mm mated stacking height -Fixed the lower mezzanine connector (replaced with receptacle) -Updated BOM file and added standoffs
    [BreakoutBoard.brd, BreakoutBoard.sch, BreakoutBoard_BOM.xlsx]
2011-11-03 - DDC testbench with file input generated in Matlab
    [_vhdl.psm, behavioral.psm, bench.psm, bfma1i10i.psm, bfma1io1ol.psm, body.psm, def_arch.psm, tb.psm]
2011-11-03 LEDs tested and their basic functions written.
2011-11-04 Created and tested the basic power management related functions.
2011-11-05 Tested I2C1 transmit (w/ handling ACK errors as there is no real peripheral to respond now).
    [main.c]
2011-11-05 Working on battery gauge I2C - NOT finished. (Don't use this version.)
2011-11-07 I2C2 lines tested as open-drain GPIOs.
2011-11-07 Still debugging I2C2 communication (ADDR bit does not get set after address transmission and ACK reception).
2011-11-08 Master switch GPIO tested with R=0 not populated (e.g. it does not actually control the power rails)
2011-11-08 Added a trimmer to library.
    [BreakoutBoard.brd, BreakoutBoard.sch]
2011-11-08 Still debugging I2C2 (battery gauge), where both SCK and SDA get stuck to GND occasionally.
    [main.c]
2011-11-08 Tested SPI2 (SD card) signals with scope. (No real SD card was inserted in the slot.)
2011-11-08 Backup before replacing jumpers with 0 Ohm resistors.
    [BreakoutBoard.brd, BreakoutBoard.sch]
2011-11-08 Placed 80% of components.
    [BreakoutBoard.brd, BreakoutBoard.sch]
2011-11-09 Battery gauge register read is working (files need cleanup).
2011-11-09 Battery gauge register read is working (files cleaned up).
2011-11-09 Backup before implementing 16-bit register R/W commands over I2C (battery gauge).
2011-11-09 Implemented 16-bit register write on I2C (battery gauge).
2011-11-09 Battery gauge ADC for voltage and temperature measurement tested. (Both return 'constants', however, with reasonable constants (4.2V and 302K (29C).
2011-11-10 Halfway with routing.
    [BreakoutBoard.brd, BreakoutBoard.sch]
2011-11-10 Updated BOM and added new datasheets.
    [BreakoutBoard_BOM.xlsx]
2011-11-10 Updated logos and schematic cover page.
    [BreakoutBoard.brd, BreakoutBoard.sch]
2011-11-11 Fixed battery gauge I2C 16-bit register read (master ACK was missing).
    [main.c]
2011-11-14 Added USB related library items. Implemented a timer based LED blink to get familiar with NVIC.
2011-11-15 Enumeration works with STM32 Virtual COM Port driver.
    -CDC console doesn't work yet
    -The code is based on ST's Virtual COM Port example
    -The code needs restructuring and clean-up
    [main.c]
2011-11-16 Fixed the ECHO functionality.
    [main.c]
2011-11-17 - Inital RFX400 support - lwIP timer defined as volatile
    [_vhdl.psm, bfma1i10i.psm, bfma1io1ol.psm, body.psm, rtl.psm, tb.psm, verilog.psm]
2011-11-17 Cleaned up LED-related functions and definitions in power_monitor.
2011-11-17 Battery gauge voltage and temperature monitor demo through USB VCP.
2011-11-17 Component power_monitor cleaned up.
2011-11-18 - DMA was 1 sample shorter then buffer, corrected - RF frequency, DDC frequency, and DDC shift can now be controlled through the network
    [coreparameters.vhd, main.c, testbench.vhd, top.vhd]
2011-11-18 Component power_control cleaned up and re-tested: !PWRGD line stays low after disconnecting WALL if USB is on.
2011-11-18 - DC correction added - Matlab scripts better UDP handling - Figured out that the input channels had to be switched (I <-> Q) to work with RFX400
    [_vhdl.psm]
2011-11-18 Initial check-in. Porting STM32 example design to Power Board.
2011-11-18 Board configured as an AudioDevice (speaker so far).
2011-11-21 Added USB_SendMsg() for simpler printing on VCP.
2011-11-22 Fixed the Device Descriptor.
    [main.c]
2011-11-23 - UDP flow control implemented in SmartFusion code - New Matlab UDP viewer using flow control - Minor bugs fixed in SmartFusion code
    [coreparameters.vhd, main.c, testbench.vhd, top.vhd]
2011-11-25 Audio Streaming with test mode (constant and counter in the TX buffers). Fixed issue with USB buffer (SRAM) allocation.
    Note: This version works at 48 kHz / 16-bit mono only.
    [main.c]
2011-11-25 Implemented a (in primitive way) to stream a 1 kHz sine wave sampled at 48 kHz.
2011-11-28 Added GERBER files and assembly drawing .pdf.
    [BreakoutBoard.GBL, BreakoutBoard.GBO, BreakoutBoard.GBP, BreakoutBoard.GBS, BreakoutBoard.GTL, BreakoutBoard.GTO, BreakoutBoard.GTP, BreakoutBoard.GTS]
2011-11-29 Updated the design rules:
    -6 mil trace width/distance (from 4 mil)
    -12 mil minimum drill size
    [BreakoutBoard.brd]
2011-11-29 Updated some text fields on the board and the schematic.
    [BreakoutBoard.brd, BreakoutBoard.sch]
2011-11-29 Updated the 10-pin header (device) and the top side ground layer boundaries (logo).
    [BreakoutBoard.brd, BreakoutBoard.sch]
2011-11-29 Removed the 0 Ohm resistors from near the JTAG connector.
    [BreakoutBoard.brd, BreakoutBoard.sch]
2011-11-29 Replaced the 0 Ohm resistors around the JTAG connector.
    Purpose: allows for late fixation of the JTAG pin assignments.
    [BreakoutBoard.brd, BreakoutBoard.sch]
2011-11-29 Minor fixes on DRC and ERC errors.
    [BreakoutBoard.brd, BreakoutBoard.sch]
2011-11-29 Updated the CAM files.
    [BreakoutBoard.GBL, BreakoutBoard.GBO, BreakoutBoard.GBP, BreakoutBoard.GBS, BreakoutBoard.GTL, BreakoutBoard.GTO, BreakoutBoard.GTS]
2011-12-01 Updated the BOM file.
    [BreakoutBoard_BOM.xlsx]
2011-12-01 Renamed some resistors.
    [BreakoutBoard.brd, BreakoutBoard.sch]
2011-12-01 - Control for RF gain and antenna switches was added for the RFX400 - Matlab GUI improved
2011-12-01 Updated pinout descriptions (mainly) for grounds.
    [A2F500 FT256 Pinout.xlsx]
2011-12-02 Updated connector names and BOM file.
    [BreakoutBoard.brd, BreakoutBoard.sch, BreakoutBoard_BOM.xlsx]
2011-12-06 Added a sketch of the 'North Bridge' mezzanine connector pinout.
    [A2F500 FT256 Pinout.xlsx, Connector Bus Signals.xlsx]
2011-12-07 Renamed 'application' main folder to 'firmware'.
    [USB Memory Map.xlsx]
2011-12-08 - Initial Wide-Band Radio Front-End board commit
    [RFWBBoard.brd, RFWBBoard.sch]
2011-12-09 - MAX2830 component added
    [RFWBBoard.brd, RFWBBoard.sch]
2011-12-09 - Added batch file to save samples from UDP - Folder structure rearranged
2011-12-12 Added power rail block diagrams.
2011-12-12 Worked on pinout assignment and converted project into Eagle v6 format.
    [A2F500 FT256 Pinout.xlsx, Connector Bus Signals.xlsx, MainBoard.sch]
2011-12-12 - BreakoutBoard, PowerBoard, RFWBBoard project files updated to Eagle 6.0.0
    [BreakoutBoard.brd, BreakoutBoard.sch, PowerBoard.brd, PowerBoard.sch, RFWBBoard.brd, RFWBBoard.sch]
2011-12-12 Added SMA connector to library.
2011-12-12 - 2.4 GHz Wide-Band Radio Front-End Board has most of the components
    [RFWBBoard.brd, RFWBBoard.sch]
2011-12-13 Library touch-up and basic placement on PCB.
    [MainBoard.sch]
2011-12-13 Updated the Mezzanine connectors in the Eagle library.
    [MainBoard.sch]
2011-12-13 - All caps for MAX2830 - Corrected 84-pin connector
    [RFWBBoard.brd, RFWBBoard.sch]
2011-12-13 Updated pinout spreadsheet and added Ethernet Phy device to library.
    [Connector Bus Signals.xlsx, MainBoard.sch]
2011-12-13 Finalized upper connector (North Bridge) high-speed analog (ADC and DAC) signal pinout.
    [Connector Bus Signals.xlsx, MainBoard.sch]
2011-12-14 - RFWBboard layout changed
    [RFWBBoard.brd, RFWBBoard.sch]
2011-12-14 - Second MAX2830 - I2C EEPROM and address selector switch - GND layers
    [RFWBBoard.brd, RFWBBoard.sch]
2011-12-14 Added oscillator and crystal components to library and updated 'Clocks' sheet on schematic.
    [MainBoard.sch]
2011-12-15 - Started routing the MAX2830
    [RFWBBoard.brd, RFWBBoard.sch]
2011-12-16 - Wide Band RF board routing with DRC check
    [RFWBBoard.brd, RFWBBoard.sch]
2011-12-19 - Second MAX2830 removed from RFWBboard - Baseband connections added with AD8132
    [RFWBBoard.brd, RFWBBoard.sch]
2011-12-29 - RF board routing updated
    [RFWBBoard.brd]
2011-12-29 - Supply under the IC
    [RFWBBoard.brd]
2011-12-30 - Routing finished for MAX2830
    [RFWBBoard.brd]
2012-01-03 - Matched impedance wires for antennas (14 mil -> 50 Ohm) - Baseband for DAC and DAC
    [RFWBBoard.brd, RFWBBoard.sch]
2012-01-05 - Routing done for RF board
    [RFWBBoard.brd, RFWBBoard.sch]
2012-01-05 RF board - schematic cleaned up - component names changed - routing done - silk screen done - logos still missing
    [RFWBBoard.brd, RFWBBoard.sch]
2012-01-06 - Some GND vias added...
    [RFWBBoard.brd]
2012-01-06 - Added info text on bottom
    [RFWBBoard.brd, RFWBBoard.sch]
2012-01-06 - Silk screen corrected
    [RFWBBoard.brd]
2012-01-06 - Silk screen updated - Ground under DAC pins at MAX2830
    [RFWBBoard.brd, RFWBBoard.sch]
2012-01-09 Minor updates on schematic (clocking).
    [MainBoard.sch]
2012-01-10 Clock signals checked in datasheet and Libero, and added to schematic with the exception of the ADC clocks.
    [A2F500 FT256 Pinout.xlsx, MainBoard.sch]
2012-01-10 Updated the FRAME-LETTER device copyright information and copied device to MainBoard Eagle library.
    [MainBoard.sch]
2012-01-11 - routing changes for digital logic - different design rules - via sizes increased - schematic updated
    [RFWBBoard.brd, RFWBBoard.sch]
2012-01-11 - Schematic verifier updated
    [RFWBBoard.sch]
2012-01-11 - Bill of Materials
    [RFWBBoard_BOM.xls]
2012-01-12 Connected the external analog front-ends (MAX19706) in schematic.
    -Auxiliary ADCs/DACs are not connected yet
    -FPGA-MAX19706 connections are not final
    [A2F500 FT256 Pinout.xlsx, Connector Bus Signals.xlsx, MainBoard.sch]
2012-01-12 Created copy for BreakoutBoard Rev A.
    [BreakoutBoard.GBL, BreakoutBoard.GBO, BreakoutBoard.GBP, BreakoutBoard.GBS, BreakoutBoard.GTL, BreakoutBoard.GTO, BreakoutBoard.GTP, BreakoutBoard.GTS]
2012-01-12 Updated file names with _RevA suffix and exported schematic as pdf.
    [BreakoutBoard_RevA.GBL, BreakoutBoard_RevA.GBO, BreakoutBoard_RevA.GBP, BreakoutBoard_RevA.GBS, BreakoutBoard_RevA.GTL, BreakoutBoard_RevA.GTO, BreakoutBoard_RevA.GTP, BreakoutBoard_RevA.GTS]
2012-01-12 Creating copy for PowerBoard Revision A.
    [Connector Bus Signals.xlsx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]
2012-01-12 Renamed files with _RevA suffix.
    [PowerBoard_RevA.GBL, PowerBoard_RevA.GBO, PowerBoard_RevA.GBP, PowerBoard_RevA.GBS, PowerBoard_RevA.GTL, PowerBoard_RevA.GTO, PowerBoard_RevA.GTP, PowerBoard_RevA.GTS]
2012-01-12 Updated fields to Rev B and added copyright text to silk screen (needs adjustment).
    [PowerBoard.brd, PowerBoard.sch]
2012-01-12 Connected external Analog Front-End auxiliary ADCs and DACs.
    [Connector Bus Signals.xlsx, MainBoard.sch]
2012-01-12 - 64 -> 84 board-to-board connector, initial changes
    [BreakoutBoard.brd, BreakoutBoard.sch]
2012-01-13 - Info on the back of the PCB updated with copyright stuff
    [RFWBBoard.brd]
2012-01-13 Added USB D+ pull-up resistor and marked possible changes for Rev B.
    [PowerBoard.brd, PowerBoard.sch]
2012-01-13 Added initial schematic connections to SmartFusion AFE.
    [MainBoard.sch]
2012-01-14 Added SmartFusion AFE external references and connected SmartFusion ADC/DAC/ABPS signals to mezzanine connector (North bridge).
    [MainBoard.sch]
2012-01-14 Hooked up the USB connector with USBLC6 and added pull-up on USBD+.
    [MainBoard.sch]
2012-01-14 Connected FTDI USB chip on schematic and created/added a corresponding crystal and EEPROM.
    [MainBoard.sch]
2012-01-16 - New 84 board-to-board connector (in schematic and routed) - info text on back corrected
    [PowerBoard.brd, PowerBoard.sch]
2012-01-16 Minor cosmetic changes to 84-pin connector. Changed texts 'verifier' to 'reviewer'.
    [PowerBoard.brd, PowerBoard.sch]
2012-01-16 Added programmer interface to schematic. Added Ethernet PHY and RJ-45 components to library and connected in schematic.
    [MainBoard.sch]
2012-01-16 Minor modification to Ethernet components. (Connections still need at least one review.)
    [MainBoard.sch]
2012-01-17 Checked all Ethernet components in library and marked-up the Ethernet interface in schematic.
    [MainBoard.sch]
2012-01-17 - Routing and layout
    [BreakoutBoard.brd, BreakoutBoard.sch]
2012-01-17 - Schematic updated
    [PowerBoard.brd, PowerBoard.sch]
2012-01-17 - Schematic updated - Info text updated on PCB back - 84 pin component changed in library
    [RFWBBoard.brd, RFWBBoard.sch]
2012-01-17 - Logos changed - Small vias covered
    [PowerBoard.brd, PowerBoard.sch]
2012-01-17 Added labels to potmeters on silkscreen.
    [BreakoutBoard.brd]
2012-01-17 Checked-in missing CDC app files and corrected some in the library for PowerBoard supply rail testing.
    [cmd_def.c, cmd_def.h, main.c]
2012-01-19 Added reset IC to library an schematic.
    [MainBoard.sch]
2012-01-19 Added momentary switch to library and schematic (PU_N and MSS_RESET).
    [MainBoard.sch]
2012-01-19 Reorganized USB power supply and reset.
    [MainBoard.sch]
2012-01-19 Fixed minor issues, added (user) push button and 2 LEDs.
    [MainBoard.sch]
2012-01-19 Cleaned up SmartFusion AFE and removed series resistors from external AFE digital data lines.
    [MainBoard.sch]
2012-01-20 Cleaned up Ethernet and JTAG interfaces.
    [MainBoard.sch]
2012-01-23 - Supply voltage measurement changes - PB9 monitors /CHRG (no led)
    [PowerBoard.brd, PowerBoard.sch]
2012-01-23 Added switch (button) datasheet.
2012-01-23 - Filter moved further from ADC lines
    [PowerBoard.brd]
2012-01-24 Added external clock out buffer to library and schematic.
    [MainBoard.sch]
2012-01-24 Initial check-in of M6-RF315 component library and schematic.
    [M6RF-315.sch]
2012-01-24 - Pushbutton added for reset
    [PowerBoard.brd, PowerBoard.sch]
2012-01-24 - Pull-up resistors for I2C lines
    [RFWBBoard.brd, RFWBBoard.sch, RFWBBoard_BOM.xls]
2012-01-25 Started placing the components on the board to estimate available board space.
    [MainBoard.sch]
2012-01-25 All components placed on the board to estimate available and occupied board-space.
    [MainBoard.sch]
2012-01-25 Added PCB design file (finally).
    [MainBoard.brd]
2012-01-25 Cleaned up external ADC/DAC filters.
    [MainBoard.brd, MainBoard.sch]
2012-01-26 Added logo, CC1101 and filled up library with several other components.
    [M6RF-315.sch]
2012-01-26 All components drawn and added. PCB placed initially.
    [M6RF-315.brd, M6RF-315.sch]
2012-01-26 Antenna part no.
    [M6RF-315.sch]
2012-01-26 -Replaced JTAG select jumper with a DIP switch. -Connected the FTDI USB chip to a UART peripheral. -Removed the user push-button.
    [MainBoard.brd, MainBoard.sch]
2012-01-27 - Board for CPS initial commit
    [CPSBoard.brd, CPSBoard.sch]
2012-01-27 Modified GPIO-serial data connection, added LEDs, updated and cleaned up the library, defined antenna circuit component values and added datasheet..
    [M6RF-315.brd, M6RF-315.sch]
2012-01-27 Started routing.
    [M6RF-315.brd]
2012-01-27 M6-RF315 board 80% routed (9 airwires remaining).
    [M6RF-315.brd, M6RF-315.sch]
2012-01-28 Renamed project files from M6RF-315 to M6-RF315.
    [M6-RF315.brd, M6-RF315.sch]
2012-01-28 All signals routed on M6-RF315. Needs DRC check.
    [M6-RF315.brd]
2012-01-28 Added a BOM file (not finished yet).
    [M6-RF315.brd, M6-RF315.sch, M6-RF315_BOM.xlsx]
2012-01-28 Finished BOM file for M6-RF315.
    [M6-RF315.brd, M6-RF315.sch, M6-RF315_BOM.xlsx]
2012-01-28 Minor corrections to BOM file.
    [M6-RF315_BOM.xlsx]
2012-01-30 Updated BOM and removed some DRC errors.
    [M6-RF315.brd, M6-RF315.sch, M6-RF315_BOM.xlsx]
2012-01-31 Reviewed DRC errors.
    [M6-RF315.brd]
2012-01-31 Added exported GERBER files.
    [M6-RF315.brd, M6-RF315.sch]
2012-01-31 Added bottom silk screen with Marmote and copyright information.
    [M6-RF315.brd]
2012-01-31 Started playing around with the external AFE analog signals (place & route).
    [MainBoard.brd, MainBoard.sch]
2012-01-31 Renamed ADC/DAC signals (numbers).
    [MainBoard.brd, MainBoard.sch]
2012-02-01 Filled out the cover page.
    [M6-RF315.sch]
2012-02-01 External AFE components placed initially.
    [MainBoard.brd, MainBoard.sch]
2012-02-01 Reorganized FPGA digital pinout for EXT AFE interfaces (schematic and PCB).
    [MainBoard.brd, MainBoard.sch]
2012-02-01 Started routing the USB section.
    [Connector Bus Signals.xlsx, MainBoard.brd, MainBoard.sch]
2012-02-02 JTAG signals routed initially (Note: consider routing it on a shorter path in the lower area.)
    [MainBoard.brd, MainBoard.sch]
2012-02-02 USB related components routed with the exception of data and control signals.
    [MainBoard.brd, MainBoard.sch]
2012-02-03 Routed the USB-FPGA data and control lines.
    [MainBoard.brd, MainBoard.sch]
2012-02-03 MSS interfaces routed to the side of the FPGA.
    [MainBoard.brd, MainBoard.sch]
2012-02-06 Routed the clock related signals and fixed some minor issues.
    [MainBoard.brd, MainBoard.sch]
2012-02-06 Backup before rerouting JTAG signals.
    [MainBoard.brd, MainBoard.sch]
2012-02-06 MSS to connector digital signals half-routed.
    [MainBoard.brd, MainBoard.sch]
2012-02-07 Switched to 6-layer stackup and routed MSS digital signals.
    [MainBoard.brd]
2012-02-07 SF AFE signals ROUGHLY routed.
    [MainBoard.brd, MainBoard.sch]
2012-02-08 Added an IPC standard R0402 package to the library.
    [MainBoard.brd, MainBoard.sch]
2012-02-08 Corrected R0402 and C0402 component footprints according to IPC SM 782.
    [MainBoard.brd, MainBoard.sch]
2012-02-08 Started routing the ETH PHY component.
    [MainBoard.brd, MainBoard.sch]
2012-02-09 Ethernet digital signals routed.
    [MainBoard.brd, MainBoard.sch]
2012-02-09 Ethernet PHY external components routed.
    [MainBoard.brd, MainBoard.sch]
2012-02-09 Removed everything from GND and SUP layers.
    [MainBoard.brd]
2012-02-09 Routed the SF AFE signals around the BGA grid.
    [MainBoard.brd]
2012-02-09 Minor updates on the connector on the schematic.
    [MainBoard.brd, MainBoard.sch]
2012-02-13 Routed external clocks (still needs adjustment).
    [MainBoard.brd, MainBoard.sch]
2012-02-13 Starting add FPGA supply decoupling capacitors.
    [MainBoard.brd, MainBoard.sch]
2012-02-13 Added decoupling capacitor to 1.5V supplies (3.3V IOB supply capacitors still missing).
    [MainBoard.brd, MainBoard.sch]
2012-02-15 USB routing optimization back-up.
    [MainBoard.brd, MainBoard.sch]
2012-02-15 Minor corrections in MainBoard library and board.
    [MainBoard.brd, MainBoard.sch]
2012-02-15 Still checking and adjusting USB related components on board.
    [MainBoard.brd, MainBoard.sch]
2012-02-16 Initial checking of USB related parts (almost) finished.
    [MainBoard.brd, MainBoard.sch]
2012-02-16 Checked EXT AFE power supply and decoupling capacitors.
    [MainBoard.brd, MainBoard.sch]
2012-02-16 Rearranged AFE filters.
    [MainBoard.brd]
2012-02-16 Moved AFE2 1mm to the left.
    [MainBoard.brd]
2012-02-16 Moved AFEs EVEN closer to the mezzanine connector.
    [MainBoard.brd]
2012-02-17 Checked FPGA related components in library.
    [MainBoard.brd, MainBoard.sch]
2012-02-20 Marked certain parts in schematic for modification/discussion.
    [PowerBoard.sch]
2012-02-21 Revised Ethernet PHY and corresponding interfaces.
    [MainBoard.brd, MainBoard.sch]
2012-02-21 Reorganized ETH PHY signals.
    [MainBoard.brd, MainBoard.sch]
2012-02-22 Iterated on Mezzanine connector pinout.
    [Connector Bus Signals.xlsx]
2012-02-22 Routed MSS and GPIO signals round the Mezzanine connector.
    [MainBoard.brd, MainBoard.sch]
2012-02-22 Routed MSS and FPGA I/O (GPIO) signals from the Mezzanine connector to SmartFusion.
    [Connector Bus Signals.xlsx, MainBoard.brd, MainBoard.sch]
2012-02-22 Routed A1V5.
    [Connector Bus Signals.xlsx, MainBoard.brd]
2012-02-23 Supply and power planes initially routed.
    [MainBoard.brd]
2012-02-23 Routed and decoupled D1V5 and A1V5, and cleaned up signal names (no N$x anymore).
    [MainBoard.brd, MainBoard.sch]
2012-02-23 Added FPGA decoupling capacitors (A1V5, D1V5, A3V3 and D3V3).
    [MainBoard.brd, MainBoard.sch]
2012-02-24 Exported schematic for the M6-RF315 Board.
2012-02-24 Created header for the M6-RF315 board.
2012-02-29 - New connectors added and routed
    [BreakoutBoard.brd, BreakoutBoard.sch]
2012-02-29 - wires moved to different layer - docu layer - Supply voltages
    [BreakoutBoard.brd]
2012-03-01 - Ground planes changed - Supply wires
    [BreakoutBoard.brd]
2012-03-02 - Interface updated on schematic
    [PowerBoard.brd, PowerBoard.sch]
2012-03-02 - Layout update - Interface update
    [PowerBoard.brd]
2012-03-03 - Layout update
    [PowerBoard.brd]
2012-03-05 Updated DRC constraints (based on IES, Inc. capabilities)
    [MainBoard.brd]
2012-03-05 - Layout
    [PowerBoard.brd]
2012-03-06 Updated FG256 (SmartFusion) footprint and accompanying via sizes according to Actel's recommended layout dimensions. (Solder paste diameter defined almost randomly.)
    [MainBoard.brd, MainBoard.sch]
2012-03-06 - Components moved out of the bottom keep-out-box representing the battery - All grounds connected to mezzanine interface
    [PowerBoard.brd, PowerBoard.sch]
2012-03-06 - Minor changes in layout
    [PowerBoard.brd, PowerBoard.sch]
2012-03-06 Correcting errors after the 'morning code review'.
    [MainBoard.brd, MainBoard.sch]
2012-03-06 Connected NGPIO[0-1] to differential FPGA I/O pair.
    [MainBoard.brd, MainBoard.sch]
2012-03-06 Added a right angle momentary switch to the library.
    [MainBoard.brd, MainBoard.sch]
2012-03-07 Modified logo library to suppress DRC errors and started to clean up USB signal layout.
    [MainBoard.brd, MainBoard.sch]
2012-03-07 Cleaning up DRC errors.
    [MainBoard.brd, MainBoard.sch]
2012-03-08 Updated the QFN-48 stencil and added thermal vias to AFEs.
    [MainBoard.brd, MainBoard.sch]
2012-03-08 Modified XTAL ground connections; 40 airwires left.
    [MainBoard.brd, MainBoard.sch]
2012-03-08 6 airwires left from routing (without DRC check)
    [MainBoard.brd]
2012-03-08 All airwires routed (several DRC errors still exist).
    [MainBoard.brd]
2012-03-08 Backup before removing AFE thermal vias.
    [MainBoard.brd, MainBoard.sch]
2012-03-08 All DRC errors removed (first iteration)
    [MainBoard.brd]
2012-03-09 - Texts moved closer to edge, so they stay visible even if the board is covered
    [BreakoutBoard.brd]
2012-03-12 Moved the reset button to the west side.
    [MainBoard.brd]
2012-03-12 Adjusted GND and PWR plane dimensions and line widths.
    [MainBoard.brd]
2012-03-12 - GND vias randomized
    [BreakoutBoard.brd]
2012-03-12 Minor cleanup and markup on schematic and board.
    [MainBoard.brd, MainBoard.sch]
2012-03-12 M6-RF315 SPI communication and clocking tested.
2012-03-13 - Layout update - PB4, PC13 pins changed
    [PowerBoard.brd, PowerBoard.sch]
2012-03-13 Swapped PB4 with PB5 for I2C alert functionality.
    [STM32F10x Pin Assignment.xlsx]
2012-03-13 - Layout update - AGND and DGND vias - PC15 selectable to connect either to Wake up or GPIO interface pin
    [PowerBoard.brd, PowerBoard.sch]
2012-03-13 Cleaned up schematic after the review.
    [MainBoard.brd, MainBoard.sch]
2012-03-13 Modified push-button area.
    [MainBoard.brd]
2012-03-13 Rerouted the USB data signals.
    [MainBoard.brd]
2012-03-13 - R and C footprints from Main Board project - Some DRC errors corrected
    [PowerBoard.brd, PowerBoard.sch]
2012-03-13 - R and C footprints updated from Main Board project - 2.4 GHz and base-band ground part separated with gap - Board layers 4 -> 6 - Interface connector updated
    [RFWBBoard.brd, RFWBBoard.sch]
2012-03-13 Updating labels and JTAGSEL placement.
    [MainBoard.brd, MainBoard.sch]
2012-03-13 Reset logic ripped up.
    [MainBoard.brd]
2012-03-14 - Layout update - Interface update (RSSI -> SF_ADC6)
    [RFWBBoard.brd, RFWBBoard.sch]
2012-03-14 Moved logos to silkscreen and updated library accordingly.
    [MainBoard.brd, MainBoard.sch]
2012-03-14 - 90 degree push button for reset - Switch selectable boot - Some grounding
    [PowerBoard.brd, PowerBoard.sch]
2012-03-14 - More GND vias - DRC loaded from Main Board project - Pin numbering
    [BreakoutBoard.brd]
2012-03-14 Revised signal angles.
    [MainBoard.brd, MainBoard.sch]
2012-03-14 - Layout update - Oscillator added
    [RFWBBoard.brd, RFWBBoard.sch]
2012-03-14 Checked GND and PWR vias.
    [MainBoard.brd, MainBoard.sch]
2012-03-14 Added test vias.
    [MainBoard.brd, MainBoard.sch]
2012-03-14 Added AGND and DGND test points.
    [MainBoard.brd, MainBoard.sch]
2012-03-15 Finished the silkscreen layers.
    [MainBoard.brd, MainBoard.sch]
2012-03-15 Backup before re-numbering components on schematic.
    [MainBoard.brd, MainBoard.sch]
2012-03-15 Re-numbered components based on schematic page/location.
    [MainBoard.brd, MainBoard.sch]
2012-03-15 Re-checked component values for BOM file generation.
    [MainBoard.brd, MainBoard.sch]
2012-03-15 Minor fixes in library and initial check-in of BOM file.
    [MainBoard.brd, MainBoard.sch, MainBoard_BOM.xlsx]
2012-03-15 Finished BOM file with a few questions inserted in the Excel file.
    [MainBoard.brd, MainBoard.sch, MainBoard_BOM.xlsx]
2012-03-16 Exported schematic and assembly diagrams.
    [MainBoard.brd, MainBoard.sch]
2012-03-16 Increased signal width around mezzanine connector.
    [MainBoard.brd]
2012-03-16 Added GERBER and Prevue files.
    [MainBoard.GBL, MainBoard.GBO, MainBoard.GBP, MainBoard.GBS, MainBoard.GTL, MainBoard.GTO, MainBoard.GTP, MainBoard.GTS]
2012-03-17 - Decoupling capacitors moved to ICs on schematic - Layout update
    [PowerBoard.brd, PowerBoard.sch]
2012-03-18 - Decoupling capacitors - Layout update - Schematic update
    [RFWBBoard.brd, RFWBBoard.sch]
2012-03-19 Re-generated CAM and prevue files.
    [MainBoard.brd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]
2012-03-19 Reorganized names on board for better visibility on assembly diagrams.
    [MainBoard.brd, MainBoard.sch, MainBoard_BOM.xlsx]
2012-03-19 Finalized BOM and re-exported all assembly, CAM and prevue files.
    [MainBoard.brd, MainBoard.sch, MainBoard_BOM.xlsx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]
2012-03-19 Renamed CAM files with '_RevA' suffix.
    [MainBoard_RevA.GBL, MainBoard_RevA.GBO, MainBoard_RevA.GBP, MainBoard_RevA.GBS, MainBoard_RevA.GTL, MainBoard_RevA.GTO, MainBoard_RevA.GTP, MainBoard_RevA.GTS]
2012-03-19 - Layout update - Silk screen update -> component names smaller
    [RFWBBoard.brd]
2012-03-19 - Air wires eliminated
    [PowerBoard.brd]
2012-03-20 - No airwires - AGND covers current sense - AGND, DGND measurement points moved
    [PowerBoard.brd, PowerBoard.sch]
2012-03-20 Modified ground plane cut-in.
    [PowerBoard.brd]
2012-03-20 Adjusted BOOT switch and silk screen label positions.
    [PowerBoard.brd]
2012-03-20 - Logos on silk screen - Board name updated
    [PowerBoard.brd, PowerBoard.sch]
2012-03-20 - Gerber files - Pick and Place files - Assembly drawings
    [PowerBoard.GBL, PowerBoard.GBO, PowerBoard.GBP, PowerBoard.GBS, PowerBoard.GTL, PowerBoard.GTO, PowerBoard.GTP, PowerBoard.GTS]
2012-03-20 - Silk screen corrected - Updated Gerber - Updated assembly
    [PowerBoard.brd, PowerBoard.sch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]
2012-03-20 Implemented a command parser "framework".
2012-03-20 - Logos - Gerber files - Pick and Place file - Assembly Drawings
    [BreakoutBoard.GBL, BreakoutBoard.GBO, BreakoutBoard.GBP, BreakoutBoard.GBS, BreakoutBoard.GTL, BreakoutBoard.GTO, BreakoutBoard.GTP, BreakoutBoard.GTS]
2012-03-20 - Assembly drawings
2012-03-20 - Logos - Gerber files - Pick and Place file - Assembly files
    [RFWBBoard.GBL, RFWBBoard.GBO, RFWBBoard.GBP, RFWBBoard.GBS, RFWBBoard.GTL, RFWBBoard.GTO, RFWBBoard.GTP, RFWBBoard.GTS]
2012-03-21 - BOM - Gerber updated - Schematic pdf - Datasheet for connector
    [PowerBoard.brd, PowerBoard.sch, PowerBoard_BOM.xlsx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]
2012-03-21 - "Copyright 2012" on schematic and library
    [PowerBoard.sch]
2012-03-21 - Quantities corrected
    [PowerBoard_BOM.xlsx]
2012-03-21 - Removed some components from BOM
    [PowerBoard_BOM.xlsx]
2012-03-21 - Gerber files updated - Assembly files updated - Pick and Place updated - BOM - Schematic
    [BreakoutBoard.brd, BreakoutBoard.sch, BreakoutBoard_BOM.xlsx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]
2012-03-21 - README.txt updated
    [PowerBoard_BOM.xlsx]
2012-03-21 - Gerber - BOM - README.txt - Schematic
    [RFWBBoard.brd, RFWBBoard.sch, RFWBBoard_BOM.xls, RFWBBoard_BOM.xlsx]
2012-03-21 Merged BreakoutBoard (Smoky) assembly files.
2012-03-21 Added 'BLACK' to solder mask req.
2012-03-21 Created revision B branch.
    [BreakoutBoard.GBL, BreakoutBoard.GBO, BreakoutBoard.GBP, BreakoutBoard.GBS, BreakoutBoard.GTL, BreakoutBoard.GTO, BreakoutBoard.GTP, BreakoutBoard.GTS]
2012-03-21 Fixed a type in BOM.
    [PowerBoard_BOM.xlsx]
2012-03-21 Made U8 component (clock buffer) DNP.
    [RFWBBoard_BOM.xlsx]
2012-03-21 Modified signal name notes around connector.
    [RFWBBoard.sch]
2012-03-22 - Silk screen updated
    [BreakoutBoard.brd]
2012-03-22 - Layout updated
    [RFWBBoard.brd, RFWBBoard.sch]
2012-03-22 Corrected the crystal part number in BOM from 16 MHz to 26 MHz.
    [M6-RF315_BOM.xlsx]
2012-03-22 - Layout updated - Gerber files updated
    [RFWBBoard.GBL, RFWBBoard.GBO, RFWBBoard.GBP, RFWBBoard.GBS, RFWBBoard.GTL, RFWBBoard.GTO, RFWBBoard.GTP, RFWBBoard.GTS]
2012-03-22 Updated 20 MHz crystal digi-key#.
    [MainBoard.brd, MainBoard.sch, MainBoard_BOM.xlsx]
2012-03-22 - Silk screen updated - Gerber files updated
    [PowerBoard.GTO]
2012-03-22 - Silk screen updated - Gerber updated
    [BreakoutBoard.GTO]
2012-03-22 Corrected BOM file and schematic based on IES questions.
    [MainBoard.brd, MainBoard.sch, MainBoard_BOM.xlsx]
2012-03-22 - Silk screen update
    [BreakoutBoard.brd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]
2012-03-22 - gwk file updated with layer descriptions - Names layer updated
    [PowerBoard.brd]
2012-03-22 - Added 'BLACK' to README.txt - Names layer updated
    [RFWBBoard.brd]
2012-03-22 - Files renamed with _RevB suffix
    [BreakoutBoard_RevB.GBL, BreakoutBoard_RevB.GBO, BreakoutBoard_RevB.GBP, BreakoutBoard_RevB.GBS, BreakoutBoard_RevB.GTL, BreakoutBoard_RevB.GTO, BreakoutBoard_RevB.GTP, BreakoutBoard_RevB.GTS]
2012-03-22 - Files renamed with _RevA suffix
    [RFWBBoard_RevA.GBL, RFWBBoard_RevA.GBO, RFWBBoard_RevA.GBP, RFWBBoard_RevA.GBS, RFWBBoard_RevA.GTL, RFWBBoard_RevA.GTO, RFWBBoard_RevA.GTP, RFWBBoard_RevA.GTS]
2012-03-22 Merged Breakout (Smoky) assembly pdf-s.
2012-03-22 Merged Powerboard (Yellowstone) assembly pdf-s.
2012-03-22 Merged RF board (Joshua) assembly pdfs.
2012-03-22 Merged RF board (Joshua) Rev A assembly pdf-s.
2012-03-26 Updating README with notes for controlled impedance traces.
2012-03-26 Initial check-in of AFE interface (not working yet).
    [afe_if.vhd]
2012-03-28 - Some components had to be replaced with compatible parts (ONLY BOM WAS UPDATED, SCHEMATIC, COMPONENT LIBRARY, LAYOUT REMAINED UNCHANGED)
    Resistors:
    MCR03EZPJ000 => MCR03ERTJ000
    MCR03EZPJ101 => MCR03ERTJ101
    MCR03EZPJ472 => MCR03ERTJ472
    MCR03EZPFX1002 => MCR03ERTF1002
    MCR03EZPFX1003 => MCR03ERTF1003
    Crystal:
    ECS-160-8-36CKM =>
    Digi-Key Part Number 887-1336-1-ND
    Manufacturer TXC CORPORATION
    Manufacturer Part Number 8Z-16.000MEEQ-T
    Description CRYSTAL 16.000 MHZ 10PF SMD
    [PowerBoard_BOM.xlsx, PowerBoard_RevB_BOM.xlsx]
2012-03-29 Re-exported MainBoard_Asy.pdf.
    [MainBoard.brd]
2012-03-30 Added BoardTestCanvas related components.
2012-04-02 Restored smartgen.aws to include BoardTestCanvas_work.
2012-04-02 Corrected AFE stimulus file syntax errors.
    [afe_if_tb.vhd]
2012-04-09 Replaced 10-bit wide FIFO w/ an 8-bit version and created a unit test for USB_IF.
    [usb_if.vhd]
2012-05-08 Updated Power Supply Board code for Rev B with #IFDEFS.
2012-05-14 Updated connector pinout documentation for Rev B.
    [Connector Bus Signals.xlsx]
2012-05-15 Backup of pin assignments in 'BoardTest' project.
2012-05-15 Test project for the Teton (MainBoard) Rev A LEDs, UART over USB and AFE connections.
2012-05-21 Adjusted the AFE I/O block drive strengths to minimize noise, current draw and to delay the data lines compared to AFE clock.
2012-05-22 Tested AFE2 signals using the baseband part of the Joshua board.
2012-05-25 Added figure sent to FAB for assembly clarification.
2012-05-25 Added figure sent to FAB for MainBoard Rev A assembly clarification.
2012-05-30 Fixed the glitch in baseband sine-generation and swapped the I/Q signal in the afe_if.vhd module.
    [afe_if.vhd, fsk_tx.c, main.c]
2012-05-30 Updated the timing constraint file. (Programming the device won't give a warning anymore.)
2012-05-31 Ported functions and added commands to set (and get) the frequency, gain and current operating mode.
2012-06-01 Added command to set RSSI output pin function. End-to-end tested with power detector setting (initiated through USB console and measured with scope).
2012-06-01 Added high-frequency/noise block to test MAX2830 baseband LPF functionality.
    [AFE_IN_MUX.vhd, fsk_tx_apb_if.vhd, noise_gen.vhd]
2012-06-06 - lwIP testing project
    [_vhdl.psm, bfma1i10i.psm, bfma1io1ol.psm, body.psm, rtl.psm, tb.psm, verilog.psm]
2012-06-06 Code to test the Sync FIFO 245 (from FPGA to FTDI) interface on the board.
2012-06-08 Moved MarmoteRecorder into BoardTest project directory to keep their versions synchronized.
2012-06-11 Fixed recording to wave file (asking data from driver in smaller chunks).
2012-06-12 Backup before switching to test AFE2 instead of AFE1.
2012-06-29 - Initial commit of the frame based streaming receiver
    [_vhdl.psm, body.psm, rtl.psm, verilog.psm]
2012-07-03 - Repeating frame counter bug corrected
    [common.vhd, testbench.vhd, usb_if.vhd]
2012-07-06 - Streaming receiver with RF IC handling
    [StreamingReceiver_RF_ba.sdf, _vhdl.psm, bfma1i10i.psm, bfma1io1ol.psm, body.psm, rtl.psm, tb.psm, verilog.psm]
2012-07-06 Corrected ETH PHY R_BIAS value in MainBoard main branch BOM file.
    [MainBoard_BOM.xlsx]
2012-07-12 Tested "Joshua" EEPROM read and write through the I2C bus.
2012-07-12 Merged the USB and AFE interfaces from the BoardTest design and added a PC side recorder. Supports the streaming of a single raw (no framing) 8-bit data channel.
2012-07-13 Tried dynamic AFULL and AEMPTY values on TXD FIFOs, but simulations had issues. Switched back to static values.
    [fifo_256x16.vhd, usb_if.vhd]
2012-07-13 Added 16-bit sequence number to message frame.
2012-07-17 Intermediate backup check-in with possible timing issues, DO NOT USE this revision. Streaming on two 16-bit channels with framed packets.
    [usb_if.vhd]
2012-07-30 Design to test SPI communication between the Yellowstone power supply board (master) and the Teton main board (slave). This setup has issues as the SmartFusion SPI peripheral has fixed DI and DO pint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
    [main.c]
2012-07-30 Test code for the SPI transaction with the Yellowstone power supply acting as master and the SmartFusion as slave. (There are issues on the MISO/MOSI lines as the pin directions are fixed in the Smar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
    [cmd_def.c, cmd_def.h, main.c]
2012-08-01 Added support for printing through the SPI port via functions like puts().
    The SPI messages can be received by the Yellowstone power supply board and displayed through the USB console.
2012-08-02 Added support for bi-directional SPI communication between the Yellowstone (power supply) board.
2012-08-02 Added support for bi-directional SPI communication between the Teton (main) and Yellowstone (power supply) boards.
2012-08-02 Adjusted SPI transfer to current Teton command processor.
2012-08-02 Added command processor for SPI ASCII commands.
2012-08-04 Increased SPI buffer size to a reasonable value.
2012-08-06 Fixed the USB console printing bug preventing to print longer messages. (Modified USB transmit buffer handling.)
    [cmd_def.c]
2012-08-07 Added functions for receiver operation (Rx gain (LNA and VGA), Rx baseband low-pass filter bandwidth control).
2012-08-08 Added RSSI pin measurement on ADC6 to the design. Receive mode LNA gain control still seems to have issues.
    [cmd_def.c, max2830.c, max2830.h]
2012-08-10 Added an 'env' command to be able to switch between the Yellowstone and Teton boards on the console.
2012-08-10 Minor changes to accommodate the new 'env' command on the Yellowstone board.
2012-08-24 Added 'usb' command in order to suspend USB power during during power consumption measurements. (This version is a backup before improving the power_monitor module.)
2012-08-24 Added single channel ADC conversion command. Tested on VREFINT (CH_17) and VSUP/2 (CH_9).
2012-08-24 Added command to read current draw on all power rails. (ADC used in software start mode.)
2012-08-29 Corrected the connector bus signal documentation for Yellowstone Rev B.
    [Connector Bus Signals.xlsx]
2012-08-29 Fixed the label issue with R7 and C5.
    [MainBoard.brd]
2012-08-29 Fixed the label issue with R7 and C5 on exported assembly drawing too.
2012-08-29 Fixed the label issue with R7 and C5 in the Eagle board file.
    [MainBoard.brd]
2012-08-29 Cleaned up labels on .brd and RJ-45 connector in .lbr.
    [MainBoard.brd, MainBoard.sch]
2012-08-29 Modified R14 to DNP in the BOM file.
    [MainBoard_BOM.xlsx]
2012-08-30 Backup before removing the AFE driver connected to the Joshua baseband lines.
2012-09-10 Errors corrected:
    Radio Board
    - External TCXO is connected to MAX2830 XTAL pin (28) instead of CTUNE pin (29)
    - TCXO power supply digital, ground analog
    - Mark for 1. pin for baluns not visible enough
    - C105, C106 names covered by vias in documentation (PCB changed only)
    Breakout Board
    - 84 mezzanine connectors on top and bottom swapped
    Power Board
    - Silkscreen labels D1V5 and D3V3 are swapped
    - VBUS measurement point not assembled
    - SW2 name missing, needs caption (silk screen)
    - Power input needs description (silk screen)
    [BreakoutBoard_BOM.xlsx, PowerBoard.brd, PowerBoard_BOM.xlsx, RFWBBoard.brd, RFWBBoard.sch]
2012-09-11 - Fiducials in both sides
    [BreakoutBoard.brd, BreakoutBoard.sch, PowerBoard.brd, PowerBoard.sch, RFWBBoard.brd, RFWBBoard.sch]
2012-09-12 8-bit TX and RX buffer with echo test. (One sample delay in echo.)
2012-09-15 Debugging MSS to PC USB transmission (issue with TX FIFO read timing). Intermediate check-in, do NOT use this version.
    [main.c, teton.h, usb_if.vhd]
2012-09-19 Minor bug fixes. Recorder is not yet finished.
    [usb_if.vhd]
2012-09-22 Changed frame payload data format to little-endian an adjusted sample counting.
2012-09-25 Debugging a possible timing issue with the framer state machine. Intermediate check-in, do NOT use this revision.
    [usb_if.vhd]
2012-09-25 Cleaned-up debug code, set sample_per_packet to 128 and fixed sampleBuffer overflow.
    [usb_if.vhd]
2012-09-27 Updated design based on MainBoardErrata in wiki for Rev B.
    [MainBoard.brd, MainBoard.sch]
2012-10-12 - Added AE sensor supply circuit - Added Colpitts oscillator 40 MHz common collector
2012-10-19 Design using the 20 MHz TCXO of the Joshua board as the FPGA ans MSS reference clock (PLL input).
2012-10-23 - Wavelet tr only working for small sample numbers - Created Visual Studio project for helper functions
2012-11-09 - Frame collection in separate files - New bat file to display recordings - Bin to WAVE converter initial commit
2012-11-09 - Initial filtering analysis
2012-11-13 - Initial FIR filtering added
2012-11-21 - New signal processing framework initial (working) commit
2012-11-22 - Frame collector
2012-11-25 Added a CIC filter (FPGA) and fixed the bug that prevented the receiver gain adjustment.
    [max2830.h]
2012-11-29 - FFT calculation corrected - Frame collection with FIR HPF - File source rewritten - File sink rewritten, it opens a new file for every threshold event - New Threshold block added
2012-12-02 - Frame collector fixed
2012-12-09 - Threshold block in C added to frame collector script
2012-12-10 Added and routed two FPGA I/Os to the North Bridge (connector).
    [Connector Bus Signals.xlsx, MainBoard.brd, MainBoard.sch]
2012-12-10 Swapped UART1 signals with two SGPIOs.
    [MainBoard.brd, MainBoard.sch]
2012-12-10 Renamed the SGPIO and NGPIO connector pins.
    [MainBoard.brd, MainBoard.sch]
2012-12-11 Created library item for the J0011D21BNL RJ-45 connector.
2012-12-11 Finished routing the RJ-45 connector (omitted the 3rd LED).
    [MainBoard.brd, MainBoard.sch]
2012-12-11 Updated BOM file (removed R49, C117 and fixed C116 and J2).
    [MainBoard.brd, MainBoard.sch, MainBoard_BOM.xlsx]
2012-12-11 Added fiducials to the bottom side and checked the design against wiki errata and requirement lists.
    [MainBoard.brd, MainBoard.sch]
2012-12-11 Run the DRC and fixed some minor issues (e.g. RJ-45 silk screen).
    [MainBoard.brd, MainBoard.sch]
2012-12-12 - Main Board: Only 4 DGND pins left out of 6 on mezzanine (2 became IO pins) - Power Board: Only 4 DGND pins left out of 6 on mezzanine (2 became IO pins) - RF Board: Only 4 DGND pins left out of 6 o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
    [MainBoard.brd, MainBoard.sch, PowerBoard.brd, PowerBoard.sch, RFWBBoard.brd, RFWBBoard.sch]
2012-12-12 - B1-B7 vias
    [RFWBBoard.brd, RFWBBoard.sch]
2012-12-13 - TCXO + XTAL footprint - 1ppm SMA - Parallel gain control - Routing - Schematic updated with switches
    [RFWBBoard.brd, RFWBBoard.sch]
2012-12-13 Added a frame aided feed-forward timing recovery block.
2012-12-14 - RF board routing done
    [RFWBBoard.brd, RFWBBoard.sch]
2012-12-15 - File source added for the FrameSource block
2012-12-17 - Added initial frame source component
2012-12-17 - Test framework for tools directory (everything looks fine)
2012-12-19 - Compiling version of frame source component
2012-12-21 - Buffer copy bug corrected in frame source component
2013-01-09 Updated the copyright info (global variable) and the revision number.
    [PowerBoard.brd, PowerBoard.sch]
2013-01-09 Changed C116 capacitor rating attribute.
    [MainBoard.brd, MainBoard.sch]
2013-01-09 Updated the revision number and copyright info.
    [MainBoard.brd, MainBoard.sch]
2013-01-10 Minor corrections regarding the canvas, copyright and revision update.
    [RFWBBoard.sch]
2013-01-11 - BOM updated - pull down resistor for SHDN - Names arranged
    [RFWBBoard.brd, RFWBBoard.sch, RFWBBoard_BOM.xlsx]
2013-01-14 Branch for the SDR receiver with MAX2830 firmware, AFE interface, CIC filter and UBX format based USB streamer.
2013-01-17 Added Simulink model with modulator, demodulator and timing (and frame) recovery.
2013-01-18 - HW projects exported - .gwk GC-prevue files might need some extra attention
    [BreakoutBoard.brd, BreakoutBoard.sch, BreakoutBoard_BOM.xlsx, BreakoutBoard_RevB_BOM.xlsx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]
2013-01-21 Added SFD interrupt line to the HDL design.
2013-01-22 Created a RevC branch for design check-out.
    [Connector Bus Signals.xlsx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]
2013-01-22 Created an RFWBoard RevB branch for design check-out.
    [RFWBBoard.GBL, RFWBBoard.GBO, RFWBBoard.GBP, RFWBBoard.GBS, RFWBBoard.GTL, RFWBBoard.GTO, RFWBBoard.GTP, RFWBBoard.GTS]
2013-01-22 Created a MainBoard RevB branch for design check-out.
    [A2F500 FT256 Pinout.xlsx, Connector Bus Signals.xlsx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]
2013-01-22 Added the Rev_C suffix to CAM file names.
    [PowerBoard_RevC.GBL, PowerBoard_RevC.GBO, PowerBoard_RevC.GBP, PowerBoard_RevC.GBS, PowerBoard_RevC.GTL, PowerBoard_RevC.GTO, PowerBoard_RevC.GTP, PowerBoard_RevC.GTS]
2013-01-22 Added the Rev_B suffix to MainBoard CAM file names.
    [MainBoard_RevB.GBL, MainBoard_RevB.GBO, MainBoard_RevB.GBP, MainBoard_RevB.GBS, MainBoard_RevB.GTL, MainBoard_RevB.GTO, MainBoard_RevB.GTP, MainBoard_RevB.GTS]
2013-01-22 Added the Rev_B suffix to RFWBoard exported file names.
    [RFWBBoard_RevB.GBL, RFWBBoard_RevB.GBO, RFWBBoard_RevB.GBP, RFWBBoard_RevB.GBS, RFWBBoard_RevB.GTL, RFWBBoard_RevB.GTO, RFWBBoard_RevB.GTP, RFWBBoard_RevB.GTS]
2013-01-30 Modified the BOM file so that the 40 MHz crystal is populated (and is selected by default).
    [RFWBBoard_RevB_BOM.xlsx]
2013-02-11 Added PWM LED display for lock-detect.
2013-02-14 Schematics pdfs updated
2013-02-15 Added a fixed preamble.
    [main.c, max2830.c, tx_apb_if.vhd]
2013-03-05 - AFE DDR bug corrected
    [IRQ_stuff.c, MessageFormat.h, StreamingReceiver_RF.vhd, StreamingReceiver_RF_MSS.vhd, StreamingReceiver_RF_MSS_tmp_MSS_CCC_0_MSS_CCC.vhd, afe_if.vhd]
2013-03-05 The FskTransmitter design modified for TX path calibration. (Intermediate check-in.)
2013-03-07 Replaced the CORDIC sine generator with a 4x1024 element SINE TABLE and a 64-bit phase accumulator. (C code needs to be adjusted.)
    [fifo_512x8.vhd, fsk_tx_apb_if.vhd, phase_acc.vhd]
2013-04-24 - RF board BOMs updated with switches
    [RFWBBoard_BOM.xlsx, RFWBBoard_RevB_BOM.xlsx]
2013-04-27 Added a GMSK message sink block (currently implements frame synchronizer only).
2013-04-28 Added GMSK packet sink frame and payload handling.
2013-04-29 Added GNU Radio GMSK frame handler to the receiver side.
2013-05-23 Tested the loopback chain with a single transmitter and single receiver.
2013-05-27 Minor adjustments, switched to REF_CLK.
2013-06-06 Modified the transmit chain and added a differential encoder.
2013-06-18 Added a differential encoder to the transmit path and applied minor fixes to the PN sequence generator.
    [tx_apb_if.vhd, tx_apb_if_tb.vhd]
2013-06-18 Intermediate check-in before designing a raised-cosine filter.
2013-06-18 Added a 31-tap RRC pulse shaping filter to the transmit path (takes 27% of the fabric logic).
2013-06-21 Modified design to fixed packet length.
    [main.c, tx_apb_if.vhd]
2013-06-27 Move SPI command processing to teton.h.
2013-07-10 Initial check-in with TimerMilliC.
2013-08-01 Added a binary XOR-based PN-matched filter for synchronization.
2013-08-01 Added oversampling support to the binary PN-matched filter.
2013-09-10 Switched from PER to PPR and fixed a SEQ overflow issue
2013-09-17 Updated Simulink model fixed-point representation and IFFT input scaling.
    [tx_apb_if.vhd]
2013-09-17 Added pretty-print and hex-input for ptrn (pattern) and mask commands.
2013-09-23 Added STAPL programming file to the revision used for preliminary (16-subcarrier OFDM) indoor phase measurements.
    [Teton.stp]
2013-09-23 Updated design to 32-point OFDM.
    [Teton.stp]
2013-09-23 Committed the corresponding STAPL file.
    [Teton.stp]
2013-09-24 Added a 256x32 TX_FIFO and a draft for a high-level TX_FSM.
    [Teton.stp]
2013-09-27 STAPL file for the OFDM-based MarmotE-banner demo.
    [Teton.stp]
2013-09-27 Replaced IFFT_CTRL and IFFT (generated) blocks with Simulink generated OFDM transmitter path. (Needs further fixing.)
    [Teton.stp]
2013-10-03 Set up battery alarm and cleaned up several files.
2013-10-03 Updated LED2 (orange) behavior: 0.5 Hz toggle -> charging; blinking at 1 Hz -> low battery
2013-10-16 Fixed battery gauge alarm initialization/handling.
    [cmd_def.c, cmd_def.h]
2014-01-02 - 3D histogram added - Kolmogorov-Smirnov test - Metropolis Markov Chain Monte Carlo method testing for arbitrary random variable generation
2014-01-02 - Histogram updated - Metropolis Markov Chain Monte Carlo notebook descriptions added
2014-01-10 - TODO added for Beaver Board rev B
2014-02-21 Seems to be a missing commit from right after the experiments...
    [cmd_def.c, cmd_def.h, main.c, teton.c]
