marmote/marmote/(notices)

Notices in the files:
hardware/PowerBoard_RevA/PowerBoard_RevA.sch:
COPYRIGHT: Copyright © 2011 Vanderbilt University, ISIS
hardware/BreakoutBoard/BreakoutBoard.sch:
COPYRIGHT: Copyright © 2013 Vanderbilt University, ISIS
